FYSETC/FYSETC-SPIDER/firmware/README.md

# firmware

This folder contains related code ,config , documents of Marlin firmware, Klipper firmware and RRF firmware. Please dive into to find what you want.
