FYSETC/FYSETC-SPIDER/firmware/Klipper/README.md

# Klipper

## printer.cfg

This in folder, there a `printer.cfg` file, this is an example Klipper configuration file for VORON2.4 machine. It is not copy-paste available config, you need to adjust the items in file, please read the file carefully, especially the first lines in the file. You need to change the items according to your machine.

```\
## *** THINGS TO CHANGE/CHECK: ***
## Spider version                       Please search this file for "SpiderVersion" and uncomment the appropriate line for each
## MCU paths                            [mcu] section
## Thermistor types                     [extruder] and [heater_bed] sections - See 'sensor types' list at end of file
## Z Endstop Switch location            [safe_z_home] section
## Homing end position                  [gcode_macro G32] section
## Z Endstop Switch  offset for Z0      [stepper_z] section
## Probe points                         [quad_gantry_level] section
## Min & Max gantry corner postions     [quad_gantry_level] section
## PID tune                             [extruder] and [heater_bed] sections
## Fine tune E steps                    [extruder] section
```

## Connect RPI UART

Please follow instruction here([github](https://github.com/FYSETC/FYSETC-SPIDER/blob/main/firmware/Klipper/Connect%20RPI%20uart.md) [gitee](https://gitee.com/fysetc/FYSETC-SPIDER/blob/main/firmware/Klipper/Connect%20RPI%20uart.md)).

## Pre-builds

For some beginners of Spider, i pre-build some firmwares for you, but i strongly recommend you to build the firmware yourself as Klipper update from time to time.  

`klipper-USB.bin` : No bootloader offset, choose USB to communicate with raspberrypi.

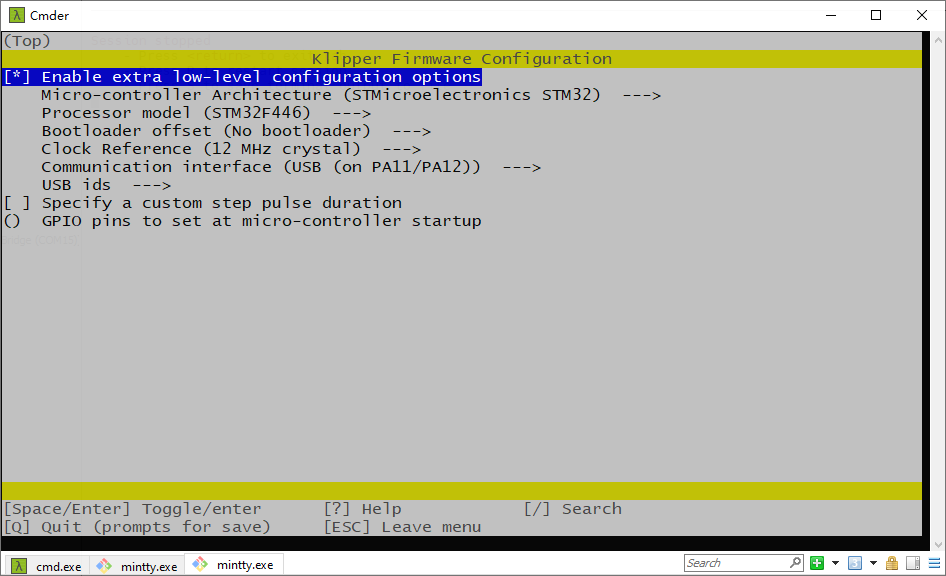
[picture p31: firmware/Klipper/klipper-USB.png]


`klipper-UART.bin` : No bootloader offset, choose UART to communicate with raspberrypi.

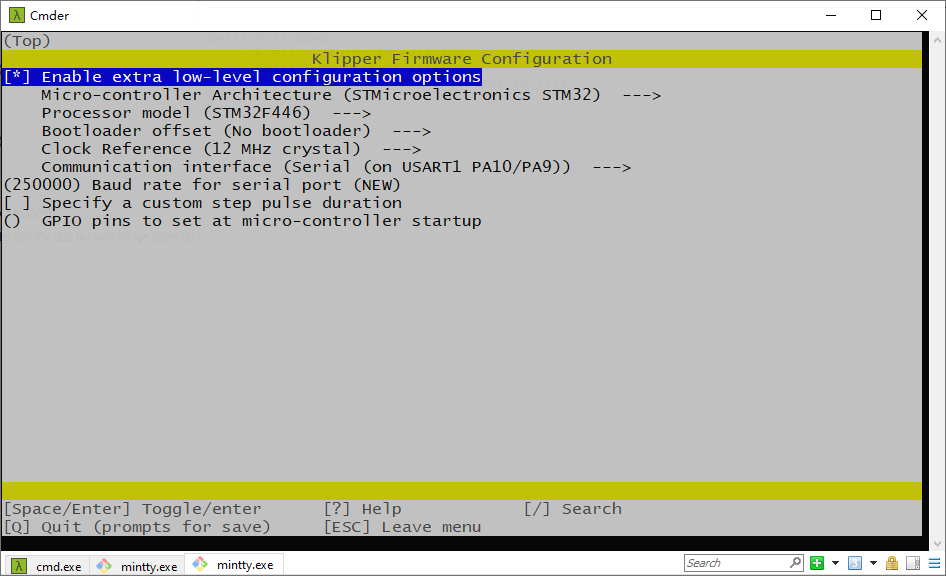
[picture p32: firmware/Klipper/klipper-UART.png]


`klipper-32k-USB.bin` : `0x8000(32k)` bootloader offset, choose USB to communicate with raspberrypi.

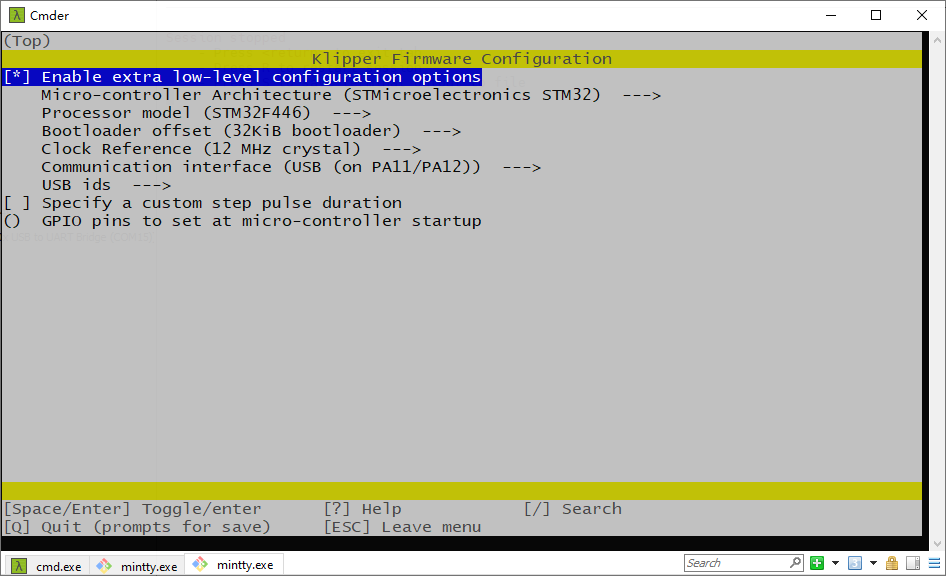
[picture p33: firmware/Klipper/klipper-32k-USB.png]


`klipper-32k-UART.bin` : `0x8000(32k)` bootloader offset, choose UART to communicate with raspberrypi.

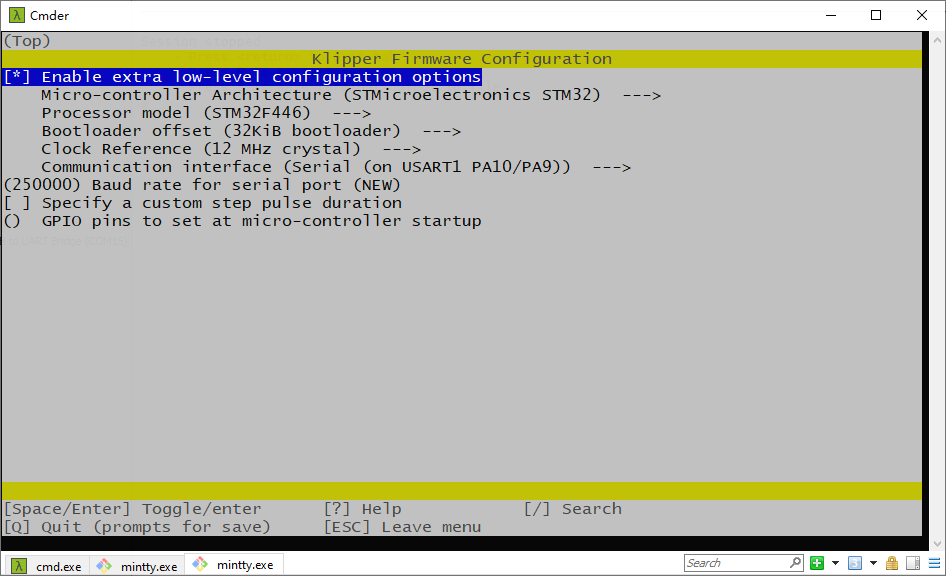
[picture p34: firmware/Klipper/klipper-32k-UART.png]


`klipper-64k-USB.bin` : `0x10000(64k)` bootloader offset, choose USB to communicate with raspberrypi.

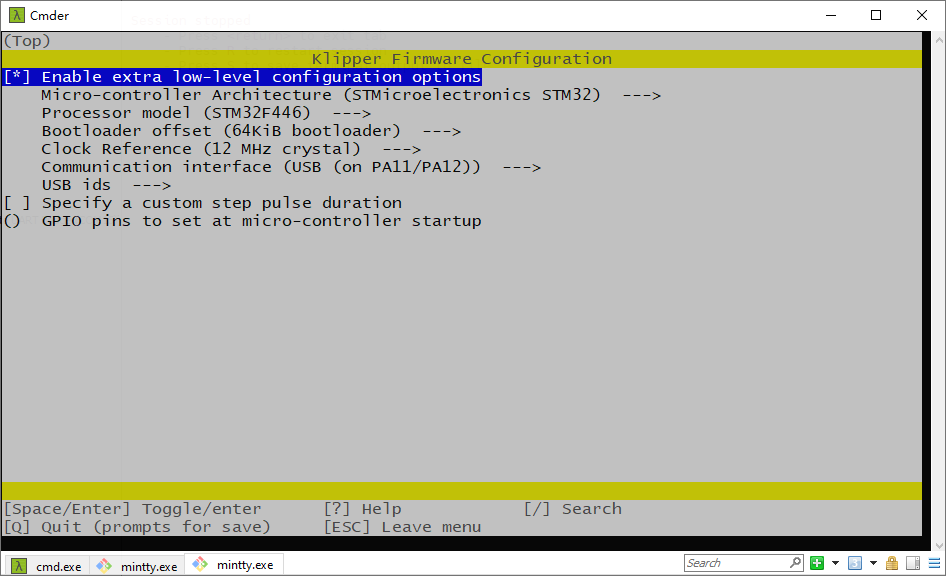
[picture p35: firmware/Klipper/klipper-64k-USB.png]


`klipper-64k-UART.bin` : `0x10000(64k)` bootloader offset, choose UART to communicate with raspberrypi.

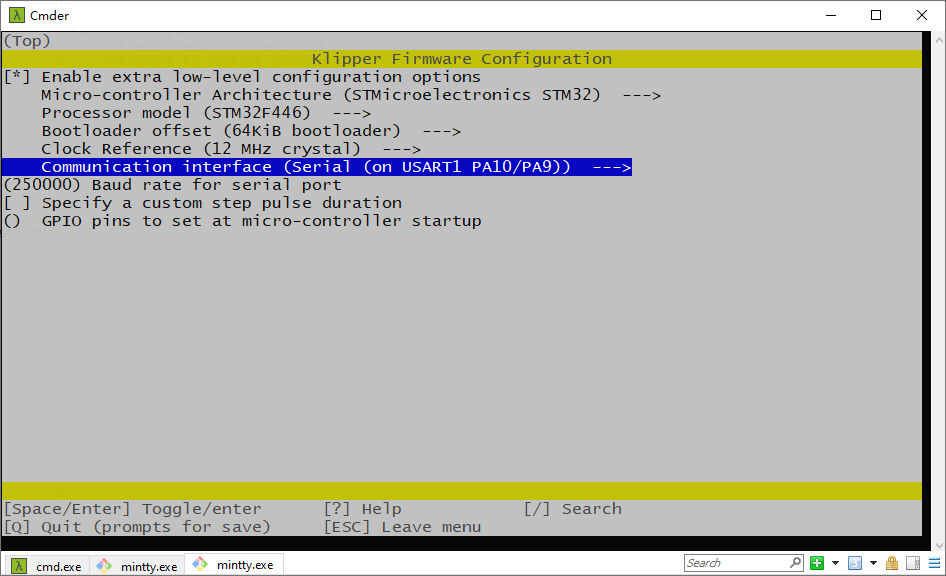
[picture p36: firmware/Klipper/klipper-64k-UART.png]
