FYSETC/FYSETC-SPIDER/firmware/说明文档_中文.md

# 固件

本目录中包含了 Marlin 固件，Klipper 固件，RRF 固件的相关代码，配置，说明等内容，请到相应的固件文件夹中查找您需要的资料。
