FYSETC/FYSETC-SPIDER/example/说明文档_中文.md

# 应用实例

蜘蛛主板目前已应用到了以下的项目中。你可以在对应的项目中找到接线图和配置文件等和项目以及蜘蛛主板相关的文件。

## VORON 2.4

VORON 2.4 项目的官方仓库在[这里](https://github.com/VoronDesign/Voron-2)。FYSETC 的 VORON2.4 套件仓库 ([github](https://github.com/FYSETC/FYSETC-Voron-2) [gitee](https://gitee.com/fysetc-mirrors/FYSETC-Voron-2)).

## VORON Trident

VORON Trident 项目的官方仓库在 [这里](https://github.com/VoronDesign/Voron-Trident). FYSETC 的 VORON Trident 套件仓库 ([github](https://github.com/FYSETC/FYSETC-Voron-Trident) [gitee](https://gitee.com/fysetc-mirrors/FYSETC-Voron-Trident)).

## RatRig

RatRig 项目细节请查看 [这里](https://os.ratrig.com/docs/boards/fysetc/spider-11/).
