FYSETC/FYSETC-SPIDER/hardware/V3.0/spiderV3.0.286.jpg

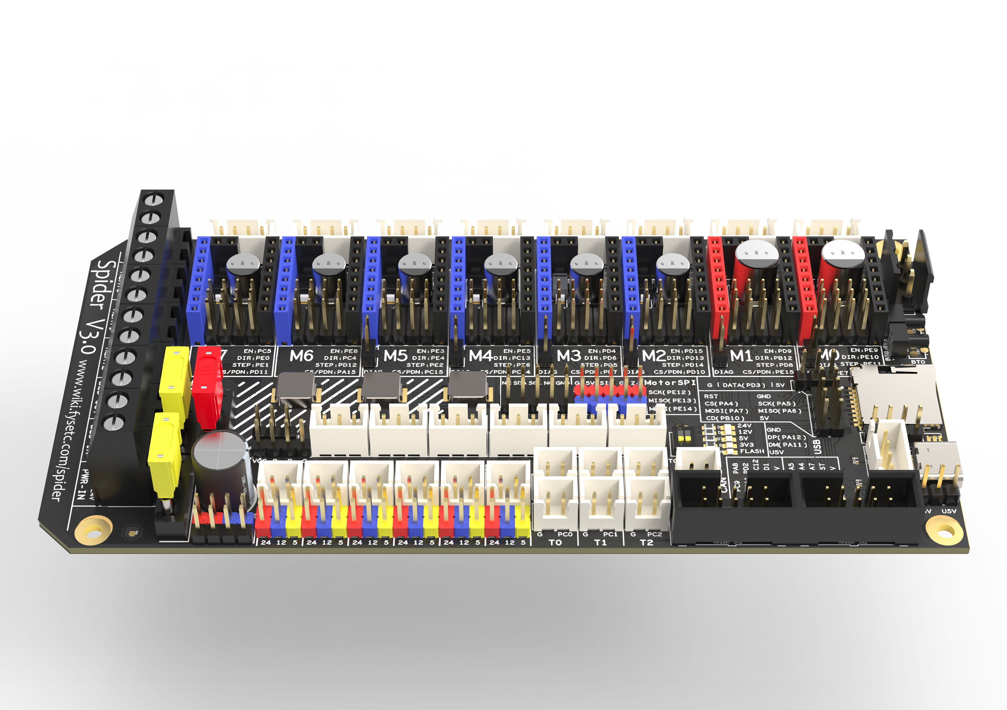
hardware/V3.0/spiderV3.0.286.jpg
