FYSETC/FYSETC-SPIDER/images/startup1.x.png

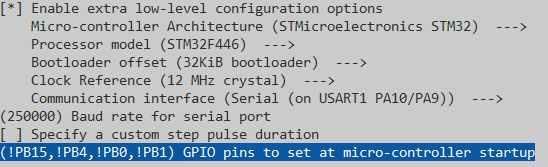
images/startup1.x.png
