FYSETC/FYSETC-SPIDER/images/startup2.x.png

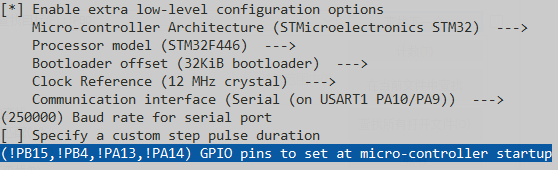
images/startup2.x.png
