FYSETC/FYSETC-SPIDER/(list of files, cad)

Other CAD files:
hardware/V1.x/Spider V1.0C.DWG
hardware/V2.2/Spider V2.2 WithLOGO.dwg
