FYSETC/FYSETC-SPIDER/firmware/RRF/RRFBuild/RepRapFirmware/Developer-documentation/New ESP8266 WiFi module code for Duet WiFi.odt

New ESP8266 code for Duet WiFi

DC, 2017-03-08

# Objectives

- Resolve current issues. In particular, the current code crashes with an exception for 3 users.
- Improve functionality (see below).
- Get rid of the inefficient and sometimes badly-written Arduino code, in particular the extensive use of the String class and associated dynamic memory allocation
- Improve compatibility and common code with Duet Ethernet, possibly using a common main firmware binary for the Duet WiFi and Duet Ethernet
- Make debugging easier, by having less code on the ESP8266
- Make initial programming and updating of DWC easier, by serving DWC files form the SD card
- Pave the way for a fully multithreaded web server using common code with the Duet Ethernet

# Functionality required

- Configuration of WiFi parameters (SSID, WiFi password, IP address etc.) from a file on the SD card, or possibly interactively using a USB host program.
- HTTP, FTP and Telnet support. Possibly other functions later (e.g. push notifications, NTP client).
- Operation as a client to a router, or as an access point.
- Reconnect to router automatically if the connection is lost.
- In the future, TLS security if it doesn’t require too much CPU or memory resource

Note: the existing facility to configure the host router by creating a temporary access point will no longer be required, and will be removed.

# Socket-based interface

To reduce the total amount of code that must be maintained across the Duet WiFi, Duet Ethernet and future Duet variants, and to reduce the amount of ESP8266 code, the ESP will no longer serve HTML files directly. Instead it will provide a socket-based interface over SPI. This is similar to how the W5500 chip on the Duet Ethernet works. However, MDNS and DHCP functions will be left on the ESP.

The SPI protocol will necessarily be different from the protocol used by the W5500 for the following reasons:

- The W5500 is an SPI slave and the Duet Ethernet is the SPI master. However, the ESP8266 does not provide DMA on the SPI interface. This means that the ESP must be the SPI master so that it can control the flow of SPI data, and the Duet WiFi must be the slave.
- The lack of DMA on the ESP means that the SAM cannot rely on the ESP being ready to perform an SPI transaction with short latency. This means it is probably advantageous to use a smaller number of SPI transactions than we do with the W5500.

I propose that the ESP code be written to support at least 8 sockets (the W5500 supports 8 but one is reserved for DHCP). In addition we may wish to support an additional pseudo-socket for ESP configuration commands and status reports.

# SPI communications protocol

Each SPI transaction shall comprise a short header, followed by a response code, followed by a (possibly much longer) data block. After exchanging headers, the ESP can look at the received header to decide what data to send or receive. The SAM transfers the entire block using DMA, so it does not have this option.

Although the ESP shall be the SPI bus master, in other respects it shall behave as a slave to the SAM.

Each transaction shall comprise three parts:

- A header, which is used to pass data in both directions
- Response information from the ESP to the SAM after the ESP has received the header and decide whether it can accept the request
- Data transferred in one direction or the other.

The header sent by the SAM shall contain the following information:

- Socket number that the command refers to, or “no socket”
- A command, one of: listen, close, read data, write data, write data and close, return full ESP8266 status, configure ESP
- How much buffer space or data there is (maximum 2K).
- If the command is listen, what port to listen on

The header sent by the ESP in parallel with the request shall contain the following information:

- Whether connected to router, not connected to router, or running as an access point
- For each socket, its status (idle, listening, connected, close-wait, closing) (note: we could use spare bits in the following 16-bit data to encode this)
- For each connected socket, the amount of unread data available and the amount of write buffer space available (16 bits each)

The response information send by the SAM shall comprise

- Whether the SAM request is accepted
- The number of bytes of data that will be transferred to or from the socket.

The data packet shall comprise

- For a socket read or write command, bytes to be read/written from/to the socket,
- For a configuration command, the relevant information (e.g. IP address, netmask, gateway, SSID, password)
- For a status request, status information from the ESP to the SAM.

# ESP program flow

Initialise, but do not start WiFi

Loop doing the following:

- Check for and process any new commands from the SAM
- If we are supposed to be connected to a router but we have lost the connection, try to reconnect
- Do anything necessary to maintain MDNS and DHCP
- Call the yield function to keep the WiFi alive

End loop

# SAM program flow

This will be generally similar to the Duet WiFi. It will be largely rewritten when we move to RTOS.

Initialise

Start ESP

Ask ESP for status and wait for it to respond

Send requested configuration details and wait for response

- If failed to connect, report the problem to the user and quit

- If successful connection or successfully initialised in access point mode, proceed

Initialise most sockets to listen on HTTP port, one on FTP, one on telnet
