FYSETC/FYSETC-SPIDER/hardware/V3.0/VORON2.4R2_SPIDER_V30_WIRING.pdf

### USE FYSETC TMC 2209 V3.1

### USE FYSETC TMC5160/5161/2130

### USE 4988 or 4988like driver MOSI SCKCS MISO

(SPI4 used for
TMC diver SPI,CS and
PDN share pins)

V-MOTOR(24V)
GND
A2
A1
B1
B2
VIO(3.3V)
GND

ENABLE
(not used)MS1
(not used)MS2
TX
(not used)RX
(not used)CLK
STEP
DIR

PDN DIAG

PDN: It is connected to TX for communication between TMC and MCU, using single wire. The jumper cap shown in the figure must be setted before the drive module install.

DIAG: It is used to go home without sensing, while ensuring that the jumper corresponding to the limit is in the closed state.

1x Jumper cap

4x Jumper cap

4x Jumper cap

DIN

+5V

USB Pins Out: used to connect the Raspberry Pi inside the printer via USB.

The type-C USB socket is used by default, and type-A is also reserved. If you need it, you can Add it by yourself.

SD Pins Out: You can use the SD Card in a farther position by the SD module, but it is not recommended to exceed 30cm.

V-MOTOR(24V)
GND
A2
A1
B1
B2
VIO(3.3V)
GND

ENABLE
MOSI
SCK
CS
MISO
(not used)CLK
STEP
DIR

DIAG

DIAG: It is used to go home without sensing, while ensuring that the jumper corresponding to the limit is in the closed state.

V-MOTOR(24V)
GND
A2
A1
B1
B2
VIO(3.3V)
GND

ENABLE
MS1
MS2
MS3
RST
SLEEP
STEP
DIR
LCD | SD

The markings of EXP1 and EXP2 may be different from those of some displays. If it cannot be displayed normally, please try to reverse EXP1 and EXP2 if the program is correct.

Install this jumper
cap(pin1&pin2) to use
internal DC5V,close the
other two(pin2&pin3) to
use USB5V(recommend
only for debug).

# V- V- V- G

N

L

5A

# HOT SURFACE DO NOT TOUCH

# AC Heating Bed 110/220V INPUT

# HOT SURFACE DO NOT TOUCH

# AC Heating Bed 110/220V INPUT

SLEEP
MS3

MS2

MS1

PA3 | PA2 | PA1 | PA0 | PB14

1

2

3

The spider provides a serial port for connecting to the Raspberry Pi or WiFi module, and this interface has a strong enough (8A MAX) 5V power supply. In order to use the only hardware serial port of the Raspberry Pi, you need to disable the console function and map the hardware serial port to GPIO14 and GPIO15.

You can refer here:

sudo raspi-config
=> Interfacing Option
=> Serial
=> NO
=> YES
sudo nano /boot/config.txt => add this line :
dtoverlay=pi3-disable-bt
=> then
sudo reboot
sudo nano /boot/cmdline.txt => remove the word phase
"console=serial0,115200" or "console=ttyAMA0,115200"
sudo reboot
PC0 | PC1 | PC2

PC3

Jumper Cap Set：
PL08N=VIN
Bltouch=5V

E
Z2

### Rear-Right

# Exhaust Fan

6020 FAN 24V

PB1 PB0

48V Driver Support（M1 & M2）:

1.If you use 24V, you need to connect the 24V-PIN and 48V-PIN, and use the jumper plug that we provide.

2.If you use 48V, you need to connect an external power supply to the 48-PIN and GND-PIN using the connecting wires provided by us.

PA13 | PA14 | PB2

PB13

X/Y

# Endstop

# Z Endstop

# 25A SSR

# Notice： Please select the voltage of your area before powering

up.

Please make sure that your heating bed is in line with the voltage of your country or region. The high voltage version will hat very slowly when used at low voltage and may not reach the target temperature. The low-voltage version is used in the high-voltage version to heat up quickly, even exceeding the temperature you

set, which is very dangerous.

Nozzle Heating
5A MAX
WSD3050

Temperature Sensor
NTC/PT100/Thermocouple(Need AD597 add on) 3.3V 4.7K(0.1%)Pull Up

Temperature Sensor
NTC/PT100/Thermocouple(Need AD597 add on) 3.3V 4.7K(0.1%)Pull Up

Probe
调平

HE0
加热棒
24V共用 | CT
| 箱体温度
PCF 打印冷却 | HEF
| 热端散热

AGND
模拟地 | S2B

TH0
测温 | S2A

GND
共用地 | S1A

XES
预留 | S1B
5V | SERVO

Probe
调平

HE0
加热棒
24V共用 | CT
| 箱体温度
PCF 打印冷却 | HEF
| 热端散热

AGND
模拟地 | S2B

TH0
测温 | S2A

GND
共用地 | S1A

XES
预留 | S1B
5V | SERVO

Z1

### Rear-left

E
Z0
Front-left | B

Z3

### Front-Right

# Print Cooling Fan

6020 FAN 24V

# Hotend Fan

4010 FAN 24V

# AfterburnerToolhead PCB x

https://github.com/FYSETC/FYSETC-Afterburner_Toolhead_PCB_x

# AfterburnerToolhead PCB x SOCKET

# AfterburnerToolhead PCB x SOCKET Check the wiring at lower left

## To Spider E-MOTOR socket

# Controller Fan x2

6020 FAN 24V

# Nevermore filter

4010 FAN 24V x2

A

# Spider v3.0 Voron 2.4 R2

PA9/RX1

PA10/TX1

### S1B E

S2B

S2A

S1A
