FYSETC/FYSETC-SPIDER/hardware/V2.2/Spider_V2.2_Wiring.pdf

### USE FYSETC TMC 2209 V3.1

### USE FYSETC 2130/5160/5161

### USE 4988 or 4988like driver

"Z+" can only be used as an input, because there is a conversion circuit that converts a high voltage signal (24V /5V) into a low voltage signal (3.3V), so it is recommended to connect a proximity sensor here, such as PL-08N.

With “PWM pin”（PA2 in the Y+ socket） the Bltouch is controlled to move up and down.
With the “SIG pin”the Bltouch will tell the controller trigger or not, generally use the "Z-min" pin(PA0). Bltouch
The power supply of BLtouch is easily connected from the Z+ socket, and the jumper cap needs to be connected to the 5V side.
You can also choose to supply power from X+ or Y+, but you need to change the SMD jumper at the bottom (cut off 3.3V, and solder the middle pad with 5V with a soldering iron).

Connect to the NC(normally closed), the signal is low when it is triggered.

Connect to the NC(normally closed), the signal is high when it is not triggered.

Connect to the NC(normally closed), the signal is high when it is triggered.

MOSI
SCK

CS
MISO

(SPI4 used for
TMC diver SPI,CS and
PDN share pins)

V-MOTOR(24V)
GND
A2
A1
B1
B2
VIO(3.3V)
GND

ENABLE
(not used)MS1
(not used)MS2
TX
(not used)RX
(not used)CLK
STEP
DIR

PDN DIAG

PDN: It is connected to TX for communication between TMC and MCU, using single wire. The jumper cap shown in the figure must be setted before the drive module install.

DIAG: It is used to go home without sensing, while ensuring that the jumper corresponding to the limit is in the closed state.

1x Jumper cap

4x Jumper cap

4x Jumper cap

GND

DIN

+5V

USB Pins Out: used to connect the Raspberry Pi inside the printer via USB.

The type-C USB socket is used by default, and type-B is also reserved. If you need it, you can replace it by yourself.

SD Pins Out: You can use the SD Card in a farther position by the SD module, but it is not recommended to exceed 30cm.

V-MOTOR(24V)
GND
A2
A1
B1
B2
VIO(3.3V)
GND

ENABLE
MOSI
SCK
CS
MISO
(not used)CLK
STEP
DIR

DIAG

DIAG: It is used to go home without sensing, while ensuring that the jumper corresponding to the limit is in the closed state.

V-MOTOR(24V)
GND
A2
A1
B1
B2
VIO(3.3V)
GND

ENABLE
MS1
MS2
MS3
RST
SLEEP
STEP
DIR

### LCD SUPPORT:

- FYSETC mini12864 —— √TESTED
- FYSETC RRLCD2004 —— √TESTED
- FYSETC GLCD12864 —— √TESTED
- FYSETC Touch LCD —— √TESTED
- FYSETC TFT81050 —— √TESTED
LCD | SD

The markings of EXP1 and EXP2 may be different from those of some displays. If it cannot be displayed normally, please try to reverse EXP1 and EXP2 if the program is correct.

CANBUS Pins Out: CANBUS shares pins with LCD-D6 (PD0/RX), LCD-D7 (PD1/TX) (in EXP2).

Nozzle Heating
5A MAX
WSD3050

Temperature Sensor
NTC/PT100/Thermocouple(Need AD597 add on) 3.3V 4.7K(0.1%)Pull Up

Temperature Sensor
NTC/PT100/Thermocouple(Need AD597 add on) 3.3V 4.7K(0.1%)Pull Up

Install this jumper
cap(pin1&pin2) to use
internal DC5V,close the
other two(pin2&pin3) to
use USB5V(recommend
only for debug).

If sensorless homing is
required on an axis,
install a jumper on the
corresponding pins here

# V- V- V- G

N

L

# V- V- V- G

N

L

5A

# HOT SURFACE DO NOT TOUCH

# AC Heating Bed 110/220V INPUT

# HOT SURFACE DO NOT TOUCH

# AC Heating Bed 110/220V INPUT

# HOT SURFACE DO NOT TOUCH

# DC Heating Bed 24V INPUT 15A MAX

### AC Heating Bed: If you use AC hot bed, you can get faster heating

speed and lower PSU cost. But you need to add an SSR to control it, you can connect as shown in the dotted basket.

# Spider V2.2

# Wiring diagram

# ——By Eli Wong

# More Information: wiki.fysetc.com/spider

### !!! NOTE !!!

5V power supply has a maximum of 8A (more than 6A, the 5V circuit needs to be dissipated). If you use Raspberry Pi, 3A is required and 1A is reserved for the system, so RGB cannot exceed 4A, that is, no more than 66 LEDs. At the same time, the maximum carrying current of the connector is 3A, so we recommend that the number of LEDs used does not exceed 50, and the connection must be stable.

VIN

5V

C | NC NO | C | NC NO

VCC

GND

(L)

VCC

GND

(H)

C | NC NO | C | NC NO

VCC

GND

(H)

VCC

GND

(L)

Connect to the NC(normally closed), the signal is low when it is not triggered.

RGB Voltage
Selector
VIN | 12V VIN

R
G

B
R
G

B

SLEEP
MS3

MS2

MS1

PB14 | PB13 | PA0
PA1 | PA2

PA3

PD0/RX1

PD1/TX1

3
2
1

The spider provides a serial port for connecting to the Raspberry Pi or WiFi module, and this interface has a strong enough (8A MAX) 5V power supply. In order to use the only hardware serial port of the Raspberry Pi, you need to disable the console function and map the hardware serial port to GPIO14 and GPIO15.

You can refer here:

sudo raspi-config
=> Interfacing Option
=> Serial
=> NO
=> YES
sudo nano /boot/config.txt => add this line :
dtoverlay=pi3-disable-bt
=> then
sudo reboot
sudo nano /boot/cmdline.txt => remove the word phase
"console=serial0,115200" or "console=ttyAMA0,115200"
sudo reboot

PA9/RX1

PA10/TX1

PC0 | PC1 | PC2 | PC3

### AWG Wire Gauges Current Ratings

AWG | Normal | MAX
26 | 0.506 | 0.577
25 | 0.641 | 0.731
24 | 0.808 | 0.921
23 | 1.022 | 1.165
22 | 1.28 | 1.460
21 | 1.6 | 1.9
20 | 2.0 | 2.3
19 | 2.6 | 2.9
18 | 3.2 | 3.7
17 | 4.1 | 4.7
16 | 5.2 | 5.9
15 | 6.5 | 7.4
14 | 8.2 | 9.4
13 | 10.4 | 11.8
12 | 13.1 | 14.9
11 | 16.5 | 18.8
10 | 20.8 | 23.7

Jumper Cap Set：
PL08N=VIN
Bltouch=5V

PA2 for control
PA0 for sensor

GND|5V|PA2|GND|PA0

FAN Voltage
Selector
VIN | 12V VIN

### USE RGB SOCKET FOR FANS

PB1 PB0
