FYSETC/FYSETC-SPIDER/(threads)

Thread 1 (2021-04-17):

Z motor output

ryanthetuner, 2021-04-17:
Why are there only 2 z motor outputs when you need 4? Also will you be posting a wiring diagram soon?

GerogeFu, 2021-04-20:
It is not only for voron2 but also for other dual-z machines. For voron2 , you can install other axis to E1 E2 E3 E4. They all fits. The wiring diagram is coming soon , you also can check it on our wiki. https://wiki.fysetc.com/Spider/

Thread 4 (2021-05-17):

In the spider I can use Pt100 direct

jjrricardo, 2021-05-17:
In the spider I can use Pt100 direct

GerogeFu, 2021-05-24:
I think that should be PT1000, you need a amplifier board to use PT100

aminshof, 2021-07-20:
hi, i have Trianglelab pt100 amplifier board, tried to connect with klipper
https://www.aliexpress.com/item/32829690782.html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

here my config in extruder section :
sensor_type: PT100 INA826
sensor_pin: PC0
adc_voltage: 5.0

its read 52C when the room temp is 31C
there is 3.3v supply from the board, but the amplifier board need 5v, is there something i can do?

Thelm76, 2021-08-31:
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

I think it is related with the issue in just opened here : #42
I'm hoping someone can help me in a near future (maybe you found a solution since last month?)

Thelm76, 2021-09-03:
@aminshof I found a way to solve the issue (I have exactly the same configuration as you).
The easy way would be to plug your amplifier on a pin without pull-up resistor (I'll help you find one if you need it)
The hard way is to reach out the pull-up resistor just above the connector with a small soldering iron and remove it (with this solution you should power your amp board with 3.3V and leave "adc_voltage: 5.0")

Thread 5 (2021-05-31):

Bigtreetech mini 12864 v1.0 configuration Marlin with Fysetc Spider

karponline, 2021-05-31:
I had previously purchased a Bigtreetech mini 12864 v1.0 display. I want to connect it to the new Fystec Spider board. But only the backlight comes on, but the screen is blank. Is it normal for the speaker to make noises while loading the firmware? Will this display work with the new Fysets board?

alienboyxp, 2021-05-31:
https://wiki.fysetc.com/BIQU12864_On_Spider/ maybe this can be helpful

karponline, 2021-06-01:
Success. It works. I had to make three shifts:
1. Rotate Exp1 and Exp2 connectors 180 on BTT Mini
2. Swap the cables. Connect Exp1 from BTT Mini to Exp2 Fysetc Spider and Exp2 from BTT Mini to Exp1 Fysetc Spider
3. Remove R1 and C6 from BTT Mini

Closed 2021-06-06.

Thread 6 (2021-05-31):

Neopixel on Marlin 2.0.8.2 issue

alienboyxp, 2021-05-31:
Using Marlin 2.0.8.2 when Neopixel enabled using PD3 pin (following Spider scheme and wiki documentation) UART communication all low issues.

GerogeFu, 2021-06-01:
First we need to check if it is a hardware issue. Do you check other Marlin version or use Klipper ?

kolbenhans, 2021-06-05:
Same for me, NeoPixels doesn't work.

Using Klipper Firmware
5V voltage is available on LED strip

printer.cfg set up with:
`[neopixel caselight]
pin: PD3
chain_count: 20
color_order: GRB
initial_RED: 1.0
initial_GREEN: 0.0
initial_BLUE: 0.0`

I also tried to change the colors by SET_LED command as written in Klipper documentaton:
SET_LED LED=caselight RED=1.0 GREEN=0.0 BLUE=0.0

Thread 7 (2021-06-01):

TMC2209 and Diag-Pins with Endstops

Bastlwastl84, 2021-06-01:
Does the Diag-Pins from the Stepper needed to bend by side or cutted of if using the Fystec TMC2209 V3.1 with the Spider V1 WITH Endstops?

GerogeFu, 2021-06-02:
No, you only need to close the diag pin jumper if you want to use sensorless homing feature. Or remove the jumper if you want to use endstop.
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

Thread 8 (2021-06-03):

TMC2209 V3.0 on Spider

oscaroecm, 2021-06-03:
I received TMC2209 V3.0 and pins are different compared to TMC2209 V3.1. Is there a way I can still use TMC2209 V3.0 on a Spider board or do I have tu use TMC2209 V3.1?

eliwong, 2021-06-09:
https://wiki.fysetc.com/images/2209%E4%B8%B2%E5%8F%A3%E6%8E%A5%E7%BA%BFV30.jpg
As the wiki shows, if you need to use 3.0 for SPIDER, we need to short-circuit the RX pin and SPREAD pin, and make sure that SPREAD is disconnected from the 2209 chip.
You can use a knife to cut the SPREAD, and then use a soldering iron to solder the SPREAD and RX together on the top of the module.
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

natnikos, 2022-04-28:
Have anyone tried this? i Have 5 fysetc TMC2209 v3.0 from my old board (SKR 1.4) that i want to use them to the new one ordered (Fysetc Spider v.2.2) and i don't want to destroy them (cutting pcb will).

dkuchay, 2023-04-02:
I also have this problem and seeing the date on the posts here it seems the vendor has no support for their own products and it would make sense to avoid these products until such time as fystec provides support

Thread 10 (2021-06-06):

How to enable mosfet outputs with a 12V power supply (only for testing)

karponline, 2021-06-06:
I have a problem with PWM enabled mosfet outputs (1 for HotBed, 3 for Heat-End, 3 for fans). I checked with a meter and there is no voltage on any of them. The only thing that comes to mind is too low voltage to drive the mosfet because I use a 12V power supply. I was able to get all the stepper motors, limit sensors, temperature sensors and the display running. Everything works with this power supply. I also wonder how to properly connect the External MOS module V1.0

eliwong, 2021-06-09:
Spider's mosfet is driven by the onboard 12V (DC-DC), but the 12V circuit on the board requires a minimum input of 15V to work properly, so if you use a 12V input, you can mark it as "24V" and " The 12V" pin header is shorted.
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

karponline, 2021-06-10:
Thanks a lot for your help it works. The photos show my motherboard running during the first tests. Everything works very well. I have already ordered a new 24V power supply and I treat this solution as a test. I don't want to overload the mosfets with too much current. I recommend this product to everyone.

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

Closed 2021-07-11.

Thread 9 (2021-06-06):

RepRap Discount 12864 LCD on FYSETC Spider + Klipper

RENOxDECEPTION, 2021-06-06:
Does anyone know how to get this LCD working and the correct way to configure it in Klipper?

GerogeFu, 2021-06-09:
In Klipper doc there is `Config_Reference.md` , you can learn it there.  https://github.com/KevinOConnor/klipper/tree/master/docs

pigu36, 2024-03-23:
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
I have this issue on my REPRAP with SKR 1.4 and KLIPPER . I copy and paste same config in the sample_LCD.config ...but nothing to do. Anyone same issue ? How we can fix this issue ?

Thread 12 (2021-06-07):

broken images

shiftingtech, 2021-06-07:
Several of the key diagrams are currently badly broken, both on github and the wiki.  For example,
https://raw.githubusercontent.com/FYSETC/FYSETC-SPIDER/main/images/Spider_wiring.svg
currently renders in Chrome as
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

GerogeFu, 2021-06-09:
Try to download the whole project ,then check it in your computer

shiftingtech, 2021-06-15:
I'm not saying you're wrong, but you really shouldn't have to download the whole thing just to view the images.  Maybe you could post some JPEGs or something, just for ease of accessibility?

GerogeFu, 2021-06-16:
Ah, thanks for your reminding.

Closed 2021-07-17.

Thread 14 (2021-06-15):

3.3V supply failed, how to repair?

khrazik, 2021-06-15:
Hi, the board was working when arrived. I've installed klipper and without steppers, everything ran fine. X/Y stepsticks tested fine – but when I installed Z and E, I lost 3.3V power and the board does not boot anymore.

The 3.3V LED is not lit up and I have tested 0.13V on the 3.3V pin next to BT0.
I would like to restore the board to good working order.

Based on this information, could you tell me which component/s were the most likely to fail and what should I start testing/replacing? I can solder SMD components. Photo attached for reference:

 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

CompaxChris, 2021-07-18:
How was this solved? Seems like I maybe have a similar problem

Closed 2021-06-15.

Thread 16 (2021-06-22):

Sensorless homing instructions on pinout diagram

paulstimpson, 2021-06-22:
The instructions in the green box on the pinout diagram located [here](https://github.com/FYSETC/FYSETC-SPIDER/blob/main/images/Spider_wiring.jpg) are not written in good English.

They currently read "If need the Sensor-less homing, the corresponding jumper here should be install."

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

I suggest the following wording which I think is better, "If sensorless homing is required on an axis, install a jumper on the corresponding pins here"

I also  notice that the green box only covers the X and Y pins, not the Z pins. Is this incorrect or is the board not capable of Z-axis sensorless homing?

GerogeFu, 2021-07-17:
Updated. Thanks.

Closed 2021-07-17.

Thread 17 (2021-06-24):

FAN not working on FAN1 (PB1) and FAN2 (PB2)

kees23, 2021-06-24:
Can't get fan to work on Spider board with FAN1 or FAN2.
With the cooling fan connected with FAN0 and below config, the fan works perfectly.

```
[fan]
pin: PB0
max_power: 1.0
kick_start_time: 0.5
off_below: 0.10

```
But when I connect the same fan to FAN1/2 and change the pin to PB1/2 it doesn't work.
No voltage on the pins. Either at 50% fanspeed or 100% fanspeed.
Using Klipper.

Something I have noticed is when I set the voltage jumpers to 12V, FAN1 is always ON. There is always 12V on the pins.
See attachment, the led at FAN1 is ON, immediately at startup. That doesn't look right.
Is this issue hardware related?

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

laserbeak, 2021-09-14:
Has anyone answered this?

kesor, 2021-10-08:
I have the same problem on my Spider/Klipper ... only FAN0 correctly works with 24V, the other two don't.

ichbaum, 2021-10-08:
I only have problems with FAN2.
0 and 1 works fine. All on 24V.
Fan2 won't start. Have testet several settings.

sleepingAwake, 2021-11-02:
So I too am having fan issues with my spider board purchased through the AliExpress fysetc store.
First the boot loader it came with somehow didn’t allow usb or uart communication. Flashing the boot loader they have here got usb and uart working.
Anyway the fans.
Fan0 is connected to my hot end fan and jumpered to 12v.
My print config is copied from here as well with some minor changes but the pins are correct from what I can tell.
At first Fan1 wasn’t working. It’s my parts fan. 24v
Changing printer.cfg to below worked. I’ll tweak as needed.
[fan1]
Pb1

But Fan0 nothing.
I’ve tried various config changes and no voltage output.

Also I’ve noticed when I apply some pressure around the fan0 connector I can hear a faint electric pop. It does it with the fans unplugged to.
Could my board have an internal short?

sleepingAwake, 2021-11-03:
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

Fan0 may not be coming on due to normal behavior. Shame on me for not noticing the extruder fan behavior below 50c
But my board makes an electrical popping noise if I apply a small amount of pressure around the FAN0 connector and its mosfet. Sounds like the layers are shorting to each other. Its consistent and repeatable. Nothing is loose.

Thread 19 (2021-06-28):

You can also choose 32k boot address in Klipper?

FunnyGermanGuy, 2021-06-28:
The readme states that I could choose 32k bootaddress in klipper but I can't find it in my freshly upgraded version of klipper. Could somebody give me a hint what I am doing wrong?

FunnyGermanGuy, 2021-06-28:
I will close the issue because dumb me forgot to select the right stm32 cpu. After that the option for 32kb boot address magical appeared.

Closed 2021-06-28.

Thread 20 (2021-06-29):

Raspberry Pi with external PSU & UART

unigar, 2021-06-29:
Hello, I would like to run the Raspberry Pi with an external PSU. Is it then sufficient to connect only the GPIO 14 & GPIO 15 pins to the TX1 & RX1 Pins on the Spider board or is there something else to be considered?

Closed 2021-07-01.

Thread 22 (2021-07-04):

No Connections

MartynJ970, 2021-07-04:
Hi have issues  as Uart and USB will not connect to Pi.
Also wehn jumper is in 3.3v and BT0, It does not go into DFU mode, therfore I cannot connect to reflash st start again.
I think the USBC port is faulty. Please advise

dodasch, 2021-07-07:
I got the same problem, is your 3.3V LED on? On my Board only the 5V LED is on.

It doesn't matter whether I put the jumper between 3.3V and BT0 or not

I think the STM is dead.

ciro1138, 2021-07-07:
I am having this issue also. The only addition I have is there is no flashing LED by the SDcard when trying to upload the firmware.

dodasch, 2021-07-07:
@ciro1138
you can upload the firmware or bootloader via sd-card?
I can't upload any data because i have no connection.
Neither with USB or SD.

ciro1138, 2021-07-07:
@dodasch

I was not able until a few minutes ago. I started unplugging things and for me, the BTT 2209 drivers are blocking 3.3v as well as an end stop was in the wrong pin. now I can flash the firmware without the drivers in place. start by unplugging your drivers and see if your 3.3v light turns on.

Only figured this out because I bought several spider boards and plugged in a fresh one out of the box. luckily nothing shorted... yet....

dodasch, 2021-07-07:
@ciro1138
I have unplugged everything from my Spider Board.
My printer was working till day X, the Pi was unable to connect to the spider board :(
I think i got a defective Board.

ciro1138, 2021-07-07:
@dodasch What stepper drivers are you using? I am curious because the BTT ones will not let this board work for some reason and still investigating.

dodasch, 2021-07-07:
i'm using tmc2209 v3.1 from fysetc, they work normal

MartynJ970, 2021-07-07:
I am using the Fysect TMC2209 3.1 that came with the board.
I have also unpluged everything exept power to the board from MW PSU. Still no connection Via Pi, USB, UART. Non functoning sd card bootloader. All three leds on stating voltage in and distributed is live.
Really dissapointing, My Fystect Prusa Bear is spot on!
I would suggest to Fysect that all or most faulty boards should be (foc to user) return to them for their QC/MUF & RD to determin and fix issues which i can only think must be small manufacturing issues. 5hrs Burn in testing time prior to packing & despatch.

MartynJ970, 2021-07-09:
Guys,
The soloution to the DFU is to unplug all apart from the power to the Board. It will then enter DFU. I have messages Fysect to update manual, but they need to find a proper fix as reconnecting is a pain!!!

dodasch, 2021-07-10:
To unplug everything will not solve my 3.3V and DFU problem.

ciro1138, 2021-07-10:
Still 3.3v issues with the drivers. Must be some faults or bridged connector somewhere. Moved back to BTT 1.4 TURBOS and klipper is communicating without any issues over USB and UART also works.

GerogeFu, 2021-07-14:
Is the 3.3v power led on?

> To unplug everything will not solve my 3.3V and DFU problem.

dodasch, 2021-07-14:
> Is the 3.3v power led on?
>
> > To unplug everything will not solve my 3.3V and DFU problem.

https://github.com/FYSETC/FYSETC-SPIDER/issues/22#issuecomment-875360793

Darkwingduc, 2021-08-01:
I'm having the same issue I don't get flashing when I insert the sdcard with firmware.bin on it. I've tried uploading the original bootloader with stm32cubeprogrammer after moving the jumper and the lights are on but my computer doesn't recognize that anything is plugged in, and the programmer can't find the board either. I feel like this is a driver issue with windows 10 but have tried everything and still can't seem to get it to work. Does anyone know of a fix for this or what driver I may need.

GerogeFu, 2021-08-04:
Did you follow the steps [here](https://github.com/FYSETC/FYSETC-SPIDER/tree/main/bootloader) ?  Did you close BT0 and 3.3v?

Darkwingduc, 2021-08-04:
I did try that. I moved the jumper but when i plug it into my computer it is not recognized. If I go into device manager it does not show up. I tried different cables including the one that came with it but still nothing. I am going to get a STlink v2 to try and connect through that but dont know exactly what pins need to be connected.

Darkwingduc, 2021-08-06:
I was able to upload the bootloader with the STlink tool and it is up and running. I think this would solve the other issues as well. It's probably not as easy as just using usb but it really wasn't that hard, just 4 wires and you're connected. Now I just need to figure out why my z axis motors run at different speeds. Does this board support drv8825?

ciro1138, 2021-08-06:
@Darkwingduc

Is there something you referenced for your fix I can try. I would like to try and use these boards since I can no longer return them.

Darkwingduc, 2021-08-06:
i bought an st link v2 from amazon. It connects near where the raspberry pi pins are. It uses the 3.3v, dio ,clk, and gnd pins and i was able to connect to the board using that and stm32cubeprogrammer. i marked the pins it goes to with dots. and here is a link to what it looks like. I got the cheap usb version and it worked great. [https://www.google.com/search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](url)
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

beikeland, 2021-08-07:
> To unplug everything will not solve my 3.3V and DFU problem.

some boards come shipped with jumpers installed on the endstop headers, between 3.3v and GND - that'll effectively keep the board from working.

Thread 23 (2021-07-09):

3.3V does not work when stepper drivers installed, firmware also unable to flash

ciro1138, 2021-07-09:
I have purchased 2 spider 1.0 boards, both having the same 3.3v issue with stepper drivers plugged in. Initially, I could not figure out why the SD would not flash with a firmware.bin in the root directory. I realized 3.3v was not working after plugging in my second board with no stepper drivers installed. I initially tried with BTT 2209 driver boards, and have also tried now with Fysetc 2209 v3.1 boards and have the same 3.3v issue once installed.

when drivers are not installed I am able to get the SD reader to flash its LED when a firmware.bin is on the SD but I do not get the firmware to accept and never get the cursor extension from a successful flash.

Without drivers installed, I am trying to flash the firmware for Klipper and have tried and all combinations, uart, no boot, 32k, 64k,  I have checked my wiring for UART it is correct and tried USB with corrected Klipper config settings. I also tried all  firmwares from the github as well. I also tried to reflash the bootloader via stm32cube. I tried both bootloaders provided but no luck getting the firmware to flash via SD or STM32.

From klipper log:
cu 'mcu': Starting serial connect
Got error -1 in read: (11)Resource temporarily unavailable
mcu 'mcu': Timeout on connect
mcu 'mcu': Wait for identify_response
Traceback (most recent call last):
  File "/home/pi/klipper/klippy/serialhdl.py", line 69, in _get_identify_data
    params = self.send_with_response(msg, 'identify_response')
  File "/home/pi/klipper/klippy/serialhdl.py", line 258, in send_with_response
    return src.get_response([cmd], self.default_cmd_queue)
  File "/home/pi/klipper/klippy/serialhdl.py", line 316, in get_response
    cmd_queue)
  File "/home/pi/klipper/klippy/serialhdl.py", line 250, in raw_send_wait_ack
    self._error("Serial connection closed")
  File "/home/pi/klipper/klippy/serialhdl.py", line 62, in _error
    raise error(self.warn_prefix + (msg % params))
error: mcu 'mcu': Serial connection closed
mcu 'mcu': Timeout on connect
mcu 'mcu': Wait for identify_response
Traceback (most recent call last):

dodasch, 2021-07-10:
I get my second board now and its working.
I used the same stepper drivers (tmc2209 v3.1 from fysetc).

ciro1138, 2021-07-10:
@dodasch then I was sent 2 bad boards.....

dodasch, 2021-07-12:
Support said to me, if i get a new Spider i should short circuit the board between 24+ and GND Input for a few seconds.
But this will not help you with your sent boards :/

GerogeFu, 2021-07-14:
Check the issue analysis here : https://github.com/FYSETC/FYSETC-SPIDER/blob/main/Spider%203.3v%20issue.md

ciro1138, 2021-07-14:
@GerogeFu

ciro1138, 2021-07-14:
@GerogeFu

I don't believe the drivers are damaged in any way because I am using them in a different board without issues.

Regarding residual power on 24v it takes 10 or so seconds for the 24v to look like it is drained. I do want to note that when trying to flash my second board I jumpered 5v over USB and never plugged in 24v to try and connect to klipper. The firmware would not take on this board either trying no boot, 32, and 64 over USB. It never switched to cursor and in putty I cannot find a USB address. That is when I tried to connect via stm32 program to flash the bootloader and tried all available  versions. I did notice a list of sectors, can we get a photo of that from a known working board? I was suppr to see 6-8 sectors from my limited experience.

GerogeFu, 2021-07-15:
When i flashed bootloader, it look like this :
![Uploading 01432.png…]()

beikeland, 2021-08-10:
> Regarding residual power on 24v it takes 10 or so seconds for the 24v to look like it is drained.

Problem is 24V feeds another Vm rail that is feeding stepper drivers though a diode; there is much more capacitance there and no load with no drivers installed - will keep charge much longer.

> That is when I tried to connect via stm32 program to flash the bootloader and tried all available versions. I did notice a list of sectors, can we get a photo of that from a known working board? I was surprised
> to see 6-8 sectors but my experience is limited
> in this program

found this on discord no need to use stm32cube (remove `:leave`and `-R` if you want to proceed to flash application firmware without re-entering dfu mode)
```
wget https://github.com/FYSETC/FYSETC-SPIDER/raw/main/bootloader/Bootloader_FYSETC_SPIDER.hex
objcopy --input-target=ihex --output-target=binary Bootloader_FYSETC_SPIDER.hex Bootloader_FYSETC_SPIDER.bin && dfu-util -R -a 0 -s 0x08000000:mass-erase:force:leave -D Bootloader_FYSETC_SPIDER.bin
```

Thread 24 (2021-07-11):

Probe Problem

dodasch, 2021-07-11:
I have Problems with my Inductive Probe.
My Probe is always Triggered.

I've been using a PNP-Probe.

I measured 3.3V between Pin PA3 & GND.

So i need an NPN Probe, right?

dodasch, 2021-07-11:
Here is my Klipper config:

https://pastebin.com/embdmx9J

photocromax, 2021-07-12:
I guess you do need a NPN, maybe there is a way to connect a PNP too, but not sure how.

dodasch, 2021-07-12:
Okay this Issue can be closed, but it should be marked on the wiring that you only can use a NPN Probe.

sbusso, 2021-08-07:
having the same problem, PA3 should provide 24V, did you solve your issue?

Closed 2021-07-12.

Thread 25 (2021-07-13):

BL Touch / 3D Touch configuration

karponline, 2021-07-13:
What is the minimum BLTouch configuration in Marlin? I connected it according to the Spider 1.0 diagram (to PA0, PA2 and PA3). The power supply is correct 5V. I uncommented #define BLTOUCH and #define Z_SAFE_HOMING. But even Self-Test doesn't work. Does the microswitch have to be connected to PA0?

GerogeFu, 2021-07-14:
We have updated our wiring these days, you should wire the cable according to diagram.
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
Only the lateset Marlin bugfix-2.0.x here : https://github.com/MarlinFirmware/Marlin/blob/bugfix-2.0.x/Marlin/src/pins/stm32f4/pins_FYSETC_SPIDER.h, have the correct BLTOUCH pins define
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

glucz, 2021-08-01:
I can confirm that this is not working as described on the wiring diagram and set up in the config file. BLtouch gets power and does the initial self-test, but then nothing else is functional.

karponline, 2021-08-02:
@glucz it works but I didn't have time to write back. I downloaded this exact version. If you are fetching code via git you have to switch the branch to BUGFIX. Check if you have SERVO0_PIN defined - it is important.

spicker, 2021-08-06:
I have the same problem. BLTouch only does the self test but nothing else. It also looks like the wiring diagram is contradictory. As wired the bltouch is connected to PA2/PA0, but the red box next to the probe says PA3/PA0. It's the same on the 1.1 diagram.

glucz, 2021-08-06:
Well... I don't know. I have a 1.0 version and it didn't work with PA2. I think in my case the PA2 socket might have blown out when I drove the BLTOUCH with 24 volts ... I really have no idea why they would set up wiring in such a way where this is possible. There are a lot of 5V only ports that wouldn't even take up a sensor slot. Anyways, I had to use PA1 (X max) and now it's working.

So either the board came damaged, I damaged it by following the not-so-foolproof instructions or the Y max is not PA2 on V1.0

All in all, it was a $120 learning experience with the damaged board and the 2 blown BLTOUCH sensors.

Thread 26 (2021-07-14):

Pinout diagram shows MISO twice on EXP1

foleac, 2021-07-14:
https://github.com/FYSETC/FYSETC-SPIDER/blob/main/images/Spider_V1.0_Pinout.jpg shows MISO for pins 1 (top right - connector's orientation not image) and 6 (middle bottom). I assume one of those should be MOSI. Is that correct?

GerogeFu, 2021-07-15:
Yes, the 6 is MOSI. You can check the pin at the back of Spider board.

GerogeFu, 2021-07-17:
Pinout jpg have been updated.

Closed 2021-07-17.

Thread 27 (2021-07-16):

Wrong labeling of VCC and GND

xenon2008, 2021-07-16:
Hi!

I am a newbie who is dealing with the Spider Board for the first time and is also building my first Voron!
But when I was about to wire up the RPi, I noticed something!
I wanted to connect 2x VCC and 2x GND from the Pi PWR & UART interface and it occurred to me that the pin on the top right is black, but was marked as 5V!
In the other section or the picture, however, this is again listed as GND!

Sorry i hope everybody here can understand / follow me what i mean, because my English Skills are so terrible Bed.
I am a Austrian User, and could only speak German =)

Some Pictures what i mean from the Documentation of the Spider 1.0 Wiring:

[https://raw.githubusercontent.com/FYSETC/FYSETC-SPIDER/main/images/Spider_v1.0_wiring.jpg](https://raw.githubusercontent.com/FYSETC/FYSETC-SPIDER/main/images/Spider_v1.0_wiring.jpg)
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

Kind Regards from Upper Austria ;)

photocromax, 2021-07-16:
Yes it's a mistake in the second picture. If you are worry, I can confirm that pin is GND.

GerogeFu, 2021-07-17:
Oh, that is mistake, we are right on it.

GerogeFu, 2021-07-17:
Updated.

Closed 2021-07-17.

Thread 28 (2021-07-17):

Maybe Wrong Config Info in printer.cfg for Inductive Probe

xenon2008, 2021-07-17:
Hello together!

I have a Spider Board and currently creating my config for my first own Voron with an inductive Probe! (a VINDA NC Probe from vonWange)
I used the default config from here:
https://github.com/FYSETC/FYSETC-SPIDER/blob/main/firmware/Klipper/printer.cfg

And i had to remove the ! from "^!PA3", so now it is "^PA3"
Then the Trigger / Open Status are correct, with a ! the are inverted.

Could it be that the Description in the Config is wrong?
In my opinion the description is reversed! With ! it is a NO Probe and without! is it an NC Probe
could this be?

Kind Regards from Austria

GerogeFu, 2021-07-28:
I think you are right, the default printer.cfg is for PL08N Probe, it is NO Probe too. I will update the comment.

xenon2008, 2021-07-29:
Thanks ;)

Closed 2021-07-29.

Thread 29 (2021-07-18):

3.3v regulator overheating

CompaxChris, 2021-07-18:
I was going to test a spider board that just arrived but I did not get very far. There seems to be a short in the 3.3 voltage system somewhere, since the 3v3 regulator is overheating, and the voltage on the 3v3 line have droppet to 0.05v I can't locate where it is. I have added a image of the board setup and a thermal image of the 3v3 regulator.

I can find any other places on the board that seems to overheat unexpectedly.

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

dreamcat4, 2021-07-18:
its almost as if... there is a short somewhere due to a mis-wiring. like the 3v3 has been bridged to GND

interesting! please let us know if you find out what is going on here. so i can then also check on my own spider too. many thanks

CompaxChris, 2021-07-19:
So far I can't find it with thermal or with a microscope so it's probably a very "clean" short with low resistance. The last measure to find the short is destructive testing, cutting traces. The board will probably not be useful afterwards but it could still be interesting to find out where it is. Is the layout of the board available somewhere?

dreamcat4, 2021-07-19:
no i dont believe the pcb layout is available, and it seems to be a multi-layer board

have you tried changing the `USV` jumper in the middle of the board, and powering it from the usb-c port instead? does that give the same result? then it would seem to be a short. be sure you have everything disconnected, remove all the stepsticks and connecters etc. Disconnect everything apart from the usb cable

CompaxChris, 2021-07-19:
Yea without the layout its hard. If it's a four layer board the central layers are usually only GND and power layer. If 3v3 is used as the power layer it it's even harder. However if 5V, 12V or 24V is used as the power layer the cutting the 3v3 lines is at least feasible. However the black solder mask makes it quite had to spot the traces. A short like this is not uncommon in PCB production so the best option is probably just to get a new one. I was unlucky with this unit.

USB is 5V so it's still sent through the same 3v3 linear regulator.

Fysetc followed up and is sending a new board.

Closed 2021-07-19.

Thread 30 (2021-07-22):

BigTreeTech TFT70 screen compatibility with RS232 port

Recoil1980, 2021-07-22:
I am looking at getting the Fysetc Spider 1.1 as a replacement for my BTT SKR 1.4 Turbo, and would like to find out if the board is compatible with my screen (BTT TFT70) with the RS232 connector from the screen, or if the EXP ports have to be used instead?

GerogeFu, 2021-07-28:
There is UART at the middle of Spider, you can check the pin define at the back of the board.
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

Recoil1980, 2021-07-30:
Thank you!

Closed 2021-07-30.

Thread 31 (2021-07-23):

bigtreetech 2209 v 1.2 drivers

susowl, 2021-07-23:
Hi. Can i use bigtreetech 2209 v 1.2 drivers on spyder board without without any bells and whistles?

Closed 2021-07-24.

Thread 32 (2021-07-26):

Without 3.3V

djzedamendoa, 2021-07-26:
Hello.
I have update the firmware and connect the stepper drivers.
They have worked about 2 minutes and then I lost the connection with computer. The 3.3v led light is off. I have everything disconnected and try on the other day, but I don't have 3.3V anymore.

I need to know where is located the 3.3V ldo chip his reference number to be able to replace it.
 Thanks

beikeland, 2021-08-07:
Looked at the schematic in the hardware folder? Won't show you the location, but the part  and reference number is there.

Thread 34 (2021-08-02):

SKR TFT 35 or TFT 70 Touch Screen with Spider

jojodroopy, 2021-08-02:
Hello, Is it possible to use a BTT SKR TFT35 or TFT70 type screen for choosing the Marlin or Graphic screen as on SKR Pro 1.2 or MKS L Gen L. I use the connector at the center of the Map with 5V, GND, RX1 and TX1. I have an inserted SD card back or remove but I do not have a dialog with the card. Thanks a lot for your help.

GerogeFu, 2021-08-04:
Should work with TFT screen, but i think you better to run Marlin firmware that BTT recommend. That TFT need some specific configurations.

jojodroopy, 2021-08-04:
Hello and thank you for your answer. I left on the basis of the configuration proposed by BTT. But can you tell me what are the specific settings for this type of screen?

GerogeFu, 2021-08-10:
Check "Marlin Dependencies"
https://github.com/bigtreetech/BIGTREETECH-TouchScreenFirmware

jojodroopy, 2021-08-10:
Hello, ok for your information. But my screen works perfectly on a Turbo or other BTT card, but I can not operate it on the Spider. Is there a specific port to declare?

TheAlexPG, 2022-05-07:
> Hello, ok for your information. But my screen works perfectly on a Turbo or other BTT card, but I can not operate it on the Spider. Is there a specific port to declare?
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
Hello!I got this to work on my spider. I swapped the PX and TX wires at the entrance to the board. Serial port 1, serial port 2 -1. Only CR10_Stock_Display must be enabled

Thread 35 (2021-08-02):

Unable to read tmc uart 'stepper_z2' register IFCNT - Issue

paulalter, 2021-08-02:
Hello, I just finished my voron 2.4 built and went through the initial startup testing. When I was trying all the motors ("STEPPER_BUZZ STEPPER=stepper_x") and went through all the motors. I had an issue with the z2 motor. I replaced the driver (bigtreetech tmc2209 v1.2) but same problem again. Then I checked if the wiring was corretly on every motor, so I plugged every motor on the x connector and every single on worked fine. Afterwards I did the same with the drivers, the on that got replaced did not work, so I ended up with 7 working drivers. So I put every driver and motor where it should be, but same problem again. Then I changed the z2 Motor from E2 Motor to E4 Motor (maybe there is an issue on the board). But same problem again. Everytime it shuts down, the LEDs from fan0 and fan2 light up (I don´t know if that information is helpful but maybe it is). The jumpers are where they supposed to be, I even changed them. Now I think my problem could be in the config file. The Board is the spider V1.0. Klippy.log and config is here:
[klippy (4).log](https://github.com/FYSETC/FYSETC-SPIDER/files/6916926/klippy.4.log)
[printer.txt](https://github.com/FYSETC/FYSETC-SPIDER/files/6916946/printer.txt)

GerogeFu, 2021-08-04:
It seems that your z3 is different from our printer.cfg
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

Thread 36 (2021-08-02):

USB communication with Pi

Jhonno84, 2021-08-02:
Can't get my Spider V1.1 to communicate with my Pi via USB or UART (following the GitHub guide)..

Flashes Bootloader and compiled firmware fine from STM32 Programmer but still won't talk to my Pi4.

OstapFerensovych, 2021-08-03:
Try to flash without bootloader. I had the same problem with Spider V1.1 and rpi4.
make menuconfig and choose Bootloader offset "No bootloader", and then flash klipper.bin to 0x8000000. Maybe it will help. Looks like bootloader that fysetc provide is a little buggy.

beikeland, 2021-08-07:
Bootloader only provides functionally to flash from SD card, for USB connection it is not needed - however getting support from the community probably assumes the bootloader is installed so that might be best to just find the correct offset 32k or 64k and it should work (unfortunately not possible to tell which one was installed at factory)

Jhonno84, 2021-08-12:
Thank you guys.. This was solved using 0 offset bootloader.

bakaufman, 2021-10-08:
> Thank you guys.. This was solved using 0 offset bootloader.

Still flashed by SD card with 0 offset? or using something else?

Thread 37 (2021-08-05):

X+ endstop not firing on PA1

Recoil1980, 2021-08-05:
On setting up the new board I had sensorless homing setup.  I ran into issues not being able to properly set the sensitivity and decided to switch to mechanical end stops.  This is on an Ender 5 Plus modified for core XY, so end stops are at max X & Y (right rear).  Board connectors are wired with red wire on tan pins, black on black pins ([see picture](https://github.com/FYSETC/FYSETC-SPIDER/blob/main/images/Spider_v1.1_wiring.jpg))

X+ was on PA1 and Y+ was on PA2.  The X+ would not trigger but the Y+ would.  I swapped connections on the board and X+ on PA2 would trigger but Y+ on PA1 would not trigger. I put Y+ back on PA2 and moved X+ to PA3, and both trigger correctly.  The soldering on the back of the board on PA1, PA2, and PA3 looks good.  Is it possible there is an issue with my PA1 connection?

Darkwingduc, 2021-08-08:
I ran into the opposite issue with mine. It is most likely just an issue with the code. try different configs and see if something works. I had the opposite issue where in klipper the endstop postion was set to max like this (_position_endstop:280_) It kept homing backwards and I changed stepper direction and tried many other things until I finally noticed that one line was screwing me up. Maybe that one line is all you need.

GerogeFu, 2021-08-10:
> On setting up the new board I had sensorless homing setup. I ran into issues not being able to properly set the sensitivity and decided to switch to mechanical end stops. This is on an Ender 5 Plus modified for core XY, so end stops are at max X & Y (right rear). Board connectors are wired with red wire on tan pins, black on black pins ([see picture](https://github.com/FYSETC/FYSETC-SPIDER/blob/main/images/Spider_v1.1_wiring.jpg))
>
> X+ was on PA1 and Y+ was on PA2. The X+ would not trigger but the Y+ would. I swapped connections on the board and X+ on PA2 would trigger but Y+ on PA1 would not trigger. I put Y+ back on PA2 and moved X+ to PA3, and both trigger correctly. The soldering on the back of the board on PA1, PA2, and PA3 looks good. Is it possible there is an issue with my PA1 connection?

If you have a multimeter, you can check the connection of the DIAG pin.
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

lvitol, 2021-10-05:
Related#49 , ran into similar issue when setup sensorless homing, found error in PinOut.SVG by check pin connection with multimeter

Thread 38 (2021-08-06):

Klipper's flash-sdcard.sh script can't find the SD card.

jtbraun, 2021-08-06:
My board updates fine from the sdcard via the firmware.bin/old.bin method.

If I use Klipper's built-in flash-sdcard.sh script, though:
`./scripts/flash-sdcard.sh /dev/serial/by-id/usb-Klipper_stm32f446xx_140025000750305538333620-if00  fysetc-spider-v1`

This fails when it's trying to issue the first GO_IDLE_STATE command to the SD card.

Presumably the bootloader is doing something to the sdcard or the pin config after it checks for firmware.bin, preventing the remote access scripts from working.  I'd check the bootloader sources, but they aren't available. Reportedly this USED to work with the older bootloader...

jtbraun, 2021-08-06:
I've annotated the failures w/ extra print statements, but the core failure is the GO_IDLE_STATE command failing (OSError Exception marked w/ `******` at the start of the line).   Note that many of these exceptions in the normal script get eaten and rethrown as new ones, so the final `failed to mount SD Card` is a much more generic error message than `failed to reset SD Card`.
```
$ ./scripts/flash-sdcard.sh /dev/serial/by-id/usb-Klipper_stm32f446xx_140025000750305538333620-if00  fysetc-spider-v1
Flashing /home/pi/klipper/out/klipper.bin to /dev/serial/by-id/usb-Klipper_stm32f446xx_140025000750305538333620-if00
Checking FatFS CFFI Build...
Connecting to MCU...Connected
('BOARD CONFIG ', "{'baud': 250000, 'klipper_bin_path': '/home/pi/klipper/out/klipper.bin', 'cs_pin': 'PA4', 'klipper_dict_path': '/home/pi/klipper/out/klipper.dict', 'cd_pin': 'PB10', 'spi_bus': 'spi1', 'current_firmware_path': 'OLD.BIN', 'device': '/dev/serial/by-id/usb-Klipper_stm32f446xx_140025000750305538333620-if00', 'mcu': 'stm32f446xx'}")
Checking Current MCU Configuration...Done
MCU needs restart: is_config=1, is_shutdown=0
Attempting MCU Reset...Done
Waiting for device to reconnect...Done
Connecting to MCU...Connected
('BOARD CONFIG ', "{'baud': 250000, 'klipper_bin_path': '/home/pi/klipper/out/klipper.bin', 'cs_pin': 'PA4', 'klipper_dict_path': '/home/pi/klipper/out/klipper.dict', 'cd_pin': 'PB10', 'spi_bus': 'spi1', 'current_firmware_path': 'OLD.BIN', 'device': '/dev/serial/by-id/usb-Klipper_stm32f446xx_140025000750305538333620-if00', 'mcu': 'stm32f446xx'}")
Initializing SD Card and Mounting file system...
MOUNTING
INIT SD
TRY GO_IDLE_STATE
******OSError('flash_sdcard: failed to reset SD Card\nNote that older (Version 1.0) SD cards can not be\nhot swapped.  Execute FIRMWARE_RESTART with the card\ninserted for successful initialization.',)

SD Card Flash Error: Failed to Initialize SD Card. Is it inserted?
OSError('flash_sdcard: failed to mount SD Card, returned FR_NOT_READY',)
Traceback (most recent call last):
  File "/home/pi/klipper/scripts/spi_flash/spi_flash.py", line 1172, in main
    spiflash.run()
  File "/home/pi/klipper/scripts/spi_flash/spi_flash.py", line 1124, in run
    self.run_reactor_task(self.run_sdcard_upload)
  File "/home/pi/klipper/scripts/spi_flash/spi_flash.py", line 1108, in run_reactor_task
    k_reactor.run()
  File "/home/pi/klipper/klippy/reactor.py", line 269, in run
    g_next.switch()
  File "/home/pi/klipper/klippy/reactor.py", line 310, in _dispatch_loop
    timeout = self._check_timers(eventtime, busy)
  File "/home/pi/klipper/klippy/reactor.py", line 156, in _check_timers
    t.waketime = waketime = t.callback(eventtime)
  File "/home/pi/klipper/klippy/reactor.py", line 48, in invoke
    res = self.callback(eventtime)
  File "/home/pi/klipper/scripts/spi_flash/spi_flash.py", line 1087, in run_sdcard_upload
    self.mcu_conn.configure_mcu(printfunc=output_line)
  File "/home/pi/klipper/scripts/spi_flash/spi_flash.py", line 923, in configure_mcu
    "Failed to Initialize SD Card. Is it inserted?" + "\n" + repr(e))
SPIFlashError: Failed to Initialize SD Card. Is it inserted?
OSError('flash_sdcard: failed to mount SD Card, returned FR_NOT_READY',)
```

beikeland, 2021-08-07:
I updated to the 32k bootloader and see the same problem, cannot access SD card. Oddly enough reverting to the available 64k bootloader didnt help either. Having the sources would be nice indeed.

GerogeFu, 2021-08-10:
Try to change "scripts/spi_flash/board_defs.py"
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

jtbraun, 2021-08-13:
That did get farther, GO_IDLE_STATE succeeded. It can't detect a filesystem, but perhaps the card is corrupted. I'll work at it a bit more to try to tell what's going on.

jtbraun, 2021-08-13:
Here's a dump of sector 0, which results in the fatfs library returning "FR_NO_FILESYSTEM".   There are repeating patterns of something like 0x1642e0 every ~19 bytes. The values change a little. I'll try rebooting.
```
CARD IS IDLE!
READ sector:0 count:1
DUMP 0x0000: 00 00 00 00 00 00 00 00 00 16 42 E0 00 00 00 00
DUMP 0x0010: 00 00 00 00 00 00 00 00 00 00 00 00 16 62 00 00
DUMP 0x0020: 00 00 00 00 00 00 00 00 00 00 00 00 00 00 00 16
DUMP 0x0030: 62 20 00 00 00 00 00 00 00 00 00 00 00 00 00 00
DUMP 0x0040: 00 00 16 62 40 00 00 00 00 00 00 00 00 00 00 00
DUMP 0x0050: 00 00 00 00 00 16 62 60 00 00 00 00 00 00 00 00
DUMP 0x0060: 00 00 00 00 00 00 00 00 16 62 80 00 00 00 00 00
DUMP 0x0070: 00 00 00 00 00 00 00 00 00 00 00 16 62 A0 00 00
DUMP 0x0080: 00 00 00 00 00 00 00 00 00 00 00 00 00 00 16 62
DUMP 0x0090: C0 00 00 00 00 00 00 00 00 00 00 00 00 00 00 00
DUMP 0x00a0: 00 16 62 E0 00 00 00 00 00 00 00 00 00 00 00 00
DUMP 0x00b0: 00 00 00 00 16 82 00 00 00 00 00 00 00 00 00 00
DUMP 0x00c0: 00 00 00 00 00 00 00 16 82 20 00 00 00 00 00 00
DUMP 0x00d0: 00 00 00 00 00 00 00 00 00 00 16 82 40 00 00 00
DUMP 0x00e0: 00 00 00 00 00 00 00 00 00 00 00 00 00 16 82 60
DUMP 0x00f0: 00 00 00 00 00 00 00 00 00 00 00 00 00 00 00 00
DUMP 0x0100: 16 82 80 00 00 00 00 00 00 00 00 00 00 00 00 00
DUMP 0x0110: 00 00 00 16 82 A0 00 00 00 00 00 00 00 00 00 00
DUMP 0x0120: 00 00 00 00 00 00 16 82 C0 00 00 00 00 00 00 00
DUMP 0x0130: 00 00 00 00 00 00 00 00 00 16 82 E0 00 00 00 00
DUMP 0x0140: 00 00 00 00 00 00 00 00 00 00 00 00 16 A2 00 00
DUMP 0x0150: 00 00 00 00 00 00 00 00 00 00 00 00 00 00 00 16
DUMP 0x0160: A2 20 00 00 00 00 00 00 00 00 00 00 00 00 00 00
DUMP 0x0170: 00 00 16 A2 40 00 00 00 00 00 00 00 00 00 00 00
DUMP 0x0180: 00 00 00 00 00 16 A2 60 00 00 00 00 00 00 00 00
DUMP 0x0190: 00 00 00 00 00 00 00 00 16 A2 80 00 00 00 00 00
DUMP 0x01a0: 00 00 00 00 00 00 00 00 00 00 00 16 A2 A0 00 00
DUMP 0x01b0: 00 00 00 00 00 00 00 00 00 00 00 00 00 00 16 A2
DUMP 0x01c0: C0 00 00 00 00 00 00 00 00 00 00 00 00 00 00 00
DUMP 0x01d0: 00 16 A2 E0 00 00 00 00 00 00 00 00 00 00 00 00
DUMP 0x01e0: 00 00 00 00 16 C2 00 00 00 00 00 00 00 00 00 00
DUMP 0x01f0: 00 00 00 00 00 00 00 16 C2 20 00 00 00 00 00 00

SD Card Flash Error: Failed to Initialize SD Card. Is it inserted?
OSError('flash_sdcard: failed to mount SD Card, returned FR_NO_FILESYSTEM',)
Traceback (most recent call last):
  File "/home/pi/klipper/scripts/spi_flash/spi_flash.py", line 1177, in main
```

GitjoPowershell, 2021-09-11:
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

This works nicely for my spider 1.1 with sd card inserted
thanks a lot ! Way easier to update without putting voron v2 upside down ;)

beikeland, 2021-09-11:
Does changing this affect the other boards that use the same fysetc-spider entry? S6 among others. Solution works for spider, confirmed with several boards and sd card combinations.

falo2k, 2021-09-24:
Confirmed that this change works on a Spider v1.1 with a 32k bootloader connected over UART.

adelyser, 2021-12-29:
Has anyone tried this recently without the fix described here? There was a change recently that releases the SPI from the bootloader on STM32F4 processors and it should alone resolve this issue without needing software SPI.

falo2k, 2021-12-29:
Yep.  Klipper3d/klipper#4885 fixed it for me so the swspi change was no longer necessary.  If it still is for the Cheetah then that should use a new definition.

philgood, 2023-04-09:
I had the same issue, updated with the following spa_pins as suggested and pushed firmware via UART to the SD card and got a successful cash.

Pull request [#4255 ](https://github.com/Klipper3d/klipper/pull/4255) was submitted May 2021 and fixed the issue, however it seems that the spider config has reverted back?

I think another pull request is needed to resolve future spider board being flashed via UART to the SD card.

CodeMonkeyX, 2024-01-29:
Just an update. This [pull request](https://github.com/Klipper3d/klipper/pull/6443) worked for me, we just have to hope more people test it and get it merged into Klipper. Basically it adds an option (-s) to the "flash-sdcard.sh" script that sets the correct SPI Clock for our Spider boards (and any other boards that have this issue). If it gets merged then all we would need to do is add t he -s option when flashing, instead of making our files dirty every time.

Thread 39 (2021-08-08):

Possible Issue in PinOut.SVG

xenon2008, 2021-08-08:
Good Morning,

I am planing to use one of the RGB Ports for a Chamber Fan on my Voron 2.4 which i am building currently.
Because i already had all 3 FAN Ports in use, i think over to use a RGB Port for a additional Fan (Chamber Fan)

I noticed that in the [PinOut.SVG ](https://raw.githubusercontent.com/FYSETC/FYSETC-SPIDER/main/Spider_V1.0_Pinout.svg) the Negative Pin is marked as Red?
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

And in the [Wiring.SVG](https://raw.githubusercontent.com/FYSETC/FYSETC-SPIDER/main/Spider_v1.0_wiring.svg) i think that "+" & "-" are reversed?
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

I am not 100% sure, but if i understand this right "+" should be left and "-" right? - regarding to this Diagram here:
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

bigsubgit, 2021-08-08:
Hello, I'm starting now to studying the spider for my new 2.4, how could be a negative pole if there we put a jumper cap?

bigsubgit, 2021-08-08:
Sorry, perhaps I was wrong in my previous post.

GerogeFu, 2021-08-10:
All '+' is 12v/24v , and '-' is GND

xenon2008, 2021-08-10:
>
>
> All '+' is 12v/24v , and '-' is GND

Sure, but i mean the color on the first picture.... GND is RED?
and on the second Picture i think the in the Green & Blue Section "+" & "-" are reversed?

GerogeFu, 2021-08-11:
No, the middle point is not GND, it is common point for jumper, so if you can close a jumper on 24v and the middle point or on 12v and the middle point. That means you can select voltage.

GerogeFu, 2021-08-11:
> Hello, I'm starting now to studying the spider for my new 2.4, how could be a negative pole if there we put a jumper cap?

jumper cap

xenon2008, 2021-08-11:
>
>
> No, the middle point is not GND, it is common point for jumper, so if you can close a jumper on 24v and the middle point or on 12v and the middle point. That means you can select voltage.

oh sorry my Mistake!
But it is also right that on the two Blue Ports  the Voltage Pin is right?

GerogeFu, 2021-08-12:
Stick to this: all '+' is 12v/24v, and all '-' is GND. Then you won't make mistake.

Thread 40 (2021-08-12):

"Can't write to TMC SPI "stepper_x/y/extruder register, GLOBALSCALER error"

Jhonno84, 2021-08-12:
Getting this error..

Example of my configs

[stepper_x]
step_pin: PE11
dir_pin: PE10
enable_pin: !PE9
microsteps: 16
rotation_distance: 40
endstop_pin: PB14  # PA1 for X-max
position_endstop: 0
position_max: 485

[tmc5160 stepper_x]
spi_bus: spi4
cs_pin: PE7
diag1_pin: PB14
run_current: 1
hold_current: 0.8
stealthchop_threshold: 0
interpolate: True

Tried different steppers in X leaving the others blank. This was working fine in my S6 V2.

Trying to do anything with the steppers with TMC5160 drivers causes Klipper to shutdown.

4 jumpers in the bottom positions on the driver slot, as per Spider Github.

Jhonno84, 2021-08-29:
I've tried a V1.0 5161 I have laying about, and that works. My others are V1.1 and they do not work.. There is a default SPI difference between the 2..
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

masterleo, 2022-11-05:
got the same issue but with nex drivers but on all axis
is it normal ?
# This file contains common pin mappings for the BigTreeTech Octopus V1.
# To use this config, the firmware should be compiled for the STM32F446 with a "32KiB bootloader"
# Enable "extra low-level configuration options" and select the "12MHz crystal" as clock reference

# after running "make", copy the generated "klipper/out/klipper.bin" file to a
# file named "firmware.bin" on an SD card and then restart the OctoPus with that SD card.

# See docs/Config_Reference.md for a description of parameters.

## Voron Design VORON2 250/300/350mm BigTreeTech OctoPus V1 tmc5160 UART config

## *** THINGS TO CHANGE/CHECK: ***
## MCU paths                            [mcu] section
## Thermistor types                     [extruder] and [heater_bed] sections - See https://www.klipper3d.org/Config_Reference.html#common-thermistors for common thermistor types
## Z Endstop Switch location            [safe_z_home] section
## Homing end position                  [gcode_macro G32] section
## Z Endstop Switch  offset for Z0      [stepper_z] section
## Probe points                         [quad_gantry_level] section
## Min & Max gantry corner postions     [quad_gantry_level] section
## PID tune                             [extruder] and [heater_bed] sections
## Probe pin                            [probe] section
## Fine tune E steps                    [extruder] section

[mcu]
##  Obtain definition by "ls -l /dev/serial/by-id/" then unplug to verify
##--------------------------------------------------------------------
serial: /dev/serial/by-id/usb-Klipper_stm32f429xx_250025001951303439373431-if00

restart_method: command
##--------------------------------------------------------------------

[printer]
kinematics: corexy
max_velocity: 300
max_accel: 3000             #Max 4000
max_z_velocity: 15          #Max 15 for 12V TMC Drivers, can increase for 24V
max_z_accel: 350
square_corner_velocity: 5.0

#####################################################################
#   X/Y Stepper Settings
#####################################################################

##  B Stepper - Left
##  Connected to MOTOR_0
##  Endstop connected to DIAG_0
[stepper_x]
step_pin: PF13
dir_pin: !PF12
enable_pin: !PF14
rotation_distance: 40
microsteps: 32
full_steps_per_rotation:200  #set to 400 for 0.9 degree stepper
endstop_pin: PG6
position_min: 0
##--------------------------------------------------------------------

##  Uncomment below for 250mm build
#position_endstop: 250
#position_max: 250

##  Uncomment for 300mm build
#position_endstop: 300
#position_max: 300

##  Uncomment for 350mm build
position_endstop: 350
position_max: 350

##--------------------------------------------------------------------
homing_speed: 25   #Max 100
homing_retract_dist: 5
homing_positive_dir: true

##  DEBUT DU CHANGE LEO ET MIKAEL
[tmc5160 stepper_x]
cs_pin: PC4
# Soft SPI
spi_software_mosi_pin: PA7
spi_software_miso_pin: PA6
spi_software_sclk_pin: PA5

interpolate: false
#diag1_pin: PB14
run_current: 0.8
hold_current: 0.5
#stealthchop_threshold: 0
##  FIN DU CHANGE LEO ET MIKAEL

## ## ## ######-------debut du code classique

## ## ## uart_pin: PC4
## ## ## interpolate: false
## ## ## run_current: 0.8
## ## ## sense_resistor: 0.110
## ## ## stealthchop_threshold: 0

##  A Stepper - Right
##  Connected to MOTOR_1
##  Endstop connected to DIAG_1
[stepper_y]
step_pin: PG0
dir_pin: !PG1
enable_pin: !PF15
rotation_distance: 40
microsteps: 32
full_steps_per_rotation:200  #set to 400 for 0.9 degree stepper
endstop_pin: PG9
position_min: 0
##--------------------------------------------------------------------

##  Uncomment for 250mm build
#position_endstop: 250
#position_max: 250

##  Uncomment for 300mm build
#position_endstop: 300
#position_max: 300

##  Uncomment for 350mm build
position_endstop: 350
position_max: 350

##--------------------------------------------------------------------
homing_speed: 25  #Max 100
homing_retract_dist: 5
homing_positive_dir: true

##  DEBUT DU CHANGE LEO ET MIKAEL
[tmc5160 stepper_y]
cs_pin: PD11
# Soft SPI
spi_software_mosi_pin: PA7
spi_software_miso_pin: PA6
spi_software_sclk_pin: PA5
interpolate: True
#diag1_pin: PB14
run_current: 0.8
hold_current: 0.5
#stealthchop_threshold: 0
##  FIN DU CHANGE LEO ET MIKAEL

## ## ## [tmc5160 stepper_y]
## ## ## uart_pin: PD11
## ## ## interpolate: false
## ## ## run_current: 0.8
## ## ## sense_resistor: 0.110
## ## ## stealthchop_threshold: 0

#####################################################################
#   Z Stepper Settings
#####################################################################

## Z0 Stepper - Front Left
##  Connected to MOTOR_2
##  Endstop connected to DIAG_2
[stepper_z]
step_pin: PF11
dir_pin: !PG3
enable_pin: !PG5
rotation_distance: 40
gear_ratio: 80:16
microsteps: 32
endstop_pin: PG10
##  Z-position of nozzle (in mm) to z-endstop trigger point relative to print surface (Z0)
##  (+) value = endstop above Z0, (-) value = endstop below
##  Increasing position_endstop brings nozzle closer to the bed
##  After you run Z_ENDSTOP_CALIBRATE, position_endstop will be stored at the very end of your config
position_endstop: -0.5
##--------------------------------------------------------------------

##  Uncomment below for 250mm build
#position_max: 210

##  Uncomment below for 300mm build
#position_max: 260

##  Uncomment below for 350mm build
position_max: 310

##--------------------------------------------------------------------
position_min: -5
homing_speed: 8
second_homing_speed: 3
homing_retract_dist: 3

##  DEBUT DU CHANGE LEO ET MIKAEL
[tmc5160 stepper_z]
cs_pin: PC6
# Soft SPI
spi_software_mosi_pin: PA7
spi_software_miso_pin: PA6
spi_software_sclk_pin: PA5
interpolate: True
#diag1_pin: PB14
run_current: 0.8
hold_current: 0.5
#stealthchop_threshold: 0
##  FIN DU CHANGE LEO ET MIKAEL

##  Make sure to update below for your relevant driver (2208 or 2209)
## ## ## [tmc5160 stepper_z]
## ## ## uart_pin: PC6
## ## ## interpolate: false
## ## ## run_current: 0.8
## ## ## sense_resistor: 0.110
## ## ## stealthchop_threshold: 0

##  Z1 Stepper - Rear Left
##  Connected to MOTOR_3
[stepper_z1]
step_pin: PG4
dir_pin: PC1
enable_pin: !PA0
rotation_distance: 40
gear_ratio: 80:16
microsteps: 32

##  DEBUT DU CHANGE LEO ET MIKAEL
[tmc5160 stepper_z1]
cs_pin: PC7
# Soft SPI
spi_software_mosi_pin: PA7
spi_software_miso_pin: PA6
spi_software_sclk_pin: PA5
interpolate: True
#diag1_pin: PB14
run_current: 0.8
hold_current: 0.5
#stealthchop_threshold: 0
##  FIN DU CHANGE LEO ET MIKAEL

## ## ## [tmc5160 stepper_z1]
## ## ## uart_pin: PC7
## ## ## interpolate: false
## ## ## run_current: 0.8
## ## ## sense_resistor: 0.110
## ## ## stealthchop_threshold: 0

##  Z2 Stepper - Rear Right
##  Connected to MOTOR_4
[stepper_z2]
step_pin: PF9
dir_pin: !PF10
enable_pin: !PG2
rotation_distance: 40
gear_ratio: 80:16
microsteps: 32

##  DEBUT DU CHANGE LEO ET MIKAEL
[tmc5160 stepper_z2]
cs_pin: PF2
# Soft SPI
spi_software_mosi_pin: PA7
spi_software_miso_pin: PA6
spi_software_sclk_pin: PA5
interpolate: True
#diag1_pin: PB14
run_current: 0.8
hold_current: 0.5
#stealthchop_threshold: 0
##  FIN DU CHANGE LEO ET MIKAEL

## ## ## [tmc5160 stepper_z2]
## ## ## uart_pin: PF2
## ## ## interpolate: false
## ## ## run_current: 0.8
## ## ## sense_resistor: 0.110
## ## ## stealthchop_threshold: 0

##  Z3 Stepper - Front Right
##  Connected to MOTOR_5
[stepper_z3]
step_pin: PC13
dir_pin: PF0
enable_pin: !PF1
rotation_distance: 40
gear_ratio: 80:16
microsteps: 32

##  DEBUT DU CHANGE LEO ET MIKAEL
[tmc5160 stepper_z3]
cs_pin: PE4
# Soft SPI
spi_software_mosi_pin: PA7
spi_software_miso_pin: PA6
spi_software_sclk_pin: PA5
interpolate: True
#diag1_pin: PB14
run_current: 0.8
hold_current: 0.5
#stealthchop_threshold: 0
##  FIN DU CHANGE LEO ET MIKAEL

##  Make sure to update below for your relevant driver (2208 or 2209)
## ## ## [tmc5160 stepper_z3]
## ## ## uart_pin: PE4
## ## ## interpolate: false
## ## ## run_current: 0.8
## ## ## sense_resistor: 0.110
## ## ## stealthchop_threshold: 0

#####################################################################
#   Extruder
#####################################################################

##  Connected to MOTOR_6
##  Heater - HE0
##  Thermistor - T0
[extruder]
step_pin: PE2
dir_pin: PE3
enable_pin: !PD4
##  Update value below when you perform extruder calibration
##  If you ask for 100mm of filament, but in reality it is 98mm:
##  rotation_distance = <previous_rotation_distance> * <actual_extrude_distance> / 100
##  22.6789511 is a good starting point
rotation_distance: 22.6789511   #Bondtech 5mm Drive Gears
##  Update Gear Ratio depending on your Extruder Type
##  Use 50:17 for Afterburner/Clockwork (BMG Gear Ratio)
##  Use 80:20 for M4, M3.1
gear_ratio: 50:17               #BMG Gear Ratio
microsteps: 32
full_steps_per_rotation: 200    #200 for 1.8 degree, 400 for 0.9 degree
nozzle_diameter: 0.400
filament_diameter: 1.75
heater_pin: PA2
## Check what thermistor type you hatve. See https://www.klipper3d.org/Config_Reference.html#common-thermistors for common thermistor types.
## Use "Generic 3950" for NTC 100k 3950 thermistors
sensor_type: PT1000
sensor_pin: PF4
min_temp: 10
max_temp: 270
max_power: 1.0
min_extrude_temp: 170
control = pid
pid_kp = 26.213
pid_ki = 1.304
pid_kd = 131.721
##  Try to keep pressure_advance below 1.0
#pressure_advance: 0.05
##  Default is 0.040, leave stock
#pressure_advance_smooth_time: 0.040

##  E0 on MOTOR6

##  DEBUT DU CHANGE LEO ET MIKAEL
[tmc5160 extruder]
cs_pin: PE1
# Soft SPI
spi_software_mosi_pin: PA7
spi_software_miso_pin: PA6
spi_software_sclk_pin: PA5
interpolate: True
#diag1_pin: PB14
run_current: 0.8
hold_current: 0.5
#stealthchop_threshold: 0
##  FIN DU CHANGE LEO ET MIKAEL

##  Make sure to update below for your relevant driver (2208 or 2209)
## ## ## [tmc5160 extruder]
## ## ## uart_pin: PE1
## ## ## interpolate: false
## ## ## run_current: 0.5
## ## ## sense_resistor: 0.110
## ## ## stealthchop_threshold: 0

#####################################################################
#   Bed Heater
#####################################################################

##  SSR Pin - HE1
##  Thermistor - TB
[heater_bed]
##  Uncomment the following line if using the default SSR wiring from the docs site
heater_pin: PA3
##  Other wiring guides may use BED_OUT to control the SSR. Uncomment the following line for those cases
#heater_pin: PA1
## Check what thermistor type you have. See https://www.klipper3d.org/Config_Reference.html#common-thermistors for common thermistor types.
## Use "Generic 3950" for Keenovo heaters
sensor_type: Generic 3950
sensor_pin: PF3
##  Adjust Max Power so your heater doesn't warp your bed. Rule of thumb is 0.4 watts / cm^2 .
max_power: 0.6
min_temp: 0
max_temp: 120
control: pid
pid_kp: 58.437
pid_ki: 2.347
pid_kd: 363.769

#####################################################################
#   Probe
#####################################################################

##  Inductive Probe
##  This probe is not used for Z height, only Quad Gantry Leveling
[probe]

#--------------------------------------------------------------------

## Select the probe port by type:
## For the PROBE port. Will not work with Diode. May need pull-up resistor from signal to 24V.
#pin: ~!PB7
## For the DIAG_7 port. NEEDS BAT85 DIODE! Change to !PG15 if probe is NO.
#pin: PG15
## For Octopus Pro PROBE port; NPN and PNP proximity switch types can be set by jumper
pin: ~!PC5

#--------------------------------------------------------------------

x_offset: 0
y_offset: 25.0
z_offset: 0
speed: 10.0
samples: 3
samples_result: median
sample_retract_dist: 3.0
samples_tolerance: 0.006
samples_tolerance_retries: 3

#####################################################################
#   Fan Control
#####################################################################

##  Print Cooling Fan - FAN0
[fan]
pin: PA8
kick_start_time: 0.5
##  Depending on your fan, you may need to increase this value
##  if your fan will not start. Can change cycle_time (increase)
##  if your fan is not able to slow down effectively
off_below: 0.10

##  Hotend Fan - FAN1
[heater_fan hotend_fan]
pin: PE5
max_power: 1.0
kick_start_time: 0.5
heater: extruder
heater_temp: 50.0
##  If you are experiencing back flow, you can reduce fan_speed
#fan_speed: 1.0

##  Controller fan - FAN2
[controller_fan controller_fan]
pin: PD12
kick_start_time: 0.5
heater: heater_bed

##  Exhaust fan - FAN3
#[heater_fan exhaust_fan]
#pin: PD13
#max_power: 1.0
#shutdown_speed: 0.0
#kick_start_time: 5.0
#heater: heater_bed
#heater_temp: 60
#fan_speed: 1.0

#####################################################################
#   LED Control
#####################################################################

## Chamber Lighting - HE2 Connector (Optional)
[output_pin caselight]
pin: PB10
pwm:true
shutdown_value: 0
value:1
cycle_time: 0.01

#####################################################################
#   Homing and Gantry Adjustment Routines
#####################################################################

[idle_timeout]
timeout: 1800

[safe_z_home]
##  XY Location of the Z Endstop Switch
##  Update -10,-10 to the XY coordinates of your endstop pin
##  (such as 157,305) after going through Z Endstop Pin
##  Location Definition step.
home_xy_position:-10,-10
speed:100
z_hop:10

##  Use QUAD_GANTRY_LEVEL to level a gantry.
##  Min & Max gantry corners - measure from nozzle at MIN (0,0) and
##  MAX (250, 250), (300,300), or (350,350) depending on your printer size
##  to respective belt positions
[quad_gantry_level]

#--------------------------------------------------------------------
##  Gantry Corners for 250mm Build
##  Uncomment for 250mm build
#gantry_corners:
#   -60,-10
#   310, 320
##  Probe points
#points:
#   50,25
#   50,175
#   200,175
#   200,25

##  Gantry Corners for 300mm Build
##  Uncomment for 300mm build
#gantry_corners:
#   -60,-10
#   360,370
##  Probe points
#points:
#   50,25
#   50,225
#   250,225
#   250,25

##  Gantry Corners for 350mm Build
##  Uncomment for 350mm build
gantry_corners:
   -60,-10
   410,420
##  Probe points
points:
   50,25
   50,275
   300,275
   300,25

#--------------------------------------------------------------------
speed: 100
horizontal_move_z: 10
retries: 5
retry_tolerance: 0.0075
max_adjust: 10

########################################
# EXP1 / EXP2 (display) pins
########################################

[board_pins]
aliases:
    # EXP1 header
    EXP1_1=PE8, EXP1_2=PE7,
    EXP1_3=PE9, EXP1_4=PE10,
    EXP1_5=PE12, EXP1_6=PE13,    # Slot in the socket on this side
    EXP1_7=PE14, EXP1_8=PE15,
    EXP1_9=<GND>, EXP1_10=<5V>,

    # EXP2 header
    EXP2_1=PA6, EXP2_2=PA5,
    EXP2_3=PB1, EXP2_4=PA4,
    EXP2_5=PB2, EXP2_6=PA7,      # Slot in the socket on this side
    EXP2_7=PC15, EXP2_8=<RST>,
    EXP2_9=<GND>, EXP2_10=<5V>

#####################################################################
#   Displays
#####################################################################

##  Uncomment the display that you have
#--------------------------------------------------------------------

##  RepRapDiscount 128x64 Full Graphic Smart Controller
[display]
lcd_type: st7920
cs_pin: EXP1_4
sclk_pin: EXP1_5
sid_pin: EXP1_3
menu_timeout: 40
encoder_pins: ^EXP2_5, ^EXP2_3
click_pin: ^!EXP1_2

[output_pin beeper]
pin: EXP1_1

#--------------------------------------------------------------------

##  mini12864 LCD Display
#[display]
#lcd_type: uc1701
#cs_pin: EXP1_3
#a0_pin: EXP1_4
#rst_pin: EXP1_5
#encoder_pins: ^EXP2_5, ^EXP2_3
#click_pin: ^!EXP1_2
#contrast: 63
#spi_software_miso_pin: EXP2_1
#spi_software_mosi_pin: EXP2_6
#spi_software_sclk_pin: EXP2_2

##  To control Neopixel RGB in mini12864 display
#[neopixel btt_mini12864]
#pin: EXP1_6
#chain_count: 3
#initial_RED: 0.1
#initial_GREEN: 0.5
#initial_BLUE: 0.0
#color_order: RGB

##  Set RGB values on boot up for each Neopixel.
##  Index 1 = display, Index 2 and 3 = Knob
#[delayed_gcode setdisplayneopixel]
#initial_duration: 1
#gcode:
#        SET_LED LED=btt_mini12864 RED=1 GREEN=1 BLUE=1 INDEX=1 TRANSMIT=0
#        SET_LED LED=btt_mini12864 RED=1 GREEN=0 BLUE=0 INDEX=2 TRANSMIT=0
#        SET_LED LED=btt_mini12864 RED=1 GREEN=0 BLUE=0 INDEX=3

#--------------------------------------------------------------------

#####################################################################
#   Macros
#####################################################################

[gcode_macro G32]
gcode:
    SAVE_GCODE_STATE NAME=STATE_G32
    G90
    G28
    QUAD_GANTRY_LEVEL
    G28
    ##  Uncomment for for your size printer:
    #--------------------------------------------------------------------
    ##  Uncomment for 250mm build
    #G0 X125 Y125 Z30 F3600

    ##  Uncomment for 300 build
    #G0 X150 Y150 Z30 F3600

    ##  Uncomment for 350mm build
    #G0 X175 Y175 Z30 F3600
    #--------------------------------------------------------------------
    RESTORE_GCODE_STATE NAME=STATE_G32

#   Use PRINT_START for the slicer starting script - please customise for your slicer of choice
[gcode_macro PRINT_START]
gcode:
    G32                            ; home all axes
    G90                            ; absolute positioning
    G1 Z20 F3000                   ; move nozzle away from bed

#   Use PRINT_END for the slicer ending script - please customise for your slicer of choice
[gcode_macro PRINT_END]
gcode:
    # safe anti-stringing move coords
    {% set th = printer.toolhead %}
    {% set x_safe = th.position.x + 20 * (1 if th.axis_maximum.x - th.position.x > 20 else -1) %}
    {% set y_safe = th.position.y + 20 * (1 if th.axis_maximum.y - th.position.y > 20 else -1) %}
    {% set z_safe = [th.position.z + 2, th.axis_maximum.z]|min %}

    SAVE_GCODE_STATE NAME=STATE_PRINT_END

    M400                           ; wait for buffer to clear
    G92 E0                         ; zero the extruder
    G1 E-5.0 F1800                 ; retract filament

    TURN_OFF_HEATERS

    G90                                      ; absolute positioning
    G0 X{x_safe} Y{y_safe} Z{z_safe} F20000  ; move nozzle to remove stringing
    G0 X{th.axis_maximum.x//2} Y{th.axis_maximum.y - 2} F3600  ; park nozzle at rear
    M107                                     ; turn off fan

    BED_MESH_CLEAR
    RESTORE_GCODE_STATE NAME=STATE_PRINT_END

Thread 41 (2021-08-13):

Having issues installing Marlin onto the Fysetc-Spider

420Ayan420, 2021-08-13:
I have flashed by board with the new bootloader functions (_Bootloader-FYSETC_S6.hex_) using STM32CubeProgrammer, and all went well, but I am getting and error where PlatformIO gives me an error of the board _FYSETC_S6_8000_ being undefined:

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

Am I being a complete idiot, or is this where I should be changing _FYSETC_S6_ to _FYSETC_S6_8000_
in the _platformio.ini_ file. According to this https://github.com/FYSETC/FYSETC-SPIDER#41-marlin

**But github says this:**
You need to enable following define in configuration.h file

#define MOTHERBOARD BOARD_FYSETC_SPIDER
default_envs = FYSETC_S6 (For old bootloader,boot address is 0x10000, see below)
default_envs = FYSETC_S6_8000 (For new bootloader,boot address is 0x8000, see below)

So upon searching for _default_envs_ in _Configuration.h_ I have not found it

I Believe the board is not damaged as when I bridge Boot0 and 3.3V the board goes into DFU mode and STM32CubeProgrammer connects successfully.

Since _FYSETC_S6_8000_ is not available, and I am getting an error I went back to the old bootloader _Bootloader-FYSETC_S6_10000_, I have compiled my code, and have uploaded through STM32CubeProgrammer using the old bootloader with _default_envs = FYSETC_S6_ instead.

When I exit DFU mode and try turning on the board, the board turns on fine, but windows does not detect the board as a device in device manager, and the board's LCD does not light up. I am using the pre-provided firmware from the Fysetc-Spider Github Repo, but have changed the LCD to RepRapDiscount Full Graphic Smart Controller.

Thank you in advance for any help you offer, I will try to reply with any more important information you may need as fast as possible!

GerogeFu, 2021-08-13:
Sorry, this should be my fault, i just update the ini. You can have a try now.

420AyanAli, 2021-08-13:
Alright I'll have a look now!

420AyanAli, 2021-08-14:
I've done some further testing, and the same problem is still there @GerogeFu

GerogeFu, 2021-08-19:
The version in our github is little bit old, please try Marlin upstream bugfix-2.0.x, i will fix this ASAP.

420AyanAli, 2021-08-20:
Okay, I'll try and set that up later today, and thank you

420AyanAli, 2021-08-20:
Alright everything has compiled successfully, I have uploaded the successfully compiled bootloader to the board using STM32CubeProgrammer, but once again the LCD does not turn on, nor does the board get detected by windows Device manager. Attached is my marlin folder with all my files and the success message:

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

My STM32CubeProgrammer configuration:

File path: C:\Users\ayana\Desktop\Marlin\Marlin-bugfix-2.0.x (Cantilever)\Marlin-bugfix-2.0.x\buildroot\share\PlatformIO\scripts
Start Address: 0x08008000 (as I am using default_envs = FYSETC_S6_8000)

420AyanAli, 2021-08-20:
Alright everything has compiled successfully, I have uploaded the successfully compiled bootloader to the board using STM32CubeProgrammer, but once again the LCD does not turn on, nor does the board get detected by windows Device manager. Attached is my marlin folder with all my files and the success message:

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
[Marlin-bugfix-2.0.x.zip](https://github.com/FYSETC/FYSETC-SPIDER/files/7021398/Marlin-bugfix-2.0.x.zip)

My STM32CubeProgrammer configuration:

File path: C:\Users\ayana\Desktop\Marlin\Marlin-bugfix-2.0.x (Cantilever)\Marlin-bugfix-2.0.x\.pio\build\FYSETC_S6_8000\firmware.bin
Start Address: 0x08008000 (as I am using default_envs = FYSETC_S6_8000)

GerogeFu, 2021-08-28:
Did you change configuration.h file? The serial post should be -1.

420AyanAli, 2021-08-29:
Yes, I have changed it to -1

GerogeFu, 2021-09-03:
I test again. It works, you should upload bootloader https://github.com/FYSETC/FYSETC-SPIDER/blob/main/bootloader/Bootloader_FYSETC_SPIDER.hex. When uploading the firmware, you need to check the boot offset is right or not.
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

GerogeFu, 2021-09-03:
I just update the Marlin firmware in our github.

420AyanAli, 2021-09-05:
Alright, I will have a look in a few hours, by boot offset do you mean the Start Address being 0x08008000?

GerogeFu, 2021-09-07:
Yes

> Alright, I will have a look in a few hours, by boot offset do you mean the Start Address being 0x08008000?

Closed 2024-06-18.

Thread 42 (2021-08-28):

Klipper w/ PT100 amplifier, wrong temp

Thelm76, 2021-08-28:
Hi,
I have a PT100 amplifier from triangle labs connected like this (to get 5V in amp board) :
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

In klipper I tried "PT100 INA826" and "AD595" in sensor-type, with and without ADC voltage to 5V.

I even created my own sensor type using datasheet from E3D amp like this :
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

The temperature table :
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

but even if I measure 1.20V-1.24V with a voltmeter on the signal pin (while connected to the board) the klipper displays around 190°C...

EDIT : I just realised my custom sensor was misconfigured, but the issue is still here with this config :
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

Heating the hotend with a lighter raised the displayed temp to 213°C with 1.296V measured with voltmeter

Thelm76, 2021-09-03:
I managed to get correct measurements using "PT100 INA286" and removing this pullup resistor from the board (and the filter capacitor but I think it's not mandatory) :
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

weirdly, the "adc_voltage" in klipper should remain configured to 5V to get the proper value
my hypothesis is that the stm32 is reading the value between 0-3.3V and amp voltage is 3.3V so 3.3V/3.3V, but klipper expects a value betwene 0-5V so adc_voltage should remain to 5V to get this 1:1 ratio.

Further measurements will be needed just to be sure the sensor is properly calibrated

Thelm76, 2021-09-03:
By the way, the amplifier should not be connected to a pull-up pin, so @GerogeFu I have a suggestion, maybe for V1.2 :
you should add a way to easily deactivate these pull-up resitors (little switch, or unweldable track)

Closed 2021-09-03.

Thread 43 (2021-08-30):

max heater power

rupsimrd, 2021-08-30:
hello everyone!

can i use 100W hotend heater at 24V? or is it too much?

Thelm76, 2021-08-30:
Usually the cartridge has a nominal voltage, you should stick to this voltage if you don't want bad surprises.
However 100W at 24V means 100/24 ~= 4 amps, which should be okay for the board to handle (to check)

rupsimrd, 2021-08-30:
thank you!

Thread 44 (2021-08-31):

TMC2208

msazanov, 2021-08-31:
Good afternoon, faced with problem drivers tmc2208 bt fysetc

https://aliexpress.ru/item/32848553467.html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

After setting up the configuration when testing the motors with the command
STEPPER_BUZZ STEPPER = stepper_x
Cooler hotend starts spinning 100%
And the printer falls out into an error:
Recv: // Unable to read tmc uart 'stepper_x' register IFCNT
Recv: // Once the underlying issue is corrected, use the
Recv: // "FIRMWARE_RESTART" command to reset the firmware, reload the
Recv: // config, and restart the host software.
Recv: // Printer is shutdown
Recv: // Klipper state: Not ready
Recv: !! Unable to read tmc uart 'stepper_x' register IFCNT

[klipper.log](https://github.com/FYSETC/FYSETC-SPIDER/files/7086101/klipper.log)
[printer.txt](https://github.com/FYSETC/FYSETC-SPIDER/files/7086138/printer.txt)
I also use Raspberry 3b + connected via UART

please help!!!

GerogeFu, 2021-09-01:
You need to solder the 3 pad to join them together.
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

msazanov, 2021-09-01:
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
I know about the jumper and it has been sealed for more than 3 years :) Previously, I used these drivers on the MKS GEN-L there was made a splitter with a resistor going to the UART pins (RX and TX) If you look at the Spider v1.1 circuit from the PDN contact (for example, motor x) there is one wire that goes directly to PD7, it seems to me that this may be the problem, but I'm not sure.

msazanov, 2021-09-01:
Found a solution! for the tmc2208 drivers from fysetc, the UART is on pin 5, when on the spyder PDN board pin 4. To fix this problem, it is enough to solder pins 4 and 5 from the driver together.
PS: on this driver pin # 4 is NC and is not connected to the chip
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

Thread 45 (2021-09-04):

Cant connect to Klipper anymore

futzicomp, 2021-09-04:
Hello maybe one of you can help me?

I bought a board on 2021 -06 -28 directly from the official FYSTEC store at Ali. It should have a 32kb bootloader.

I was able to flash klipper.bin with 64k bootloader offset onto the board by using an SD-Card. (so it was equiped with the old bootloader?)

Since I often had "internal server" erros I decided to rebuilt my system. I made the mistake of using the STMCubeprogrammer this time.
I flashed the 32kb bootloader and the corresponding 32K-Uart-Klipper.bin (bootloaderoffset 0x08008000). After that I can no longer connect to Klipper.
I tried the old bootloader( 0x10000) with 64k-uart-klipper.bin (0x08010000).
I tried with no bootloader (-> offset 0x08000000)

The result is always the same. Klipper does not connect to the board. See Klippy.log --> [klippy.txt](https://github.com/FYSETC/FYSETC-SPIDER/files/7109523/klippy.txt)

What can I do??????

RcTomcat1, 2021-10-05:
mcu 'mcu': Timeout on connect

Did you try and reflash the bootloader as descriibed here: https://github.com/FYSETC/FYSETC-SPIDER/tree/main/bootloader
Did you try and flash a self-compiled klipper.bin instead of the prebuild ones? It is just make menuconfig, selecting the right values followed by a make. Copy the newly created file to sd card and rename it.

I would try to reflash the bootloader so it supports a 32k offset + flash a selfbuild 32k offset firmware.bin afterwards

Thread 47 (2021-09-14):

% Complete does not update on my mini 12864 LCD Display

BNeuf73, 2021-09-14:
Am I missing something in my printer.cfg that my % complete does not update on the LCD screen.
It does update in Octoprint just fine.

All other functions work correctly on screen. Using Spider V1.0 board with my Voron 2.4 setup.

GerogeFu, 2021-10-15:
This should be related to klipper firmware, better to update your klipper, then have a try.

yojoebosolo, 2022-03-20:
did you ever get this sorted? I have the same issue.

BNeuf73, 2022-03-20:
Yes I did get it resolved. The gcode command M73 will resolve the problem. You can either enter this manually in Octoprint command line before you start printing or add it to the "start gcode" in your printer settings in cura.

Thread 48 (2021-10-04):

X+ y+ voltage selector

RcTomcat1, 2021-10-04:
Hi,

On the pinout it says 3.3v default/5v for the X+ and y+ voltage pins.
How is that set? So far I could not find any info on that. Am I missing something? Just want to make sure I don't fry anything when I try to repurpose those ports for a runout Sensor.

GerogeFu, 2021-10-15:
Cut the red line position with a knife, and solder the green line shows. Then check the connection among these three point with a multimeter. 3.3v and middle point connection should break, and 5v and middle point connected.
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

Thread 49 (2021-10-05):

Error in PinOut.SVG

lvitol, 2021-10-05:
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
'X+ ENDSTOP' and 'E2-DIAG' should share PA1
'Z+ ENDSTOP' and 'E0-DIAG' should share PA3

GerogeFu, 2021-10-15:
Oh, thanks, we will correct it.

Thread 51 (2021-10-14):

Enclosure Heater

zhangvicto, 2021-10-14:
Hi,

I was wondering if it is possible to change one of the hotend pins to connect to an SSR to power an enclosure heater (heat resistors, PTC, etc., it will be connected to mains).

Thanks :)

zhangvicto, 2021-10-15:
Thank you! I think I can just use Marlin or do some custom code for Klipper.

Closed 2021-10-24.

Thread 54 (2021-10-30):

New board won’t connect

shadowdro, 2021-10-30:
I have a brand new board that has been in the antistatic bag until last night. I recently purchased the Voron 2.4 kit. I am unable to get it into dfu mode. I followed the instructions on the wiki.￼￼ I am unable to get it into DFU mode. Since the 32K boot loader supposed to be on the board since June I tried flashing the 32K uart via SD card.￼, which appears to have failed. And then tried doing the same for USB, and neither can connect to the pi.￼ right now when I put the firmware on an SD and put it onto the board it stays flashing for over 40 minutes. ￼after looking through these issue requests I tried clearing the power on the board and removing the stepper drivers and everything except for the two jumpers to enter DFU mode. It is still unable to connect and does not seem to respond via any commands. Please assist.￼

shadowdro, 2021-10-30:
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

RcTomcat1, 2021-10-30:
Same here. Just connected my board for the first time. Nothing. Tried with a Linux and Windows system, three different usb cables, 24 and 5v....no dfu ....

shadowdro, 2021-10-31:
￼￼someone in the Discord said they received a charge only usb cable. I'm going to try another usb cable and  see if that fixes B it.

shadowdro, 2021-10-31:
Tried new USB cable.... it connected... Kit came with charge only USB....

Closed 2021-10-31.

Thread 55 (2021-11-03):

Nevermore Micro V5 Duo Not working on E1 Out

laserbeak, 2021-11-03:
Hello,
I have a Nevermore Micro V5 Duo that isn't working on E1 Out. When I start it, it runs fun but eventually slows down and completely stops.
Here's my printer.cfg:

```
[fan_generic nevermore]
#  Nevermore - In E1 OUT Position
pin: PC8
max_power: 1.0
kick_start_time: 0.5
```

And here are my macros that I use to control it:
```
[gcode_macro nvmOff]
gcode:
    SET_FAN_SPEED FAN=nevermore SPEED=0

[gcode_macro nvmHi]
gcode:
    SET_FAN_SPEED FAN=nevermore SPEED=1

[gcode_macro nvmMid]
gcode:
    SET_FAN_SPEED FAN=nevermore SPEED=.5

[gcode_macro nvmLo]
gcode:
    SET_FAN_SPEED FAN=nevermore SPEED=.25
```

Does anyone have any ideas?

GerogeFu, 2021-11-04:
You can switch your E1 OUT to FAN0 if your FAN0 works to check if the board works, be careful that FAN0 max current is 1A, so your nevermore fan current should not exceed 1A

laserbeak, 2021-11-04:
Thanks for the reply. My hotend fan is connected to FAN0 and functions normally.  All fan ports are populated (Voron 2.4)

Thread 57 (2021-11-11):

Custom software not running with Platformio

deladriere, 2021-11-11:
I am trying to build my own software on the Fystec-spider

I want to blink the  flash LED as a test.

```
#include <Arduino.h>

void setup()
{
    pinMode(PD3, OUTPUT);
}

void loop()
{
    digitalWrite(PD3, LOW);
    delay(1000);
    digitalWrite(PD3, HIGH);
    delay(1000);
}
```
I can upload with success using ST-LINK
but it won't run.

Do I have to make a "special platformio.ini?
Mine is :
```
[env:fysetc_s6]
platform = ststm32
board = fysetc_s6

framework = arduino

; change MCU frequency
board_build.f_cpu = 168000000L
````
Thanks a lot !

deladriere, 2021-11-12:
if I use rumba32_f446ve in the  platformio.ini
it works  !!!
````
[env:mycode]

platform = ststm32
board = rumba32_f446ve
;board = fysetc_s6
framework = arduino

```

Thread 58 (2021-11-12):

many problem with Spider and bad support from FYSETC

quocanhcgd, 2021-11-12:
i have 2 board spider 1.1
One of this work well but other don't work.
My board has many problems:
1. When i flash usb firmware . Pi not recorgnize.
2. When i flash uart mod. Pi can connect it. But no heat extruder, no heat bed. I see led of heat not light up. use voltage meter no power out to extruder and bed.
3. I try contact fysetc on taobao but they don't know why and want me to write on github. no star for FYSETC support.
With me 30-40usd is not problem. But it can use to evaluate level of support.
next time i will buy from bigtree and mks.

GerogeFu, 2021-11-12:
We checked the video you sent, and give you support, you can check the message.

GerogeFu, 2021-11-16:
Use no bootloader option when compile klipper and fix heat section in config works.

quocanhcgd, 2021-11-17:
Confirm usb can connect if use no bootloader. But heat still not work. I request change new board.

Thread 59 (2021-11-15):

USB connection problem

sirriaksu, 2021-11-15:
Hi, I couldn’t connect spider v1.1 via the uart and when i try with a usb it works but every turn on and off i have to took Raspberry pi 4 usb port off and reconnect to a different usb port. I couldn’t find a solution to this provided, what do you suggest I should do? As the not firmware being downloaded, i tried both bootloader 32 and no bootloader options but the same problem occurs every time.

GerogeFu, 2021-11-16:
It seems it is the pi system issue. I recommend you use octopi system.

Thread 61 (2021-11-17):

only 2 out of 4 Z drives works with Marlin fw

Zooyork01, 2021-11-17:
I am uploading the marlin fw on a spider v1.1 which drives a voron 2.4 with 4 Z drive.
In configuration_adv.h default: #define NUM_Z_STEPPER_DRIVERS 1
By default only 1 driver is selected and it will run M3 driver
If I choose 4 drivers then the error : No E stepper plug left for Z4!
If I choose 3 driver then only M6 M3 works.
I believe the issue is that all missing channels are configured as extruder and not as potential Z drive.

Is there a properly configured firmware exist for voron 2.4 Spider? Or do you have fix for this issue? Thanks in advance

GerogeFu, 2021-11-18:
Normally, we use Klipper firmware to run voron2.4. Don't have Marlin version yet, but if you want to run it, i think, you need to change `pins_FYSETC_S6.h` file
Change E1_* E2_* to Z3_* Z4_*
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

Zooyork01, 2021-11-18:
Thanks for the quick answer I tried and it works for first try! I have now 4 Z motors working.

Where should I share my final firmware? I am building a voron 2.4 400x400 mm. Would be kind to the users to make it available.

Thread 62 (2021-11-21):

Connection issue via Serial to RPi4

Scroeder, 2021-11-21:
I flashed the board following the instructions. It works but after some configs savings in klipper or a self determined Emergency Shutdown klipper is not able to connect again. I have to powerup the whole system to get it working again. The reset button does not work.

`mcu 'mcu': Timeout on connect
mcu 'mcu': Wait for identify_response
Traceback (most recent call last):
  File "/home/pi/klipper/klippy/serialhdl.py", line 69, in _get_identify_data
    params = self.send_with_response(msg, 'identify_response')
  File "/home/pi/klipper/klippy/serialhdl.py", line 258, in send_with_response
    return src.get_response([cmd], self.default_cmd_queue)
  File "/home/pi/klipper/klippy/serialhdl.py", line 316, in get_response
    cmd_queue)
  File "/home/pi/klipper/klippy/serialhdl.py", line 250, in raw_send_wait_ack
    self._error("Serial connection closed")
  File "/home/pi/klipper/klippy/serialhdl.py", line 62, in _error
    raise error(self.warn_prefix + (msg % params))
error: mcu 'mcu': Serial connection closed`

Thread 63 (2021-11-22):

Issues with USB and UART connections on several Spider boards, can't flash

ad0ll, 2021-11-22:
I've somehow exhausted my supply of 6x Spider 1.1 boards, and am not sure what my next steps are.

The problem: Can't connect to boards over USB. The 3.3v light won't come on. Each board worked initially, and then stopped working after adding and removing stepper drivers and moving cords around.

Here's what I've tried so far:
1. I've left jumpers between VMOT and MAIN_PWR per [these instructions](https://github.com/FYSETC/FYSETC-SPIDER/blob/main/Spider%203.3v%20issue.md) for several hours. Still can't get 3.3v to turn on.
2. I've tried disconnecting all my stepper drivers. I can't connect with or without them plugged in
3. I've tried powering the boards with USB, 24v and UART
4. I've swapped out cords several times
5. I've swapped out stepper drivers with new ones a few times
6. Visually inspecting for damage to the best of my ability
7. Checked the fuses with a multimeter
8. Removing all jumpers on one board

For three of the boards, I remember the exact point they stopped working.
1. One stopped working when I plugged in the uart cable upside down.
2. One stopped working when I plugged in a stepper driver upside down
3. One stopped working when the silkscreen on one's FFC mod stripped and the screw caused the heater wires to short
4. For the other three, they worked when powered on the first time, and then stopped working after power cycling a few times

Each board displays the problem in subtly different ways, but the net result is the same, not being able to connect over USB and not being able to flash them:
1. 5 of them will show the 24v LED when powered on, and then the 24v LED will take a very long time (30 seconds) to dim out.
2. 2 of them will power on with 24v, but will shut off my Pi when I attempt to power with
3. One board shorts my PSU and shorts with UART. I've disconnected everything and can't find a short on the board. This is the only one that won't power on. Instead, the 24v light fades in and out at a rhythm.
4. The flash led doesn't power on on any of them

Is there anything I can do to definitively prove that my 6 boards are either working or are broken? And if broken, is there a warranty on the boards? This has been an expensive and time consuming experiment, so I'm looking at the Octopus unless there's something I can do to get these to work.

ad0ll, 2021-11-27:
Talked to the vendor about the issues. Several boards are having the "3.3v issue" characteristic of the 1.x boards. Vendor says this problem is fixed in 2.2 and is sending me 3 replacement boards.

Closed 2021-11-27.

Thread 64 (2021-11-24):

[heater_bed] heater_pin: PB4 not working

dodasch, 2021-11-24:
If i configure my bed to PB3, there is no LED or 24V working.
If i configure the bed to PB4, the LED is on and i have 24V.

Is the PB3 Pin defect? Everything else works fine.

acidcoolxxx, 2022-01-20:
On my board the v2.2 the PB4 bin is Fan2 WTF

mrw464, 2022-01-30:
Yeah on my 2.v2, PB4 does not work for the BED OUT. Not sure what's going on there. I ended up using PB3 / the E2 OUT.

fmonaca, 2022-04-03:
You have to feed 24v to the BED IN port to have power going to PB4 and out to the SSR, or there will be no current to switch on PB4. You can have the 24v coming directly from the PSU or you can get it from the POWER of the Spider.

fmonaca, 2022-04-03:
> On my board the v2.2 the PB4 bin is Fan2 WTF

Are you using it on a Voron? The printer.cfg for a Voron usually links FAN2 (controller fan) to the bed activation, so that the skirt fans turn on as soon as the bed is on.

Laroto, 2023-01-05:
> You have to feed 24v to the BED IN port to have power going to PB4 and out to the SSR, or there will be no current to switch on PB4. You can have the 24v coming directly from the PSU or you can get it from the POWER of the Spider.

What if I am using DC bed heater? I want to use a 100W DC heater but no idea on how to wire it

netweaver1970, 2023-01-05:
wiring example for from the Fysetc site ... look at the black heater connection, that's a DC heater.

> > You have to feed 24v to the BED IN port to have power going to PB4 and out to the SSR, or there will be no current to switch on PB4. You can have the 24v coming directly from the PSU or you can get it from the POWER of the Spider.
>
> What if I am using DC bed heater? I want to use a 100W DC heater but no idea on how to wire it

wiring examples on the Fysetc wiki ... look at the black heater's connection, that's the DC heater. https://wiki.fysetc.com/Spider/#31-spider-wiring

Thread 65 (2021-11-29):

Unable to communicate with TMC2209 3.1 on X/Y-MOT only (spider 2.2)

alexnagelberg, 2021-11-29:
I have everything the same as the wiring diagram and printer.cfg on wiki and even swapped the TMC2209 chips around to see if they were dead for any reason but they work fine on the others. When I communicate with E[0-4]-MOT and Z-MOT they all work just fine -- same jumper, same driver installed. I get this error for X and Y-MOT trying DUMP_TMC on klipper: `Unable to read tmc uart 'stepper_x' register GCONF` and `Unable to read tmc uart 'stepper_x' register IFCNT` when trying STEPPER_BUZZ.

Using included v3.1 TMC2209 drivers with spider v2.2 board and klipper (printer.cfg off wiki, pins matching pinout diagram)

GerogeFu, 2021-11-29:
How many jumpers on your X and Y stepper driver slot?

alexnagelberg, 2021-11-29:
One for the PDN -- same as the wiring diagram on wiki and the Z and E MOTs.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

alexnagelberg, 2021-11-29:
Turns out it needs a jumper on the 24v. No idea what that connector was until someone on discord helped. Could you please update the 2.2 docs to make a note on the top right header for those two motors?

GerogeFu, 2021-11-30:
Try to replace the jumper on the socket downside. Sometime it affect. And how many jumpers did you use for the stepper driver?

GerogeFu, 2021-11-30:
There is no room for this note, you can check our Trident kit diagram here https://github.com/FYSETC/FYSETC-Voron-Trident/blob/main/VORON_Trident_Spider_v22_Wiring.png

alexnagelberg, 2021-11-30:
That yellow box is perfect. That guide was certainly not the easiest to find but hopefully someone else struggling will come across this and see it. Thanks!

geaz, 2022-01-12:
I was also struggling with this, because I use a 12V PSU and thought this info is not relevant for me. Turns out it is ....

kkmvoron, 2022-09-15:
I did the same like as you and got same error. Do you find out solution ?

Thread 66 (2021-12-01):

TMC 'stepper_x' reports error: GSTAT: 00000004 uv_cp=1

skfab, 2021-12-01:
I am getting this error on my Voron2.4 Spider 1.1 with 2209 3.1 Fysetc stepsticks, After starting a print I will get it on ether the x or y axis. I have replaced the x and y 2209s with new ones but no change. Any help would much appreciated.

TMC 'stepper_x' reports error: GSTAT:
00000004 uv_cp=1 (Undervoltage!)

skfab, 2021-12-02:
I changed the stealthchop_threshold from 1  to 0 and raised the current settings, it seems to be working now.

bogeyf14, 2021-12-19:
I am having the same issue on my spider v1.0 with tmc 2209 3.1. I also have stealthchop_threshold set to 1 and motor current is set to about 85% of rated current

dawidmpunkt, 2022-03-11:
> I am having the same issue on my spider v1.0 with tmc 2209 3.1. I also have stealthchop_threshold set to 1 and motor current is set to about 85% of rated current

Because I was also having this issue: A faulty stepper cable also causes this error. Try another stepper cable.

warrenfalk, 2022-06-27:
I received this same error a few days ago due to what turned out to be a bad 2209 (for anyone else coming here googling this error message). I ended up swapping slots with a working 2209 just to confirm the issue and then replaced it with a new one and the problem is resolved. The 2209 had worked fine for a couple years before giving out.

P1P1Monster, 2023-03-27:
Same situation, Cable problem or stepper driver broken both may cause this issue

WaschBaer0395, 2024-01-13:
same issue but its neither the stepper driver ( tested ) nor the cable ( swapped with a different one ) or the motor ( also swapped with a motor not throwing this error )
this only happens during homing sensorless sometimes and only way to fix it is to restart the whole printer

petercabra, 2024-03-18:
I am having the same issue, happens randomly when homing sensorless, mostly on Y axis (voron 2.4r2). Only way to fix it is to fix it is restarting the whole printer.

Closed 2021-12-02.

Thread 67 (2021-12-02):

Can't connect to Spider with Raspberry Pi

OzzieOrca, 2021-12-02:
I can't seem to get my Raspberry Pi 3 Model B+ to connect to the Spider v1.1 board. Here's a list of things I've tried so far:

1. `ls -l /dev/serial/by-id/` returns `ls: cannot access '/dev/serial/by-id/': No such file or directory`
2. I copied `~/klipper/out/klipper.bin` to `firmware.bin` on the Raspberry Pi's SD Card, inserted that SD card in to the spider and powered the spider on. The Flash LED blinked quickly for 10s of seconds and then became solid. I've since tried that a couple times.
3. Before inserting the SD card the first time, I think the Flash LED blinked quickly on power up. After flashing and removing the SD card, the LED seems to stay off.
3. When in DFU mode (jumper between `3.3V` and `BT0`), `dfu-util --list` returns
    ```bash
    dfu-util 0.9

    Copyright 2005-2009 Weston Schmidt, Harald Welte and OpenMoko Inc.
    Copyright 2010-2016 Tormod Volden and Stefan Schmidt
    This program is Free Software and has ABSOLUTELY NO WARRANTY
    Please report bugs to http://sourceforge.net/p/dfu-util/tickets/
    ```
4. When in DFU mode, `dfu-util -R -a 0 -s 0x08008000:leave -D ~/klipper/out/klipper.bin` returns
    ```bash
    dfu-util 0.9

    Copyright 2005-2009 Weston Schmidt, Harald Welte and OpenMoko Inc.
    Copyright 2010-2016 Tormod Volden and Stefan Schmidt
    This program is Free Software and has ABSOLUTELY NO WARRANTY
    Please report bugs to http://sourceforge.net/p/dfu-util/tickets/

    dfu-util: Invalid DFU suffix signature
    dfu-util: A valid DFU suffix will be required in a future dfu-util release!!!
    dfu-util: No DFU capable USB device available
    ```
5. `dmesg -wH` returns a few different thing depending on how the board is powered and DFU mode:
    a. Non-DFU mode powered by 24v, no messages
    b. DFU mode powered by 24v
    Googling `error -110` seems to often indicate a power issue
    ```bash
    [Dec 2 02:02] usb 1-1.3: new full-speed USB device number 5 using dwc_otg
    [ +15.240212] usb 1-1.3: device descriptor read/64, error -110
    [ +15.360226] usb 1-1.3: device descriptor read/64, error -110
    [  +0.219991] usb 1-1.3: new full-speed USB device number 6 using dwc_otg
    [ +15.220212] usb 1-1.3: device descriptor read/64, error -110
    [Dec 2 02:03] usb 1-1.3: device descriptor read/64, error -110
    [  +0.120108] usb 1-1-port3: attempt power cycle
    [  +0.659938] usb 1-1.3: new full-speed USB device number 7 using dwc_otg
    [ +10.540067] usb 1-1.3: device not accepting address 7, error -110
    [  +0.100008] usb 1-1.3: new full-speed USB device number 8 using dwc_otg
    [ +10.540063] usb 1-1.3: device not accepting address 8, error -110
    [  +0.000114] usb 1-1-port3: unable to enumerate USB device
    [Dec 2 02:09] usb 1-1.3: new full-speed USB device number 9 using dwc_otg
    [ +15.240071] usb 1-1.3: device descriptor read/64, error -110
    [ +15.359972] usb 1-1.3: device descriptor read/64, error -110
    [  +0.219957] usb 1-1.3: new full-speed USB device number 10 using dwc_otg
    [Dec 2 02:10] usb 1-1.3: device descriptor read/64, error -110
    [ +15.360039] usb 1-1.3: device descriptor read/64, error -110
    [  +0.120173] usb 1-1-port3: attempt power cycle
    [  +0.659846] usb 1-1.3: new full-speed USB device number 11 using dwc_otg
    [ +10.540021] usb 1-1.3: device not accepting address 11, error -110
    [  +0.100000] usb 1-1.3: new full-speed USB device number 12 using dwc_otg
    [ +10.540000] usb 1-1.3: device not accepting address 12, error -110
    [  +0.000128] usb 1-1-port3: unable to enumerate USB device
    ```
    c. DFU mode and powered by USB 5v (jumper moved to `U5V`)
    ```bash
    [Dec 2 02:14] usb 1-1.3: new full-speed USB device number 13 using dwc_otg
    [  +0.290086] Under-voltage detected! (0x00050005)
    [  +4.160004] Voltage normalised (0x00000000)
    [ +10.740004] usb 1-1.3: device descriptor read/64, error -110
    [ +15.360089] usb 1-1.3: device descriptor read/64, error -110
    [Dec 2 02:15] usb 1-1.3: new full-speed USB device number 14 using dwc_otg
    [ +15.220092] usb 1-1.3: device descriptor read/64, error -110
    [ +15.360029] usb 1-1.3: device descriptor read/64, error -110
    [  +0.120084] usb 1-1-port3: attempt power cycle
    [  +0.669995] usb 1-1.3: new full-speed USB device number 15 using dwc_otg
    [ +10.530033] usb 1-1.3: device not accepting address 15, error -110
    [  +0.100077] usb 1-1.3: new full-speed USB device number 16 using dwc_otg
    [ +10.539932] usb 1-1.3: device not accepting address 16, error -110
    [  +0.000091] usb 1-1-port3: unable to enumerate USB device
    ```
    d. Non-DFU mode powered by USB 5v
    ```bash
    [Dec 2 02:17] Under-voltage detected! (0x00050005)
    [  +4.160008] Voltage normalised (0x00000000)
    [Dec 2 02:26] Under-voltage detected! (0x00050005)
    [  +6.239996] Voltage normalised (0x00000000)
    ````

It seems like the board is responding correctly to USB connections. I've tried a couple different cables that work with my phone (I can get my phone to show up in `dmesg`).  All the appropriate power LED are on and it's able to power the Pi when it's hooked up that way. Do you guys have any other ideas of things to try? Is something wrong with my board?

Thanks for your help! Hope I can figure this out :)

OzzieOrca, 2021-12-03:
I flashed a build to use UART today and configured the Pi for UART (per https://github.com/FYSETC/FYSETC-SPIDER/blob/main/firmware/Klipper/Connect%20RPI%20uart.md). `ls /dev/ttyAMA0` seems to work but Klipper still can't connect.

My Klipper `printer.cfg` has
```
[mcu]
serial: /dev/ttyAMA0
restart_method: command
```

`klippy.log` has:
```
mcu 'mcu': Starting serial connect
webhooks client 1967506616: New connection
webhooks client 1967506616: Client info {'program': 'Moonraker', 'version': 'v0.7.1-194-geda5623'}
mcu 'mcu': Timeout on connect
mcu 'mcu': Wait for identify_response
Traceback (most recent call last):
  File "/home/pi/klipper/klippy/serialhdl.py", line 69, in _get_identify_data
    params = self.send_with_response(msg, 'identify_response')
  File "/home/pi/klipper/klippy/serialhdl.py", line 258, in send_with_response
    return src.get_response([cmd], self.default_cmd_queue)
  File "/home/pi/klipper/klippy/serialhdl.py", line 316, in get_response
    cmd_queue)
  File "/home/pi/klipper/klippy/serialhdl.py", line 250, in raw_send_wait_ack
    self._error("Serial connection closed")
  File "/home/pi/klipper/klippy/serialhdl.py", line 62, in _error
    raise error(self.warn_prefix + (msg % params))
error: mcu 'mcu': Serial connection closed
mcu 'mcu': Timeout on connect
mcu 'mcu': Wait for identify_response
Traceback (most recent call last):
  File "/home/pi/klipper/klippy/serialhdl.py", line 69, in _get_identify_data
    params = self.send_with_response(msg, 'identify_response')
  File "/home/pi/klipper/klippy/serialhdl.py", line 258, in send_with_response
    return src.get_response([cmd], self.default_cmd_queue)
  File "/home/pi/klipper/klippy/serialhdl.py", line 316, in get_response
    cmd_queue)
  File "/home/pi/klipper/klippy/serialhdl.py", line 250, in raw_send_wait_ack
    self._error("Serial connection closed")
  File "/home/pi/klipper/klippy/serialhdl.py", line 62, in _error
    raise error(self.warn_prefix + (msg % params))
error: mcu 'mcu': Serial connection closed
```

GerogeFu, 2021-12-03:
Try to use no bootloader option https://github.com/FYSETC/FYSETC-SPIDER#1-boot-address-no, and flash it with command `dfu-util -R -a 0 -s 0x08000000:leave -D ~/klipper/out/klipper.bin`

OzzieOrca, 2021-12-03:
Somehow I got `dfu-util --list` working. The only thing I can think of is I unplugged the display cables EXP1 and EXP2. The only other thing is maybe powering the Pi from the Spider. I had a separate USB power running to the Pi at one point to keep it on.

After that, I did need to flash to the `0x08000000` address and overwrite the bootloader to get it working. Thanks for that! I've got a few things to figure out but it's connecting now :) Thanks!

beikeland, 2021-12-09:
>  `dfu-util -R -a 0 -s 0x08000000:leave -D ~/klipper/out/klipper.bin`

Can still make use of `make flash FLASH_DEVICE=0438:df11` when _no bootloader_ is selected in `make menuconfig` which imho is a cleaner approach as it will work with updating also by make flash (but passing the /dev/serial/by-id/... device node as FLASH_DEVICE like `make flash FLASH_DEVICE=/dev/serial/by-id/usb-Klipper<fill inn the reset>`

But as the user is also mentioning UART using _no bootloader_ will force the user to use USB and BT0 jumper for any future updates. I would strongly suggest recommending restoring the bootloader to enable flash-sdcard.sh to work or sticking with just using USB.

Closed 2021-12-03.

Thread 68 (2021-12-13):

V1.0 spider driver low voltage

cartaio, 2021-12-13:
I get sporadic errors during quad level gantry on my voron due to "low voltage on drivers" anyone else?

Thread 69 (2021-12-20):

V1.1 - rPI supply voltage dropped below 4.65V at least once since the last power-on

moelski, 2021-12-20:
Hi !

Use a Spider 1.1 with an attached Raspberry Pi 3b and a connected BTT PITFT 5.0 V2.
I got often this message in MainSail:
`Previously Under-Volted
rPI supply voltage dropped below 4.65V at least once since the last power-on.
Previously Throttled
rPI ARM core(s) where throttled down at least once since last power-on.`

Any Idea what could go wrong here?

The Pi is connected with the 6 pin cable which comes with the spider board.

regards Dominik

Thread 70 (2021-12-22):

Fan0 issues with spider board V1.0

avongil, 2021-12-22:
My Fan0 mosfet has blown up.  The fan works fine, there are no shorts to it.  The board still works, but there was a small fire.  Interesting that "sleepingAwake" has noise in the Fan0 area.  I am starting to think that this is a flaw in the board.  I am however running 24v.  Moving the hot end fan to the RGB pins.

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

Fan0 may not be coming on due to normal behavior. Shame on me for not noticing the extruder fan behavior below 50c
But my board makes an electrical popping noise if I apply a small amount of pressure around the FAN0 connector and its mosfet. Sounds like the layers are shorting to each other. Its consistent and repeatable. Nothing is loose.

_Originally posted by @sleepingAwake in https://github.com/FYSETC/FYSETC-SPIDER/issues/17#issuecomment-959221344_

avongil, 2021-12-22:
Here is a picture of the burnt up section of the board.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

I am assuming the first mosfet if for Fan0 then 1 and 2.  Where are the three other mosfets for the R G and B pins?

avongil, 2021-12-22:
The svg states that no more than .5 amps should pass through this mosfet.  I will fuse every fan from now on, but I am not so sure the fan was drawing more than .5 amps when this happened.  Is there a possibility that it revived less than 24v?  When this happened the machine shut off after very fast printing.  When I switched it back on I heard a buzzing noise then a poof and flame from the area.    I let the machine cool down for an hour, scraped off the mosfet, then powered on again.   Everything worked normally except for Fan0.

avongil, 2021-12-23:
Update:  Fan1 (PB0), Fan2(PB1) and Fan3 (PB2)  are dead. Moved them over to the RGB to the right and my fans are once again operational albeit more fussy about pwm.  The rest of the board seems to operate fully.   Not going to rely on it though.  Fysetc sent me a $10 coupon and I upgraded to the Spider V2.2

I believe this is a board defect around that area since the board does not smell of IC burning, but board burning.

Closed 2021-12-23.

Thread 71 (2021-12-23):

Klipper installation on Spider v2.2

johnsurrey2000, 2021-12-23:

johnsurrey2000, 2021-12-23:
I am new to both Klipper and the Spider board and confused about the initial setup.
Do i need to load the bootloader before i install Klipper ? or can i put Klipper on an SD card and just put it into Spider board

RcTomcat1, 2022-01-05:
You can flash Klipper directly via the SD card. The 32k bootloader should be on the board already

Thread 73 (2021-12-29):

5v RGB (NEO-PIXEL/WS2812) pin out

Caskia, 2021-12-29:
I only find one pinout in the board for 5v rgb, is there any way to extend two independent pinout?
board version: spider v1.1
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

ejhoness, 2021-12-30:
Hi. hope this can help you.
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

another RGB port with selectable voltage
and I believe you can use these other PWM ports with mosfet

sakoula, 2022-01-27:
Hi, I am having the same issue. I would like to connect a 5V Neopixel  `WS2811` ledstrip to some port other than the 5V RGB one.

I will power the ledstrip from an external 5V PSU. The only option that supports 5V is the FAN ports. Should I just go on and connect the Signal port to the V+ of the fan port?

Thanks!

Thread 74 (2022-01-05):

Burned spider 2.2

RcTomcat1, 2022-01-05:
Hi,

One of the MOSFETs (at least I assume it it one) above the fan1 port just burned out on my spider 2.2
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

Is that the one connected to the fan1 port? Struggling to find the fault here and it would really help to know where to look.
Measured the fan1 parts cooling fan and could not find a short.
Same goes for the hotend cooling fan.

leanghoun, 2022-01-06:
Same exact one just burned for me as well. Above FAN1. All properly set to 24V. Brand new Spider 1.1, just going through initial setup. Would like to know if there are any warranties.
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

RcTomcat1, 2022-01-06:
Also building a voron from the Fysetc voron kit?

avongil, 2022-01-07:
Oh great.  I have had this happen to my V1.0 board.  Figured it would have been fixed by now :(

avongil, 2022-01-07:
I moved mine over to the RGB pins to the right.  Have a look at my config, they seem to operate a bit different so I had to mess with the pwm frequency of all the fans.   I guess I am going to stay away from Fan0, 1 and 2 connectors. https://github.com/avongil/VoronAxG68K/blob/main/printer.cfg

leanghoun, 2022-01-07:
> Also building a voron from the Fysetc voron kit?

Ah, not a Fysetc kit. A self-sourced Trident. I was really excited about the Spider board too.

> I moved mine over to the RGB pins to the right. Have a look at my config, they seem to operate a bit different so I had to mess with the pwm frequency of all the fans. I guess I am going to stay away from Fan0, 1 and 2 connectors. https://github.com/avongil/VoronAxG68K/blob/main/printer.cfg

Yup, I've moved mine over to the RGB pins, but even those are behaving weirdly. The pin assignments for klipper are not correct, and while R/G pins are okay, the B pins are always on. I'll check your config for PWM adjustment. Thanks!

maralb1970, 2022-01-08:
Fysetc didn't add any backlash diodes over the fan outputs. I think it is a good idea to add these in future revisions.  I am building a Voron 2.4 too with a spider V2.2. After reading too many of these messages I will add a backlash diode (1N4001 or something like that) externally, probably crimping these along with the wires on JST crimp terminals.

Another thing not quite related....I hope there will be decent support for 4-wire fans in the future on controllers and firmware. Too many issues with PWM-ing 2 wire fans which all behave differently when controlling these by PWM....

avongil, 2022-01-10:
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

Spider V1.0 - happened immediately after a power up.

avongil, 2022-01-10:
>

That's a good idea I think. I will do that as well as power the Pi4 from an external supply to not stress the 3.3v bus.

bofh, 2023-01-20:
I got my bed output burned on Spider V2.2. Bed is always on now (heating w/o limits, PCB itself is also heating)

Several questions:
* could it be caused by supplying bed voltage from a separate PSU? (Both do have electrically connected grounds and cases, voltage measured by multimeter between all points is nominal, was running in this configuration for a month or so no problem)
* could it be caused by wiring load (work area LED strip) to extruder output and turning printer on w/o driver installed? I've noticed temperature running away after this change.
* any way to prevent bed heating w/o limits in MOSFET short scenario?

I'm going to resolder MOSFET (it heats and looks deformed a bit). Any recommendations? Maybe different part or add some diodes?

egorcik, 2023-07-31:
Hi.
Have you solved problem with bed always on?

bofh, 2023-08-02:
I've added external MOSFET module and used PD3 from RGB connector to drive it.

Thread 75 (2022-01-13):

bl touch-spider 2.2

hwystitch, 2022-01-13:
So the two pictures for the 2.2 have conflicting info for pins. the one here [https://github.com/FYSETC/FYSETC-SPIDER/blob/main/images/Spider_v2.2_wiring.jpg](url) shows the ground as the first and fourth pin with the pwm pin going off to nowhere.... and the wiring pic here [https://raw.githubusercontent.com/FYSETC/FYSETC-SPIDER/main/images/Spider_V2.2_Pinout.jpg](url) shows the grounds as 2 and 5. So which way to actually wire the bltouch. Really dont wanna fry my bl touc or mainboard.

Thanks

GerogeFu, 2022-01-13:
I just update the pinout jpg, actually you can check the pin label at the back of the board. Thanks

hwystitch, 2022-01-17:
thanks

Closed 2022-01-17.

Thread 76 (2022-01-13):

Spider v2.2 not entering DFU mode anymore

waitkusjgutekunst, 2022-01-13:
### Board not entering DFU mode
My Spider v2.2 was recently entering DFU mode when putting jumper on BT0 and 3.3V.
This won't work anymore. I flashed it a few times but not it's not entering the DFU mode anymore. Tried several USB cables. The 3.3V led on the board is not showing anything either. I can't flash via SD because the board has no bootloader right now.

Is there anything i can do? Any similar experiences?

kullwarrior, 2022-04-28:
I had the same issue, I was able to reflash firmware via a USB ST Link Programmer and use STM32 ST-Link Utility.

Thread 77 (2022-01-13):

Using 4 pin mechanical endstop switches on Spyder 2.2

R3dBe4rd, 2022-01-13:
I am trying to use a set of mechanical endstop switches with my 2.2 that have their own PCB's and wiring that looks like this:

SIG
GND
GND
VCC

The 2.2 wiring guide uses a 2 pin limit switch, but I'm wondering if I can even use these 4 pins I have? If it is possible, where does the VCC pin from the endstop go on the Spyder board?

Thread 79 (2022-01-19):

SCL and SDA swapped on I2C header

r-walloner, 2022-01-19:
I was trying to connect a sensor to my Spider v1.1 via I²C with no success.
I took a look at the [schematic](https://github.com/FYSETC/FYSETC-SPIDER/blob/b4a7353f9baf370833d673034158eba7d1101e1f/hardware/Spider%20V1.0C%20SCH.pdf) and spotted the Problem fairly quickly.
On page 2 the order of the signals connected to the I²C header is specified as follows:
1. SDA
2. SCL
3. GND
4. 3.3V / 5V

However, the Silkscreen, as well as the pin out section on the Wiki page say:
1. SCL
2. SDA
3. GND
4. 3.3V / 5V

And sure enough after swapping the SCL and SDA signals, the sensor worked.

I noticed that the silkscreen labeling has already been fixed with version 2.2.
It would be nice, if the Wiki could be updated to show the correct signal order.

Thread 80 (2022-01-24):

FAN0 is always ON

Laker87, 2022-01-24:
Hello. I have Spider 2.2 board and latest Marlin firmware.  Part cooling fan is connected to FAN0 and it's always ON, I can't control it. MOSFET seems OK.

jaschkopf, 2022-02-01:
Same problem here. Also Spider 2.2 Board, bought from Aliexpress FYSETC Official Store. Also the BED Output is always on. BED and FAN0 LED's are instant on after power up.

askkostya, 2022-02-04:
Same problem on Klipper firmware on Spider 2.2

jaschkopf, 2022-02-04:
Hey guys, I found the issue for the problem:

With Spider Version 2.2 they changed the Fan0 to Pin PA13 and FAN1 to PA14. The reason why PA13 is always on is, that it is double used, it's attached to FAN0 and the SWDIO PIN. So while booting the pin is pulley "high" and the FAN0 powers on. But with Pin PA13 you can control it normally.

I recommend you to use FAN0 only for hotend-fan or connect it directly to 24V. If you reset your board (or an error occurs and the board resets by itself!!!) FAN0 is the only Fan that will have power. If the hotend is hot and the fan fails, your extrudermount will melt!

The reason why my bed heater was always on was a hardware issue. I found a cold solder joint at U5 Pin 9 (D-IN at CD4504B-EP Level shifter for the heaters). After resoldering it, the problem was fixed.

rusviktorger, 2022-06-11:
> With Spider Version 2.2 they changed the Fan0 to Pin PA13 and FAN1 to PA14. The reason why PA13 is always on is, that it is double used, it's attached to FAN0 and the SWDIO PIN. So while booting the pin is pulley "high" and the FAN0 powers on. But with Pin PA13 you can control it normally.

You're right, I bought two identical boards (Spider V2.2) at different times.
Fan0 (PA13) is also always on.
But that's really bad.
Can't change that somehow, maybe via the bootloader,
an older version maybe?

[German]
Du hast recht ich habe zwei gleich Boards (Spider V2.2) auch zur unterschiedlicher zeit gekauft.
Da ist Fan0 (PA13) auch immer an.
Das ist aber richtig schlecht.
Kann mach das nicht irgendwie ändern vieleicht über den bootloader,
eine ältere version  vieleicht ?

TinkerBridget, 2022-06-15:
Definitely something not ok with the 3 controllable fan sockets.

I can't run PA13 at 5v anymore, if I use it for the 24v fans they run all the time now, but not full power.  They used to run from powering up until Klipper started when they would stop and wait for commands, but something happened and now it is doing this.  I haven't bothered to test the pin output with various jumper settings and conditions as I'm busy trying to tune in a 2in1 out hotend.

Currently using PA14 at 24v for part cooling which seems to work, and PB2 at 5v for hotend cooling.

Unsure of the cause.

Thread 81 (2022-02-02):

5V RGB Led not working

Stargrove1, 2022-02-02:
RGB Led stripe WS2812B is attached to the corresponding pin. I have tried to uncomment the predefined caselight

[output_pin caselight ]
##  Chamber Lighting - In 5V-RGB Position
pin: PD3
pwm: true
shutdown_value: 0
value:1.0
cycle_time: 0.01

As well neopixel

[neopixel leds]
pin: PD3
chain_count: 20
color_order: GRB
initial_RED: 0.5
initial_GREEN: 0.5
initial_BLUE: 0.5

But the LED stripe remains off. 5V is present, but no signal is sent to the Neopixel

Closed 2022-02-02.

Thread 82 (2022-02-04):

Only Z motor working on Spider 2.2

askkostya, 2022-02-04:
I am using Klipper firmware.
Only the motor inserted in z works. I tried different ports, the motors do not spin in any port
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

[https://github.com/askkostya/Reborn-Klipper/blob/main/drivers_2209_uart.cfg](url)
[https://github.com/askkostya/Reborn-Klipper/blob/main/printer.cfg](url)

zhangvicto, 2022-04-18:
Having the same issue, have you found a fix?

Thread 83 (2022-02-20):

turning on the parts fan causes all temperature measurements to go haywire

benfinklea, 2022-02-20:
When I turn on the parts fan, the temperatures for the heated bed, extruder, raspberry pi, and the mcu start going up or down or jumping. Each percent I increase the parts fan causes changes in the temperature readings. Sometimes, they jump so high or drop so low that Klipper shuts down. The fan itself doesn't come on. In fact, this occurs _even when the fan is not attached to the Spider_. That means that something is happening on the board itself (or, I suppose in the firmware).

Purchased Spider board on Aliexpress in the Fysetc store.
I'm running the latest Klipper and RatOS.  Thank you.

benfinklea, 2022-02-20:
I rewired the parts fan into a vacant extruder port and now it works as expected. But, that doesn't solve the problem, it just works around it. I think I may have a shorted out board.

Thread 84 (2022-02-20):

IDEX Sensorless Homing

SiCFPV, 2022-02-20:
Hello,

I have a Fysetc Spider 1.1 with TMC2209. Using Klipper and trying to homing the dual carriage. The X1 motor that is connected to X-MOT with diag pin PB14 works fine with the sensorless, the X2 motor is connected on the E0-MOT with diag pin PA1 and doesn't stop, and also doesn't obbey to the command SET_TMC_FIELD
[klippy.log](https://github.com/FYSETC/FYSETC-SPIDER/files/8104994/klippy.log)
STEPPER=dual_carriage FIELD=SGTHRS VALUE=255, if I make a G28 X0 this motor always move, and if i change the diag my endstop is always active. Any solution for this?

Thread 85 (2022-03-03):

Cannot connect to FYSETC Spider 2.2/Voron 2.4, quit mid print

lwboyd00, 2022-03-03:
I was printing an object when all of a sudden bed heat started to drop.   Bed heater error was displayed and the red 'Flash' LED lit on the Spider board,  Tried to reflash the board, it was successful but the once the jumper was removed and powered back on it can not connect to the spider board. Using USB Serail connection. This was printing very well up to this point. It is a FYSETC  Voron 2.4 kit, built and tested though the voron build documentation. Nothing out of the ordinary going on it was sprinting normally, 30 minutes into a 2hour print job. No changes have been made recently.

Thread 86 (2022-03-11):

TMC 2209 v3.1 Unable to read tmc uart 'stepper_x' register IFCNT

Trytas, 2022-03-11:
Hi,

I'm at the moment trying to get my Voron running.
I've got the Spider v2.2 with 7 TMC 2209 v3.1 drivers installed.

I installed every jumper as shown in the instruction.
I Already tried to switch the cables to the steppers and also switch the drivers.

My next try is pulling my 2208s out of my CR-10 as soon as it has finished the print.

Here is my Config.
I just converted the .cfg to .txt
[config.txt](https://github.com/FYSETC/FYSETC-SPIDER/files/8231764/config.txt)

Trytas, 2022-03-11:
I now tried the "STEPPER_BUZZ STEPPER=stepper_x" Command in the console for all motors.

All 4 Z-Stepper and the Extruder are running without issues, but the Error is coming up for both gantry Steppers.

So not only the X but also the Y-Stepper.

gogsi1, 2022-04-04:
I have the same problem, were you able to solve it?

Kamilus2410, 2022-09-28:
Could you show how you done it? I have the same problem but that big black jumper is installed

GerogeFu, 2022-09-29:
Try this : https://github.com/FYSETC/FYSETC-SPIDER#52-tmc2209-connection-issue

Thread 87 (2022-03-11):

Bed, Fan0 and Fan1 always ON

DrTriD, 2022-03-11:
Bed, Fan0 and Fan1 always ON state on Spider V2.2 when the board powered. I am not able to switch to OFF position.

I am using Marlin FW 2.0.9.3.

Does any one has a solution for that?

dckostin, 2022-04-25:
This was reported as a bug on the Marlin page {[BUG] Marlin 2.0.9.3 cooling fan #23418} and closed with a "fix" implemented in the latest bugfix-2.0.x branch.  However, I am now unable to start the print cooling fan at all (Fan0) and the backlight on my Mini12864 display will not turn on using the bugfix-2.0.x branch.  There is a new bug {[BUG] Bad fan control on MKS Monster8 V1.0 #24080} on the Marlin page that I think (hope) will turn into resolving these follow-on bugs.

dckostin, 2022-04-27:
I was able to fix my print fan by using the Marlin-bugfix-2.0.x release and then changing the TIMER_SERIAL in "buildroot\share\PlatformIO\variants\MARLIN_FYSETC_S6\variant.h" file which says:

#define TIMER_SERIAL TIM7 // TIMER_SERIAL must be defined in this file

By changing this to TIM4 resolved my problem.

See Marlin issue:  [BUG] Bad fan control on MKS Monster8 V1.0 #24080

Abeperspiration, 2024-06-09:
I have near same issue on my Spider v3.0. FAN0 is alway ON with klipper.

Thread 88 (2022-03-11):

TMC2226 (brand Ledge) --> TMC CONNECTION ERROR

DrTriD, 2022-03-11:
I am using TMC22226 (brand Lerdge, https://shop.lerdge.com/collections/lerdge-driver/products/tmc2226-driver) for X, Y, Z and E0 on my Spider V2.2 with Marlin FW 2.0.9.3.

I hace "TMC CONNECTION ERROR" message on the control display.

Is some had this issue and is there any solution for that?

Thread 90 (2022-03-20):

Pins for MAX31865 board when fully eqipped with drivers

Sineos, 2022-03-20:
Are there any pins available to connect a MAX31865 board when all driver slots are equipped with TMC2209?

PC10, PC11, PC12 when omitting EXP2 for a display? Any alternative? Thanks in advance

Thread 91 (2022-04-01):

New board, unable flash firmware via SD, USB via SSH, USB via DFU both to PC & Pi

kullwarrior, 2022-04-01:
I got a new board, tried to flash multiple different approach without avail.
1) loading SD card with firmware.bin does not result in any blinking lights after turn on device. The SD card file remained unchanged.
2) Plugging USB type C board with 5v jumper with U5V (I get 3.3V & 5V lights) connecting it to Pi or PC does not get pick up by either device with or without 3.3V jump with BT0. I've also tried with 24V, 5v-DC5V jumper, BT0-3.3V jumper (I get 3.3V, 5V, 24V lights) without success. And finally I have swab type C cables with all other ones (all of them can transfer data between my PC and phone so I don't believe this is the issue).
I also did the firmware without any stepper, jumper (minus 5V to U5V or DC5V, and 3.3V-BT0)
Do I have a DOA board? I don't believe my pi is the problem as SKR E2 mini V2 does get pickup with the same USB socket, and the PC socket picks up any other USB devices.

megasqrt, 2022-04-23:
i have exactly the same problem

kullwarrior, 2022-04-28:
So update for any people who encounter this:
1) The USB type C's TX and/ or RX was faulty; this prevented serial connections via PC for STM32CubeProgrammer, serial connection with RPi. I'm unsure why the UART also failed
2) USB TTL will not work if you try to plug it into the four pin USB JST socket. At best you can use it as a 5V plugin to power the board.
3) I was able to recover SD firmware flashing by USB ST-Link V2 (https://www.amazon.ca/CANADUINO-Compatible-Circuit-Programmer-Debugger/dp/B07B2K6ZPK) You will have to use STM32  ST-Link Utility because the firmware for the ST Link on the board is outdated for STM32CubeProgrammer.
4) For some reasons my RPi does not like 32KiB bootloader, as soon as I flash my replacement board using a version without bootloader offset the RPi was able to pick up the board via USB serial connections.

Closed 2022-04-28.

Thread 93 (2022-04-19):

Possible to flash firmware via uart?

teeedubb, 2022-04-19:
Hi,

Is it possible to flash new firmwares via uart? I have tried via klipper with the "make flash" and "make serialflash" commands but they have not been successful. If it is possible, can you please provide the method?

Thanks.

kullwarrior, 2022-04-28:
AFAIK I looked into this, you cannot flash via UART. If you want to use UART (PA9/10) you should use STM32CubeProgrammer.

teeedubb, 2022-05-02:
Thanks for the info. I'll stick with USB because the board is connected to a RPI.

Thread 94 (2022-04-19):

Flashed Firmware, Screen (mini12864) now Dark

runnersigh, 2022-04-19:
I flashed the firmware via STM32 Programmer. I used the Klipper-32k-usb.bin to the address 0x8000000. Now when I disconnect the stm programmer and take the jumper off the 3.3v-BTO pins and reboot the board the screen is totally dark. Is this normal?

Just to be clear I don't have anything hooked up to the board (no drivers, no fans) only the 24v and the screen (mini12864).

teeedubb, 2022-04-20:
Try flashing the no bootloader version - I had similar issues and that resolved it for me.

runnersigh, 2022-04-20:
What address did you use to flash the no bootloader version? Also what was
the name of the version that worked for you? I've tried several different
of the pre built versions and the screen is always dark.

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

dckostin, 2022-04-25:
I have the same issue with the dark screen.  The latest release version of Marlin (2.0.9.3) has an issue with the print cooling fan always running ([BUG] Marlin 2.0.9.3 cooling fan #23418).  The "fix" in the bugfix-2.0 branch turns the fan off, but now the mini12864 display light will not turn on (and the print cooling fan will not start).  I have confirm multiple times that returning to the Release branch 2.0.x will turn the light back so this is not a hardware issue but some code change in the bugfix-2.0 branch.

Thread 95 (2022-04-28):

No Fan1, Pin PB2.  No fans on startup.

mgeorgeHome99, 2022-04-28:
I seem to have a problem out of the box with my Spider V2.2, the Controller fans x2 wired to Fan1 do not run initially nor when I hit bed temp. Their is also no LED on associated with the port like the other fans..  The other fans run on startup fine and have an LED, this seems to be a problem since setup.  Config below,

[heater_fan controller_fan]
##	Controller fan - FAN2 Connector
pin: PB2
#kick_start_time: 0.5
heater: heater_bed
heater_temp: 45.0

mgeorgeHome99, 2022-04-28:
I noted on a subsequent power cycle that the red LED started to come on, maybe the jumper was loose?? Regardless, the enclosure fans now work.

Closed 2022-04-28.

Thread 96 (2022-05-09):

Toolhead Pcb 3.2 wiring diagram with Spider 1.x

LeBress, 2022-05-09:
Hello,
I can't find any wiring diagram for the toolhead pcb 3.2 with the spider 1.x, can someone help me.
Thank you

Thread 97 (2022-05-13):

Q: Connecting PT100 or Thermocouple via a Amplifyer

MarkusThur, 2022-05-13:
I'd like to ask for a little help.

The wiring diagramms say:
"NTC Thermistor is used by default, PT100/Thermocouple (need AD597 add on) are also supported. 3.3V 4.7k pull-up"
in the Pinout it says then

So there is a 4.7k pullup on the Thermoinputs, what makes sense, as to read the thermistors u have a voltagem divider between the 4.7k and the thermistor, which then makes the input read a voltage.. Obvious.

In the features section it says:
"A 4.7kOhm 0.1% temperature sensor pull up resistor is used, PT1000 can be connected directly. For PT100, an amplifier board must be used."
the PT1000 with the 4.7k resistor also builds a votage divider where u could read the remaining voltage over it pretty precis.. At ambient the reading should be something like 18% 0.57V rising with rising temperature,
And with PT100 this should not work that proper and stable, as 4k7 vs 100 Ohm does not give a big reading and steps will be pretty little..
also Obvious.

So for thermocouples and also the PT100 one should use a amplifyer.. like AD597 or I'd even prefer AD8495 (advantage already running at 2.7V and with 5mV/K instead of 10mV/K it is hard to overvoltage the AIn of a STM... It's 330°C to 3.3V for the 597 and 660°C to 3.3V for the 8495)
But where to connect it? Just to the AIs with the pullup? Am not sure if this is right?

Thank you for your help

Thread 98 (2022-05-18):

Cant flash the board

brusli009, 2022-05-18:
I have been trying to flash a new board (spider v2.2)
Ive tried the usb c/uart with the pi and it cant detect the board.
I have used the dfu mode and stm32cubeprogrammer to flash the klipper bin and it also says succes, but i cant find it with my pi
I have also tried to use an sd card to flash it but the firmware led either stays on and does nothing either is off completly

Thread 99 (2022-06-02):

Missing example config folder for RRF

mak0t0san, 2022-06-02:
In the RRF readme (https://github.com/FYSETC/FYSETC-SPIDER/tree/main/firmware/RRF) in "Step4: config" , it says:

> There is config folder beside this README file, it is just an example config to run RRF

However, there is no config folder.

It would be helpful to have an example config folder, especially having the `board.txt` file.

jaysuk, 2022-06-02:
Use the config tool at https://teamgloomy.github.io/Configurator

On Thu, 2 Jun 2022, 15:12 Makoto Schoppert, ***@***.***>
wrote:

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

mak0t0san, 2022-06-02:
I should have clarified that I'm trying to run a Spider v1.0 (which uses STM32F446). The configurator has the option for a Spider 407 board. I've got RRF running on the board, but there's no documentation for the SPIDER-RRF-WIFI module so it's a bit difficult to know which pins are for espDataReadyPin, TfrReadyPin and espResetPin.

This is what I came up with so far for my board.txt file, which the configurator isn't generating:

```
//WiFi pins
8266wifi.espDataReadyPin = C.11
8266wifi.TfrReadyPin = D.1
8266wifi.espResetPin = A.8
8266wifi.csPin = C.9

// RX/TX Settings
8266wifi.serialRxTxPins = { C.7, C.6 }
serial.aux.rxTxPins = { A.10, A.9 }
```

This is the board.txt file that is generated from the configurator:
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

GerogeFu, 2022-08-30:
Uploaded

jaysuk, 2022-10-11:
ah, we (teamgloomy) don't support 446 based boards so you'd have to just
work it out with the schematic.
What I would say is don't bother. There has been no long term RRF support
on 446 chips after the initial build that they pushed out and its buggy at
best.

Thanks,

Jay

On Thu, 2 Jun 2022 at 17:07, Makoto Schoppert ***@***.***>
wrote:

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

Thread 100 (2022-06-08):

Board does not respond to UART or USB

eljefe80, 2022-06-08:
Hi,

I have a Spider v2.2 that is not working. I have tried UART and USB connections on multiple raspberry pis and multiple linux machines. No usb device appears in lsusb. The board was functional and working well, then stopped responding midprint. I can program it successfully with an st-link v2, but cannot connect to it. Please advise.

Thanks,
eljefe80

Nugabar, 2022-06-09:
Please check with lsusb while jumper is betweeen EO-3.3V.
If it shows something like SAM xxxx in DFU mode, please try to write bootloader first, then firmware.
I solved problem like above.

eljefe80, 2022-06-11:
Do you been BT0 and 3.3V? for DFU mode? Yes I have tried that. I've also made sure that the jumper is on USBV5 to draw power from the USB connection

rainerschulte, 2023-08-06:
Icurrently ran into the same issue now.
I have connected the Spider 2.2 to a Raspi 4B via USB. The Spider is recocnized by `lsusb` and "successfully flashed" with Jumper between BT0 and 3.3V. After unplugging Jumper and rebooting the Spider, I get `xw1170@spider:~/klipper $ ls -l /dev/serial/by-id
ls: cannot access '/dev/serial/by-id': No such file or directory
` UART will not work on my Pi4 because I have added a Fan to it wich blocks the Pins for the provided UART-Cable. I also tried UART on a PI Zero, but it gets no Connection.
What's wrong here?

JD13xs, 2023-08-07:
How did you configure it in your build of the firmware; usb or Uart? You
can not do both ( at least to my knowledge)....

On Sun, Aug 6, 2023, 1:13 PM Rainer Schulte ***@***.***>
wrote:

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

rainerschulte, 2023-08-07:
For Pi 4 I built Firmware for USB, since I cannot connect UART-Cable and Fan in the Housing. So I flashed the Spider with USB online "make flash..." and repeated later with SD-Card. Both were not showing a USB-Serial by-id. I tried to renew the Bootloader with STM Code-Programmer. When connecting USB to my Computer with Juper on Spider BT0 and 3.3V I had a connection and successful flash.
When using the SD-Card to flash USB-Firmware to Spider, I noticed the blinking LED behind USB-Port. After that, the SD-Card file has changed to "old.bin". So I assume, I did everything right this time. But I still get no /serial/by-id.

The same Procedure I tried on Pi Zero with UART. But flashing Firmware for Spider with UART, following the Manual I also edited cmdline.txt and config.txt.

rainerschulte, 2023-08-07:
**_ok... finally solved!_**
I reflashed the Bootloader again, and used the basic .hex file instead of the ...1000.hex. The SD-Card was flashed to 32kb Bootloader. so the 1000 is mentioned for 64k Bootloader.
In the End I now have Klipper online and no Error Messages. A Fan is connected, a Thermistor for Hotend is connected and the Display is working.
So I'm fine for today! Now I need to order some Parts for my new Voron 2.4r2!!

JD13xs, 2023-08-07:
Ive noticed that sometimes you have to run make / flash more than once to
work correctly.

On Mon, Aug 7, 2023, 5:28 AM Rainer Schulte ***@***.***>
wrote:

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

Thread 102 (2022-07-03):

STM32CubeProgrammer won't flash bootloader

TinkerBridget, 2022-07-03:
14:48:38 : Time elapsed during the read operation is: 00:00:00.031
  14:48:45 : Memory Programming ...
  14:48:45 : Opening and parsing file: Bootloader_FYSETC_SPIDER.hex
  14:48:45 : Error: Parsing fail
  14:48:45 : Error: In line 38 :
  14:48:45 : Error: parsing count, expecting hex digit, found ' '

Not sure what the problem is here, but I will add it to the list of issues.  I just wanted to reflash with a newly generated klipper firmware to make sure that wasn't the problem and I can't seem to do it.

TinkerBridget, 2022-07-07:
I ended up not using the bootloader, compiled an updated klipper firmware and flashed it from my PC rather than using the SD card.

Board works, but it should have been possible to reflash the provided bootloader to it.

Meffesino, 2022-10-12:
I have got the same problem. I'm not able to use STM32CubeProgramming to flash the latest 32bit Bootloader.

ataman78, 2022-11-23:
Problem is 100% in your .hex. You must download not only .hex by "save as" but a whole project in zip. Then will work. Good luck)

Terecon, 2022-11-30:
> Проблема на 100% в вашем .hex. Вы должны скачать не только .hex с помощью «сохранить как», но и весь проект в zip. Тогда будет работать. Удачи)
Я прошивал не один раз, но сейчас не работает. Посмотрите видео. Что не так.
https://disk.yandex.ru/i/E_vNhVVvQbynjg

Thread 103 (2022-07-08):

Y+ endstop not firing on PA2

cyryllo, 2022-07-08:
I set the endstops X and Y to be on MAX

`#define USE_XMAX_PLUG
#define USE_YMAX_PLUG`

and

`#define X_HOME_DIR 1
#define Y_HOME_DIR 1`

While the X axis is home, the Y axis is no longer. It looks like there is a Y all the time shorted / home

I seen https://github.com/FYSETC/FYSETC-SPIDER/issues/49 but i don,t know how fix for Y+
I have version 1.1 spider board

GerogeFu, 2022-07-12:
Send 'M119' to test the endstops status before you do homing action. Give X-MAX/Y-MAX pin GND or 3.3v each time before you send `M119`.

Thread 104 (2022-07-30):

Klipper „usb to can bus bridge mode“ not possible with fysetc bootloader

RedFlash49, 2022-07-30:
Hi

I wanted to try the new usb to can bridge mode (https://www.klipper3d.org/CANBUS.html#usb-to-can-bus-bridge-mode) with my Spider 1.1 (with attached CAN transceiver) but only got USB errors on the pi with dmesg.
Now i replaced the fysetc bootloader with the bigtreetech octopus bootloader and the board is recognized and the CAN bus works.
The only disadvantage i found is that flashing with SD card is not possible anymore.
Could you please check your 32kB bootloader. I would prefer to use the right bootloader.

GerogeFu, 2022-08-11:
Try this one
https://www.dropbox.com/s/0zckknbnuz2tsjy/Bootloader-Spider_L.bin?dl=0
Tell me if it works on your side

RedFlash49, 2022-08-13:
> Try this one
> https://www.dropbox.com/s/rxobica829fon36/Bootloader_Spider.hex?dl=0
> Tell me if it works on your side

Unfortunely not. Still „not accepting address, error -32“ with dmesg.

GerogeFu, 2022-08-15:
Screenshot that part of dmesg for me. I will have a check

RedFlash49, 2022-08-16:
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

RedFlash49, 2022-08-20:
Hi
It was an Error in the Klipper Firmware. I updated Klipper and flashed all MCU's to the newest Klipper Firmware Version and now it works with the fysetc bootloader.
To be shure i flashed the original fysetc bootloader and the firmware again and it still works.
Weird, that it worked with the other bootloader.

Thanks

RedFlash49, 2022-08-20:
.

slaesh, 2023-07-31:
@RedFlash49 do you have a display too? and might answer my quersion [here](https://github.com/FYSETC/FYSETC-SPIDER/discussions/132) ? =)

or maybe @GerogeFu do you know this?

RedFlash49, 2023-07-31:
HiYes i have a display buts its a hdmi display connected to the raspberry.I had the spider (1.1) connected with CAN and changed back to USB. There is no advantage with CAN and i suspected its causing too much traffic on the bus resulting in „timer too close“ errors.Am 31.07.2023 um 13:22 schrieb slaesh ***@***.***>:
@RedFlash49 do you have a display too? and might answer my quersion here ? =)
or maybe @GerogeFu do you know this?

—Reply to this email directly, view it on GitHub, or unsubscribe.You are receiving this because you were mentioned.Message ID: ***@***.***>

Thread 105 (2022-08-03):

spider v1.1 with power problem.

I-am-the-borg-queen79, 2022-08-03:
please can help help me. need this if anyone as got it. voron design & fysetc spider v1.1 motherboard schematic. this would be a really help if anyone knows where i can find it please.

Thread 106 (2022-08-21):

Spider wiring diagram error

Fuechsl, 2022-08-21:
In the spider 1.1 and 2.2 wirking diagrams (but not the pinouts), the blue "use rgb socket for fans" box has the wrong color order. As shown in the pinout (or just below, led connection) it should be most top blue then red then green.

GerogeFu, 2022-08-29:
Ok, thanks. We will correct it

Closed 2022-08-29.

Thread 110 (2022-10-20):

Marlin 2.x two Y and Z Motors

rainerschulte, 2022-10-20:
Hi Folks,

I have a question regarding Spider 2.2 running two Y and Z Motors.

In configuration.adv.h I uncommented
`#define Y_DUAL_STEPPER_DRIVERS
#if ENABLED(Y_DUAL_STEPPER_DRIVERS)
  //#define INVERT_Y2_VS_Y_DIR   // Enable if Y2 direction signal is opposite to Y
  //#define Y_DUAL_ENDSTOPS
  #if ENABLED(Y_DUAL_ENDSTOPS)
    #define Y2_USE_ENDSTOP _YMAX_
    #define Y2_ENDSTOP_ADJUSTMENT  0
  #endif
#endif

//
// For Z set the number of stepper drivers
//
#define NUM_Z_STEPPER_DRIVERS 2   // (1-4) Z options change based on how many

#if NUM_Z_STEPPER_DRIVERS > 1
  // Enable if Z motor direction signals are the opposite of Z1
  //#define INVERT_Z2_VS_Z_DIR
  //#define INVERT_Z3_VS_Z_DIR
  //#define INVERT_Z4_VS_Z_DIR`

and in configuration.h  I have
`#define X_DRIVER_TYPE TMC2209
#define Y_DRIVER_TYPE TMC2209
#define Z_DRIVER_TYPE TMC2209
//#define X2_DRIVER_TYPE A4988
#define Y2_DRIVER_TYPE TMC2209
#define Z2_DRIVER_TYPE TMC2209`

My Display says _**TMC Connection Error**_.

All TMC Sockets have a TMC2209 connected.

Which Ports are Y2 and Z2?

Thread 111 (2022-10-23):

Unable to read tmc uart 'stepper_x' register IFCNT

kaikaimax, 2022-10-23:

Sark1tama, 2022-11-25:
Same problem, did you solve it?

SpookyPDX, 2023-01-11:
check that the 24v/48v jumper is in place, chased this for few days, my issue was the jumper

vogodesign, 2023-01-15:
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

Has the problem been resolved?
I am also struggling with this issue.

SpookyPDX, 2023-01-20:
if only X and Y are effected its the 24v jumper at the end of the row of steppers, its the big jumpper in the bag with all the small jumpers

xrmatic, 2023-02-15:
Thanks! This fix it for me too.

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

Thread 112 (2022-11-30):

[Documentation] Spider 2.2 pinout errata

numindast, 2022-11-30:
https://github.com/FYSETC/FYSETC-SPIDER/blob/main/images/Spider_V2.2_Pinout.jpg

The "PI PWR & UART" block has an incorrect label on this screenshot. In the top row, we have "nc nc nc nc 5V" when that last element is actually GND as tested with a multimeter.

This had me thinking the supplied cable would be a highly effective short circuit shunt. Turns out it's just mislabeled on the JPG.

GerogeFu, 2022-12-01:
Thanks, updated

Closed 2022-12-17.

Thread 114 (2022-12-15):

pi doesnt connect to the board nor does stm32cubeprogrammer

KingJazon, 2022-12-15:
I have a setup of a voron 2.4, pi zero 2 with mainsail/klipper and a spider 2.3. My plan was to connect it via UART. Ive gone through every guide or instruction I can find online on how to set it up but it just seems like a struggle.
the Raspberry doesnt seem to recognize the board even though I have uploaded/flashed the firmware onto the spider via sd-card.

I tried to connect the card to the computer to STM32cubeprogrammer but its not being recognized. But when I run "lsusb", I can see the input as a DFU.

all the lights on the board seems to do work fine, just no/little sign of life from the mcu.

Any ideas?

Thread 115 (2023-01-03):

Setting I/O pin logical high/low problem

4044ever, 2023-01-03:
I am trying to set some I/O pins high/low to switch some externals via a mosfet.

Does anybody has some knowledge how to do that with a Spider (v2.3 I got) controller? It works with the fan pins, and i.e. `M106 P2 S200` but not with other pins.

I am trying already for a few weeks to get an answer for Fysetc directly, but they seem deaf to any type of question. I really regret buying their product.

Thread 117 (2023-01-15):

Unable to read tmc uart 'stepper_x' register IFCNT Once the underlying issue is corrected

vogodesign, 2023-01-15:
Has the problem been resolved?
I am also struggling with this issue.

vogodesign, 2023-01-15:
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

Closed 2023-01-15.

Thread 118 (2023-01-22):

TMC5160 Sensorless Homing Won't Work

kazooless, 2023-01-22:
I can't get senseless homing to work. I have Fysetc branded TMC 5160's and a Spider 2.2 board. All 4 jumpers are on per the wiring diagram. To follow is my Klipper config for the X & Y. The carriage moves in the right direction, but when it hits, it keeps trying.

Please help

##  Connected to X-MOT (B Motor)
[stepper_x]
step_pin: PE11
dir_pin: PE10
enable_pin: !PE9
rotation_distance: 40
microsteps: 64
full_steps_per_rotation:400  #set to 400 for 0.9 degree stepper
endstop_pin: tmc5160_stepper_x:virtual_endstop
position_endstop: 0
position_min: 0
position_max: 350
homing_speed: 20   #Max 100
homing_retract_dist: 0
#homing_positive_dir: true

[tmc5160 stepper_x]
spi_bus: spi4
cs_pin: PE7
diag1_pin: ^!PB14
run_current: 1
driver_SGT: -64

##  Connected to Y-MOT (A Motor)
[stepper_y]
step_pin: PD8
dir_pin: PB12
enable_pin: !PD9
rotation_distance: 40
microsteps: 64
full_steps_per_rotation:400  #set to 400 for 0.9 degree stepper
endstop_pin: tmc5160_stepper_y:virtual_endstop
position_endstop: 350
position_min: 0
position_max: 350
homing_speed: 20   #Max 100
homing_retract_dist: 0
#homing_positive_dir: true

[tmc5160 stepper_y]
spi_bus: spi4
cs_pin: PE15
diag1_pin: ^!PB13
run_current: 1
driver_SGT: -64

Print3DWorld, 2023-01-30:
Did you put the jumper in the diag slots for X and Y? Otherwise, you need to use the TMC driver comm tool to check if it's reading properly.

kazooless, 2023-02-11:
Thank you. That's what it turned out to be. I missed it on the diagram (easy to do when looking at it).

Closed 2023-02-11.

Thread 119 (2023-01-25):

PC1 & PC2 in Spider 2.2 bad temps readings.

Darkgayo, 2023-01-25:
Hi. I want to connect a common 100k NTC in PC1 & PC2 in my spiderboard 2.2. But in mainsail it shows to high temps about 80 degree instead 20(room temp). In the other thermistor slots works as spected.
I try to interchange the thermistors with the same result.
Any clue?
Thanks.

bertenvdb, 2024-02-22:
Same here. Have a Spider v3 though.
Kinda running out of options, except by another board.

Thread 121 (2023-02-16):

How do i make a new Bootloader_FYSETC_SPIDER.hex file to upload to my controller

warhammertf, 2023-02-16:
How do i make a new Bootloader_FYSETC_SPIDER.hex file to upload to my controller?
Sorry for the basic question - been chasing my tail for over a day trying to get the spider v 2.2 flashed with firmware. I got firmware.bin on the board but when I remove the BTO jumper the board is no longer seen with lsusb or dev/serial/by-id.
Someone on discord said reload the bootloader and again.  Soooooooo......

odb1180, 2023-06-08:
On the fystec spider GitHub, there is a section with both boot loaders to download.

In the spider there's more detailed information on how to do it

2. 32KiB bootloader

Choose 32kiB bootloader offset in Klipper make menuconfig. You may need to flash the spider board bootloader named Bootloader_FYSETC_SPIDER first(If you get your Spider board after 2021/06/23, no worries, the bootloader is on the board when it leave the factory,if not,flash it first). The bootloader is in the folder named bootloader in this repo, please follow the README in bootloader folder(github or gitee) to flash the bootloader. We provide pre-build firmwares with 32KiB bootloader named klipper-32k-USB.bin and klipper-32k-UART.bin for you,find them here github gitee. These pre-build firmware will be outdated if Klipper update and will not match your new downloaded Klipper and cause annoying issues. We will try to catch up with Klipper, but i recommend to build the firmware yourself.

Thread 123 (2023-03-24):

48V heater support?

andi-at-1, 2023-03-24:
Hello,

Does the heater input/output support 48V? I can't find anything in the docs, just a 24V mark in the schematic. Mabe you can clearify that, thanks!

Thread 124 (2023-03-26):

Unable to use spider as USB to CAN bridge

kullwarrior, 2023-03-26:
I follow this guide (https://github.com/akhamar/voron_canbus_octopus_sb2040) in an attempt to setup USB to CAN. However, I cannot get the SB2040 board to be detected by it. UUID for Spider is the only one visible. Do I actually need "CANBUS expander for spider"?

acidcoolxxx, 2023-06-21:
Hi,

im tring to do the same. Did you manage to get it running? Which Pin did you use to connect the SB2040 board to the spider?

kullwarrior, 2023-06-21:
> Hi,
>
> im tring to do the same. Did you manage to get it running? Which Pin did you use to connect the SB2040 board to the spider?

Canbus expander is required

Thread 125 (2023-03-31):

Board doesn't work. 3.3v led doesn't turn on

daniel-sousa-me, 2023-03-31:
I have the Spider connected to a Raspberry Pi, but I can't get it to work in any way.

A serial device shows up when connected through USB, but I can't do anything with it.

The 3.3V led never turns on. I have tried following the instructions on https://github.com/FYSETC/FYSETC-SPIDER/blob/main/Spider%203.3v%20issue.md with no success.

I've tried flashing with MicroSD (no SD led). I tried to flash the bootloader, but dfu-util doesn't see it.

Is the board dead? Is there anything else that I could try?

jakobwowy, 2023-04-01:
I have the same issue today. The board was running and the 3.3 led was ok. After some restarts and changing USB-Port -> Not connection to the printer and also no 3.3 led burning

I have a older version V1.0

1300371, 2024-10-29:
Same here: just plug step drivers and the 3.3V LED never come back.

@GerogeFu , at this time, my board is dead also 😢 ?

Thread 126 (2023-04-09):

Unable to get canbus_uuid for SB CAN Toolhead.

MdShahrilOGP, 2023-04-09:
I am trying to make my new Stealthburner toolhead, equipped with the FYSETC's SB CAN TH and UCAN.
My voron 2.4 is using the Spider v2.2.

This is how my wiring setup is done:
RPI4b > UCAN > SB CAN TH

I've done the make menuconfig and uploaded the firmware exactly as per https://wiki.fysetc.com/SB%20CAN%20ToolHead/.
Next, I attempted to follow https://www.klipper3d.org/CANBUS.html but I found that I was unable to find the canbus_uuid.

I also attempted to follow https://github.com/Esoterical/voron_canbus, since I was out of resources but to no luck at all.
To be sure, I inserted a can0 file into /etc/network/interfaces.d, but I still cannot get the can0 network up at all after running ifconfig.

As a result, running this command `~/klippy-env/bin/python ~/klipper/scripts/canbus_query.py can0` returns this output:

`pi@mainsailos:~/klipper $ ~/klippy-env/bin/python ~/klipper/scripts/canbus_query.py can0
Traceback (most recent call last):
  File "/home/pi/klipper/scripts/canbus_query.py", line 64, in <module>
    main()
  File "/home/pi/klipper/scripts/canbus_query.py", line 61, in main
    query_unassigned(canbus_iface)
  File "/home/pi/klipper/scripts/canbus_query.py", line 21, in query_unassigned
    bustype='socketcan')
  File "/home/pi/klippy-env/lib/python3.7/site-packages/can/interface.py", line 127, in __new__
    return cls(channel, *args, **kwargs)
  File "/home/pi/klippy-env/lib/python3.7/site-packages/can/interfaces/socketcan/socketcan.py", line 594, in __init__
    bind_socket(self.socket, channel)
  File "/home/pi/klippy-env/lib/python3.7/site-packages/can/interfaces/socketcan/socketcan.py", line 459, in bind_socket
    sock.bind((channel,))
OSError: [Errno 19] No such device
`

Running the `lsusb` and `ifconfig` command shows that there is an OpenMoko device (which I am guessing is the UCAN).

`pi@mainsailos:~/klipper $ lsusb
Bus 002 Device 001: ID 1d6b:0003 Linux Foundation 3.0 root hub
Bus 001 Device 005: ID 1d50:614e OpenMoko, Inc.
Bus 001 Device 002: ID 2109:3431 VIA Labs, Inc. Hub
Bus 001 Device 001: ID 1d6b:0002 Linux Foundation 2.0 root hub
pi@mainsailos:~/klipper $ ifconfig
eth0: flags=4099<UP,BROADCAST,MULTICAST>  mtu 1500
        ether e4:5f:01:e4:db:32  txqueuelen 1000  (Ethernet)
        RX packets 0  bytes 0 (0.0 B)
        RX errors 0  dropped 0  overruns 0  frame 0
        TX packets 0  bytes 0 (0.0 B)
        TX errors 0  dropped 0 overruns 0  carrier 0  collisions 0

lo: flags=73<UP,LOOPBACK,RUNNING>  mtu 65536
        inet 127.0.0.1  netmask 255.0.0.0
        inet6 ::1  prefixlen 128  scopeid 0x10<host>
        loop  txqueuelen 1000  (Local Loopback)
        RX packets 0  bytes 0 (0.0 B)
        RX errors 0  dropped 0  overruns 0  frame 0
        TX packets 0  bytes 0 (0.0 B)
        TX errors 0  dropped 0 overruns 0  carrier 0  collisions 0

wlan0: flags=4163<UP,BROADCAST,RUNNING,MULTICAST>  mtu 1500
        inet 11.243.1.215  netmask 255.255.255.0  broadcast 11.243.1.255
        inet6 fe80::6285:e531:4071:798b  prefixlen 64  scopeid 0x20<link>
        ether e4:5f:01:e4:db:33  txqueuelen 1000  (Ethernet)
        RX packets 5762  bytes 656958 (641.5 KiB)
        RX errors 0  dropped 0  overruns 0  frame 0
        TX packets 670  bytes 91766 (89.6 KiB)
        TX errors 0  dropped 0 overruns 0  carrier 0  collisions 0

pi@mainsailos:~/klipper $`

Would someone be able to guide me on what I have done wrong, or is the UCAN / SB CAN TH faulty? Thank you!

Thread 127 (2023-04-23):

Component identification to repair board after accidental short

Clyde92, 2023-04-23:
I accidentally shorted some pins momentarily on my fysetc spider v1.1 board, and blew the circled component. I expect it's a voltage regulator, something like [this](https://au.element14.com/torex/xc6210b332pr/v-reg-ultra-ldo-3-3v-smd-sot-89/dp/1276446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|pcrid||pkw||pmt||slid||product|1276446|pgrid||ptaid||&CMP=KNC-GAU-GEN-SHOPPING-PLA-PMAX), but is anyone able to identify it exactly? I will try and repair the board by replacing this component, and hope I did not damage anything else.

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

quarkvalk, 2024-04-18:
It appears to be U3 from page 2 of [Spider V1.1 Designator Diagram.pdf](https://github.com/FYSETC/FYSETC-SPIDER/blob/main/hardware/V1.x/Spider%20V1.1%20Designator%20Diagram.pdf) . The Spider v1.1 SCH is missing but [Spider v1.0 SCH](https://github.com/FYSETC/FYSETC-SPIDER/blob/main/hardware/V1.x/Spider%20V1.0C%20SCH.pdf) used the [AP2112-3.3V](https://www.digikey.com/en/products/detail/diodes-incorporated/AP2112K-3-3TRG1/4470746) as well as the 2.0, it was changed in V3.0

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

Thread 128 (2023-04-26):

Spider v2.3 Bed Out (PB3 and PB4) only measuring 15V DC

xrmatic, 2023-04-26:
I'm building a Voron 2.4 with a Spider v2.3 and an Omrom Solid State Relay.  In Klipper, when I set the bed heater target to 30 degrees Celsius the LED on the SSR flashes and Klipper errors out saying the heater is not working.  When I measure the bed out voltage it's only measuring 15V DC.  I confirmed the PSU is outputting 24V to the board.  I also confirmed continuity through bed heater and thermistor.

Any ideas?

xrmatic, 2023-04-26:
Never mind, I had the power wired incorrectly.

Closed 2023-04-26.

Thread 129 (2023-05-16):

FYSETC SPIDER V2.3 GPIO UART

akshaykaushik78, 2023-05-16:
Hello, I have accidentally removed the USB C port and damaged one of the soldering pads on the board. I tried using GPIO to connect with the raspberry Pi instead of usb.
 Has anyone else tried it and was successful with it?
 I am assuming I can't do any changes to the firmware of the spider as the USB C port is broken.
I am using raspberry Pi 3b with mainsail.

Thread 130 (2023-05-18):

Fan's not working

whoisjako, 2023-05-18:
Hello,

i got a Fysetc Spider 2.3 as an upgrade for my ender 3 with klipper. So far everything worked fine, my motors are running, i can heat nozzle and bed, but i'm unable to get any fan to work.

So what i  tried:

I wanted to use Fan0, Fan1 and Fan2 for the part cooling , extruder cooling and one for the electronics.
i have different fan voltages, so i swapped the jumpers to 24V or 12V corresponding to the fan. I updated the printer.cfg as following:

[heater_fan hotend_fan]
pin: PA14
max_power: 1.0
fan_speed: 1
kick_start_time: 0.5
heater: extruder
heater_temp: 50.0

[fan]
pin: PB2
max_power: 0.4
kick_start_time: 0.5
off_below: 0.10

[heater_fan controller_fan]
pin: PA13
kick_start_time: 0.5
heater: heater_bed
heater_temp: 45.0

I tried to use only one fan at first but however i'm swapping fans or voltages, the fans wont work.
The leds at the fan connectors are lightning correctly when they are activated, just wont get any fan to start moving.

What am i missing? tried different fan's already that all worked before i swapped my electronics..

Thanks in advance!

jako

wanderlust-vlad, 2023-12-30:
I'm also facing such issue and have found no solution to date. Could you pls clarify?

skyguy94, 2023-12-30:
I had to reverse the polarity of the fan wires. After examining the board and the schematic it dawned on me that the red and black pins in the connector were reverse of what the board expected them to be. I just popped out the pins on the connector and swapped them.

wanderlust-vlad, 2024-01-01:
Thaat worked for me as well, thanks a lot!

Closed 2023-05-18.

Thread 133 (2023-06-12):

Red led at fan1 is always on and Fan1 is always on

FaJoX, 2023-06-12:
Since yesterday the Fan1 is always on. It doesn't matter if it's activated or not. On the board (Spider V1.0), the red LED lights up red. What can I do against it?

Thanks for help!

Thread 135 (2023-07-08):

Spider 2.2 Data and 5V pin for Disco on a stick and StealthBurner LEDs

TKDMarine, 2023-07-08:
What pin is available to run both the disco on a stick already at pin PD3 and 5V and GND behind SD card and StealthBurner LED data and 5V pins from StealthBurner Tool Head PCB? What voltage is PIN UVCC and can PIN DP or DM run Stealthburner LEDs?

Thread 136 (2023-07-08):

Stepper motors not moving att all with Marlin

mattDuque, 2023-07-08:
Hello I just got my spider 2.3 and no matter what I do the stepper motors won't move, I tried changing several settings and reflashing, different stepper motors, different drivers, but the motors remain completely unpowered. The M122 command returns enabled false on all tmc2209 and neither my A4988 or DRV8825 work (I reflashed accordingly).

I've read the documentation and follewed the wiring guide to the best of my understanding, I'm using Marlin v 2.1.2.1, used the example config for the S6 and changed settings needed, the motherboard is set to `BOARD_FYSETC_SPIDER_V2_2`.

Thread 137 (2023-07-08):

Spider 3.0 documentation?

greenaar, 2023-07-08:
Is there a timeline for the spider 3.0 documentation?  In particular the differences in wiring between the 3.0 and the 2.3, the changelog, and perhaps most interesting, the differences in wiring the CanBus connections?

Thank you

RobTS, 2023-08-19:
Just in case it helps you, I just replaced my old setup with the Spider 3.0 and integrated the SB2209. I followed read up on how the Octopus does it, then used the pins suggested for the 2.3, works flawlessly now, just add the new CAN Bus ID to your `[mcu]` entry, wire everything up, and you're set!

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

oldmate45, 2024-09-17:
A year + later and still not much info out there...

cyberjak2k, 2024-09-17:
> A year + later and still not much info out there...

There's more than enough documentation to make a functional printer though I made a completely custom system using various things centred around this board and there was more than enough for me to make a fully functioning Core XY system. What were you hoping for that was not there?

Thread 138 (2023-07-08):

Unable to read tmc uart 'stepper_x' register MSCNT

Safandula86, 2023-07-08:
Hi everyone, I have an issue with my newly assembled printer. I have checked the connections multiple times and couldn't find any issues with the wiring. When I try to perform Home All or Home X/Y, I receive an error message after reaching the 0,0 position:
Unable to read tmc uart 'stepper_x' register MSCNT
sometimes:
Unable to read tmc uart 'stepper_y' register MSCNT

I have already connected pins 4 and 5 on each driver, but it didn't help. Do you have any suggestions?

Printer is Voron 350 on Spider v3, S2209 v4, Orange Pi 4

Kvis-Dev, 2023-08-20:
Hello. Have almost the same issue here.
`Unable to read tmc uart 'stepper_z' register IFCNT`

Were you able to solve it?

Safandula86, 2023-08-21:
Yes, please check jumpers under the stepper drivers

Kvis-Dev, 2023-08-31:
My issue was different. Jumpers were fine, but I needed to solder a jumper between RX and TX pin on my drivers. See image below.
**Read the documentation to your drivers before doing this.**
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

Thread 141 (2023-10-01):

spider 2.3_YMAX vs BLTOUCH

leorpereira87, 2023-10-01:
Hello,
I'm trying to enable the endstop for ymax, but I have a problem, where the PIN for Y-MAX (PA2) is the same one used to control my BLTOUCH, I don't know how to proceed in this situation, I read the manuals and it seems like I need to do something welding...
Could you enlighten me?

Thread 142 (2023-10-02):

Spider 3.0 Wiring

slydog43, 2023-10-02:
Where are the 3.0 wiring diagrams?  How can you sell a board without any info?

cyberjak2k, 2023-10-03:
Look in hardware/V3.0  folder before making comments like that.
 There is loads of documentation including full schematics and several build suggestions
I've already got a printer together using them as well.

Print3DWorld, 2023-12-22:
3.0 was plug and play from 2.2 for me

Thread 143 (2023-10-04):

Spider V2.2/klipper sensorless homing issue

Cabinfourus, 2023-10-04:
I am trying to configure Klipper to run my Cartesian 3D printer. I am having trouble with the diag pin for sensorless homing and the TMC2209 driver. Klipper keeps giving me this error " pin virtual_endstop used multiple times in config". I have been through the configuration multiple times and cannot see the conflict. The X and Y pins on the Spider V2.2 board share pins PB13 and PB14 with the X and Y min endstop connections. I want to use sensorless homing. When I add the diag pin configuration to my printer.cfg file, it comes back with the error. How do I configure the Spider V2.2 board with the Fysetc TMC 2209 V3.0 drivers to use sensorless homing in Klipper?
Also, I'd like to use the ADXL345 sensor with the Spider V2.2 board but I am not sure which pins to use for the connections.

Cabinfourus, 2023-10-04:
WOW! I own several Fystec boards and I am starting to use them but with the lack of help I am finding with this problem from them, I think I will go back to Makerbase or BTT boards.

ejhoness, 2023-10-05:
I don't know if I can help,
the x and y endstops are the same pin
``
[stepper_y]
step_pin: PD8
dir_pin: !PB12
enable_pin: !PD9
microsteps: 16
rotation_distance: 40
endstop_pin: tmc2209_stepper_x:virtual_endstop``

Cabinfourus, 2023-10-08:
This has been one of the most confusing boards I have ever dealt with. I will NEVER buy another Fyetc product.

Rushmere3D, 2023-10-10:
Both your X and Y are configured for endstop_pin: tmc2209_stepper_x:virtual_endstop & diag_pin: PB13

Simply looking at the provided pin out could fix the issue. Can't see how this is a Fysetc problem, more user error.

Rushmere3D, 2023-10-10:
And an ADXL sensor connects to the Raspberry Pi, not the spider. Follow the Klipper docs.

Thread 144 (2023-10-19):

Tmc2209 Unable to read tmc uart 'stepper_z

MakkeLeon2, 2023-10-19:
Hello I have a problem again. The board arrived and I got it working. I did calibrate the Z endstop and the probe everything was working fine. I did change the fan connection to PB2-24v 2x controller fans and PB7-5v leds on the hotend. And still everything was working fine.Then I start heating the bed and the hotend and run QGL still everything ok. Then I run clean nozzle and after that I got { Unable to read tmc uart 'stepper_z' register IFCNT
Once the underlying issue is corrected, use the
"FIRMWARE_RESTART" command to reset the firmware, reload the
config, and restart the host software.
Printer is shutdown}  this again. ps it did clean the nozzle ok.
I changed the driver Z already but that didn't help
[moonraker (2).log](https://github.com/FYSETC/FYSETC-SPIDER/files/13043053/moonraker.2.log)
[klippy (5).log](https://github.com/FYSETC/FYSETC-SPIDER/files/13043054/klippy.5.log)
[printer.txt](https://github.com/FYSETC/FYSETC-SPIDER/files/13043078/printer.txt)

MakkeLeon2, 2023-10-24:
I commented out uart_addres:0 but that did not change anything. I did change z(z-mot) to (E4-mot) PC5 PE0 PE1 PD11 and now I get (Unable to read tmc uart 'stepper_x)
Put in a new driver in x but that did not help. But if I say home it goes up a bit so Z works again before I changed it to E4 not

rafaelmontserrat, 2023-11-27:
Hi, did you figure this one out? I am having the same issue but I can't seem to solve it.

MakkeLeon2, 2023-11-27:
You can use STEPPER_BUZZ STEPPER=stepper_x or y or z1 or z2 or z3 not. In terminal To check the drivers. If it is only Z you can change it to E4 but you have to change the pins.I think the problem is no earth on socket.I had 3 times the board replaced.Every time the nossle hits the plate it burns out the board.I did buy this now one but that doesnot arrived jet so still no printing.I hope this one is better secured.

BIGTREETECH Manta M8P Control Board running Klipper with CB1/CM4 × 1
China / CB1+Manta M8P V2.0+8PCS TMC2209

$98.29

Discount

B8585FBB366F

-$4.00

Subtotal

$94.29

Shipping

$0.00

Taxes

$0.00

Total

$94.29 USD

-------- Oorspronkelijk bericht --------Van: rafaelmontserrat ***@***.***> Datum: 27-11-2023  15:03  (GMT+00:00) Aan: FYSETC/FYSETC-SPIDER ***@***.***> Cc: MakkeLeon2 ***@***.***>, Author ***@***.***> Onderwerp: Re: [FYSETC/FYSETC-SPIDER] Tmc2209 Unable to read tmc uart 'stepper_z (Issue #144)
Hi, did you figure this one out? I am having the same issue but I can't seem to solve it.

—Reply to this email directly, view it on GitHub, or unsubscribe.You are receiving this because you authored the thread.Message ID: ***@***.***>

rafaelmontserrat, 2023-11-27:
Hey. Yeah... this board... is far from good from what I'm experiencing. I have the issue in ALL my drivers, X Y Z and E so yeah, need a fix but i guess i'll wait for fysetc support to come back to me...

Thread 145 (2023-10-20):

Water flow sensor

Cabinfourus, 2023-10-20:
I have a 3D printer with a water cooled hot end. I want to connect a water flow sensor to the Spider V2.2 to monitor water flow and stop the printer if water is not flowing properly. Any ideas? Can I use an endstop? The water flow sensor uses a pusle signal to monitor the flow.

eliwong, 2023-12-13:
The position of the limit switch can be used. They can be used as standard input and output interfaces. If an SD card is not used, the SPI pin next to it can also be used as a normal IO.

Closed 2023-12-13.

Thread 146 (2023-11-08):

Spider 3.0 sensorless homing

Gabriel121217, 2023-11-08:
Does anyone know how to enable sensorless homing on the spider 3? I tried searching for diag pins but I am unable to find them.

cyberjak2k, 2023-11-08:
Look directly under each stepper driver there are 2 pins clearly marked diag. Put a jumper on the pins to enable sensorless homing , no jumper to use endstop switch

ozzman39, 2024-04-08:
do you have to put jumpers on th endstops as well? or just diag? and if so were  on the endstopas

cyberjak2k, 2024-04-09:
Only the diagnostic jumpers. do not put jumpers on the end stop pins

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

Closed 2023-12-13.

Thread 147 (2023-12-13):

TMC stepper_x failed to init: Unable to write tmc spi 'stepper_x' register GLOBALSCALER, TMC5160 on Spider 2.3

Dual-Energy, 2023-12-13:
Should anyone also had the problem of getting SPI for TMC5160 on a Spider-Board working, for me reducing the SPI-Speed **spi_speed: 1000000** did the trick.

**Mainboard: Spider 2.3
Driver: BTT EZ5160 RGB on X and Y**

[stepper_x]
step_pin: PE11
dir_pin:  !PE10
enable_pin: !PE9
rotation_distance: 40
full_steps_per_rotation:200
microsteps: 64
#endstop_pin: !PA1 # on toolhead.cfg
position_min: 0
position_endstop: 300
position_max: 300
homing_speed: 150
second_homing_speed: 25
homing_retract_dist: 4
homing_positive_dir: true

[tmc5160 stepper_x]
spi_bus: spi4
cs_pin: PE7
spi_speed: 1000000
#diag1_pin: PB13
interpolate: False
run_current: 1.15
sense_resistor: 0.05 #0.110
stealthchop_threshold: 0

[stepper_y]
step_pin: PD8
dir_pin:  !PB12
enable_pin: !PD9
rotation_distance: 40
full_steps_per_rotation:200
microsteps: 64
endstop_pin: !PA3
position_min: 0
position_endstop: 300
position_max: 300
homing_speed: 150
second_homing_speed: 25
homing_retract_dist: 5
homing_positive_dir: true

[tmc5160 stepper_y]
spi_bus: spi4
cs_pin: PE15
spi_speed: 1000000
#diag1_pin: PB13
interpolate: False
run_current: 1.15
sense_resistor: 0.05 #0.110
stealthchop_threshold: 0

Closed 2023-12-13.

Thread 148 (2023-12-22):

Spider 3.0 Stepper Stuttering on Power Up

Print3DWorld, 2023-12-22:
Having some weird power-up issues now when the printer sits for awhile the mainsail won't connect any more, and when I go to power-cycle the steppers are buzzing on the start-up for awhile before settling down. Almost like the pi and board are giving some feedback during power-up. Anyone else have this or ideas?

cyberjak2k, 2023-12-22:
I've seen this if I reboot my pad 7 and it sometimes did it till it was reconnected to by the pad 7. As if when the brain stops talking to it and the board is sent a reset signal , or if the power to the mainboard is on before your host MCU it will do it till the host MCU starts talking to the Klipper firmware on the board. Haven't found a resolution but I don't think it's the PSU

Print3DWorld, 2023-12-22:
> I've seen this if I reboot my pad 7 and it sometimes did it till it was reconnected to by the pad 7. As if when the brain stops talking to it and the board is sent a reset signal , or if the power to the mainboard is on before your host MCU it will do it till the host MCU starts talking to the Klipper firmware on the board. Haven't found a resolution but I don't think it's the PSU

That would be a horrible thing to need to fix with hardware on a mainboard, should be a feature in the board to wait for the host to speak to the board before any feedback goes over those lines.. could cause injury or damage to steppers if something dumb happens?

cyberjak2k, 2023-12-22:
I look forward to your findings then as  I think it would be partially software initiated. As I did do a few tests with Marlon and never saw this trait before moving it to Klipper

Print3DWorld, 2023-12-22:
> I look forward to your findings then as I think it would be partially software initiated. As I did do a few tests with Marlin and never saw this trait before moving it to Klipper

With the holidays I will probably take a little bit, and it's still early for the 3.0 board so we are lonely still lol; but since it's shipping now I am sure we will have more things pop up.

The disconnecting of moonraker/mainsail due to the hardware acting up is just my main headache right now. Also, this issue could tie into the fact that sometimes after already having done a print, or just sitting for several hours powered on will cause my X axis to home in the wrong direction for absolutely no reason.

I have to hard power cycle the mains switch, and then re-home and it's the correct direction once again. I do use sensorless, and it all works great but sometimes this is a damn headache to cycle power on it.

cyberjak2k, 2023-12-22:
Tbh I use endstop switches, I leave the printer on all the time even just
idle. Kind of a burn in test. Never had it disconnect yet so can't comment

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

freezir12, 2024-01-19:
i am facing the same issue, seems like the stuttering is mostly on the A and B motor ports

cyberjak2k, 2024-01-19:
I've had it with z motors as well but it's not consistent

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

cyberjak2k, 2024-01-19:
Just as an add-on point if you disconnect the USB cable and power on just the printer without the pi obviously being connected I have seen this trait and in some cases it affected both z motors as well as a and b. Almost as if they were being randomly stepped mainly in one direction. Still unsure of the cause but with a marlin firmware on the board it never seemed to do this so I'd have to guess it's something about the way the drivers act at that point

kengeer, 2024-03-12:
I checked all my wiring and removed the wire that came with the jumper for M0 and 1 (24v to 48v), it also seemed a little loose. I replaced it with a solid core wire and now the stuttering is gone completely.

cyberjak2k, 2024-03-13:
I have to admit I do think you are right with regard to connection if
anything as mine started finally doing it again I thought it was a software
change I made a while back. So I wiggled the connector still the original
wire and it has stopped doing it. Think I'm going to redo the connector on
it and maybe trip a little soldering because whether it's solid wire or
it's stranded wire should not matter but connect to the pins will be the
big thing

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

Altirix, 2024-06-14:
Also have this issue, tried to replace the AB motor power jumper but no luck, still does it.

Altirix, 2024-06-15:
Ok, for some reason the board just needs to be flashed with all of the EN pins pulled high.

super weird. but that actually stopped this behaviour. im not sure how people have had success with just doing something to the power jumping connector

cyberjak2k, 2024-06-15:
Wow interesting find. I'll give this a try as issue came back over long time but other times doesn't do it.

cyberjak2k, 2024-06-20:
I can confirm enabling the Ean pins works

erlis, 2024-11-01:
oh wow, yes enabling the pins also worked for me

Thread 149 (2024-01-17):

Spider v2.3 flash firmware and bootloader - jumpering for dfu-util

tekgrrl, 2024-01-17:
Build: Voron 2.4r2
Raspberry Pi 4 + Spider 2.3

We just had a failure of our trusty Spider v1.1 (our fault) and we're replacing with a Spider v2.3.

The new board came with a base install of Marlin so I built Klipper on the Raspberry Pi planning to install it with `dfu-util`. For everything up to Spider v2.2 the instructions are to jumper BT0 and the 3.3v which are clearly marked on the board. I can't find these anywhere on the v2.3 board or on any online diagrams of the board.

**How  do I use `dfu-util` with the Spider v2.3?**

Just to add, I tried using the SD Card and it seemed to flash OK (`firmware.bin` renamed to `old.bin` ) but the PI and the Spider wouldn't talk, even though there was a valid USB serial device. While trying different options with the Klipper firmware build I likely overwrote the bootloader and don't know how to restore that without using dfu-util. (this is likely a separate issue).

JD13xs, 2024-01-18:
They are there. Download the  pinout and wiring diagrams.
The location has changed. I have most of the revisions of the boards. Make
sure to change the pins on the fans as they are different.

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

tekgrrl, 2024-01-19:
Thanks, found it. It's marked as Boot0 on the silk screen on the back of the board.

Closed 2024-01-19.

Thread 150 (2024-01-31):

Spider v2.3; USB problems; no MCU id.

Fickert07, 2024-01-31:
Able to flash bootloader and firmware via USB with STM32 Programmer, additionally able to flash firmware Via SD (confirmed with old.bin file on sd card after install), but Pi does not detect a USB change with sudo dmesg when I unplug and plug back in the board.

Pi is not the issue as it is detecting multiple Webcams via USB.

Not sure where to go from here other than order a new board. Frustrating as I purchased a year ago, but was never taken out of the plastic.

Any tips I will be greatful.

Fickert07, 2024-01-31:
Also to add, firmware compiled was using USB not serial or CAN.

zhujue888, 2024-02-04:
看来没有得到任何回复。

michaelcuneo, 2024-09-18:
I have the exact same problem, in USB DFU mode the firmware can be flashed, then it finishes flashing, drops out of DFU Mode to detect the USB and I have a working printer... as soon as I pull the Jumpers off U5V and 3.3V and restart, USB is gone.

Eloura74, 2025-05-12:
same problem*

Thread 151 (2024-02-15):

FYSETC Mini 12864 Panel 2.1 with Spider 3.0 and Marlin firmware

karponline, 2024-02-15:
Please help, I have a problem with starting MINI FYSETC 12864 and the new Marlin. On the version downloaded from GIT Fysetc, the panel lights up and displays correctly. But in the version downloaded from GIT Marlin, the panel does not light up. The menu content is on the screen but without backlight.

Thread 154 (2024-04-04):

I cannot flash bootloader or any firmware to 2.3

wanderlust-vlad, 2024-04-04:
I wanted to move my setup (Spider 2.3 and Paspberry Pi Zero 2W) from USB connection to UART.
Reconfiguration of Pi according to the FYSETC documentation was easy, but when I tried to reflash MCU - there trouble came.
First I've tried to do it via sdcard - name of the file changed, led blinked...but host could not connect to the MCU.
Then I tried to reflash via DFU (with STM32Cube programmer) - flashing was done but verification showed up some errors.
Bootloader is gone, MCU is not detected by **ls /dev/serial/by-id/***
I tried to flash it via DFU from my Pi, but **dfu-util --list** shows this:
dfu-util: Cannot open DFU device 0483:df11 found on devnum 3 (LIBUSB_ERROR_ACCESS)

When I try to flash bootloader (taken from this Github), I receive the same verification errors as during flashing the firmware.
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

How can I finally flash my MCU?

JD13xs, 2024-04-04:
Did you set the jumpers for DFU mode?

 I find DFU mode easier.

On Thu, Apr 4, 2024, 2:53 PM wanderlust-vlad ***@***.***>
wrote:

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

Thread 155 (2024-04-13):

Spider 3 with TMC2209 V4.0 (fysetc) stepper drivers

ozzman39, 2024-04-13:
TMC2209 V4.0

ozzman39, 2024-04-20:
Just tried switching the stepper in that slot thinking maybe I had a bad one same error.

ozzman39, 2024-04-21:
what are the chances of 2 stepper driver slots being dead on a board? getting  (Unable to read tmc uart 'stepper_(X andY)' register IFCNT)  if i move the steppers over to the end of the board it I can clear the error (s). the pinout looks correct (github and photo) Spider 3
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

eliwong, 2024-04-22:
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
I'm very sorry that the video is wrong and bothered you. The power supply next to XY is prepared for 48V. If you do not use 48V, you need to short-circuit 24V and 48V so that the XY socket will have power.
Both 2209 V3.1 and V4.0 can be used on PSIDER 3.0. All it takes is a jumper cap.

ozzman39, 2024-04-22:
Thank you so much for responding! could you send a picture to illustrate
please.

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

ozzman39, 2024-04-22:
Saw the pick figured it out thank you so much!!!!!!

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

lerototi, 2024-12-05:
Hey Guys! I'm having the same problem.
Can you say how I solve it?
I'm using spider 2.3 and tmc 2209 v4.0 by fysetc kit. I don't understanding what I need to do to solve it.

TheAsda, 2024-12-06:
Today i've also encountered while upgrading from spider v2.2 to v3.0. In my case the issue was that board was prepared for different drivers. I've used TMC 2209 v3.1 from my old board. So i removed the unnecessary jumpers and it worked.
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

lerototi, 2024-12-06:
Nice!!! It worked for me!! Thanks!!

Thread 156 (2024-05-07):

BTT Microprobe Causes board to stop working

markleaf131313, 2024-05-07:
I am trying to connect the BTT Microprobe with Spider v1.0, I am using the Z Max and Min headers with the VProbe set to 5V. When it is connected to the ZMax port the board doesn't turn on at all and the probe does nothing, the 12v and 3.3v lights are turned off and only 24v light is on. If I use another 5V port to power the probe, it works for the probe to do it's self test, all the 24/12/3.3v lights are on. But a few seconds later the 12/3.3v lights turn off and it is the same thing. I don't think it should be drawing too much power, it only uses 350ma, so I am not sure what is going wrong.

Thread 158 (2024-07-09):

Spider v3 cant run BTT EBB 2209 CAN toolhead (Fysetc Voron 2.4 R2)

inkvi601, 2024-07-09:
Id like to ask you, if there is any compatibility problem to use BTT EBB 2209 CAN toolhead with Spider V3 controller?

I flashed firmware on both (Spider3 and EBB CAN module), controller is normally running using CAN bus, but when I try to turn on the EBB CAN toolhead module, entire electronics is silent - there is only one red LED flashing (24V label red LED on Spider).

I dont understand, where can be a problem, since the toolhead module is using same voltage. Everything is working with original Fysetc CAN toolhead module... Im using original FYSETC CAN cable provided with the kit.

inkvi601, 2024-07-10:
I found the issue. You have error in your drawing.

Your original wiring image from Fysetc wiki: https://wiki.fysetc.com/assets/SB_CAN_ToolHead_V13_Wiring.png

You have +24V (red cabel) on the bottom pin fo CAN cable connector. But in reality, you have it on the top pin (you have it right on Voron wiring image). So you have it swapped- drawing from wiki vs. reality.

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

Thread 161 (2024-08-16):

Spider 2.3 + TMC2240, Unable to write tmc spi 'stepper_x' register DRV_CONF

llambion72, 2024-08-16:
I bought two fystec tmc2240 drivers to replace tmc2209 X and Y drivers on spider 2.3 motherboard.
I put the jumpers according to the instructions that fysetc has for the TMC5160, so all 4 jumpers plugged in.
After they installed and changed printer.cfg configuration, when i try to do a home, this error is shown!! Unable to write tmc spi 'stepper_x' register DRV_CONF.
The same error is shown on stepper y, if a try to do a Y home
TMC2209 drivers work perfectly if i swap them

Thread 162 (2024-08-27):

Spider H7 repo does not exist

cereal7802, 2024-08-27:
I bought the Spider-H7 and on the packaging it shows a link to a wiki article that does not exist, and a github repo that does not exist.

Links:

https://wiki.fysetc.com/FYSETC-SPIDER-H7
https://github.com/FYSETC/FYSETC-SPIDER-H7

it would be nice if you would make those resources public before shipping products to customers....

wickated, 2024-09-02:
u actually dont need repo since all the pins are written directly on board face

grc1000, 2024-09-10:
Hello, is there no example for configuring printer.cfg in klipper?

cyberjak2k, 2024-09-10:
Please see the readme section below the folders. Printer.cfg is there but
examples for klipper  are usually based on printer
https://github.com/FYSETC/FYSETC-SPIDER/tree/main/firmware/Klipper

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

grc1000, 2024-09-19:
Hello, my board arrived, but I can't find documentation regarding the spider h7, only the f446 version, which is very different. I can't write the firmware to the SD or put the board in dfu boot mode. Where can I find the correct documentation for my spsder h7 model?

Thread 163 (2024-09-18):

Spider v2.2 + Raspberry Pi 4 Model B USB in DFU works, USB outside DFU fails

michaelcuneo, 2024-09-18:
I am upgrading an old Creality Ender 5 Plus default Creality v2.2 board to the FYSETC Spider v2.2, and so far I have had a good result rewiring and flashing, but the Raspberry Pi only detects the MCU in DFU mode, and then if I remove the 3.3v and 5V jumpers to switch back to normal operation, the USB cannot be found no matter what I do.

I have used multiple USB cables and all of them have failed to get me a USB connection. `lsusb` shows no new USB, and `sudo dmesg` shows no connected USB.

Just to make sure I am doing this correctly... if I am using a Raspberry Pi over USB, I do not need ANY JUMPERS connected at all?

Nothing from BT0 to GND, or any other jumper in the power areas?

Thread 164 (2024-12-21):

Spider v3.0h7 not working after flashing klipper.

vdelephimne, 2024-12-21:
Ok.
 I have tried everything in the guide at least 5 times and nothing works.
Flashing seems to be fine file uploaded 100% I never get a connection after restart. No serial device listed /dev/serial/
I tried by SD card no change and yes, I re-flashed the bootloader per your instructions, I purchased your voron v2.4 kit hoping it would not be this much of an issue to get working. Your documentation is not the best I have seen. I am going to await your response and resolution to this issue.

Detail file / imges
make flash FLASH_DEVICE=0483:df11
  Flashing out/klipper.bin to 0483:df11
sudo dfu-util -d ,0483:df11 -R -a 0 -s 0x8000000:leave -D out/klipper.bin

dfu-util 0.11

Copyright 2005-2009 Weston Schmidt, Harald Welte and OpenMoko Inc.
Copyright 2010-2021 Tormod Volden and Stefan Schmidt
This program is Free Software and has ABSOLUTELY NO WARRANTY
Please report bugs to http://sourceforge.net/p/dfu-util/tickets/

dfu-util: Warning: Invalid DFU suffix signature
dfu-util: A valid DFU suffix will be required in a future dfu-util release
Opening DFU capable USB device...
Device ID 0483:df11
Device DFU version 011a
Claiming USB DFU Interface...
Setting Alternate Interface #0 ...
Determining device status...
DFU state(2) = dfuIDLE, status(0) = No error condition is present
DFU mode device DFU version 011a
Device returned transfer size 1024
DfuSe interface name: "Internal Flash   "
Downloading element to address = 0x08000000, size = 37492
Erase   	[=========================] 100%        37492 bytes
Erase    done.
Download	[=========================] 100%        37492 bytes
Download done.
File downloaded successfully

after restart
lsusb
Bus 004 Device 001: ID 1d6b:0003 Linux Foundation 3.0 root hub
Bus 003 Device 001: ID 1d6b:0002 Linux Foundation 2.0 root hub
Bus 002 Device 001: ID 1d6b:0003 Linux Foundation 3.0 root hub
Bus 001 Device 001: ID 1d6b:0002 Linux Foundation 2.0 root hub

ls /dev/serial/*
ls: cannot access '/dev/serial/*': No such file or directory

vdelephimne, 2024-12-22:
Resolved
you need to link this in your spider GitHub or your sales material on the H7 https://github.com/FYSETC/FYSETC-SPIDER-H7
Took me 2 days of trial and error because all I had was the reference for all you other spider boards. I found that by accident in a Google search. H7 has a different processor than the spider 3x

Thread 165 (2025-05-10):

flash spider V2.3

Eloura74, 2025-05-10:
Good morning,
I have a spider v2.3 and lots of something else following a vz bot
But following an update of Klipper, Bdsensor, of my RP2040 it was necessary to flash the card,
The problem being that I succeeded by putting in dfu mode jumper but as soon as I get it it no longer works in the restart
Someone has a correct solution please in each flash is the same problem
THANKS

Thread 167 (2025-07-18):

The Spider v3.0 board doesn't communicate with the BTT-PI board via the UART port.

solon-nascimento, 2025-07-18:
I bought a Spider v3.0 and a BTT-PI to use with my new Voron Trident. I installed Klipper on the board according to Bigtreetech's recommendations, as per the link https://github.com/bigtreetech/CB1. I changed the Boardenv.txt file to UART communication (console=serial). I used the firmware in the bootloader from the link https://github.com/FYSETC/FYSETC-SPIDER/tree/main/firmware/Klipper and loaded it via SDCARD. In printer.cfg, I configured it (serial: /dev/ttyAMA0), and even after all these changes, the connection between the BTT-pi and the Spider board doesn't work. I need support to get it working.

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

solon-nascimento, 2025-07-19:
Thanks for the quick reply. The file already has console:serial as shown in the image below, so that wouldn't be the problem. When I changed serial: /dev/ttyAMA0 to serial: /dev/ttyS0, Klipper gave me this version error. I don't know what to do anymore; I've been trying to get it to work for three days. I also can't find anything specific about using these two cards together. I also apologize for my English; Google is helping me with this!

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

cyberjak2k, 2025-07-19:
Yes that's because the Klipper version on the CB1 is different than the one on the stm32 of the Mainboard. This is why I use the USB not the UART as it makes much easier to flash new firmware when required. Eliminating the need of SDcard flashing but in short remake the Klipper binary from Klipper on your CB1 and reflash the mainboard with the resulting bin file. And reconsider moving to usb so you can then also take advantage of the usb to can bridge should you wish to do as I did and use CANbus to connect to the toolhead

solon-nascimento, 2025-07-19:
I'll be doing it now

solon-nascimento, 2025-07-19:
I followed your advice and just compiled the firmware using DFU communication. Everything seemed fine, but it gave me an error displaying the USB port communication code. I'll copy it below. If you could analyze it and tell me if I did something wrong so I can finally get everything working, I'd be very grateful.

  Preprocessing out/src/generic/armcm_link.ld
  Linking out/klipper.elf
  Creating hex file out/klipper.bin
biqu@VORON:~/klipper$ lsusb
Bus 008 Device 001: ID 1d6b:0001 Linux Foundation 1.1 root hub
Bus 004 Device 001: ID 1d6b:0002 Linux Foundation 2.0 root hub
Bus 007 Device 001: ID 1d6b:0001 Linux Foundation 1.1 root hub
Bus 003 Device 001: ID 1d6b:0002 Linux Foundation 2.0 root hub
Bus 006 Device 001: ID 1d6b:0001 Linux Foundation 1.1 root hub
Bus 002 Device 001: ID 1d6b:0002 Linux Foundation 2.0 root hub
Bus 005 Device 002: ID 0483:df11 STMicroelectronics STM Device in DFU Mode
Bus 005 Device 001: ID 1d6b:0001 Linux Foundation 1.1 root hub
Bus 001 Device 001: ID 1d6b:0002 Linux Foundation 2.0 root hub
biqu@VORON:~/klipper$ make flash FLASH_DEVICE=0483:df11
  Building hid-flash
gcc -c -Wall -std=gnu99 -I . `pkg-config libusb-1.0 --cflags` main.c -o main.o
gcc -c -Wall -std=gnu99 -I . `pkg-config libusb-1.0 --cflags` hid-libusb.c -o hid-libusb.o
gcc -c -Wall -std=gnu99 -I . `pkg-config libusb-1.0 --cflags` rs232.c -o rs232.o
gcc -no-pie main.o hid-libusb.o rs232.o `pkg-config libusb-1.0 --libs` -lrt -lpthread -o hid-flash
  Flashing out/klipper.bin to 0483:df11
sudo dfu-util -d ,0483:df11 -R -a 0 -s 0x8000000:leave -D out/klipper.bin

dfu-util 0.9

Copyright 2005-2009 Weston Schmidt, Harald Welte and OpenMoko Inc.
Copyright 2010-2016 Tormod Volden and Stefan Schmidt
This program is Free Software and has ABSOLUTELY NO WARRANTY
Please report bugs to http://sourceforge.net/p/dfu-util/tickets/

dfu-util: Invalid DFU suffix signature
dfu-util: A valid DFU suffix will be required in a future dfu-util release!!!
Opening DFU capable USB device...
ID 0483:df11
Run-time device DFU version 011a
Claiming USB DFU Interface...
Setting Alternate Setting #0 ...
Determining device status: state = dfuERROR, status = 10
dfuERROR, clearing status
Determining device status: state = dfuIDLE, status = 0
dfuIDLE, continuing
DFU mode device DFU version 011a
Device returned transfer size 2048
DfuSe interface name: "Internal Flash  "
Downloading to address = 0x08000000, size = 29000
Download        [=========================] 100%        29000 bytes
Download done.
File downloaded successfully
dfu-util: Error during download get_status

Failed to flash to 0483:df11: Error running dfu-util

If the device is already in bootloader mode it can be flashed with the
following command:
  make flash FLASH_DEVICE=0483:df11
  OR
  make flash FLASH_DEVICE=1209:beba

If attempting to flash via 3.3V serial, then use:
  make serialflash FLASH_DEVICE=0483:df11

make: *** [src/stm32/Makefile:111: flash] Error 255
biqu@VORON:~/klipper$ ls/dev/serial/by~id
-bash: ls/dev/serial/by~id: No such file or directory
