FYSETC/FYSETC-SPIDER/hardware/V3.0_H7/SPIDER_H7_SCH.pdf

5

4

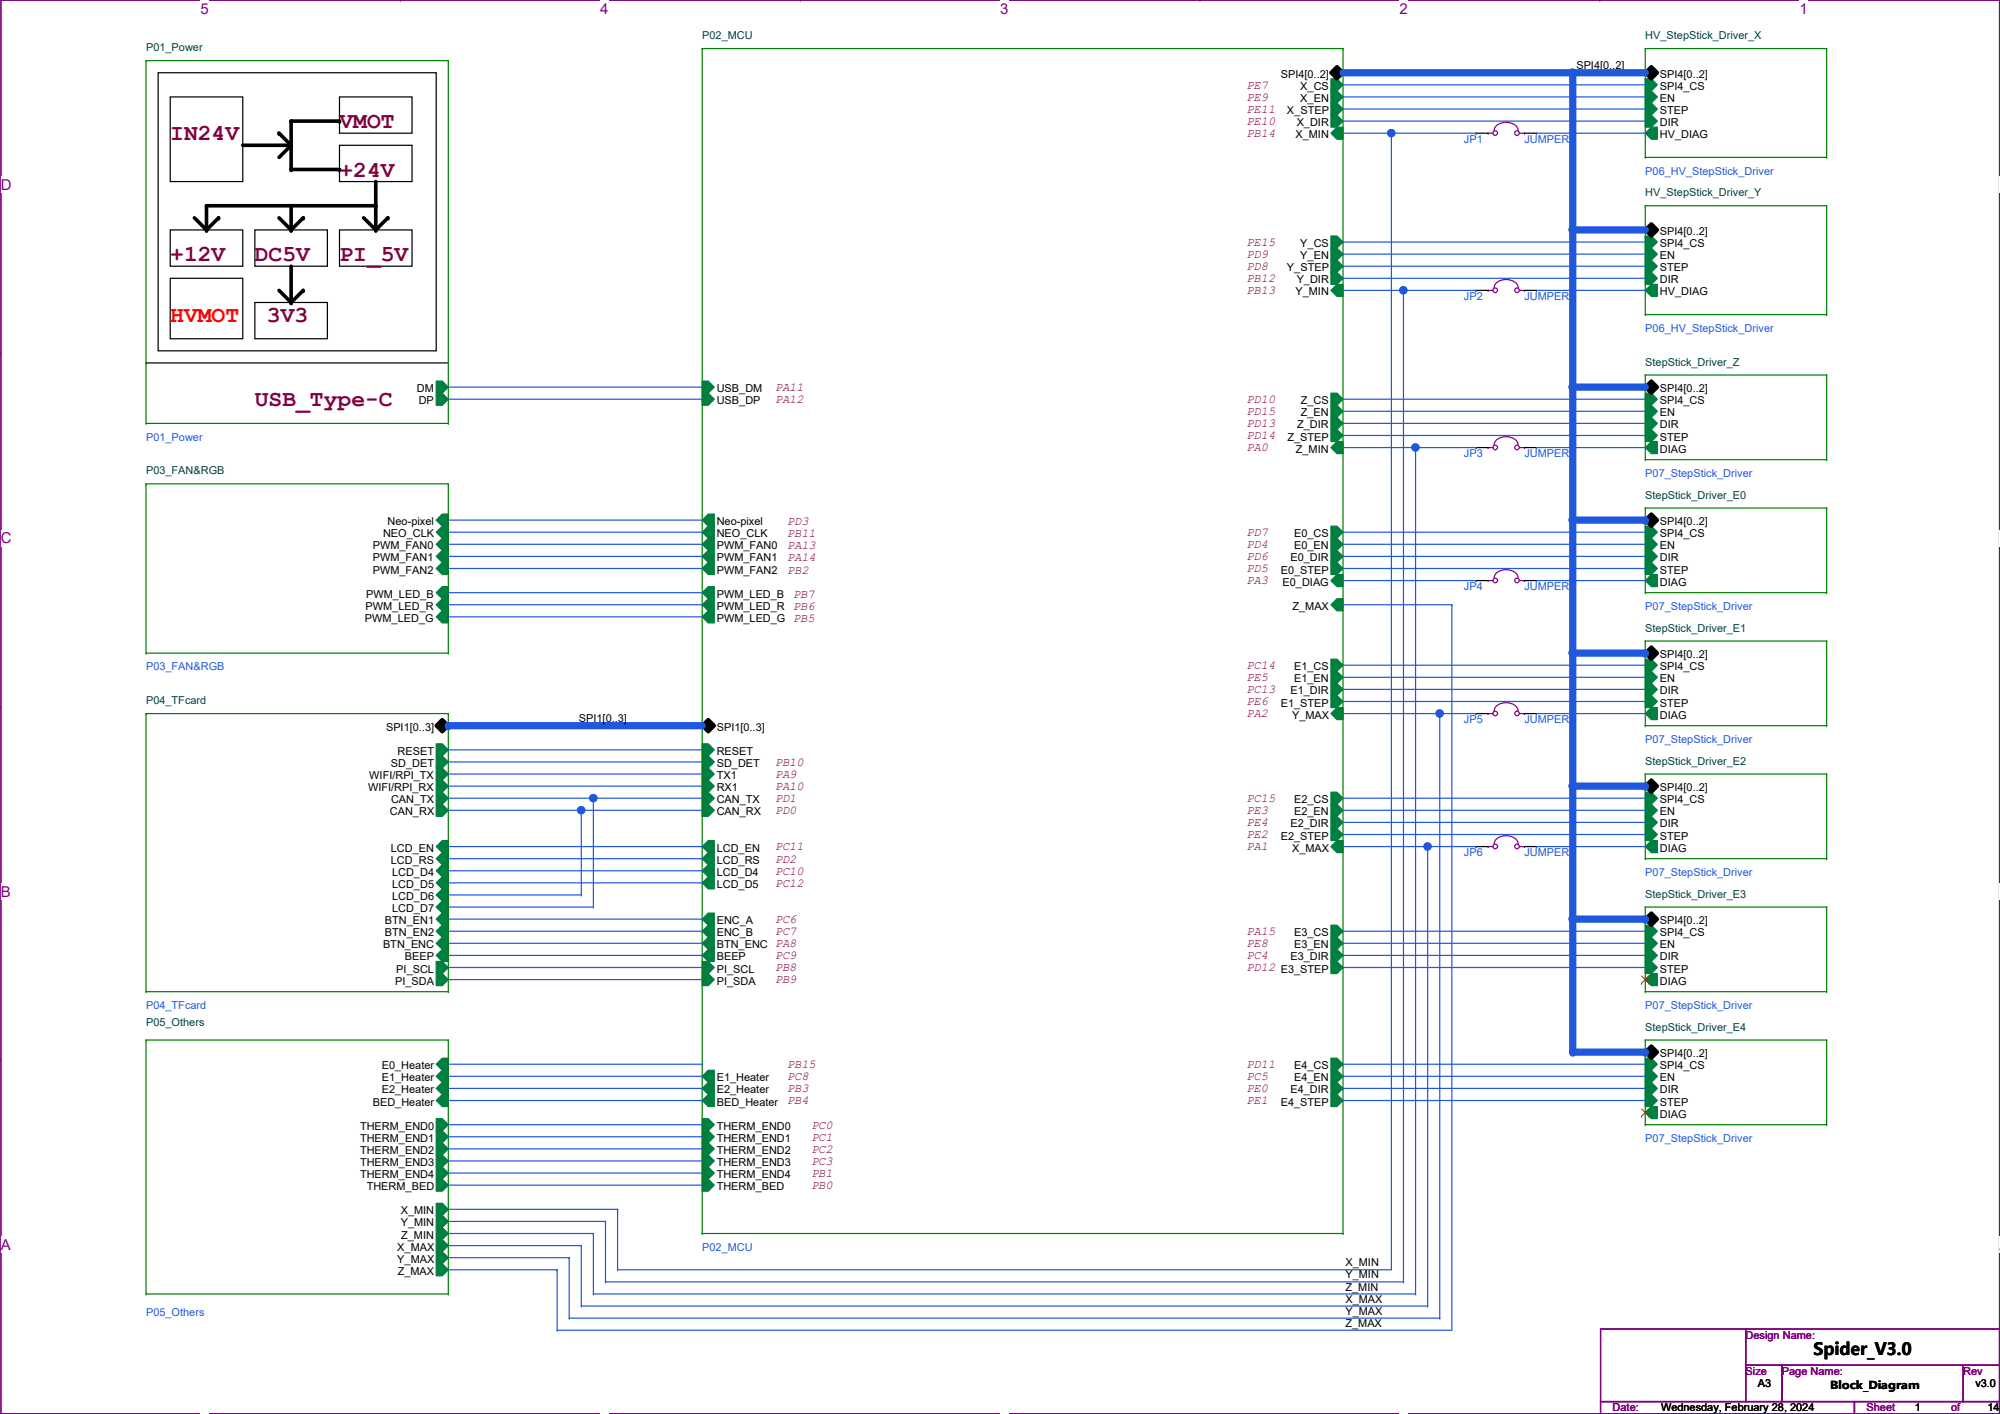
[picture p57: page 1]
VMOT; HVMOT; USB_Type-C; Design Name:; Size; Page Name:; Rev; Date:; Sheet; Spider_V3.0; Wednesday, February 28, 2024; Block_Diagram; P04_TFcard; RESET SD_DET; WIFI/RPI_RX; WIFI/RPI_TX; CAN_TX CAN_RX; BEEP; BTN_EN1; LCD_EN LCD_RS; BTN_EN2; LCD_D5; LCD_D4; LCD_D7; LCD_D6; BTN_ENC; SPI1[0..3]; PI_SCL PI_SDA; StepStick_Driver_E1; P07_StepStick_Driver; STEP; DIR; SPI4_CS; DIAG; SPI4[0..2]; JUMPER; StepStick_Driver_E4; P05_Others; E0_Heater; Z_MAX; E1_Heater E2_Heater BED_Heater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

D D

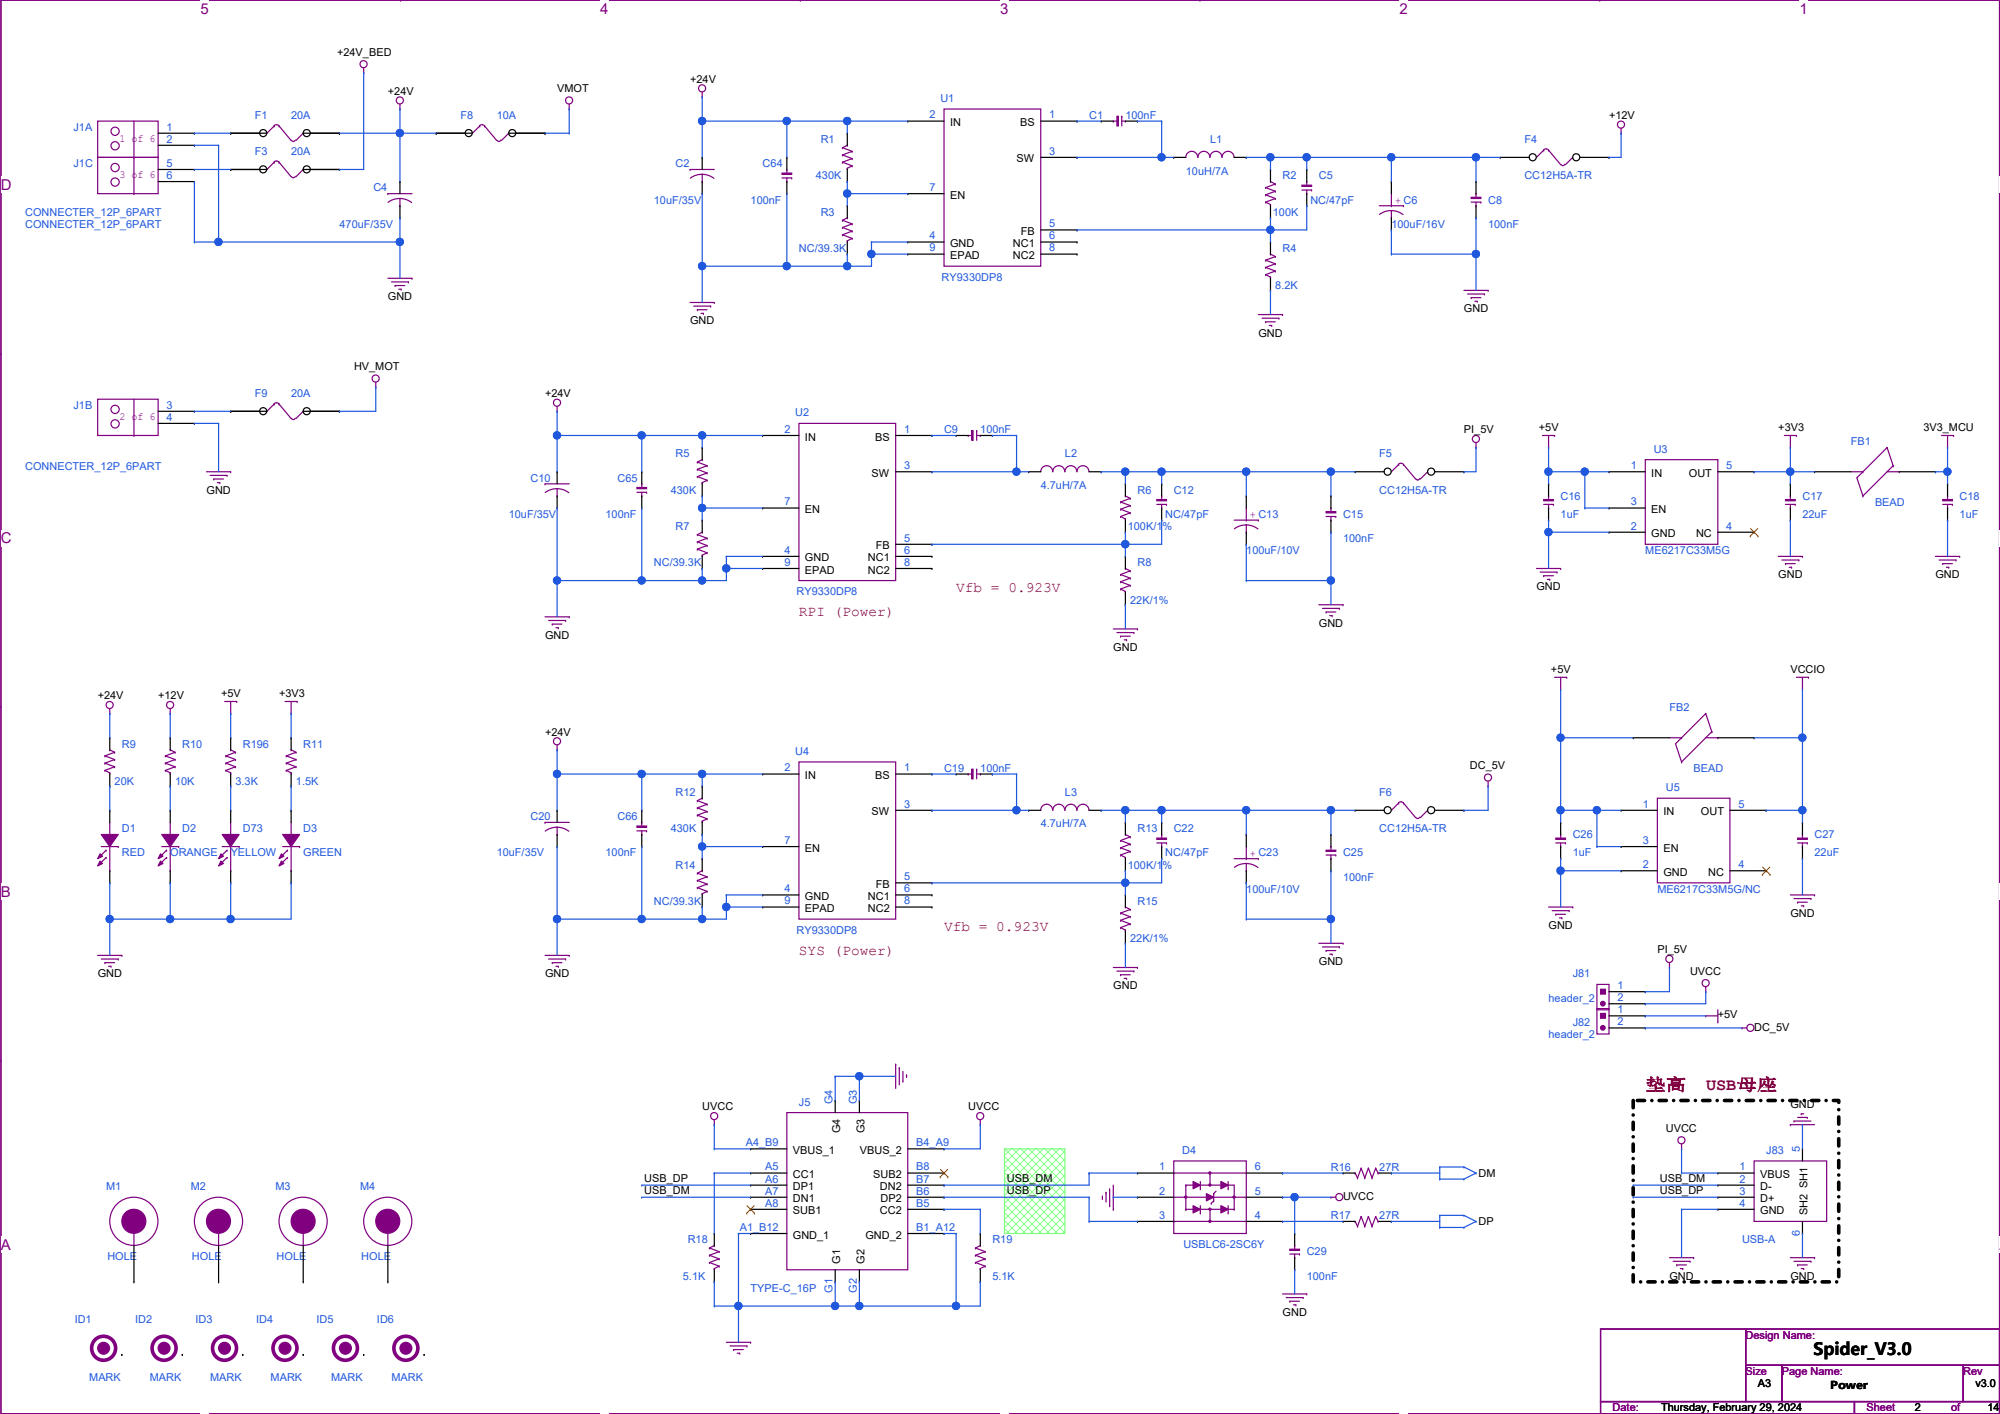
[picture p58: page 2]

5

4

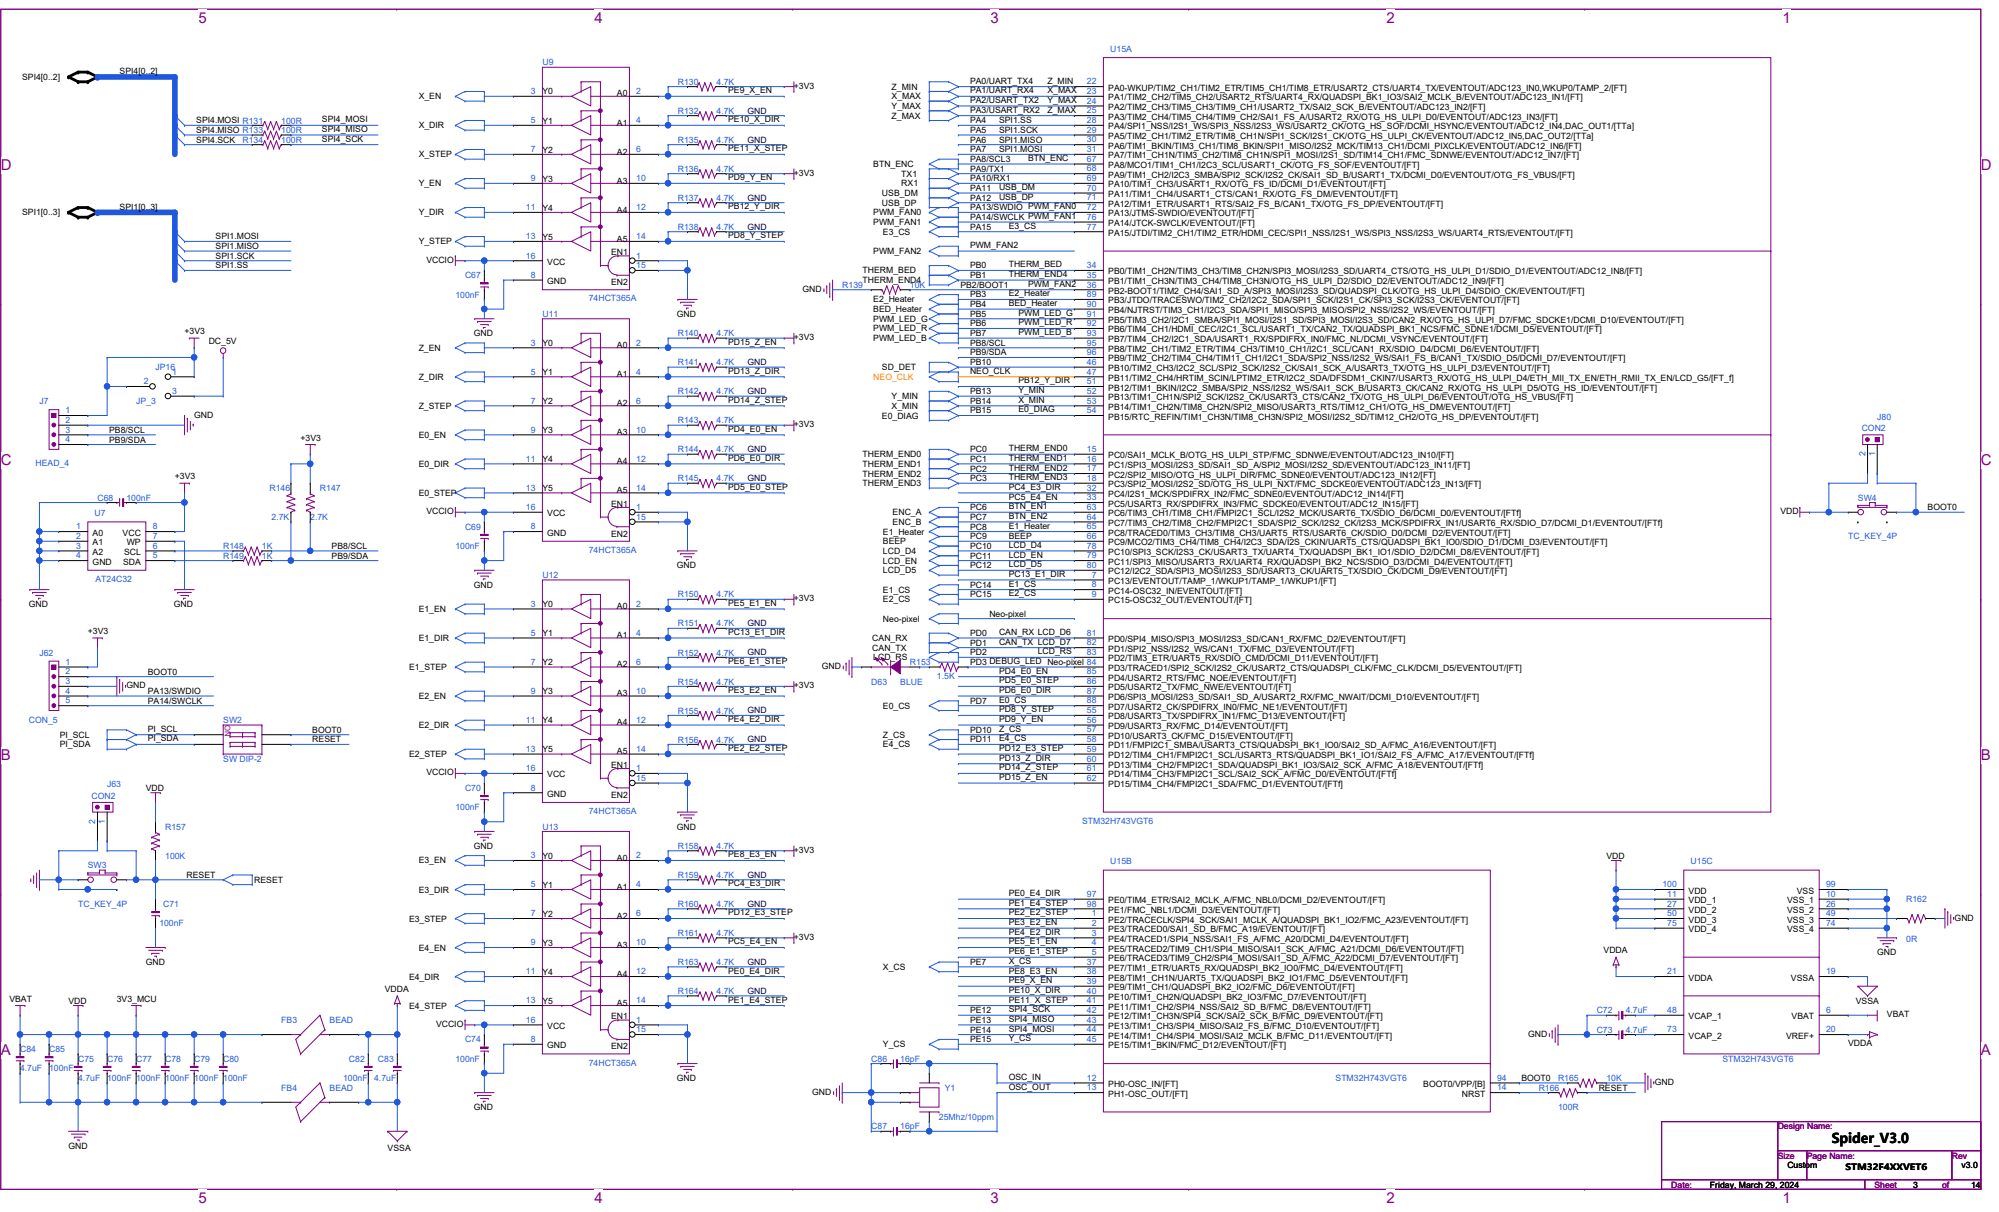
[picture p59: page 3]

PA11/TIM1_CH4/USART1_CTS/CAN1_RX/OTG_FS_DM/EVENTOUT/[FT] 70
PA12/TIM1_ETR/USART1_RTS/SAI2_FS_B/CAN1_TX/OTG_FS_DP/EVENTOUT/[FT] 71
PA13/JTMS-SWDIO/EVENTOUT/[FT] 72
PA14/JTCK-SWCLK/EVENTOUT/[FT] 76
PA15/JTDI/TIM2_CH1/TIM2_ETR/HDMI_CEC/SPI1_NSS/I2S1_WS/SPI3_NSS/I2S3_WS/UART4_RTS/EVENTOUT/[FT] 77

PB0/TIM1_CH2N/TIM3_CH3/TIM8_CH2N/SPI3_MOSI/I2S3_SD/UART4_CTS/OTG_HS_ULPI_D1/SDIO_D1/EVENTOUT/ADC12_IN8/[FT] 34
PB1/TIM1_CH3N/TIM3_CH4/TIM8_CH3N/OTG_HS_ULPI_D2/SDIO_D2/EVENTOUT/ADC12_IN9/[FT] 35
PB2-BOOT1/TIM2_CH4/SAI1_SD_A/SPI3_MOSI/I2S3_SD/QUADSPI_CLK/OTG_HS_ULPI_D4/SDIO_CK/EVENTOUT/[FT] 36
PB3/JTDO/TRACESWO/TIM2_CH2/I2C2_SDA/SPI1_SCK/I2S1_CK/SPI3_SCK/I2S3_CK/EVENTOUT/[FT] 89
PB4/NJTRST/TIM3_CH1/I2C3_SDA/SPI1_MISO/SPI3_MISO/SPI2_NSS/I2S2_WS/EVENTOUT/[FT] 90
PB5/TIM3_CH2/I2C1_SMBA/SPI1_MOSI/I2S1_SD/SPI3_MOSI/I2S3_SD/CAN2_RX/OTG_HS_ULPI_D7/FMC_SDCKE1/DCMI_D10/EVENTOUT/[FT] 91
PB6/TIM4_CH1/HDMI_CEC/I2C1_SCL/USART1_TX/CAN2_TX/QUADSPI_BK1_NCS/FMC_SDNE1/DCMI_D5/EVENTOUT/[FT] 92
PB7/TIM4_CH2/I2C1_SDA/USART1_RX/SPDIFRX_IN0/FMC_NL/DCMI_VSYNC/EVENTOUT/[FT] 93
PB8/TIM2_CH1/TIM2_ETR/TIM4_CH3/TIM10_CH1/I2C1_SCL/CAN1_RX/SDIO_D4/DCMI_D6/EVENTOUT/[FT] 95
PB9/TIM2_CH2/TIM4_CH4/TIM11_CH1/I2C1_SDA/SPI2_NSS/I2S2_WS/SAI1_FS_B/CAN1_TX/SDIO_D5/DCMI_D7/EVENTOUT/[FT] 96
PB10/TIM2_CH3/I2C2_SCL/SPI2_SCK/I2S2_CK/SAI1_SCK_A/USART3_TX/OTG_HS_ULPI_D3/EVENTOUT/[FT] 46
PB11/TIM2_CH4/HRTIM_SCIN/LPTIM2_ETR/I2C2_SDA/DFSDM1_CKIN7/USART3_RX/OTG_HS_ULPI_D4/ETH_MII_TX_EN/ETH_RMII_TX_EN/LCD_G5/[FT_f] 47
PB12/TIM1_BKIN/I2C2_SMBA/SPI2_NSS/I2S2_WS/SAI1_SCK_B/USART3_CK/CAN2_RX/OTG_HS_ULPI_D5/OTG_HS_ID/EVENTOUT/[FT] 51

D D

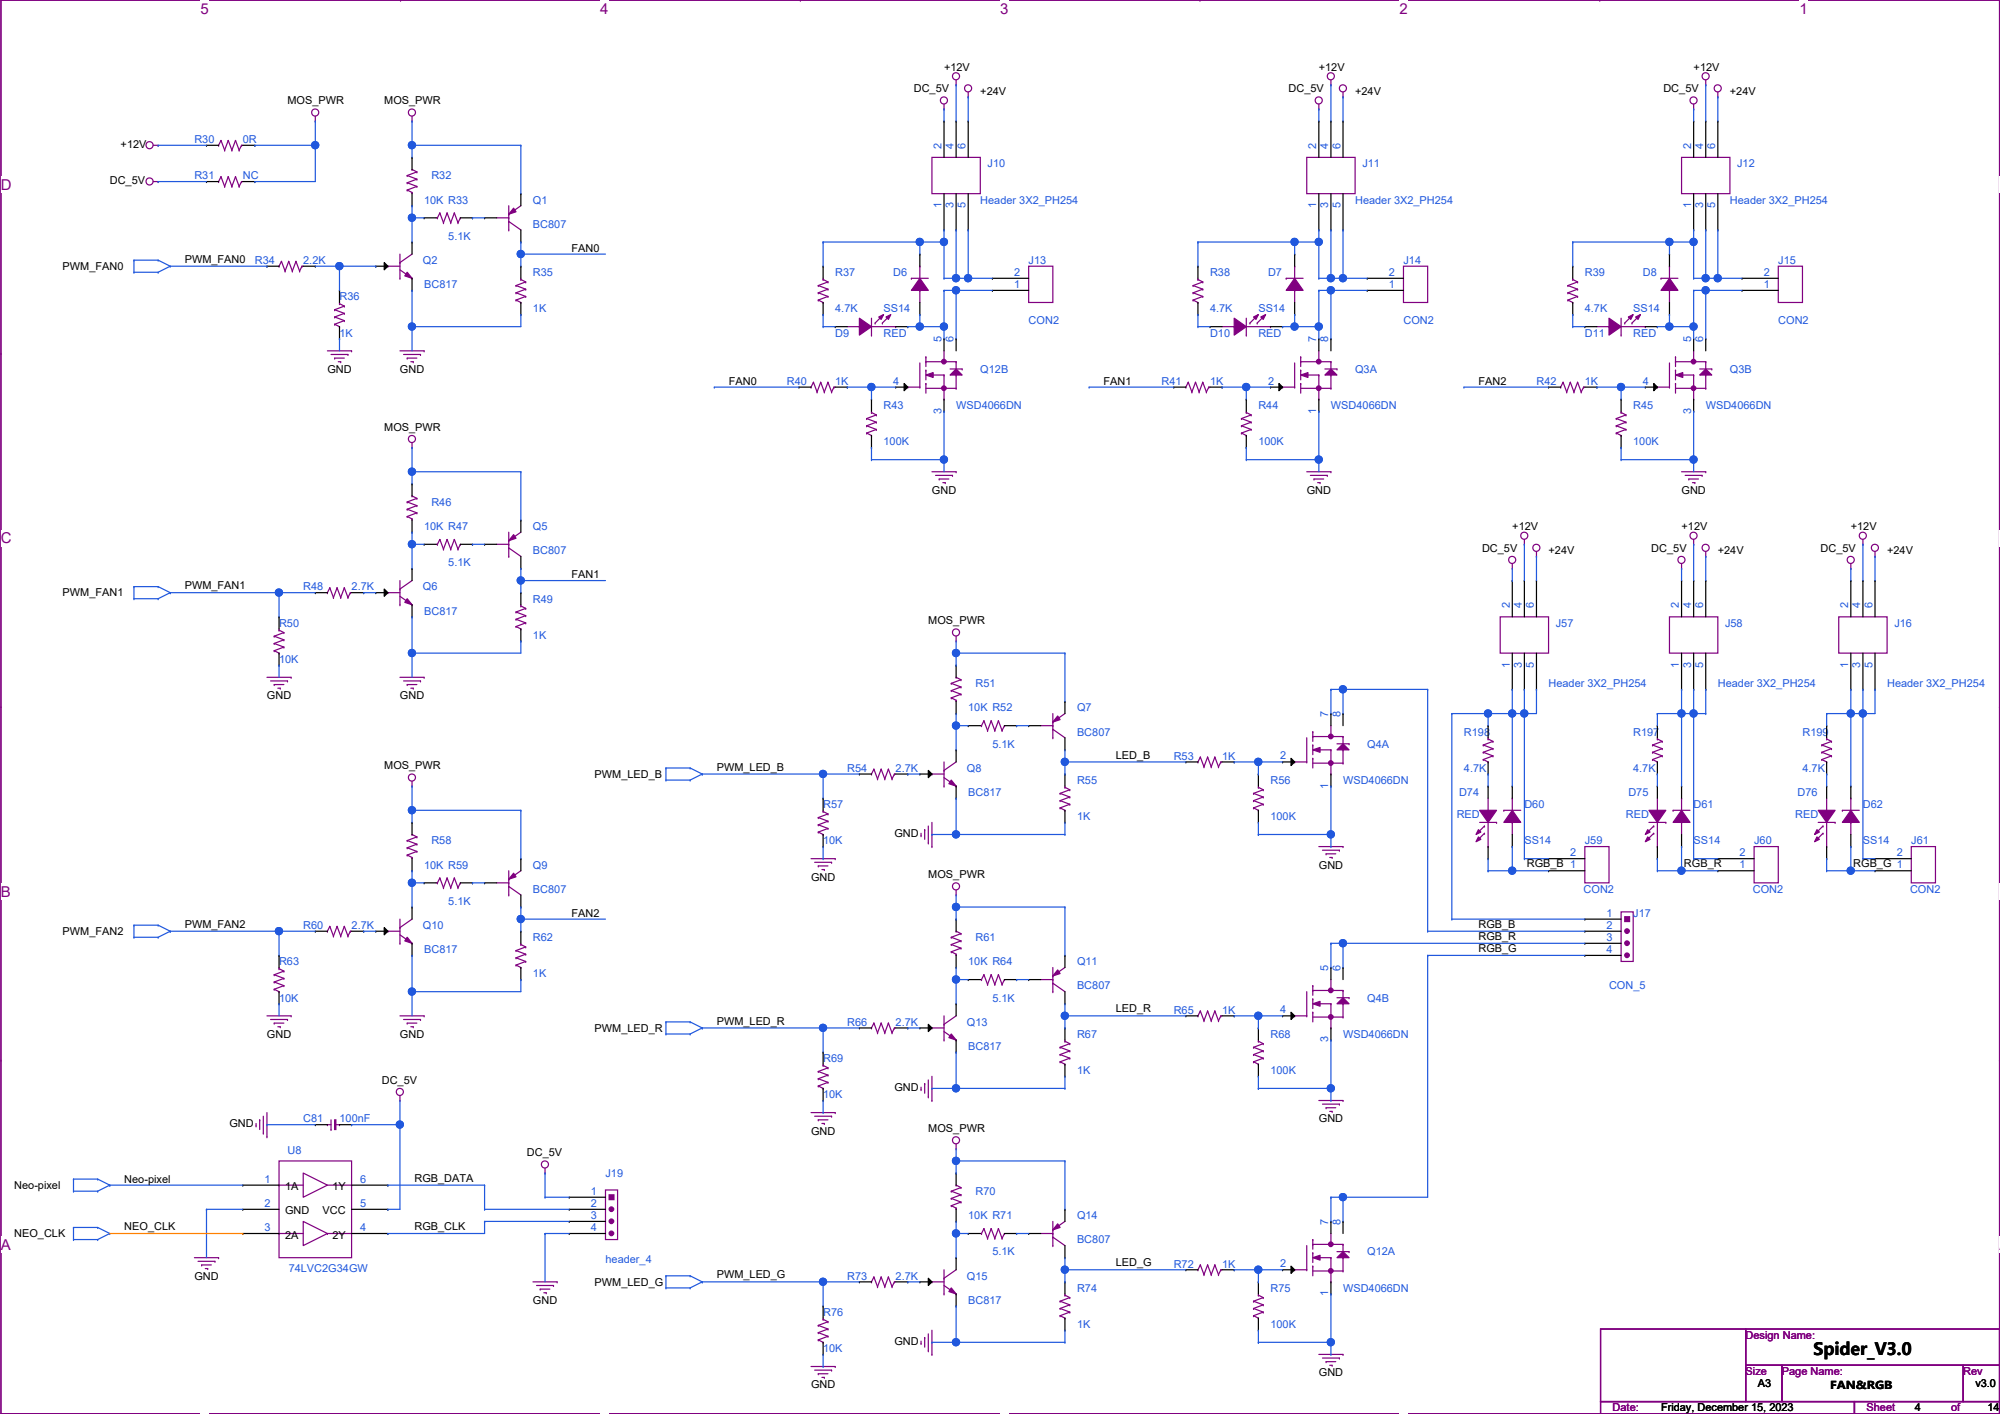
[picture p60: page 4]

D D

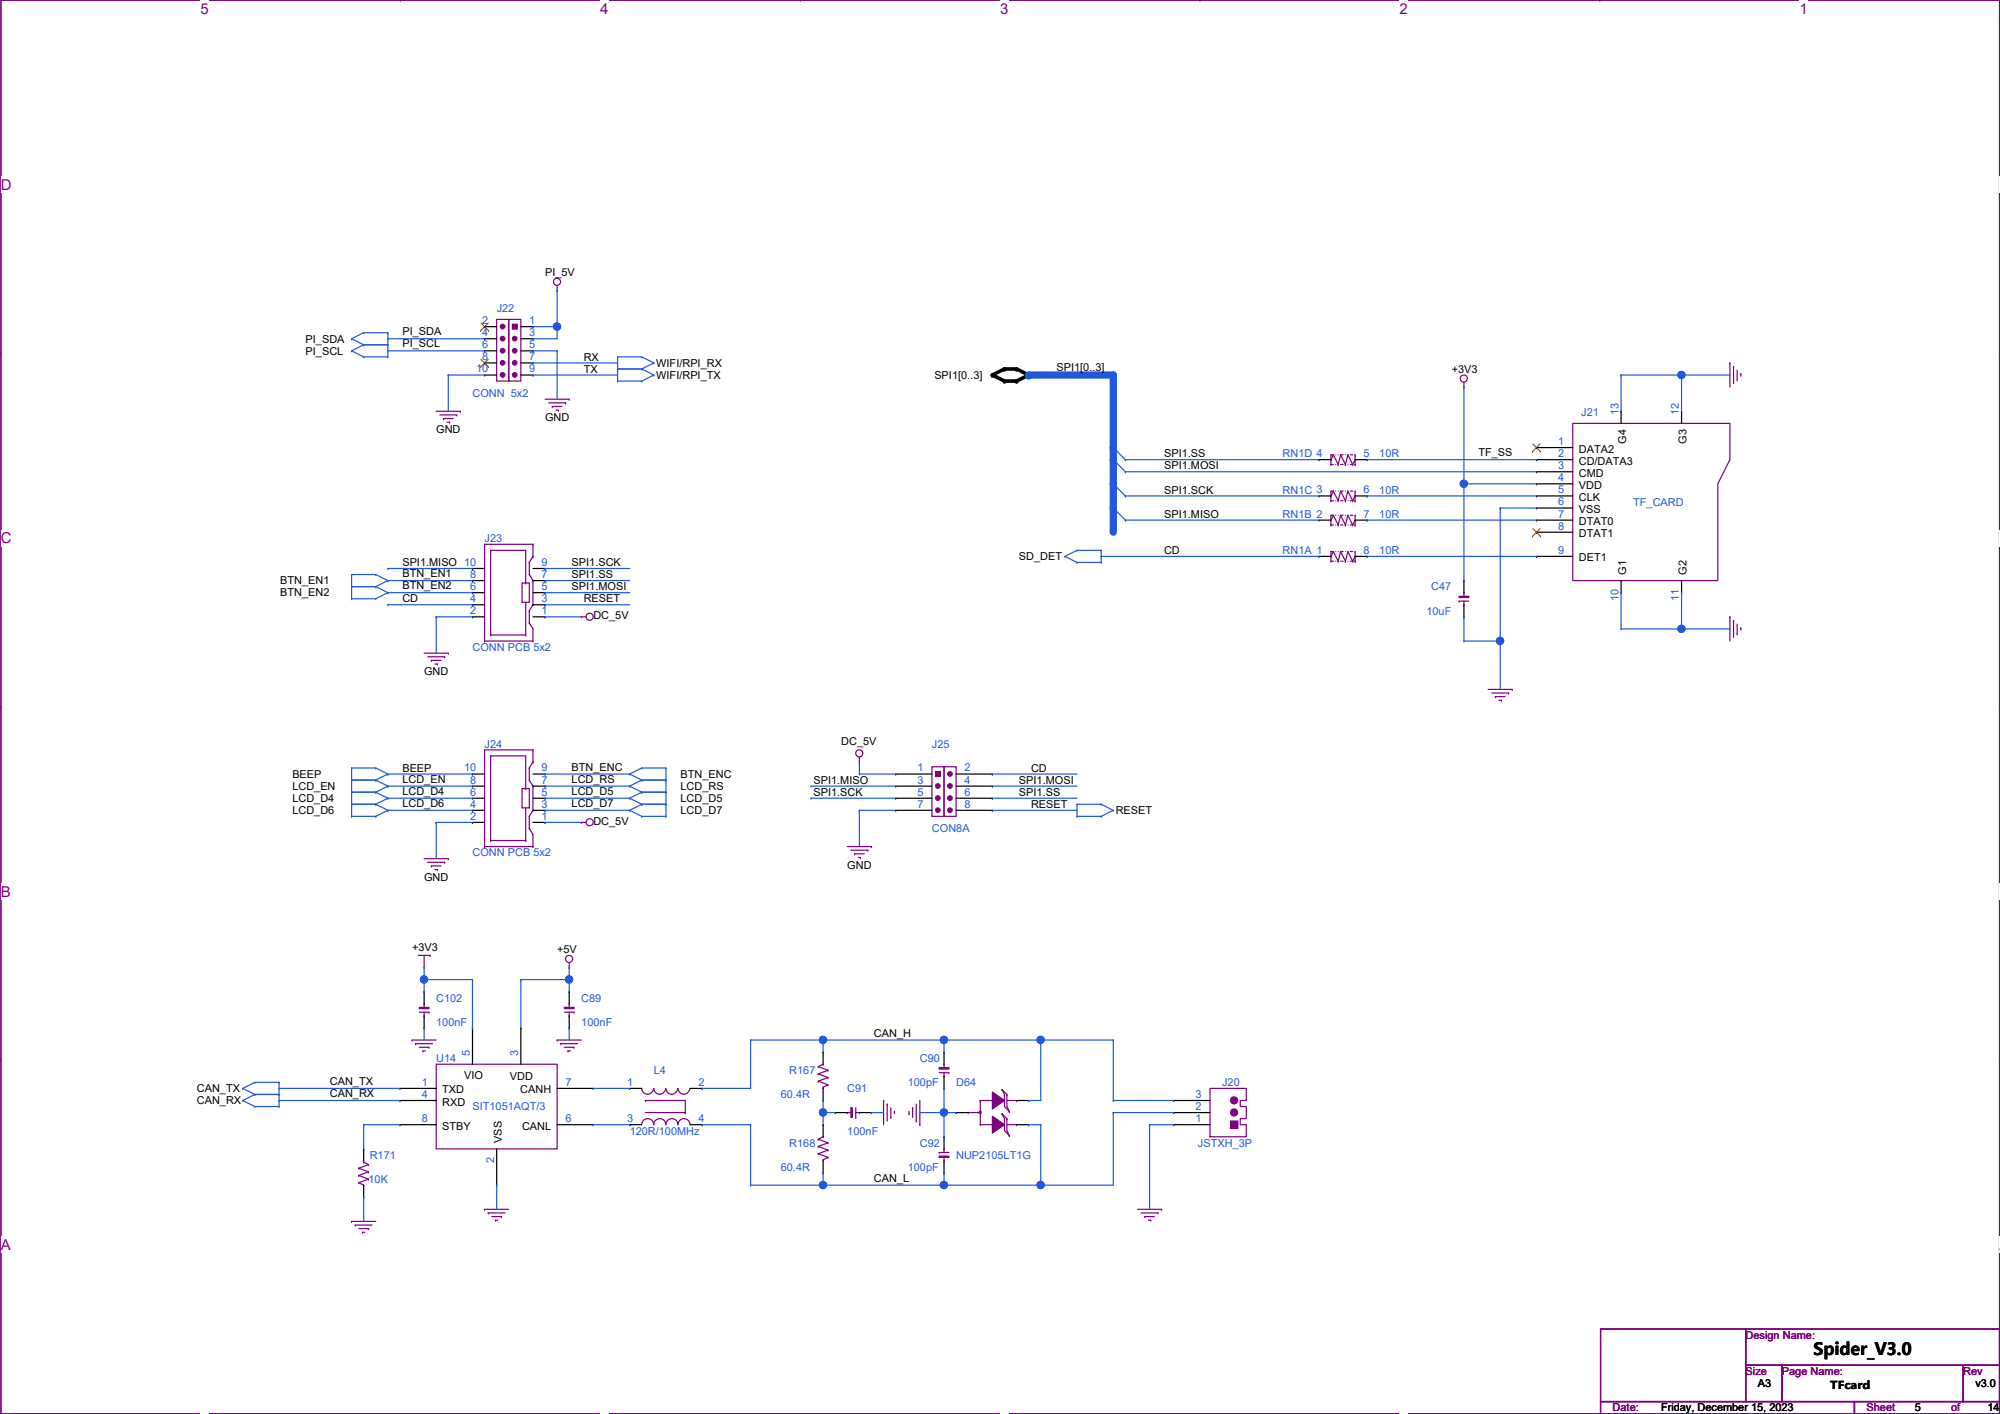
[picture p61: page 5]

D D

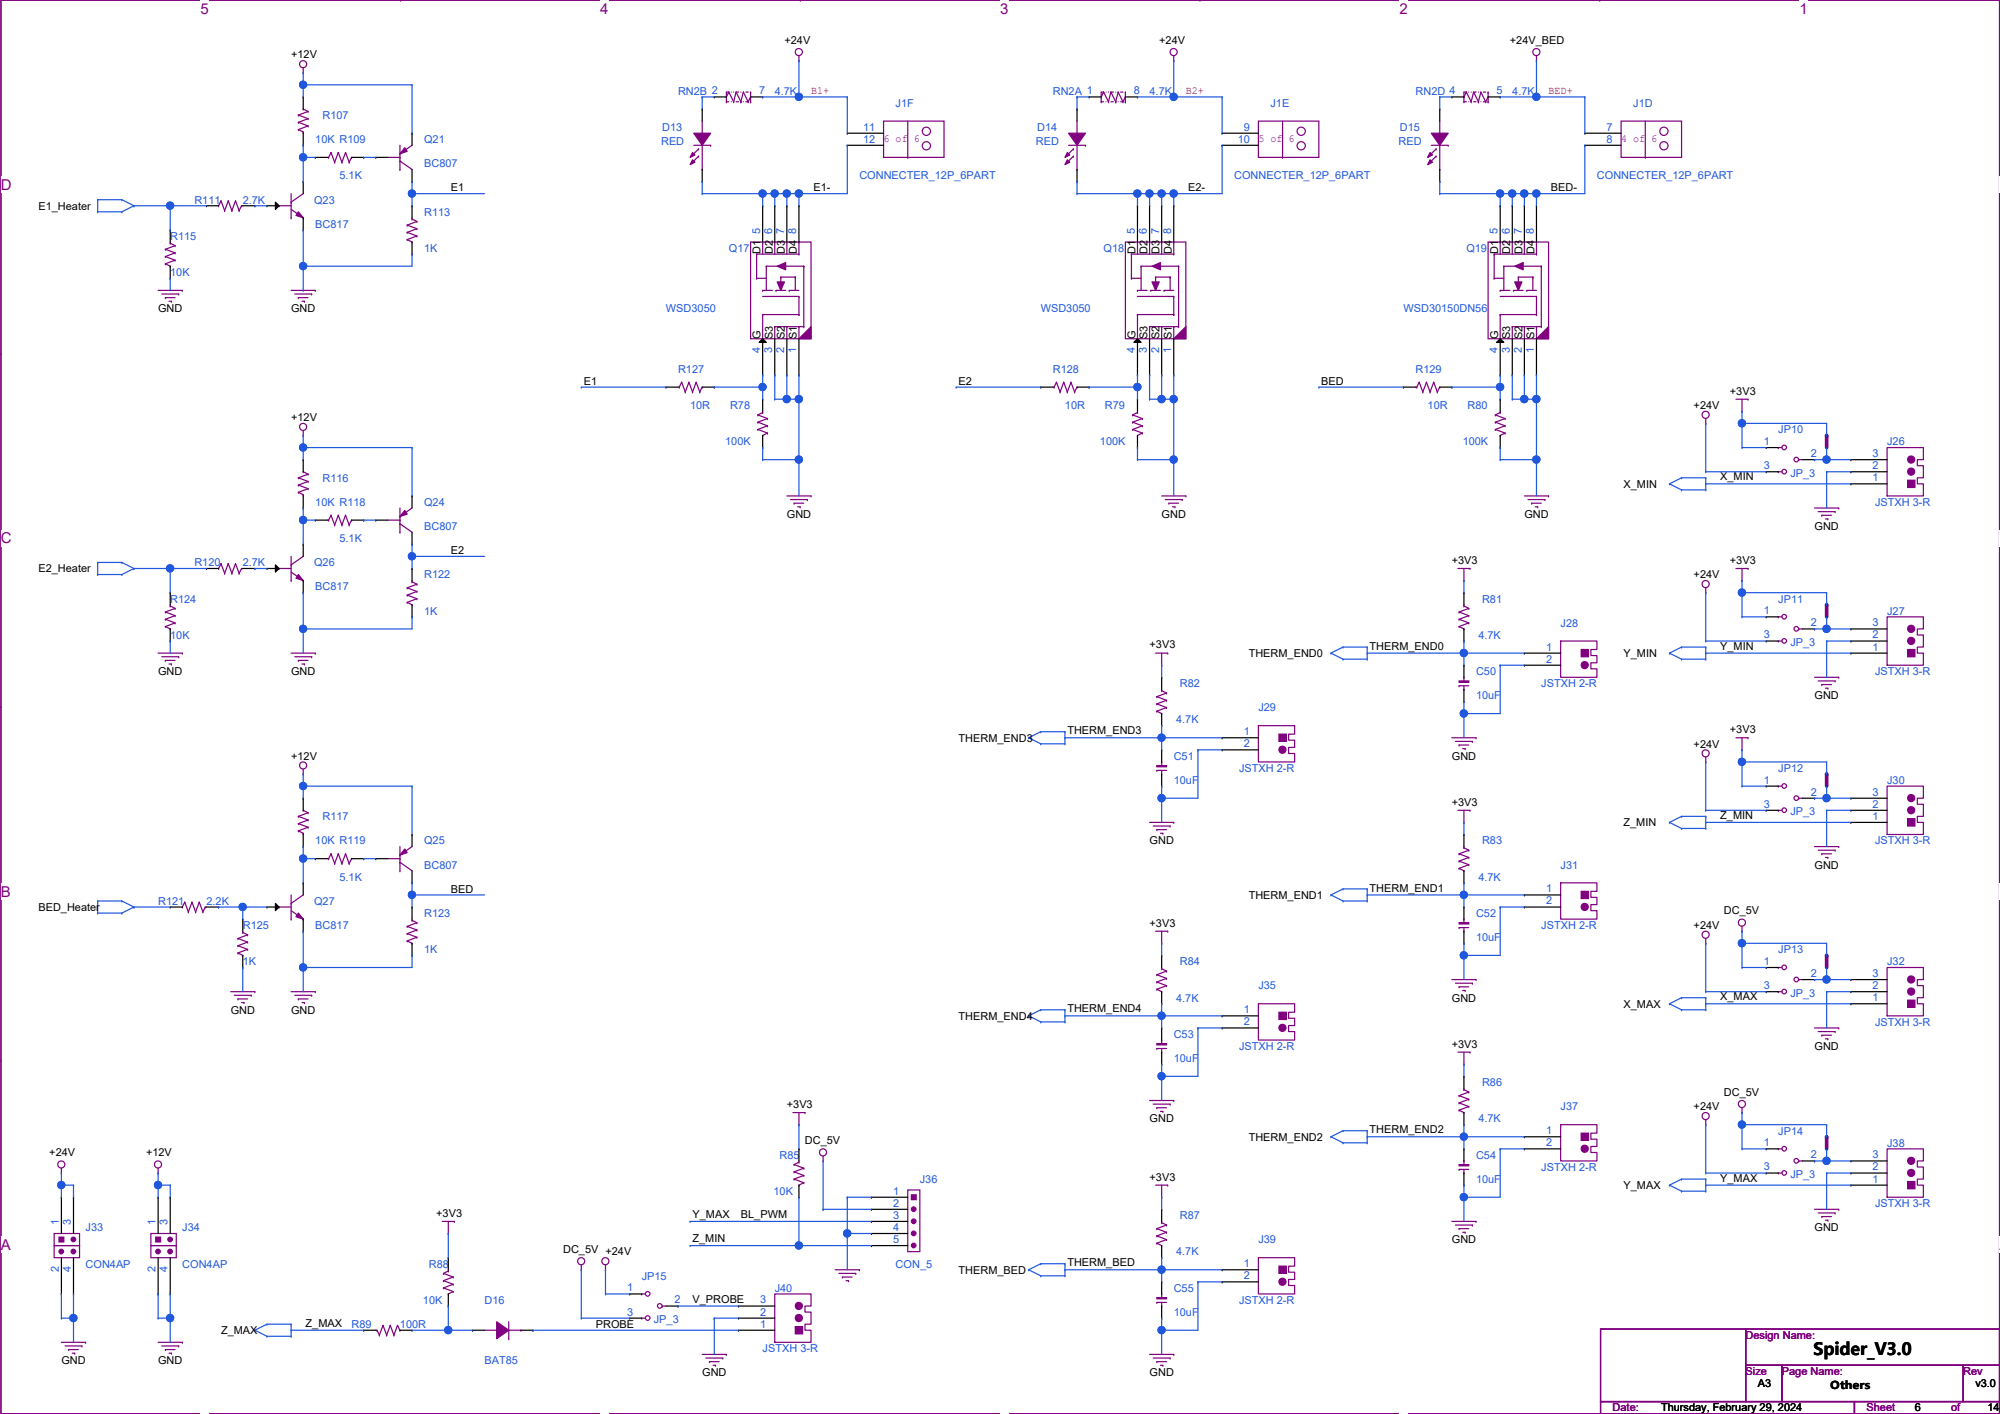
[picture p62: page 6]

D D

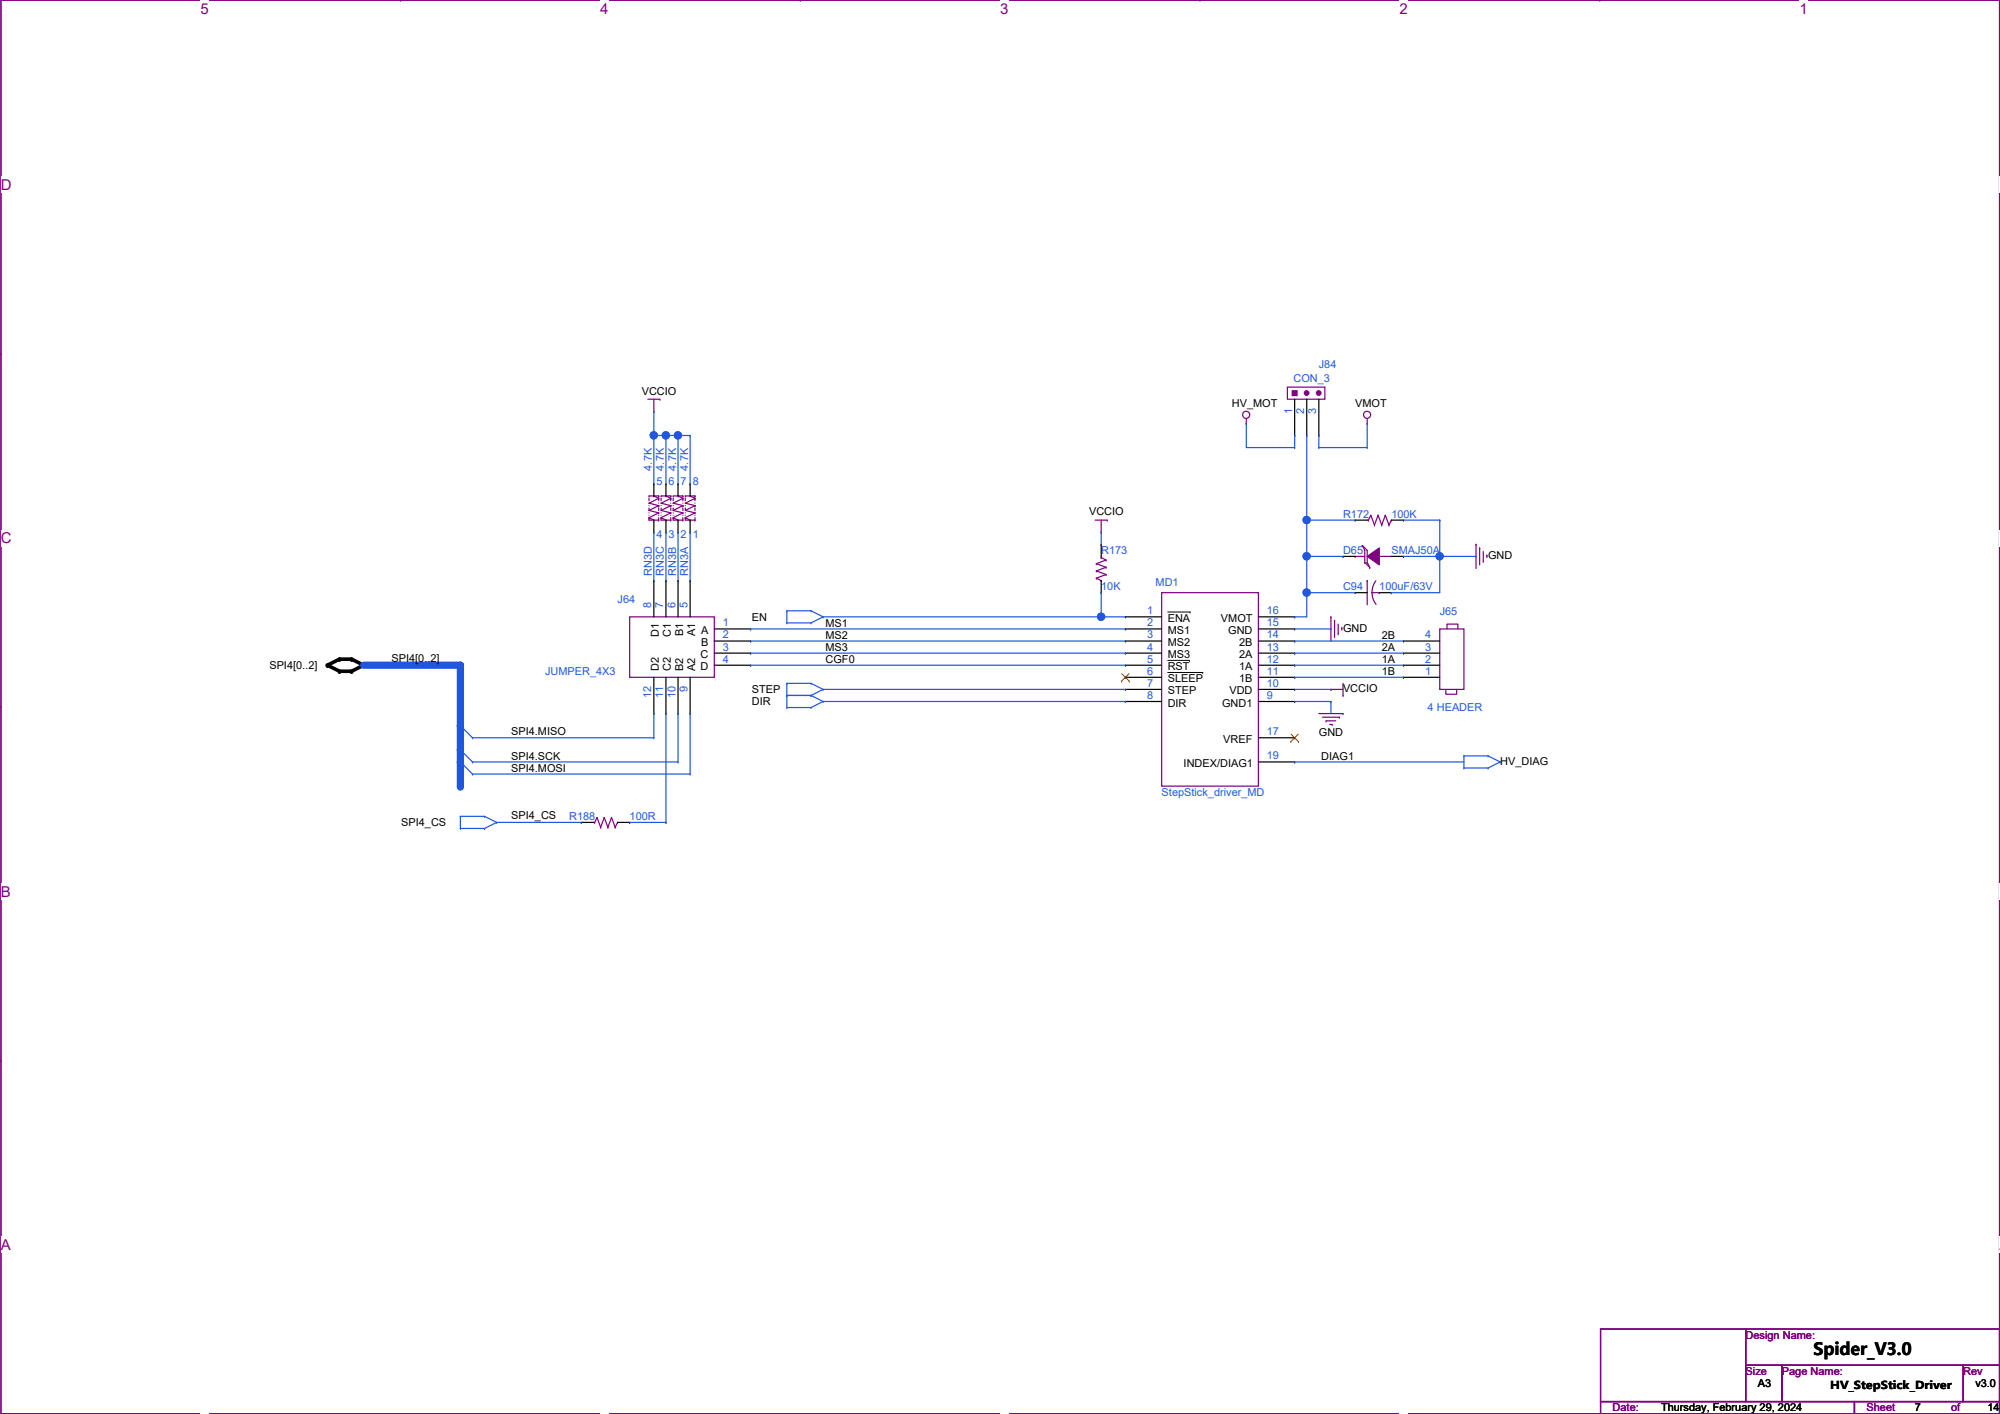
[picture p63: page 7]

D D

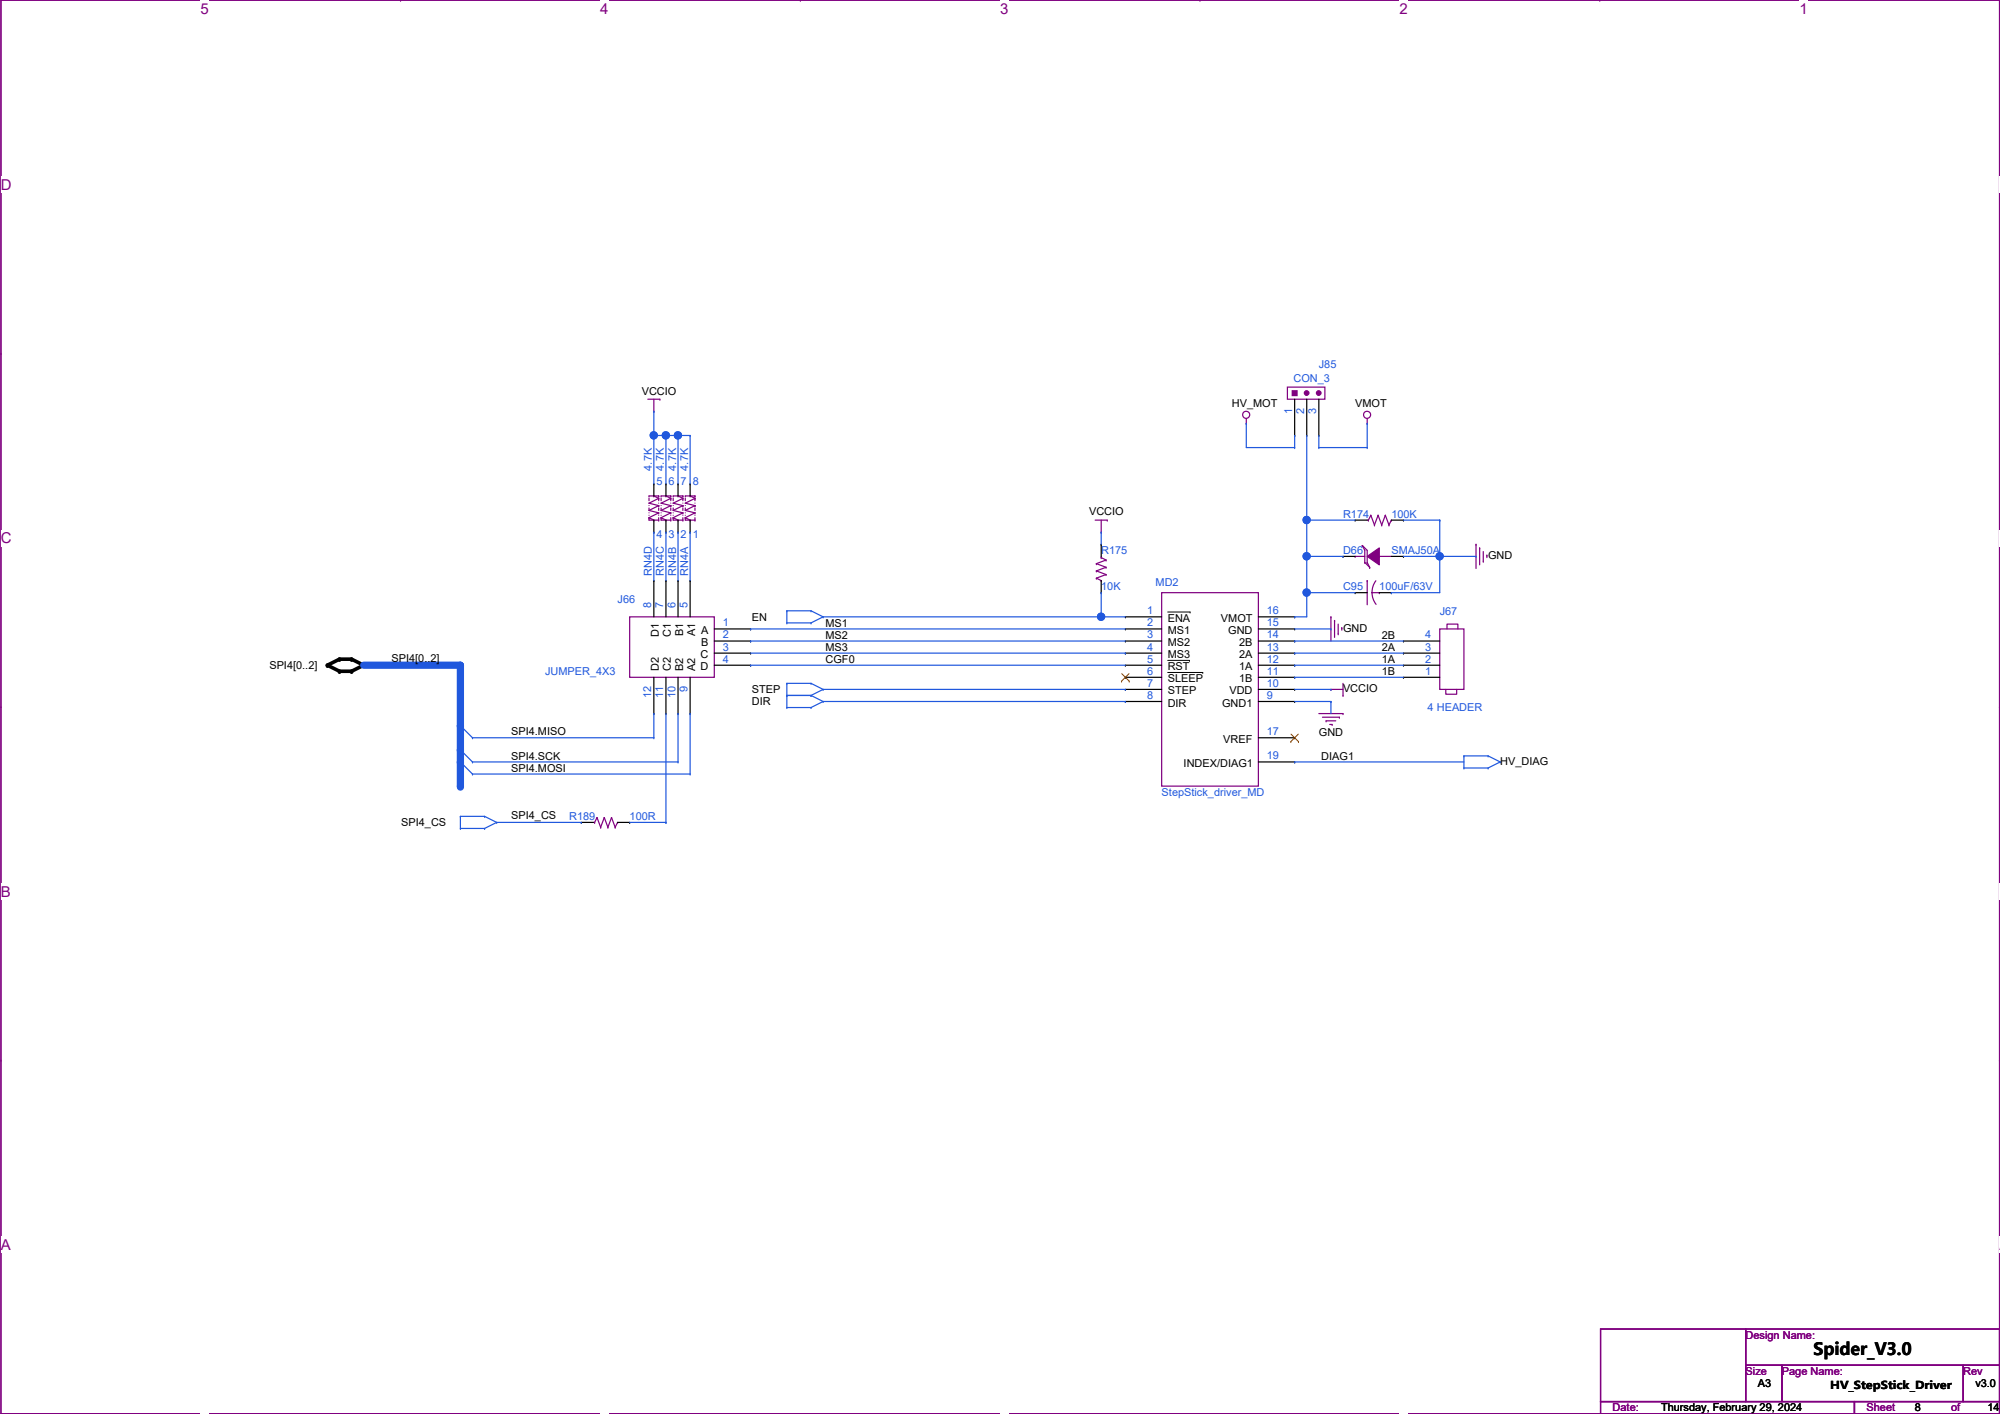
[picture p64: page 8]

D D

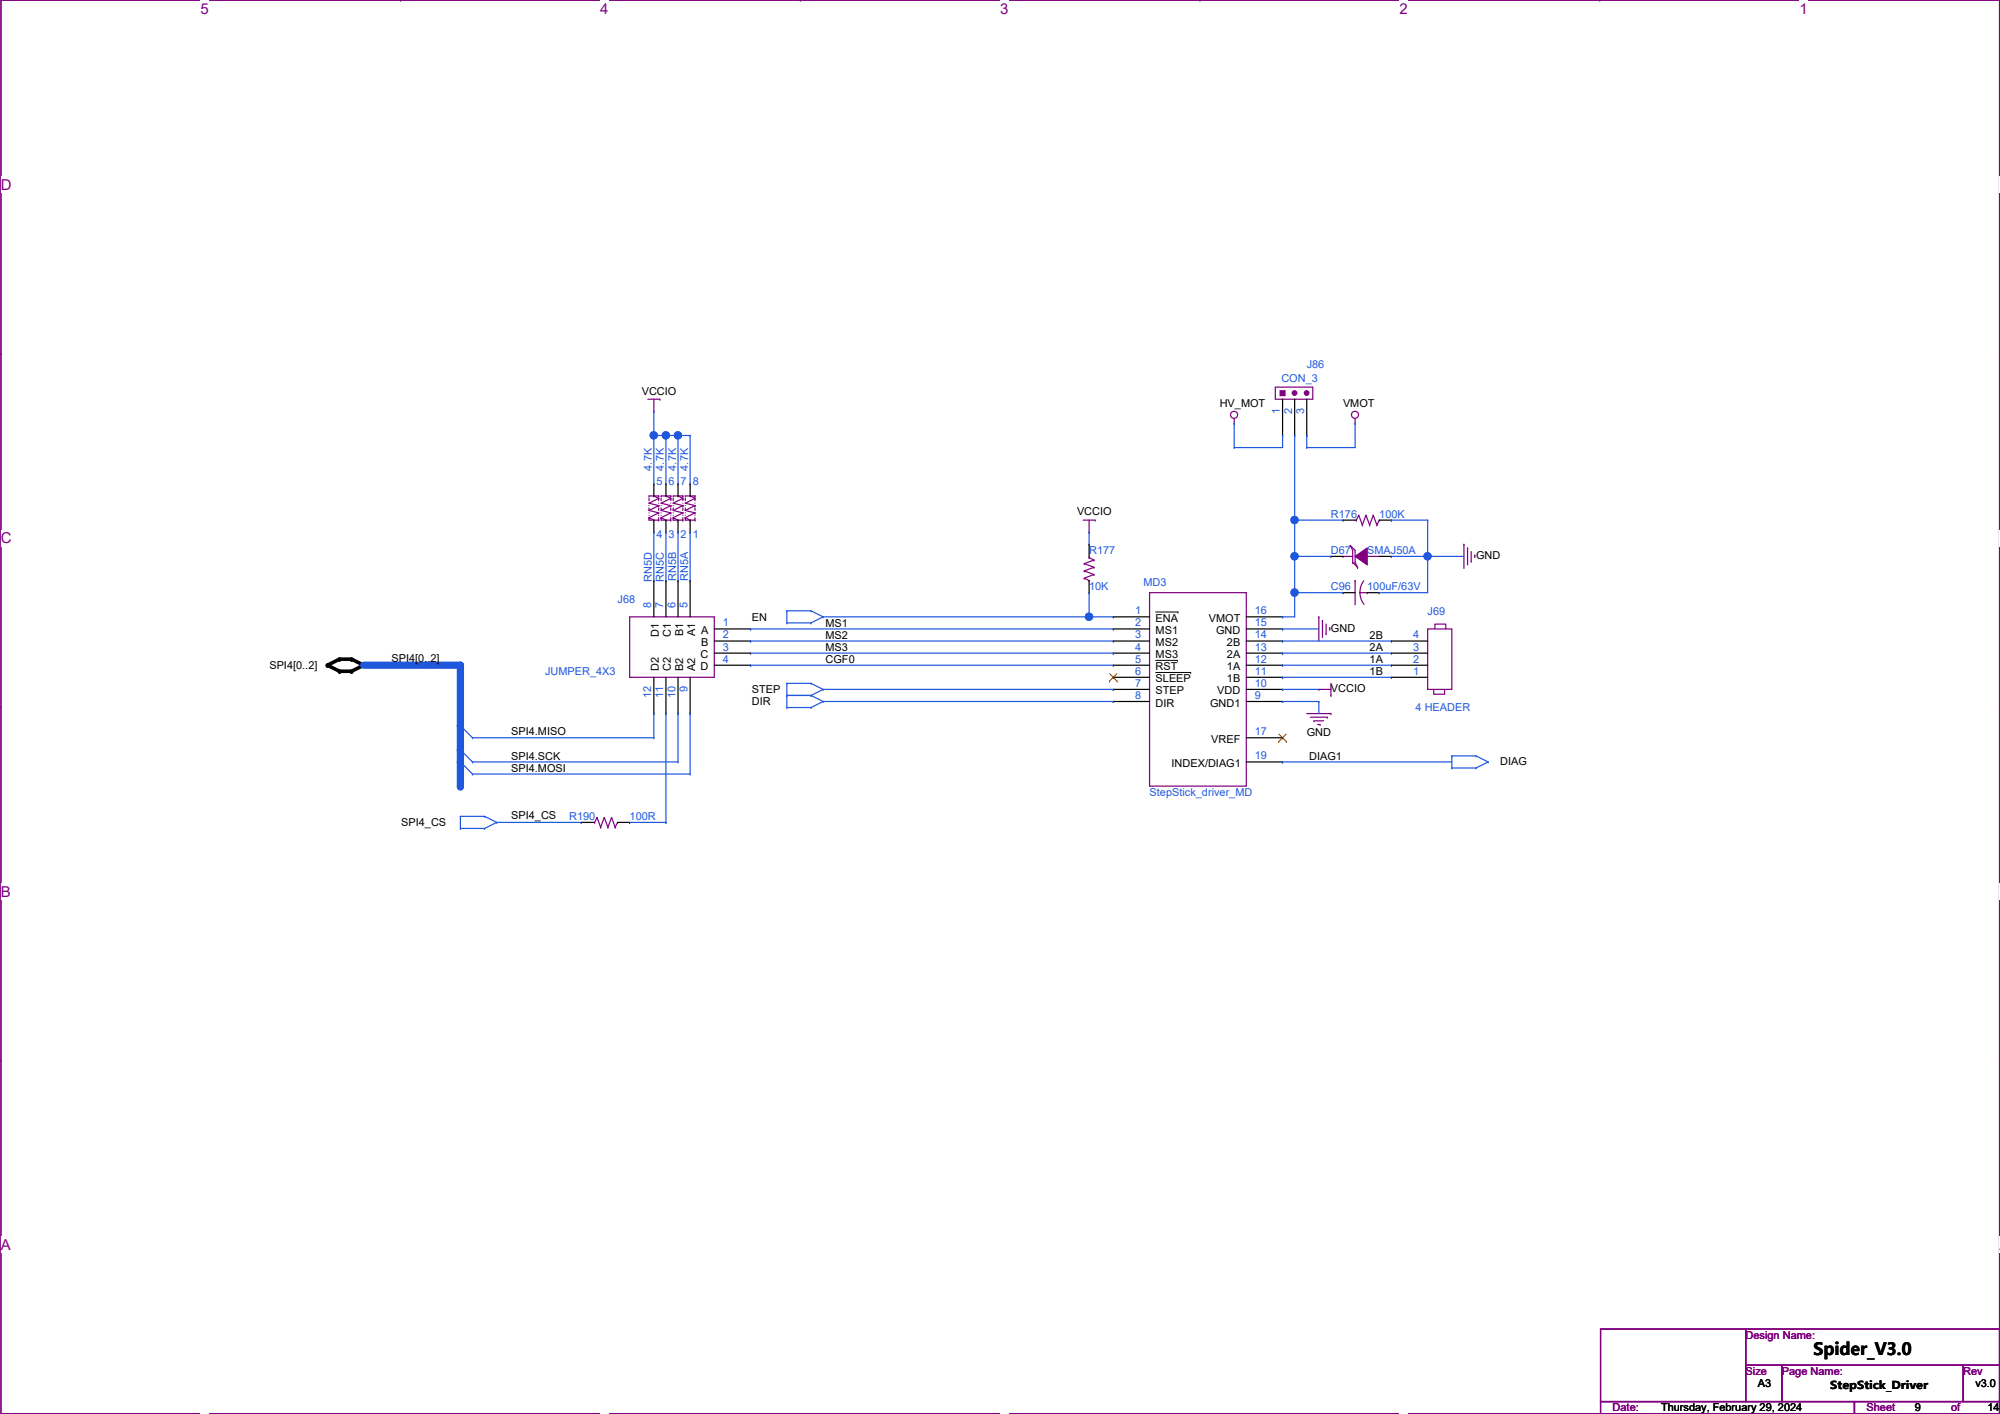
[picture p65: page 9]

D D

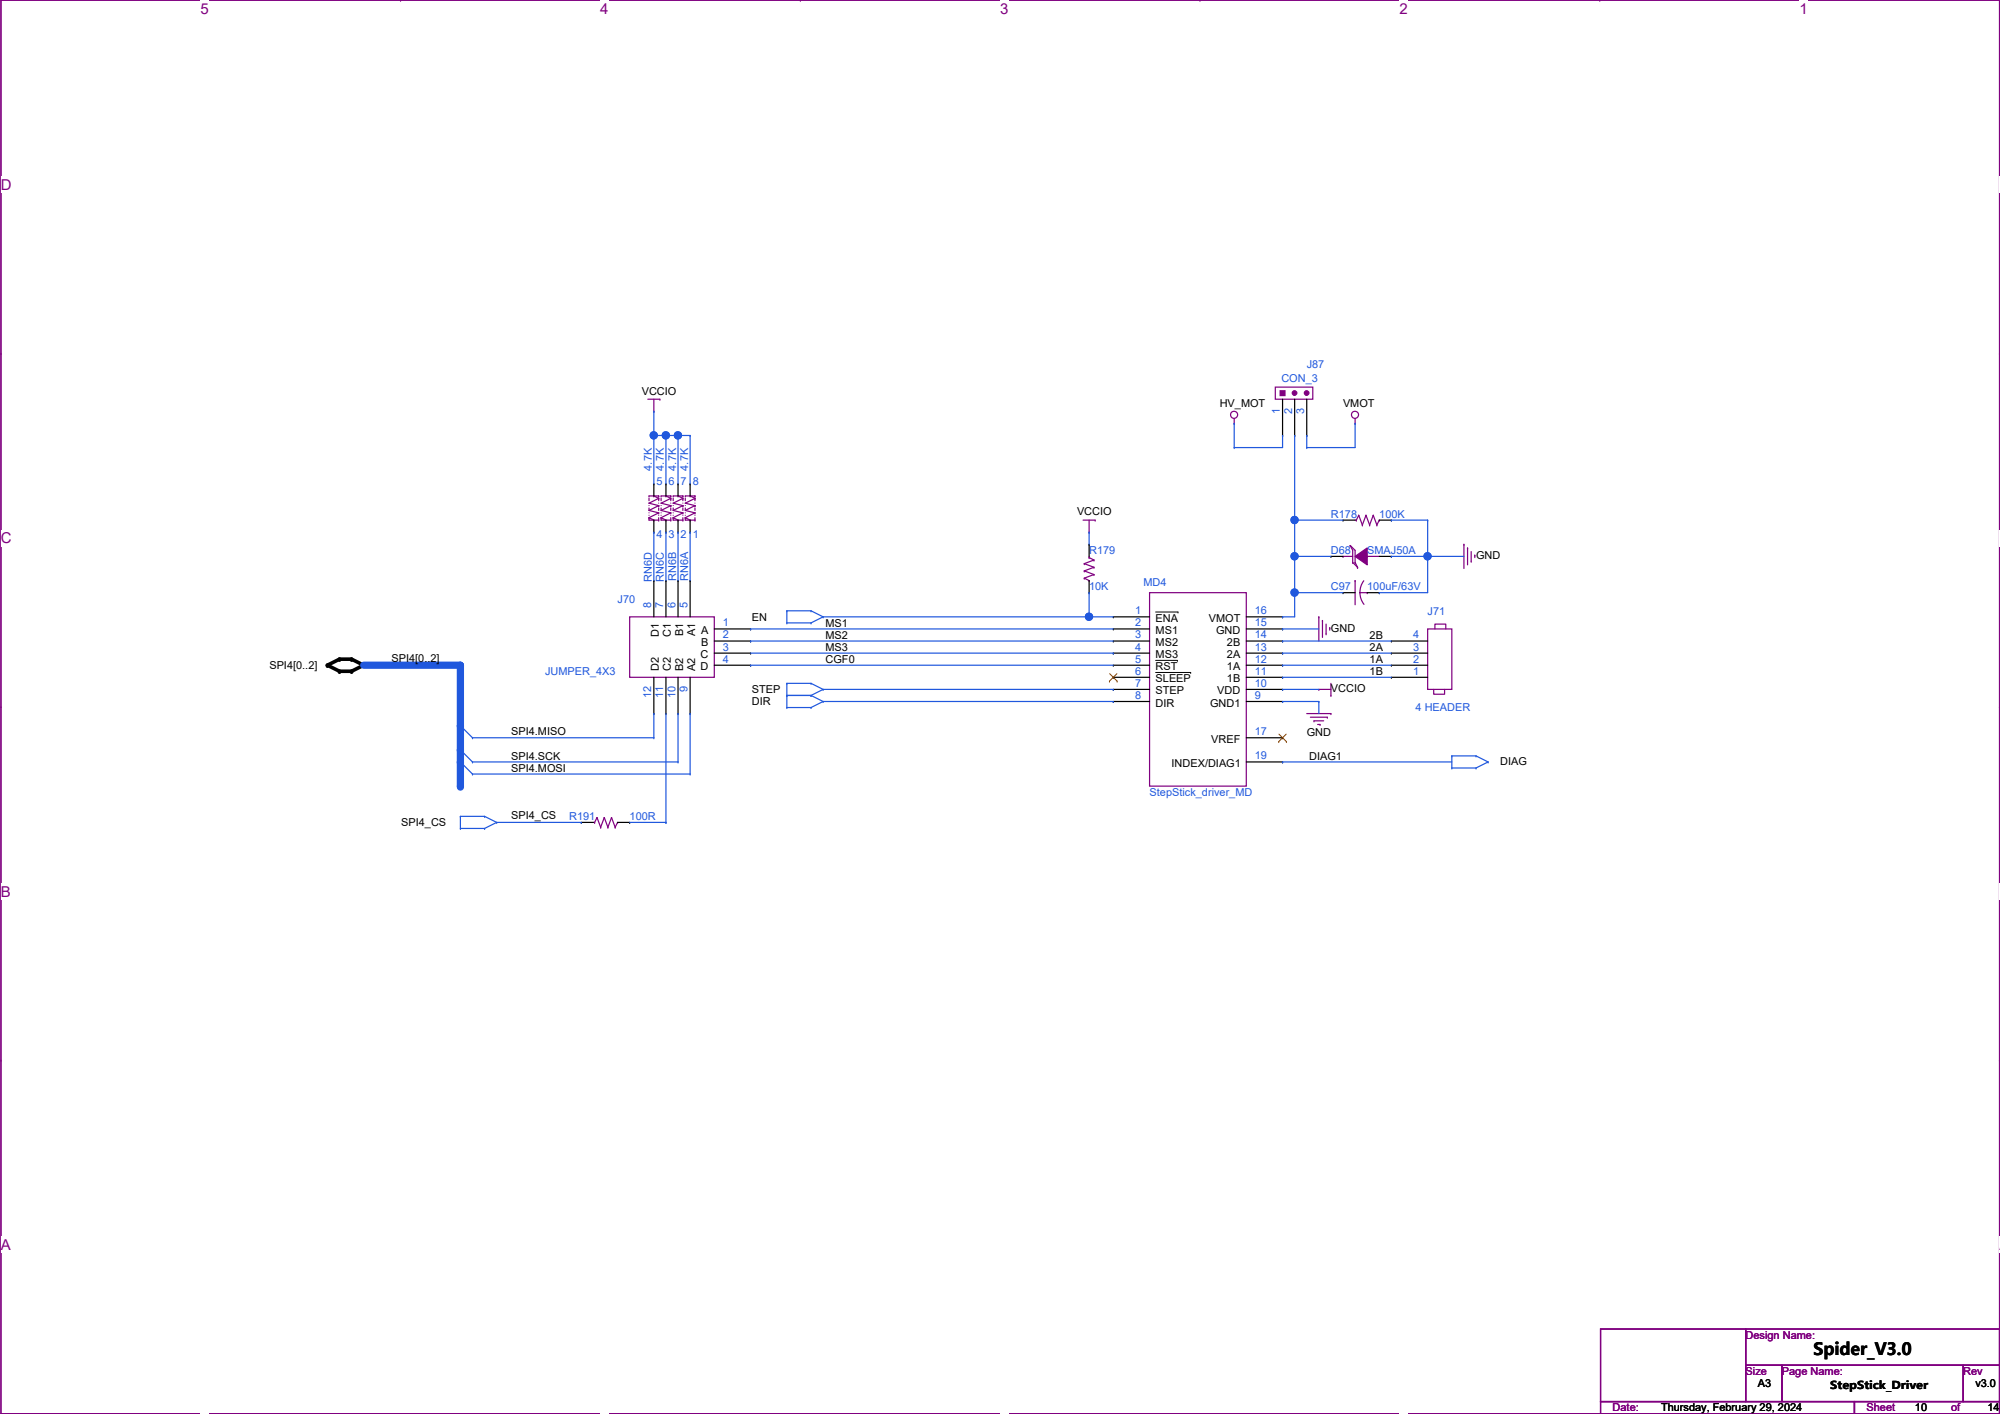
[picture p66: page 10]

D D

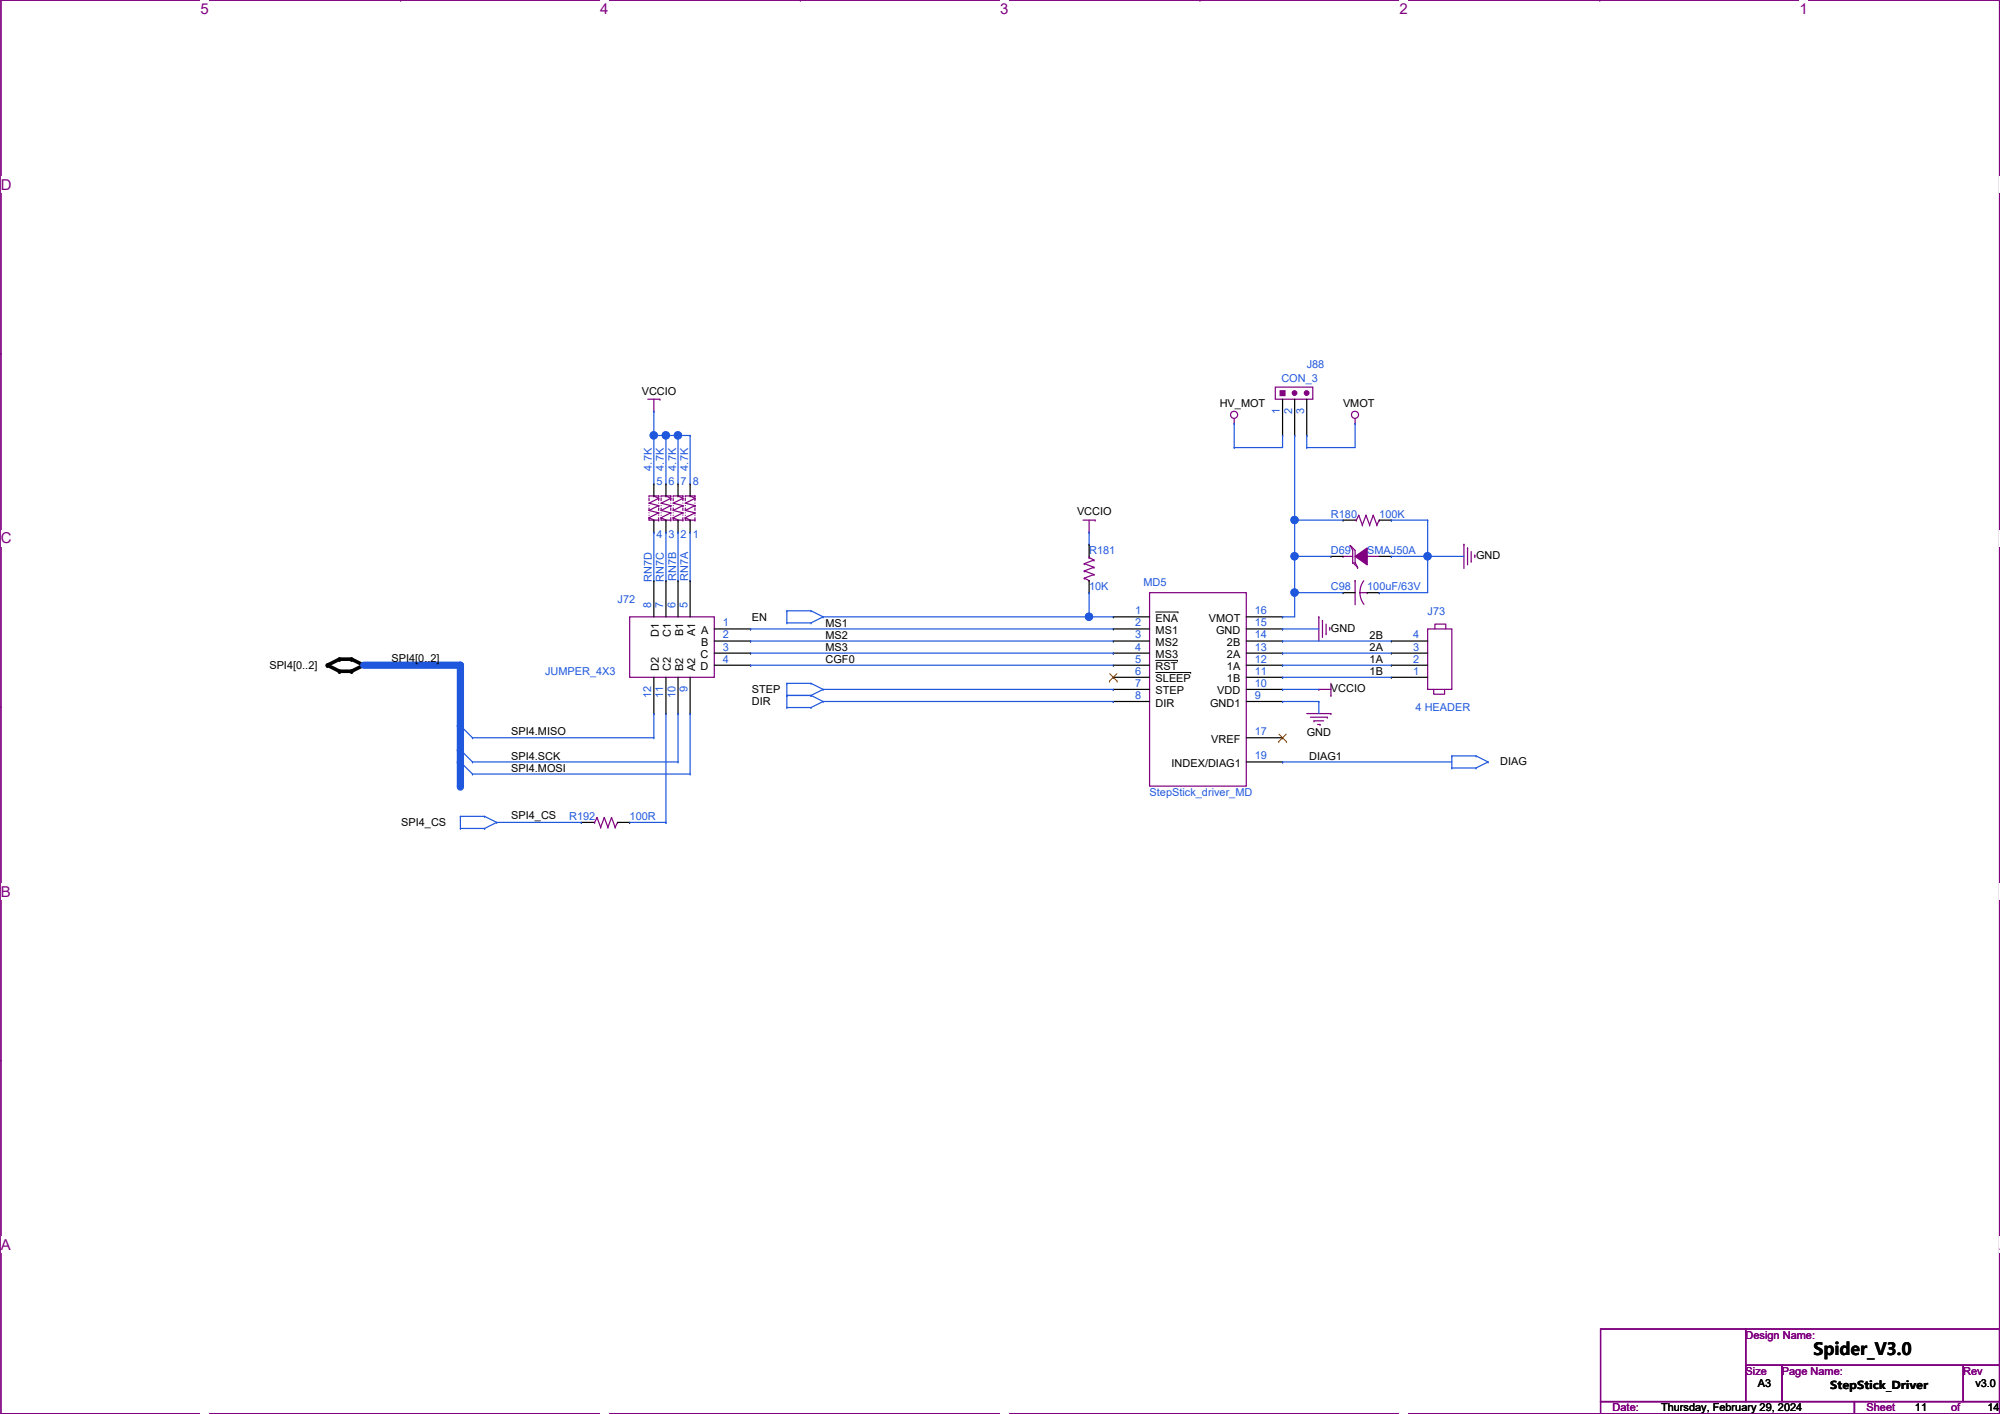
[picture p67: page 11]

D D

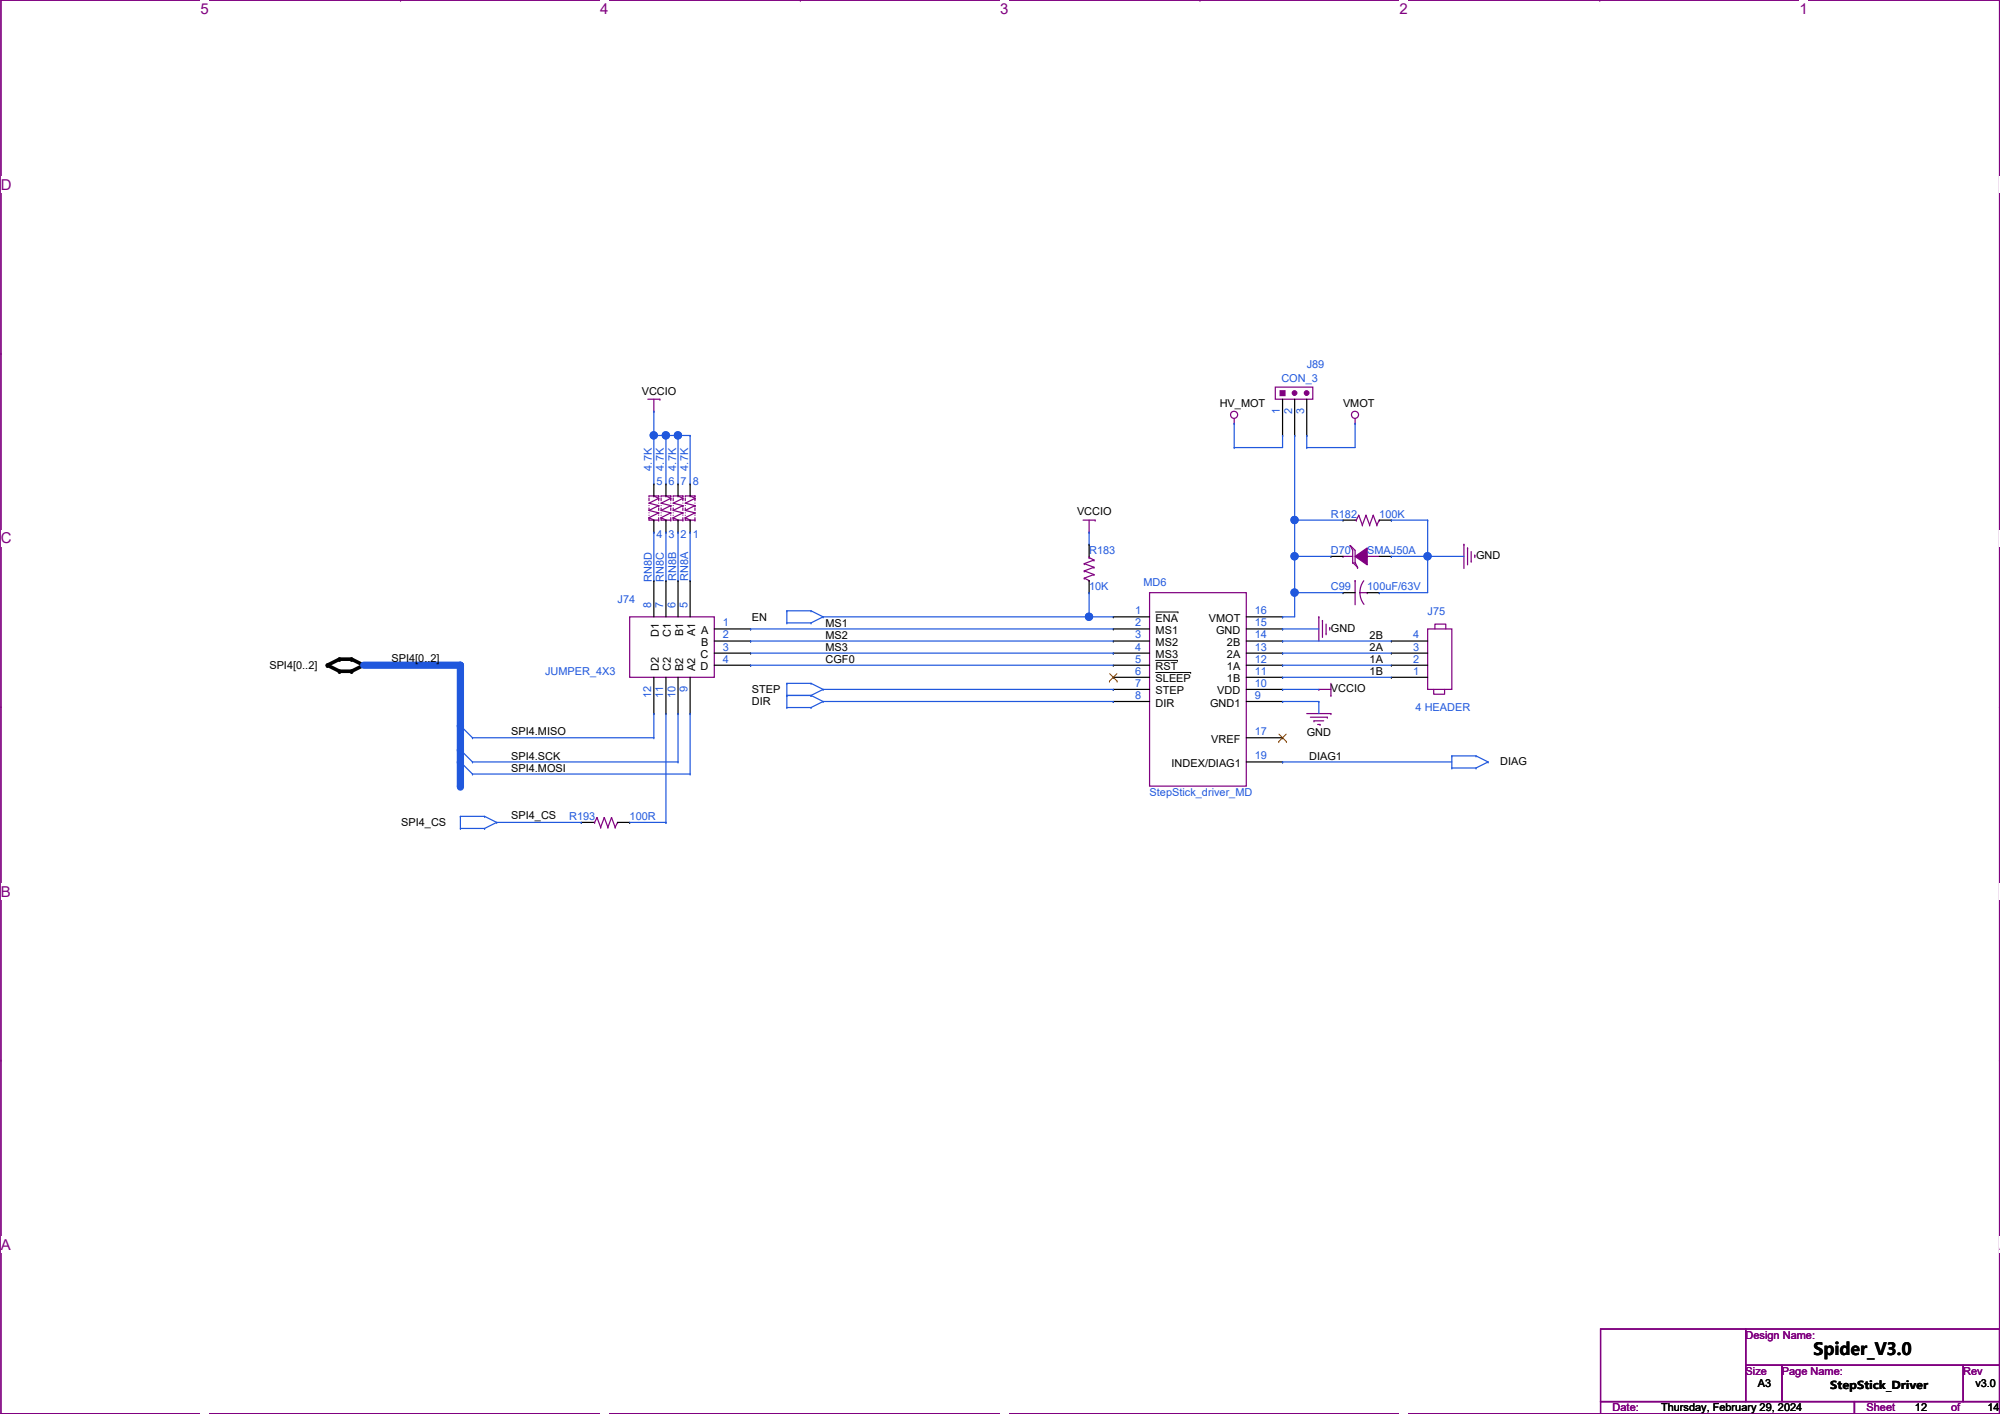
[picture p68: page 12]

D D

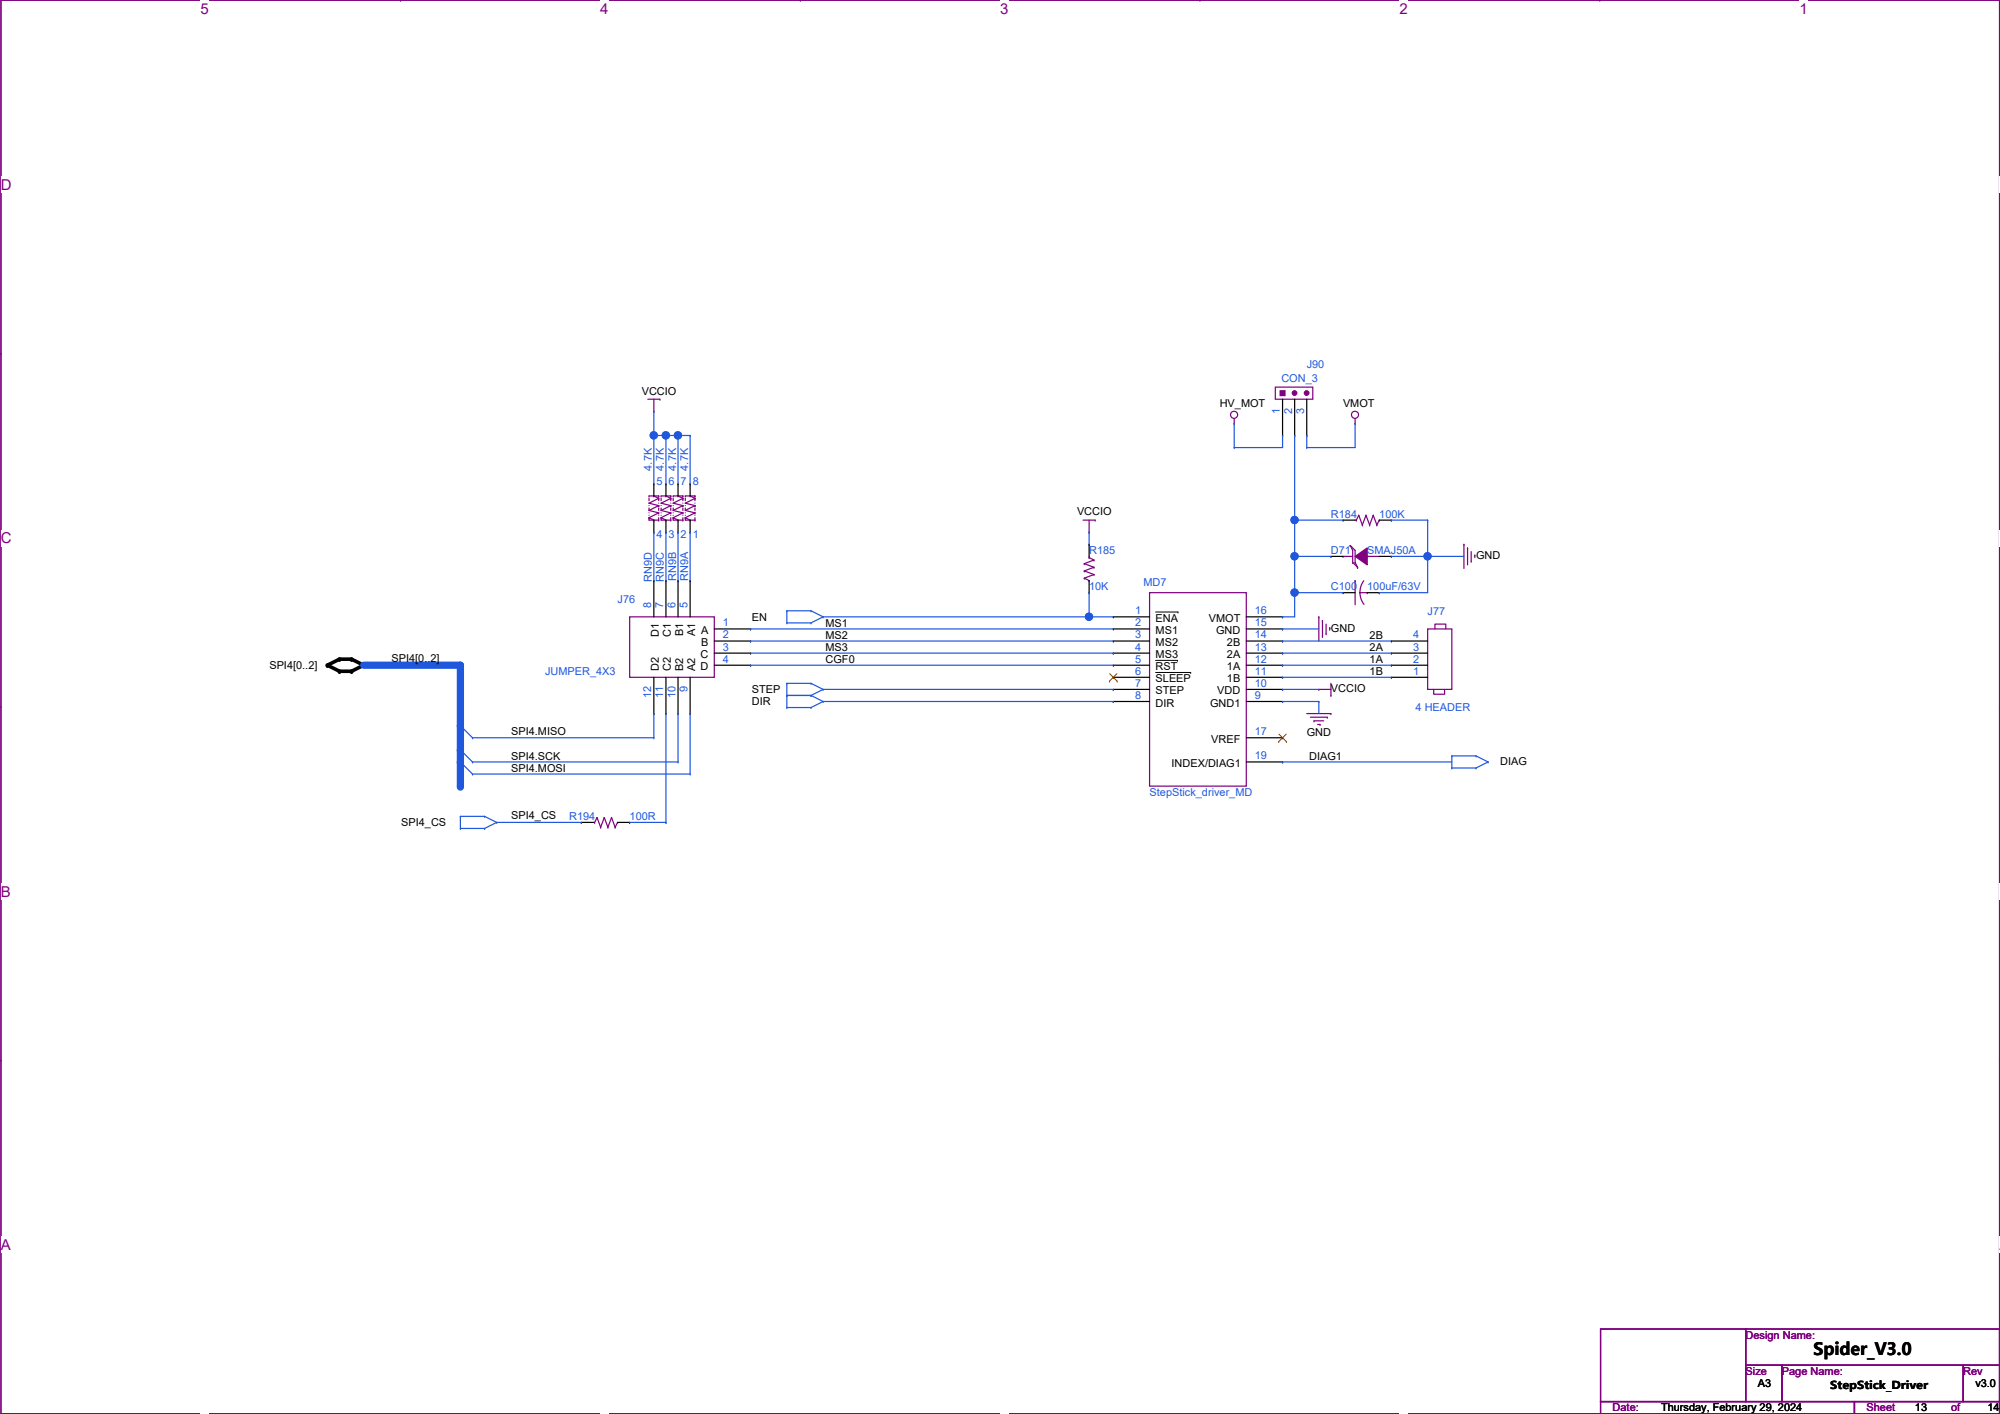
[picture p69: page 13]

D D

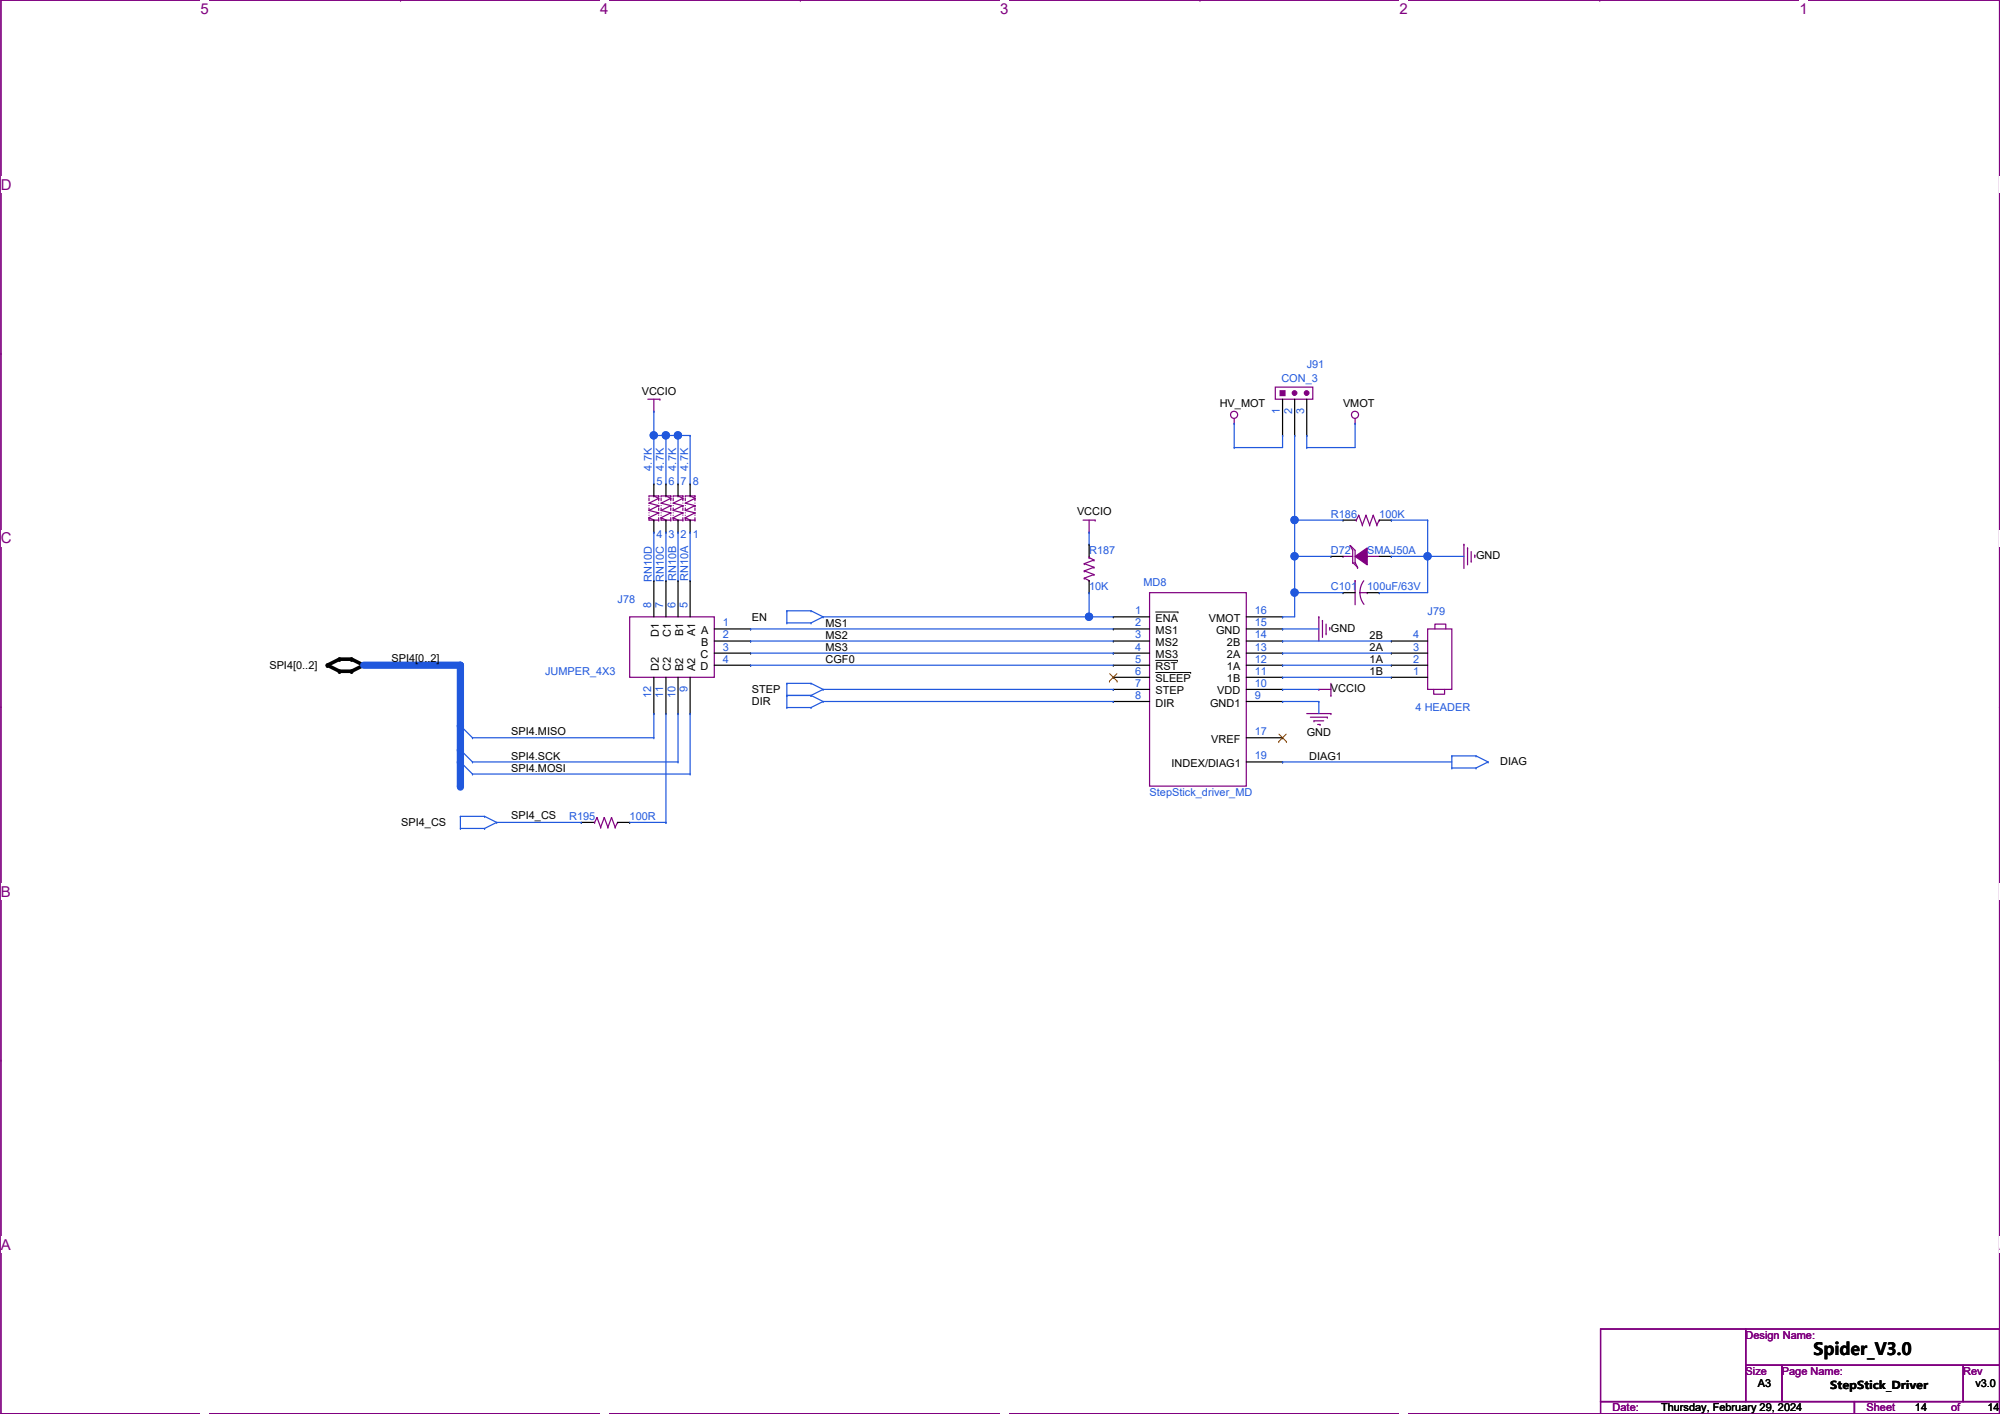
[picture p70: page 14]
