FYSETC/FYSETC-SPIDER/hardware/V3.0/spider_V3.0_sch.pdf

5 | 4 | 3 | 2 | 1

D

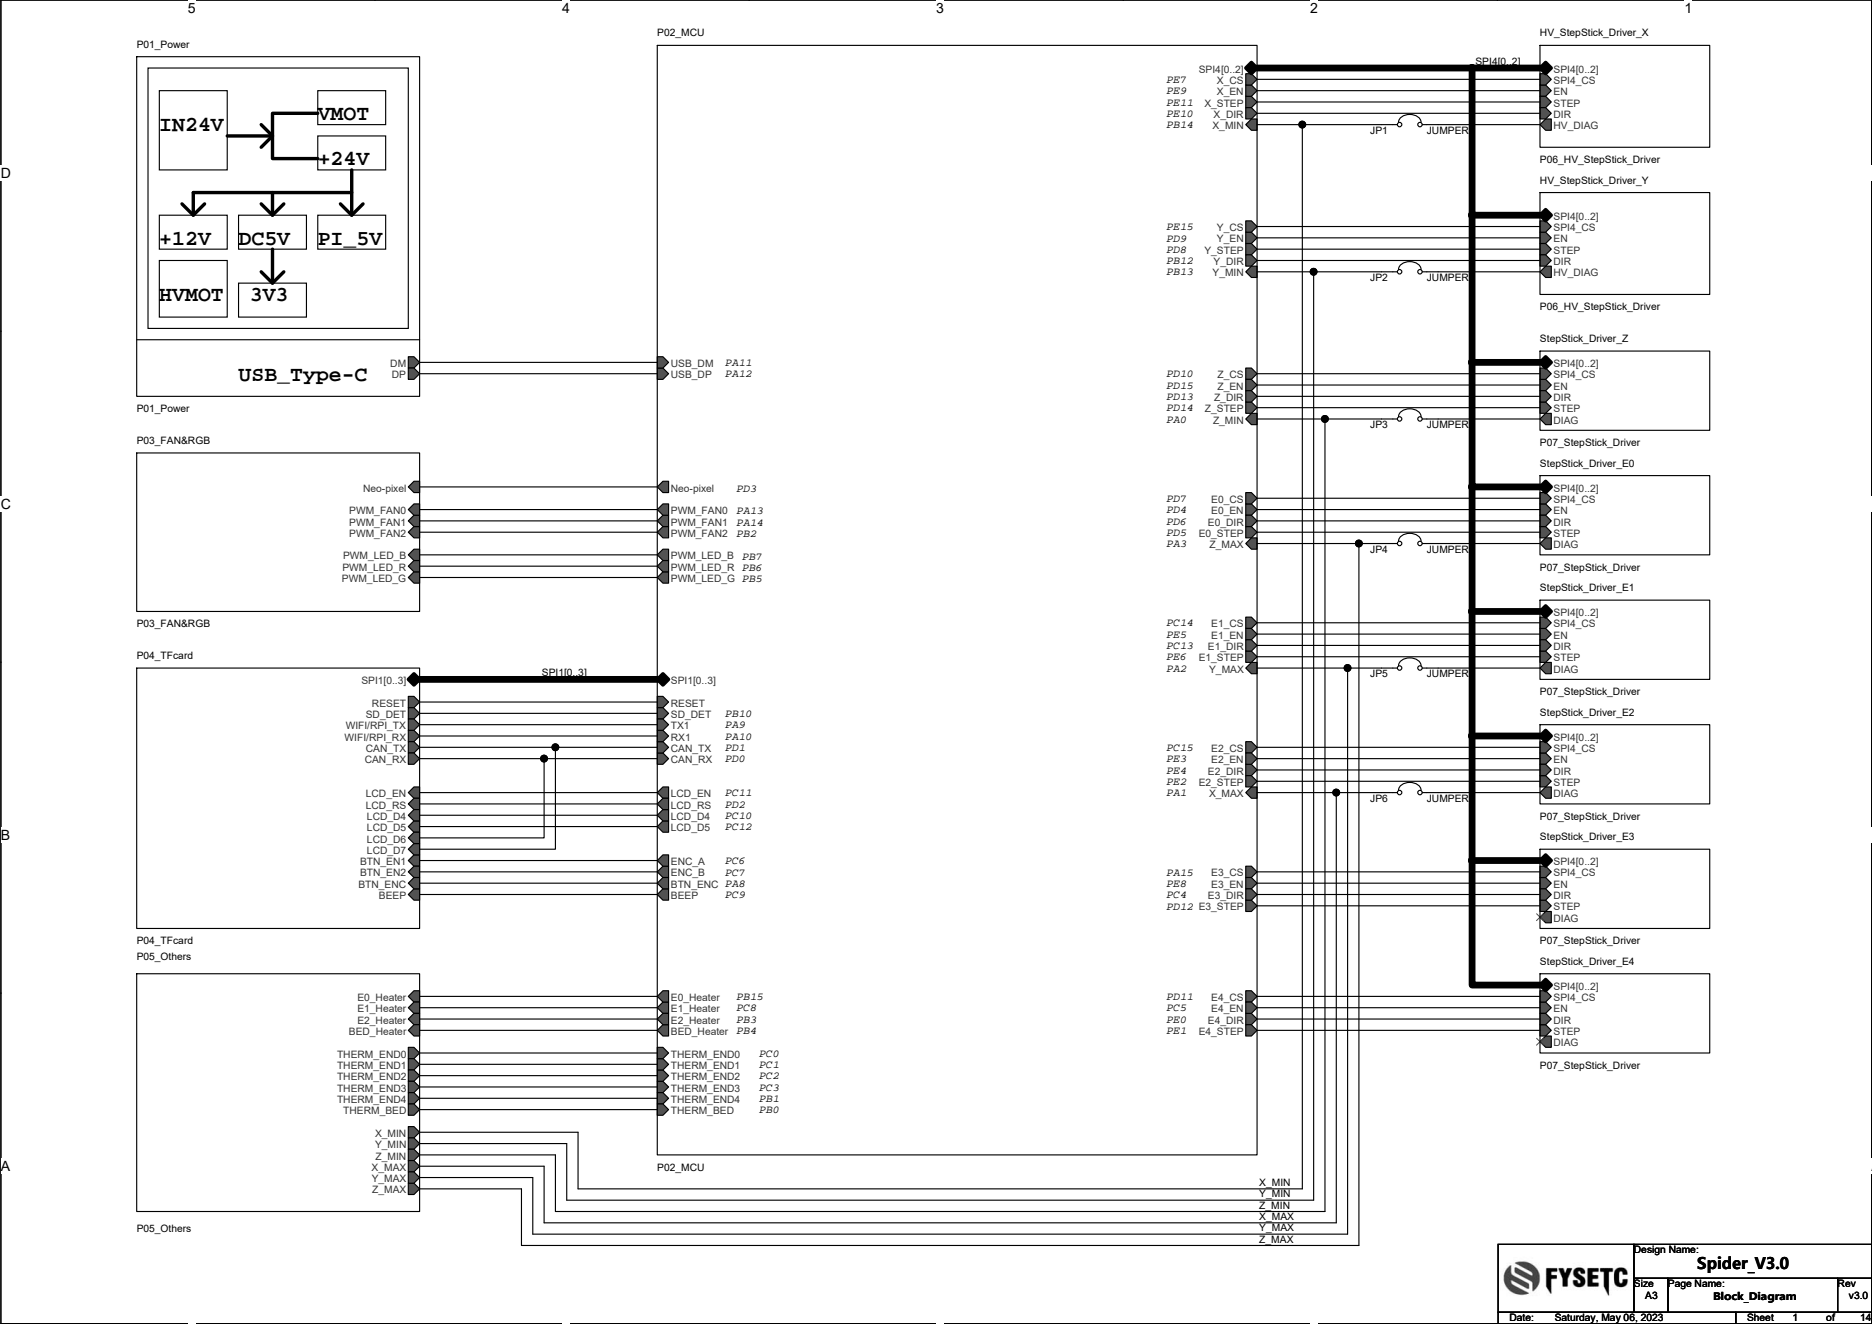
[picture p71: page 1]
VMOT; HVMOT; USB_Type-C; P04_TFcard; RESET SD_DET; WIFI/RPI_RX; WIFI/RPI_TX; CAN_TX CAN_RX; BEEP; BTN_EN1; LCD_EN LCD_RS; BTN_EN2; LCD_D5; LCD_D4; LCD_D7; LCD_D6; BTN_ENC; SPI1[0..3]; StepStick_Driver_E1; P07_StepStick_Driver; STEP; DIR; SPI4_CS; DIAG; SPI4[0..2]; JUMPER; StepStick_Driver_E4; P05_Others; E0_Heater; Z_MAX; E1_Heater E2_Heater BED_Heater; X_MIN Y_MIN Z_MIN X_MAX Y_MAX; THERM_END0 THERM_END1 THERM_END2 THERM_END3 THERM_END4 THERM_BED; P01_Power; StepStick_Driver_Z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

Design Name: Spider_V3.0

Size A3 | Page Name: Block_Diagram Block_Diagram Block_Diagram | Rev v3.0

Date: Saturday, May 06, 2023 Saturday, May 06, 2023 Saturday, May 06, 2023 | Sheet 1 1 1 of 14 14 14

D

1 of 6

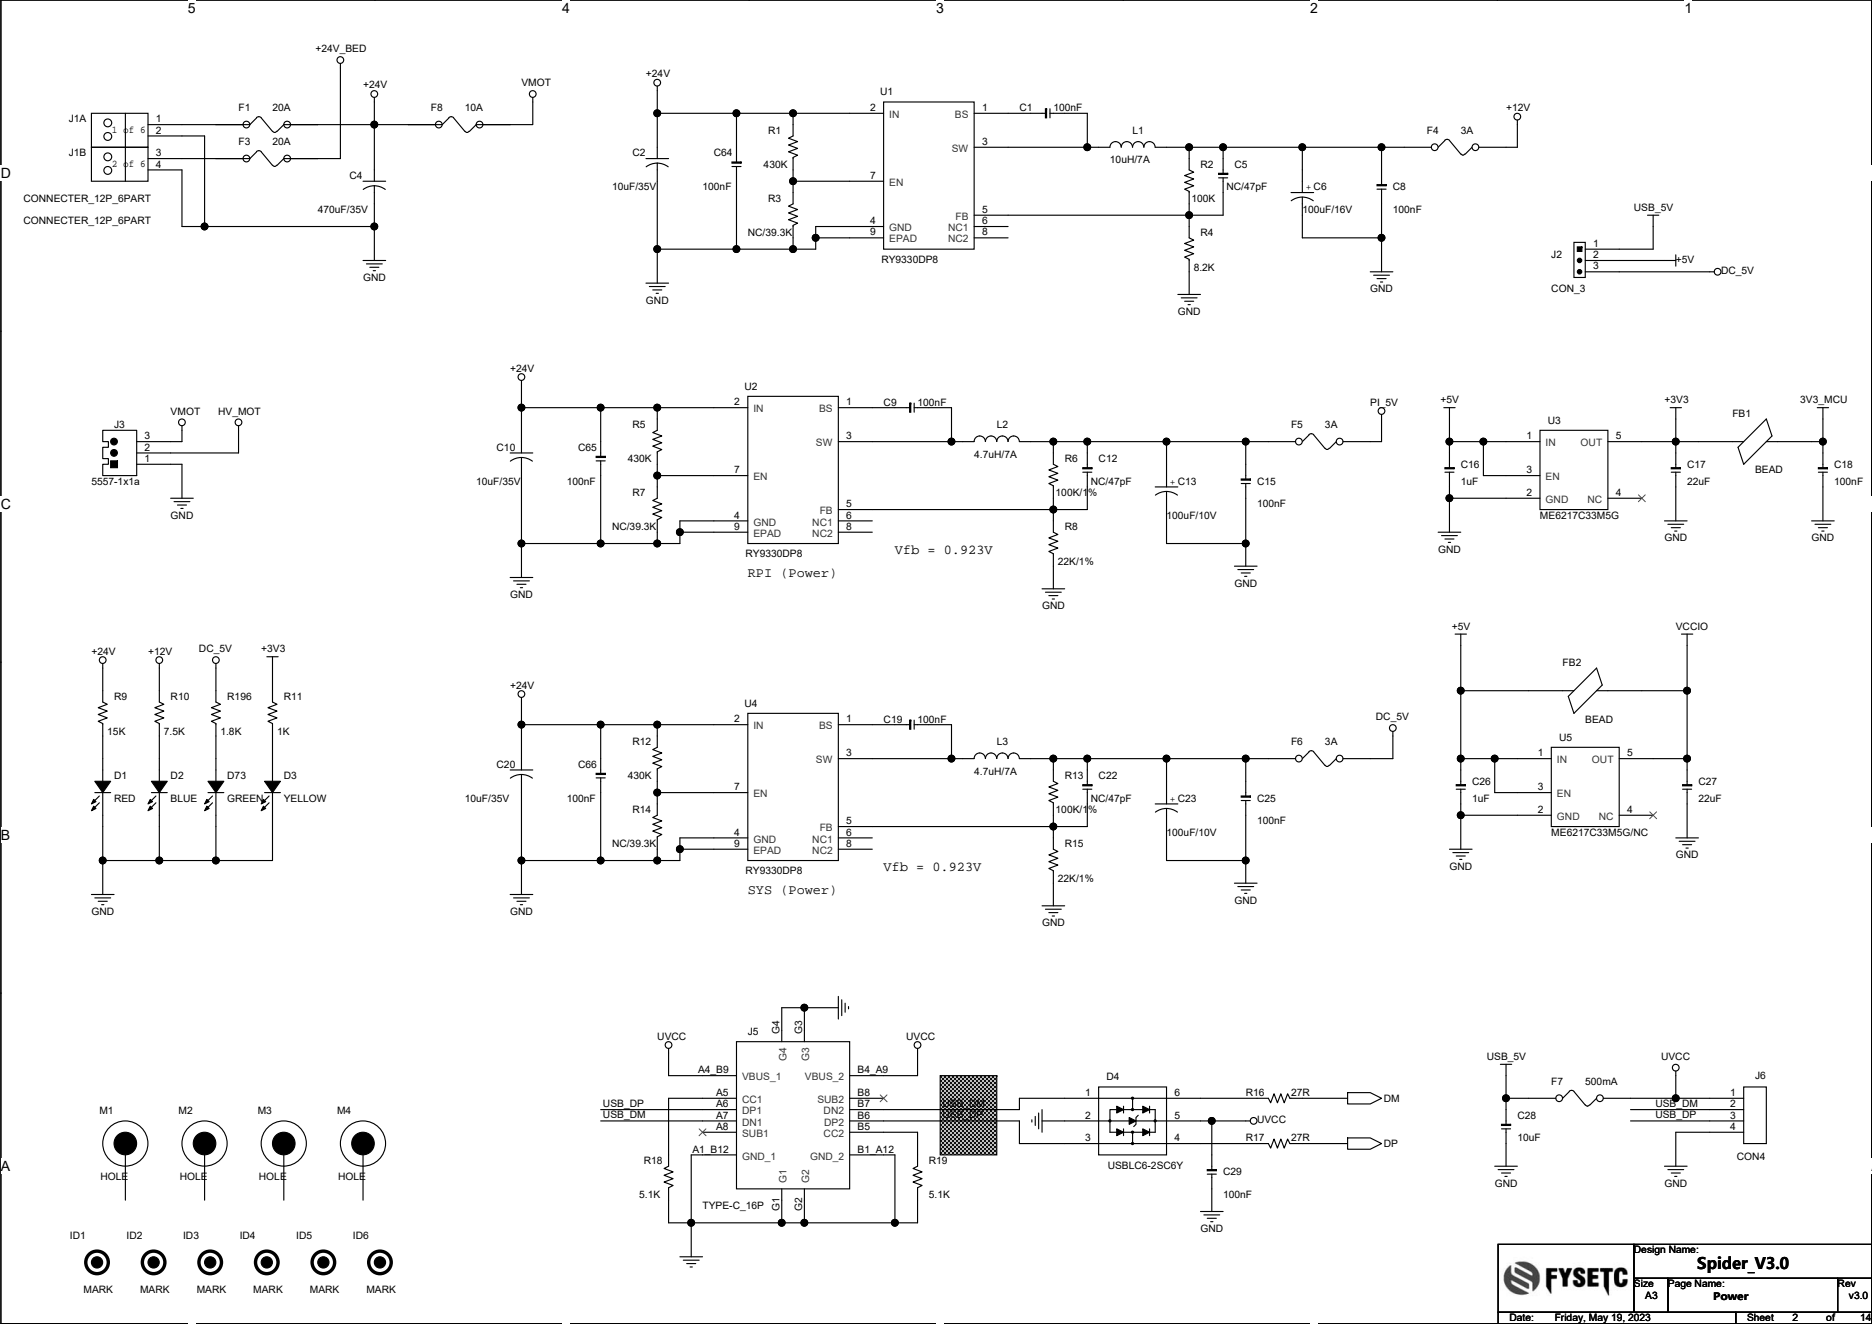
[picture p72: page 2]

Power Power Power

Friday, May 19, 2023 Friday, May 19, 2023 Friday, May 19, 2023 | 2 2 2 14 14 14

5

4

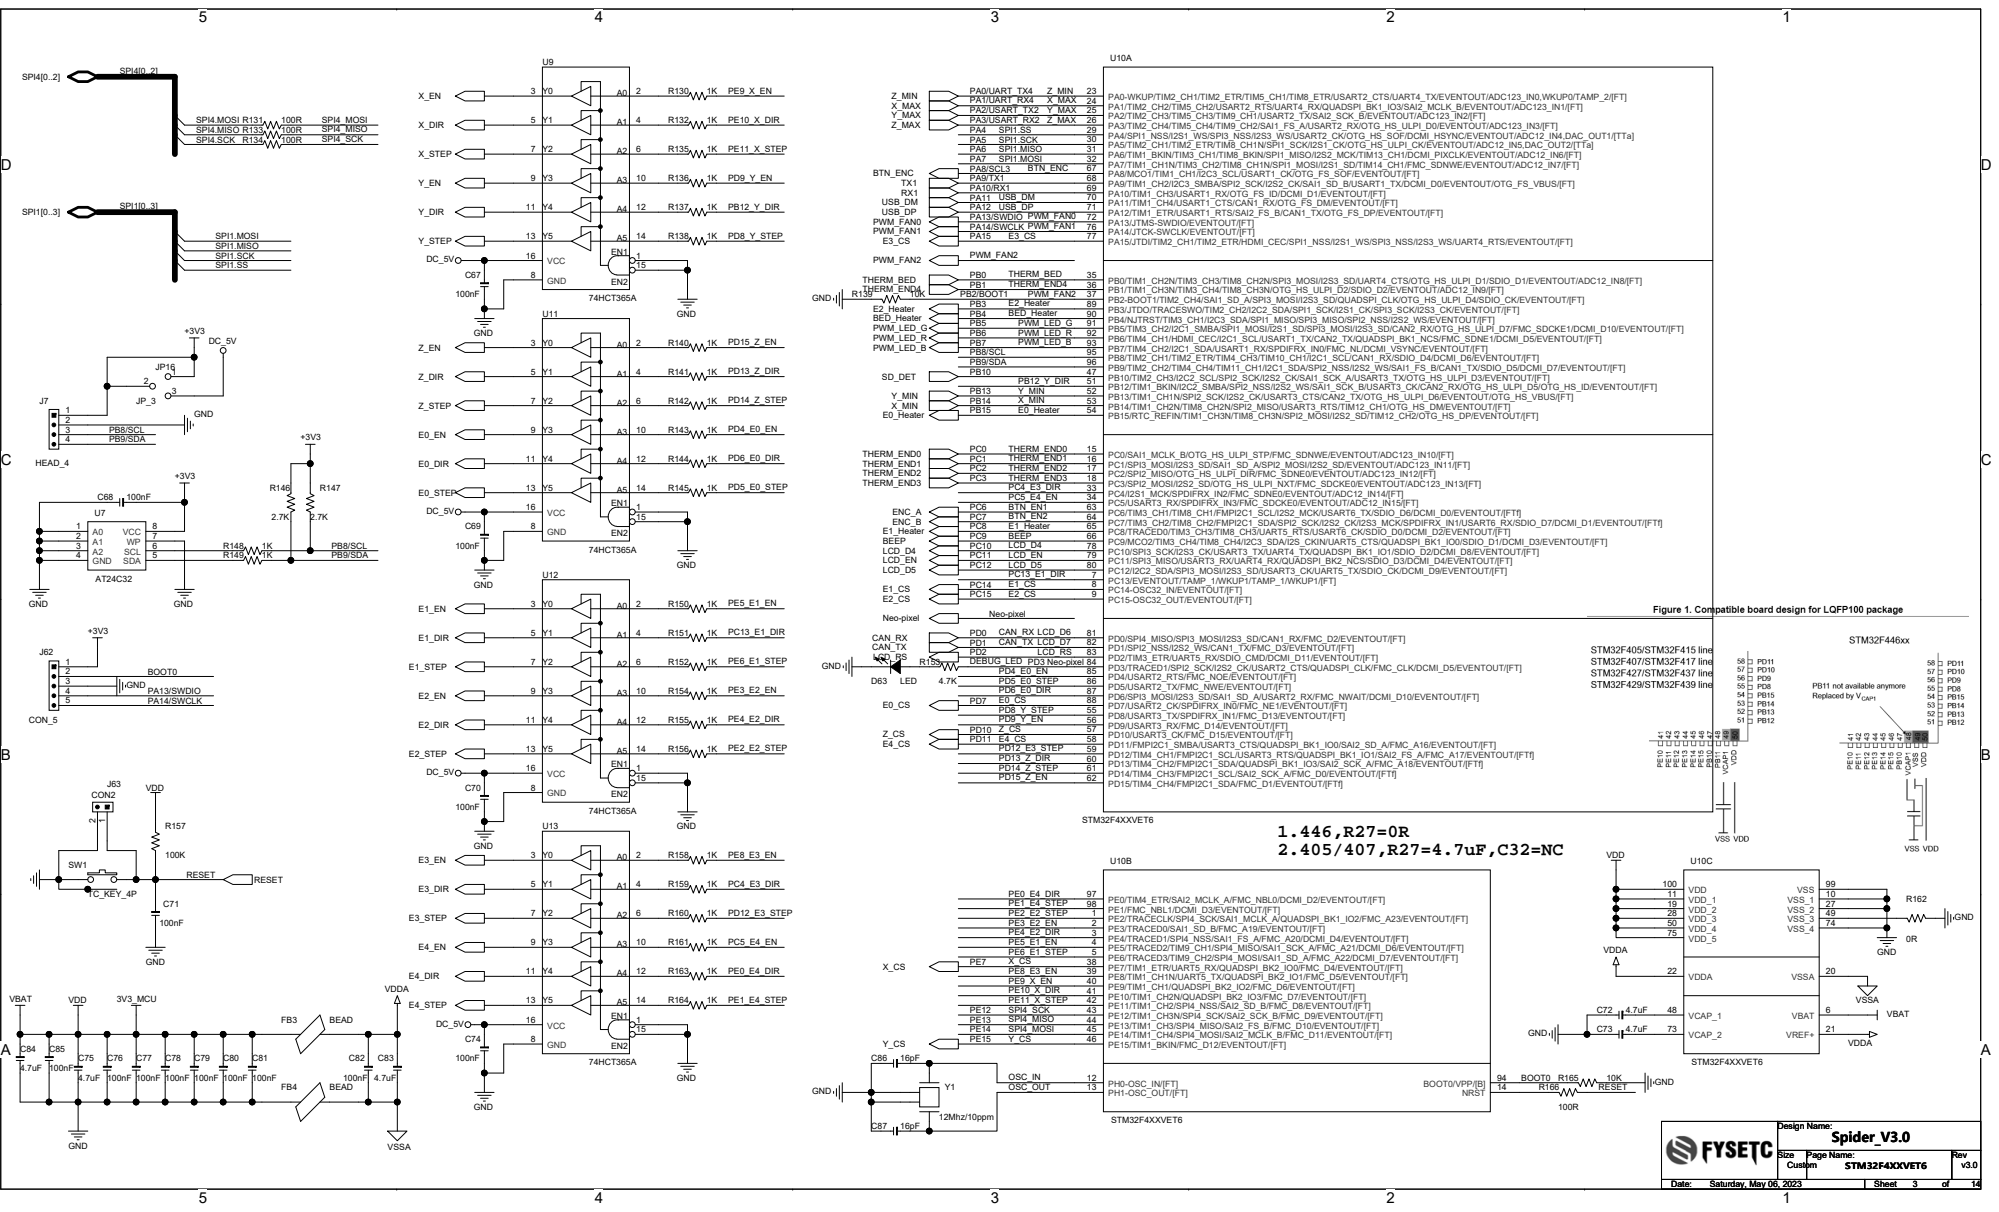
[picture p73: page 3]

PA13/JTMS-SWDIO/EVENTOUT/[FT] 72
PA14/JTCK-SWCLK/EVENTOUT/[FT] 76
PA15/JTDI/TIM2_CH1/TIM2_ETR/HDMI_CEC/SPI1_NSS/I2S1_WS/SPI3_NSS/I2S3_WS/UART4_RTS/EVENTOUT/[FT] 77

PB0/TIM1_CH2N/TIM3_CH3/TIM8_CH2N/SPI3_MOSI/I2S3_SD/UART4_CTS/OTG_HS_ULPI_D1/SDIO_D1/EVENTOUT/ADC12_IN8/[FT] 35
PB1/TIM1_CH3N/TIM3_CH4/TIM8_CH3N/OTG_HS_ULPI_D2/SDIO_D2/EVENTOUT/ADC12_IN9/[FT] 36
PB2-BOOT1/TIM2_CH4/SAI1_SD_A/SPI3_MOSI/I2S3_SD/QUADSPI_CLK/OTG_HS_ULPI_D4/SDIO_CK/EVENTOUT/[FT] 37
PB3/JTDO/TRACESWO/TIM2_CH2/I2C2_SDA/SPI1_SCK/I2S1_CK/SPI3_SCK/I2S3_CK/EVENTOUT/[FT] 89
PB4/NJTRST/TIM3_CH1/I2C3_SDA/SPI1_MISO/SPI3_MISO/SPI2_NSS/I2S2_WS/EVENTOUT/[FT] 90
PB5/TIM3_CH2/I2C1_SMBA/SPI1_MOSI/I2S1_SD/SPI3_MOSI/I2S3_SD/CAN2_RX/OTG_HS_ULPI_D7/FMC_SDCKE1/DCMI_D10/EVENTOUT/[FT] 91
PB6/TIM4_CH1/HDMI_CEC/I2C1_SCL/USART1_TX/CAN2_TX/QUADSPI_BK1_NCS/FMC_SDNE1/DCMI_D5/EVENTOUT/[FT] 92
PB7/TIM4_CH2/I2C1_SDA/USART1_RX/SPDIFRX_IN0/FMC_NL/DCMI_VSYNC/EVENTOUT/[FT] 93
PB8/TIM2_CH1/TIM2_ETR/TIM4_CH3/TIM10_CH1/I2C1_SCL/CAN1_RX/SDIO_D4/DCMI_D6/EVENTOUT/[FT] 95
PB9/TIM2_CH2/TIM4_CH4/TIM11_CH1/I2C1_SDA/SPI2_NSS/I2S2_WS/SAI1_FS_B/CAN1_TX/SDIO_D5/DCMI_D7/EVENTOUT/[FT] 96
PB10/TIM2_CH3/I2C2_SCL/SPI2_SCK/I2S2_CK/SAI1_SCK_A/USART3_TX/OTG_HS_ULPI_D3/EVENTOUT/[FT] 47
PB12/TIM1_BKIN/I2C2_SMBA/SPI2_NSS/I2S2_WS/SAI1_SCK_B/USART3_CK/CAN2_RX/OTG_HS_ULPI_D5/OTG_HS_ID/EVENTOUT/[FT] 51
PB13/TIM1_CH1N/SPI2_SCK/I2S2_CK/USART3_CTS/CAN2_TX/OTG_HS_ULPI_D6/EVENTOUT/OTG_HS_VBUS/[FT] 52
PB14/TIM1_CH2N/TIM8_CH2N/SPI2_MISO/USART3_RTS/TIM12_CH1/OTG_HS_DM/EVENTOUT/[FT] 53

Design Name: Design Name: Design Name: Spider_V3.0 Spider_V3.0 Spider_V3.0

Size Size Size Custom Custom Custom | Page Name: Page Name: Page Name: STM32F4XXVET6 STM32F4XXVET6 STM32F4XXVET6 | Rev Rev Rev v3.0 v3.0 v3.0

Date: Date: Date: Saturday, May 06, 2023 Saturday, May 06, 2023 Saturday, May 06, 2023 | Sheet Sheet Sheet 3 3 3 of of of 14 14 14

D

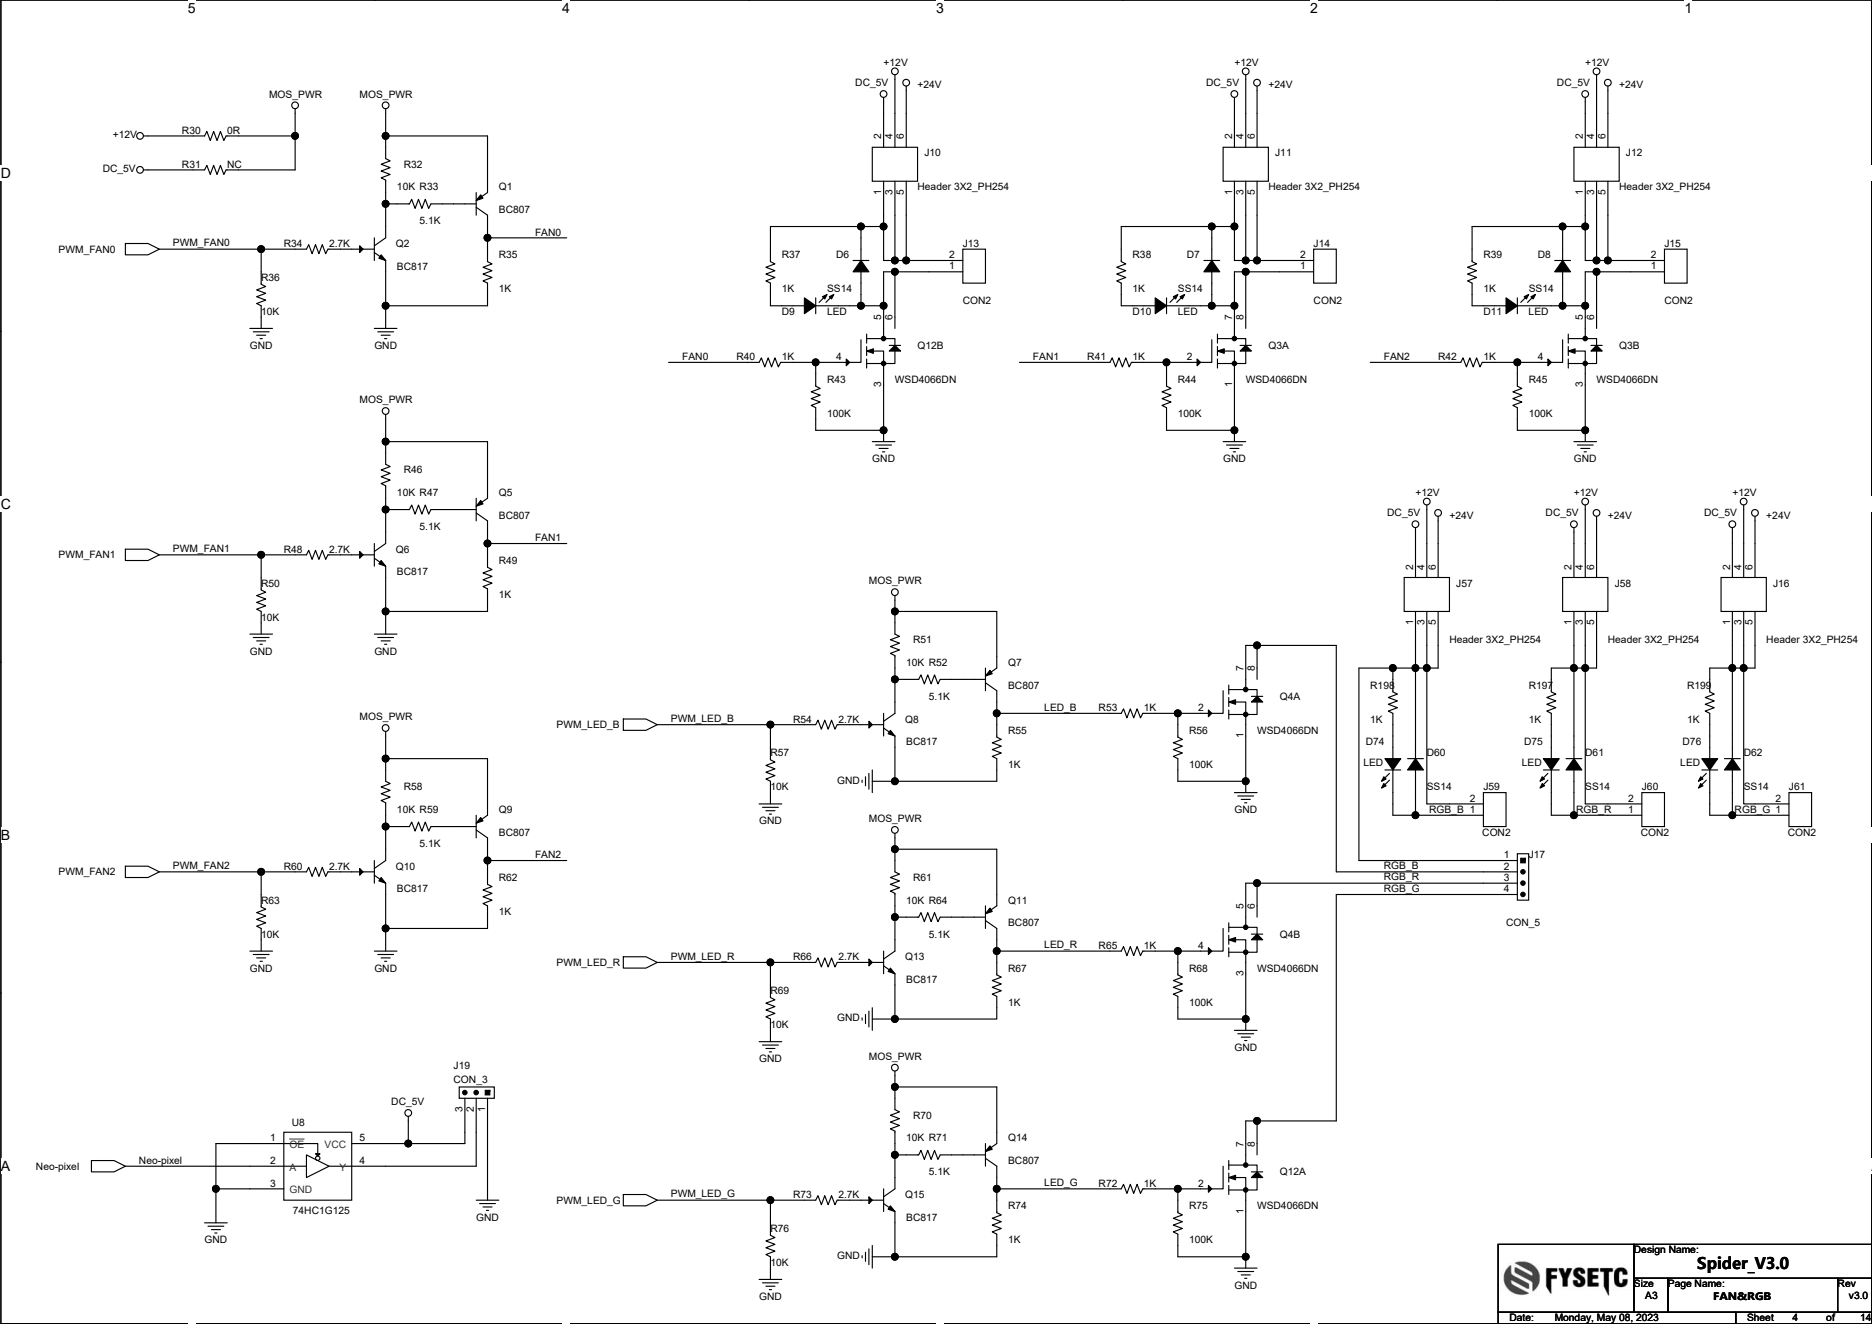
[picture p74: page 4]

FAN&RGB FAN&RGB FAN&RGB

Monday, May 08, 2023 Monday, May 08, 2023 Monday, May 08, 2023 | 4 4 4 14 14 14

D

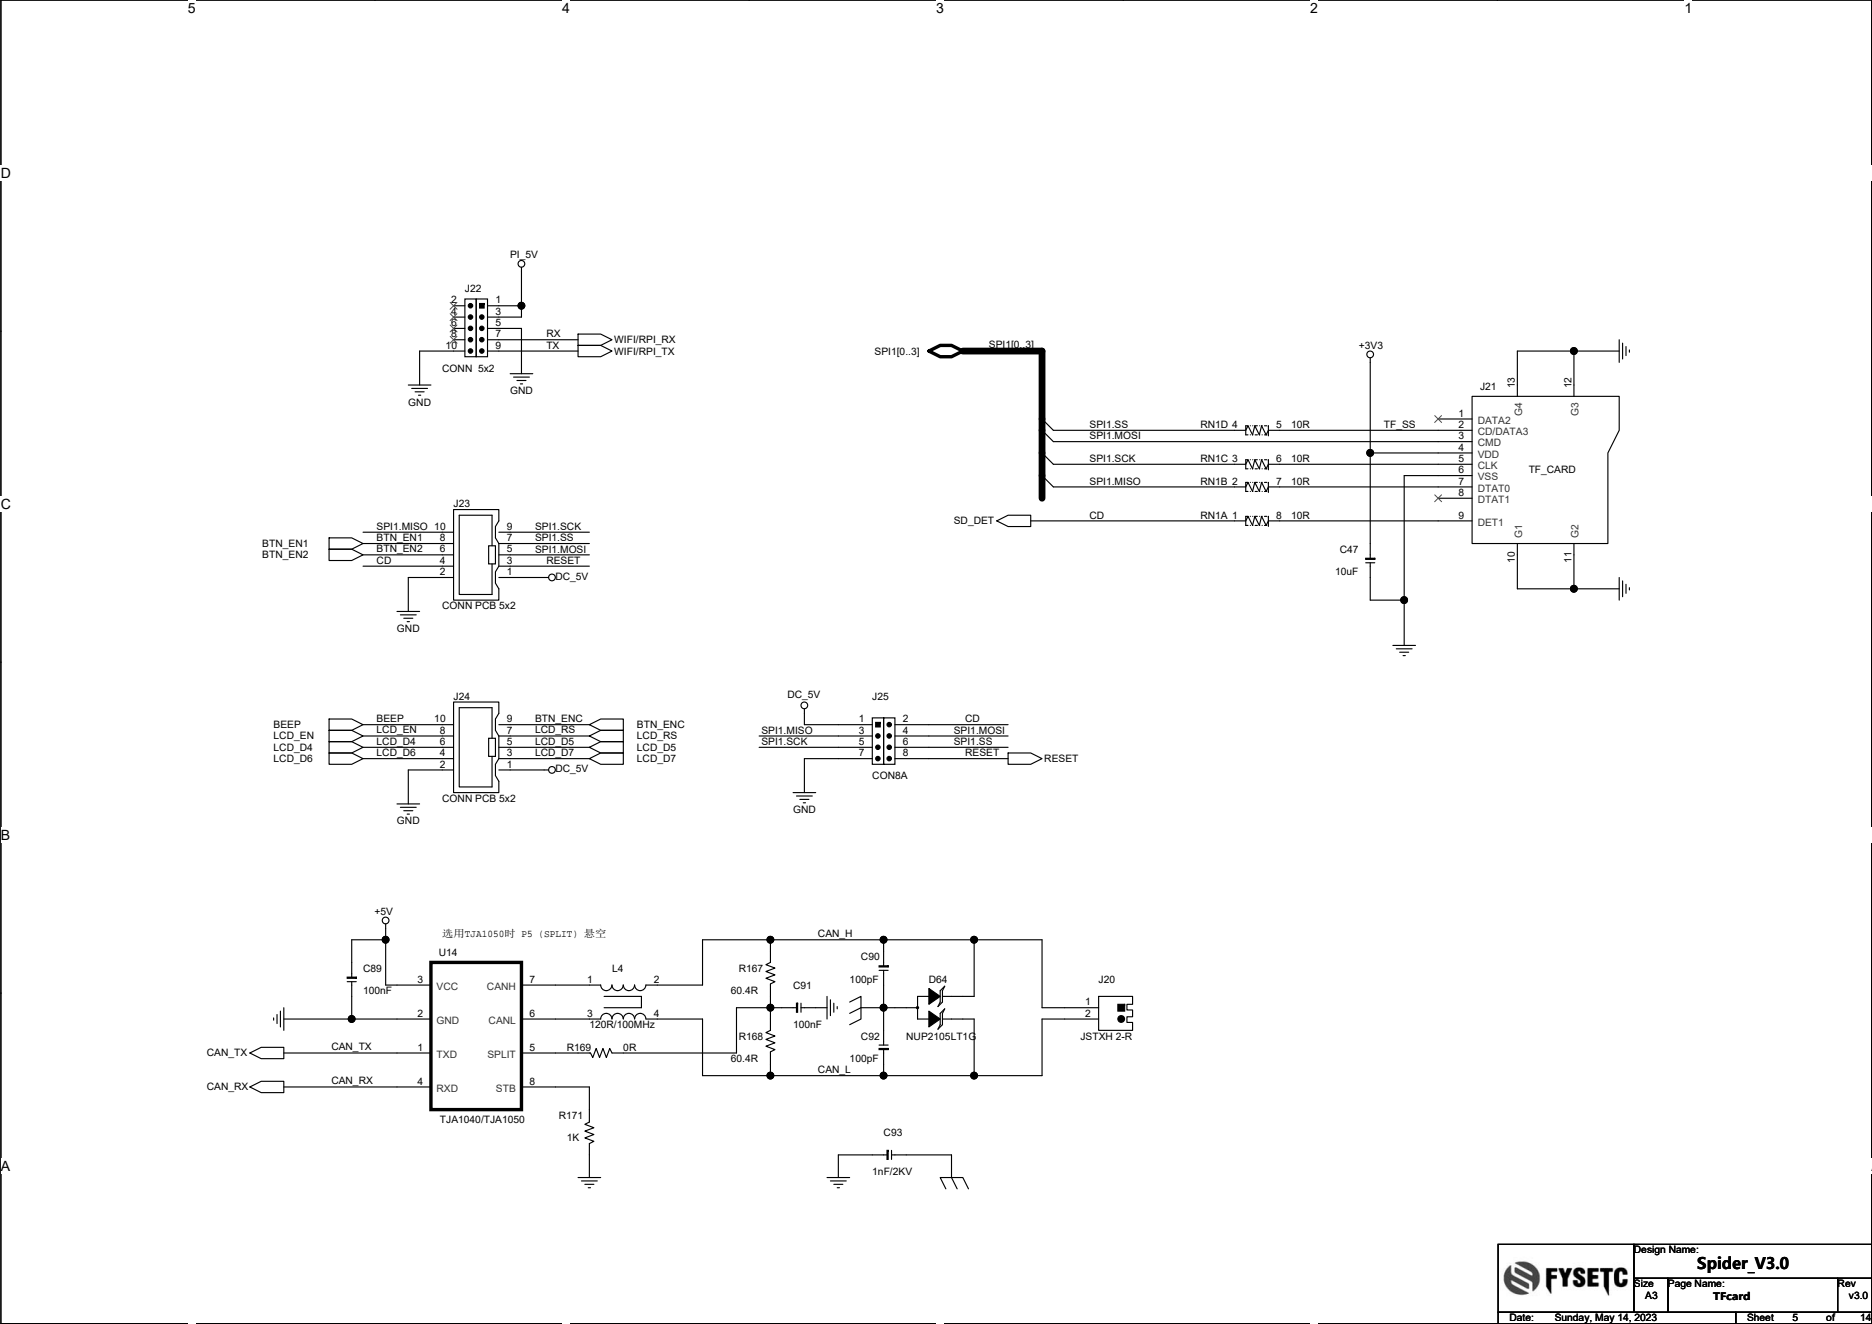
[picture p75: page 5]

TFcard TFcard TFcard

Sunday, May 14, 2023 Sunday, May 14, 2023 Sunday, May 14, 2023 | 5 5 5 14 14 14

D

E0+ | B1+ | B2+ | BED+

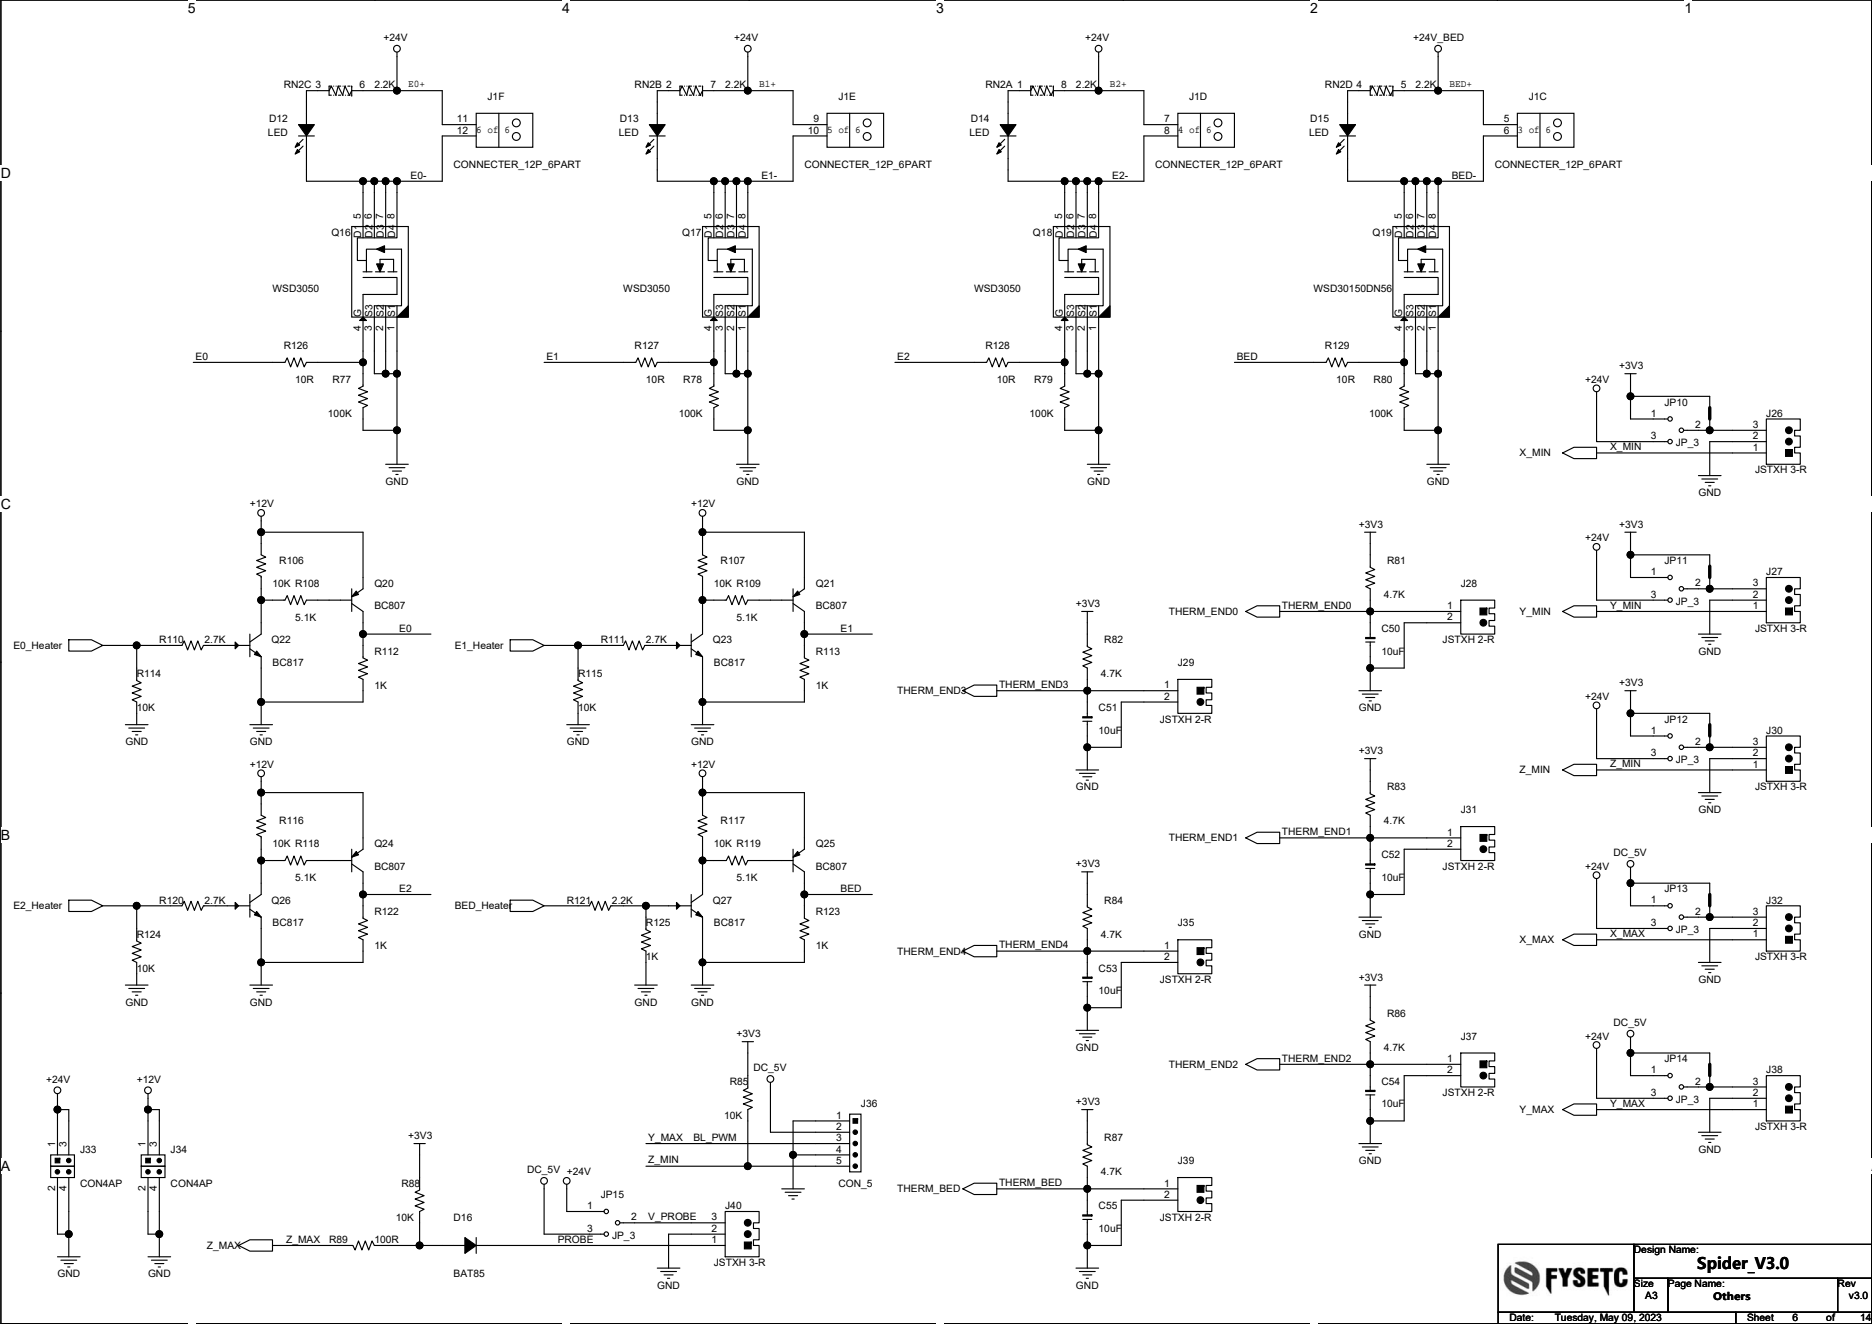
[picture p76: page 6]

D

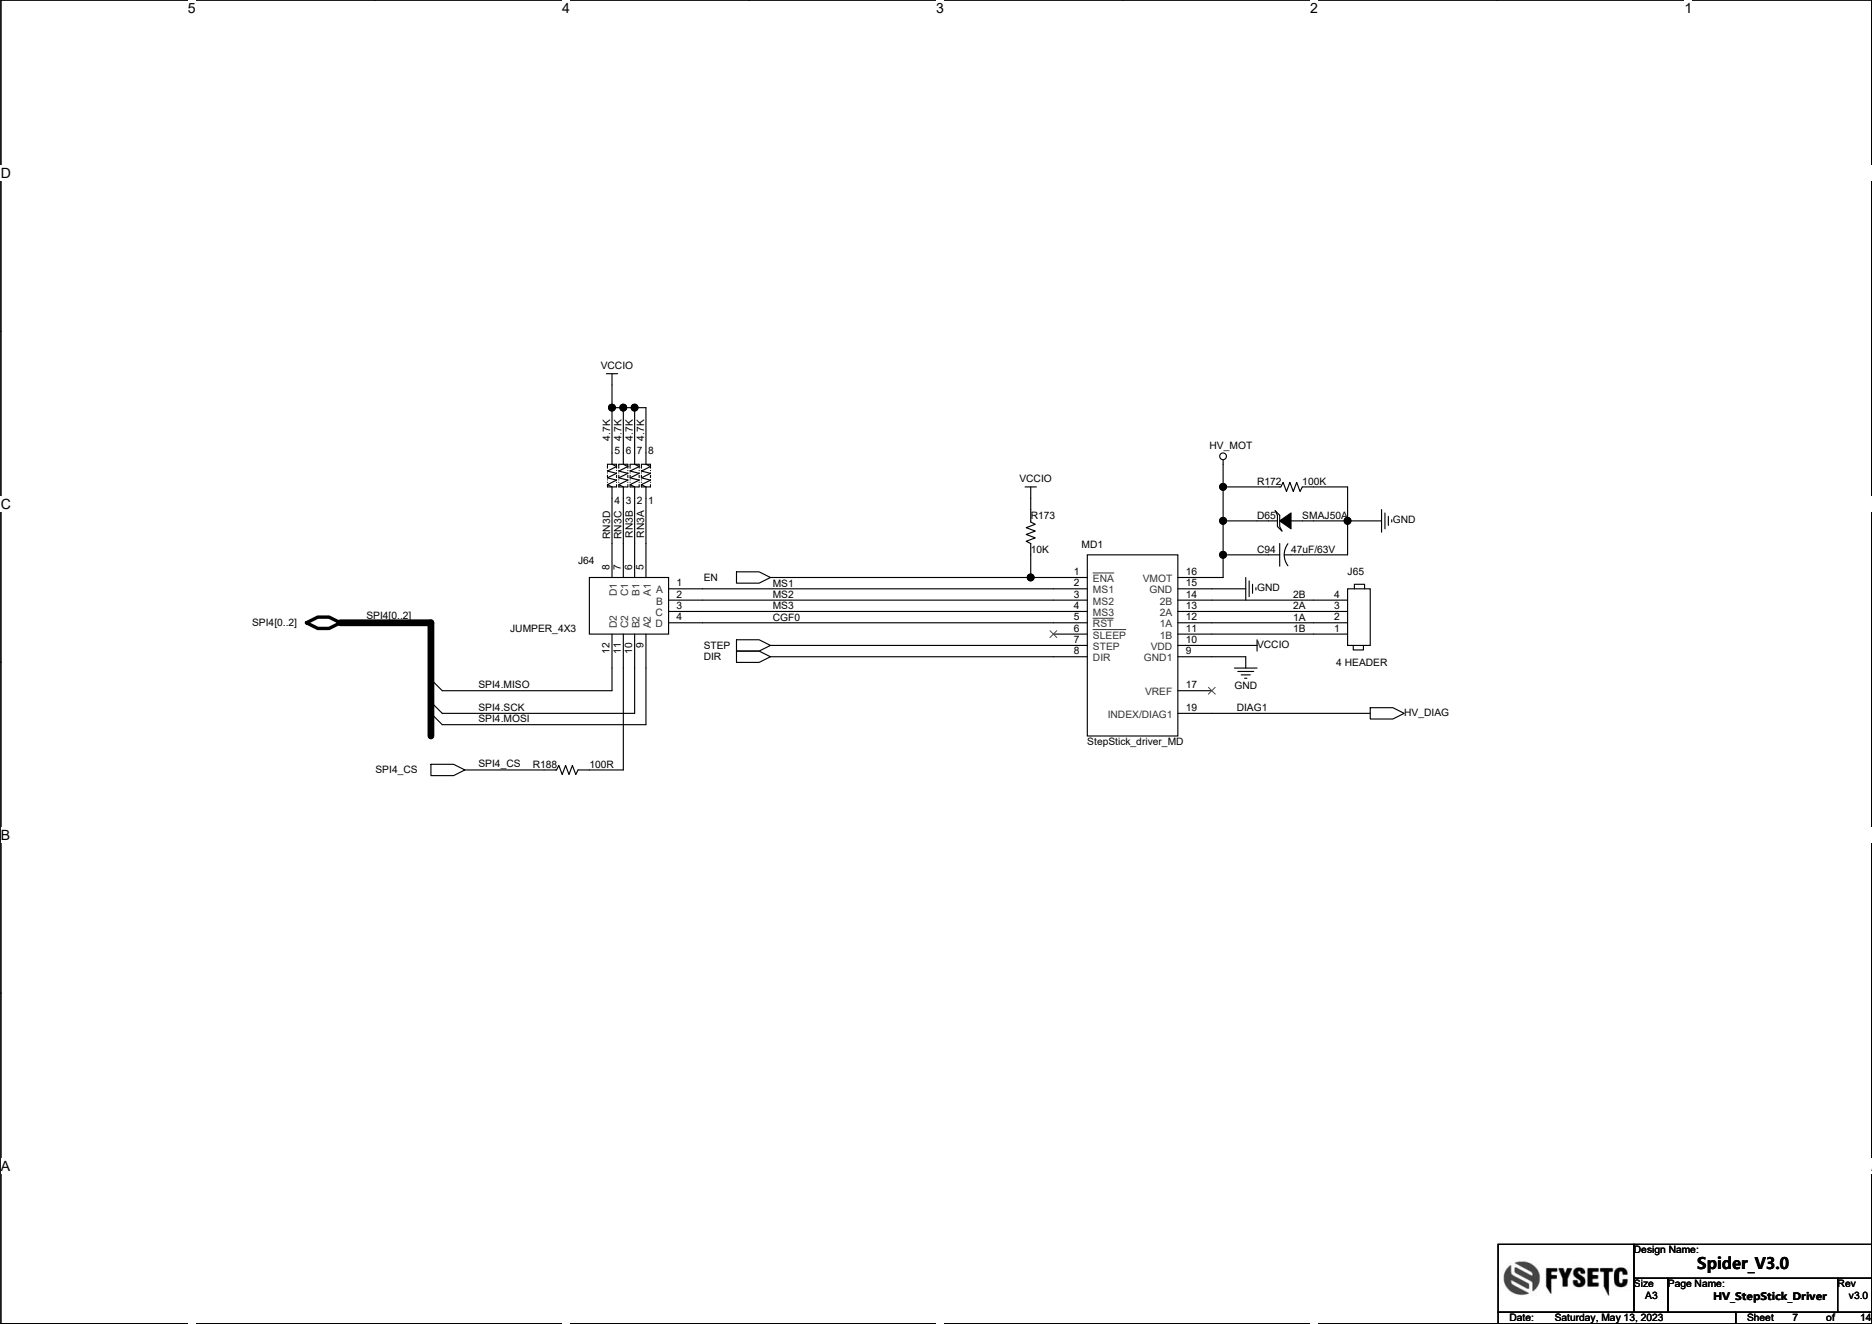
[picture p77: page 7]

CGF0 | RST 5 | 1A 2

SLEEP 6 STEP 7 | 1B 1

HV_StepStick_Driver HV_StepStick_Driver HV_StepStick_Driver

Saturday, May 13, 2023 Saturday, May 13, 2023 Saturday, May 13, 2023 | 7 7 7 14 14 14

D

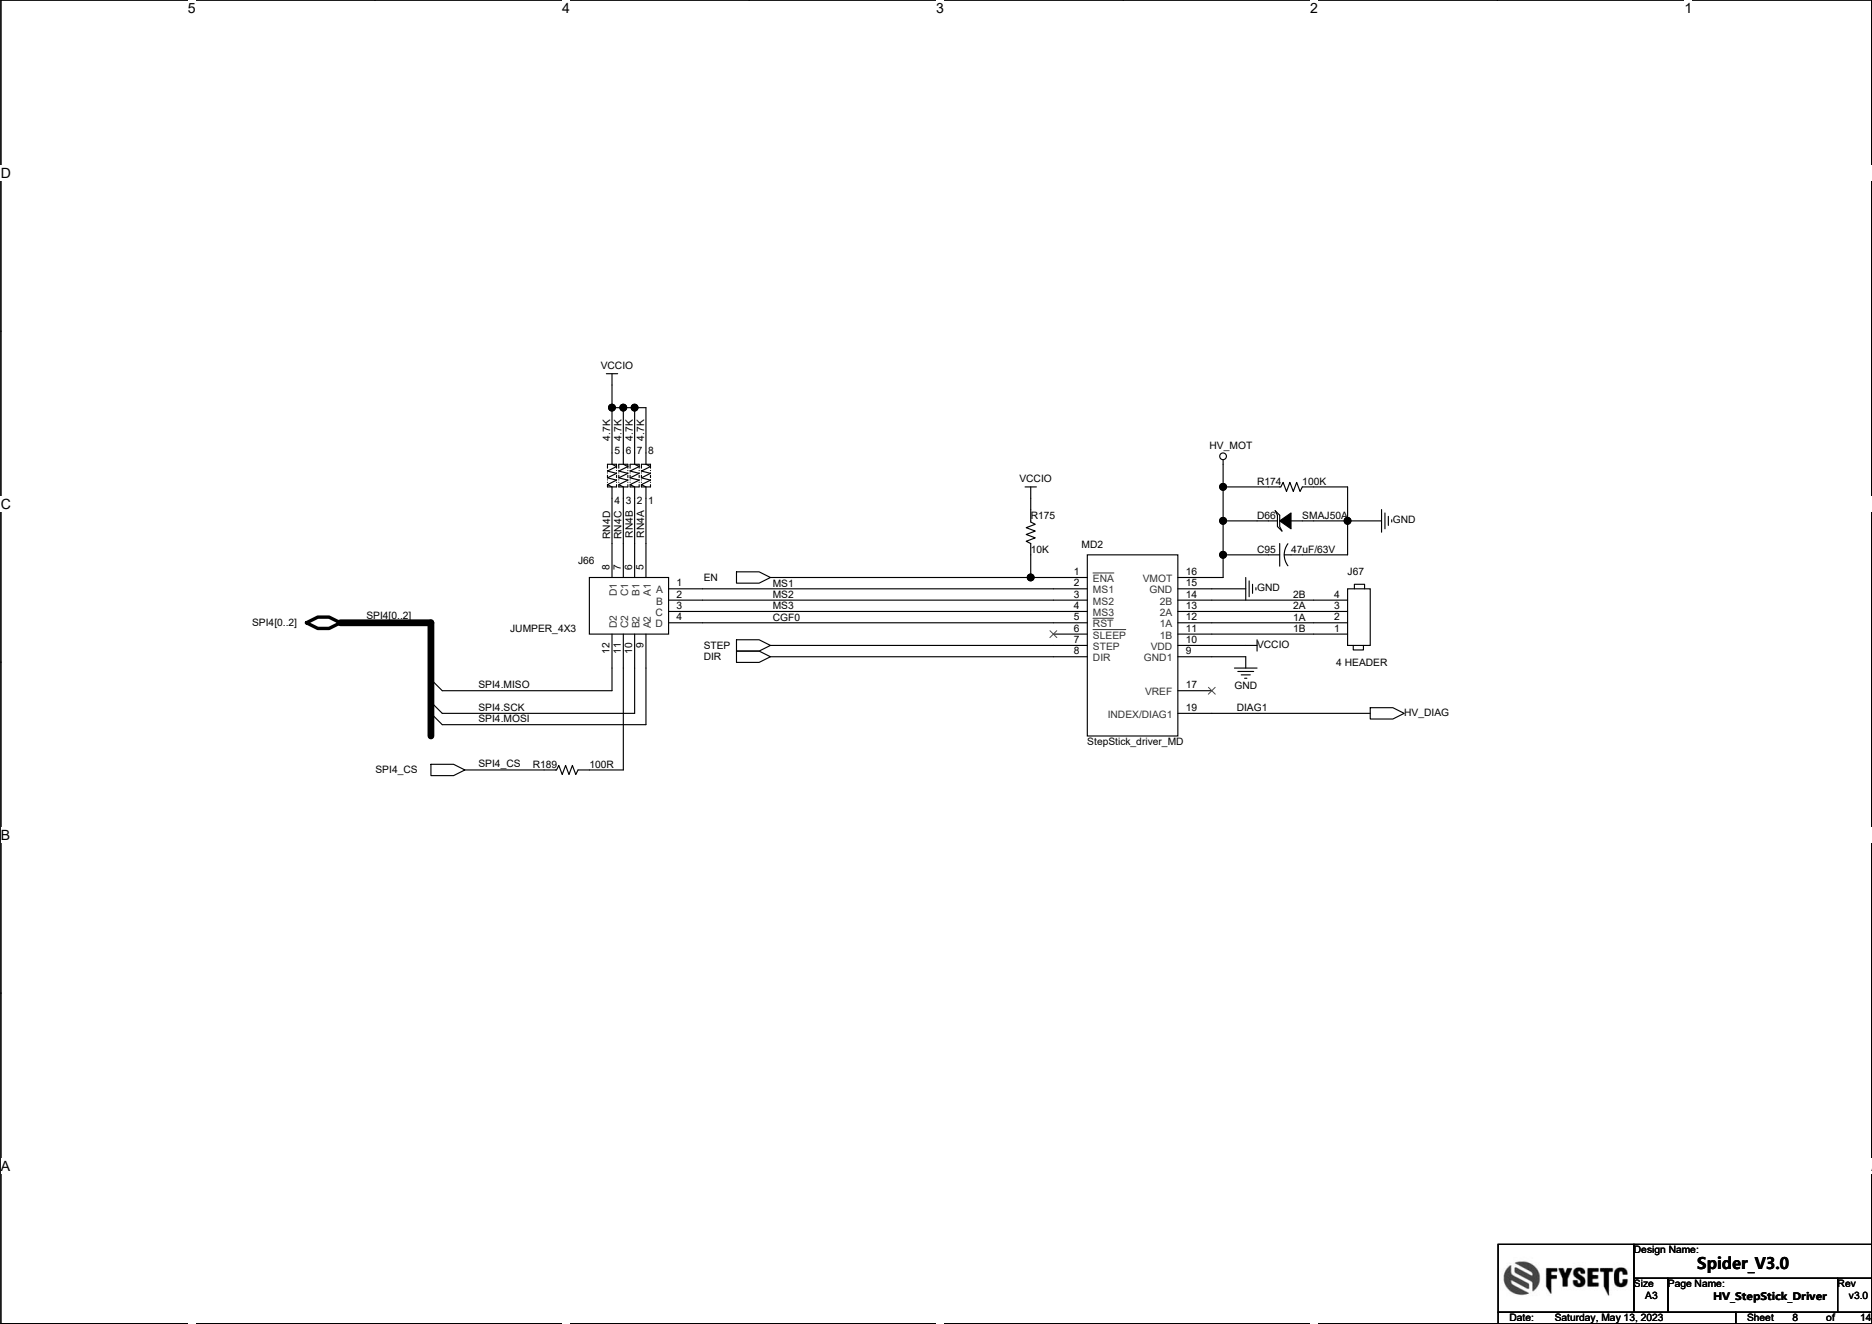
[picture p78: page 8]

CGF0 | RST 5 | 1A 2

SLEEP 6 STEP 7 | 1B 1

HV_StepStick_Driver HV_StepStick_Driver HV_StepStick_Driver

Saturday, May 13, 2023 Saturday, May 13, 2023 Saturday, May 13, 2023 | 8 8 8 14 14 14

D

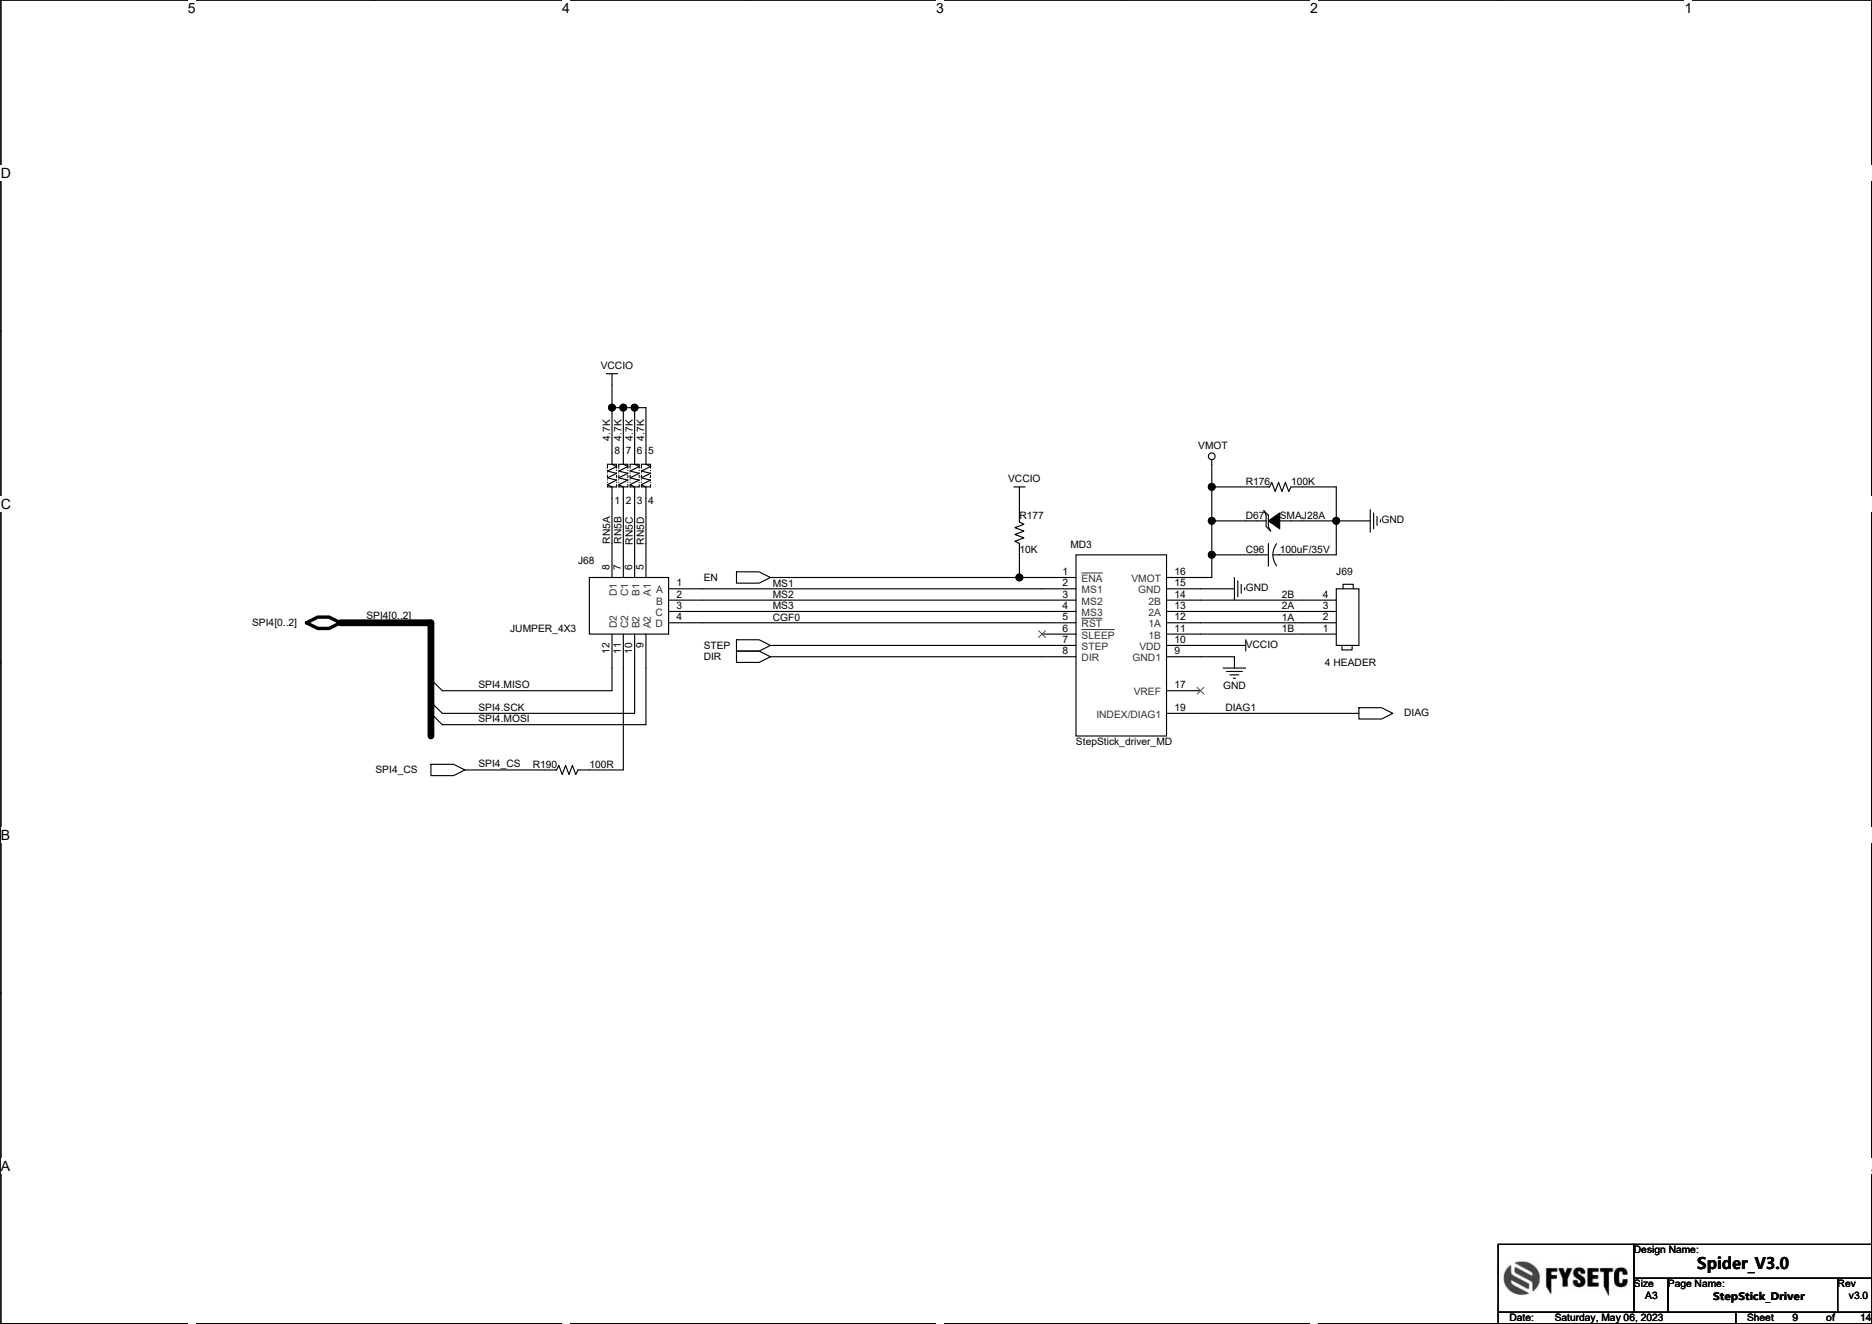
[picture p79: page 9]

CGF0 | RST 5 | 1A 2

SLEEP 6 STEP 7 | 1B 1

StepStick_Driver

Saturday, May 06, 2023 Saturday, May 06, 2023 Saturday, May 06, 2023 | 9 9 9 14 14 14

D

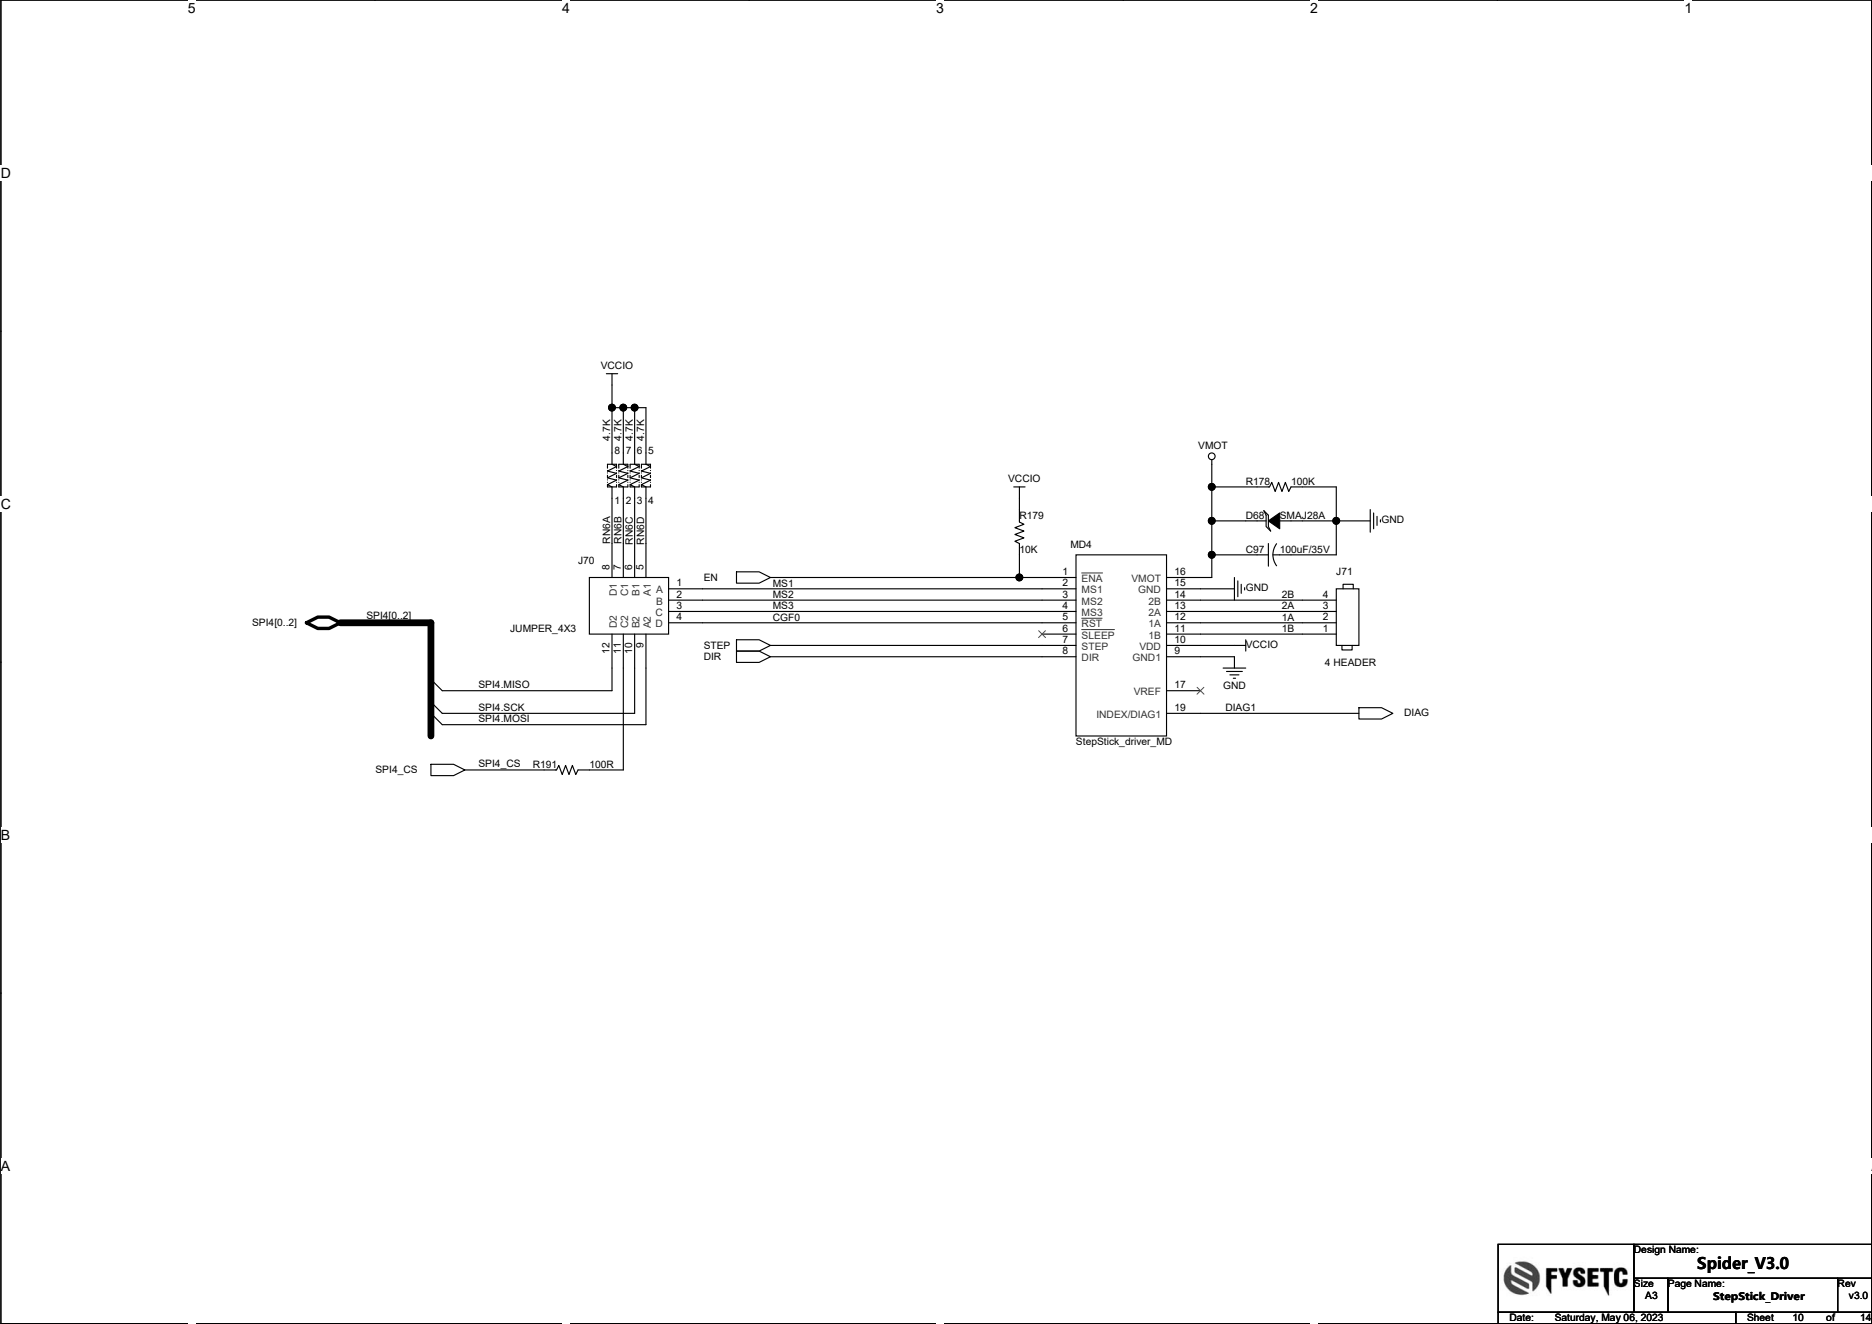
[picture p80: page 10]

CGF0 | RST 5 | 1A 2

SLEEP 6 STEP 7 | 1B 1

D

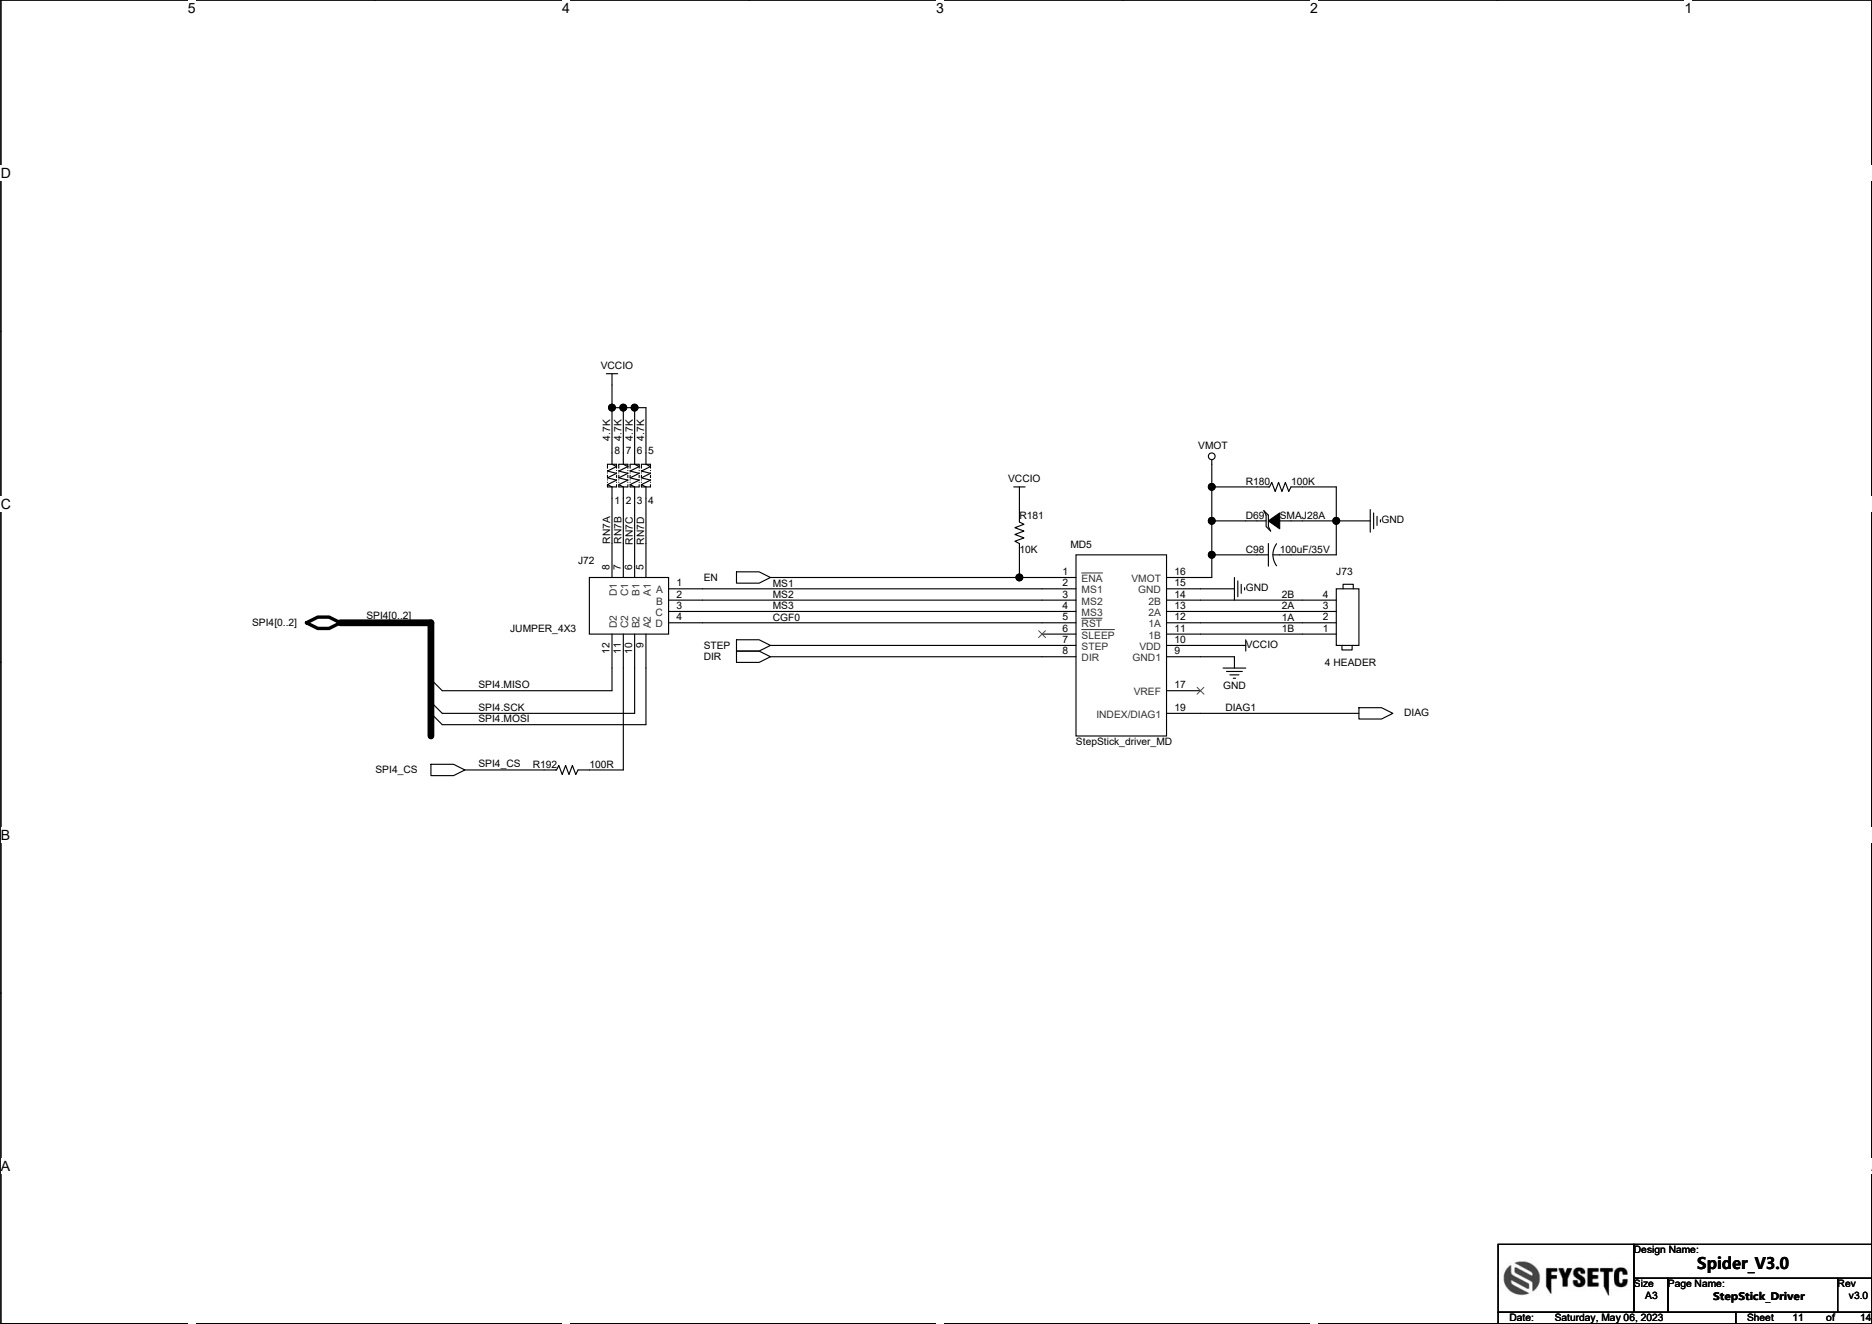
[picture p81: page 11]

CGF0 | RST 5 | 1A 2

SLEEP 6 STEP 7 | 1B 1

D

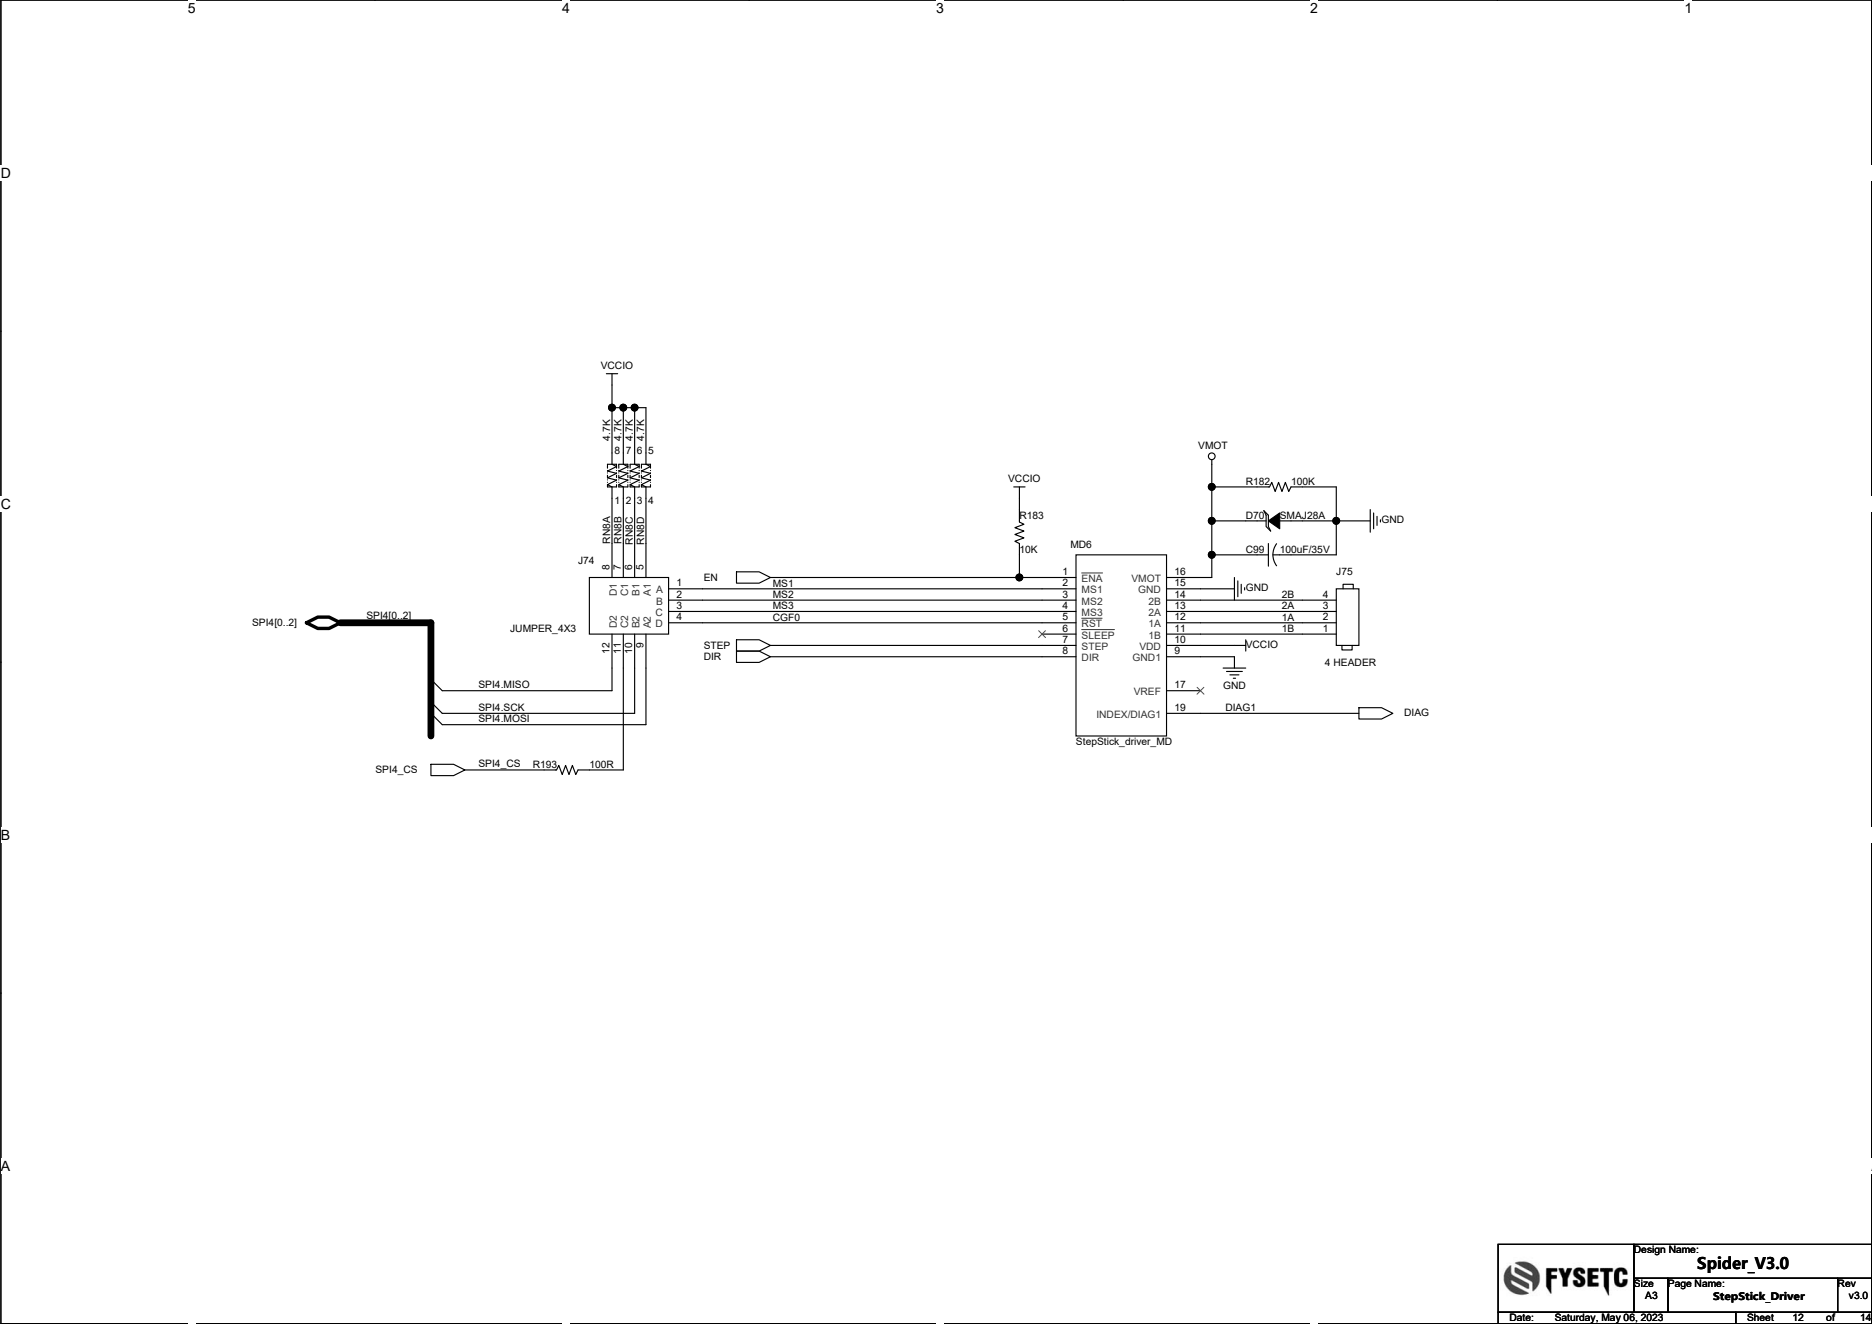
[picture p82: page 12]

CGF0 | RST 5 | 1A 2

SLEEP 6 STEP 7 | 1B 1

D

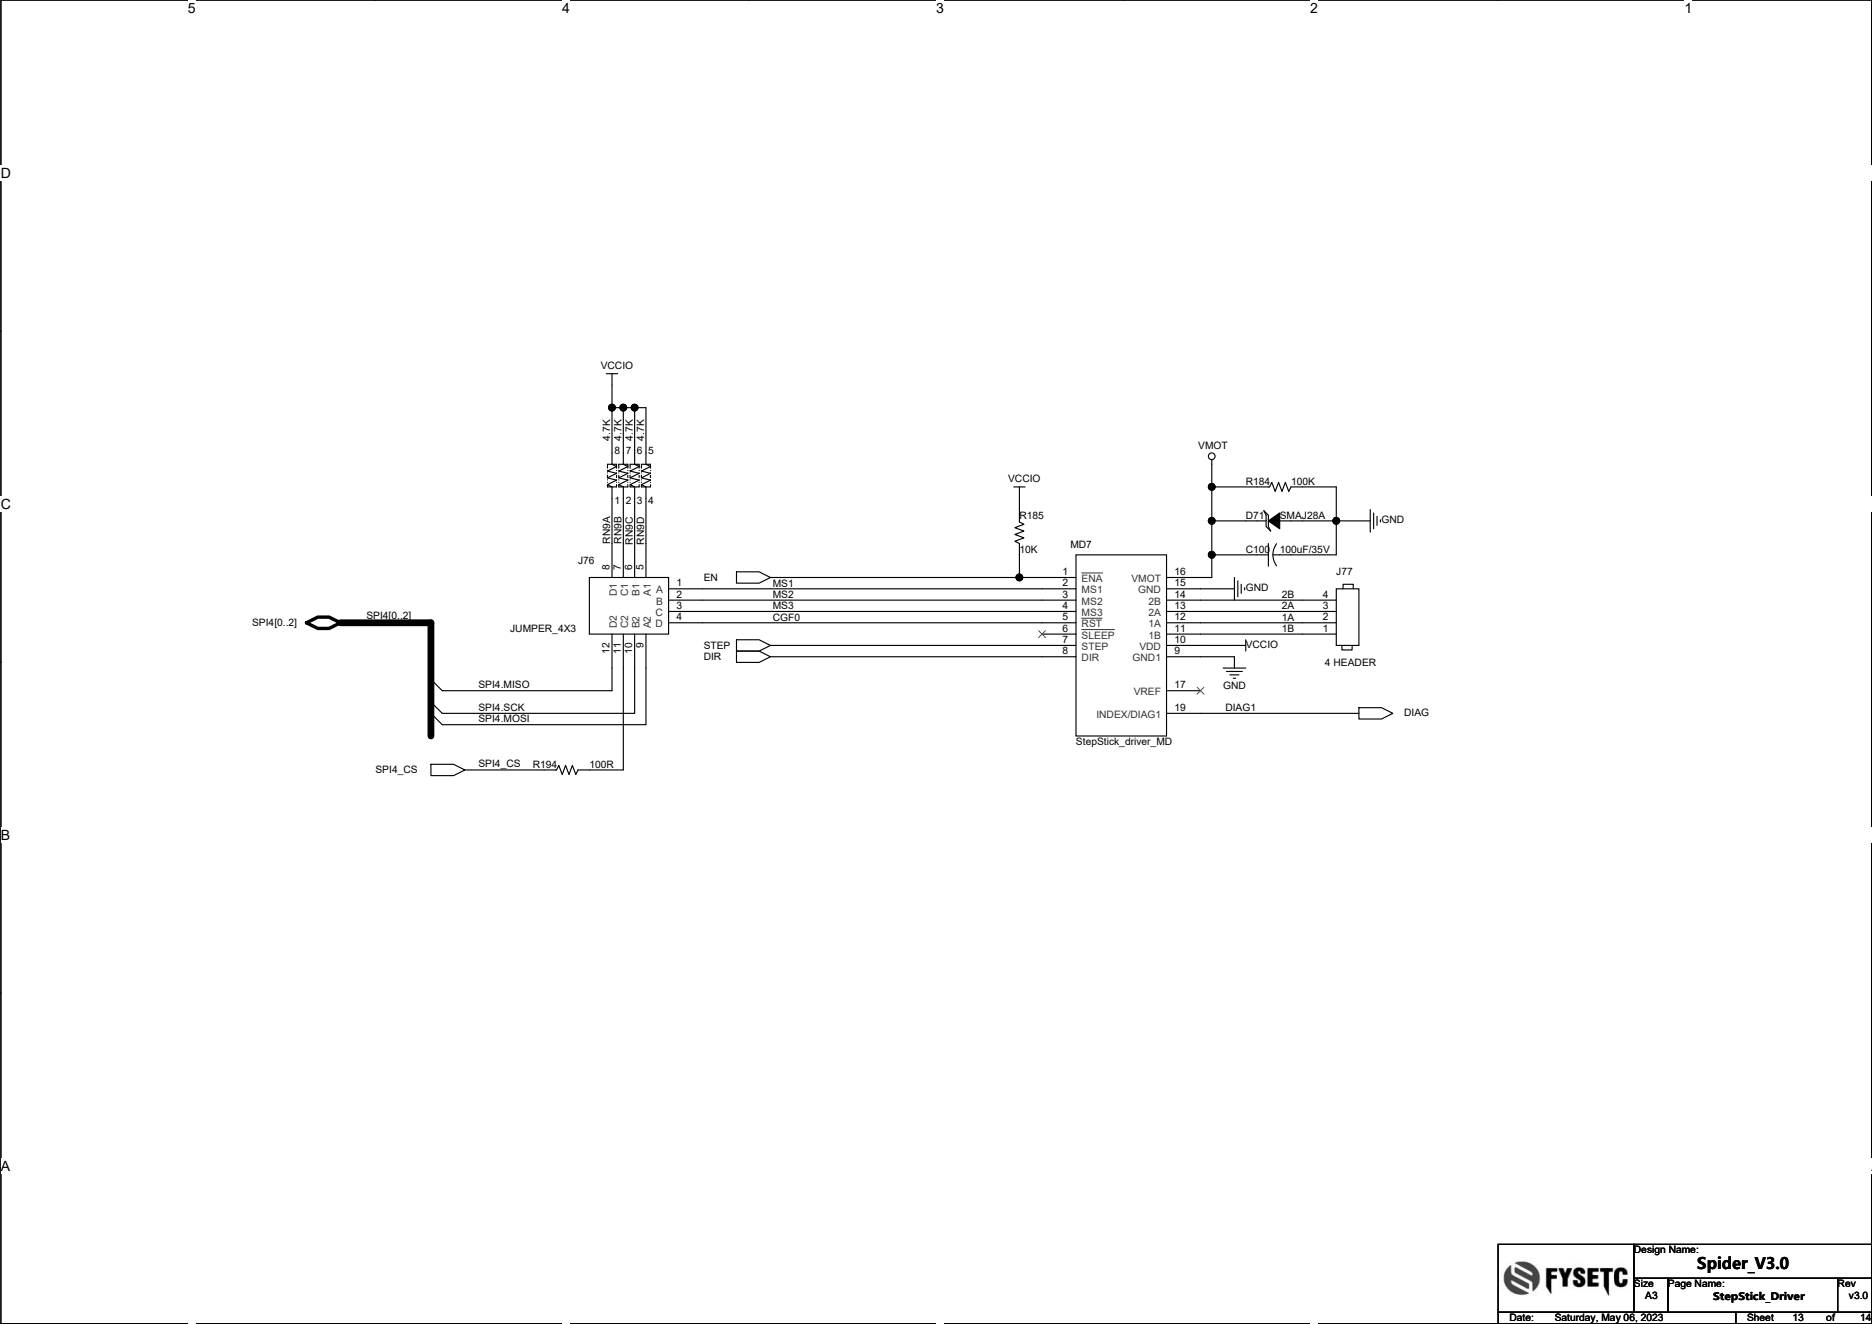
[picture p83: page 13]

CGF0 | RST 5 | 1A 2

SLEEP 6 STEP 7 | 1B 1

D

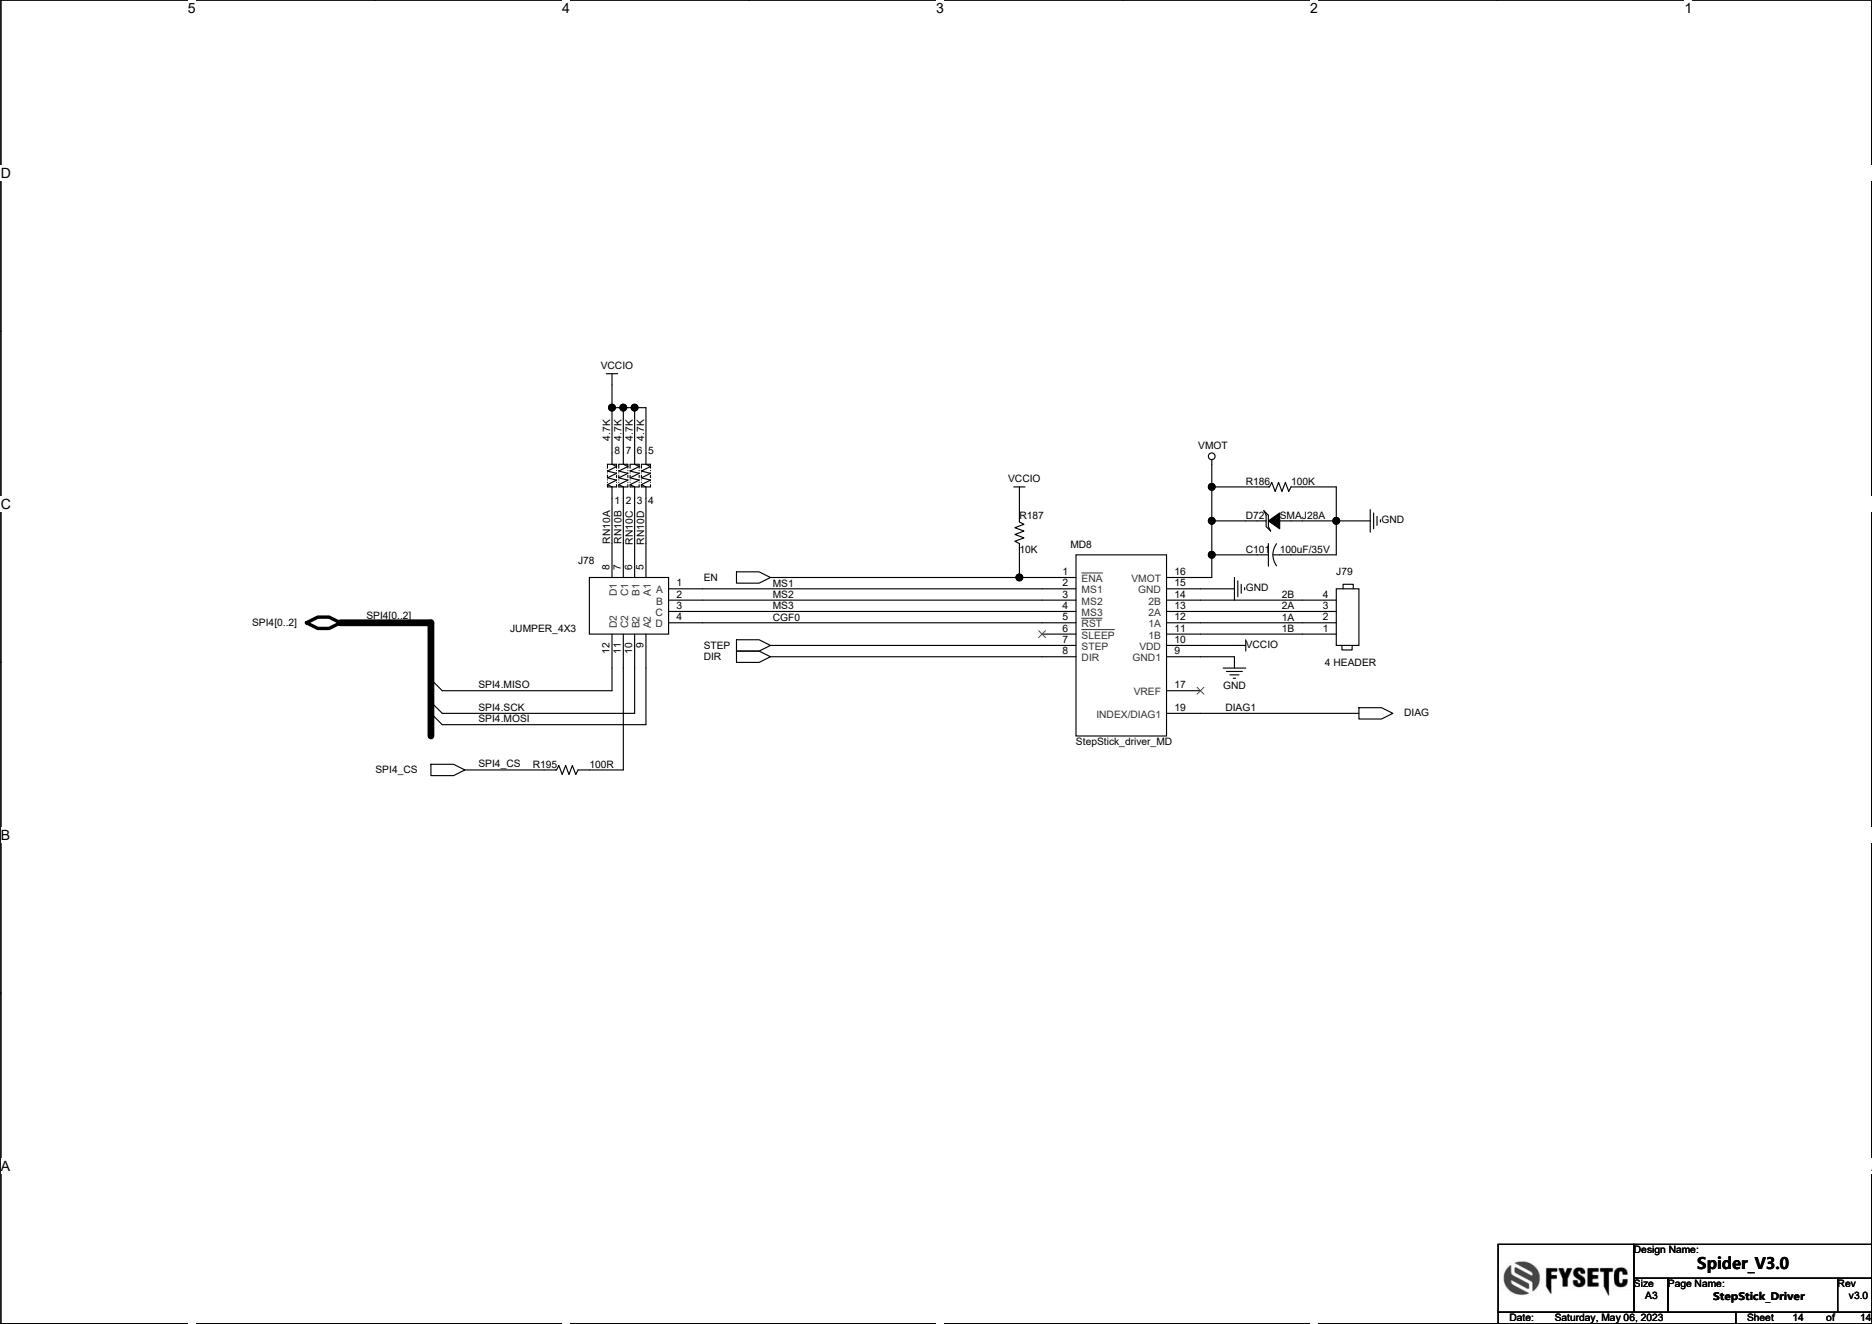
[picture p84: page 14]

CGF0 | RST 5 | 1A 2

SLEEP 6 STEP 7 | 1B 1

5

4

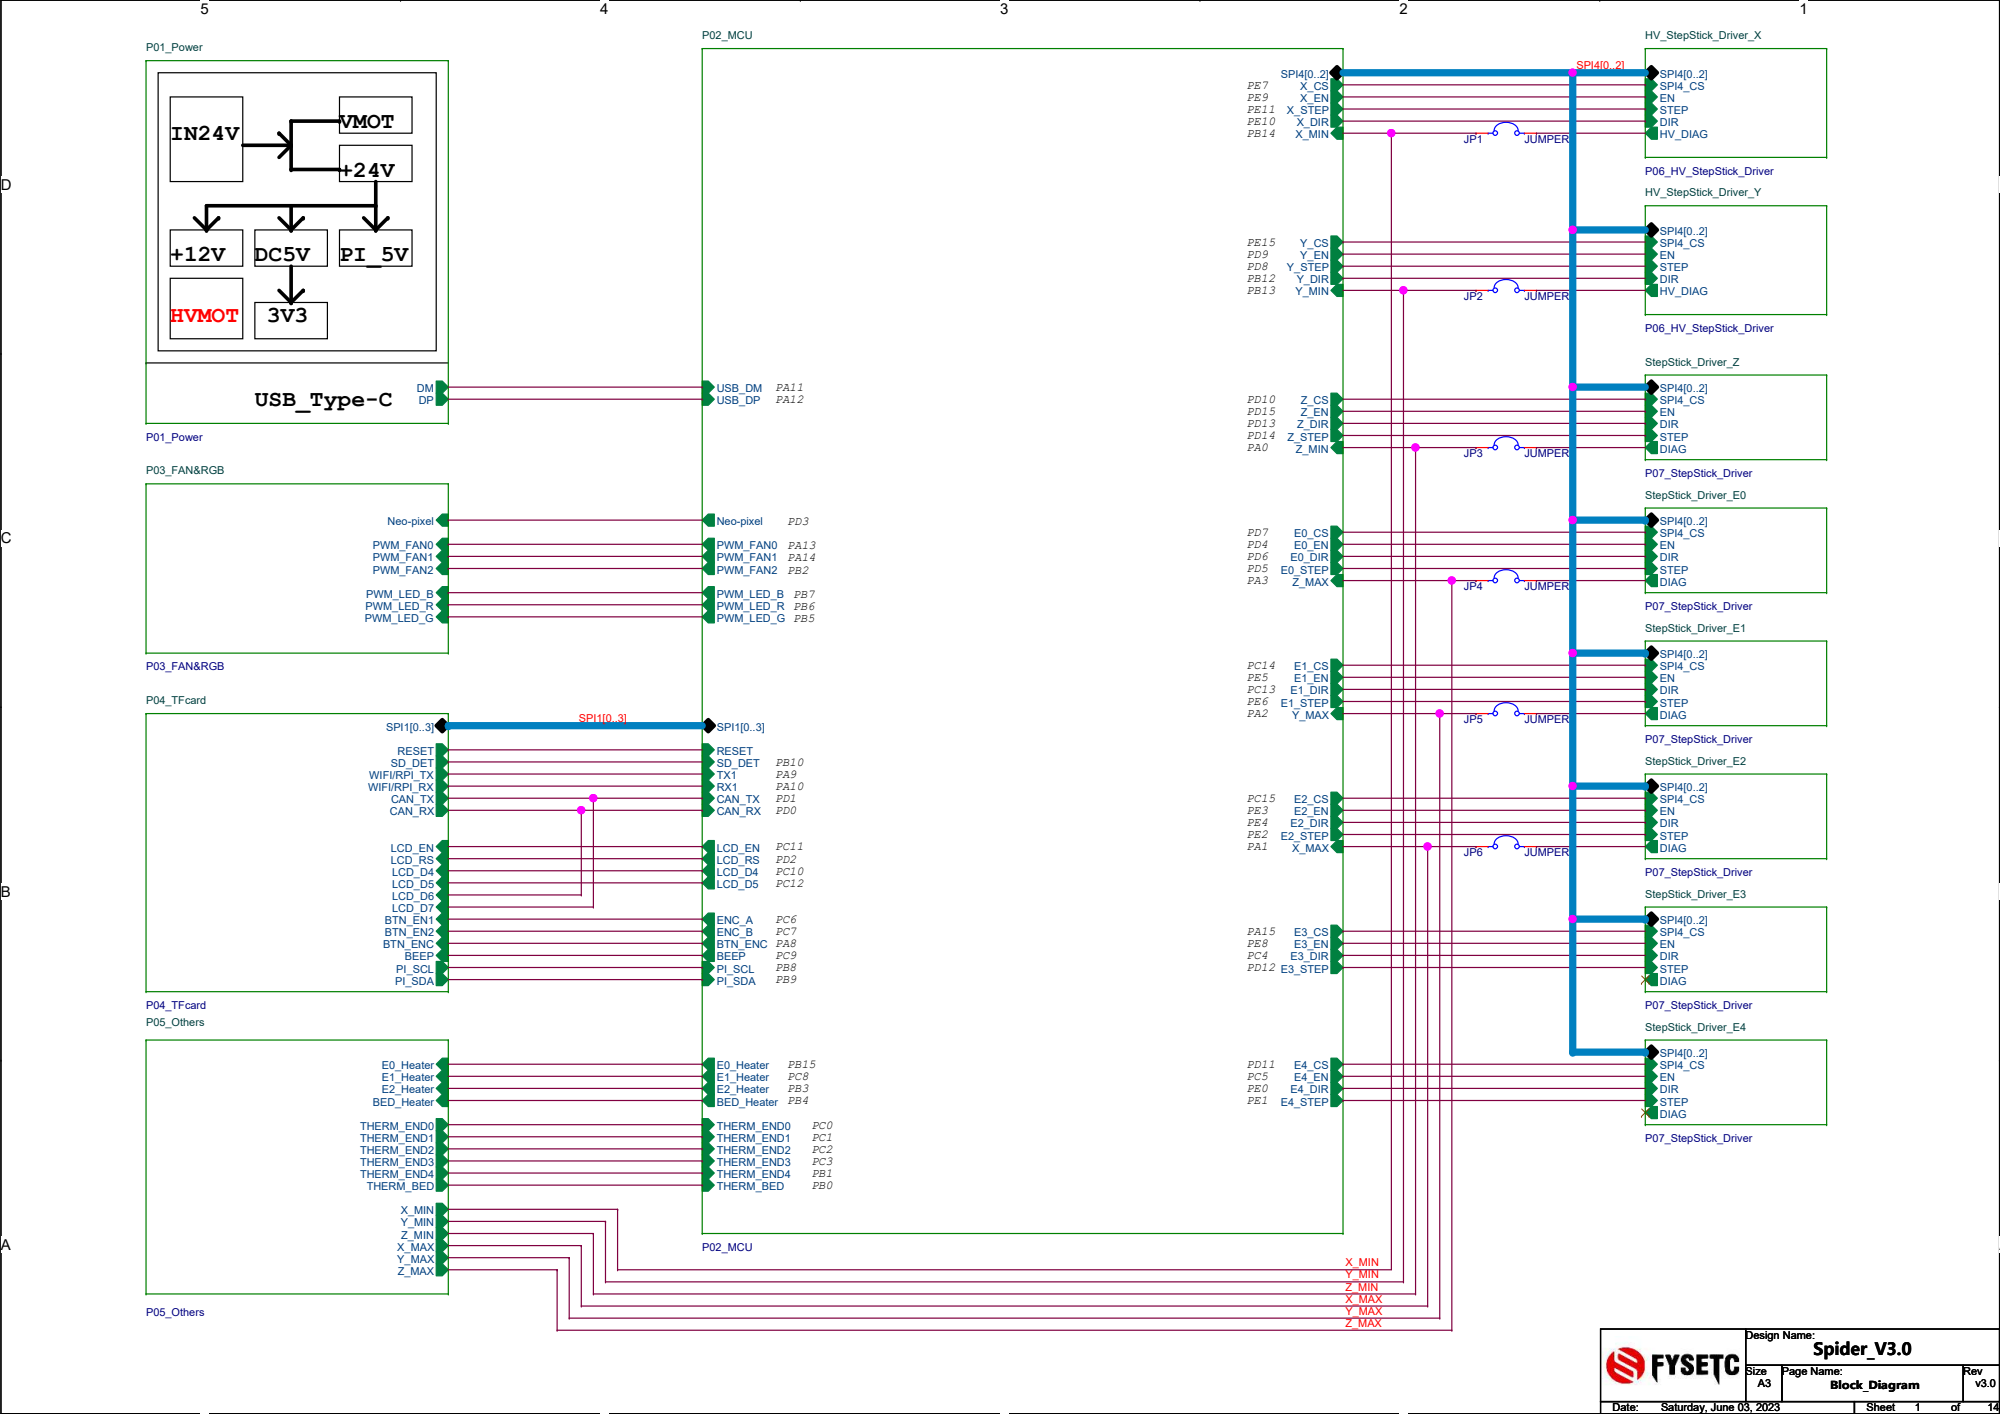
[picture p85: page 15]
VMOT; HVMOT; USB_Type-C; Saturday, June 03, 2023; Block_Diagram; P04_TFcard; RESET SD_DET; WIFI/RPI_RX; WIFI/RPI_TX; CAN_TX CAN_RX; BEEP; BTN_EN1; LCD_EN LCD_RS; BTN_EN2; LCD_D5; LCD_D4; LCD_D7; LCD_D6; BTN_ENC; SPI1[0..3]; PI_SCL PI_SDA; StepStick_Driver_E1; P07_StepStick_Driver; STEP; DIR; SPI4_CS; DIAG; SPI4[0..2]; JUMPER; StepStick_Driver_E4; P05_Others; E0_Heater; Z_MAX; E1_Heater E2_Heater BED_Heater; X_MIN Y_MIN Z_MIN X_MAX Y_MAX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

D D

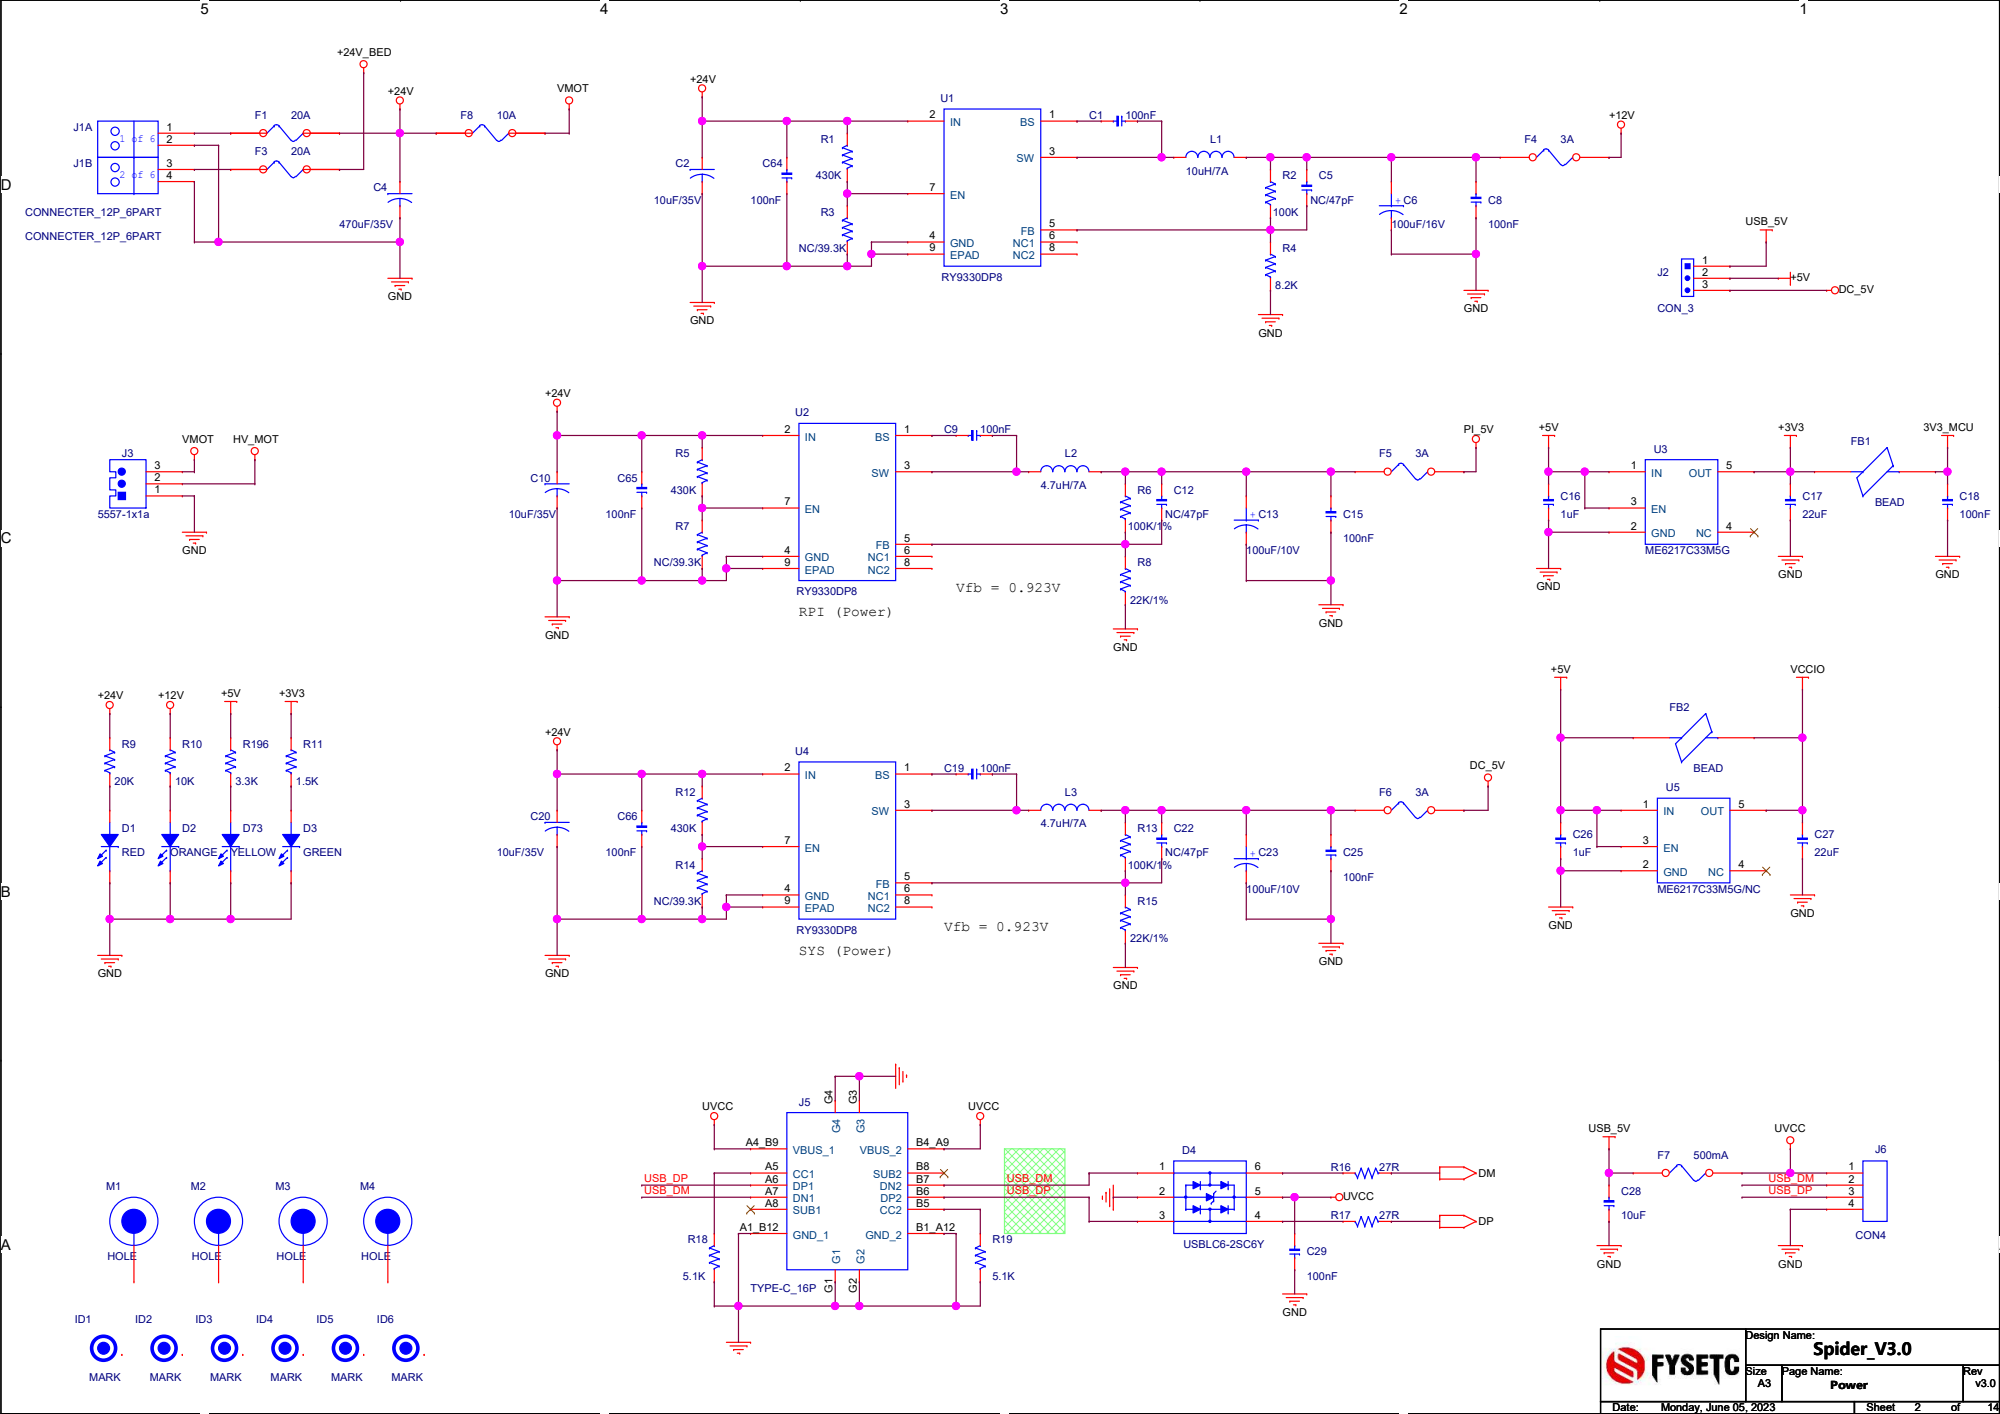
[picture p86: page 16]

5

4

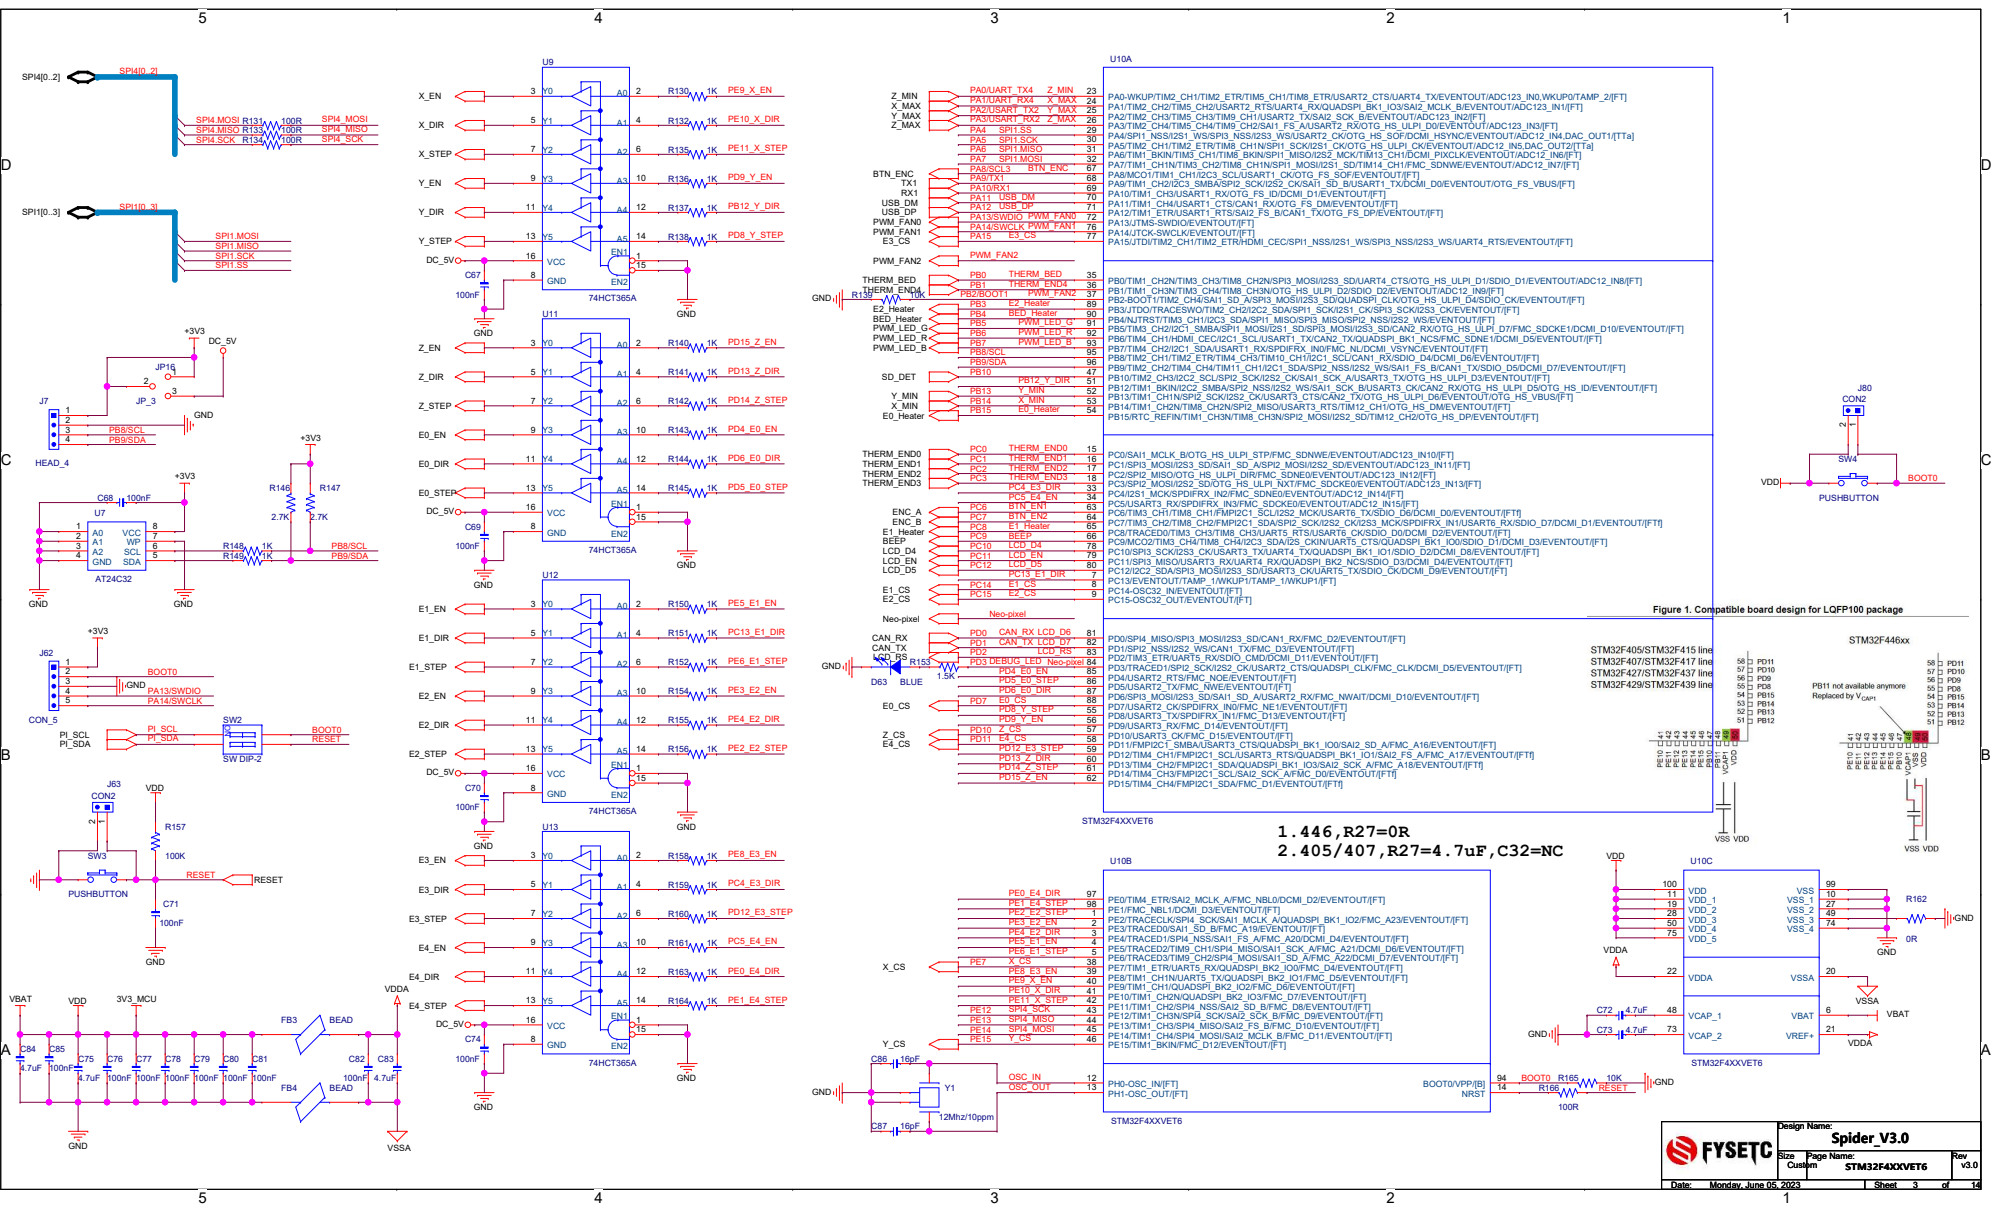
[picture p87: page 17]
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

D D

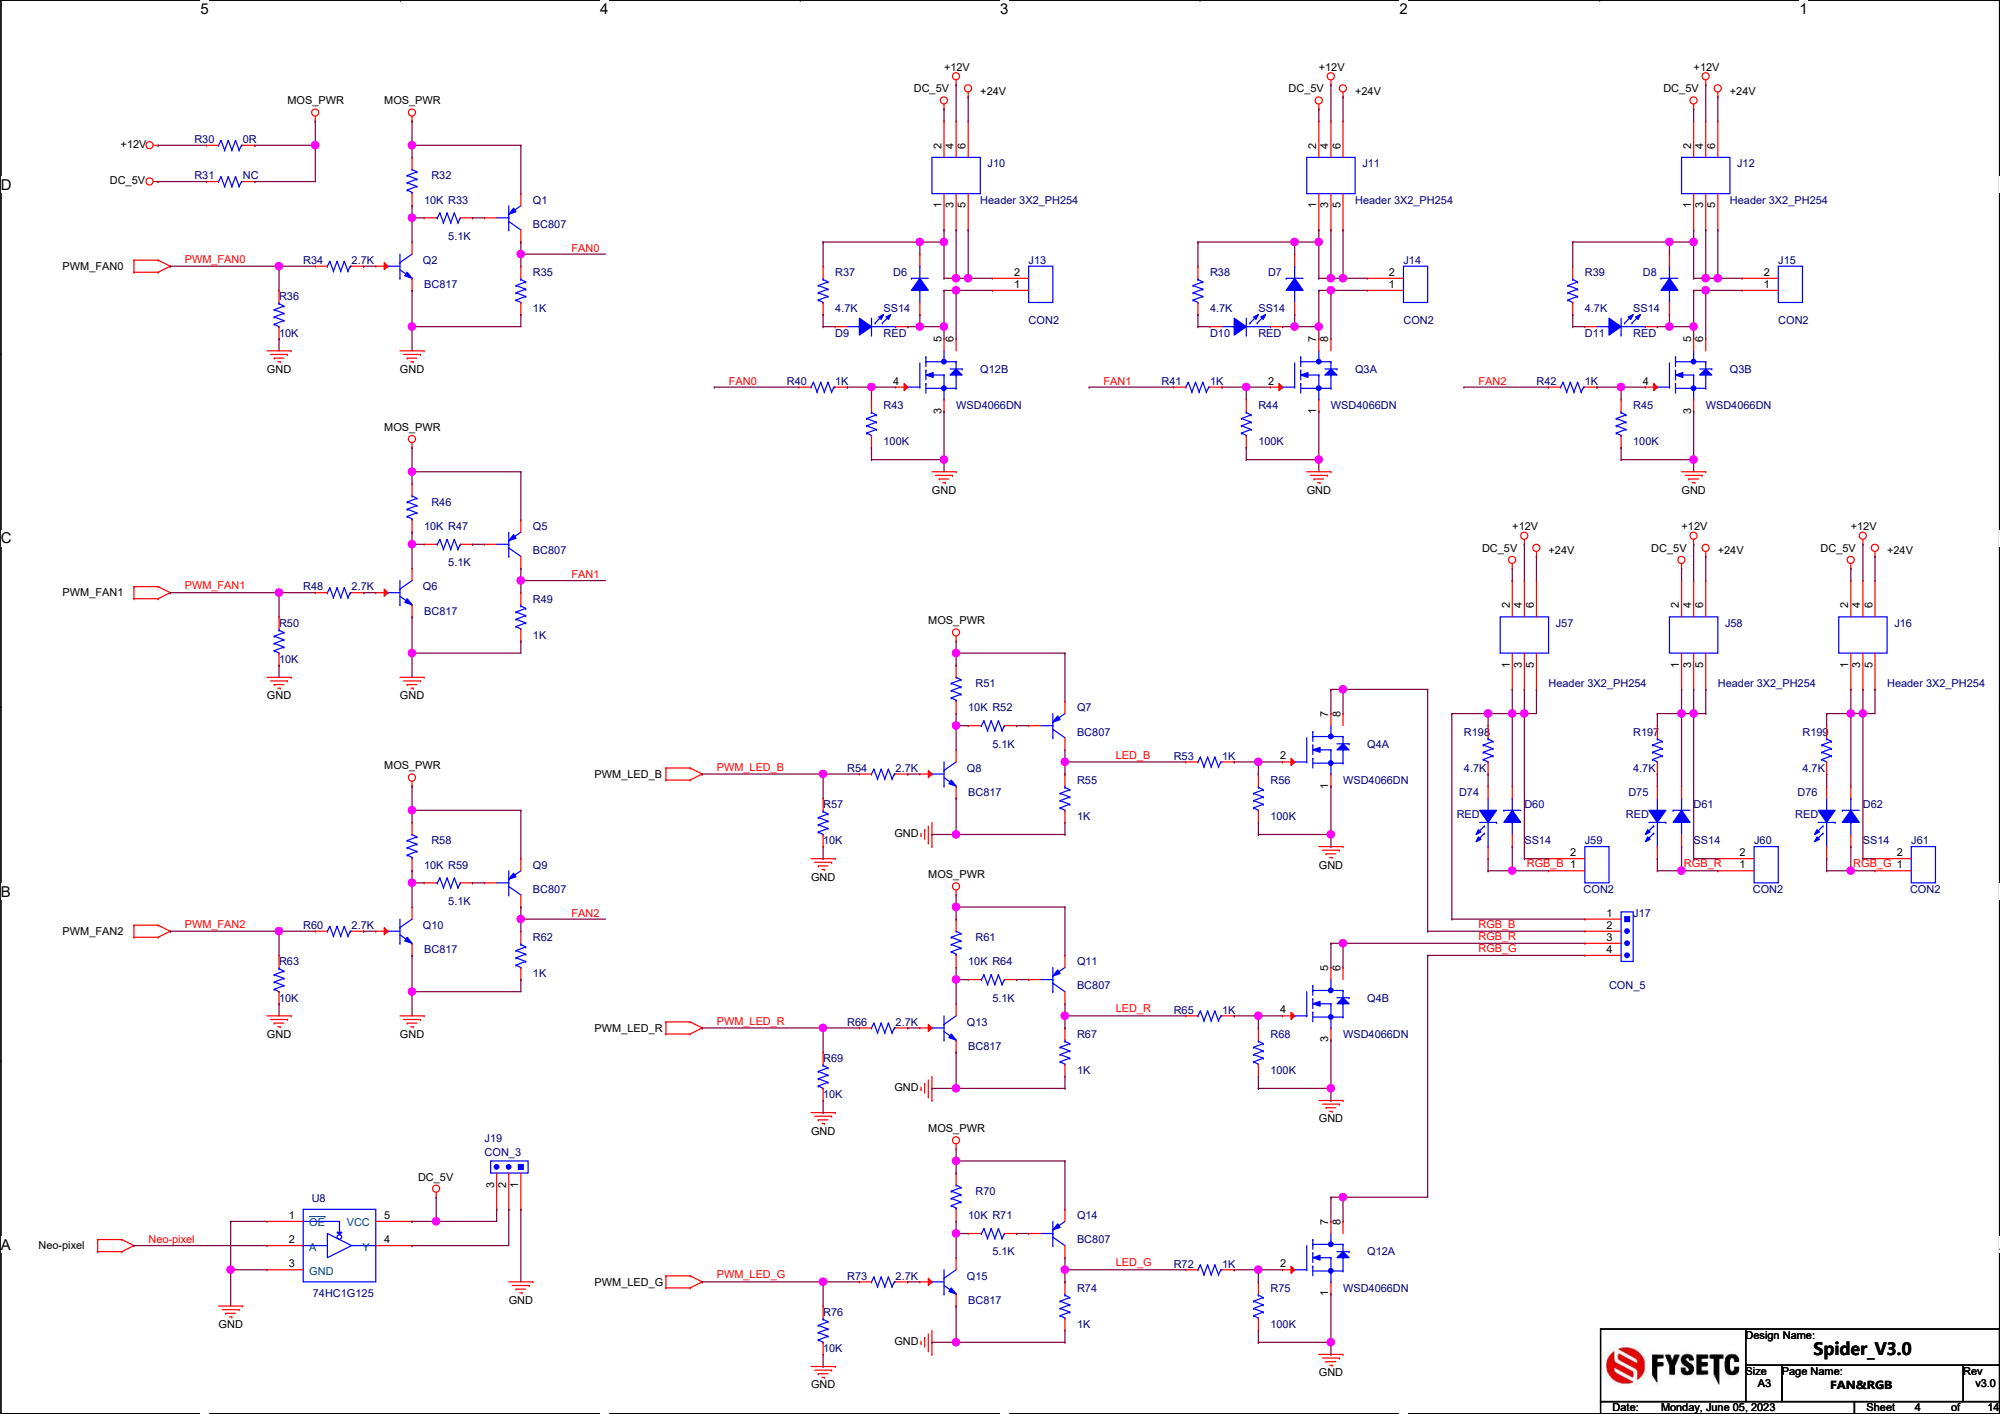
[picture p88: page 18]

D D

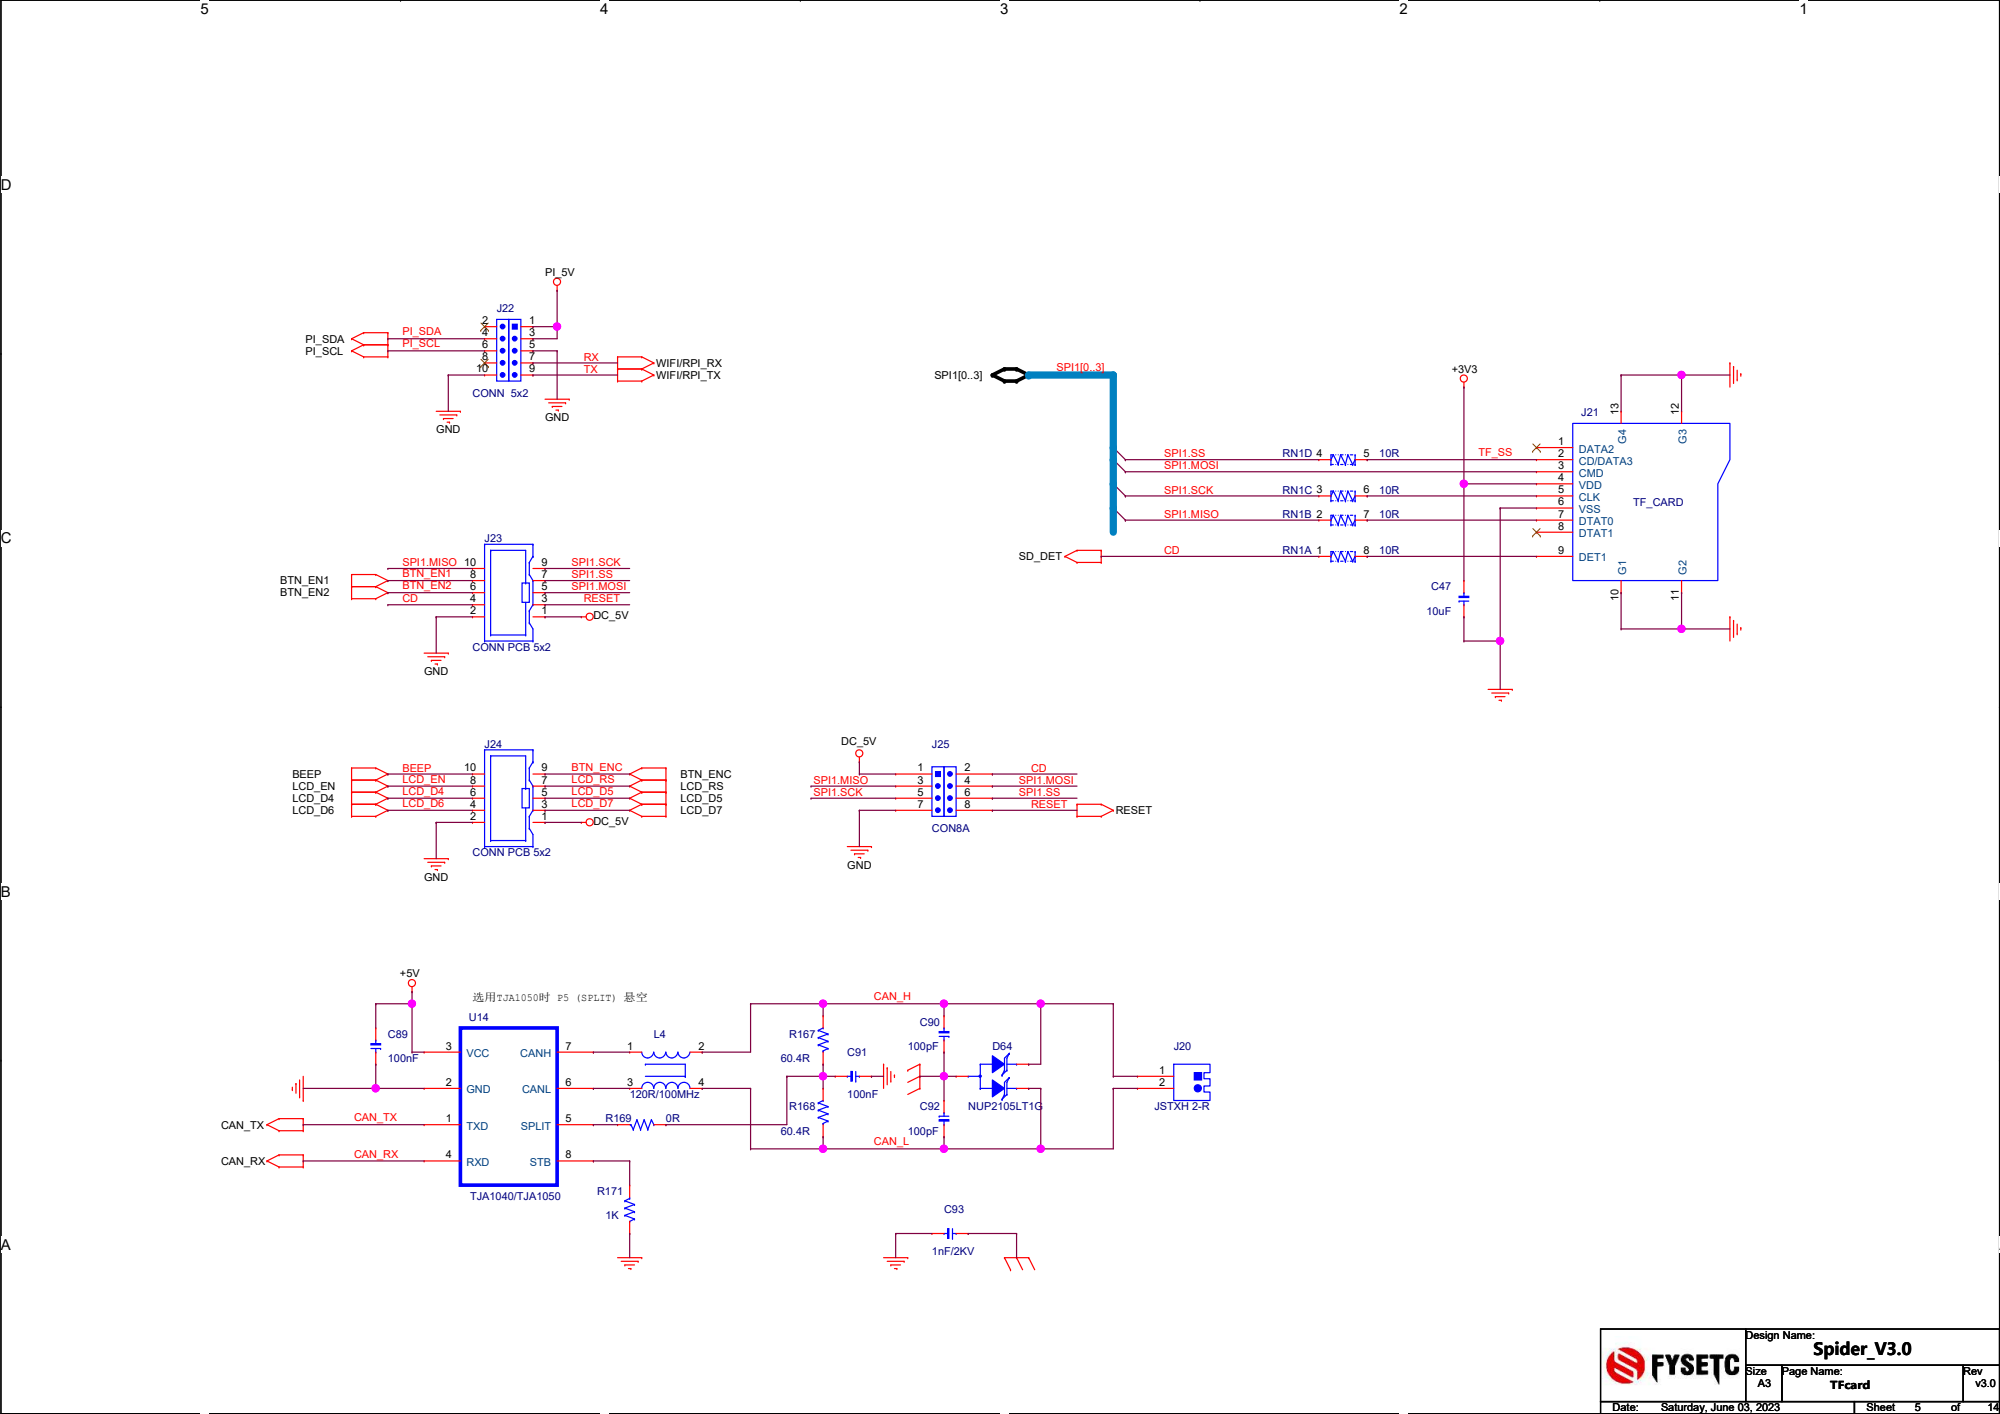
[picture p89: page 19]

D D

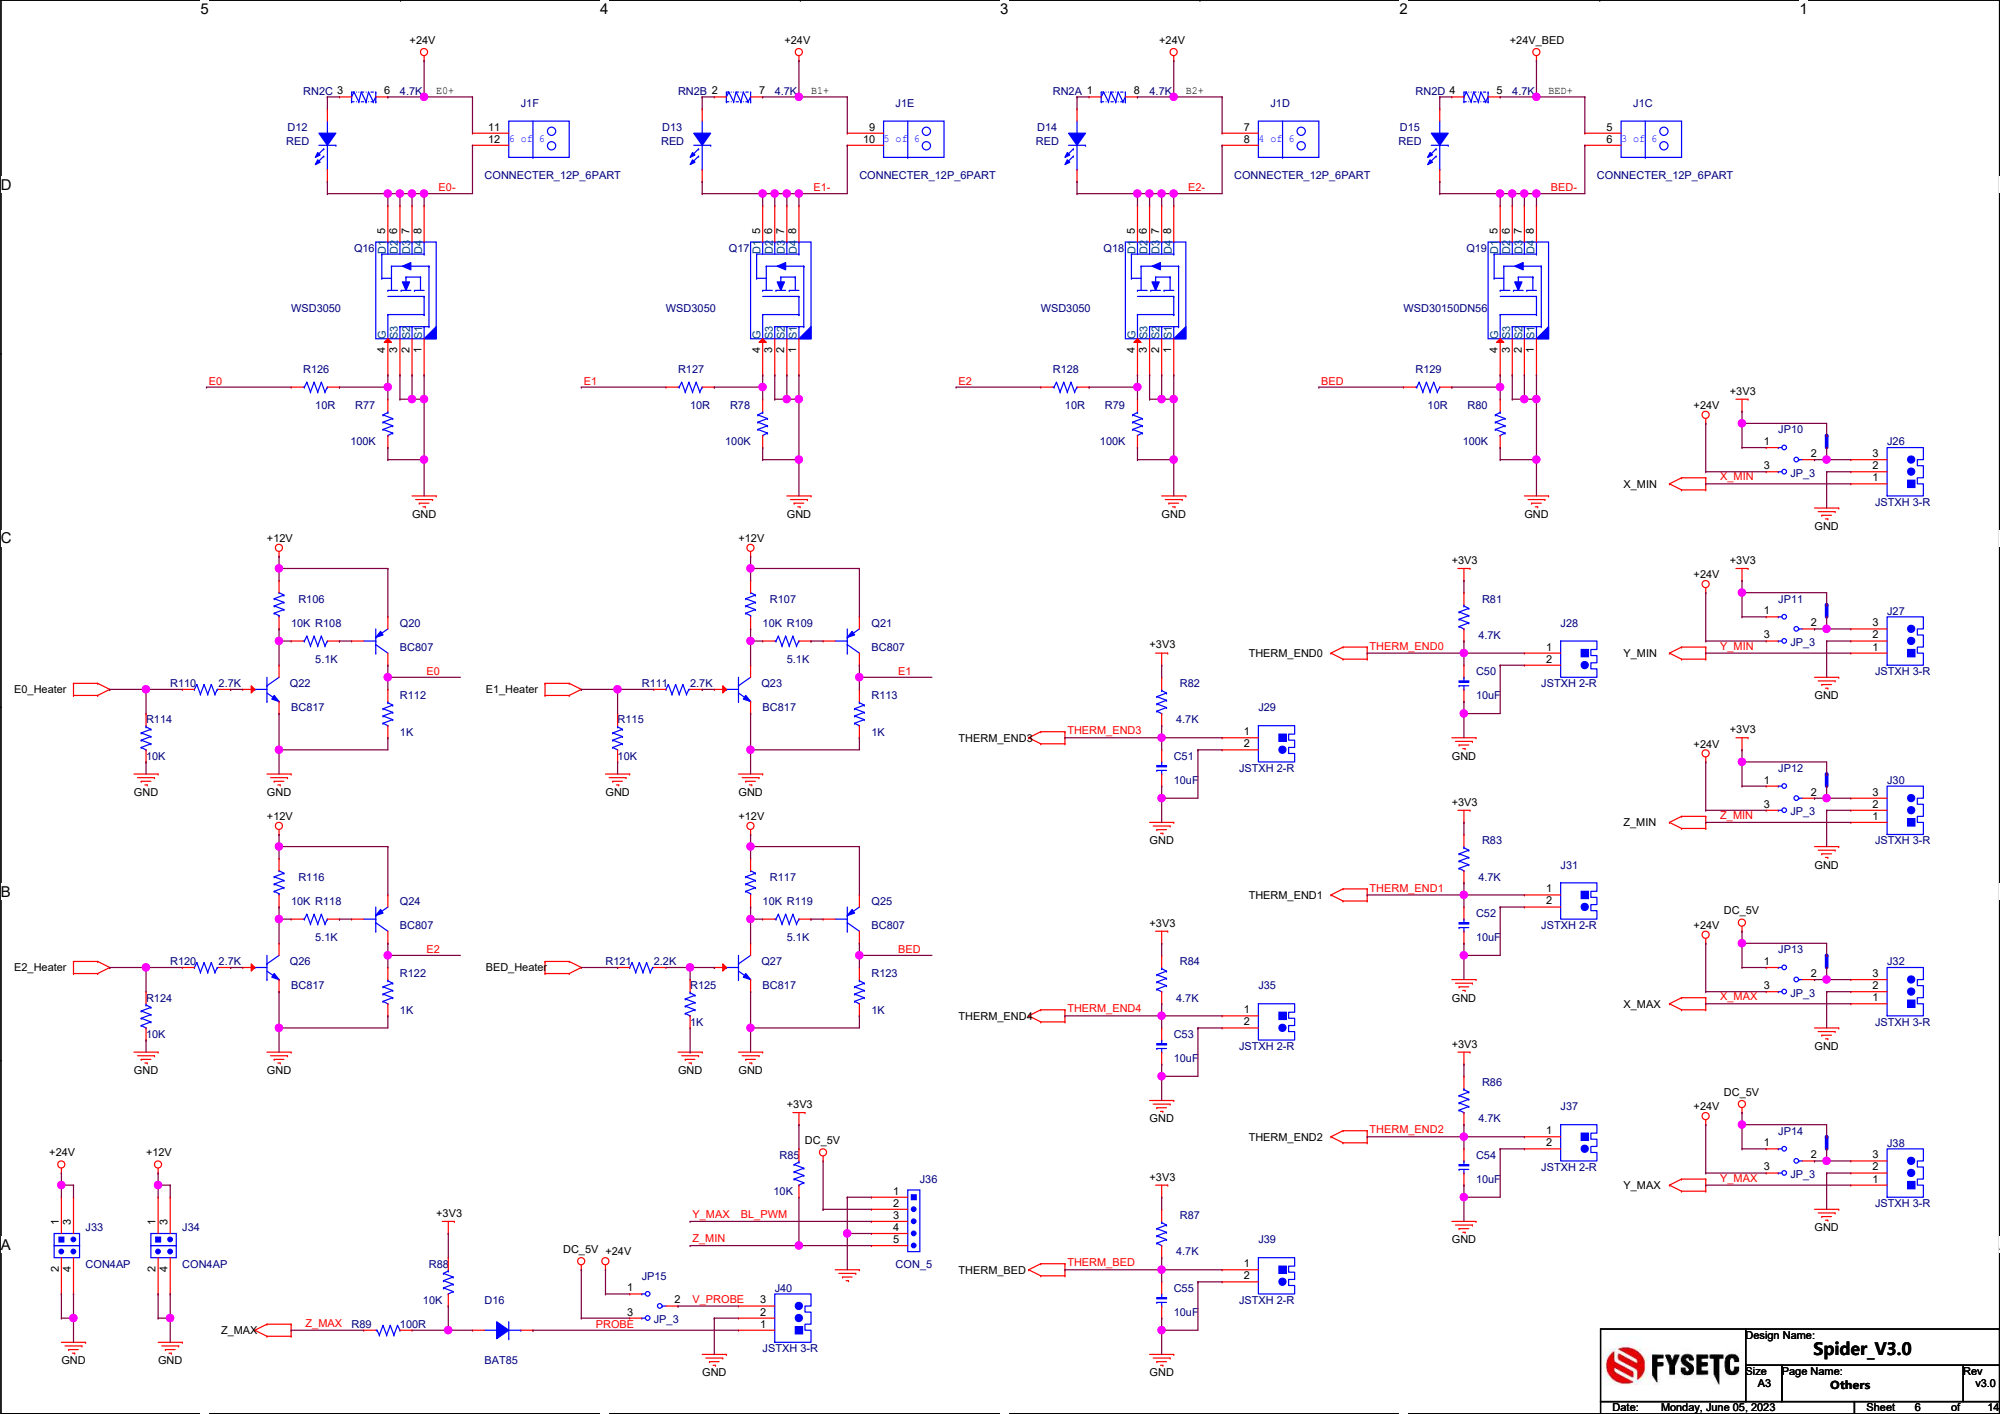
[picture p90: page 20]

D D

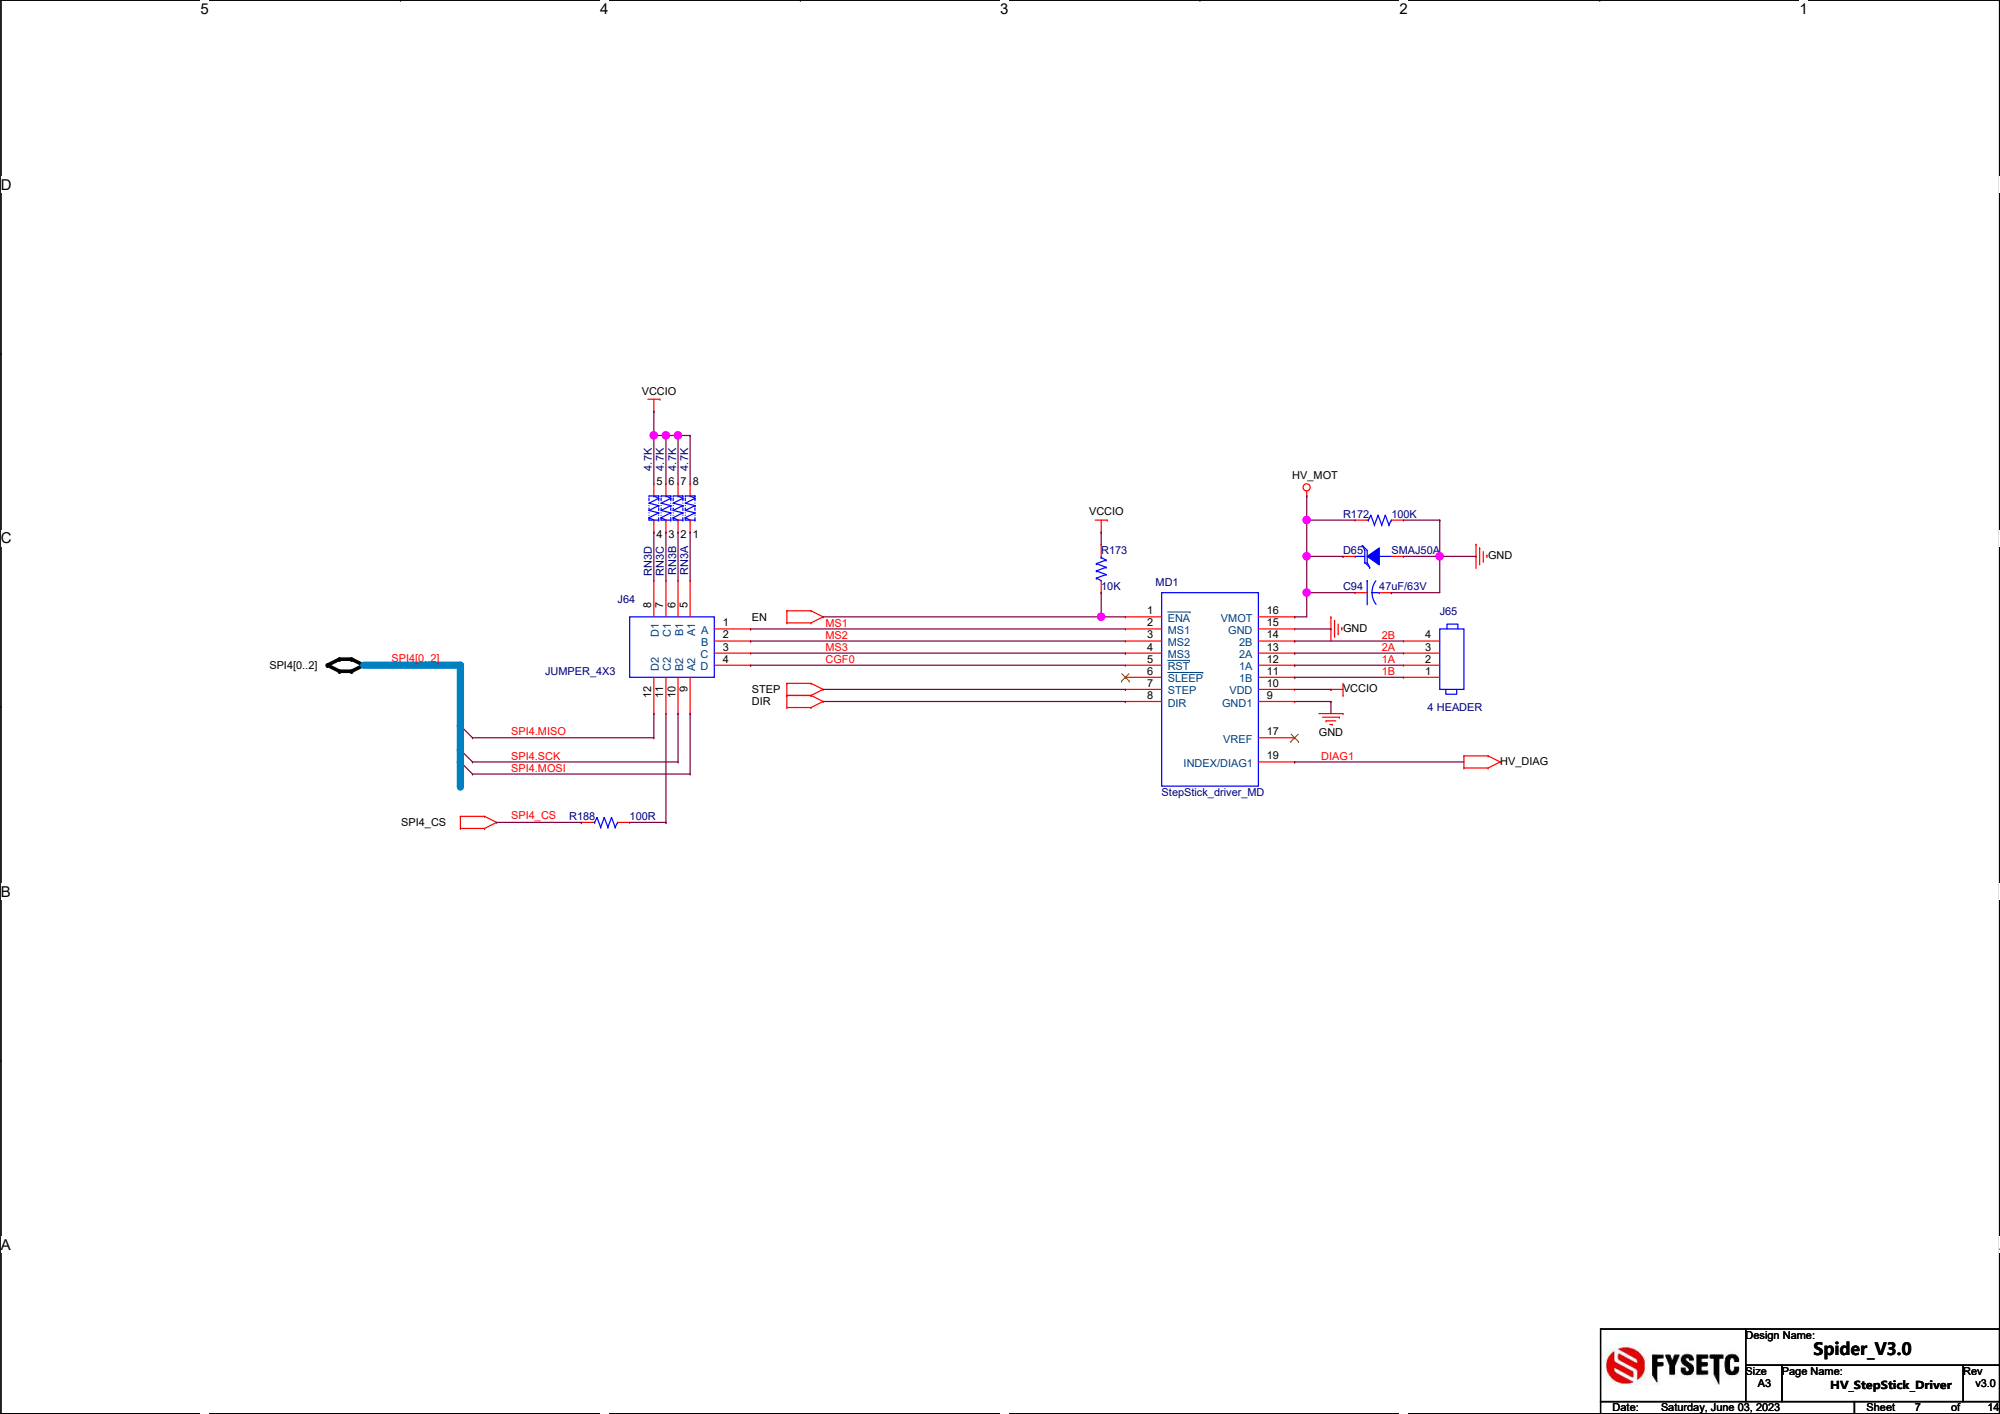
[picture p91: page 21]

D D

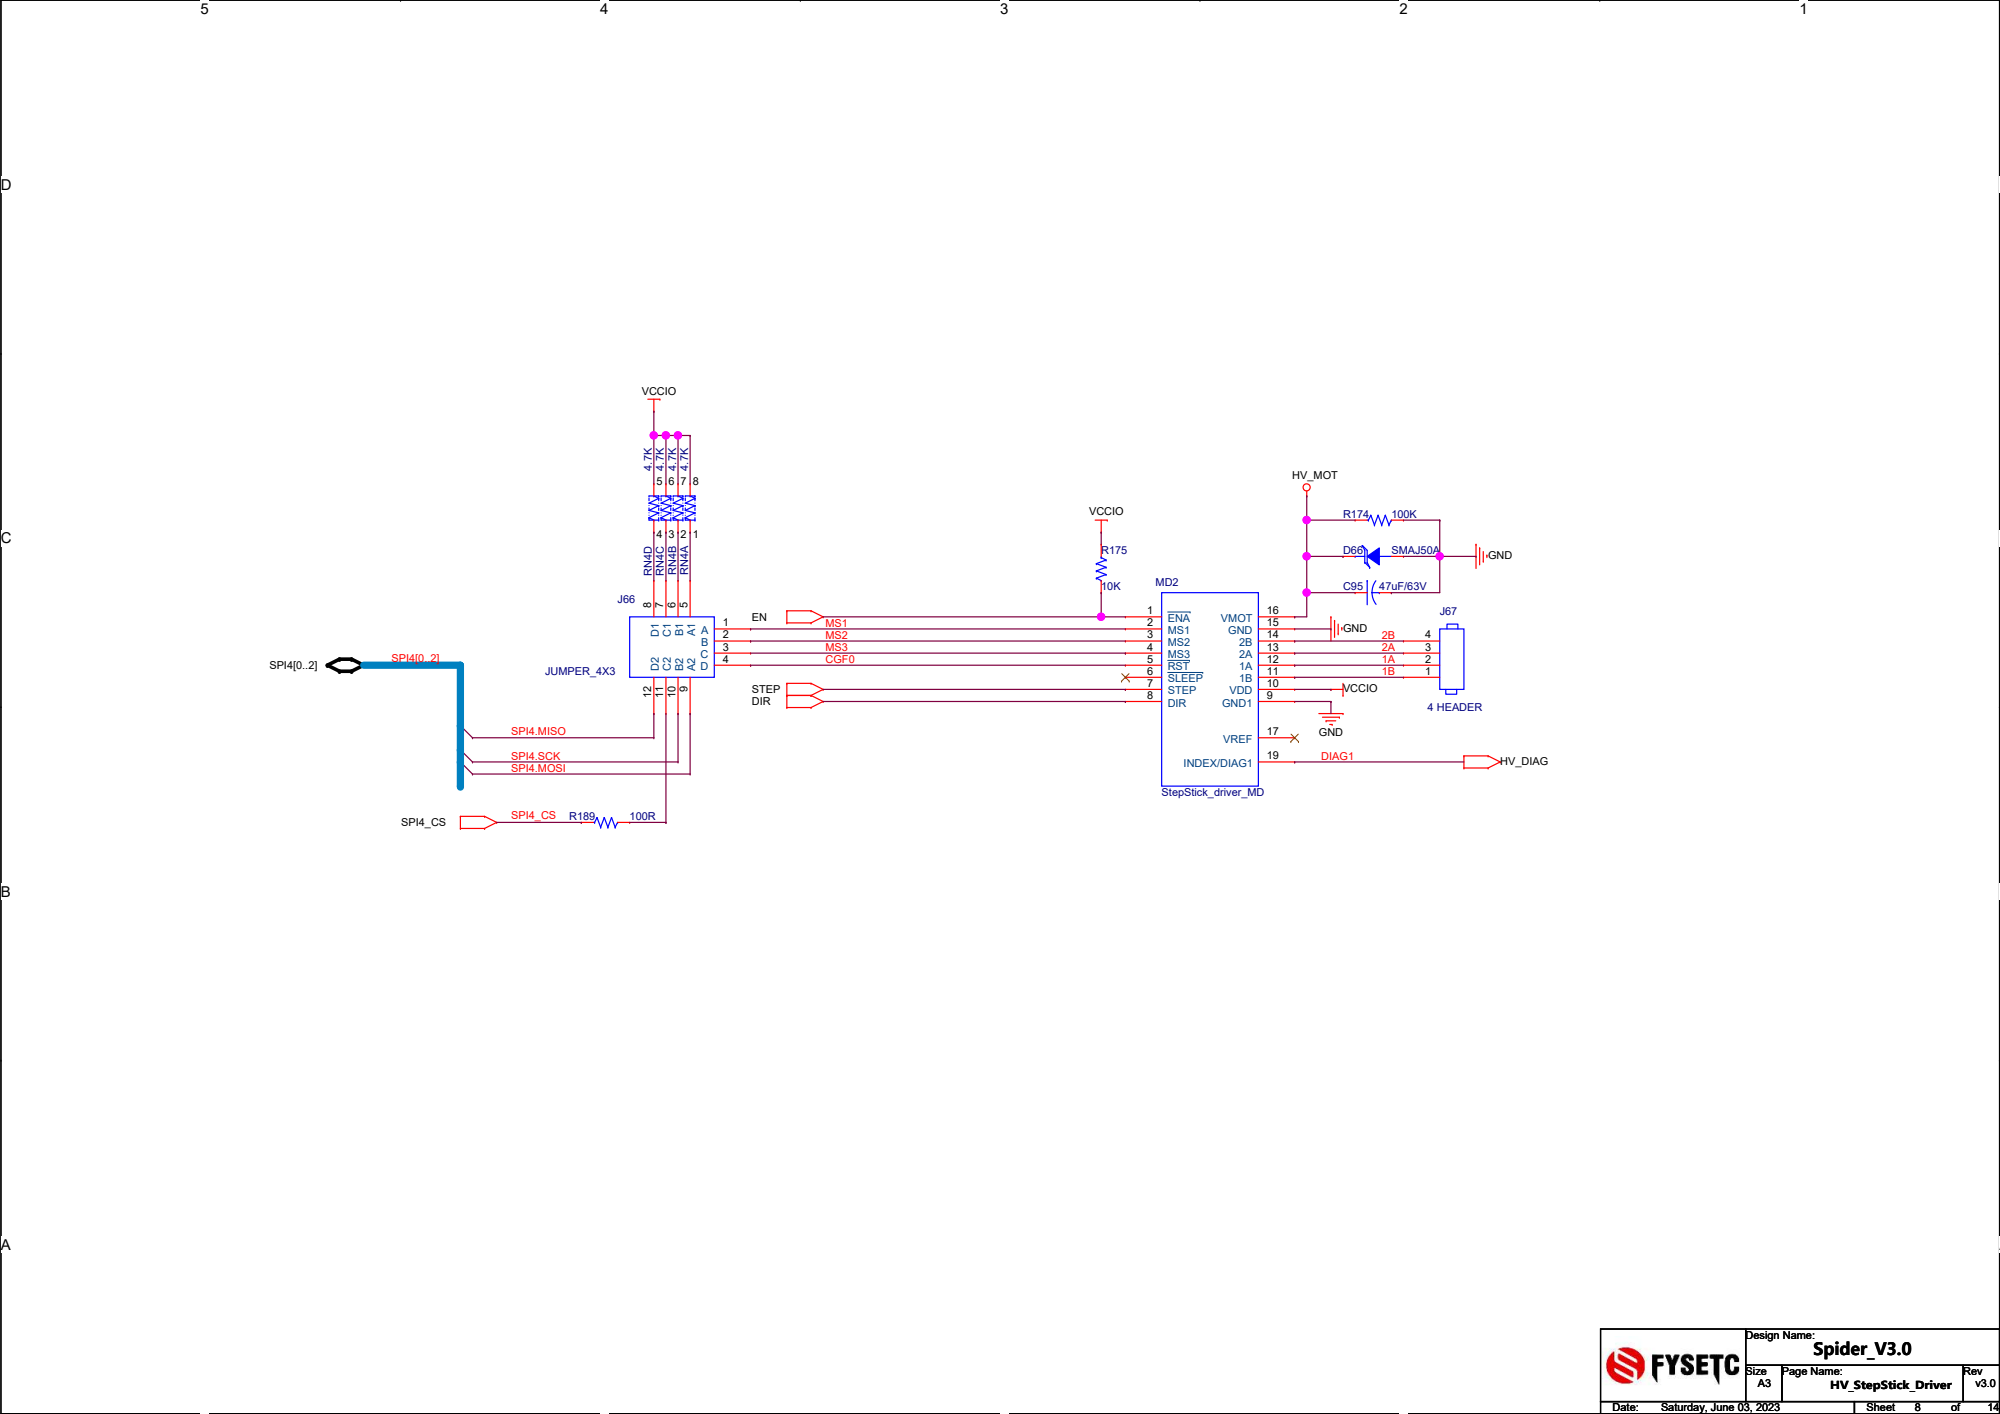
[picture p92: page 22]

D D

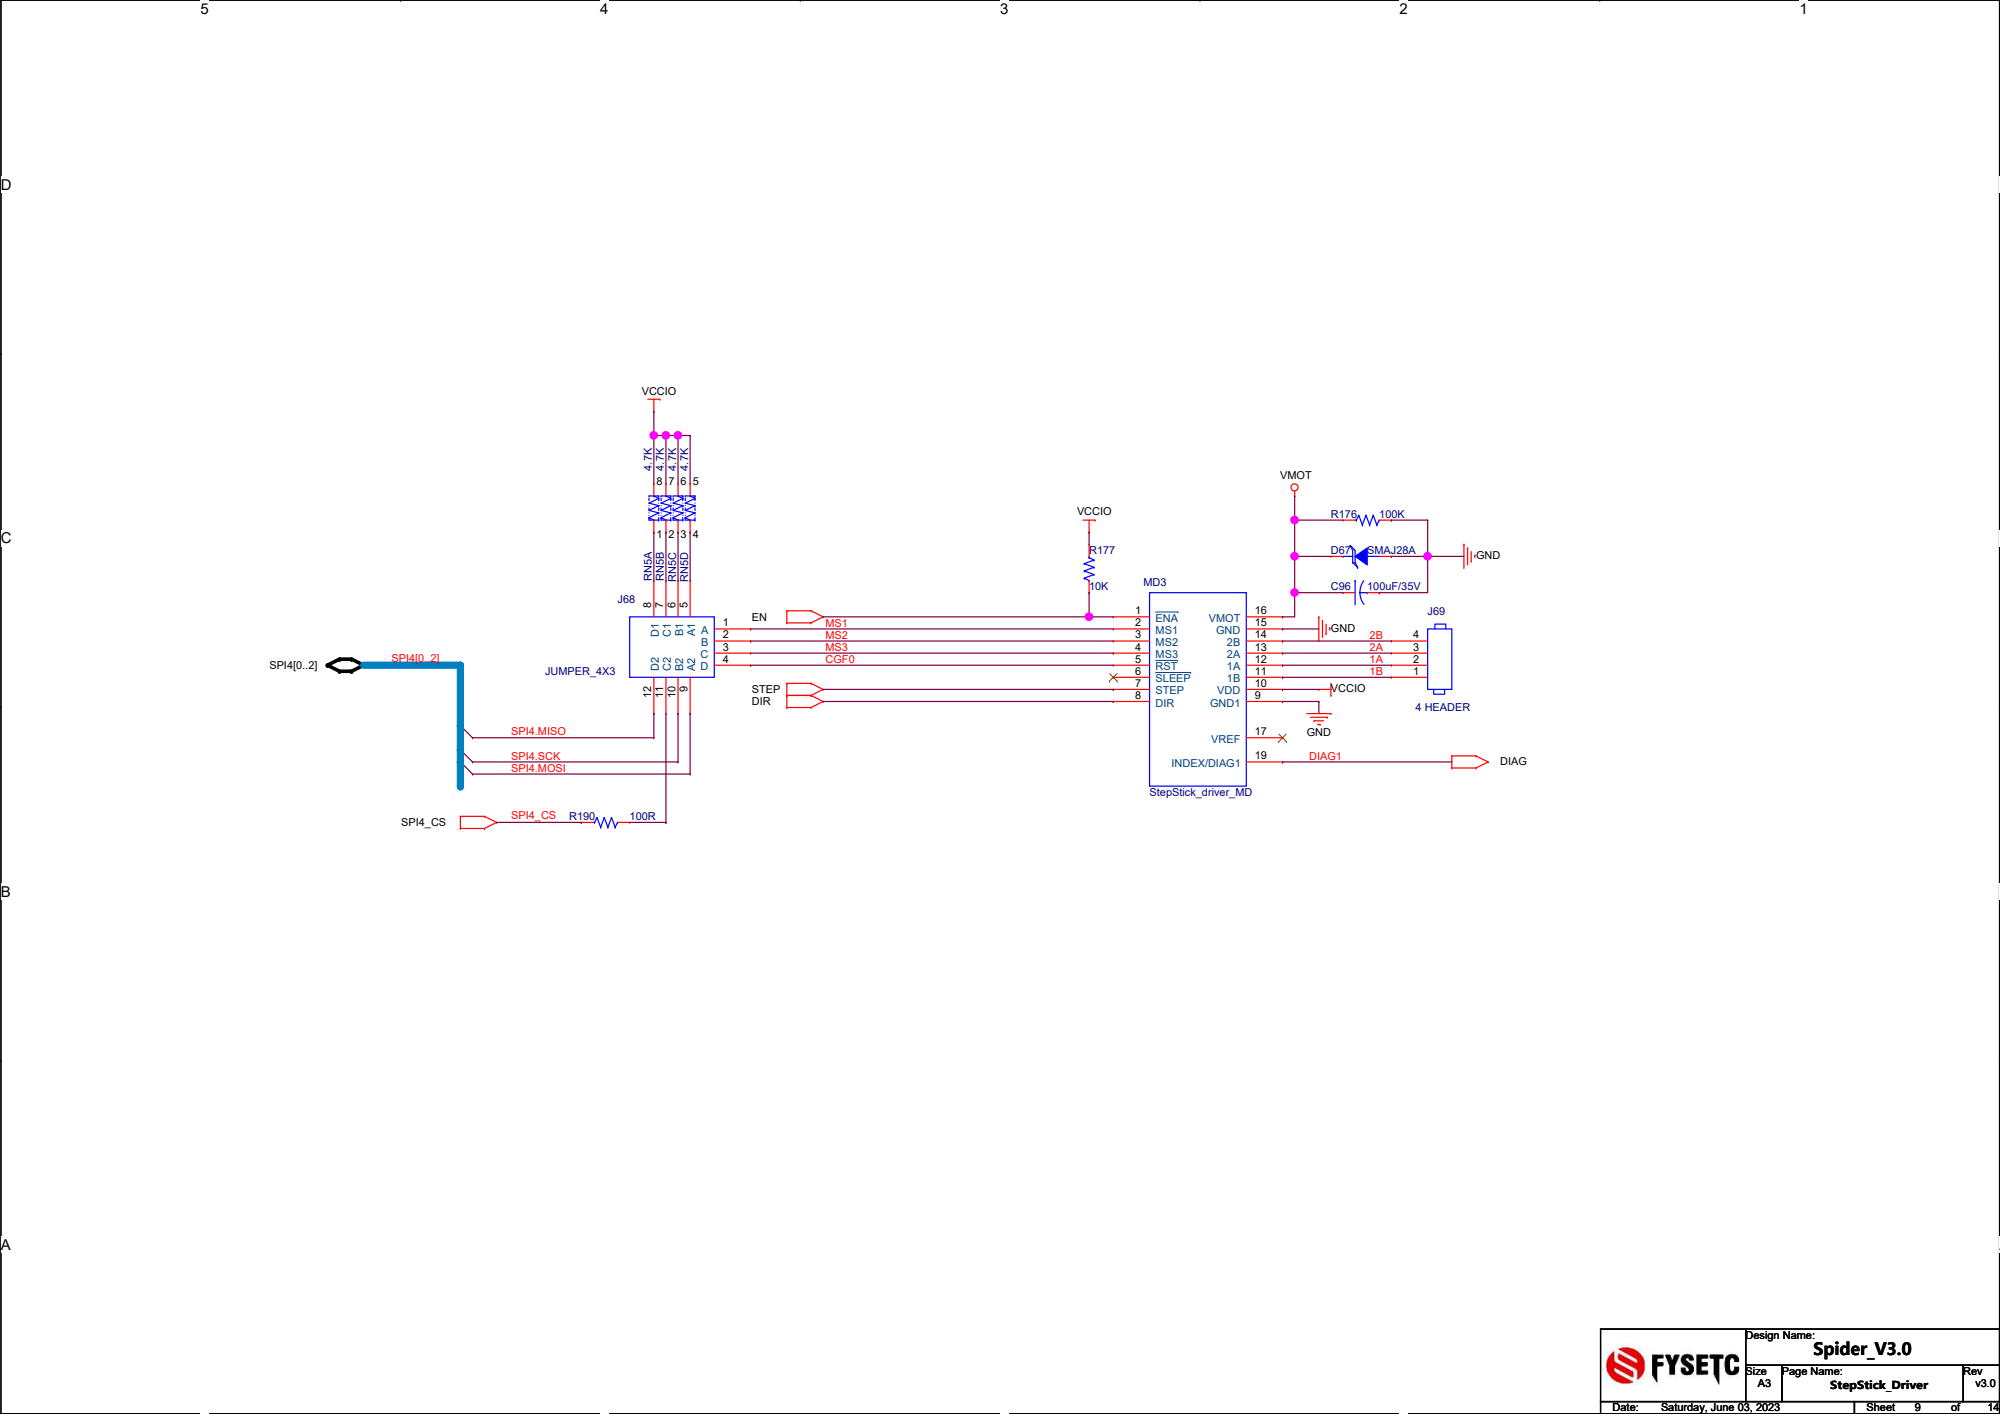
[picture p93: page 23]

D D

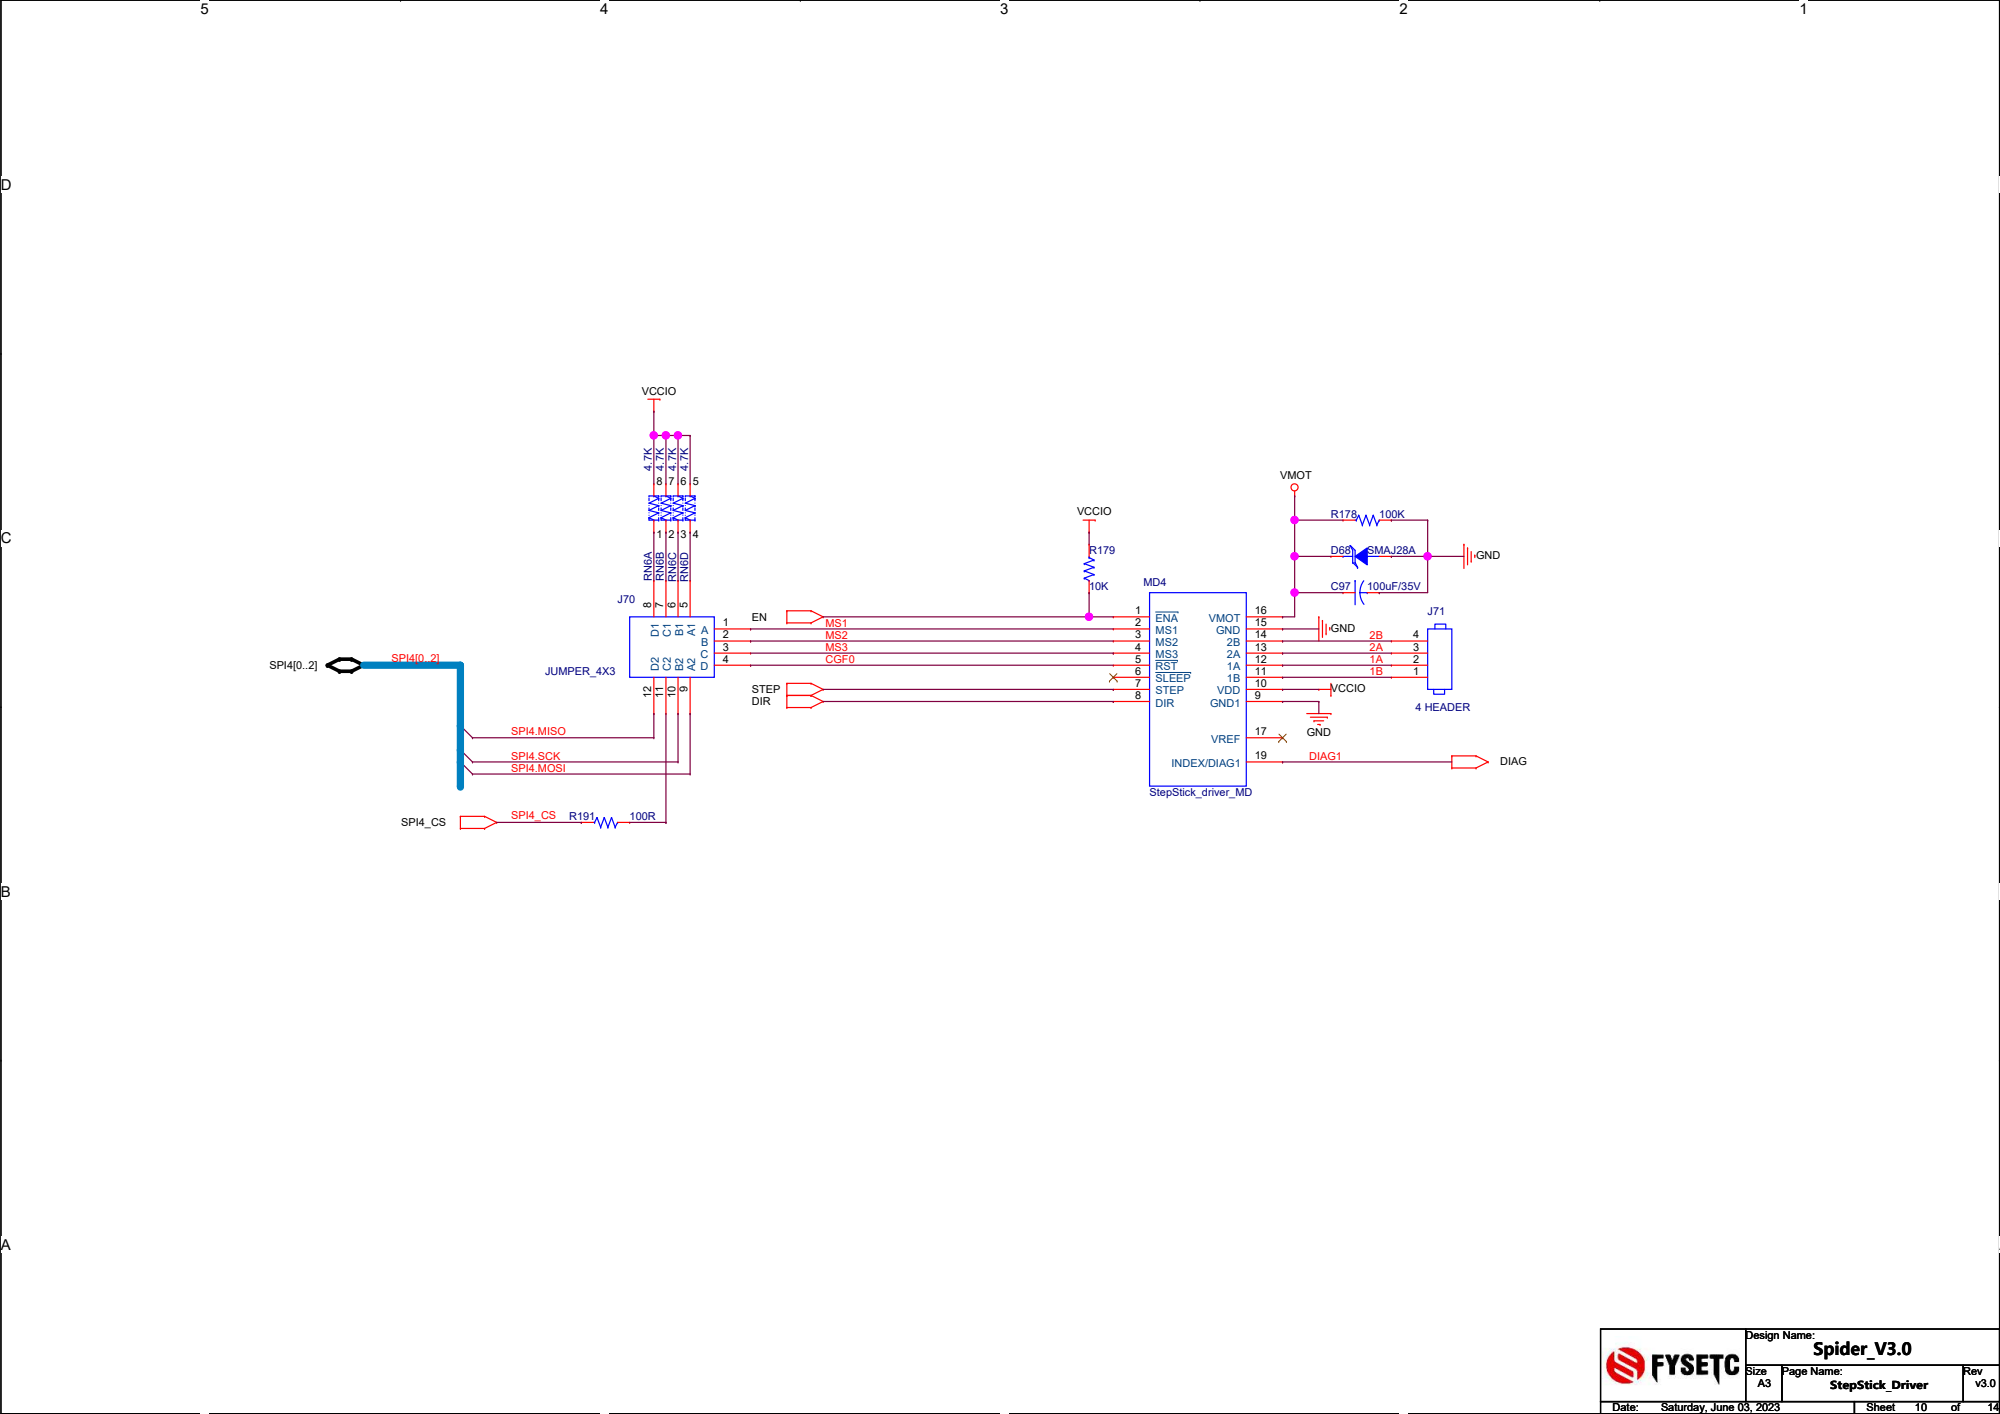
[picture p94: page 24]

D D

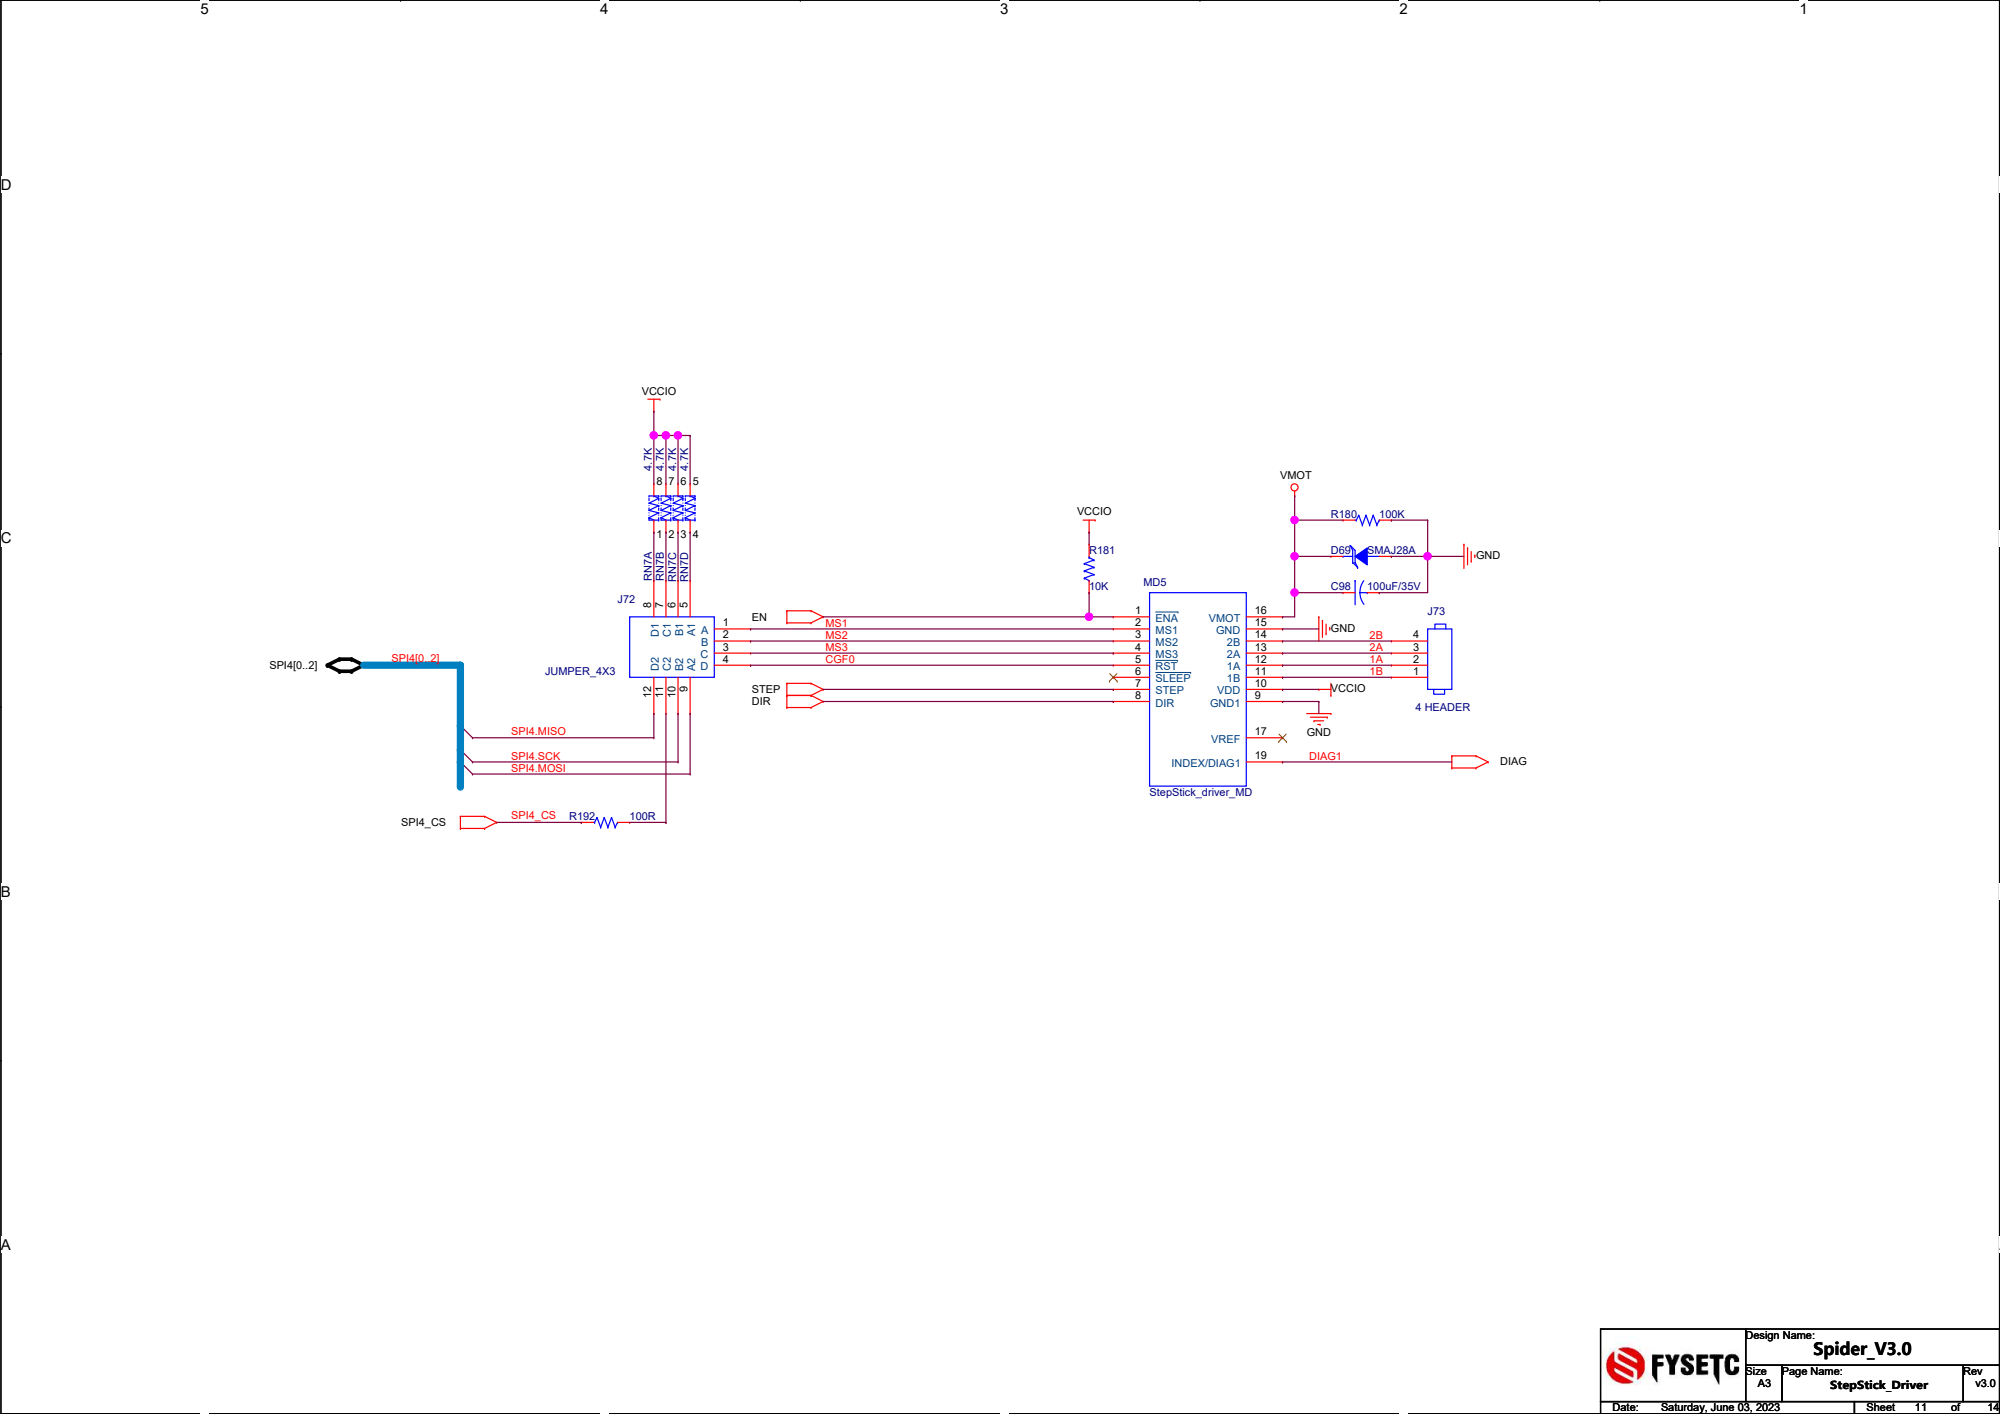
[picture p95: page 25]

D D

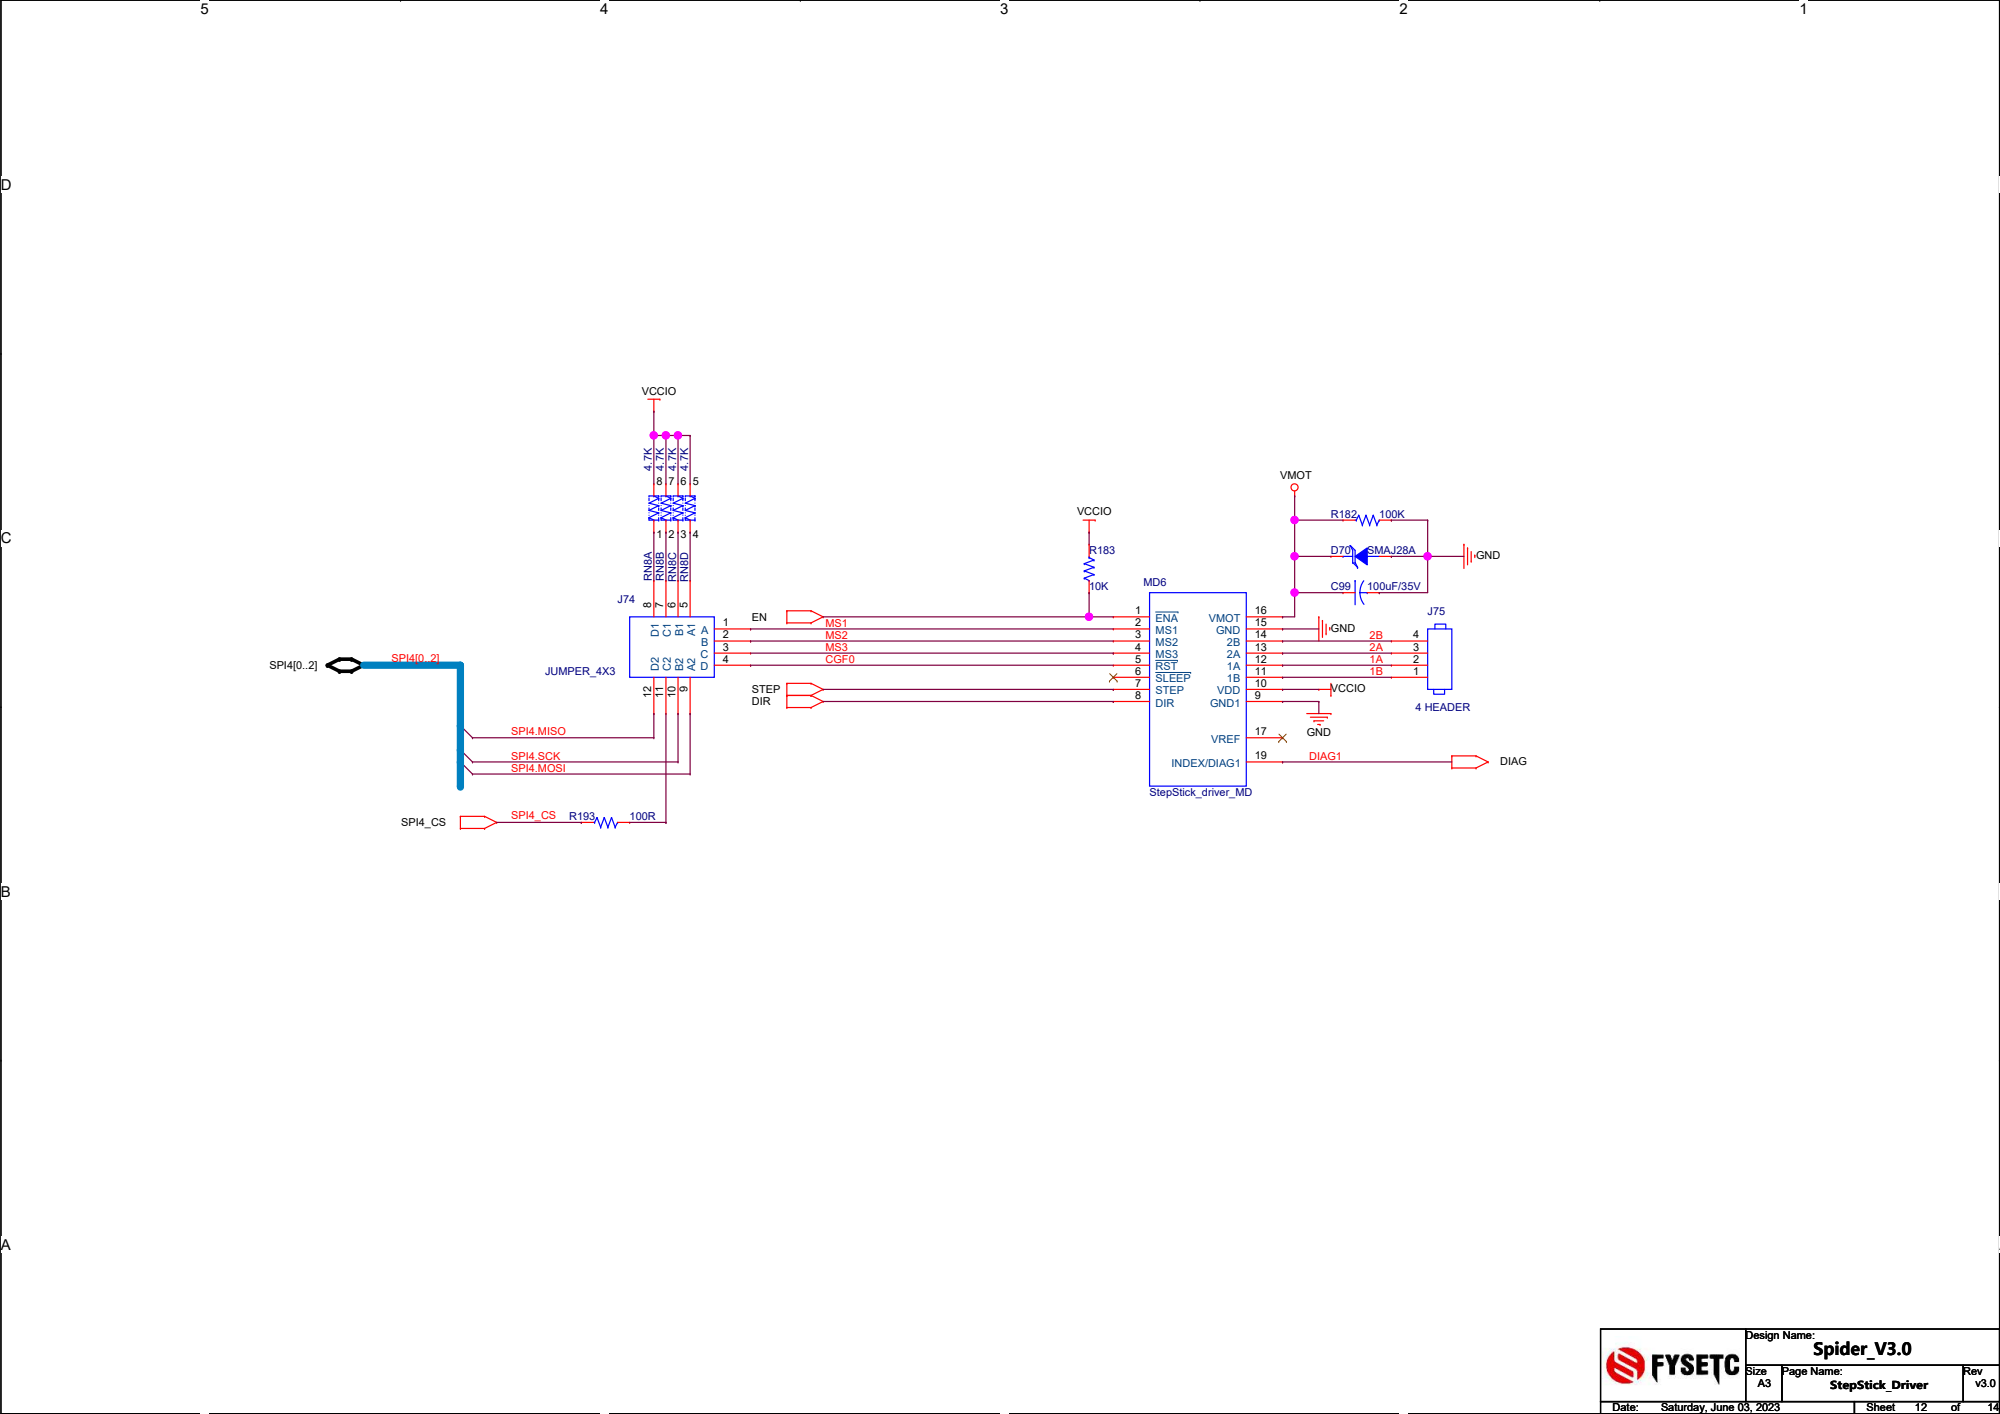
[picture p96: page 26]

D D

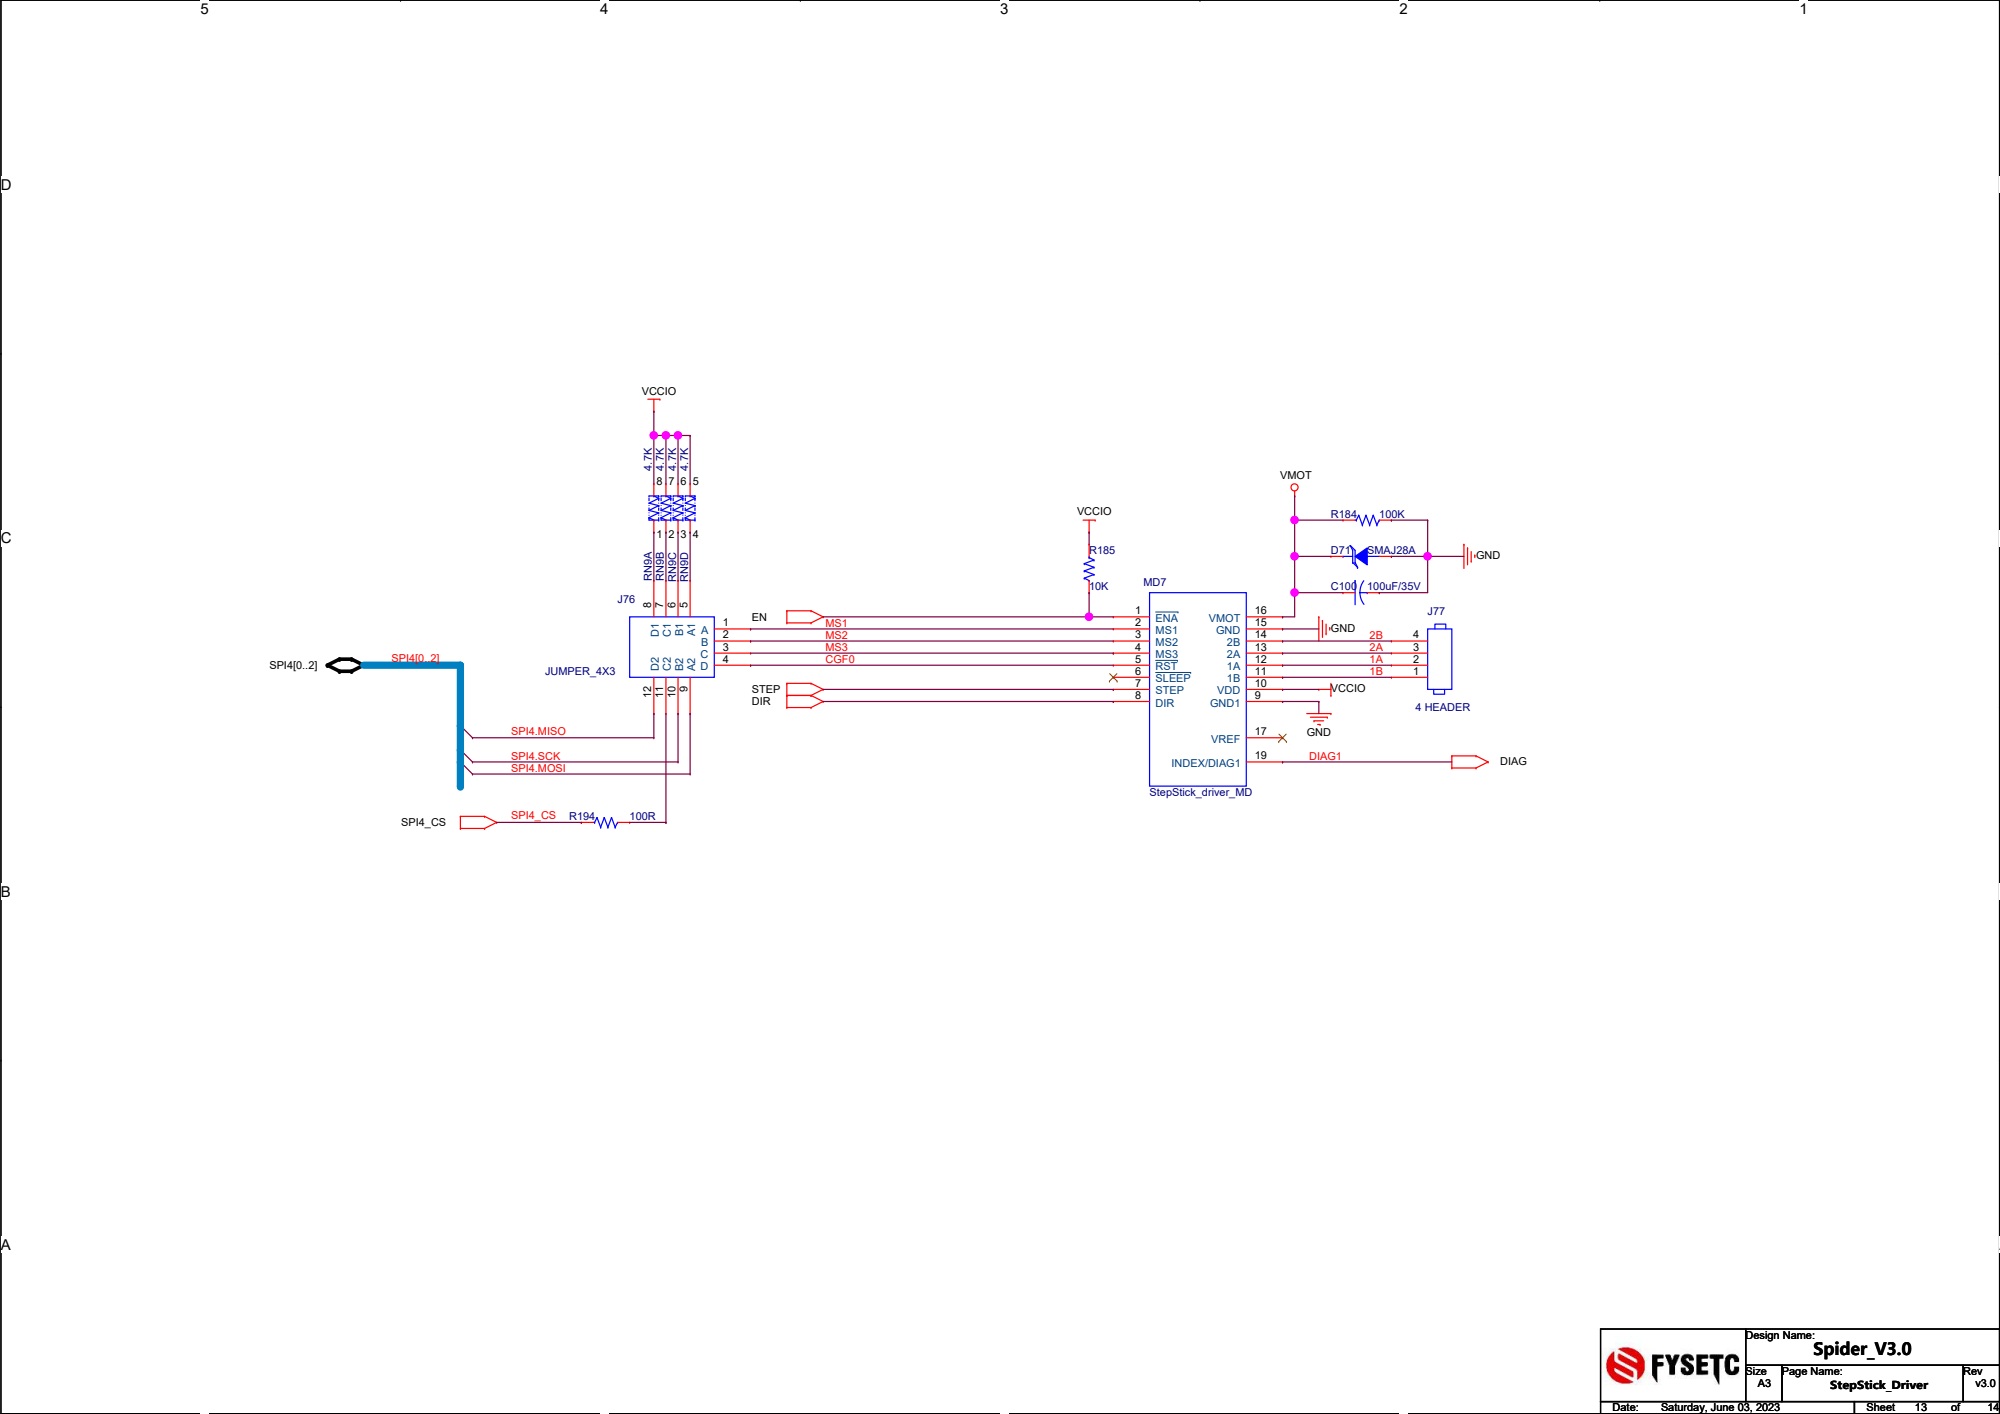
[picture p97: page 27]

D D

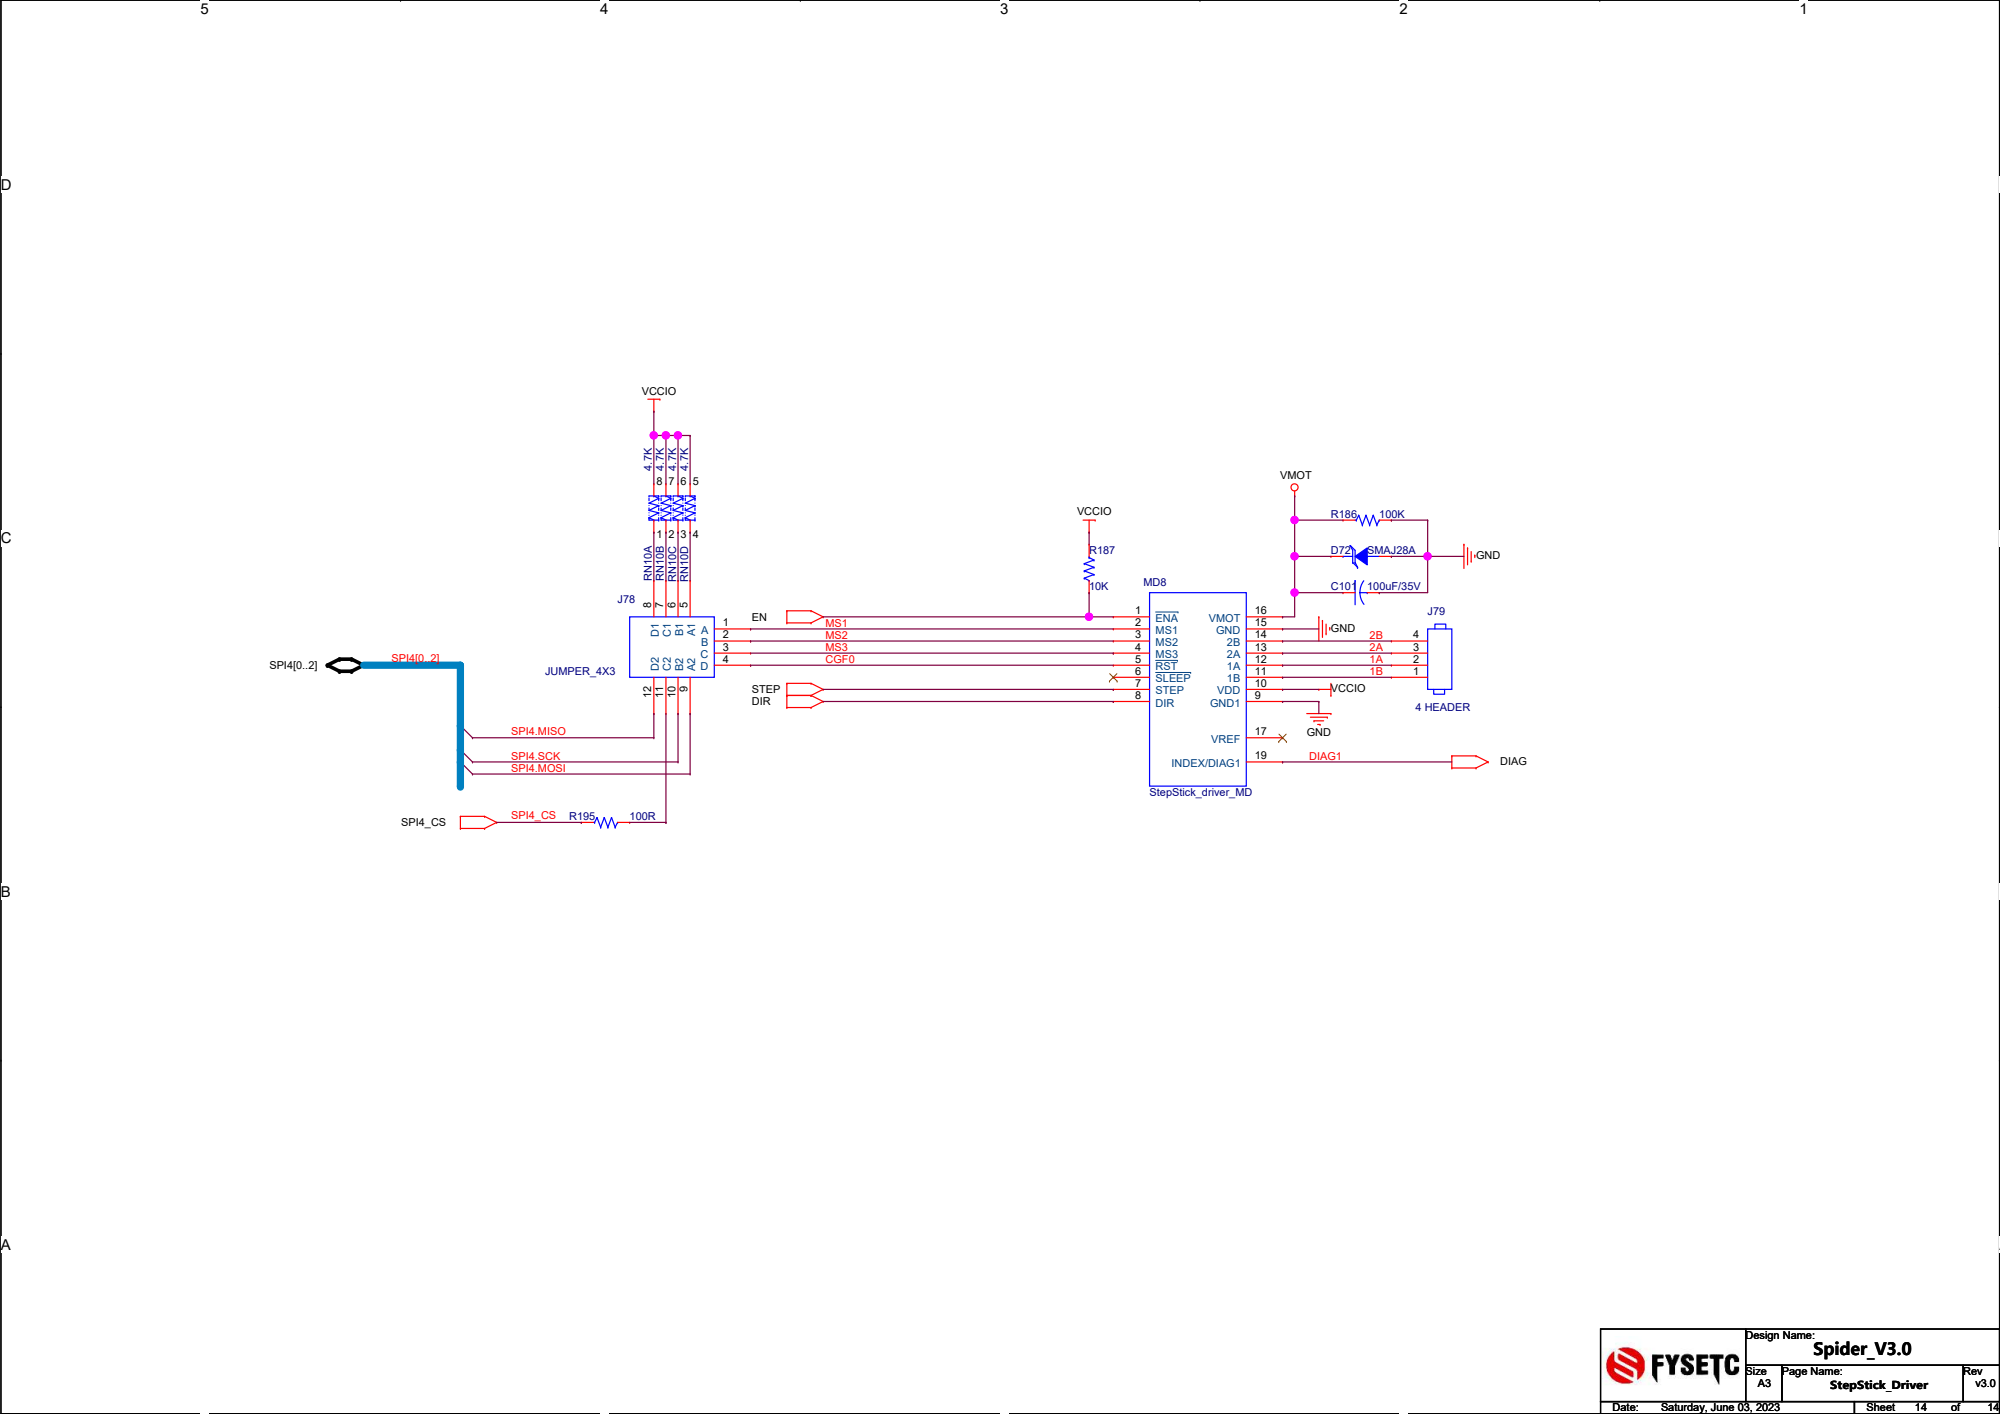
[picture p98: page 28]
