FYSETC/FYSETC-SPIDER/hardware/V3.0/蜘蛛V3.0接线图简化.pdf

## Z0电机

## Z1电机

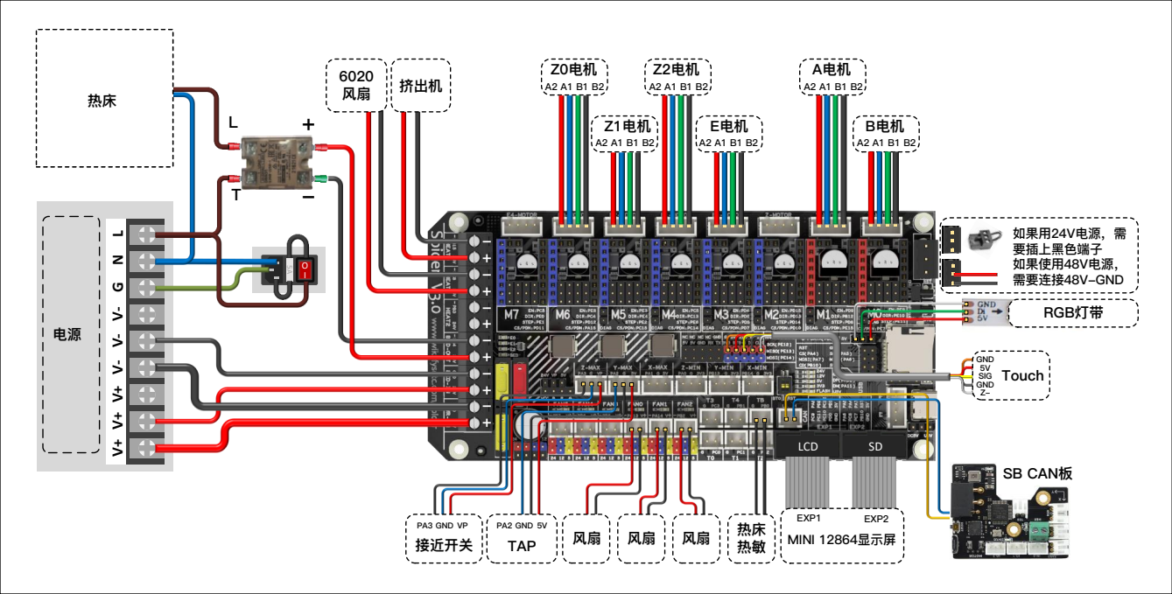
[picture p99: page 1]
E电机; A电机; B电机; 如果用24V电源，需 要插上黑色端子 如果使用48V电源， 需要连接48V-GND; LCD; EXP1; EXP2; MINI 12864显示屏; 挤出机; RGB灯带; Touch; 接近开关; TAP; GND 5V SIG GND Z-; PA3 GND VP; PA2 GND 5V; SB CAN板
