FYSETC/FYSETC-SPIDER/hardware/V1.x/Spider V1.0C SCH.pdf

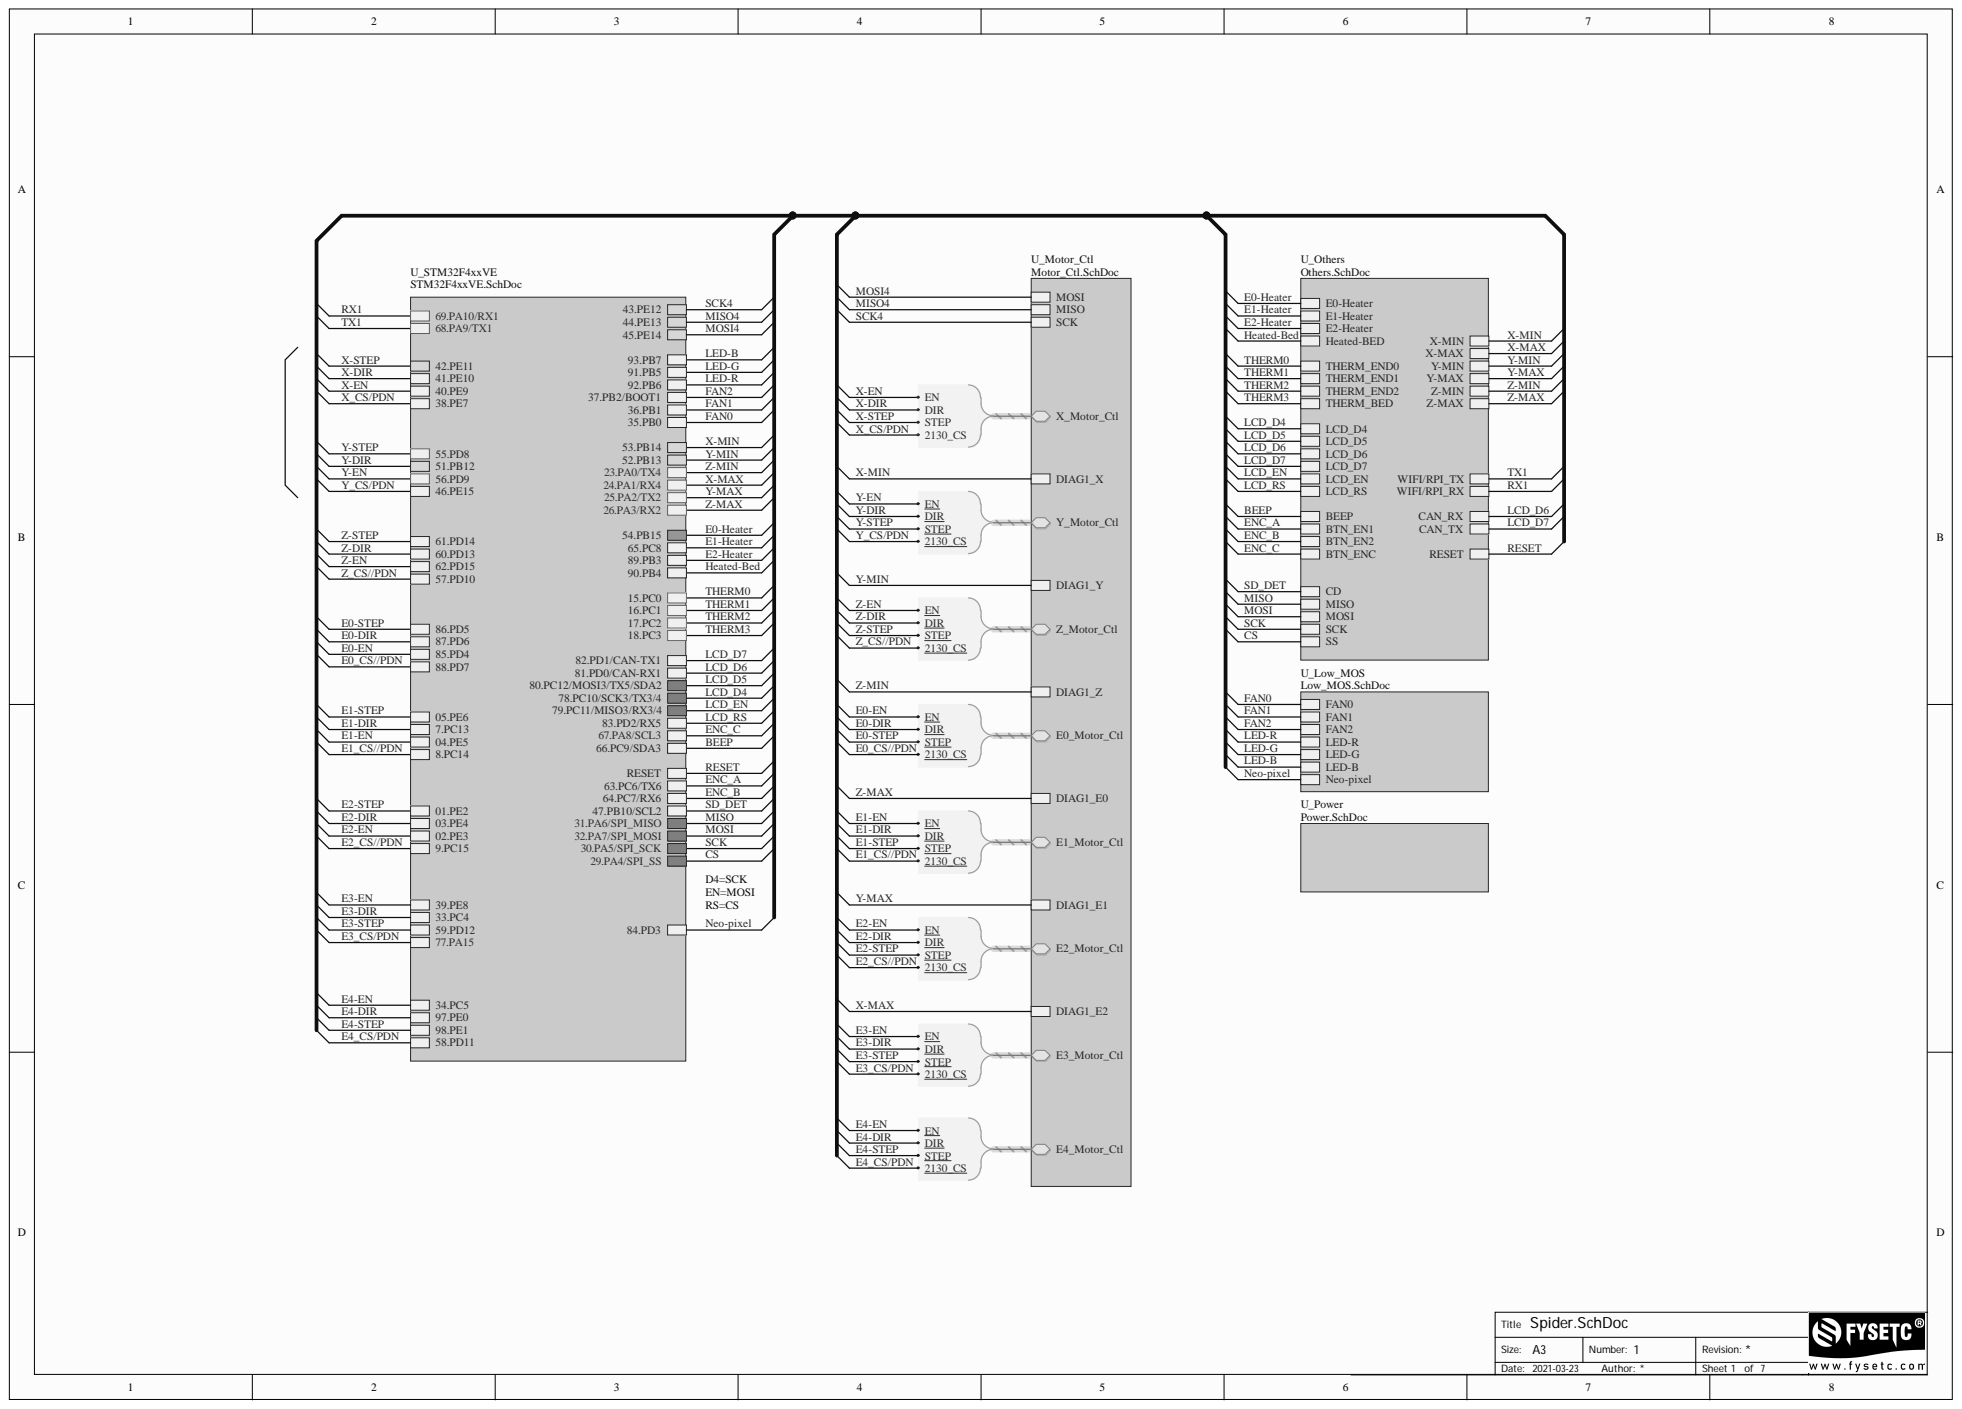
[picture p100: page 1]

Spider.SchDoc Title

Size: A3 | Number: 1 | Revision: *

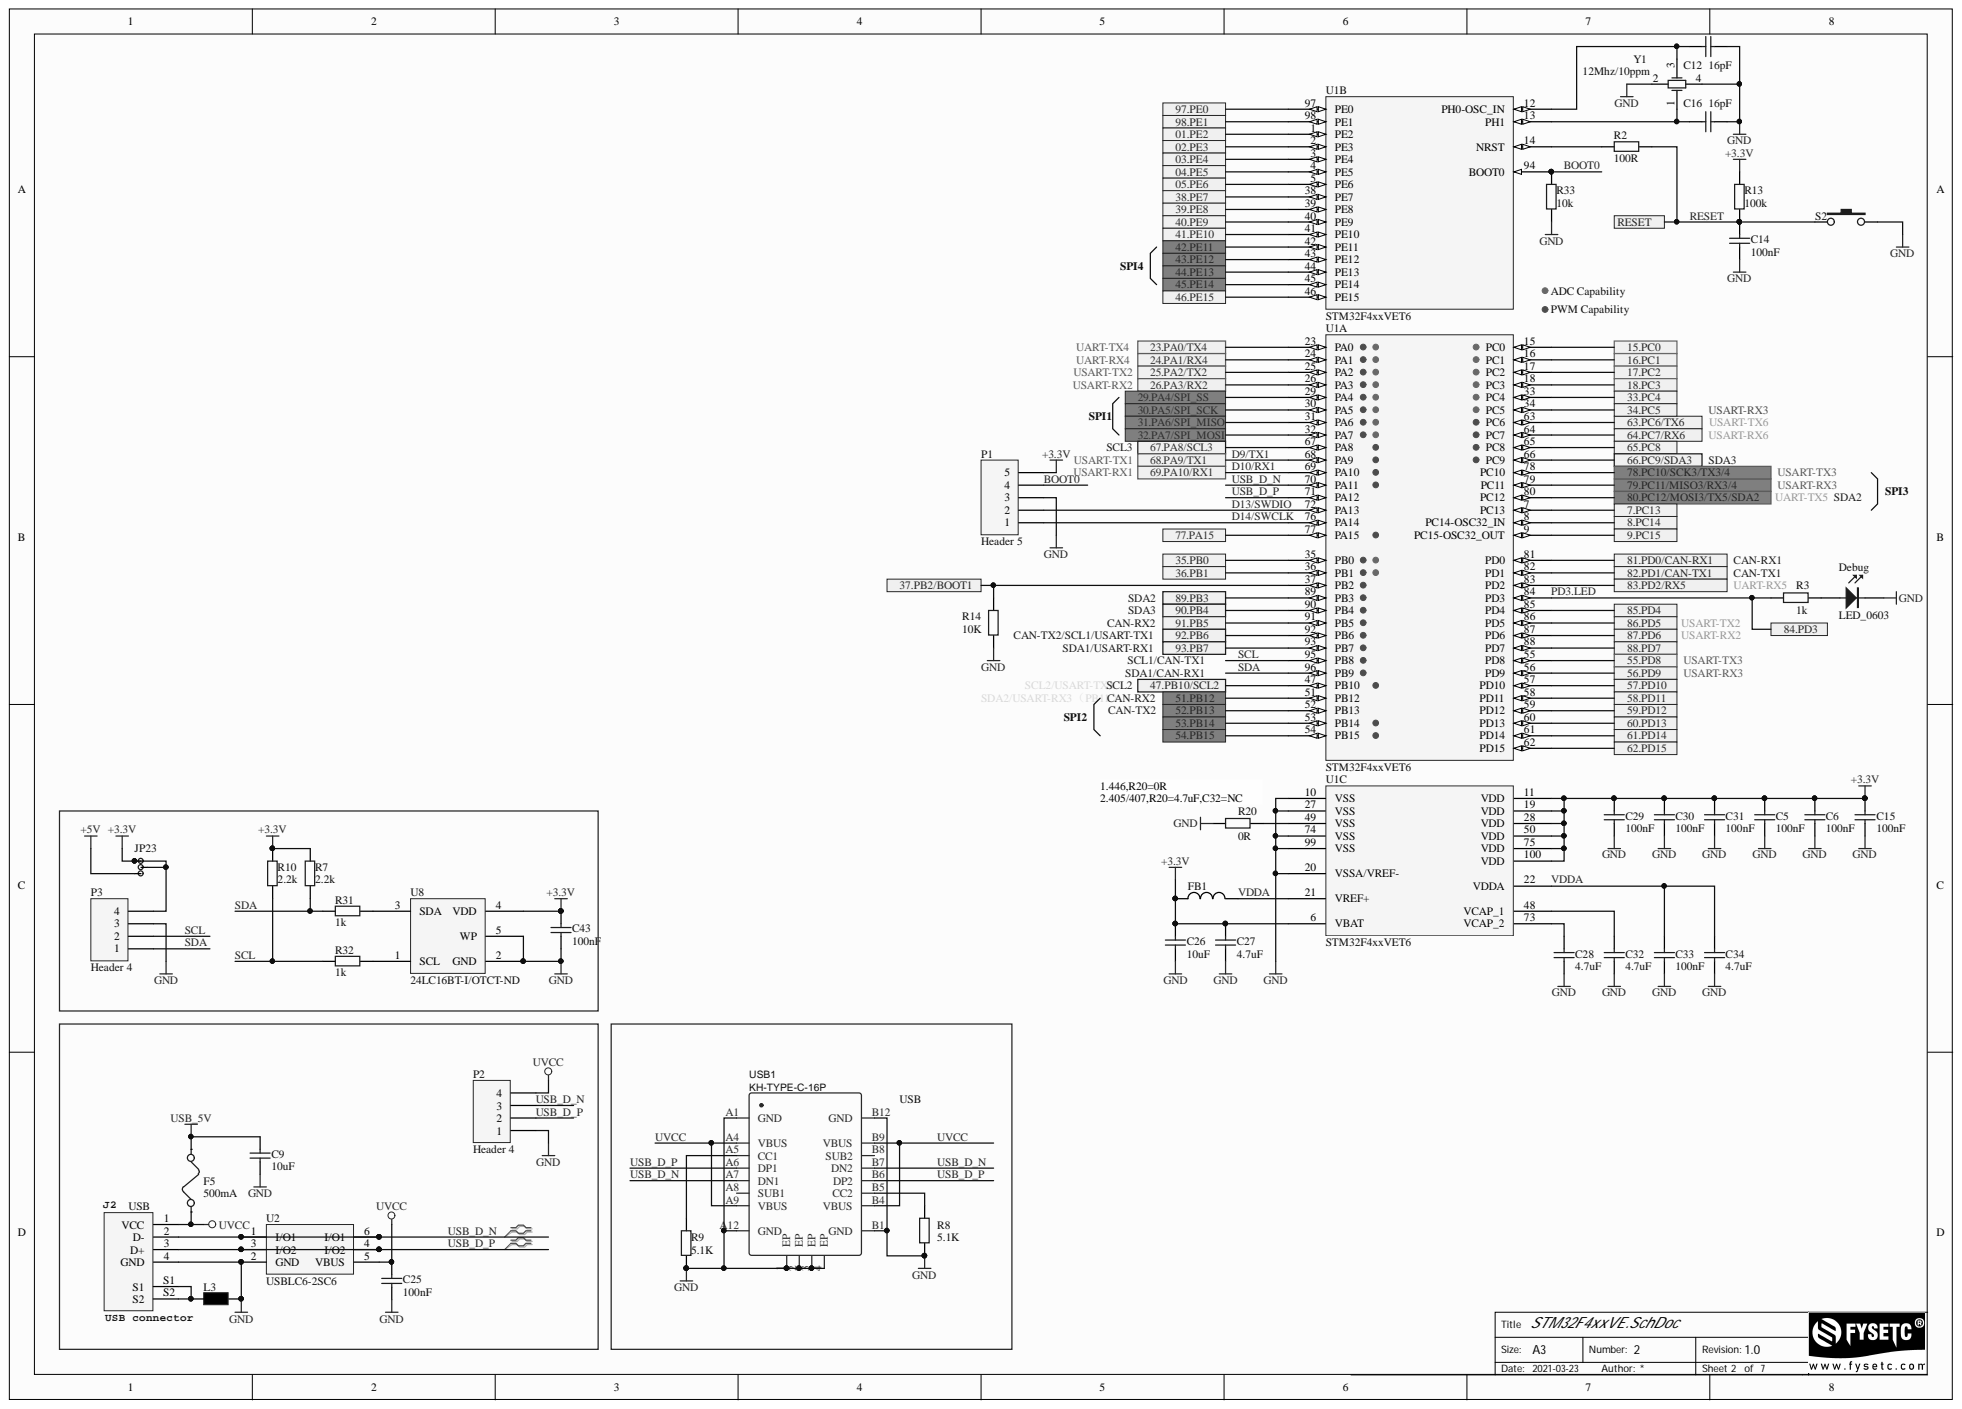
[picture p101: page 2]

98.PE1 | PE1 98
01.PE2 | PE3 2
03.PE4 | PE4 3 | 100R
04.PE5 | PE6 5
05.PE6 | PE7 38

42.PE11 | PE11 42
43.PE12 | PE12 43
44.PE13 | PE14 45

24.PA1/RX4 | | PA2 25 | 16.PC1
25.PA2/TX2 | | | 17.PC2
26.PA3/RX2 | | PA3 26 | 18.PC3
29.PA4/SPI_SS | | PA4 29 | 33.PC4
30.PA5/SPI_SCK | | PA6 31 | 34.PC5
31.PA6/SPI_MISO | | | 63.PC6/TX6
32.PA7/SPI_MOSI | | PA7 32 | 64.PC7/RX6
67.PA8/SCL3 | D9/TX1 | PA9 68 | 65.PC8

D14/SWCLK | PA14 76 | | 8.PC14

36.PB1 | | PB1 36 | | 82.PD1/CAN-TX1

37.PB2/BOOT1 | | | | PB3 89 | 83.PD2/RX5

89.PB3 | | PB4 90
90.PB4 | | | | 85.PD4
91.PB5 | | PB5 91 | | 86.PD5
92.PB6 | | PB7 93 | | 87.PD6
93.PB7 | | | | 88.PD7

47.PB10/SCL2 | PB12 51 | 57.PD10
51.PB12 | | 58.PD11
52.PB13 | PB13 52 | 59.PD12
53.PB14 | PB15 54 | 60.PD13
54.PB15 | | 61.PD14

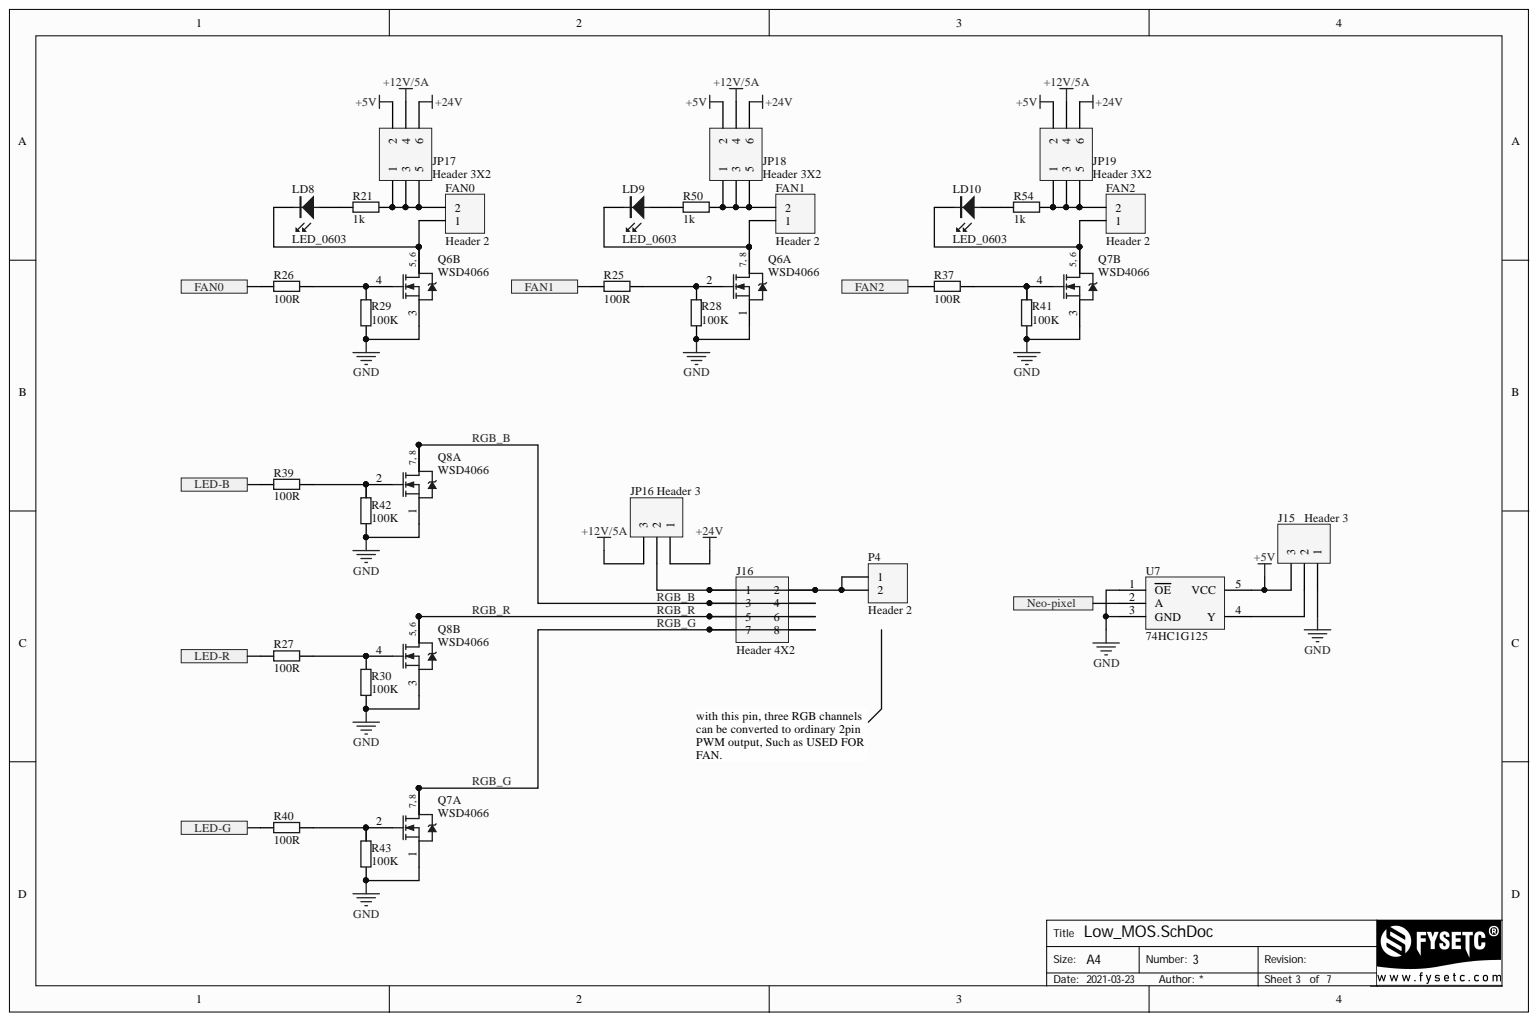
[picture p102: page 3]

RGB_G | 7 8

with this pin, three RGB channels
can be converted to ordinary 2pin
PWM output, Such as USED FOR
FAN.

Low_MOS.SchDoc Title

Size: A4 | Number: 3 | Revision:

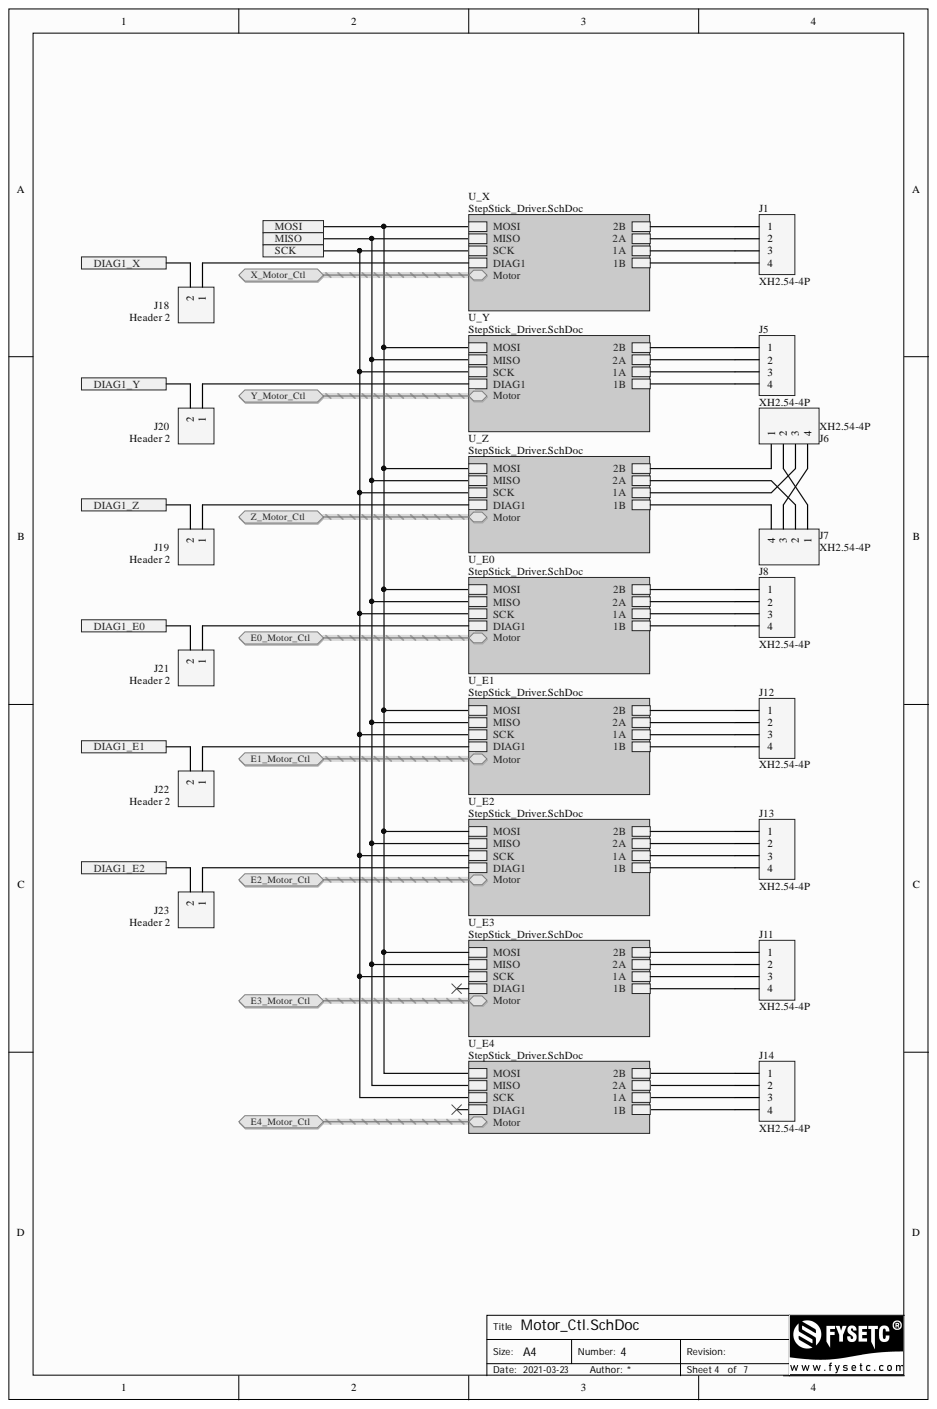
[picture p103: page 4]

M otor_Ctl .Sc hDo c T i t l e

S ize : A | N u m b er: | R e v i si o n :

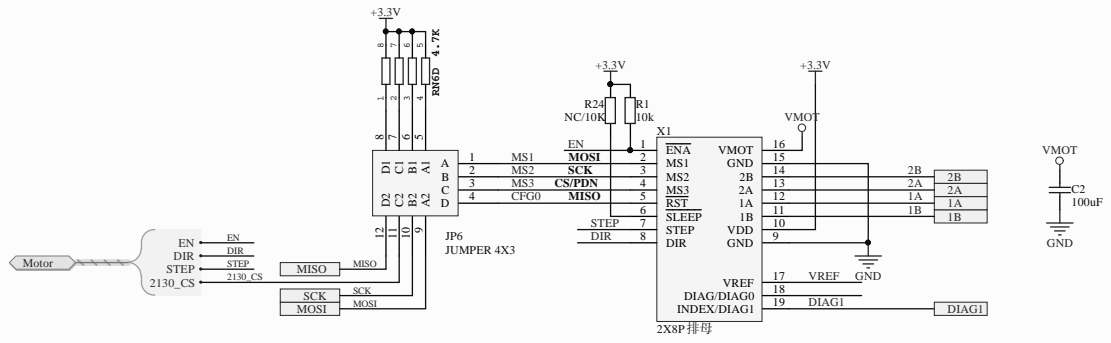
[picture p104: page 5]

2 MS2 SC K | 3 | 1 4
3 MS3 CS/ P D N | 4 | 1 3 | 2 A
4 CFG 0 ISO M | 5 | 1 2 | 1 A

StepStick_Driver.SchD o c Tit l e

Size: A4 | Nu mber: 5 | R evision: 1.0

2021-03-A u thor: * | | Sheet of

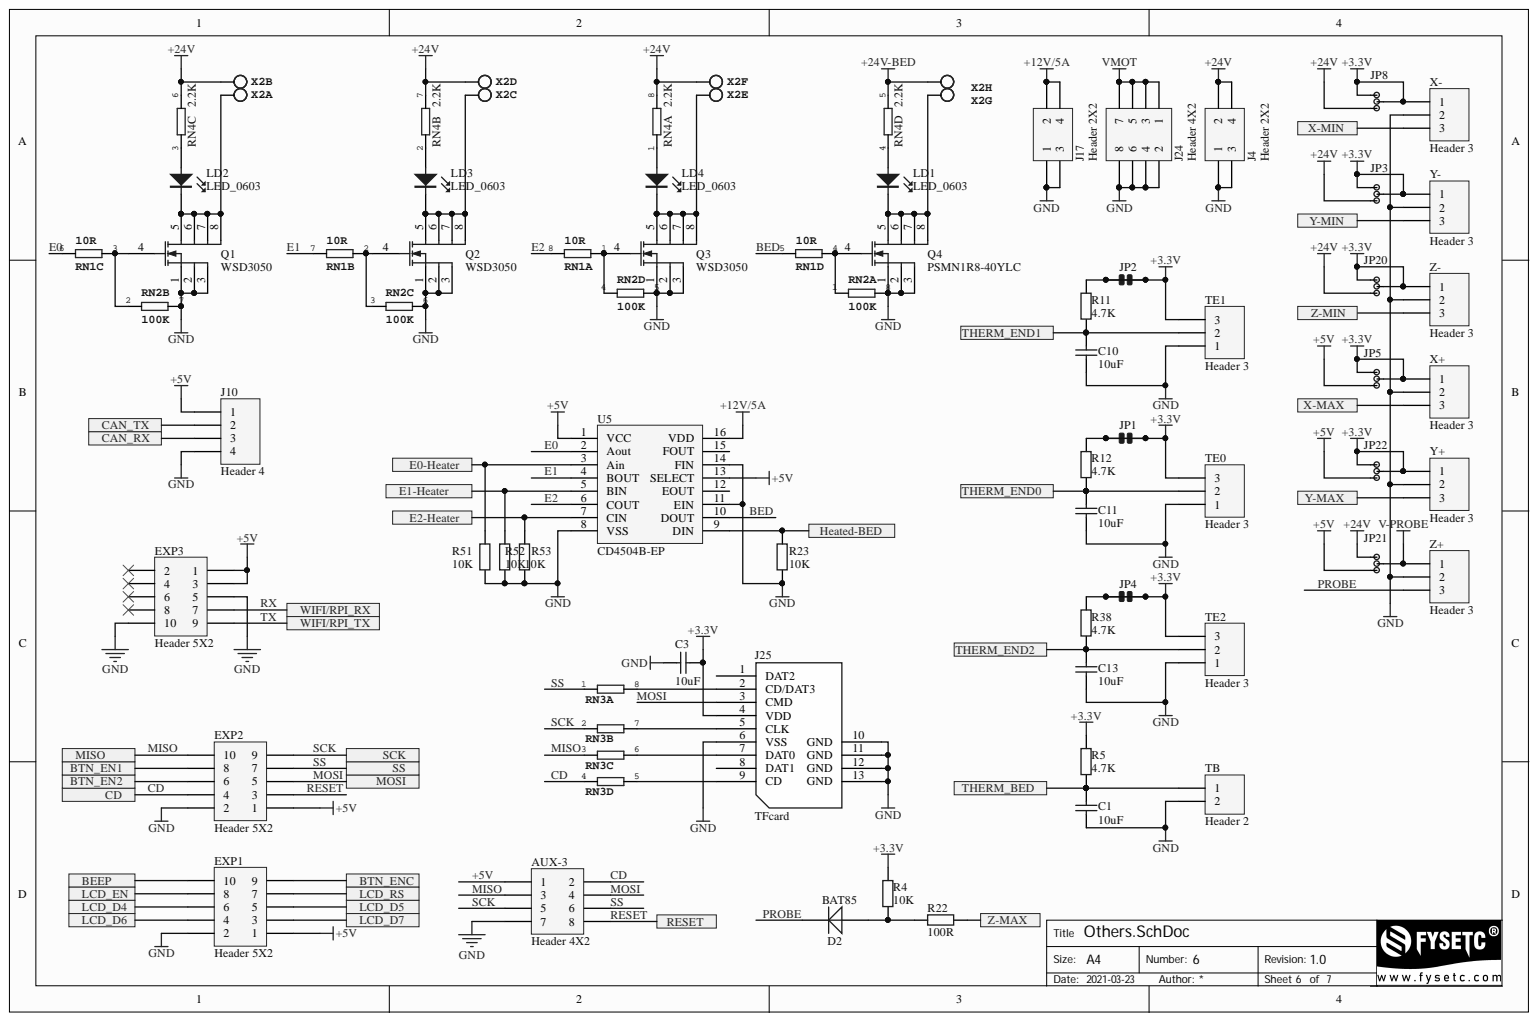
[picture p105: page 6]

Others.SchDoc Title

Size: A4 | Number: 6 | Revision: 1.0

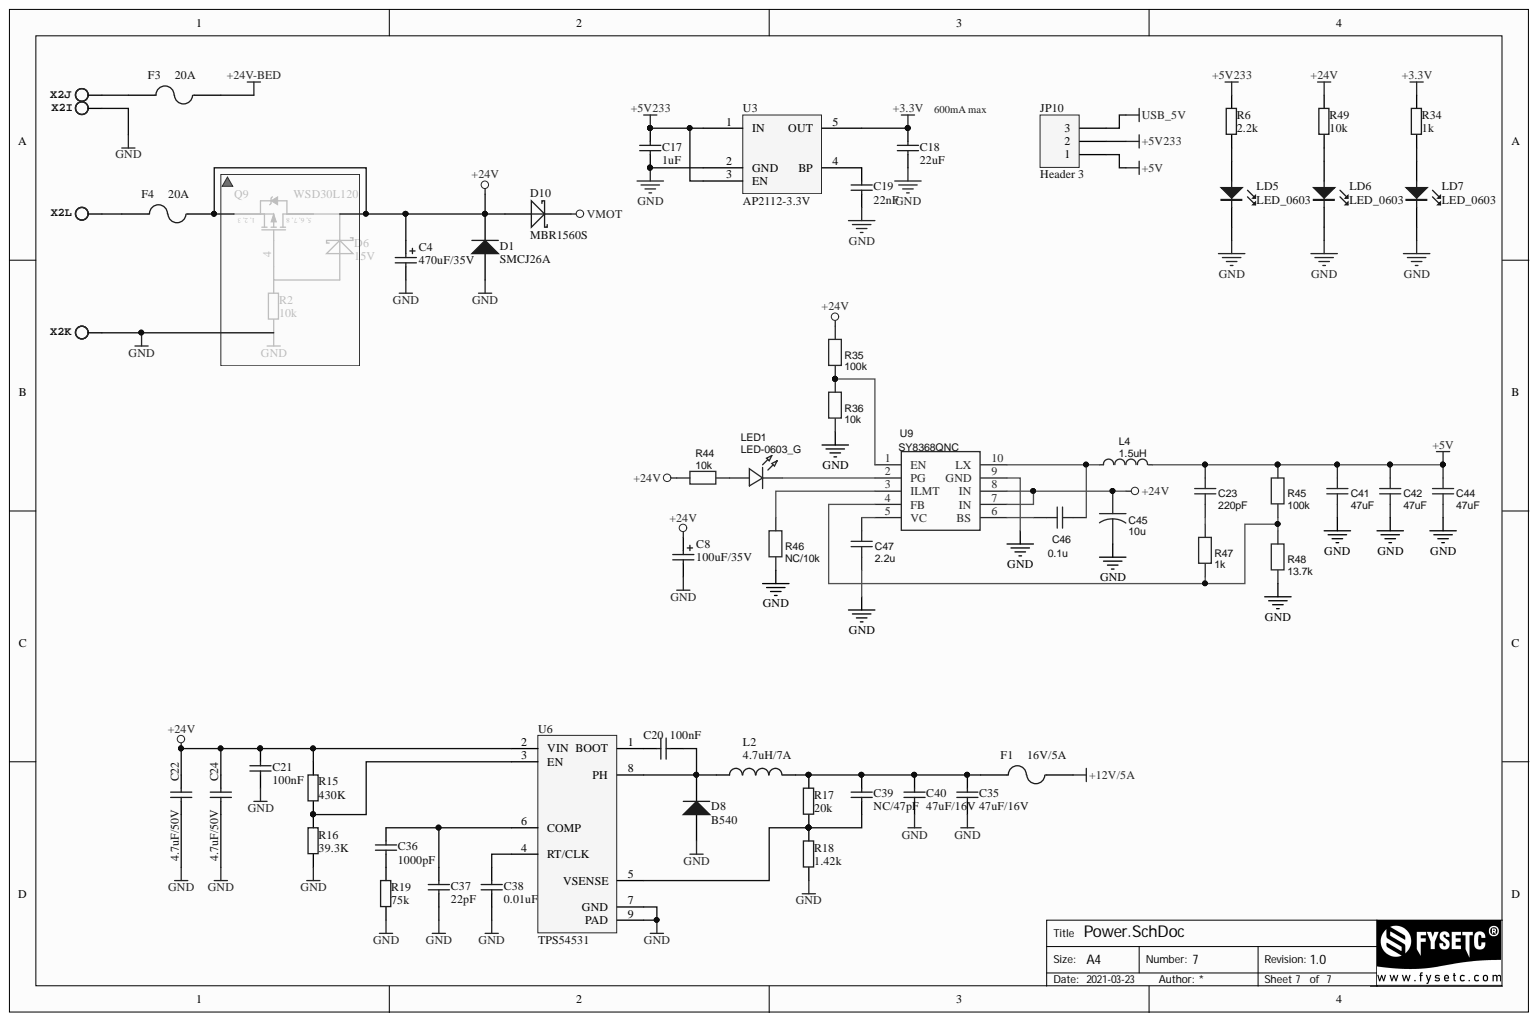
[picture p106: page 7]

RT/CLK 4

Power.SchDoc Title

Size: A4 | Number: 7 | Revision: 1.0

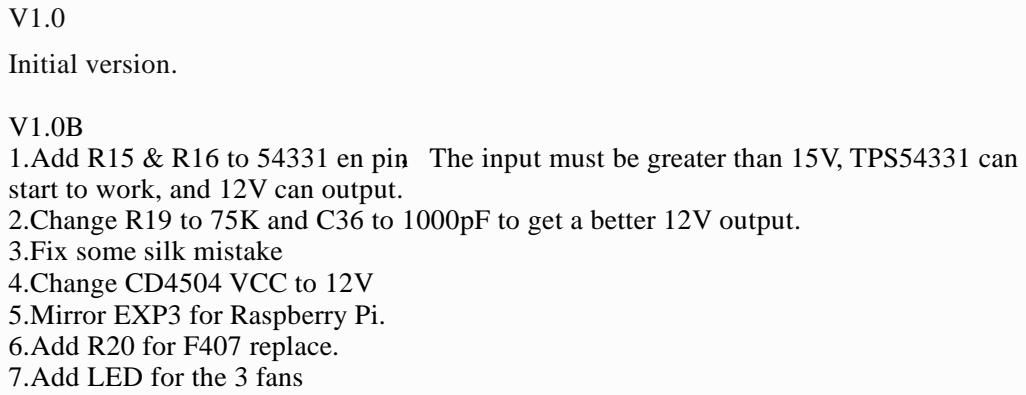
[picture p107: page 8]

1.Add R15 & R16 to 54331 en pin，The input must be greater than 15V, TPS54331 can
start to work, and 12V can output.
2.Change R19 to 75K and C36 to 1000pF to get a better 12V output.
3.Fix some silk mistake
4.Change CD4504 VCC to 12V
5.Mirror EXP3 for Raspberry Pi.
6.Add R20 for F407 replace.
7.Add LED for the 3 fans

Version.SchDoc Title

Size: A4 | Number: | Revision:
