FYSETC/FYSETC-SPIDER/hardware/V1.x/Spider V1.0C Designator Diagram.pdf

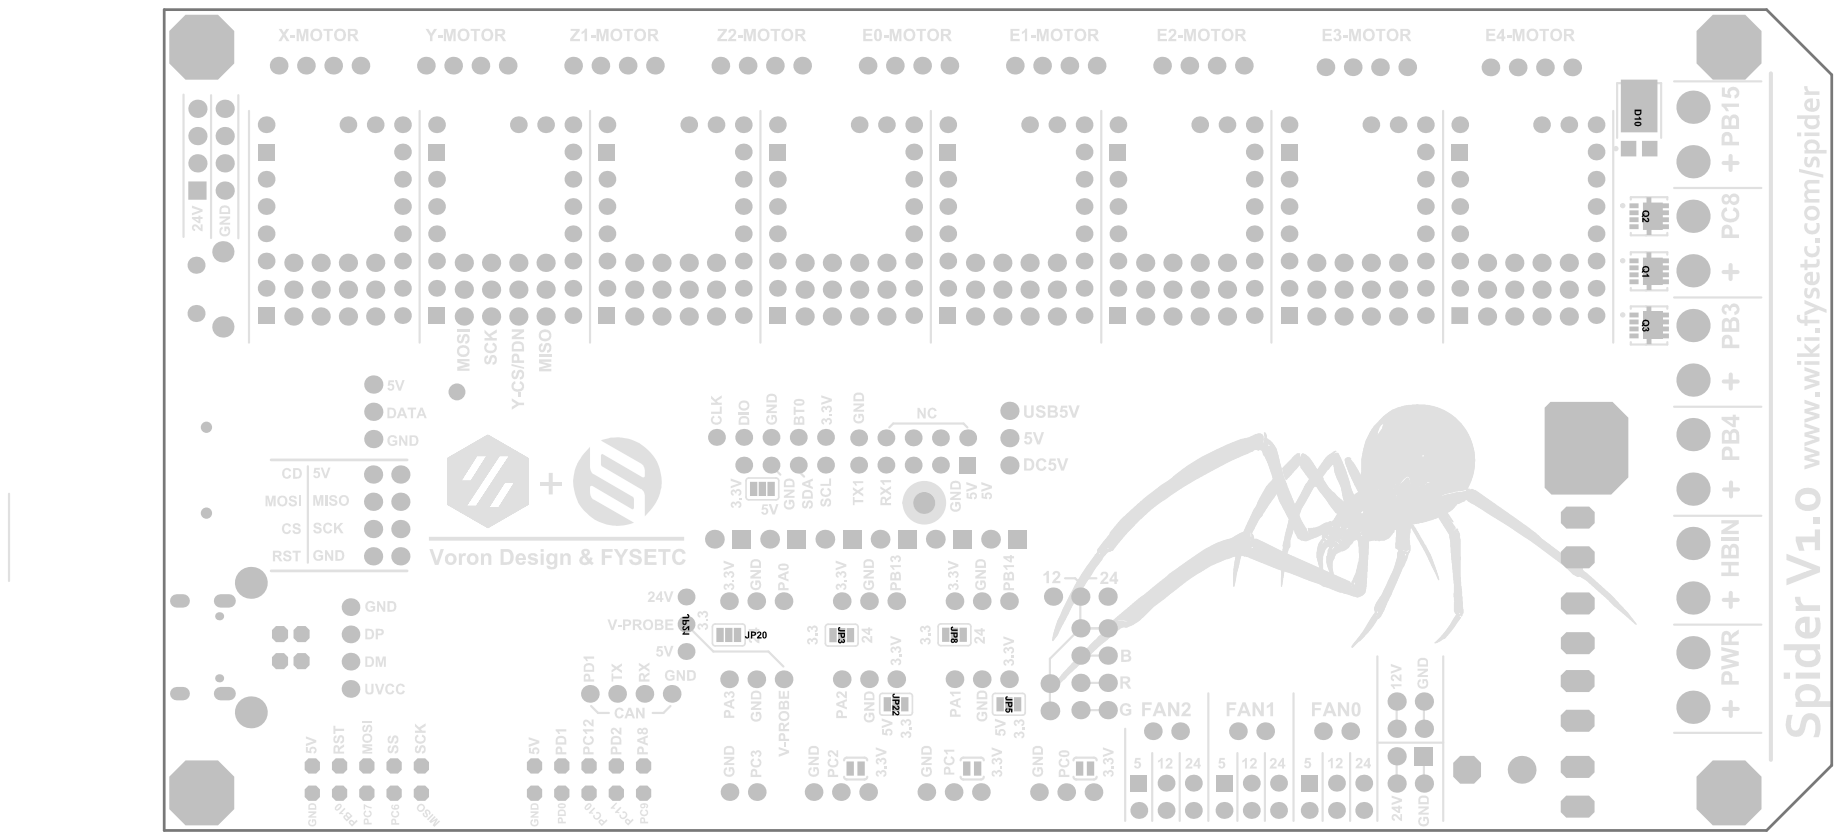
[picture p111: page 1]

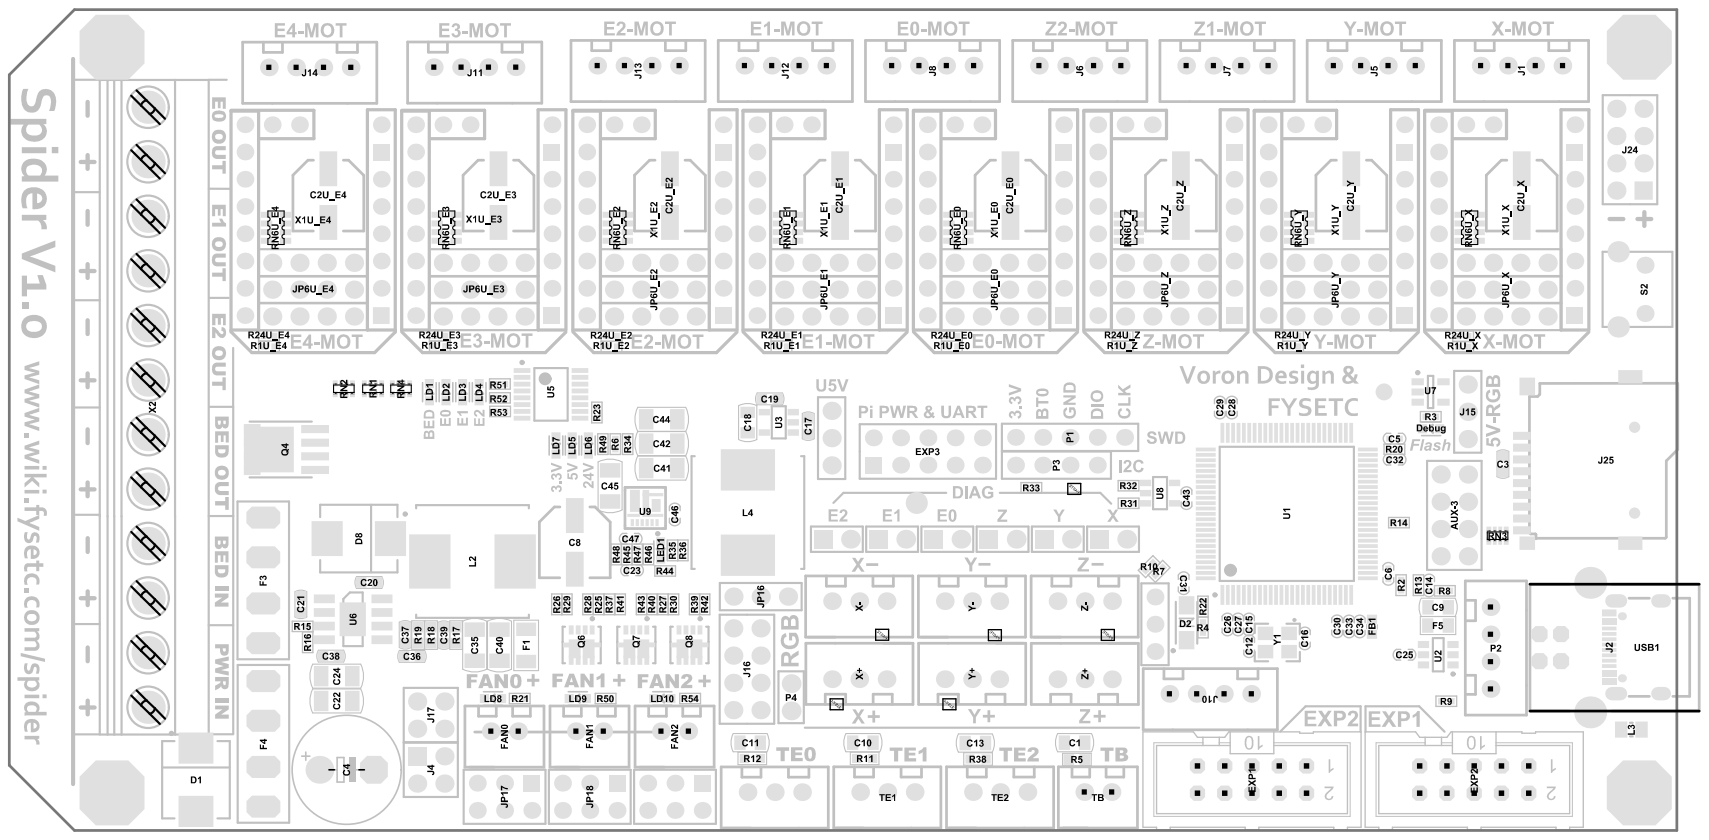
[picture p112: page 2]
