FYSETC/FYSETC-SPIDER/hardware/V1.x/Spider V1.1 Designator Diagram.pdf

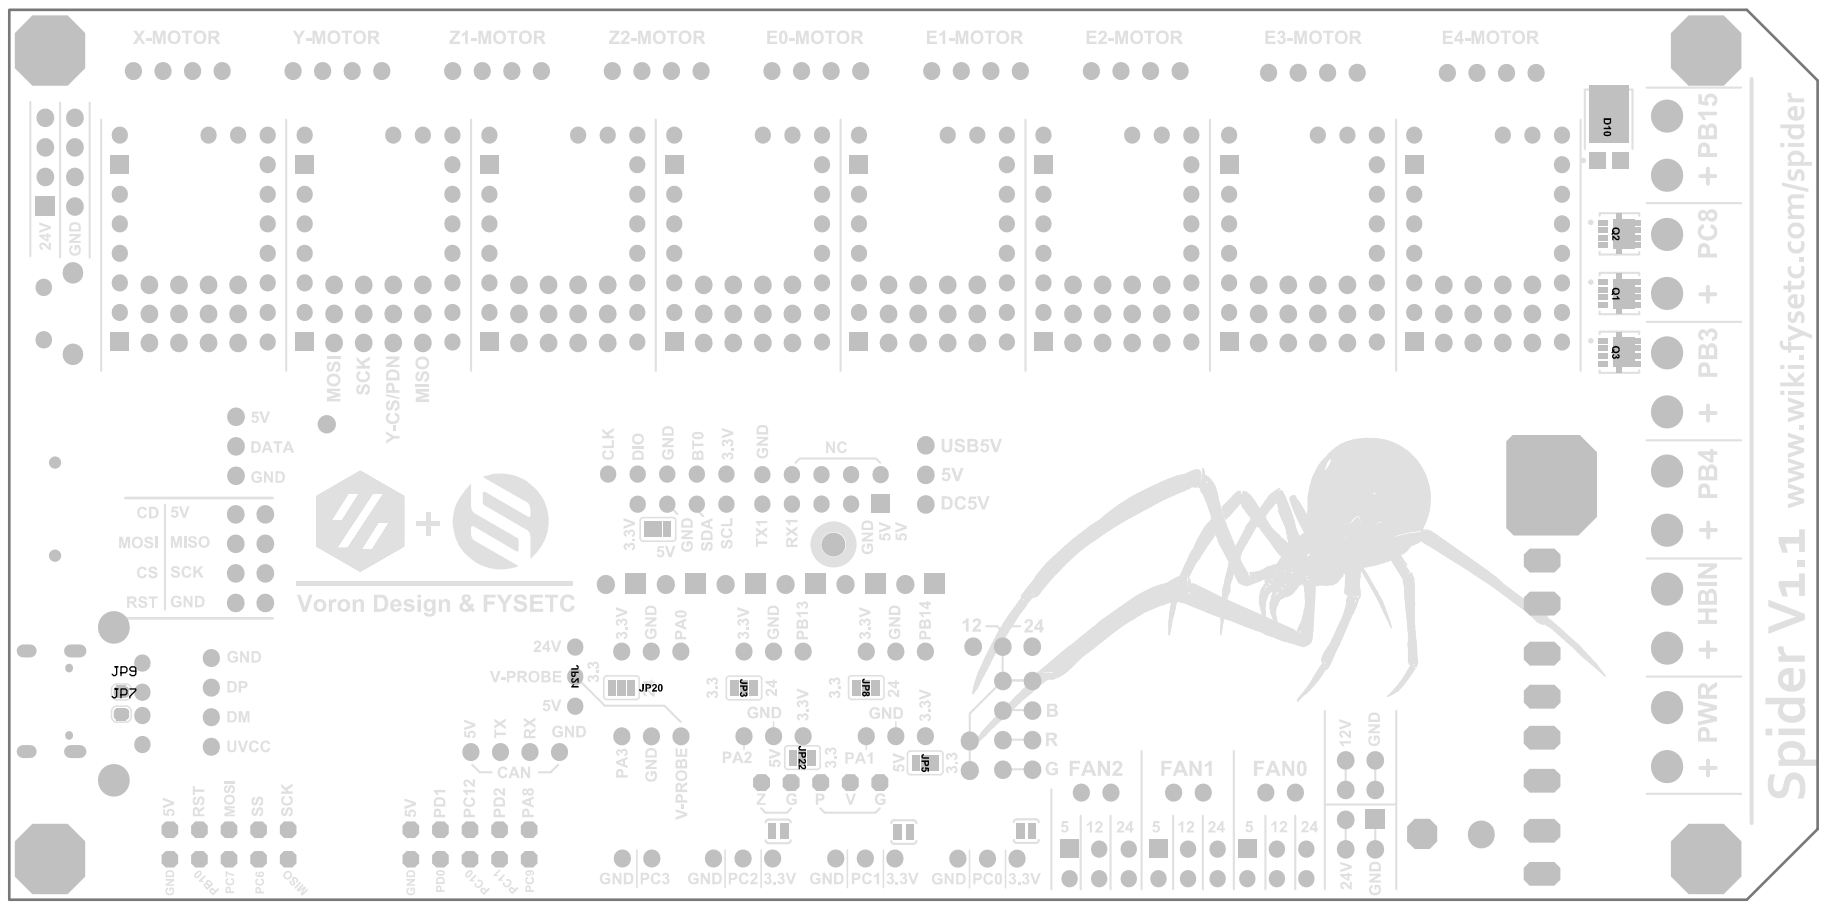
[picture p113: page 1]

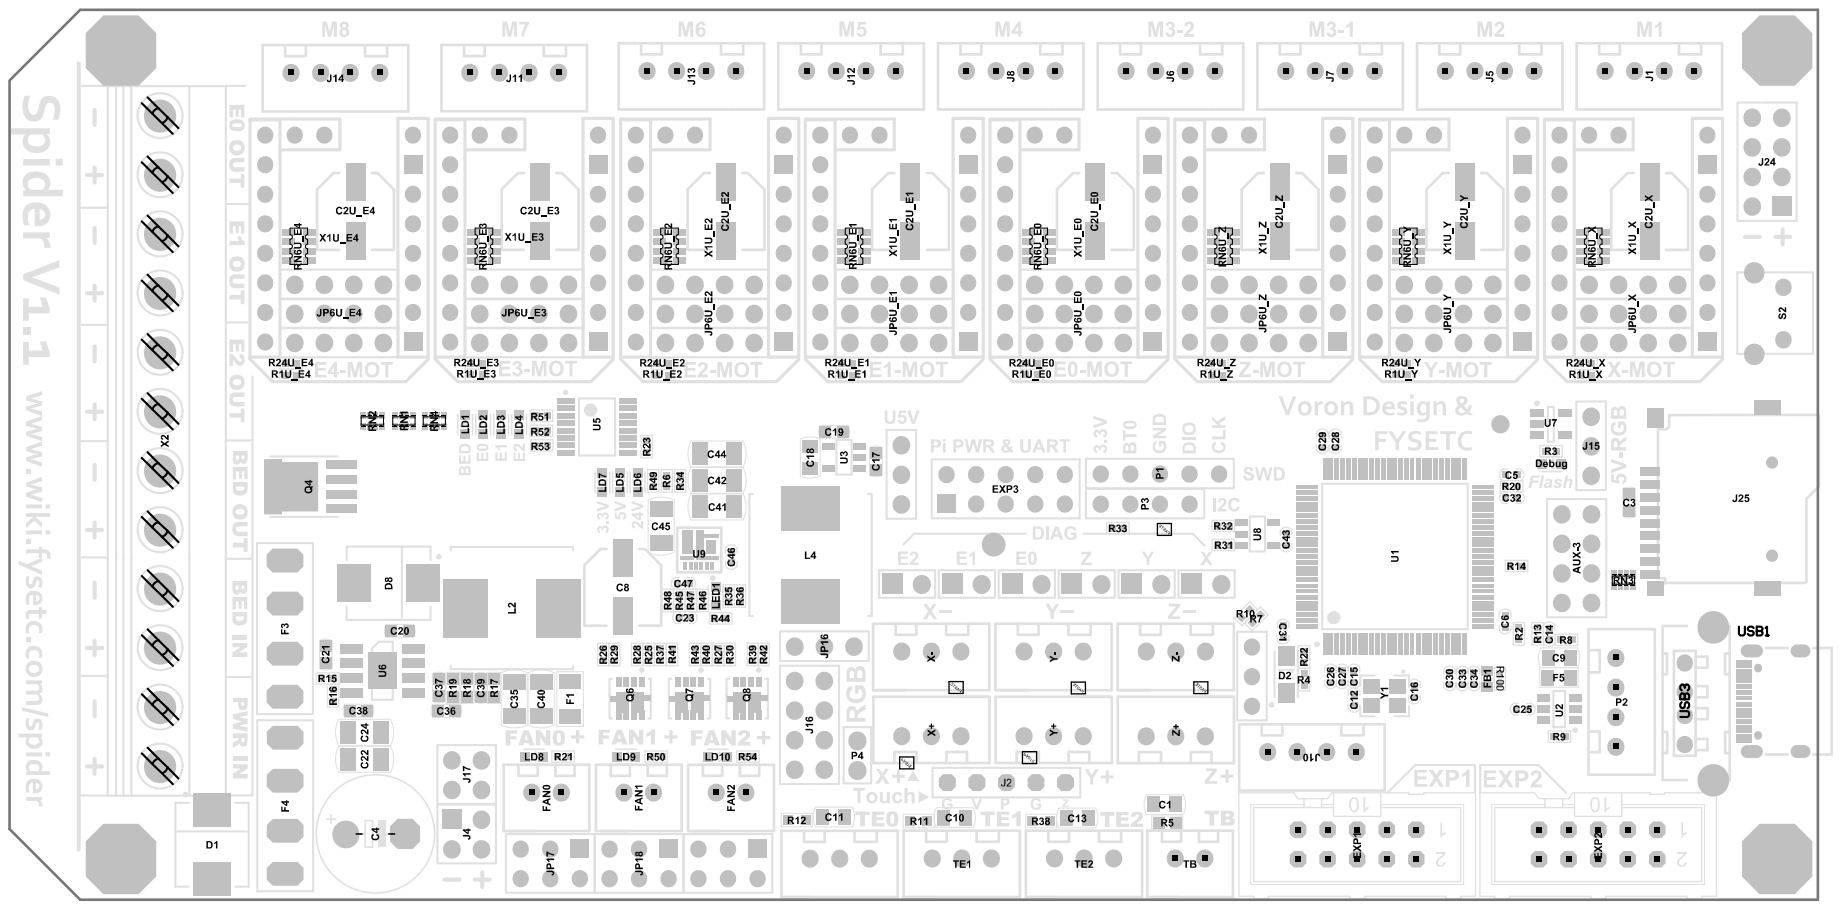
[picture p114: page 2]
