FYSETC/FYSETC-SPIDER/hardware/V2.3/Spider_V2.3_SCH.pdf

5 | 4 | 3 | 2 | 1

D

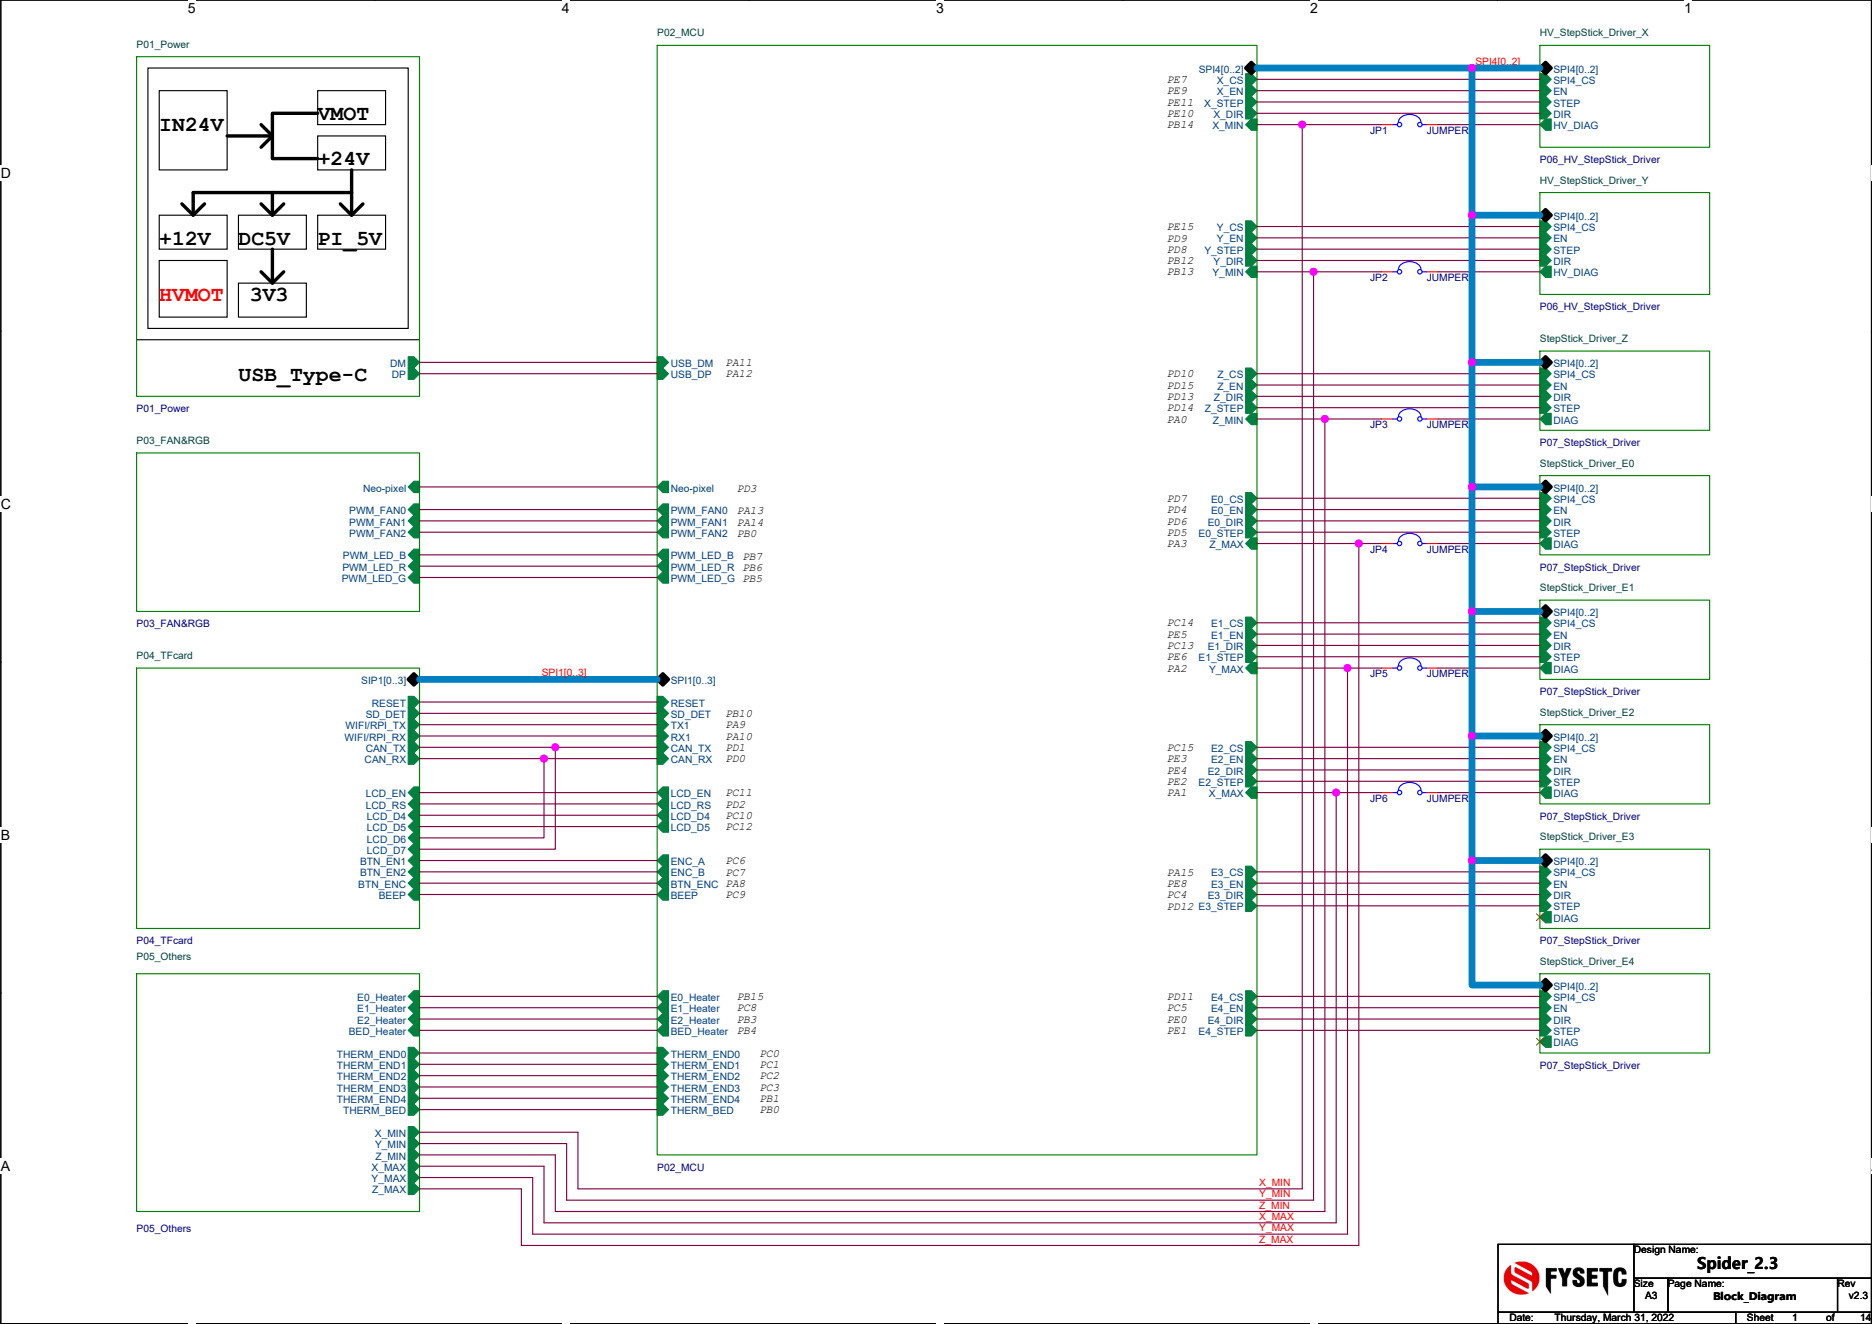
[picture p115: page 1]
VMOT; HVMOT; USB_Type-C; P04_TFcard; RESET; SIP1[0..3]; SD_DET; WIFI/RPI_RX; WIFI/RPI_TX; CAN_TX CAN_RX; BEEP; BTN_EN1; LCD_EN LCD_RS; BTN_EN2; LCD_D5; LCD_D4; LCD_D7; LCD_D6; BTN_ENC; StepStick_Driver_E1; P07_StepStick_Driver; STEP; DIR; SPI4_CS; DIAG; SPI4[0..2]; JUMPER; StepStick_Driver_E4; P05_Others; E0_Heater; Z_MAX; E1_Heater E2_Heater BED_Heater; X_MIN Y_MIN Z_MIN X_MAX Y_MAX; THERM_END0 THERM_END1 THERM_END2 THERM_END3 THERM_END4 THERM_BED; P01_Power; StepStick_Driver_Z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

Design Name: Spider_2.3

Size A3 | Page Name: Block_Diagram Block_Diagram Block_Diagram | Rev v2.3

Date: Thursday, March 31, 2022 Thursday, March 31, 2022 Thursday, March 31, 2022 | Sheet 1 1 1 of 14 14 14

D

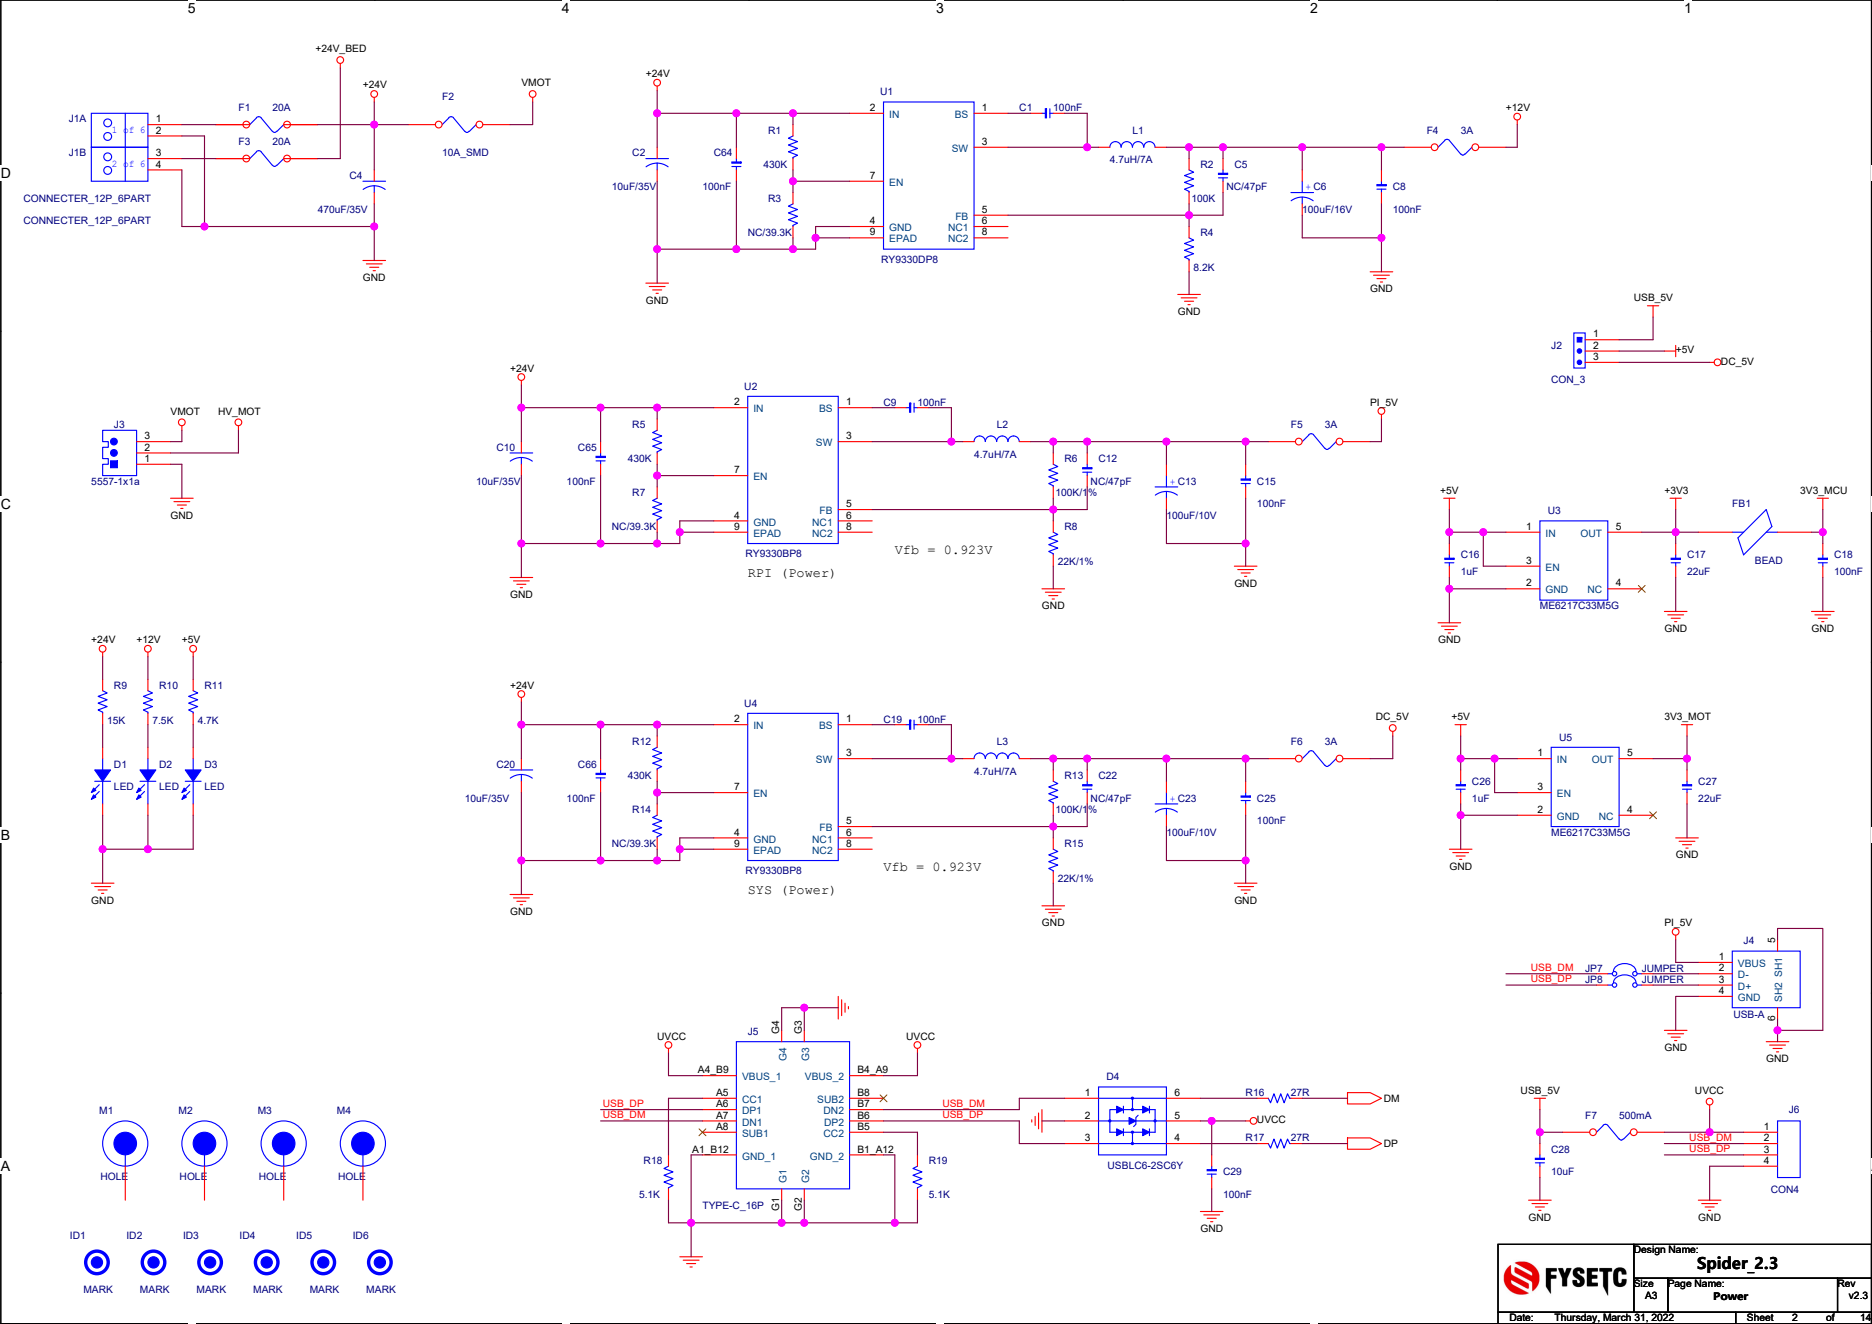
[picture p116: page 2]

Power Power Power

Thursday, March 31, 2022 Thursday, March 31, 2022 Thursday, March 31, 2022 | 2 2 2 14 14 14

D

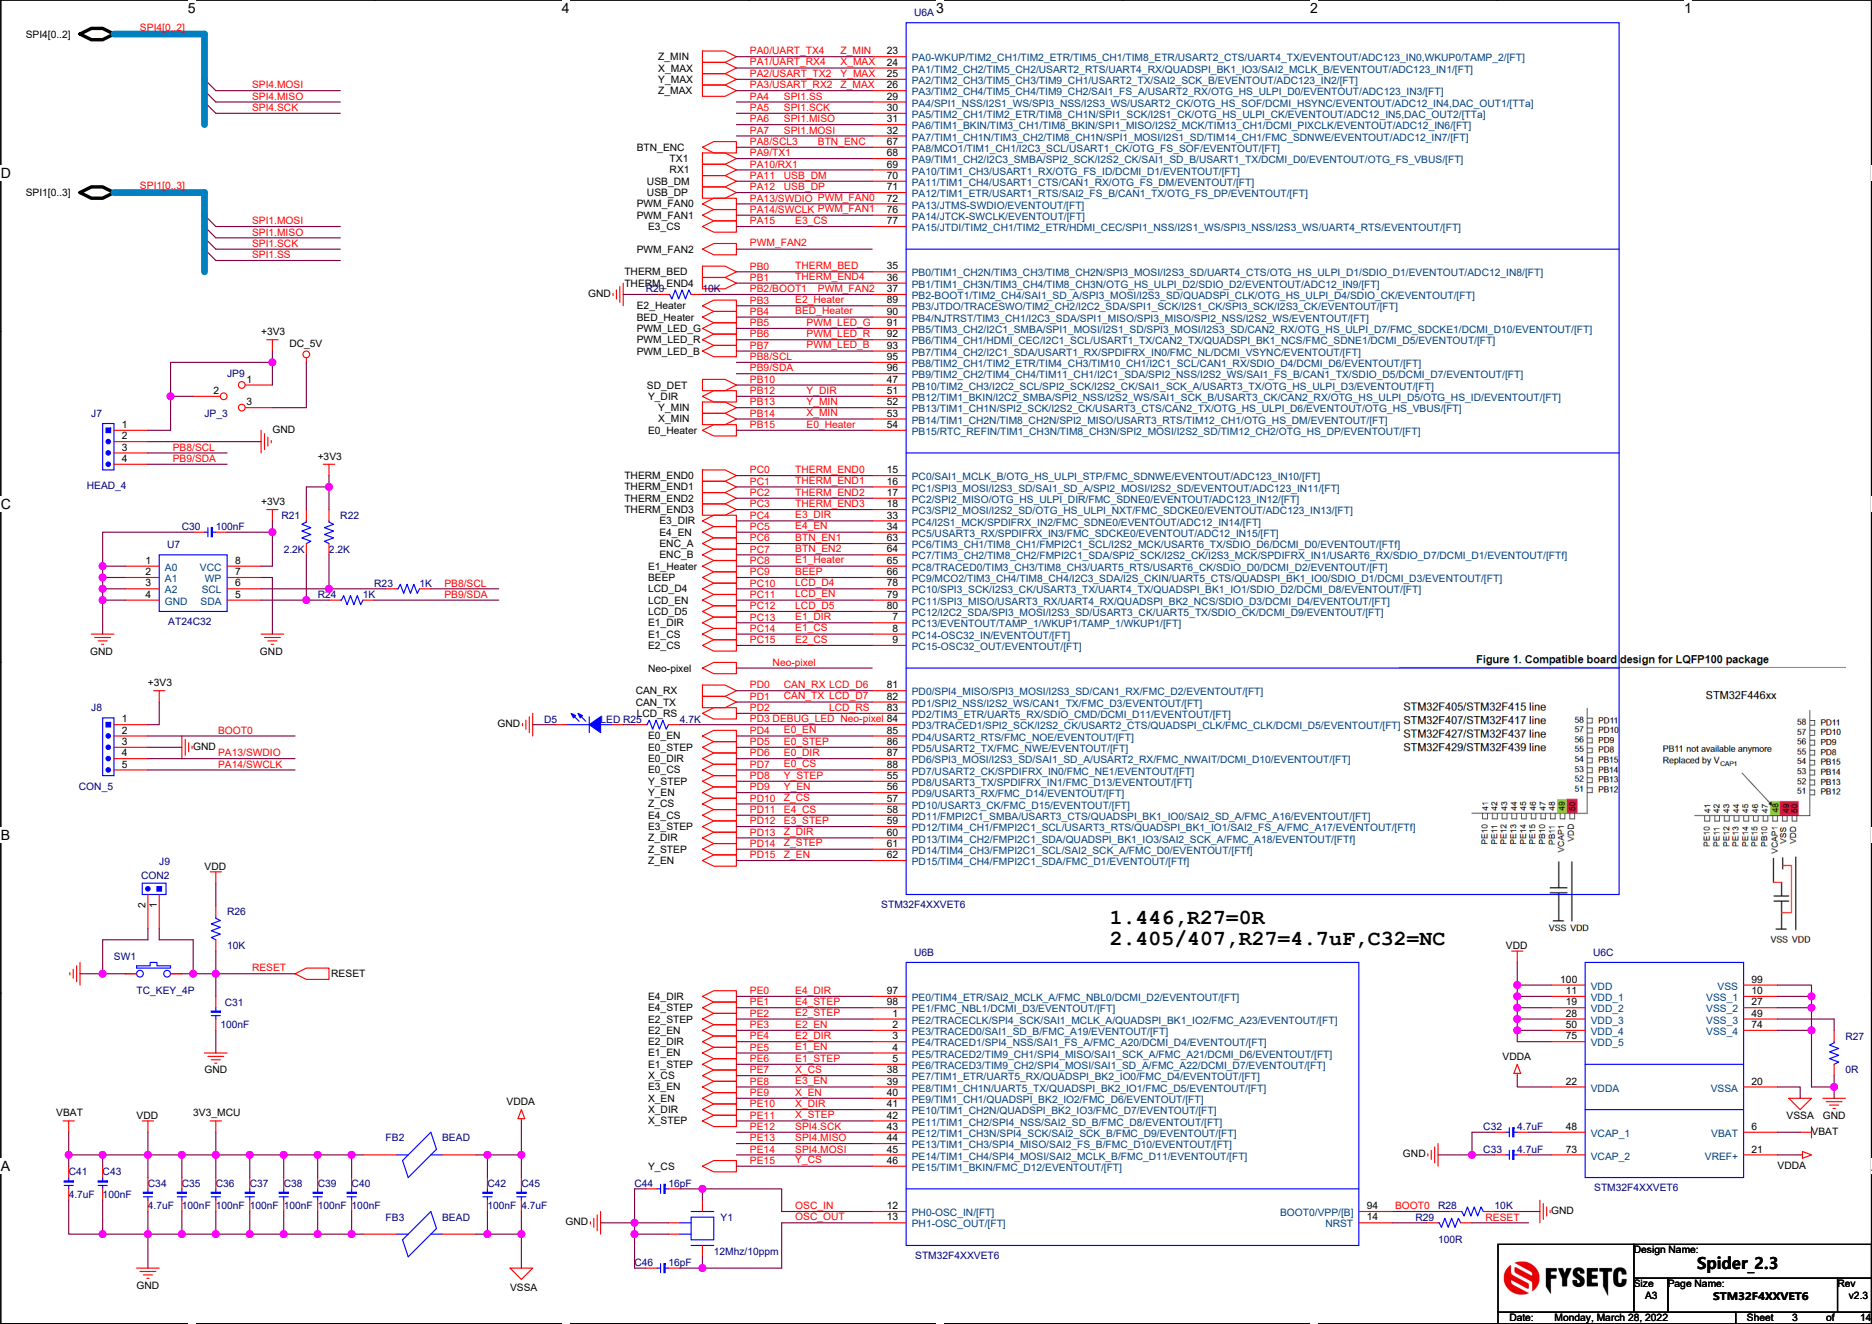
[picture p117: page 3]

PA0-WKUP/TIM2_CH1/TIM2_ETR/TIM5_CH1/TIM8_ETR/USART2_CTS/UART4_TX/EVENTOUT/ADC123_IN0,WKUP0/TAMP_2/[FT] 23
PA1/TIM2_CH2/TIM5_CH2/USART2_RTS/UART4_RX/QUADSPI_BK1_IO3/SAI2_MCLK_B/EVENTOUT/ADC123_IN1/[FT] 24
PA2/TIM2_CH3/TIM5_CH3/TIM9_CH1/USART2_TX/SAI2_SCK_B/EVENTOUT/ADC123_IN2/[FT] 25
PA3/TIM2_CH4/TIM5_CH4/TIM9_CH2/SAI1_FS_A/USART2_RX/OTG_HS_ULPI_D0/EVENTOUT/ADC123_IN3/[FT] 26
PA4/SPI1_NSS/I2S1_WS/SPI3_NSS/I2S3_WS/USART2_CK/OTG_HS_SOF/DCMI_HSYNC/EVENTOUT/ADC12_IN4,DAC_OUT1/[TTa] 29
PA5/TIM2_CH1/TIM2_ETR/TIM8_CH1N/SPI1_SCK/I2S1_CK/OTG_HS_ULPI_CK/EVENTOUT/ADC12_IN5,DAC_OUT2/[TTa] 30
PA6/TIM1_BKIN/TIM3_CH1/TIM8_BKIN/SPI1_MISO/I2S2_MCK/TIM13_CH1/DCMI_PIXCLK/EVENTOUT/ADC12_IN6/[FT] 31
PA7/TIM1_CH1N/TIM3_CH2/TIM8_CH1N/SPI1_MOSI/I2S1_SD/TIM14_CH1/FMC_SDNWE/EVENTOUT/ADC12_IN7/[FT] 32
PA8/MCO1/TIM1_CH1/I2C3_SCL/USART1_CK/OTG_FS_SOF/EVENTOUT/[FT] 67
PA9/TIM1_CH2/I2C3_SMBA/SPI2_SCK/I2S2_CK/SAI1_SD_B/USART1_TX/DCMI_D0/EVENTOUT/OTG_FS_VBUS/[FT] 68
PA10/TIM1_CH3/USART1_RX/OTG_FS_ID/DCMI_D1/EVENTOUT/[FT] 69
PA11/TIM1_CH4/USART1_CTS/CAN1_RX/OTG_FS_DM/EVENTOUT/[FT] 70
PA12/TIM1_ETR/USART1_RTS/SAI2_FS_B/CAN1_TX/OTG_FS_DP/EVENTOUT/[FT] 71
PA13/JTMS-SWDIO/EVENTOUT/[FT] 72
PA14/JTCK-SWCLK/EVENTOUT/[FT] 76
PA15/JTDI/TIM2_CH1/TIM2_ETR/HDMI_CEC/SPI1_NSS/I2S1_WS/SPI3_NSS/I2S3_WS/UART4_RTS/EVENTOUT/[FT] 77

PB0/TIM1_CH2N/TIM3_CH3/TIM8_CH2N/SPI3_MOSI/I2S3_SD/UART4_CTS/OTG_HS_ULPI_D1/SDIO_D1/EVENTOUT/ADC12_IN8/[FT] 35
PB1/TIM1_CH3N/TIM3_CH4/TIM8_CH3N/OTG_HS_ULPI_D2/SDIO_D2/EVENTOUT/ADC12_IN9/[FT] 36
PB2-BOOT1/TIM2_CH4/SAI1_SD_A/SPI3_MOSI/I2S3_SD/QUADSPI_CLK/OTG_HS_ULPI_D4/SDIO_CK/EVENTOUT/[FT] 37
PB3/JTDO/TRACESWO/TIM2_CH2/I2C2_SDA/SPI1_SCK/I2S1_CK/SPI3_SCK/I2S3_CK/EVENTOUT/[FT] 89
PB4/NJTRST/TIM3_CH1/I2C3_SDA/SPI1_MISO/SPI3_MISO/SPI2_NSS/I2S2_WS/EVENTOUT/[FT] 90
PB5/TIM3_CH2/I2C1_SMBA/SPI1_MOSI/I2S1_SD/SPI3_MOSI/I2S3_SD/CAN2_RX/OTG_HS_ULPI_D7/FMC_SDCKE1/DCMI_D10/EVENTOUT/[FT] 91
PB6/TIM4_CH1/HDMI_CEC/I2C1_SCL/USART1_TX/CAN2_TX/QUADSPI_BK1_NCS/FMC_SDNE1/DCMI_D5/EVENTOUT/[FT] 92
PB7/TIM4_CH2/I2C1_SDA/USART1_RX/SPDIFRX_IN0/FMC_NL/DCMI_VSYNC/EVENTOUT/[FT] 93
PB8/TIM2_CH1/TIM2_ETR/TIM4_CH3/TIM10_CH1/I2C1_SCL/CAN1_RX/SDIO_D4/DCMI_D6/EVENTOUT/[FT] 95
PB9/TIM2_CH2/TIM4_CH4/TIM11_CH1/I2C1_SDA/SPI2_NSS/I2S2_WS/SAI1_FS_B/CAN1_TX/SDIO_D5/DCMI_D7/EVENTOUT/[FT] 96
PB10/TIM2_CH3/I2C2_SCL/SPI2_SCK/I2S2_CK/SAI1_SCK_A/USART3_TX/OTG_HS_ULPI_D3/EVENTOUT/[FT] 47
PB12/TIM1_BKIN/I2C2_SMBA/SPI2_NSS/I2S2_WS/SAI1_SCK_B/USART3_CK/CAN2_RX/OTG_HS_ULPI_D5/OTG_HS_ID/EVENTOUT/[FT] 51
PB13/TIM1_CH1N/SPI2_SCK/I2S2_CK/USART3_CTS/CAN2_TX/OTG_HS_ULPI_D6/EVENTOUT/OTG_HS_VBUS/[FT] 52
PB14/TIM1_CH2N/TIM8_CH2N/SPI2_MISO/USART3_RTS/TIM12_CH1/OTG_HS_DM/EVENTOUT/[FT] 53
PB15/RTC_REFIN/TIM1_CH3N/TIM8_CH3N/SPI2_MOSI/I2S2_SD/TIM12_CH2/OTG_HS_DP/EVENTOUT/[FT] 54

STM32F4XXVET6 STM32F4XXVET6 STM32F4XXVET6

Monday, March 28, 2022 Monday, March 28, 2022 Monday, March 28, 2022 | 3 3 3 14 14 14

D

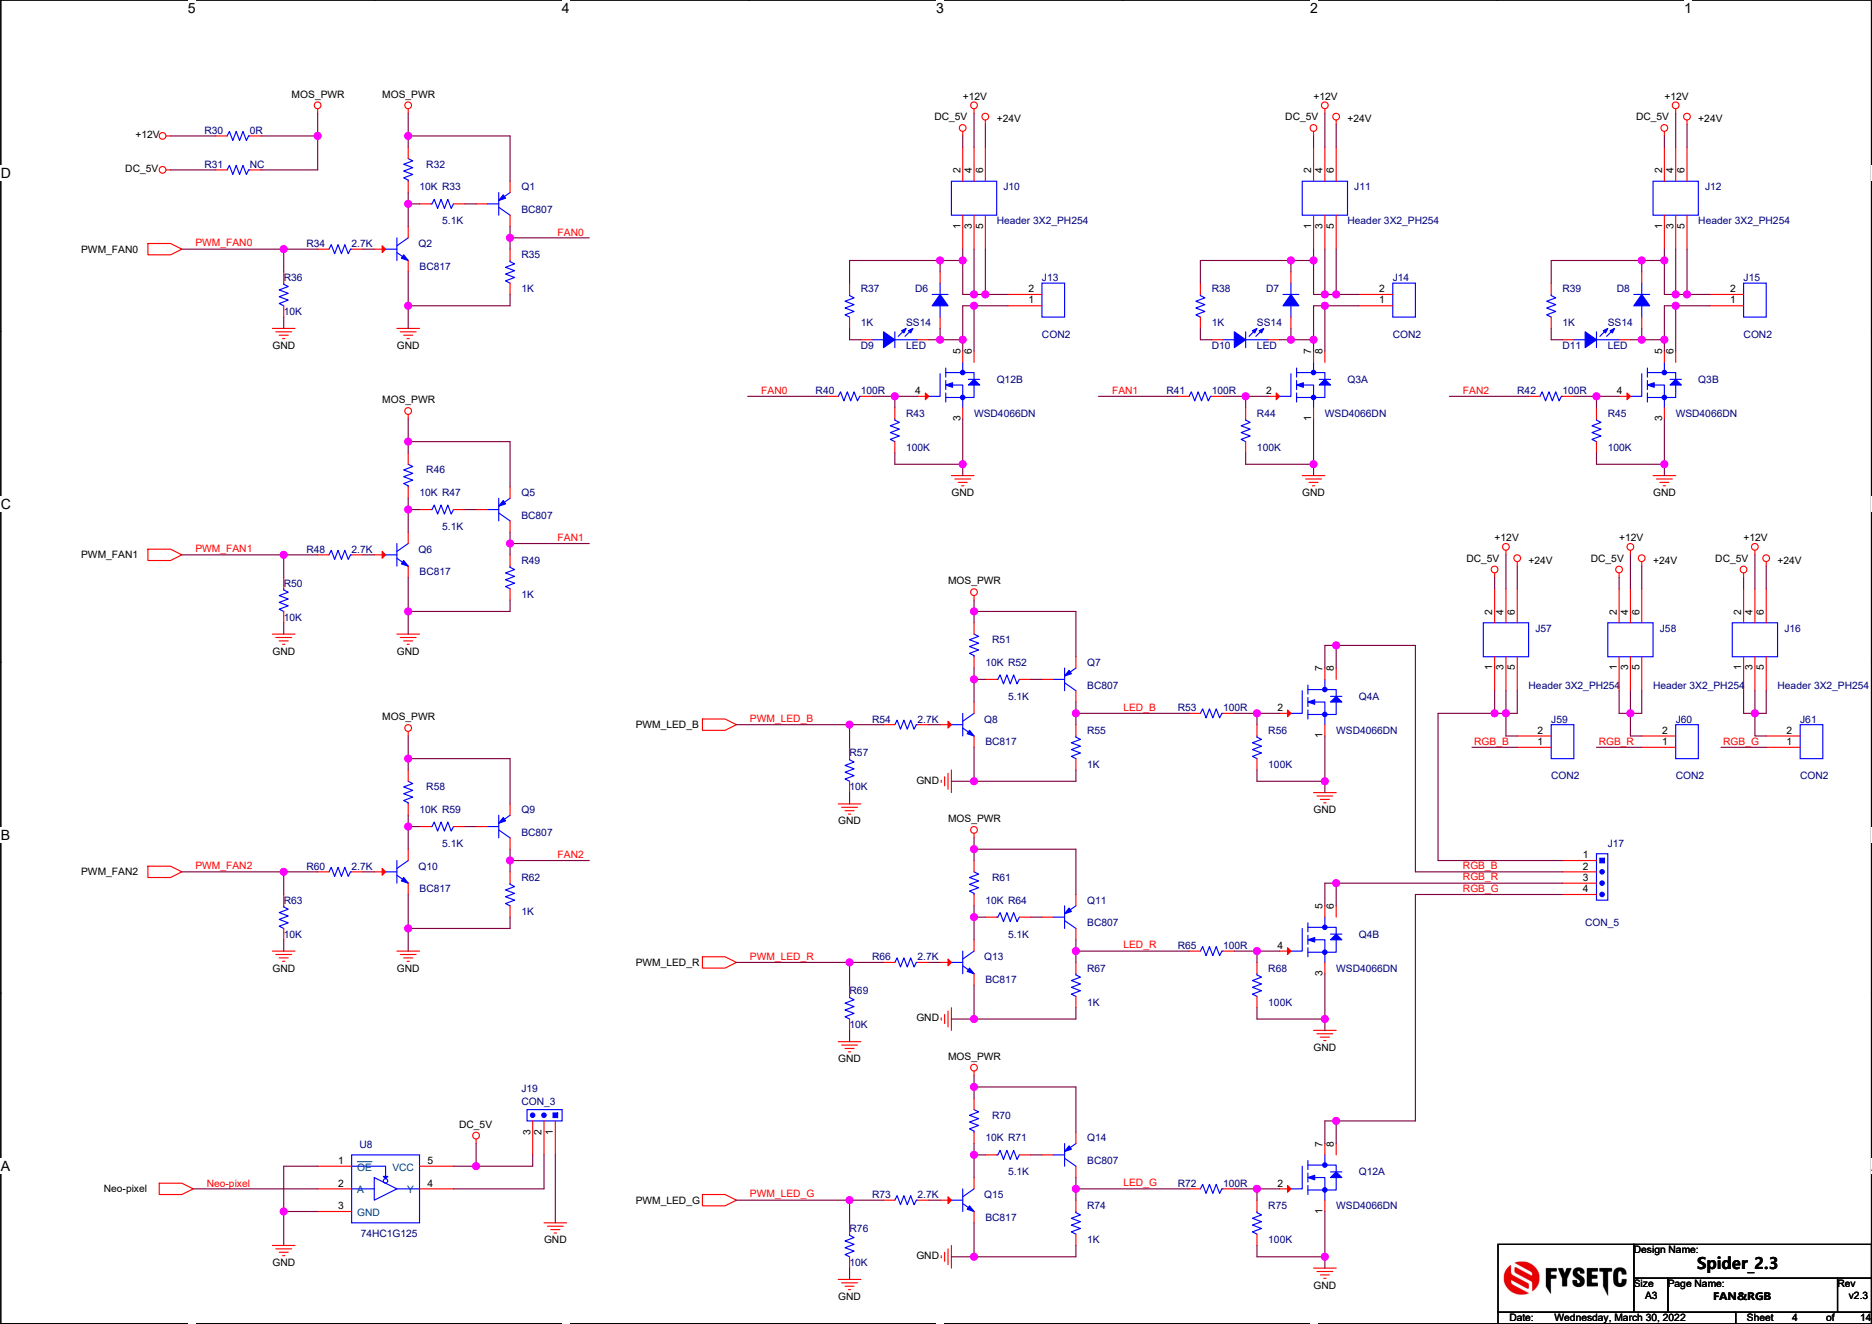
[picture p118: page 4]

D

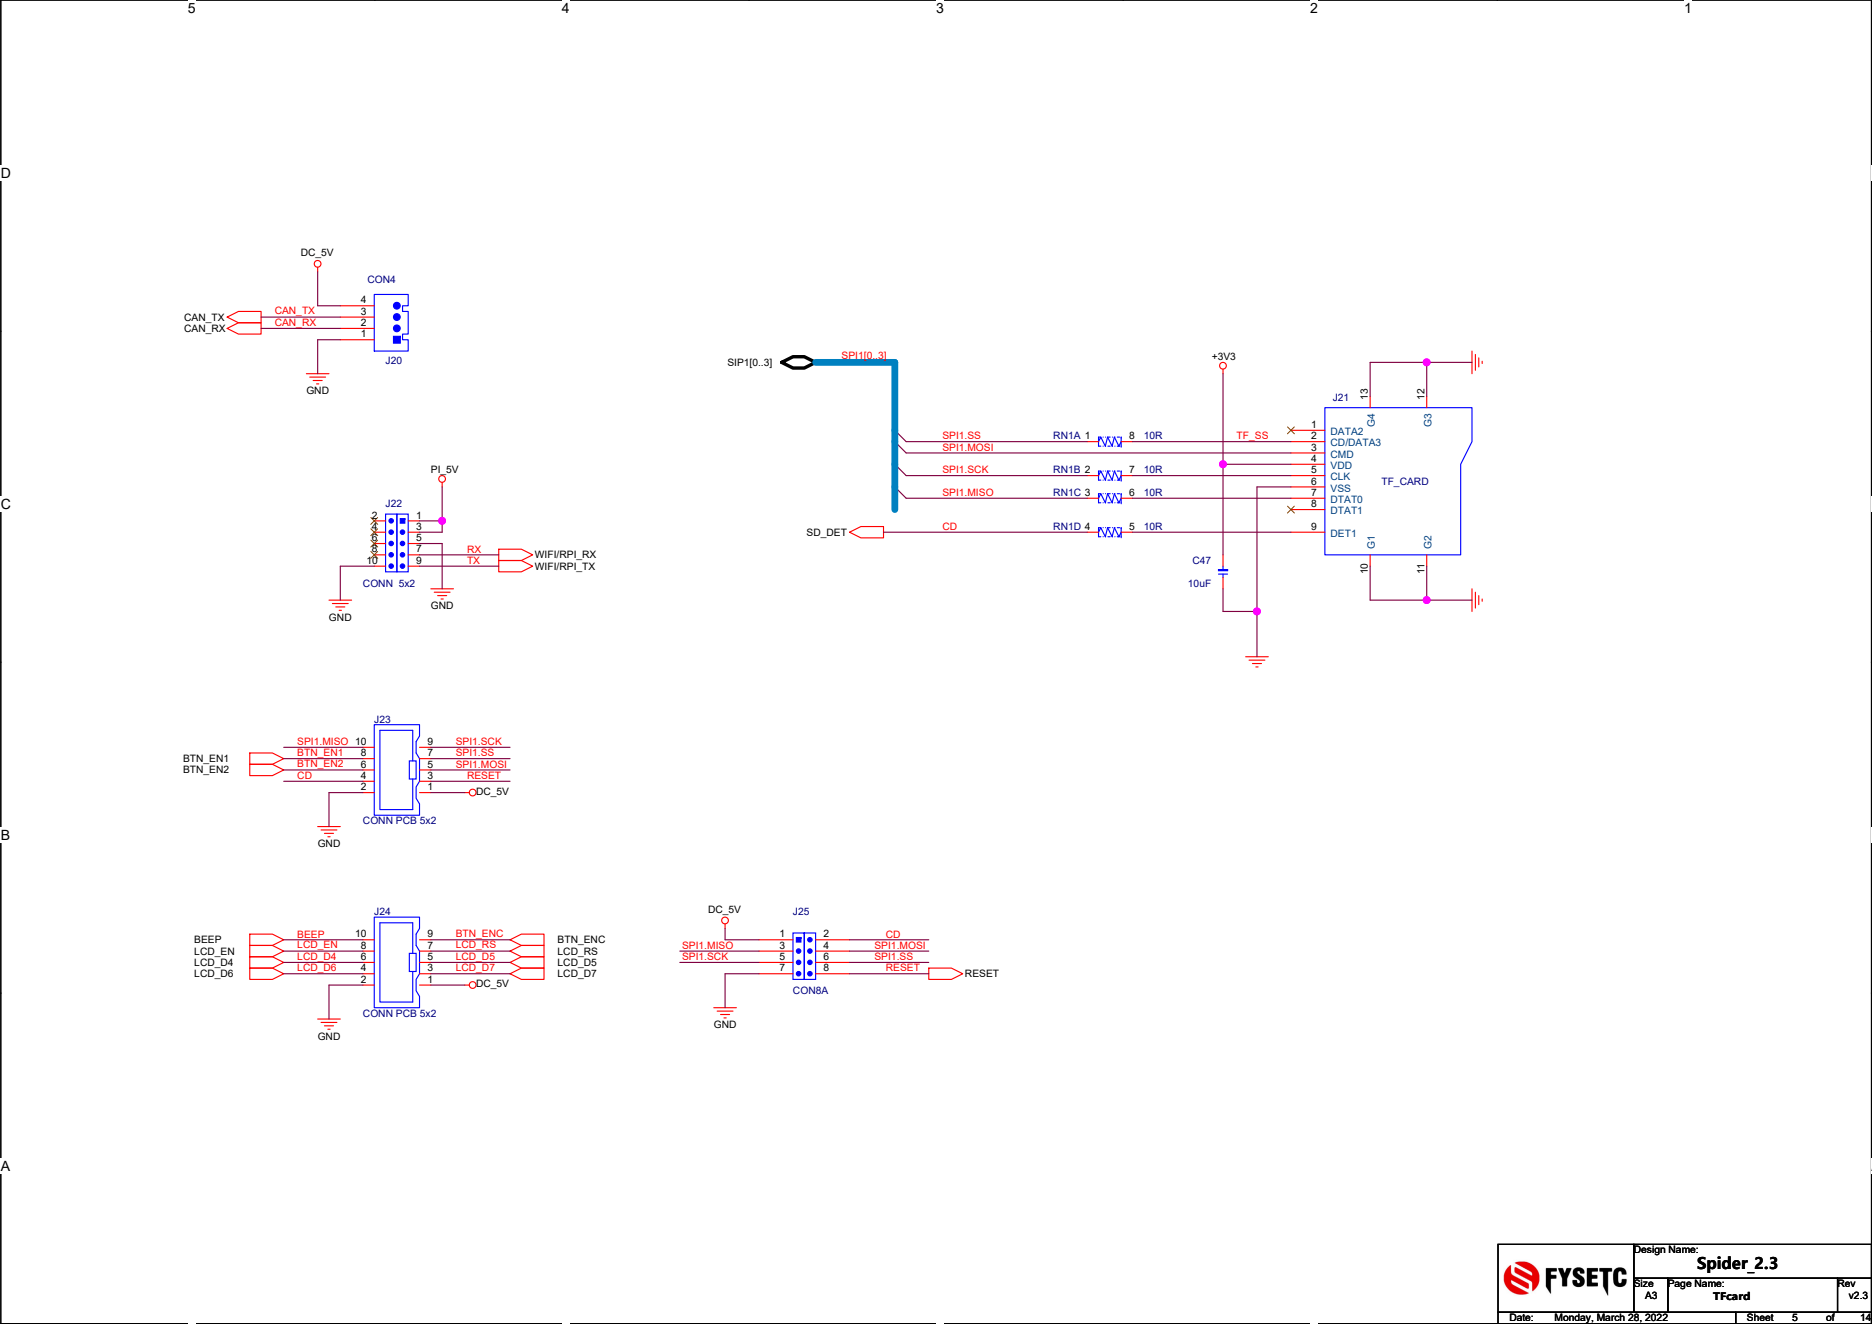
[picture p119: page 5]

TFcard TFcard TFcard

Monday, March 28, 2022 Monday, March 28, 2022 Monday, March 28, 2022 | 5 5 5 14 14 14

D

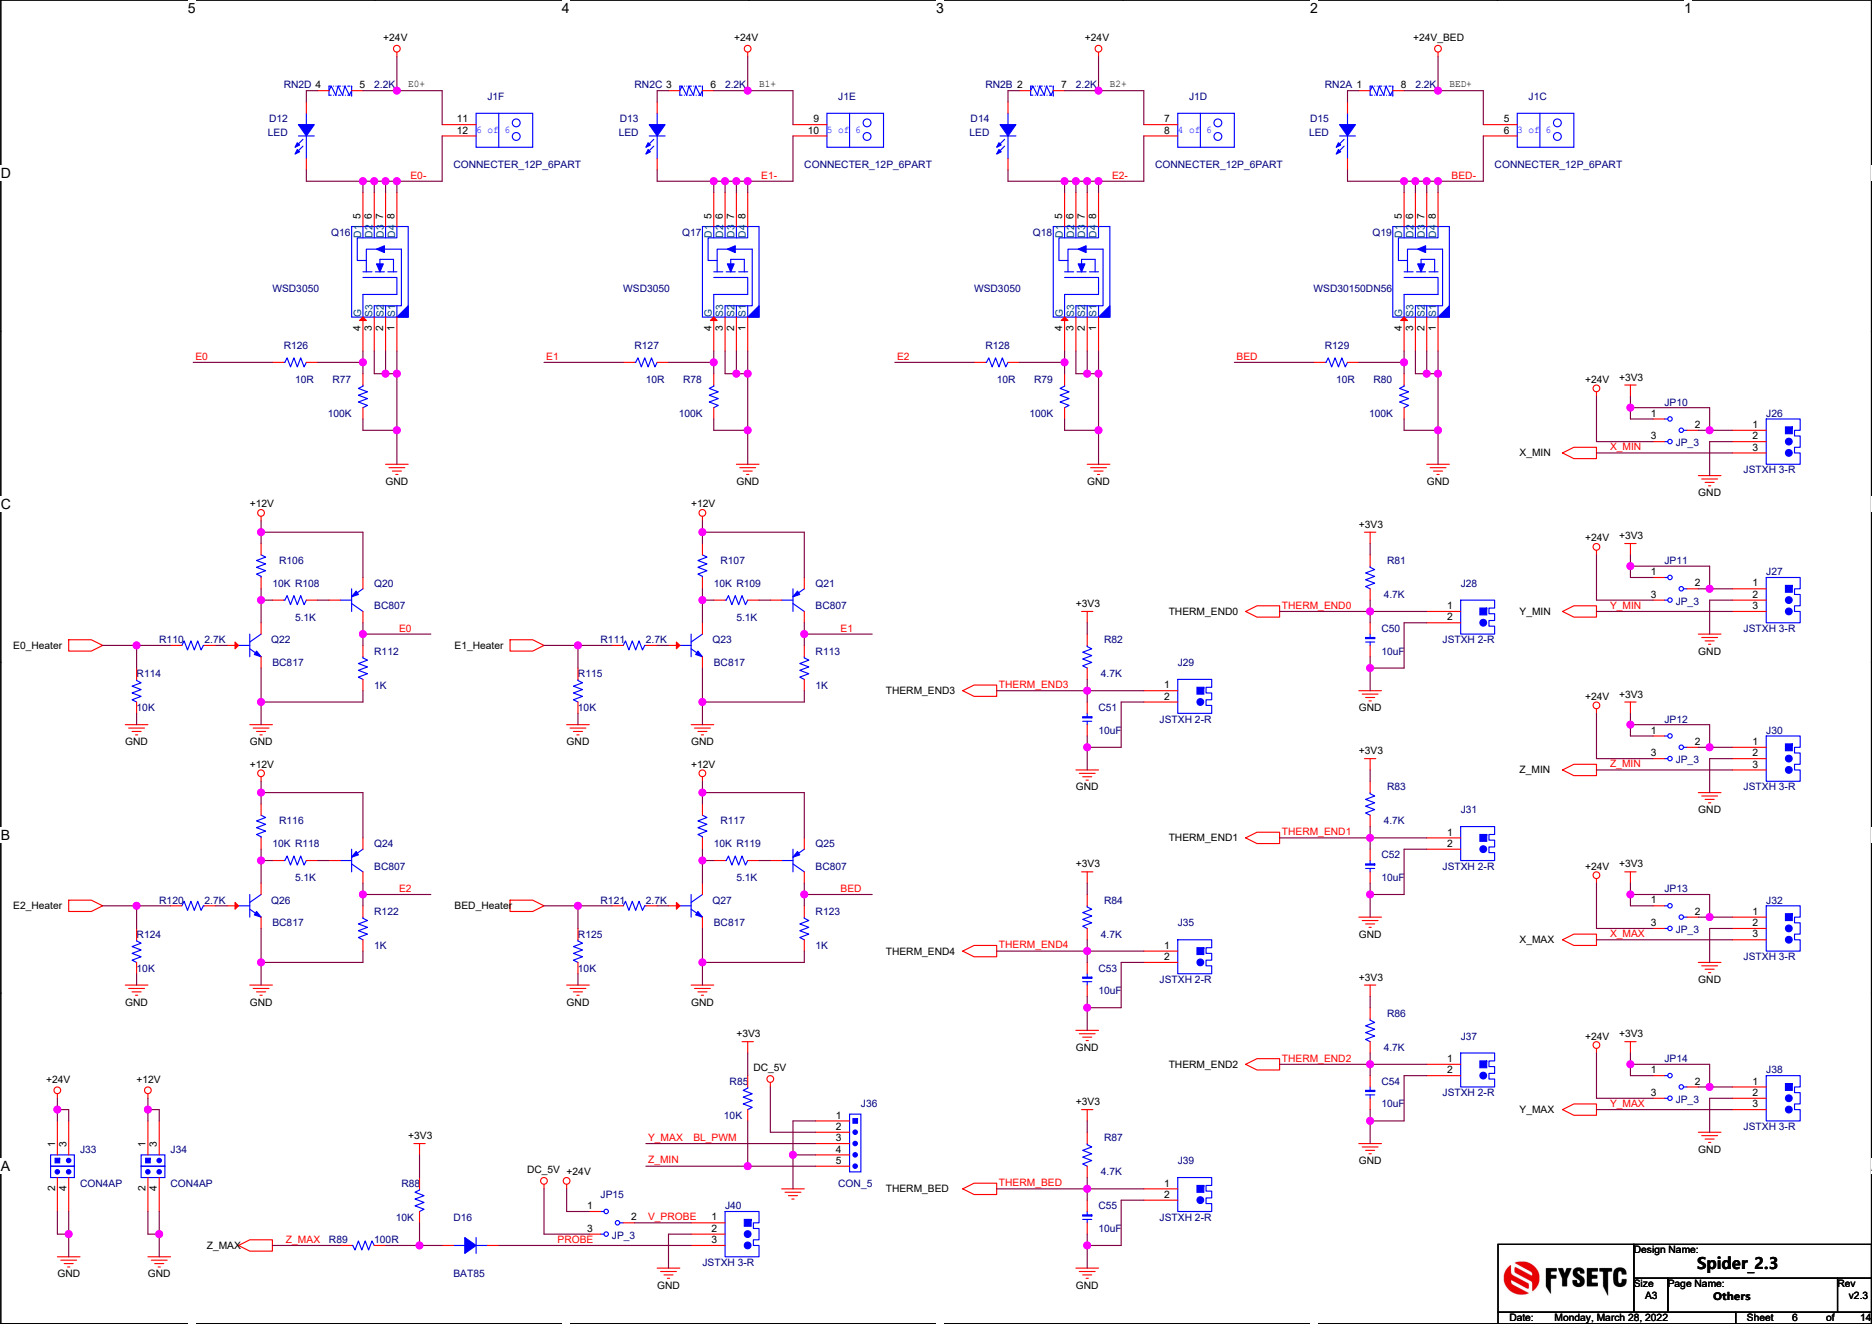
[picture p120: page 6]

D

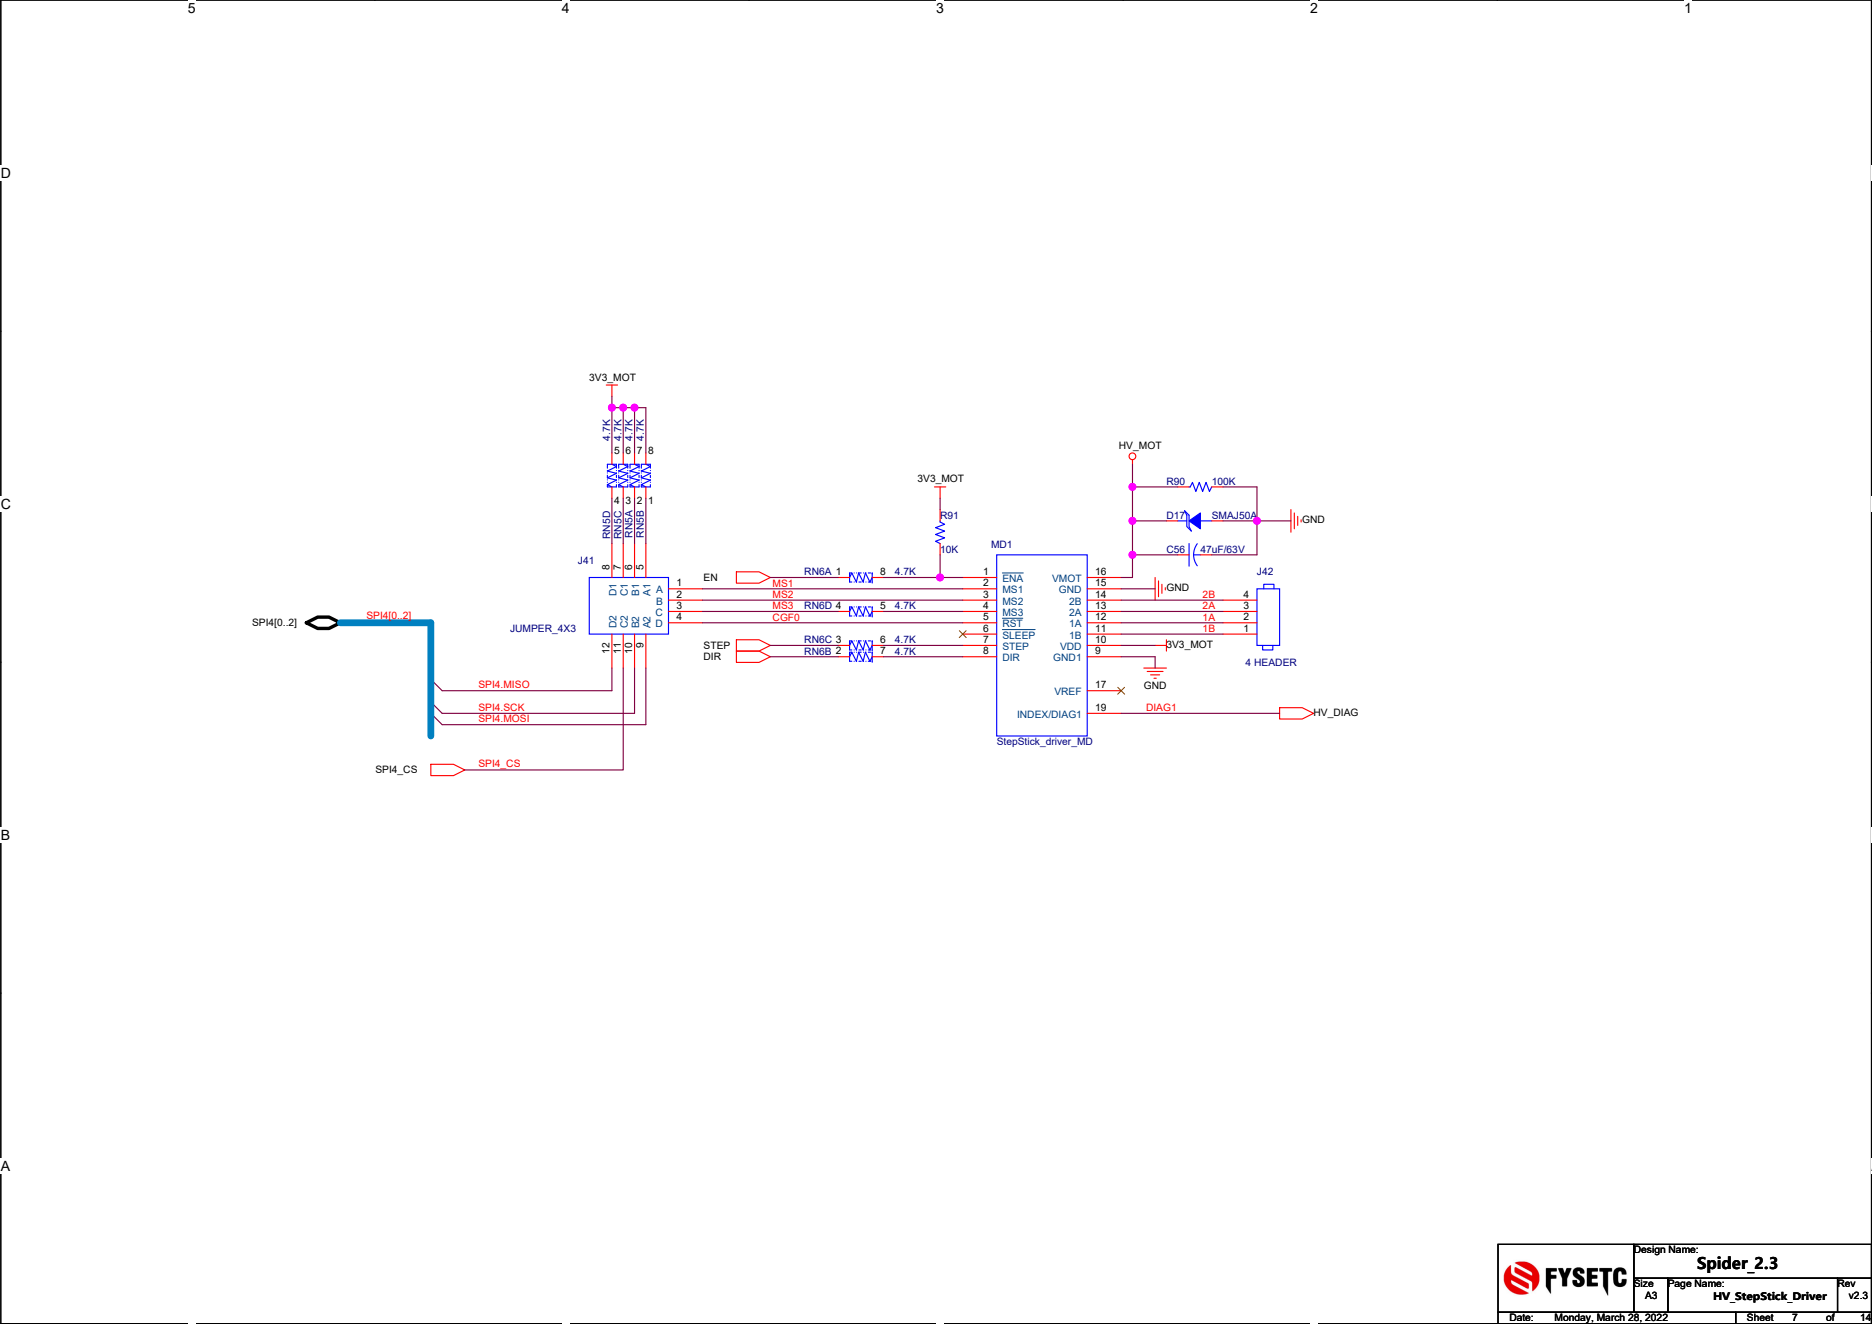
[picture p121: page 7]

MS3 4 | 3
RST 5 | 2
SLEEP 6 STEP 7 | 1B 1

HV_StepStick_Driver HV_StepStick_Driver HV_StepStick_Driver

Monday, March 28, 2022 Monday, March 28, 2022 Monday, March 28, 2022 | 7 7 7 14 14 14

D

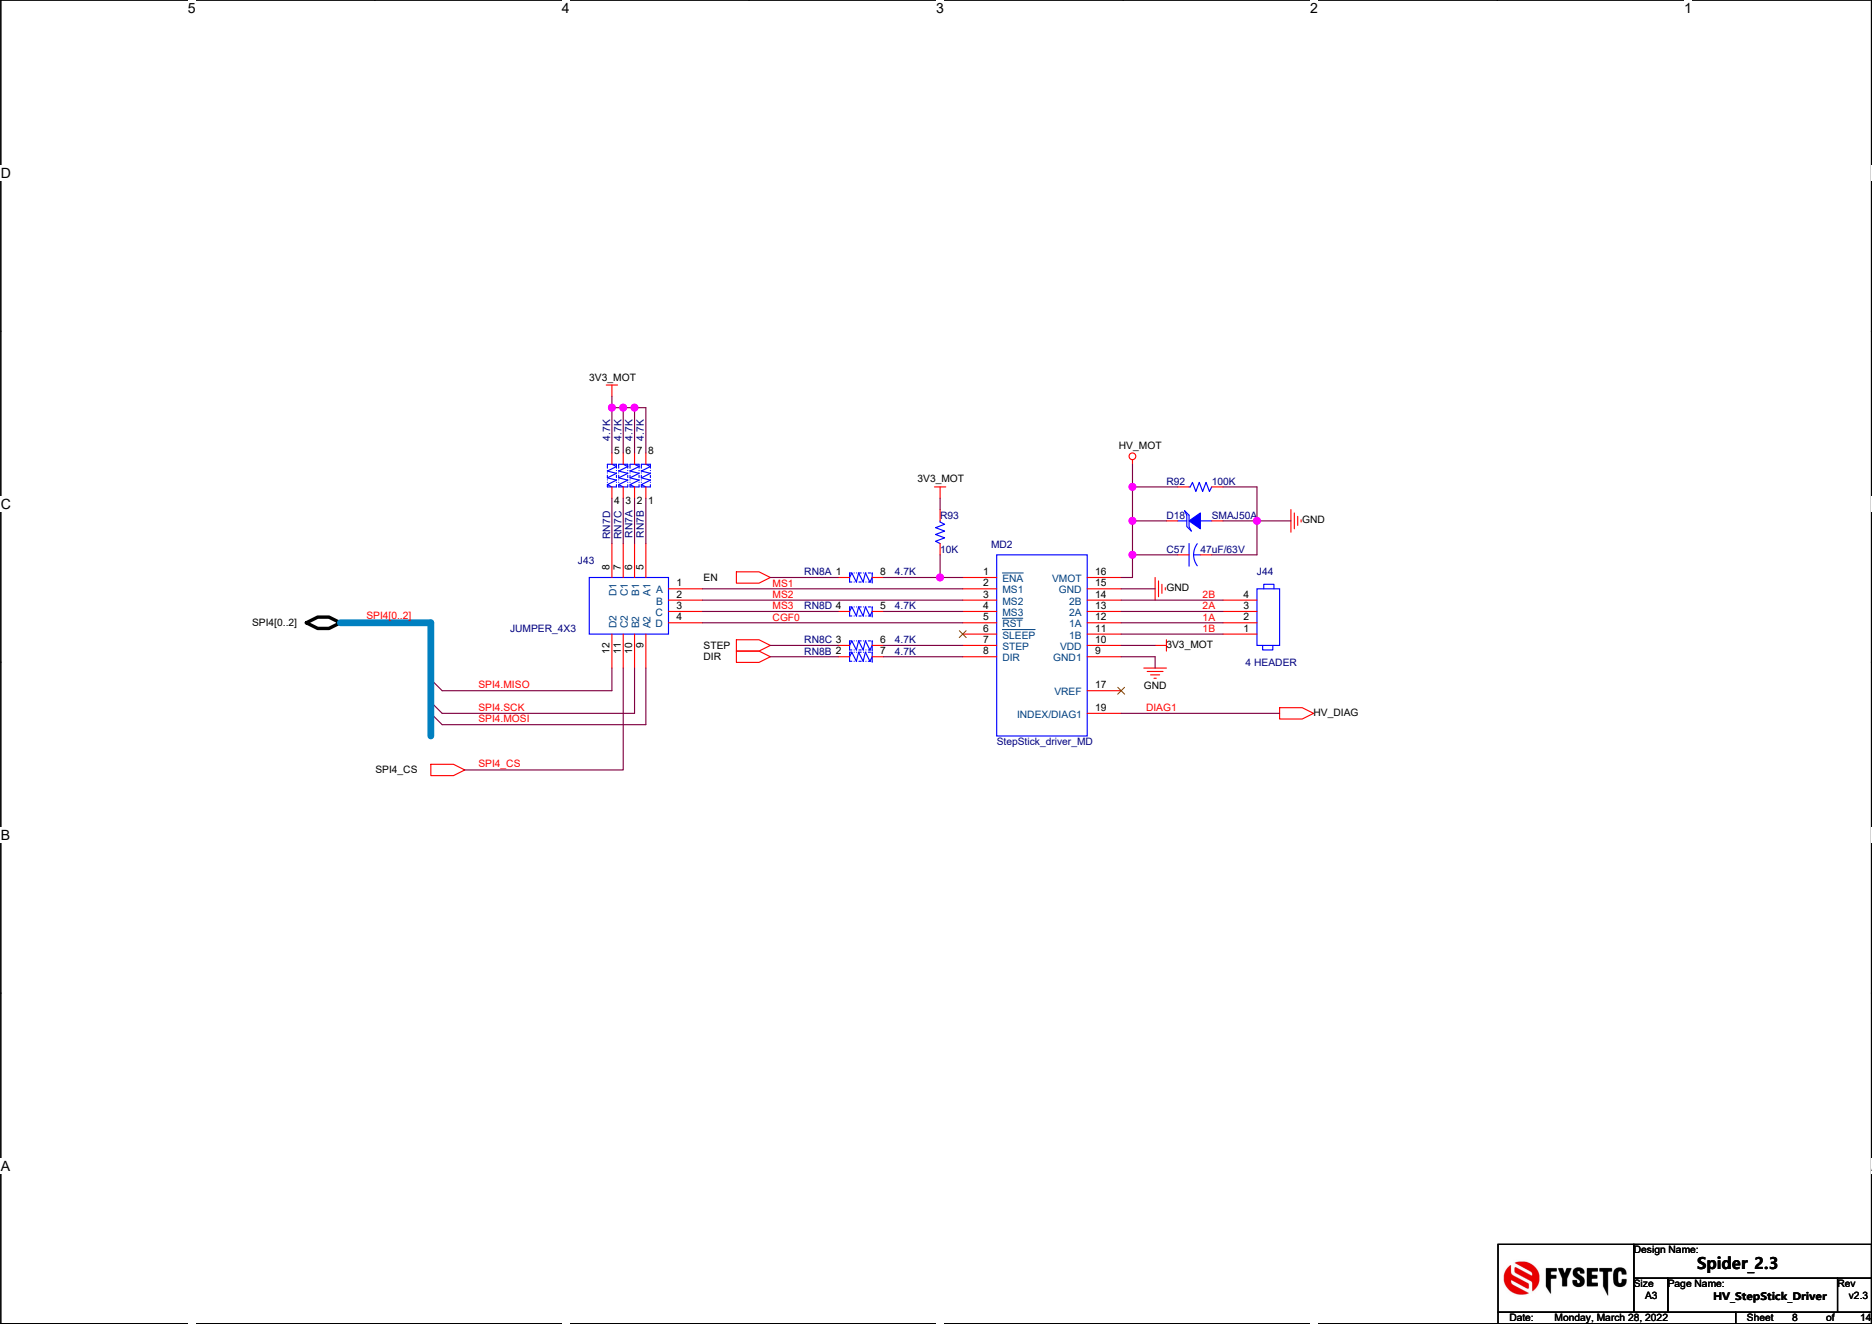
[picture p122: page 8]

MS3 4 | 3
RST 5 | 2
SLEEP 6 STEP 7 | 1B 1

HV_StepStick_Driver HV_StepStick_Driver HV_StepStick_Driver

Monday, March 28, 2022 Monday, March 28, 2022 Monday, March 28, 2022 | 8 8 8 14 14 14

D

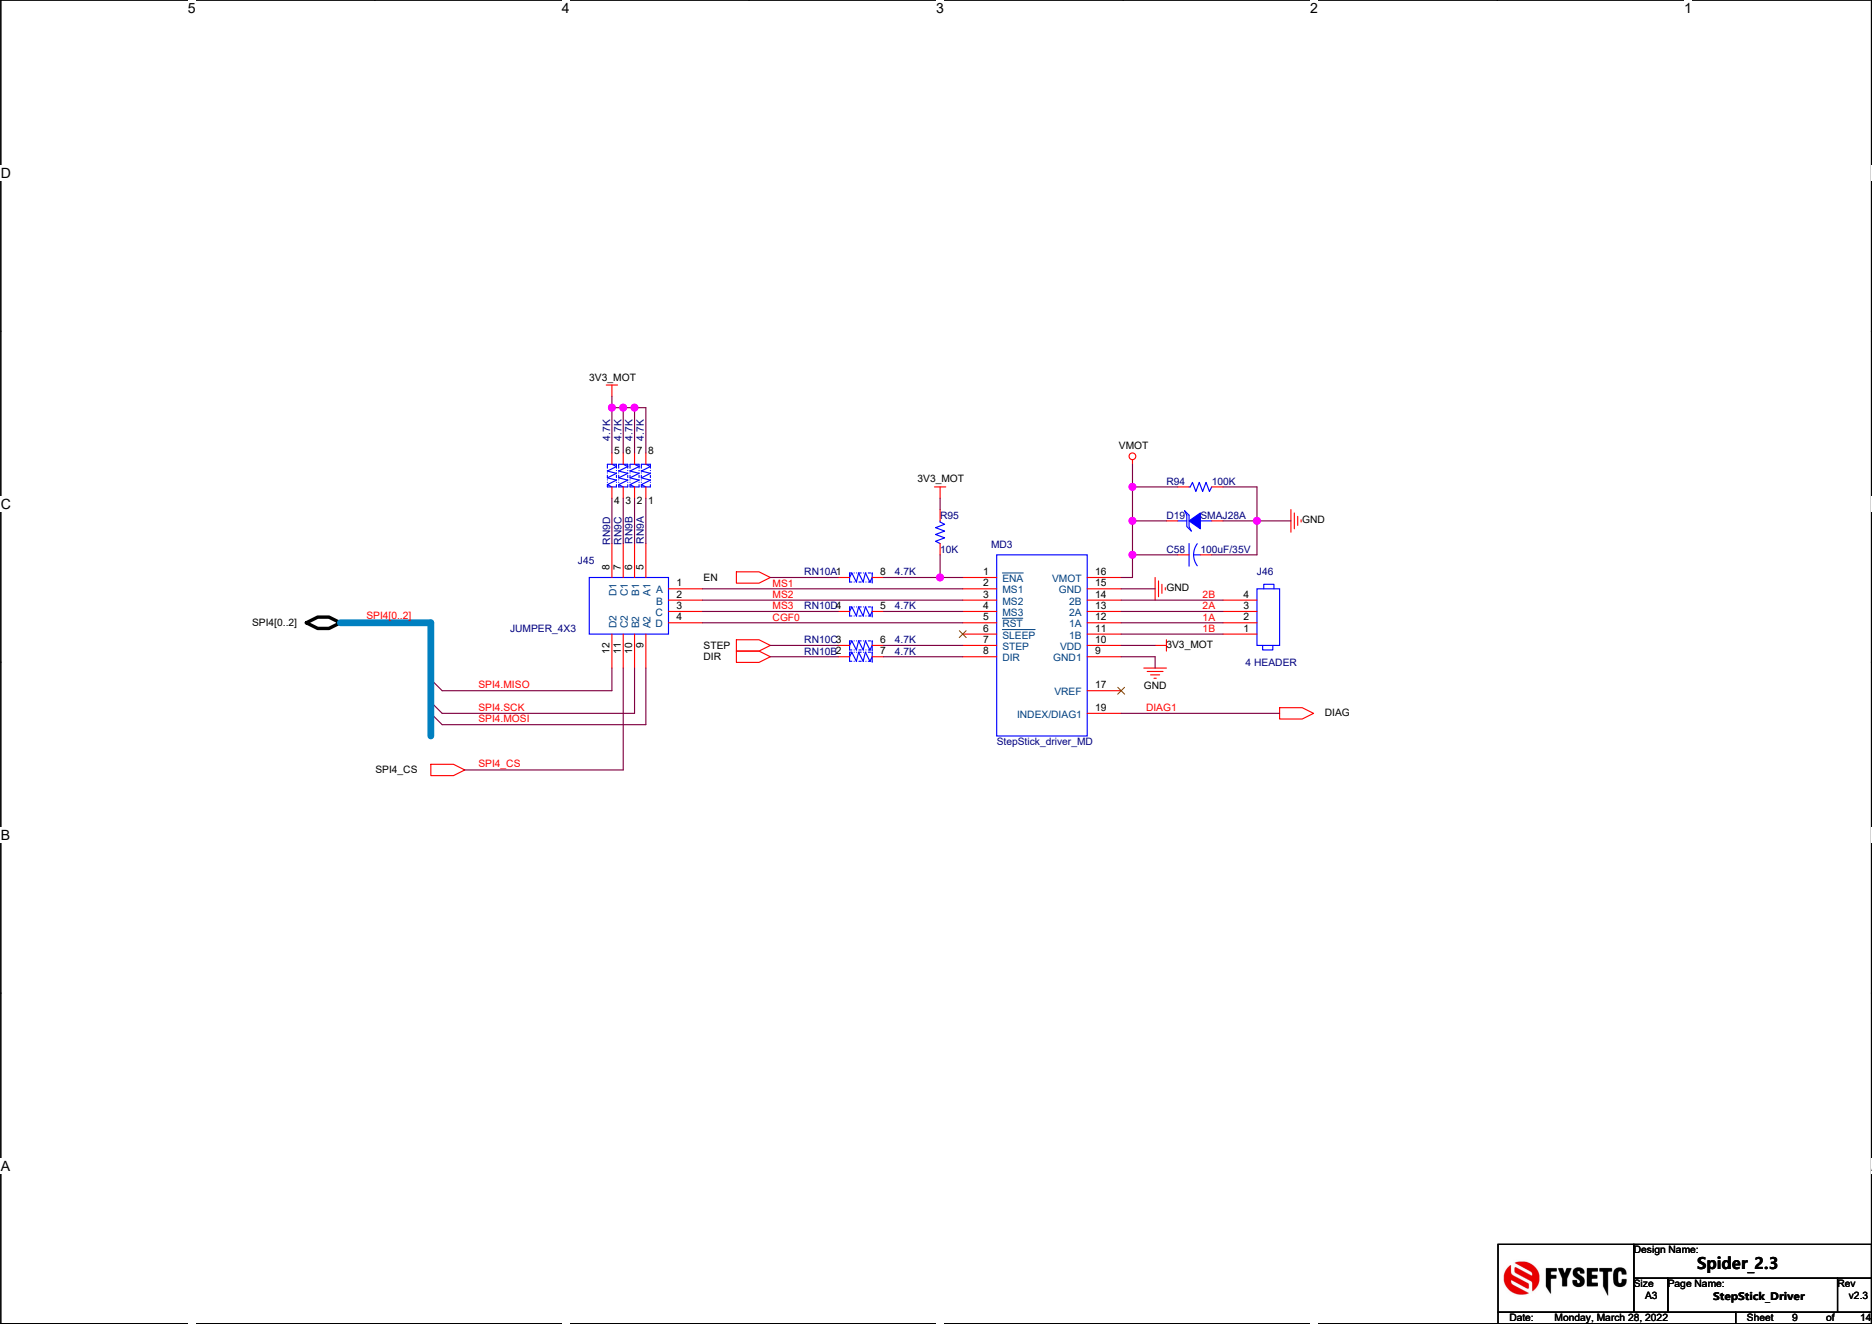
[picture p123: page 9]

MS3 4 | 3
RST 5 | 2
SLEEP 6 STEP 7 | 1B 1

StepStick_Driver

Monday, March 28, 2022 Monday, March 28, 2022 Monday, March 28, 2022 | 9 9 9 14 14 14

D

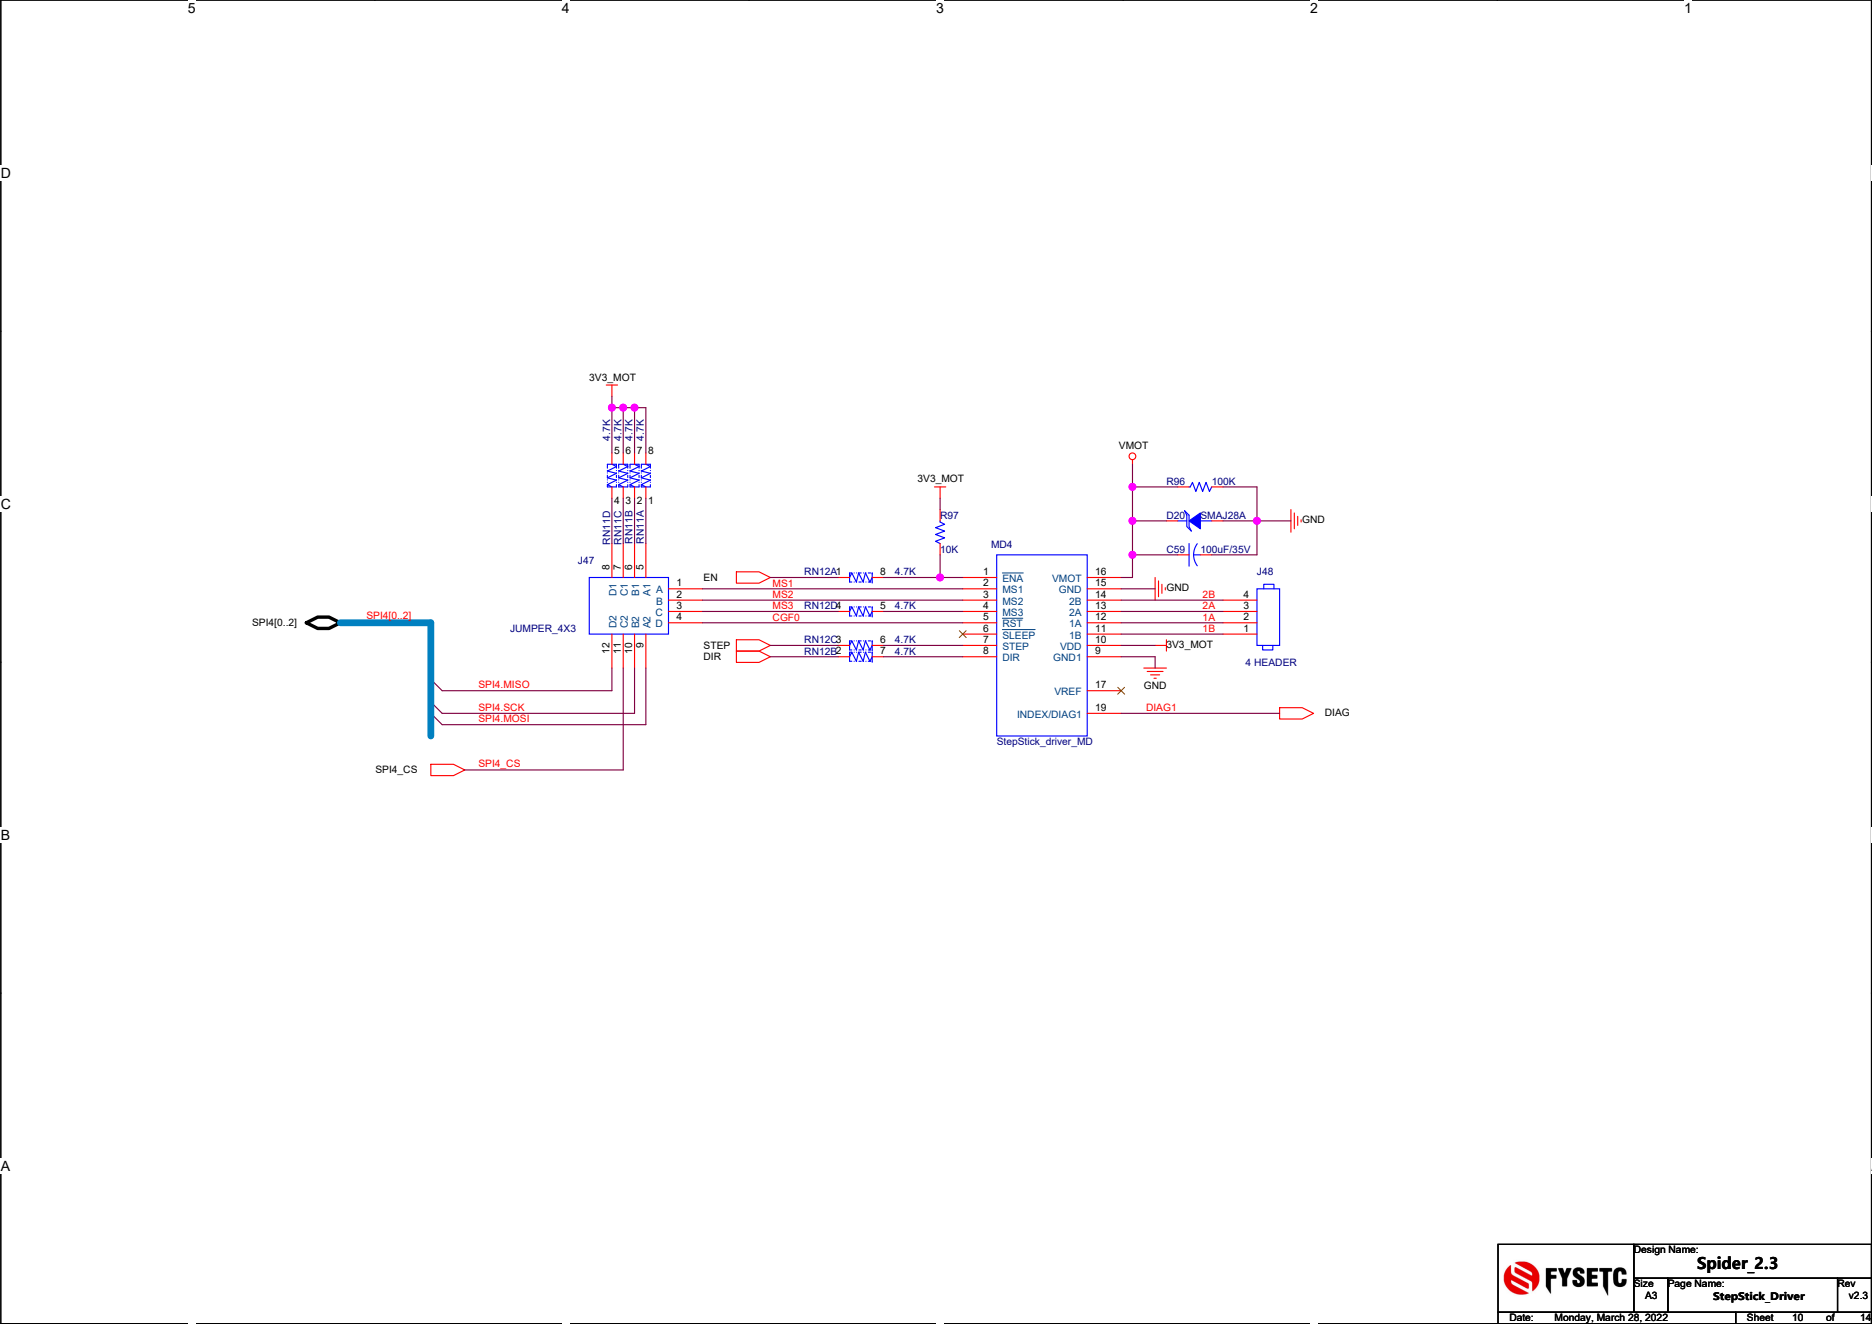
[picture p124: page 10]

MS3 4 | 3
RST 5 | 2
SLEEP 6 STEP 7 | 1B 1

D

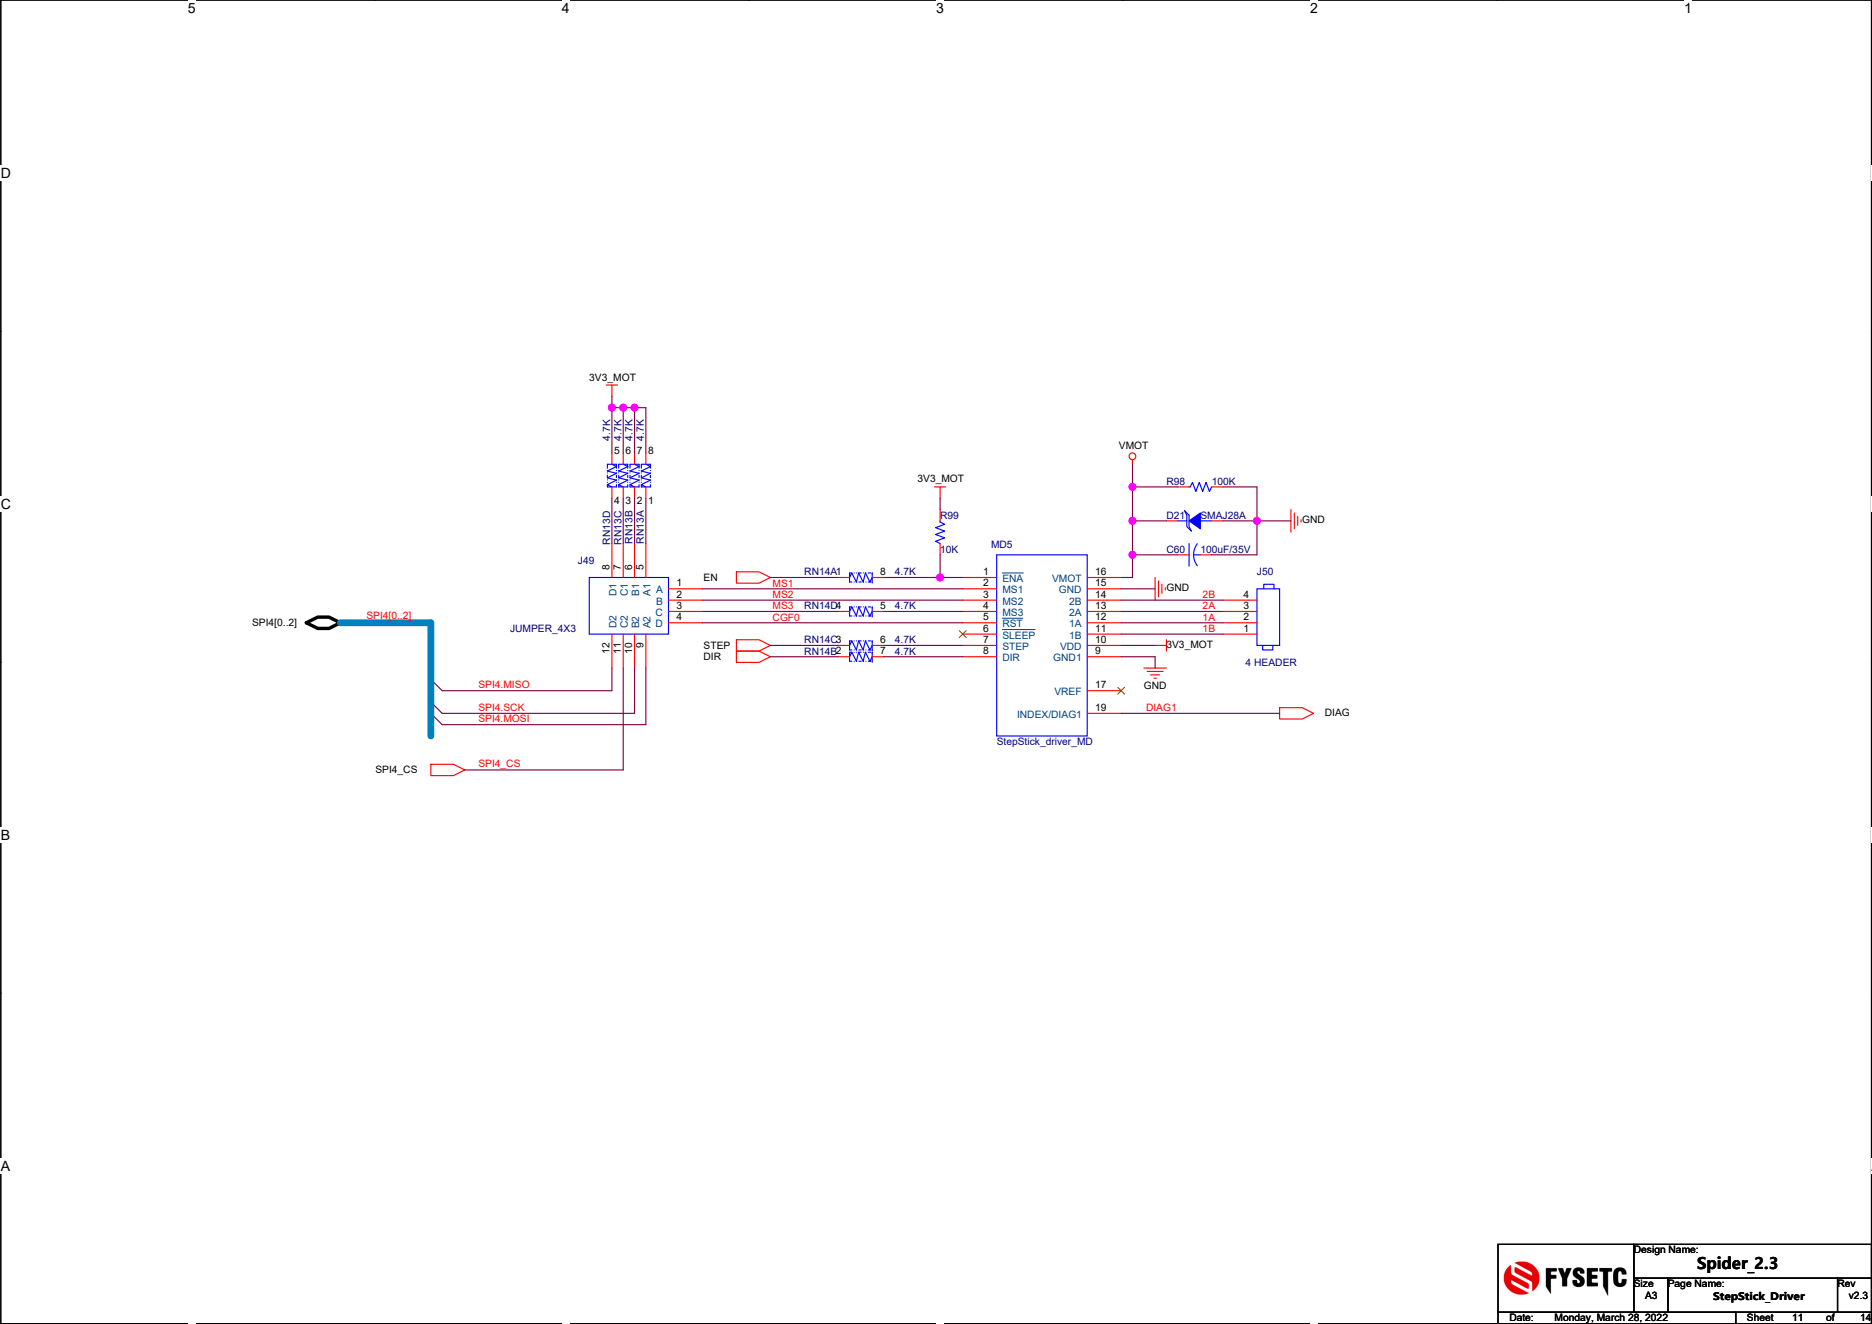
[picture p125: page 11]

MS3 4 | 3
RST 5 | 2
SLEEP 6 STEP 7 | 1B 1

D

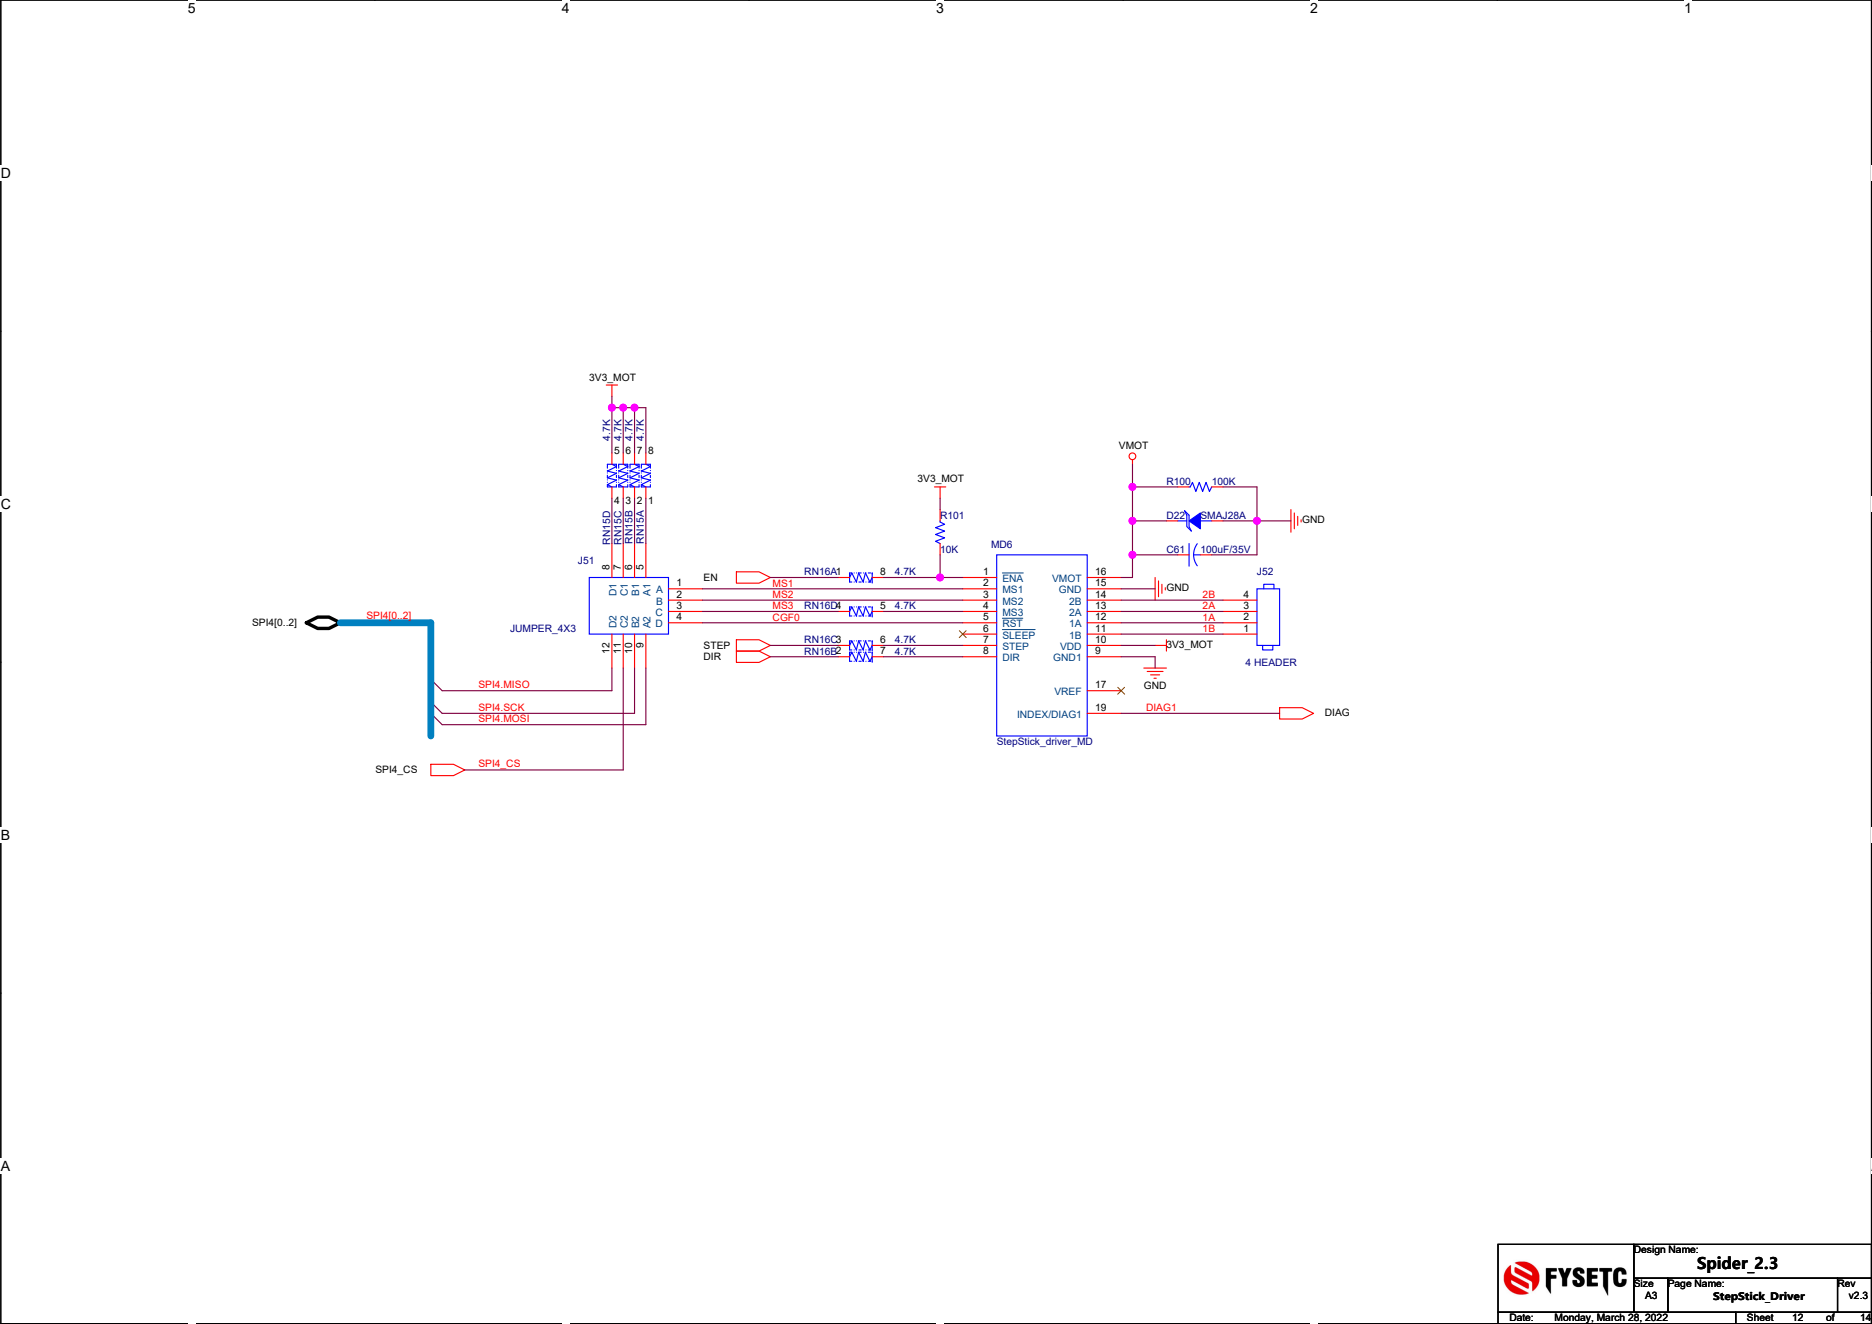
[picture p126: page 12]

MS3 4 | 3
RST 5 | 2
SLEEP 6 STEP 7 | 1B 1

D

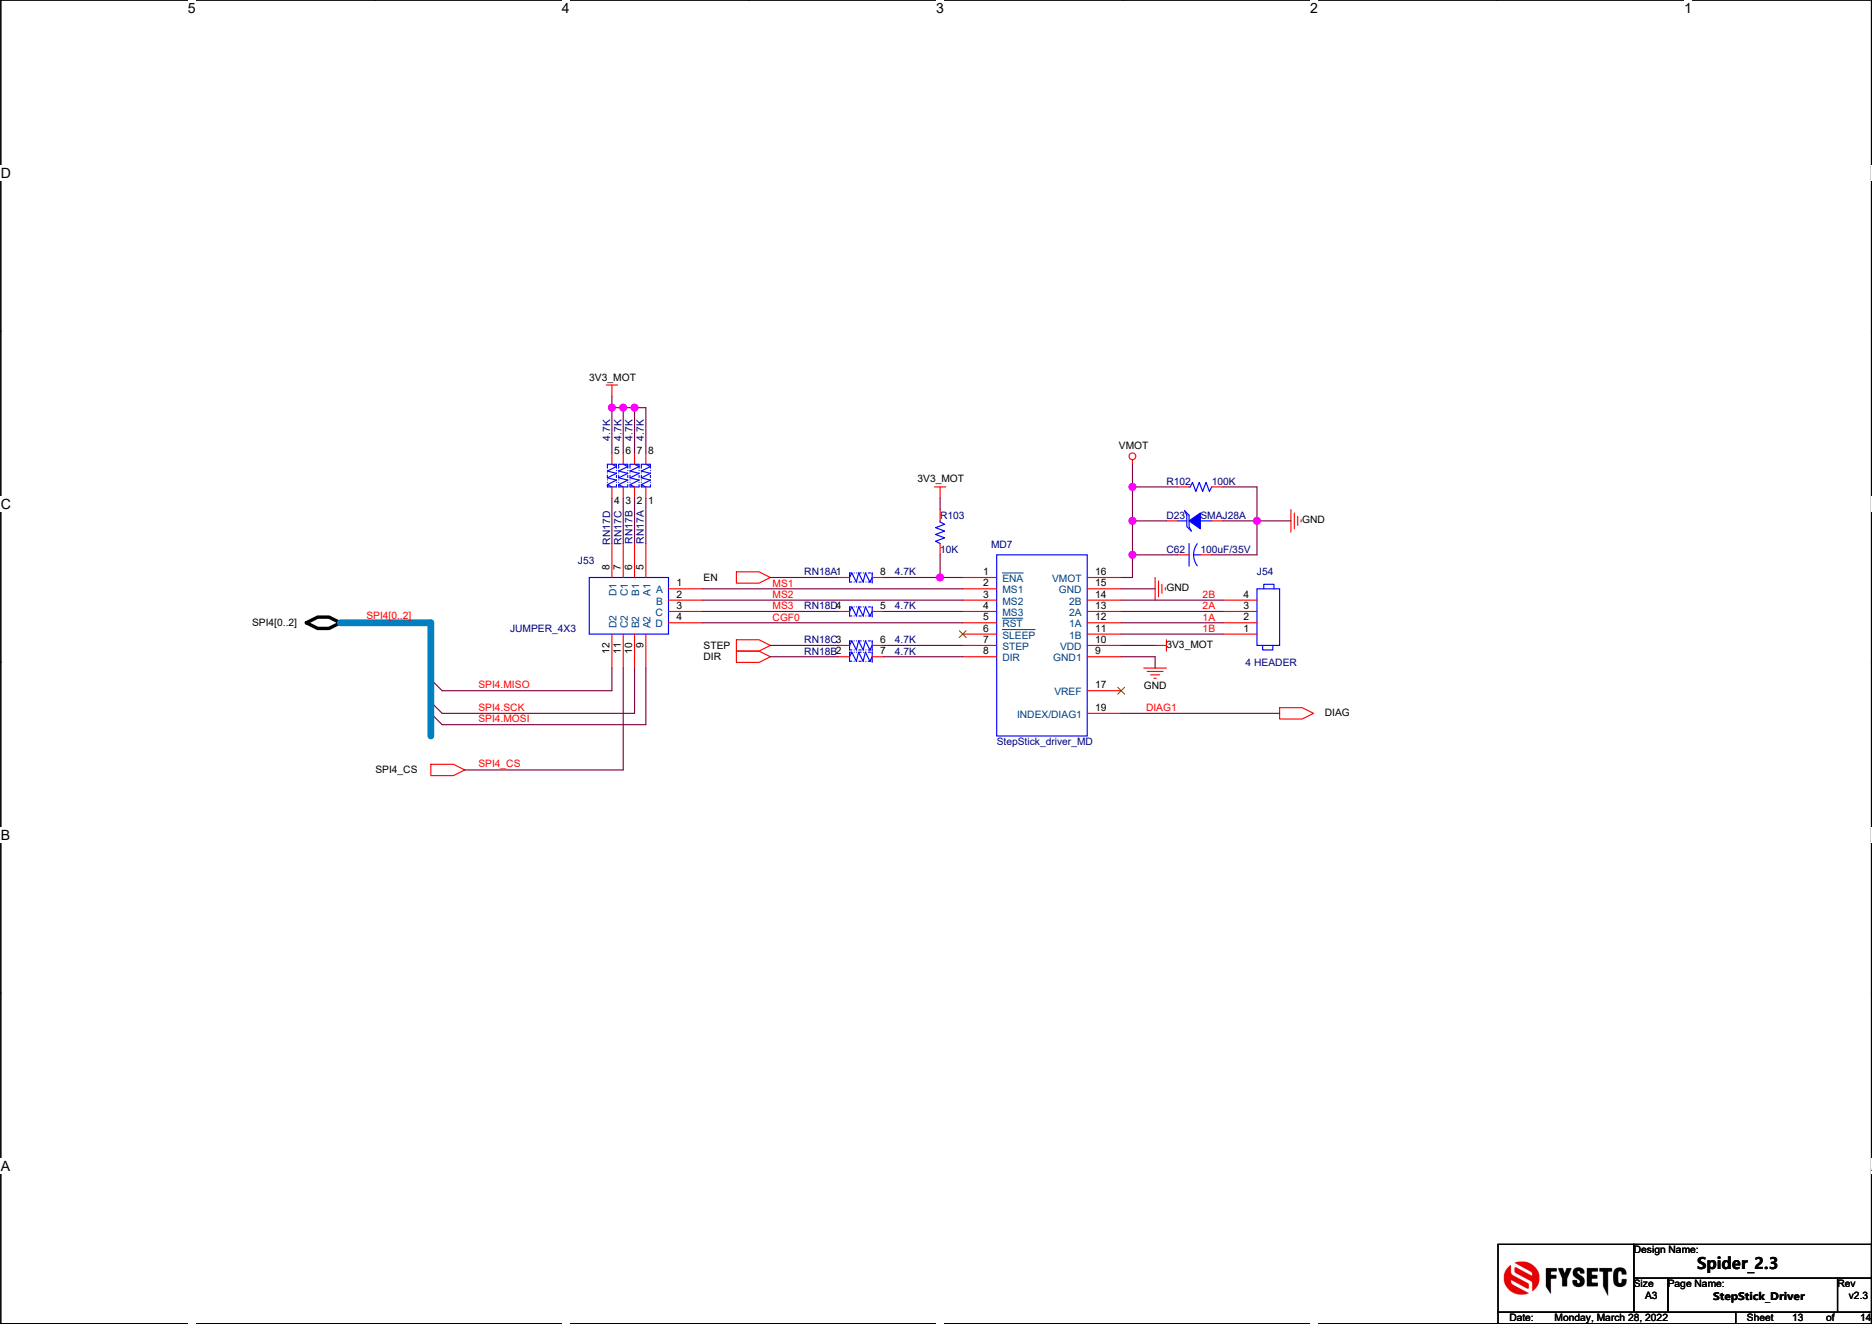
[picture p127: page 13]

MS3 4 | 3
RST 5 | 2
SLEEP 6 STEP 7 | 1B 1

D

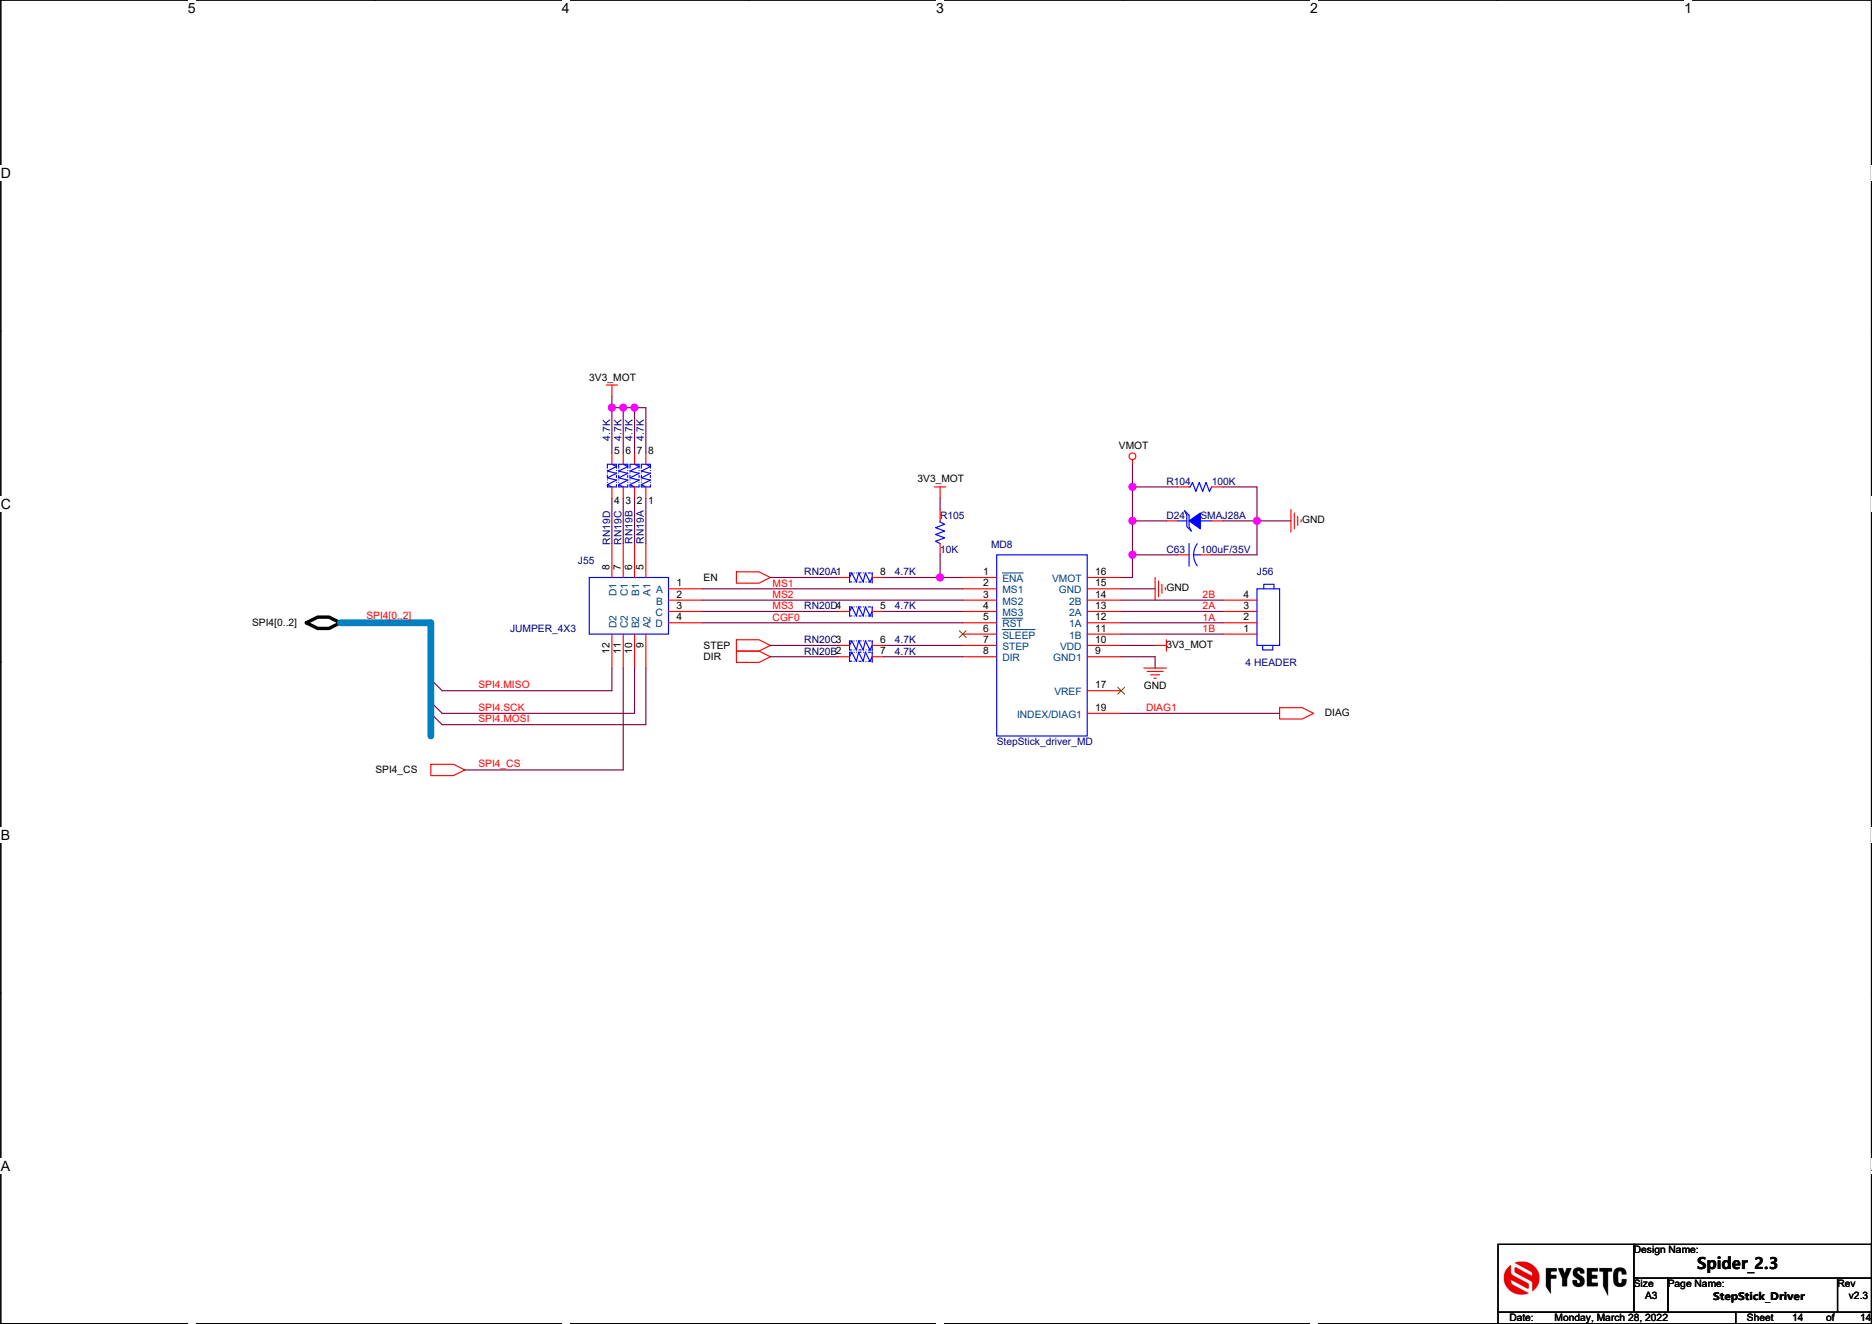
[picture p128: page 14]

MS3 4 | 3
RST 5 | 2
SLEEP 6 STEP 7 | 1B 1
