FYSETC/FYSETC-SPIDER/hardware/V2.2/Spider V2.2 SCH.pdf

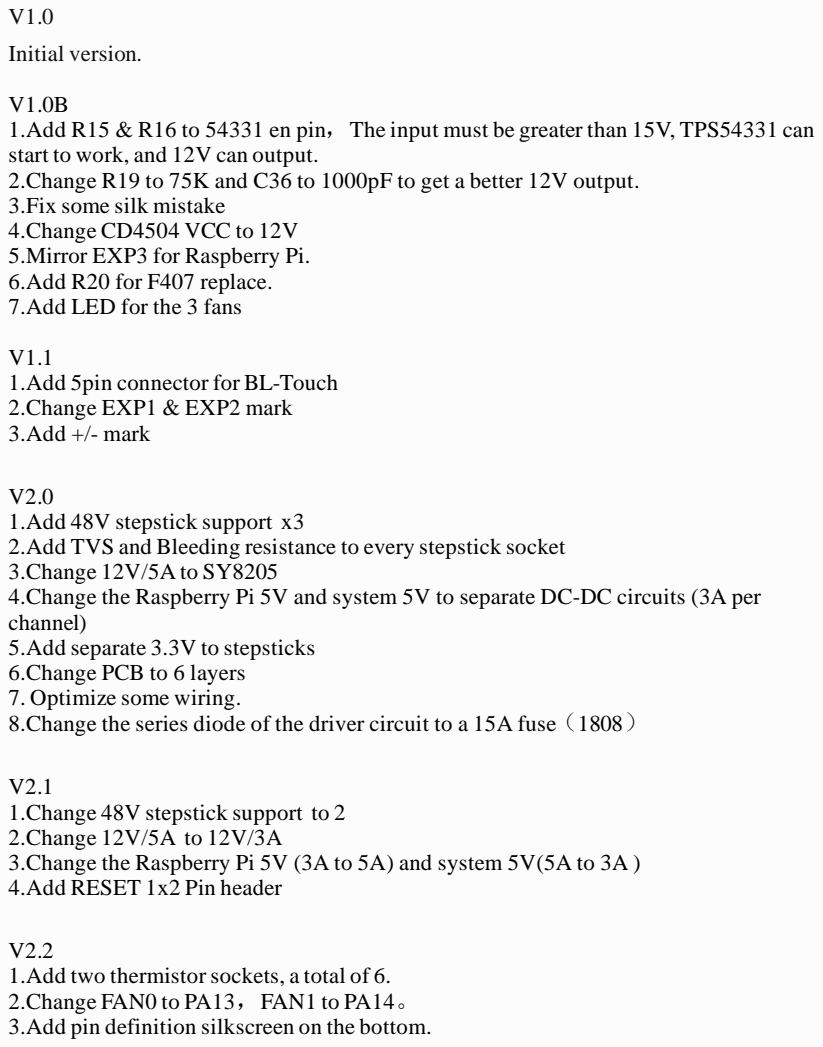
[picture p129: page 1]

1.Add R15 & R16 to 54331 en pin，The input must be greater than 15V, TPS54331 can
start to work, and 12V can output.
2.Change R19 to 75K and C36 to 1000pF to get a better 12V output.
3.Fix some silk mistake
4.Change CD4504 VCC to 12V
5.Mirror EXP3 for Raspberry Pi.
6.Add R20 for F407 replace.
7.Add LED for the 3 fans

1.Add 5pin connector for BL-Touch
2.Change EXP1 & EXP2 mark
3.Add +/- mark

1.Add 48V stepstick support x3
2.Add TVS and Bleeding resistance to every stepstick socket
3.Change 12V/5A to SY8205
4.Change the Raspberry Pi 5V and system 5V to separate DC-DC circuits (3A per
channel)
5.Add separate 3.3V to stepsticks
6.Change PCB to 6 layers
7. Optimize some wiring.
8.Change the series diode of the driver circuit to a 15A fuse（1808）

1.Change 48V stepstick support to 2
2.Change 12V/5A to 12V/3A
3.Change the Raspberry Pi 5V (3A to 5A) and system 5V(5A to 3A )
4.Add RESET 1x2 Pin header

1.Add two thermistor sockets, a total of 6.
2.Change FAN0 to PA13，FAN1 to PA14。
3.Add pin definition silkscreen on the bottom.

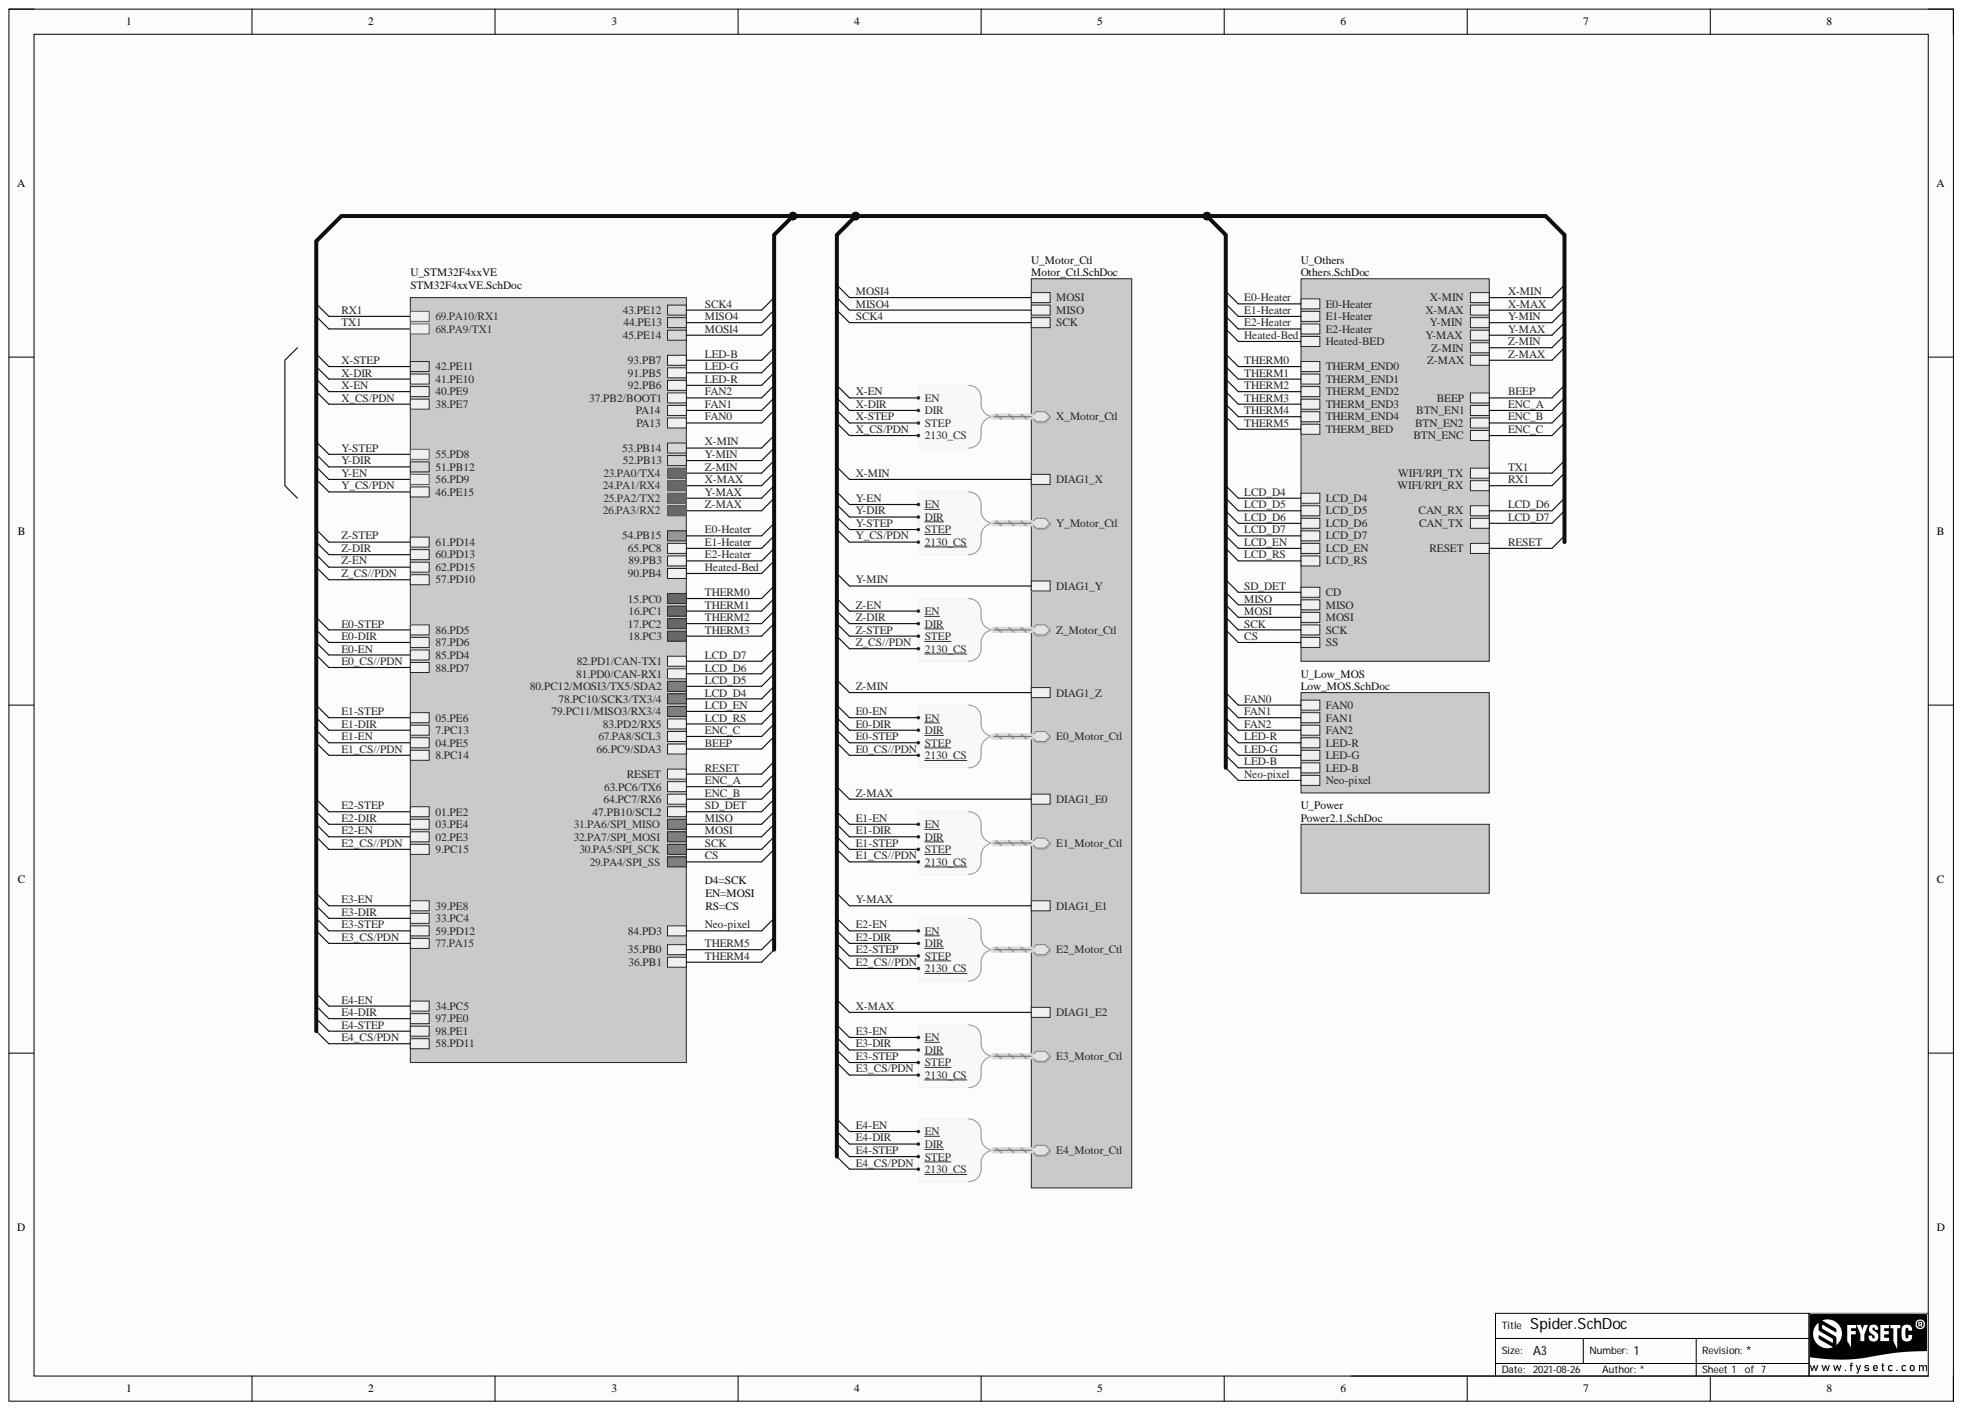
[picture p130: page 2]

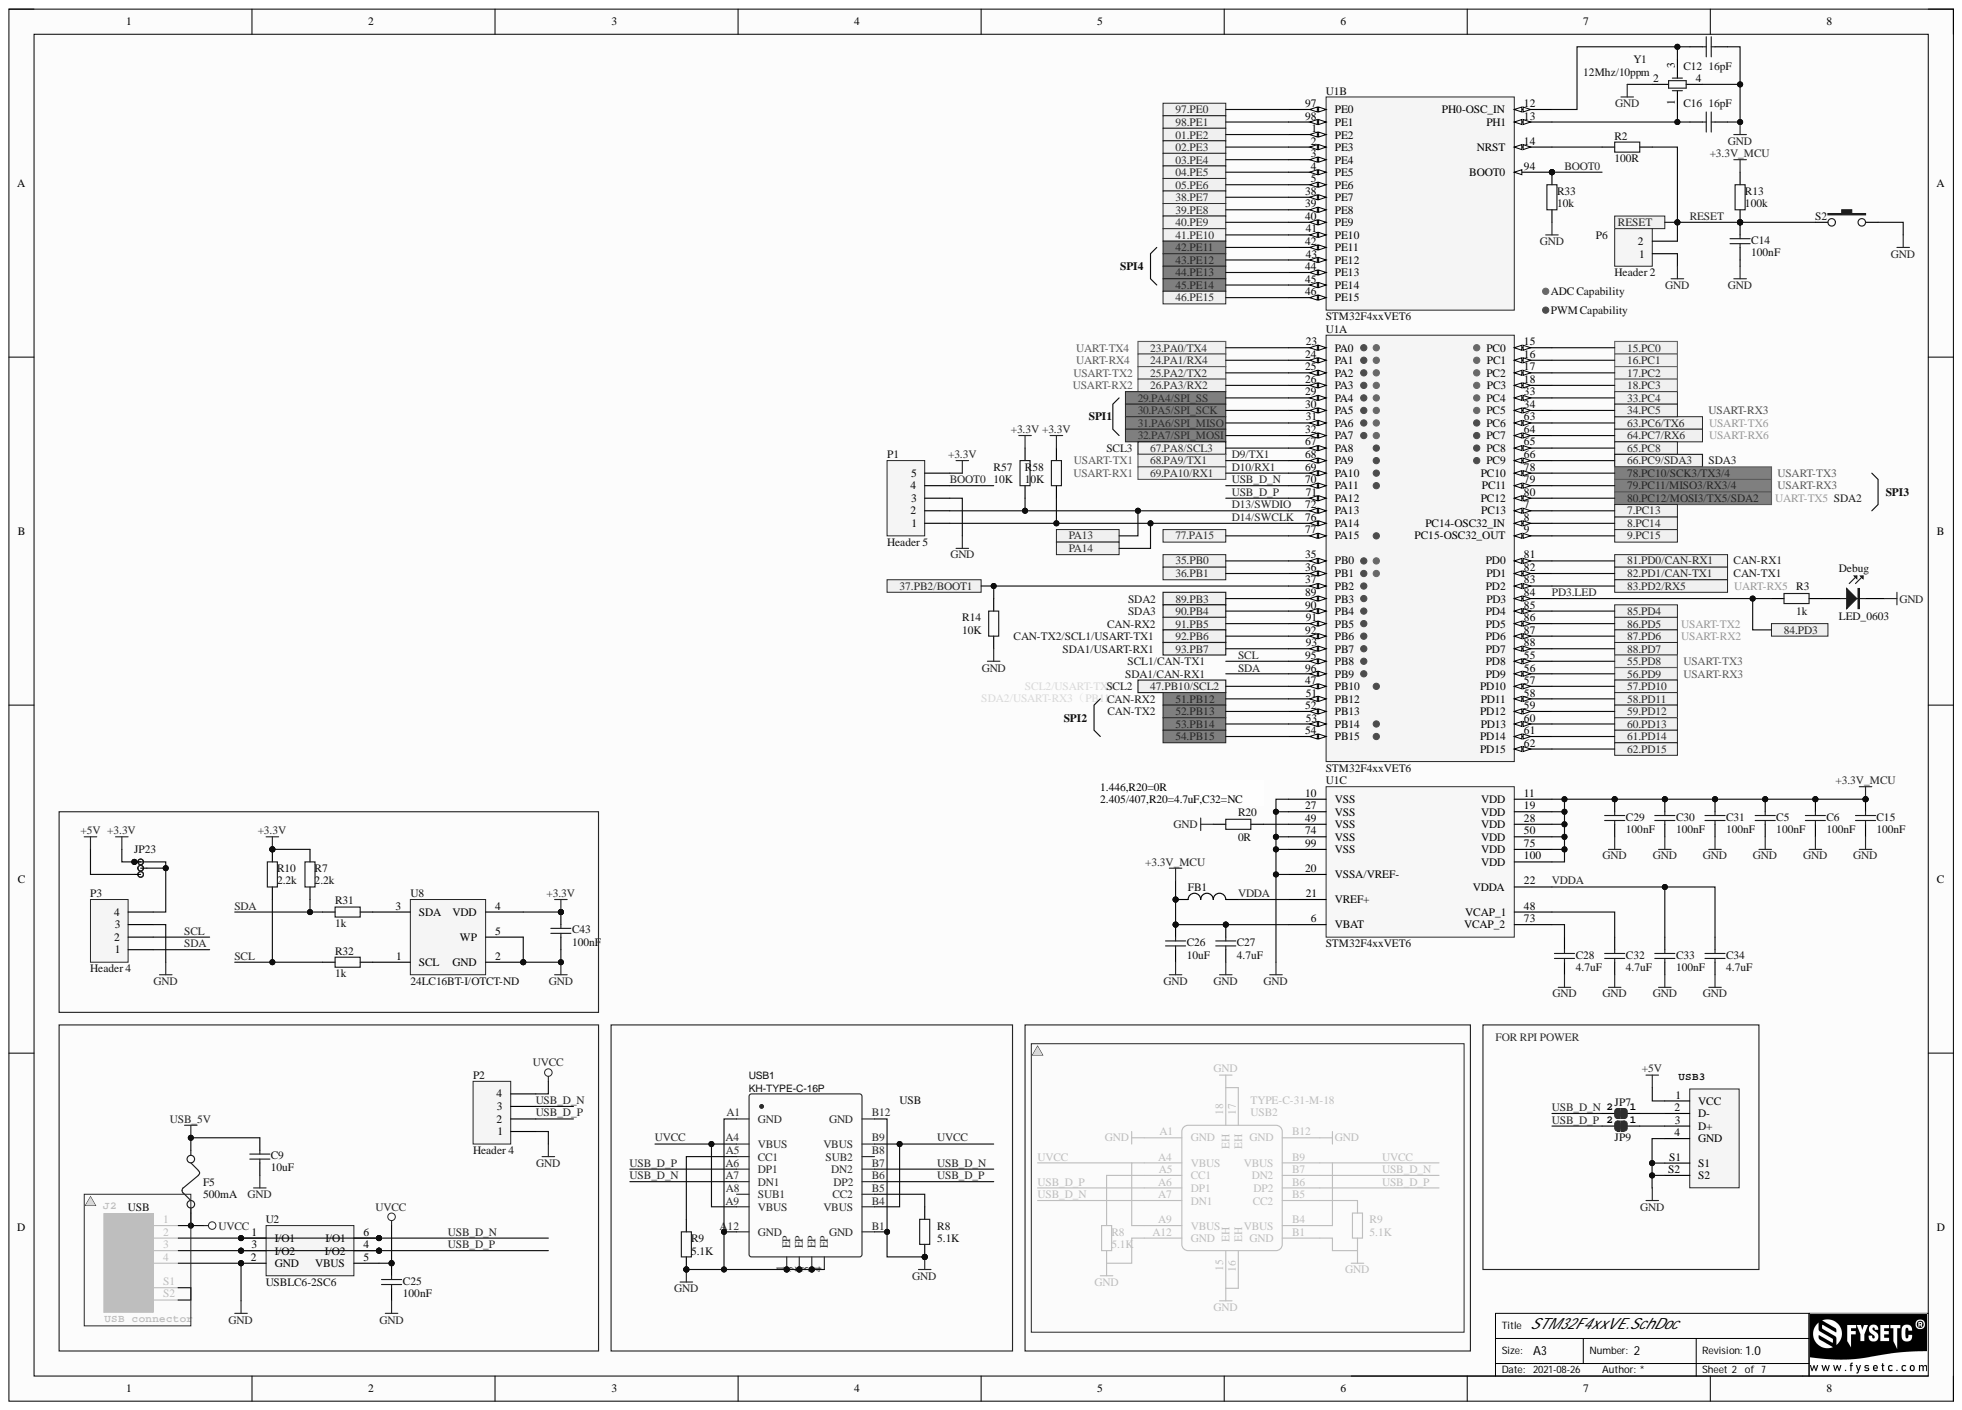
[picture p131: page 3]

02.PE3 03.PE4 | PE4 3 | 100R
04.PE5 | PE5 4
05.PE6 | PE7 38
38.PE7 | PE8 39

43.PE12 | PE12 43
44.PE13 | PE13 44
45.PE14 | PE15 46

24.PA1/RX4 | PA1 24 | 16.PC1
25.PA2/TX2 | PA3 26 | 17.PC2
26.PA3/RX2 | | 18.PC3
29.PA4/SPI_SS | PA4 29 | 33.PC4
30.PA5/SPI_SCK | PA5 30 | 34.PC5
31.PA6/SPI_MISO | PA7 32 | 63.PC6/TX6
32.PA7/SPI_MOSI | | 64.PC7/RX6
67.PA8/SCL3 | PA8 67 | 65.PC8

D14/SWCLK | PA14 76 | 7.PC13

35.PB0 | PB1 36 | | 81.PD0/CAN-RX1
36.PB1 | | | 82.PD1/CAN-TX1

89.PB3 | | PB4 90
90.PB4 | | | | 85.PD4
91.PB5 | | PB5 91 | | 86.PD5
92.PB6 | | PB6 92 | | 87.PD6 | 84.PD3
93.PB7 | SCL | PB8 95 | 88.PD7

47.PB10/SCL2 | PB12 51 | 57.PD10
51.PB12 | PB13 52 | 58.PD11
52.PB13 | | 59.PD12
53.PB14 | PB14 53 | 60.PD13
54.PB15 | | 61.PD14

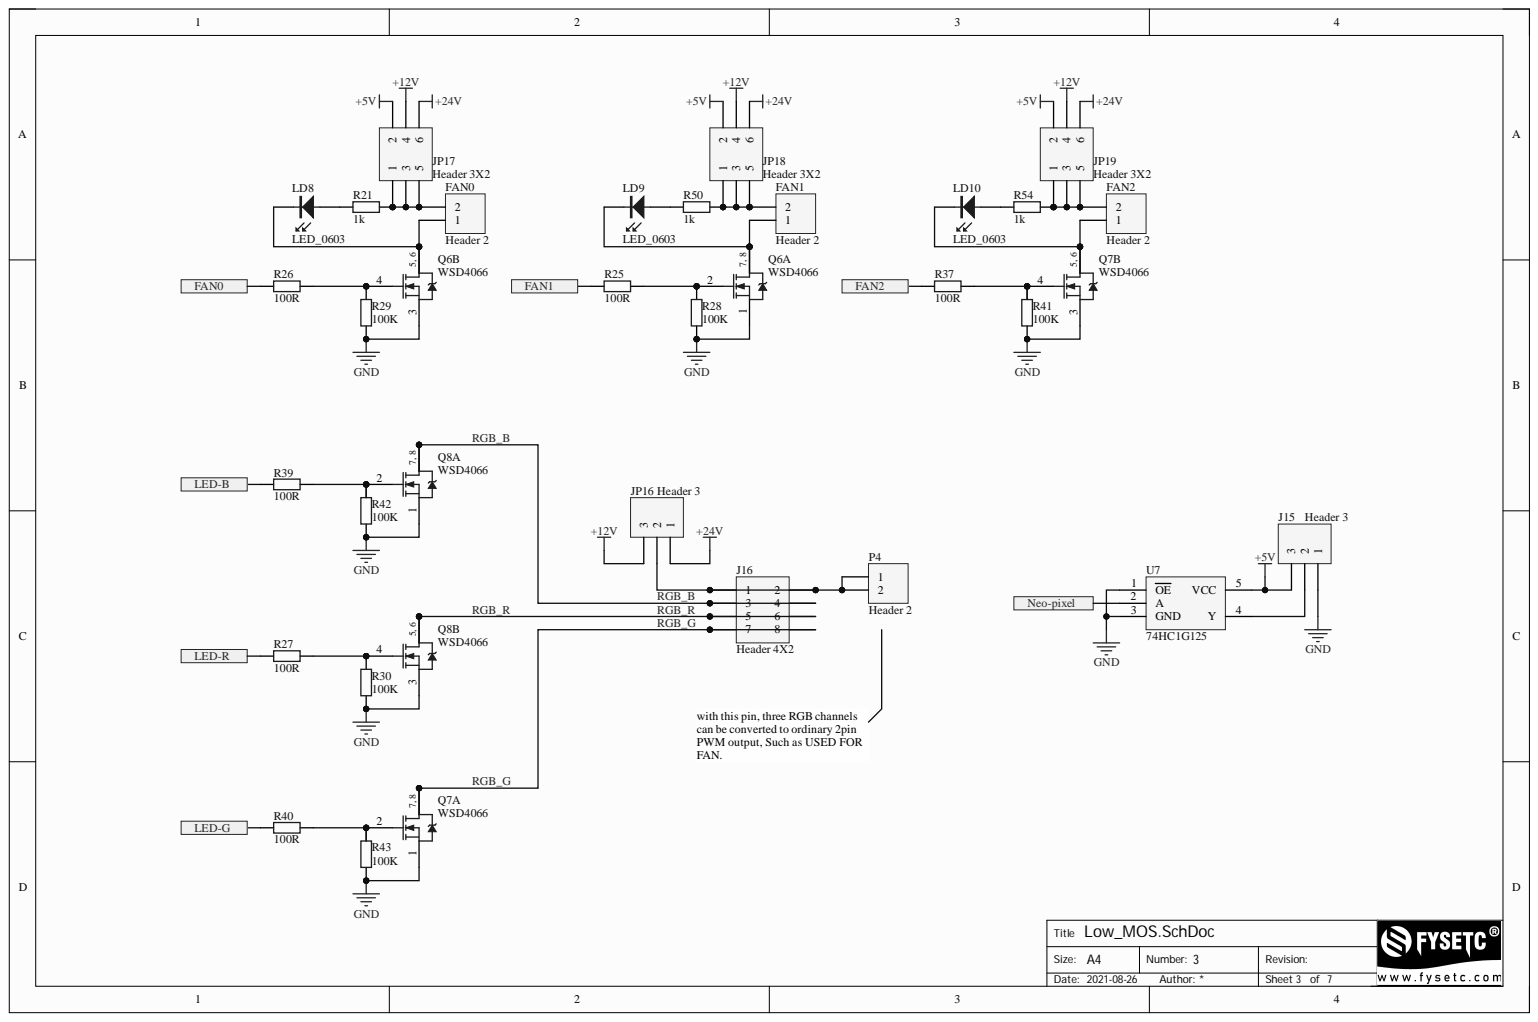
[picture p132: page 4]

RGB_G | 7 8

with this pin, three RGB channels
can be converted to ordinary 2pin
PWM output, Such as USED FOR
FAN.

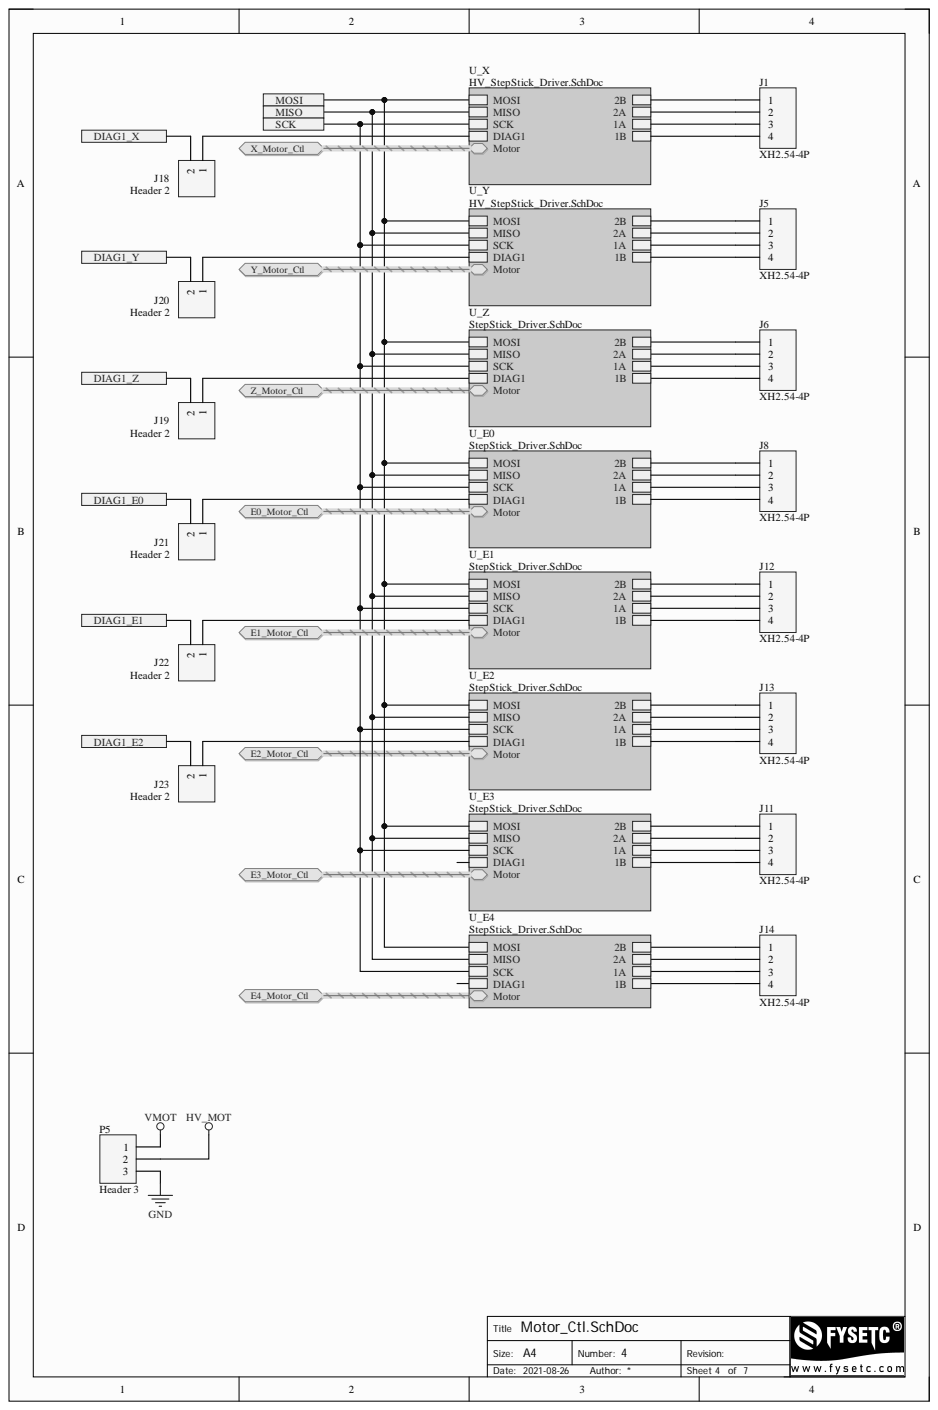
[picture p133: page 5]

M otor_Ctl .Sc hDo c T i t l e

S ize : A | N u m b er: | R e v i si o n :

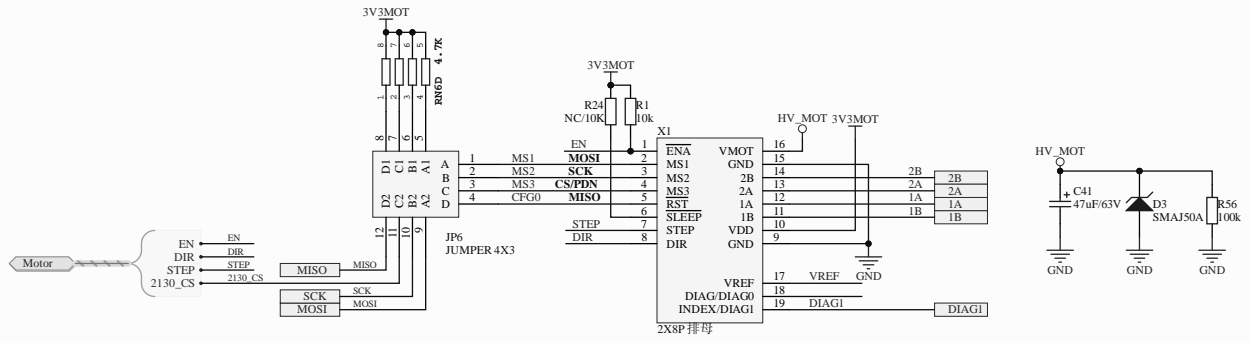
[picture p134: page 6]

2 MS2 SC K | 3 | 1 4
3 MS3 CS/ P D N | 4 | 1 3 | 2 A
4 CFG 0 ISO M | 5 | 1 2 | 1 A

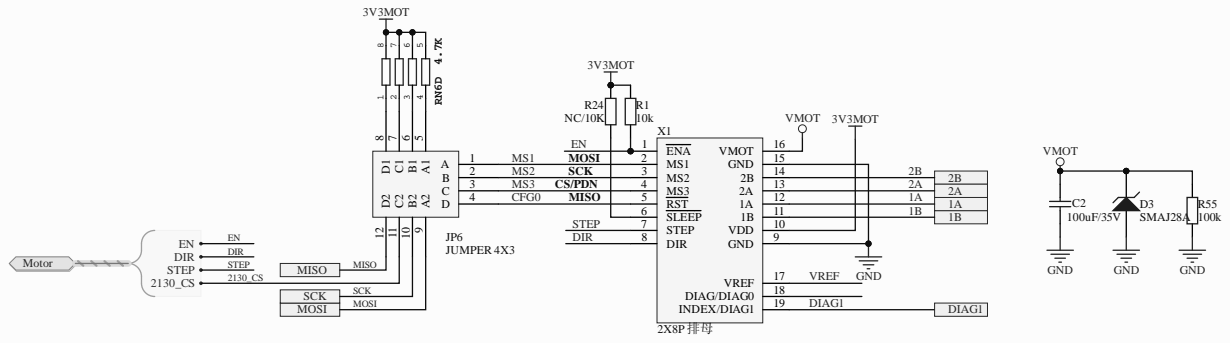
[picture p135: page 7]
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

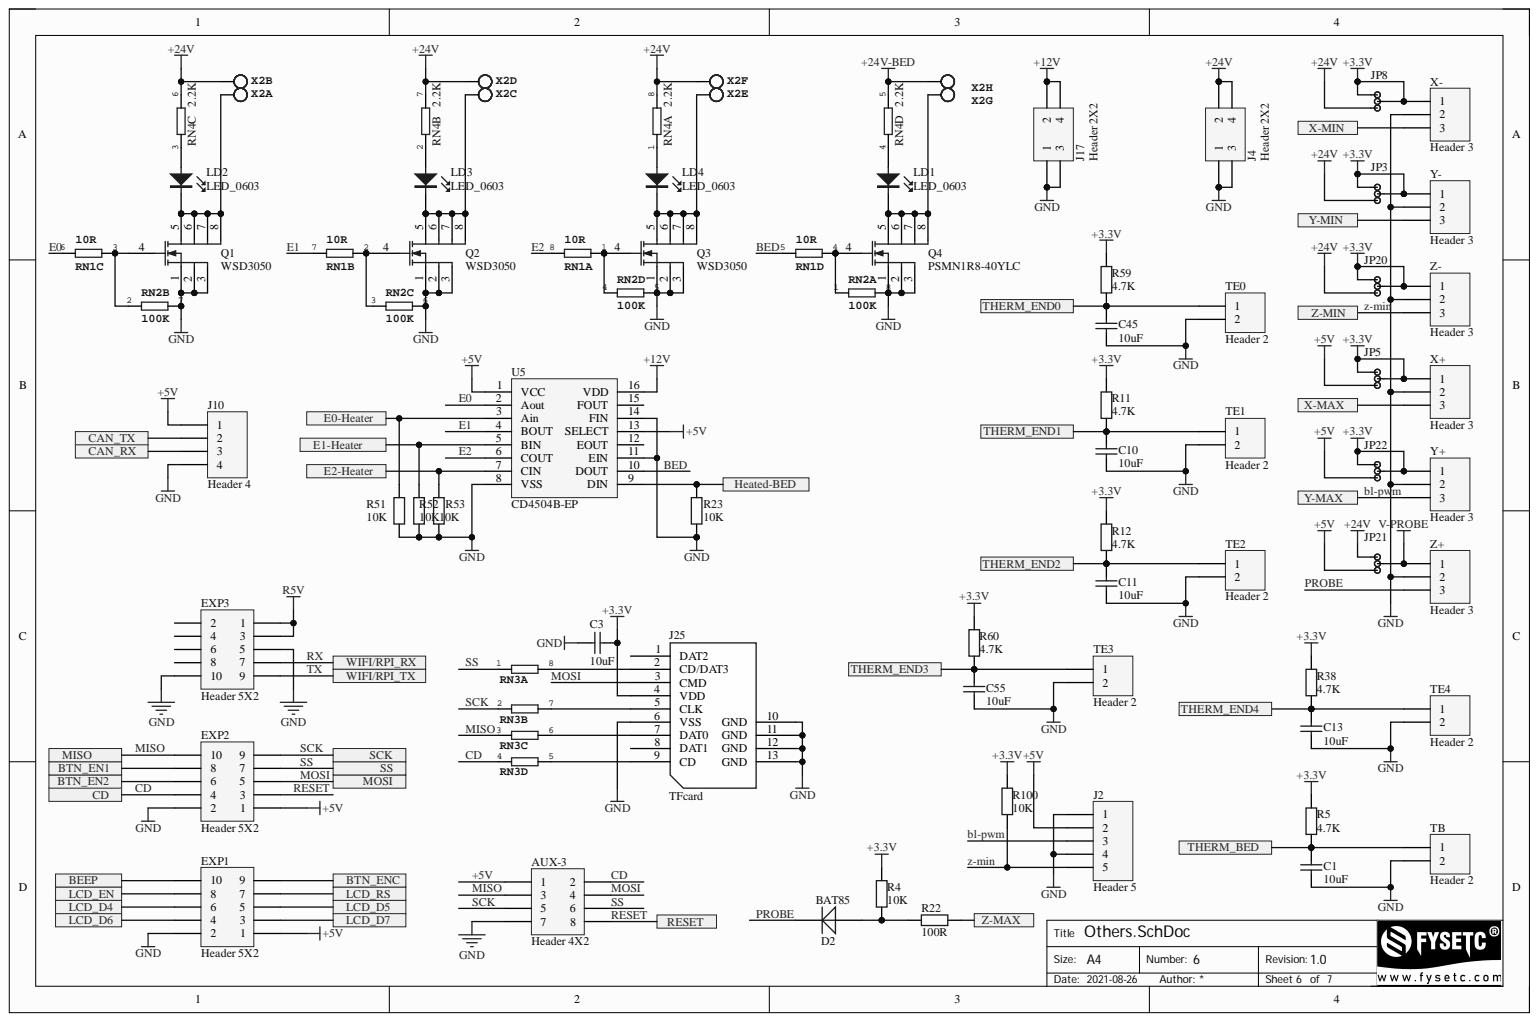
[picture p136: page 8]

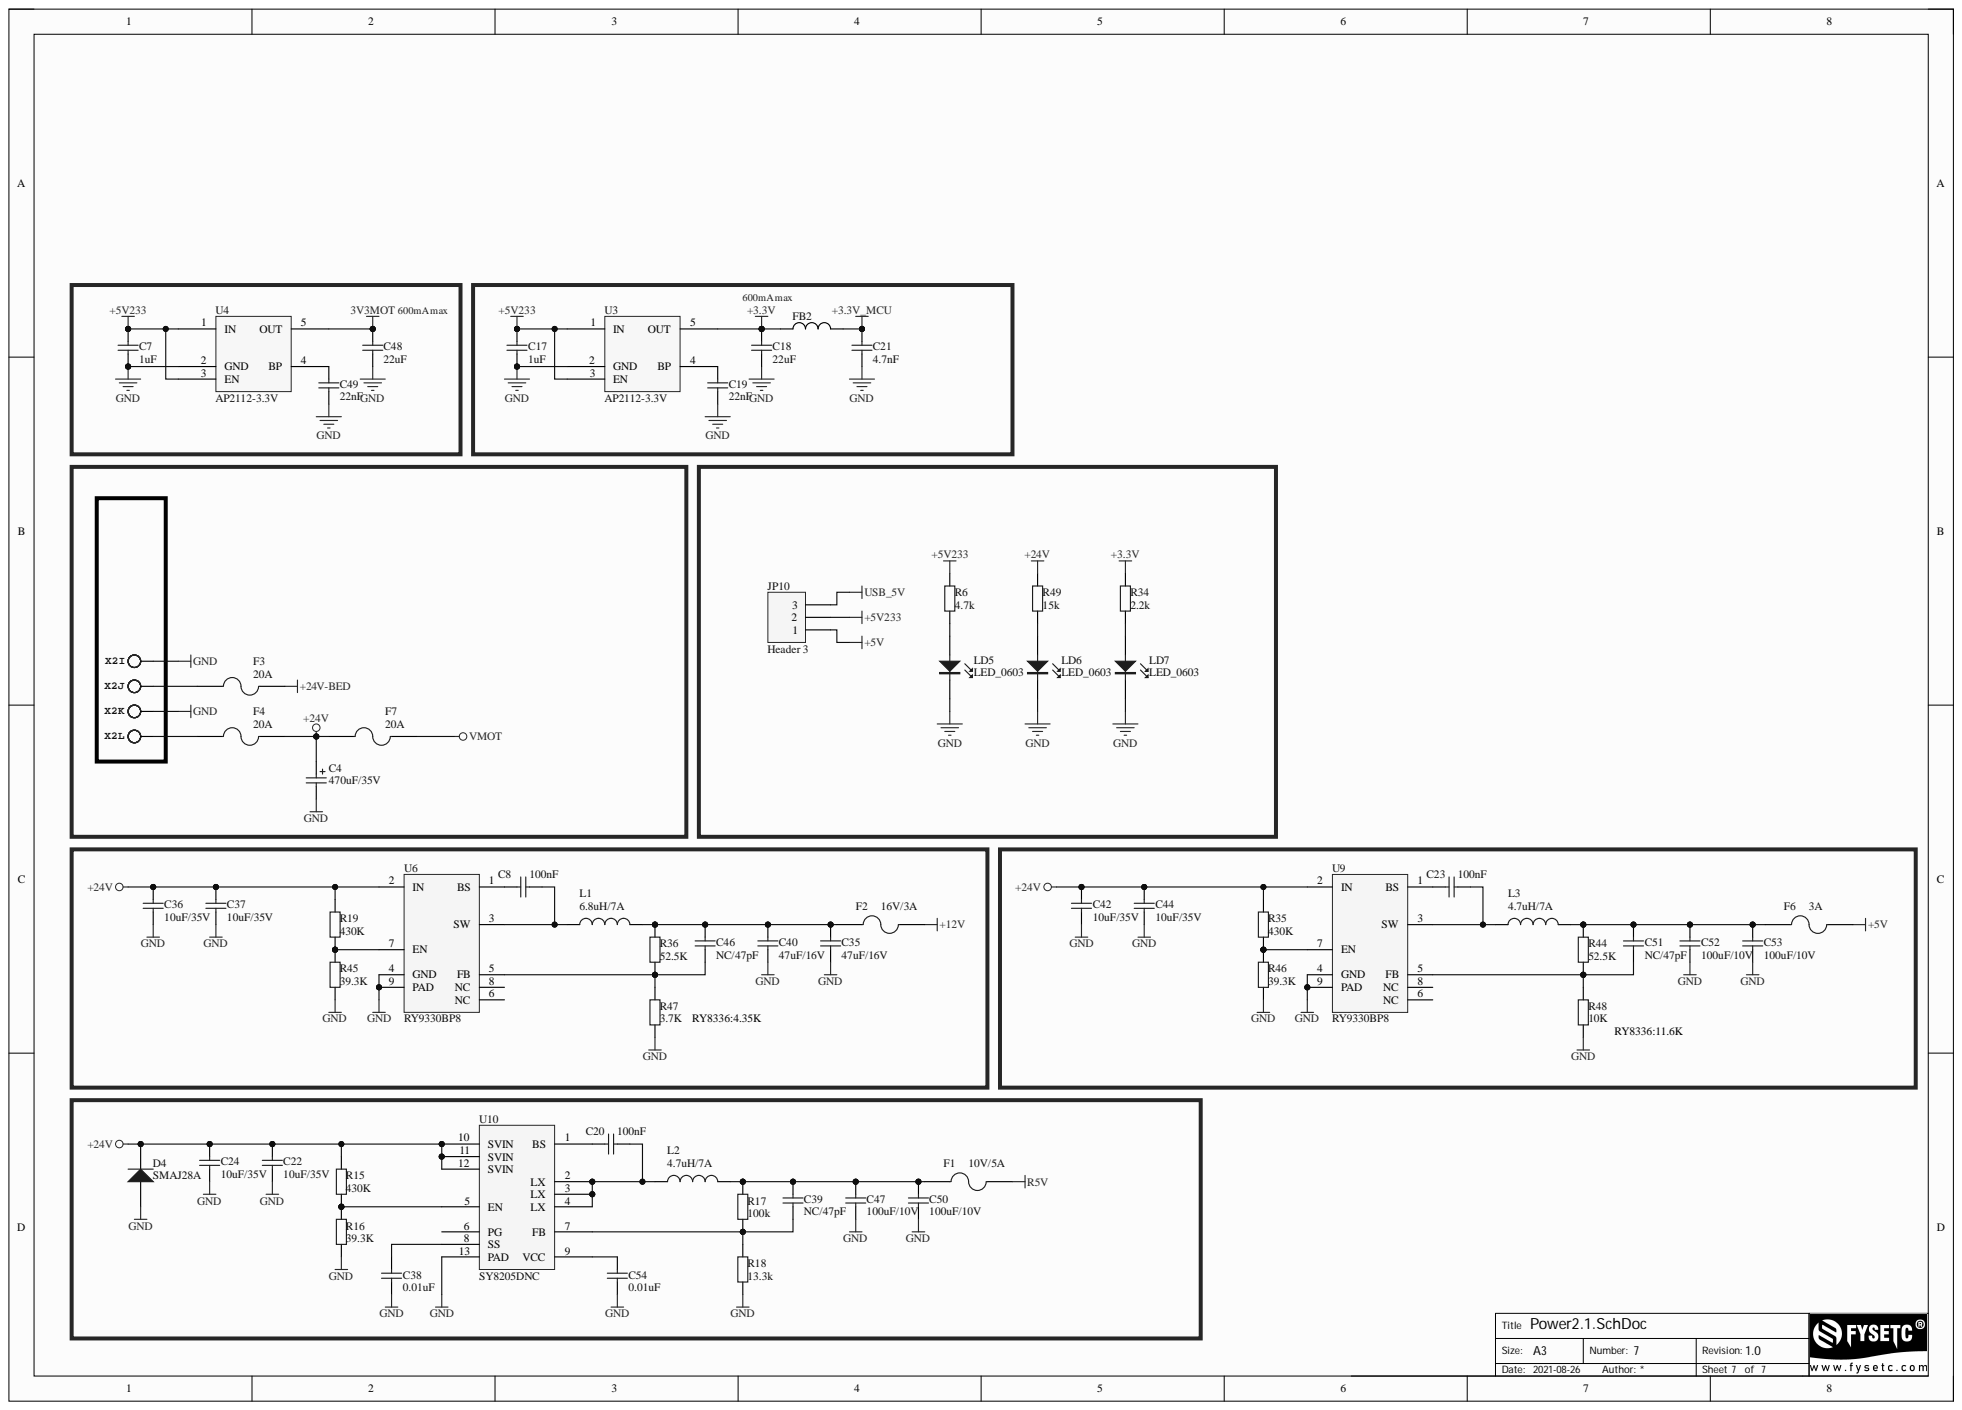
[picture p137: page 9]

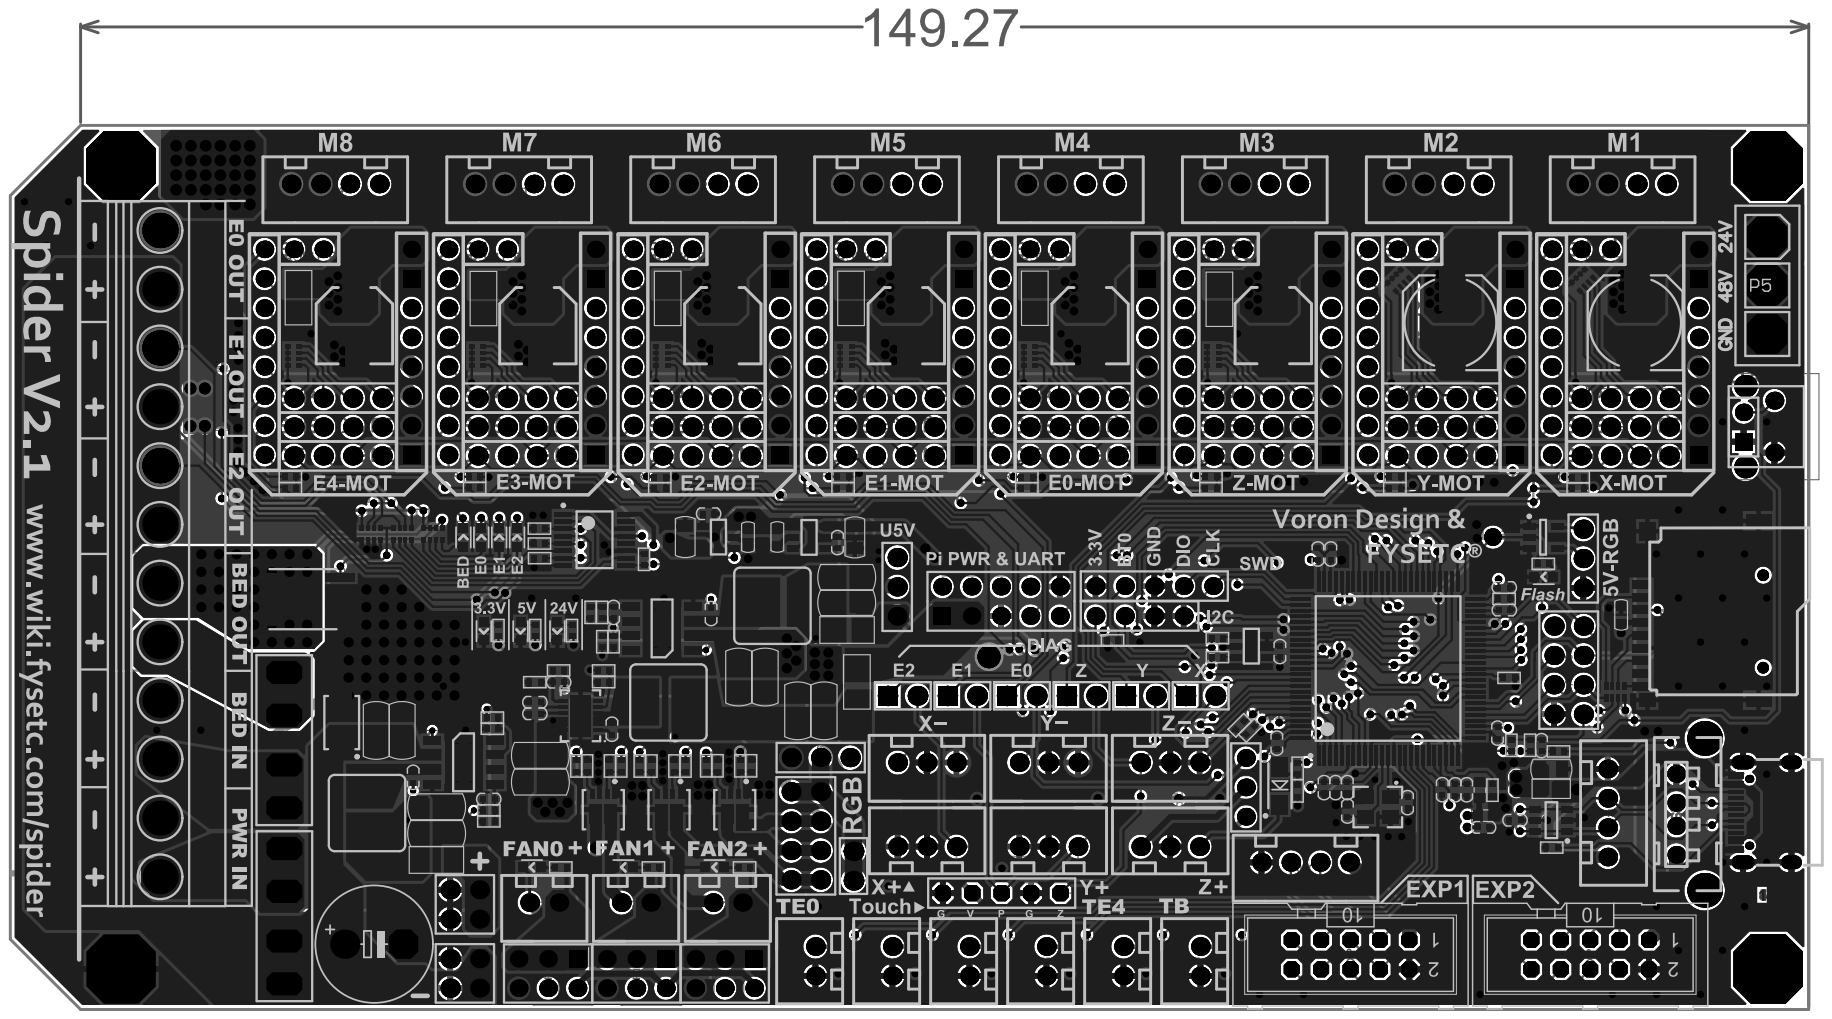
[picture p138: page 10]
