FYSETC/FYSETC-SPIDER/hardware/V2.2/Spider_V2.2_Pinout.pdf

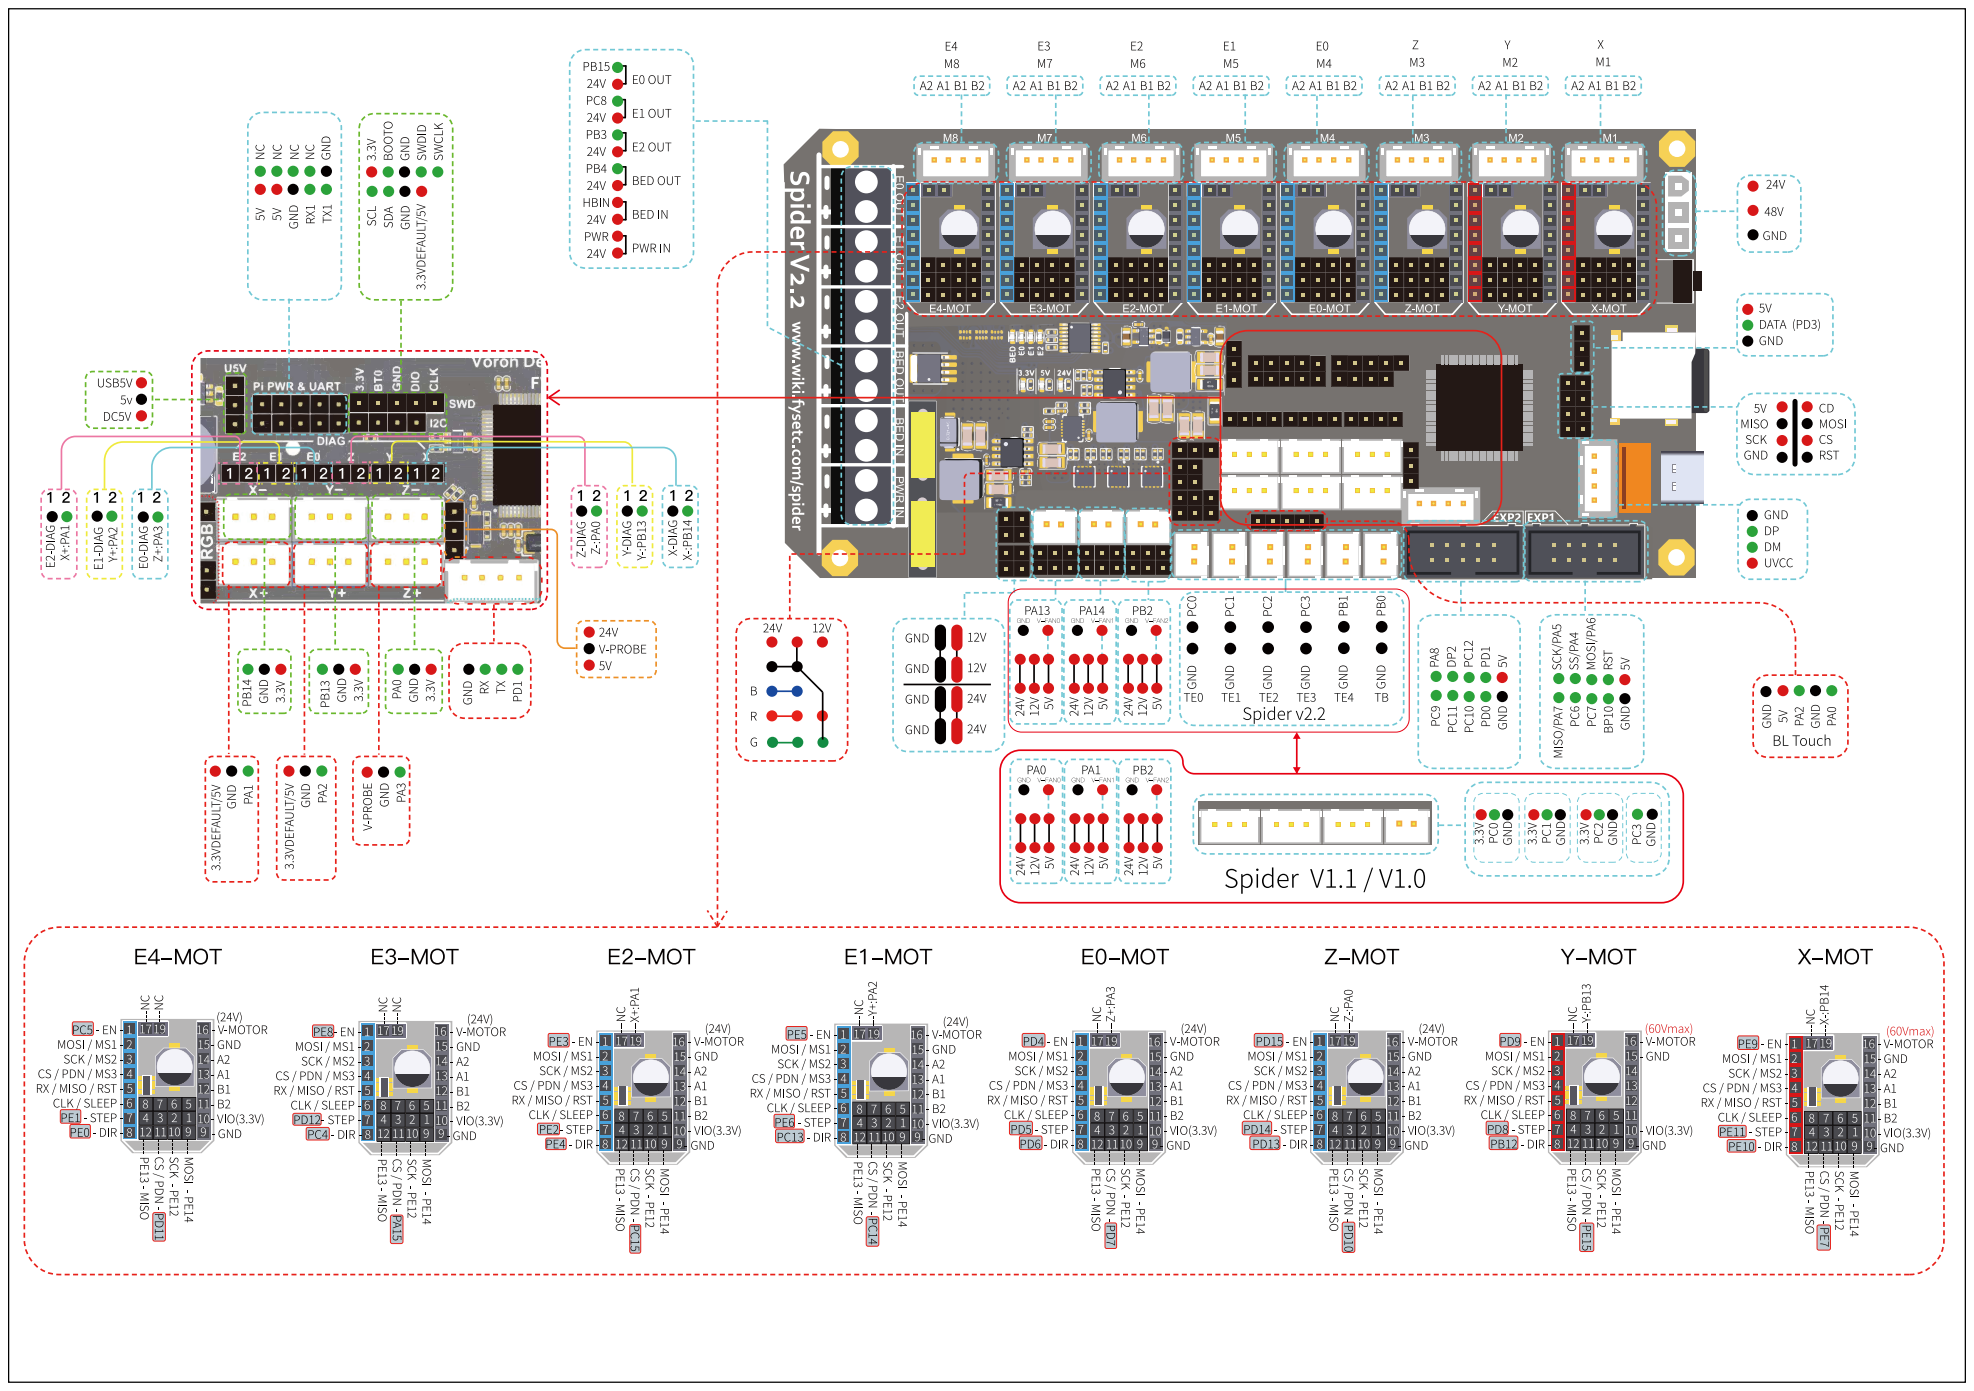
[picture p139: page 1]
