FYSETC/FYSETC-SPIDER/hardware/V2.2/Spider V2.2 Designator Diagram.pdf

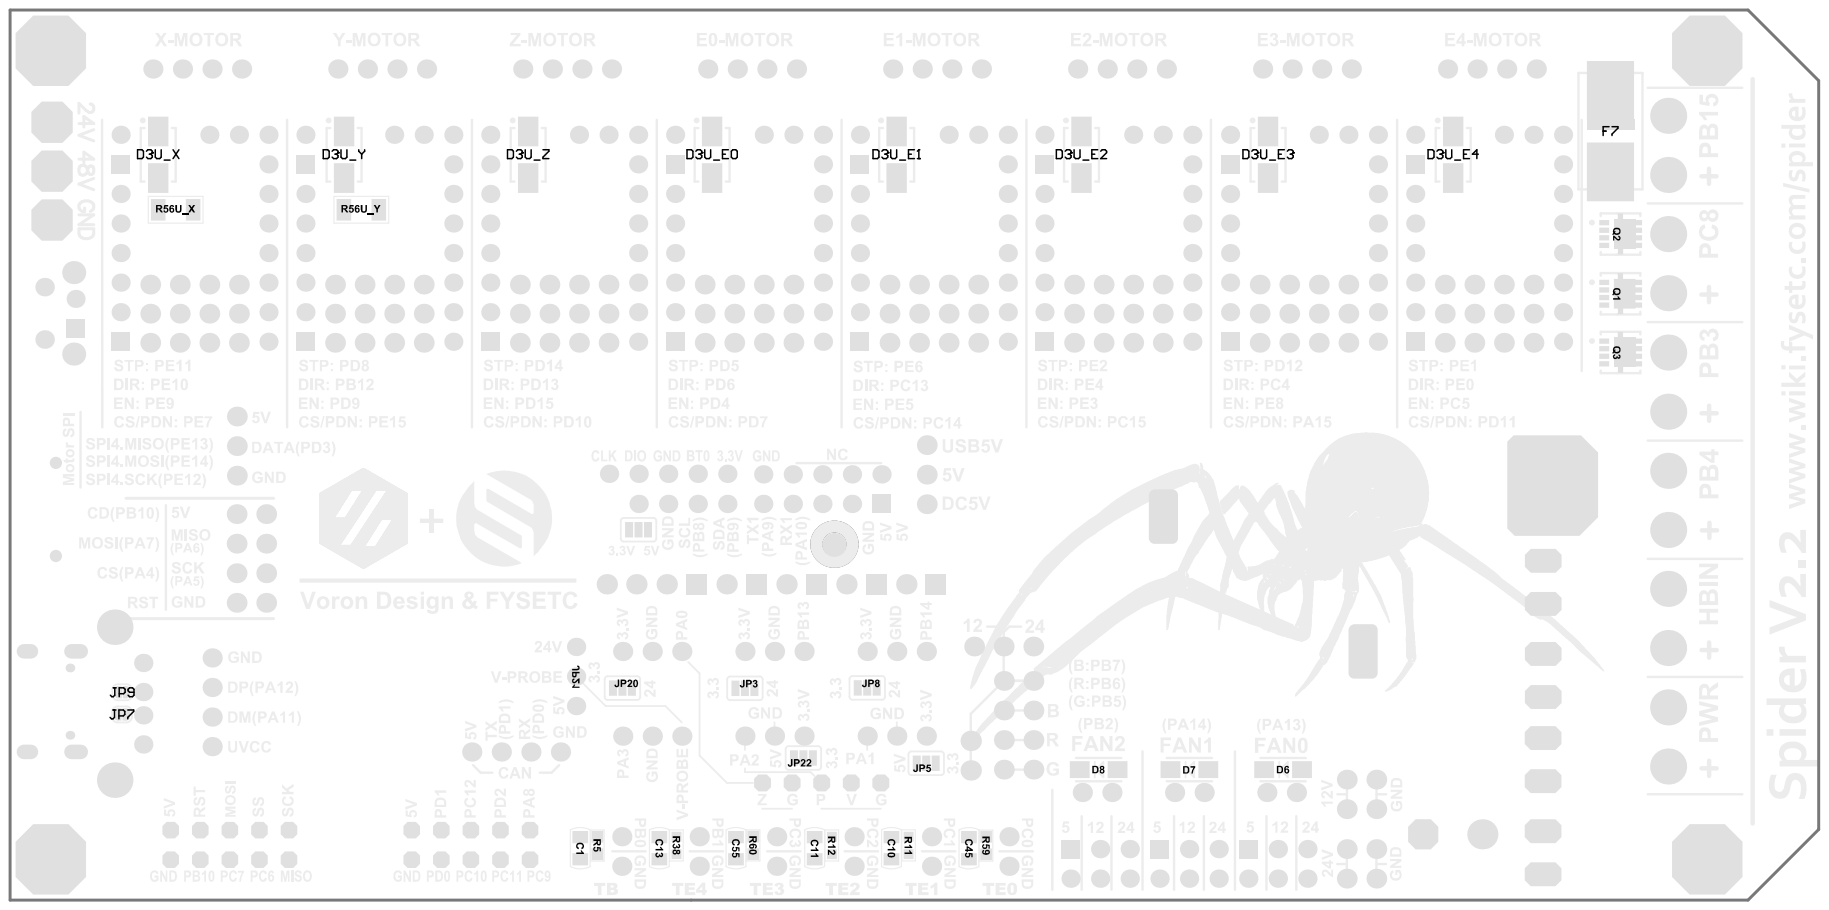
[picture p140: page 1]

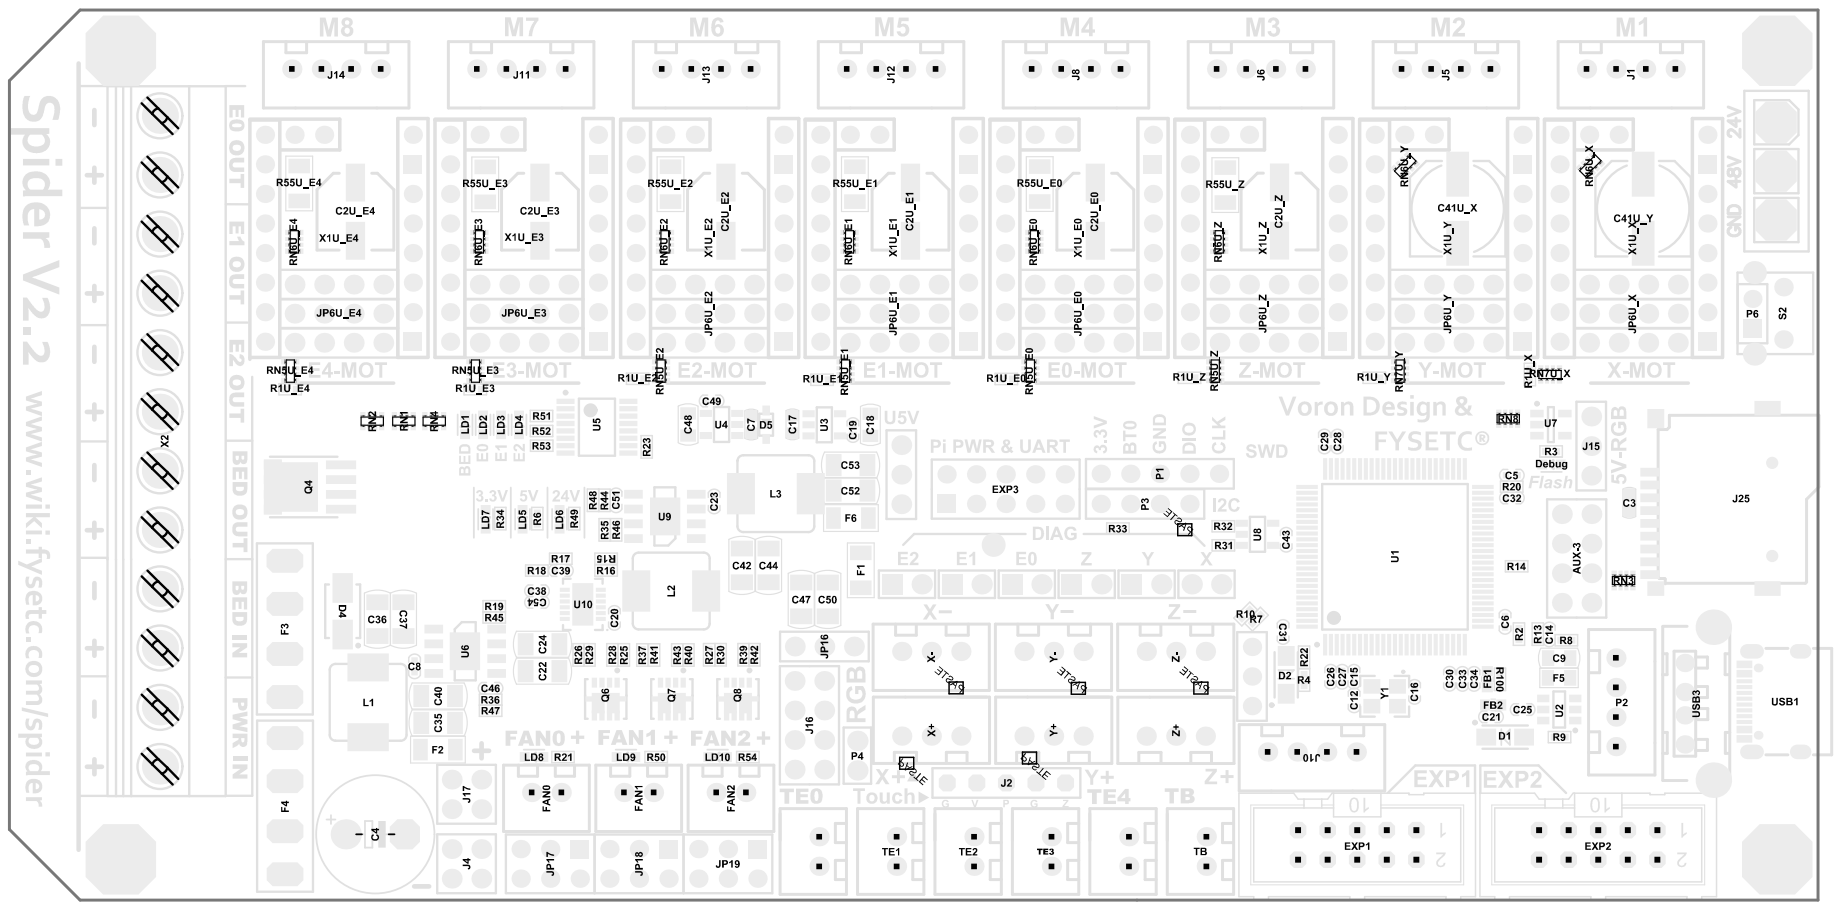
[picture p141: page 2]
