FYSETC/FYSETC-SPIDER/firmware/RRF/config/Spider_v2.2/sys/config.g

; Configuration file for MKS SGen L v1.0 (firmware version 3)
; executed by the firmware on start-up
;
; generated by RepRapFirmware Configuration Tool v3.2.1-LPC on Fri Mar 19 2021 21:39:18 GMT+0800 (中国标准时间)

; General preferences
G90                                                     ; send absolute coordinates...
M83                                                     ; ...but relative extruder moves
M550 P"SPIDER RRF"                                      ; set printer name

; Network
M552 S1                                                 ; enable network
M586 P0 S1                                              ; enable HTTP
M586 P1 S0                                              ; disable FTP
M586 P2 S0                                              ; disable Telnet

; Drives
M569 P0 S1                                              ; physical drive 0 goes forwards using default driver timings
M569 P1 S1                                              ; physical drive 1 goes forwards using default driver timings
M569 P2 S1                                              ; physical drive 2 goes forwards using default driver timings
M569 P3 S1                                              ; physical drive 3 goes forwards using default driver timings
M569 P4 S1                                              ; physical drive 4 goes forwards using default driver timings
M569 P5 S1                                              ; physical drive 5 goes forwards using default driver timings
M569 P6 S1                                              ; physical drive 6 goes forwards using default driver timings
M569 P7 S1                                              ; physical drive 7 goes forwards using default driver timings
M584 X0 Y1 Z4:5:6:7 E3                                  ; set drive mapping
M669 K5 X1:1:0:0 Y1:1:0:-1 Z0:0:1:0;
M350 X16 Y16 Z16 E16 I1                                 ; configure microstepping with interpolation
M92 X160.00 Y160.00 Z200.00:200.00:200.00:200.00 E420.00         ; set steps per mm
;M566 X900.00 Y900.00 Z60.00:60.00:60.00:60.00 E120.00      ; set maximum instantaneous speed changes (mm/min)
;M203 X6000.00 Y6000.00 Z180.00:180.00:180.00:180.00 E1200.00; set maximum speeds (mm/min)
;M201 X500.00 Y500.00 Z20.00:20.00:20.00:20.00 E250.00      ; set accelerations (mm/s^2)
M906 X800 Y800 Z800:800:800:800 E800 I30                   ; set motor currents (mA) and motor idle factor in per cent
M84 S30                                                 ; Set idle timeout

; Axis Limits
M208 X0 Y0 Z0 S1                                     ; set axis minima
M208 X200 Y200 Z180 S0                             ; set axis maxima

; Endstops
M574 X1 S1 P"^!xstop"                                     ; configure active-high endstop for low end on X via pin xstop
M574 Y1 S1 P"^!ystop"                                     ; configure active-high endstop for low end on Y via pin ystop
M574 Z1 S1 P"!zstop"                                     ; configure active-high endstop for low end on Z via pin zstop
;M574 Z1 S2                                     ; configure active-high endstop for low end on Z via pin zstop

;M574 X1 S1 P"^!zstopmax"                                     ; configure active-high endstop for low end on X via pin xstop
;M574 Y1 S1 P"^!servo0"                                     ; configure active-high endstop for low end on Y via pin ystop
;M574 Z1 S1 P"!probe"                                     ; configure active-high endstop for low end on Z via pin zstop


; Z-Probe
;M558 P2 C"zstop" H5 F120 T6000                       ; set Z probe type to modulated and the dive height + speeds
;G31 P500 X0 Y0 Z2.5                                     ; set Z probe trigger value, offset and trigger height
;M557 X15:200 Y15:195 S20                                ; define mesh grid

;M950 S0 C"servo0"                           ; create servo pin 0 for BLTouch
;M558 P9 C"!zstop" H5 F120 T6000             ; set Z probe type to bltouch and the dive height + speeds
;G31 P500 X0 Y0 Z2.5                          ; set Z probe trigger value, offset and trigger height
;M557 X15:200 Y15:195 S20                                ; define mesh grid

; Heaters
M308 S0 P"bedtemp" Y"thermistor" T100000 B4138          ; configure sensor 0 as thermistor on pin bedtemp
M950 H0 C"bed" T0                                       ; create bed heater output on bed and map it to sensor 0
M307 H0 B0 S1.00                                        ; disable bang-bang mode for the bed heater and set PWM limit
M140 H0                                                 ; map heated bed to heater 0
M143 H0 S120                                            ; set temperature limit for heater 0 to 120C

M308 S1 P"e0temp" Y"thermistor" T100000 B4138           ; configure sensor 1 as thermistor on pin e0temp
M950 H1 C"e0heat" T1                                    ; create nozzle heater output on e0heat and map it to sensor 1
M307 H1 B0 S1.00                                        ; disable bang-bang mode for heater  and set PWM limit
M143 H1 S280                                            ; set temperature limit for heater 1 to 280C

M308 S2 P"e1temp" Y"thermistor" T100000 B4138           ; configure sensor 1 as thermistor on pin e0temp
M950 H2 C"e1heat" T2                                    ; create nozzle heater output on e0heat and map it to sensor 1
M307 H2 B0 S1.00                                        ; disable bang-bang mode for heater  and set PWM limit
M143 H2 S280                                            ; set temperature limit for heater 1 to 280C

M308 S3 P"e2temp" Y"thermistor" T100000 B4138           ; configure sensor 1 as thermistor on pin e0temp
M950 H3 C"e2heat" T3                                    ; create nozzle heater output on e0heat and map it to sensor 1
M307 H3 B0 S1.00                                        ; disable bang-bang mode for heater  and set PWM limit
M143 H3 S280                                            ; set temperature limit for heater 1 to 280C

M308 S4 P"e3temp" Y"thermistor" T100000 B4138           ; configure sensor 1 as thermistor on pin e0temp
M950 H4 C"fan1" T4                                    ; create nozzle heater output on e0heat and map it to sensor 1
M307 H4 B0 S1.00                                        ; disable bang-bang mode for heater  and set PWM limit
M143 H4 S280                                            ; set temperature limit for heater 1 to 280C

M308 S5 P"chambertemp" Y"thermistor" T100000 B4138           ; configure sensor 1 as thermistor on pin e0temp
M950 H5 C"fan2" T5                                    ; create nozzle heater output on e0heat and map it to sensor 1
M307 H5 B0 S1.00                                        ; disable bang-bang mode for heater  and set PWM limit
M143 H5 S280                                            ; set temperature limit for heater 1 to 280C

; Fans
M950 F0 C"fan0" Q500                                    ; create fan 0 on pin fan0 and set its frequency
M106 P0 S0 H-1                                          ; set fan 0 value. Thermostatic control is turned off
;M950 F1 C"fan1" Q500                                    ; create fan 0 on pin fan0 and set its frequency
;M106 P1 S0 H-1                                          ; set fan 0 value. Thermostatic control is turned off
;M950 F2 C"fan2" Q500                                    ; create fan 0 on pin fan0 and set its frequency
;M106 P2 S0 H-1                                          ; set fan 0 value. Thermostatic control is turned off


; Tools
M563 P0 D0 H1 F0                                        ; define tool 0
G10 P0 X185 Y0 Z0                                      ; set tool 0 axis offsets
G10 P0 R0 S0                                            ; set initial tool 0 active and standby temperatures to 0C
M564 S0 H0 ; Custom settings are not defined

;M563 P2 D0:1 H1:2 X0:3 F1:1 ; tool 2 uses both extruders and hot end heaters, maps X to both X and U, and uses both print cooling fans
;G10 P2 X50 Y0 U-50 S0 R0    ; set tool offsets and temperatures for tool 2

;M567 P2 E1:1 ; set mix ratio 100% on both extruders
;M568 P2 S1 ; turn on mixing for tool 2

M575 P1 S1 B57600;
M501;
