FYSETC/FYSETC-SPIDER/firmware/RRF/RRFBuild/CoreN2G/src/Core.h

/**
 * @file Core.h
 * @brief Header file declaring types, functions etc. usable from both C and C++
 *
 * This file contains basic CPU and I/O pin support for the SAME5x (also works with SAMD5x) and SAMC21
 * Use it where we can't include the full CoreIO.h file, for example in C source files
 */

/*  Created on: 19 Jun 2020
 *      Author: David
 */

#ifndef SRC_CORE_H_
#define SRC_CORE_H_

// Basic CPU and I/O pin support

#include "ecv.h"
#undef array
#undef assert
#undef result
#undef value

#if defined(__SAME54P20A__) || defined(__SAME51P20A__)
# define __ARM_ARCH_7EM__	1
# include <same54.h>
# define SAMC21				0
# define SAM3XA				0
# define SAM4E				0
# define SAM4S				0
# define SAME5x				1
# define SAME70				0
#elif defined(__SAME51N19A__)
# define __ARM_ARCH_7EM__	1
# include <same51.h>
# define SAMC21				0
# define SAM3XA				0
# define SAM4E				0
# define SAM4S				0
# define SAME5x				1
# define SAME70				0
#elif defined(__SAMC21G18A__)
# define __ARM_ARCH_6M__	1
# include <samc21.h>
# define SAMC21				1
# define SAM3XA				0
# define SAM4E				0
# define SAM4S				0
# define SAME5x				0
# define SAME70				0
# define SUPPORT_SDHC		0			// SAMC21 doesn't support SDHC
#elif defined(__SAM4E8E__)
# include <parts.h>
# include <sam4e8e.h>
# define SAME5x				0
# define SUPPORT_CAN		0			// SAM4E doesn't support CAN-FD
#elif defined(__SAM4S8C__)
# include <parts.h>
# include <sam4s8c.h>
# define SAME5x				0
# define SUPPORT_CAN		0			// SAM4E doesn't support CAN-FD
#elif defined(__SAME70Q20B__)
# include <parts.h>
# include <same70q20b.h>
# define SAME5x				0
#elif defined(__STM32F4__)
# include <stm32f4.h>
# include <dwt.h>
# define STM32F4			1
# define LPC17xx			0
# define SAMC21				0
# define SAM3XA				0
# define SAM4E				0
# define SAM4S				0
# define SAME5x				0
# define SAME70				0
#elif defined(__LPC17xx__)
# include <lpc17xx.h>
# define LPC17xx			1
# define STM32F4			0
# define SAMC21				0
# define SAM3XA				0
# define SAM4E				0
# define SAM4S				0
# define SAME5x				0
# define SAME70				0
#else
# error unsupported processor
#endif

#include <inttypes.h>				// for PRIu32 etc.
#include <ctype.h>

// Types

typedef uint8_t DmaChannel;			///< A type that represents a DMA channel number
typedef uint8_t DmaPriority;		///< A type that represents a DMA priority
#if STM32F4
typedef PinName Pin;
#elif LPC17xx
typedef gpioPins_et Pin;
#else
typedef uint8_t Pin;				///< A type that represents an I/O pin on the microcontroller
#endif
typedef uint16_t PwmFrequency;		///< A type that represents a PWM frequency. 0 sometimes means "default".
typedef uint32_t NvicPriority;		///< A type that represents an interrupt priority
typedef uint8_t ExintNumber;		///< A type that represents an EXINT number
typedef uint8_t EventNumber;		///< A type that represents an event number

#if STM32F4
static const Pin NoPin = NC;		///< A number that represents no I/O pin
#elif LPC17xx
static const Pin NoPin = P_NC; 		//which =0xff
#else
static const Pin NoPin = 0xFF;		///< A number that represents no I/O pin
static const Pin Nx = 0xFF;			///< A number that represents no I/O EXINT number
#endif

// Standard GCLK numbers and frequencies
#if SAME5x

static const uint32_t SystemCoreClockFreq = 120000000;	///< The processor clock frequency after initialisation

static const unsigned int GclkNum120MHz = 0;
static const unsigned int GclkNum31KHz = 1;				// frequency is 31250Hz
static const unsigned int GclkNum60MHz = 3;
static const unsigned int GclkNum48MHz = 4;
// Other GCLKs may be defined by the client application

#elif SAMC21

static const uint32_t SystemCoreClockFreq = 48000000;	///< The processor clock frequency after initialisation

static const unsigned int GclkNum48MHz = 0;
static const unsigned int GclkNum31KHz = 1;				// frequency is 31250Hz
// Other GCLKs may be defined by the client application

#elif SAM4E

static const uint32_t SystemCoreClockFreq = 120000000;	///< The processor clock frequency after initialisation

#elif SAM4S

static const uint32_t SystemCoreClockFreq = 120000000;	///< The processor clock frequency after initialisation

#elif SAME70

static const uint32_t SystemCoreClockFreq = 300000000;	///< The processor clock frequency after initialisation

#elif STM32F4 || LPC17xx

#define SystemCoreClockFreq SystemCoreClock
#endif

/// Pin mode enumeration
enum PinMode
{
	PIN_MODE_NOT_CONFIGURED = -1,	///< pin has not been configured
	INPUT = 0,						///< pin is a digital input
	INPUT_PULLUP,					///< pin is a digital input with pullup enabled
	INPUT_PULLDOWN,					///< pin is a digital input with pulldown enabled
	OUTPUT_LOW,						///< pin is an output with initial state LOW
	OUTPUT_HIGH,					///< pin is an output with initial state HIGH
	AIN,							///< pin is an analog input, digital input buffer is disabled if possible
	OUTPUT_PWM_LOW,					///< PWM output mode, initially low
	OUTPUT_PWM_HIGH,				///< PWM output mode, initially high
#if SAM4E
	OUTPUT_LOW_OPEN_DRAIN,			///< pin is used in SX1509B expansion driver to put the pin in open drain output mode
	OUTPUT_HIGH_OPEN_DRAIN,			///< pin is  used in SX1509B expansion driver to put the pin in open drain output mode
	OUTPUT_PWM_OPEN_DRAIN,			///< pin is  used in SX1509B expansion driver to put the pin in PWM output mode
#endif
#if LPC17xx
     OUTPUT_SERVO_LOW,
     OUTPUT_SERVO_HIGH
#endif
};

#ifndef __cplusplus
# include <stdbool.h>
#endif

#if SAMC21 || SAME5x
# define UNUSED(_x)	(void)_x		/// Macro to indicate that a function parameter is unused
#endif

/// Assert macro, normally defined to do nothing
#define Assert(expr) ((void) 0)

#ifndef ARRAY_SIZE
/// Macro to give us the number of elements in an array
# define ARRAY_SIZE(_x)	(sizeof(_x)/sizeof((_x)[0]))
#endif

#ifdef __cplusplus
extern "C" {
#endif

/**
 * @brief Get the time since startup
 * @return Number of milliseconds since startup modulo 2^32
 */
uint32_t millis() noexcept;

/**
 * @brief Get the time since startup
 * @return Number of milliseconds since startup modulo 2^64
 */
uint64_t millis64() noexcept;

/**
 * @brief Delay for a number of 1ms clock ticks.
 * @param millis Number of 1ms system ticks to delay for. The actual delay may be up to 1 millisecond less than this, or arbitrarily greater.
 */
void delay(uint32_t ms) noexcept;

/**
 * @brief Set the required mode fore an I/O pin for
 * @param pin The pin number to set the mode for. If the pin number is not valid (e.g. NoPin), the call will be ignored.
 * @param mode The mode to set the pin to.
 */
void pinMode(Pin pin, enum PinMode mode) noexcept;

/**
 * @brief Read from an I/O pin
 * @param pin The pin to read from
 * @return true if the pin was valid and its state is high, false if it was not valid (e.g. NoPin) or it is valid and its state is low
 */
bool digitalRead(Pin pin) noexcept;

/**
 * @brief Write to an I/O pin
 * @param pin The pin to write to. If the pin number is not valid (e.g. NoPin), the call will be ignored.
 * @param high True to set the pin high, false to set it low
 */
void digitalWrite(Pin pin, bool high) noexcept;

/**
 * @brief Return a random or pseudo-random unsigned 32-bit integer
 * @return The random number
 */
uint32_t random32(void) noexcept;		// needed by lwip

#if STM32F4
// Delay in cycles
static inline uint32_t DelayCycles(const uint32_t start, const uint32_t cycles) noexcept __attribute__((always_inline, unused));
#ifdef __cplusplus
[[gnu::always_inline, gnu::optimize("03")]]
#endif
static inline uint32_t DelayCycles(const uint32_t start, const uint32_t cycles) noexcept
{
	while ((DWT->CYCCNT) - start < cycles) ; 
	return (DWT->CYCCNT); 
}

static inline uint32_t GetCurrentCycles() noexcept
{
	return (DWT->CYCCNT);
}
static inline uint32_t GetElapsedCyclesBetween(uint32_t startCycles, uint32_t endCycles) noexcept
{
	return endCycles - startCycles;
}

static inline uint32_t NanosecondsToCycles(uint32_t ns) noexcept
{
  return (ns * (uint64_t)SystemCoreClock)/1000000000u;
}

#elif LPC17xx
/**
 * Delay for a number of cpu cycles
 */

#ifdef __cplusplus
[[gnu::always_inline, gnu::optimize("03")]]
#endif
static inline void __delay_4cycles(uint32_t cy) noexcept { // +1 cycle
__asm__ __volatile__(
    "  .syntax unified\n\t" // is to prevent CM0,CM1 non-unified syntax
    "1:\n\t"
    "  subs %[cnt],#1\n\t" // 1
    "  mov r0, r0\n\t"            // 1
    "  bne 1b\n\t"         // 1 + (1? reload)
    : [cnt]"+r"(cy)   // output: +r means input+output
    :                 // input:
    : "cc"            // clobbers:
);
}

// Delay in cycles
#ifdef __cplusplus
[[gnu::always_inline, gnu::optimize("03")]]
#endif

static inline uint32_t DelayCycles(const uint32_t start, const uint32_t cycles) noexcept 
{
    if (cycles >> 2) __delay_4cycles(cycles >> 2);
    return 0;
}

/**
 * @brief Get the current cycle counter, for subsequent use as the start time in a call to DelayCycles
 *
 * @return The cycle counter
 */
static inline uint32_t GetCurrentCycles() noexcept
{
	return SysTick->VAL & 0x00FFFFFF;
}

/**
 * @brief Get the elapsed time in clock cycles between a start time and an end time, assuming it is below 1ms
 * @param startTime The start time, obtained by a call to GetCurrentCycles
 * @param endTime The end time, obtained by a call to GetCurrentCycles
 *
 * @return The elapsed time
 */
static inline uint32_t GetElapsedCyclesBetween(uint32_t startCycles, uint32_t endCycles) noexcept
{
	return ((endCycles < startCycles) ? startCycles : startCycles + (SysTick->LOAD & 0x00FFFFFF) + 1) - endCycles;
}

static inline uint32_t NanosecondsToCycles(uint32_t ns) noexcept
{
  return (ns * (uint64_t)SystemCoreClock)/1000000000u;
}

#else
/**
 * @brief Delay for a specified number of CPU clock cycles from the starting time
 *
 * @param start The time we want to start waiting from, which must be in the recent past
 * @param cycles The number of processor clock cycles to delay from the start time
 * @return The time at which we actually stopped waiting.
 */
uint32_t DelayCycles(uint32_t start, uint32_t cycles) noexcept;

/**
 * @brief Get the current cycle counter, for subsequent use as the start time in a call to DelayCycles
 *
 * @return The cycle counter
 */
static inline uint32_t GetCurrentCycles() noexcept
{
	return SysTick->VAL & 0x00FFFFFF;
}

/**
 * @brief Get the elapsed time in clock cycles between a start time and an end time, assuming it is below 1ms
 * @param startTime The start time, obtained by a call to GetCurrentCycles
 * @param endTime The end time, obtained by a call to GetCurrentCycles
 *
 * @return The elapsed time
 */
static inline uint32_t GetElapsedCyclesBetween(uint32_t startCycles, uint32_t endCycles) noexcept
{
	return ((endCycles < startCycles) ? startCycles : startCycles + (SysTick->LOAD & 0x00FFFFFF) + 1) - endCycles;
}
#endif

/**
 * @brief Get the elapsed time in clock cycles since a start time, assuming it is below 1ms
 * @param startTime The start time, obtained by a call to GetCurrentCycles
 *
 * @return The elapsed time
 */
static inline uint32_t GetElapsedCycles(uint32_t startCycles) noexcept
{
	return GetElapsedCyclesBetween(startCycles, GetCurrentCycles());
}

/**
 * @brief Delay or at least the specified number of microseconds
 *
 * @param How many microseconds to delay for
 */
static inline void delayMicroseconds(uint32_t) noexcept __attribute__((always_inline, unused));
static inline void delayMicroseconds(uint32_t usec) noexcept
{
	(void)DelayCycles(GetCurrentCycles(), usec * (SystemCoreClockFreq/1000000));
}

// Functions to enable/disable interrupts

/**
 * @brief Enable interrupts unconditionally
 *
 */
static __always_inline void IrqEnable() noexcept
{
	__enable_irq();
}

/**
 * @brief Disable interrupts unconditionally
 *
 */
static __always_inline void IrqDisable() noexcept
{
	__disable_irq();
}

typedef uint32_t irqflags_t;	///< Type used to indicate whether interrupts were enabled/should be enabled. It stores the original value of PRIMASK.

/**
 * @brief Test whether interrupts are enabled
 *
 * @return True iff interrupts are enabled
 */
static __always_inline bool IsIrqEnabled() noexcept
{
	return __get_PRIMASK() == 0;
}

/**
 * @brief Disable interrupts and return the initial enabled state. C++ clients should use class AtomicCriticalSectionLocker instead.
 *
 * @return The initial interrupts enabled state
 */
static __always_inline irqflags_t IrqSave() noexcept
{
	const irqflags_t flags = __get_PRIMASK();
	__disable_irq();
	return flags;
}

/**
 * @brief convert irqflags_t to Boolean
 *
 * @param flags Value to convert
 * @return Converted value
 */
static __always_inline bool IsIrqEnabledFlags(irqflags_t flags) noexcept
{
	return (flags & 0x01) == 0;
}

/**
 * @brief Re-enable interrupts if they were enabled originally
 *
 * @param flags The original interrupts enabled state returned by a call to IrqSave
 */
static __always_inline void IrqRestore(irqflags_t flags) noexcept
{
	__set_PRIMASK(flags);
}

/**
 * @brief Return true if a character is one of the digits 0 thru 9
 *
 * @param c the character to test
 * @return True iff the character is a digit
 */
static inline bool isDigit(char c) noexcept
{
	return isdigit(c) != 0;
}

/**
 * @brief Test whether we are in an interrupt service routine or exception handler
 *
 * @return true if we are in an interrupt service routine or exception handler
 */
static inline bool inInterrupt() noexcept
{
	return (__get_IPSR() & 0x01FF) != 0;
}

#if 0//defined(STM32F4) && !defined(STM32F446xx)
#define TASKMEM __attribute__((section(".ccmram")))
#else
#define TASKMEM
#endif

#ifdef __cplusplus
}		// end extern "C"
#endif

#endif /* SRC_CORE_H_ */
