FYSETC/FYSETC-SPIDER/firmware/RRF/RRFBuild/CoreN2G/src/STM32F4/variants/STM32F446/PeripheralPins.c

/*
 *******************************************************************************
 * Copyright (c) 2016, STMicroelectronics
 * All rights reserved.
 *
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
 * THIS SOFTWARE IS PROVIDED BY THE COPYRIGHT HOLDERS AND CONTRIBUTORS "AS IS"
 * AND ANY EXPRESS OR IMPLIED WARRANTIES, INCLUDING, BUT NOT LIMITED TO, THE
 * IMPLIED WARRANTIES OF MERCHANTABILITY AND FITNESS FOR A PARTICULAR PURPOSE ARE
 * DISCLAIMED. IN NO EVENT SHALL THE COPYRIGHT HOLDER OR CONTRIBUTORS BE LIABLE
 * FOR ANY DIRECT, INDIRECT, INCIDENTAL, SPECIAL, EXEMPLARY, OR CONSEQUENTIAL
 * DAMAGES (INCLUDING, BUT NOT LIMITED TO, PROCUREMENT OF SUBSTITUTE GOODS OR
 * SERVICES; LOSS OF USE, DATA, OR PROFITS; OR BUSINESS INTERRUPTION) HOWEVER
 * CAUSED AND ON ANY THEORY OF LIABILITY, WHETHER IN CONTRACT, STRICT LIABILITY,
 * OR TORT (INCLUDING NEGLIGENCE OR OTHERWISE) ARISING IN ANY WAY OUT OF THE USE
 * OF THIS SOFTWARE, EVEN IF ADVISED OF THE POSSIBILITY OF SUCH DAMAGE.
 *******************************************************************************
 */
#include <PeripheralPins.h>

// =====
// Note: Commented lines are alternative possibilities which are not used per default.
//       If you change them, you will have to know what you do
// =====


//*** ADC ***

#ifdef HAL_ADC_MODULE_ENABLED
const PinMap PinMap_ADC[] = {
  {PA_0,  ADC1,  STM_PIN_DATA_EXT(STM_MODE_ANALOG, GPIO_NOPULL, 0, 0, 0)}, // ADC1_IN0      E0_DIR
  {PA_1,  ADC1,  STM_PIN_DATA_EXT(STM_MODE_ANALOG, GPIO_NOPULL, 0, 1, 0)}, // ADC1_IN1      BLTOUCH_2
  {PA_2,  ADC1,  STM_PIN_DATA_EXT(STM_MODE_ANALOG, GPIO_NOPULL, 0, 2, 0)}, // ADC1_IN2      BLTOUCH_4
  {PA_3,  ADC1,  STM_PIN_DATA_EXT(STM_MODE_ANALOG, GPIO_NOPULL, 0, 3, 0)}, // ADC1_IN3      E1_EN
  {PA_4,  ADC1,  STM_PIN_DATA_EXT(STM_MODE_ANALOG, GPIO_NOPULL, 0, 4, 0)}, // ADC1_IN4      TF_SS
  {PA_5,  ADC1,  STM_PIN_DATA_EXT(STM_MODE_ANALOG, GPIO_NOPULL, 0, 5, 0)}, // ADC1_IN5      TF_SCLK
  {PA_6,  ADC1,  STM_PIN_DATA_EXT(STM_MODE_ANALOG, GPIO_NOPULL, 0, 6, 0)}, // ADC1_IN6      TF_MISO
  {PA_7,  ADC1,  STM_PIN_DATA_EXT(STM_MODE_ANALOG, GPIO_NOPULL, 0, 7, 0)}, // ADC1_IN7      LED
  {PB_0,  ADC1,  STM_PIN_DATA_EXT(STM_MODE_ANALOG, GPIO_NOPULL, 0, 8, 0)}, // ADC1_IN8      HEATER2
  {PB_1,  ADC1,  STM_PIN_DATA_EXT(STM_MODE_ANALOG, GPIO_NOPULL, 0, 9, 0)}, // ADC1_IN9      HEATER0
  {PC_0,  ADC1,  STM_PIN_DATA_EXT(STM_MODE_ANALOG, GPIO_NOPULL, 0, 10, 0)}, // ADC1_IN10    Z_EN      BED_T
  {PC_1,  ADC1,  STM_PIN_DATA_EXT(STM_MODE_ANALOG, GPIO_NOPULL, 0, 11, 0)}, // ADC1_IN11    EXP_14    T0
  {PC_2,  ADC1,  STM_PIN_DATA_EXT(STM_MODE_ANALOG, GPIO_NOPULL, 0, 12, 0)}, // ADC1_IN12    Z_DIR     T1  
  {PC_3,  ADC1,  STM_PIN_DATA_EXT(STM_MODE_ANALOG, GPIO_NOPULL, 0, 13, 0)}, // ADC1_IN13    E0_EN     T2
  {PC_4,  ADC1,  STM_PIN_DATA_EXT(STM_MODE_ANALOG, GPIO_NOPULL, 0, 14, 0)}, // ADC1_IN14    EXP_8
  {PC_5,  ADC1,  STM_PIN_DATA_EXT(STM_MODE_ANALOG, GPIO_NOPULL, 0, 15, 0)}, // ADC1_IN15    EXP_7
  {NC,    NP,    0}
};
#endif

//*** DAC ***

#ifdef HAL_DAC_MODULE_ENABLED
const PinMap PinMap_DAC[] = {
  {PA_4,  DAC1, STM_PIN_DATA_EXT(STM_MODE_ANALOG, GPIO_NOPULL, 0, 1, 0)}, // DAC_OUT1
  {PA_5,  DAC1, STM_PIN_DATA_EXT(STM_MODE_ANALOG, GPIO_NOPULL, 0, 2, 0)}, // DAC_OUT2
  {NC,    NP,    0}
};
#endif

//*** I2C ***

#ifdef HAL_I2C_MODULE_ENABLED
const PinMap PinMap_I2C_SDA[] = {
   {PB_7,  I2C1, STM_PIN_DATA(STM_MODE_AF_OD, GPIO_NOPULL, GPIO_AF4_I2C1)},
   {PC_9,  I2C3, STM_PIN_DATA(STM_MODE_AF_OD, GPIO_NOPULL, GPIO_AF4_I2C3)},
   {PC_12, I2C2, STM_PIN_DATA(STM_MODE_AF_OD, GPIO_NOPULL, GPIO_AF4_I2C2)},
  {NC,    NP,    0}
};
#endif

#ifdef HAL_I2C_MODULE_ENABLED
const PinMap PinMap_I2C_SCL[] = {
   {PA_8,  I2C3, STM_PIN_DATA(STM_MODE_AF_OD, GPIO_NOPULL, GPIO_AF4_I2C3)},
   {PB_6,  I2C1, STM_PIN_DATA(STM_MODE_AF_OD, GPIO_NOPULL, GPIO_AF4_I2C1)},
   {PB_10, I2C2, STM_PIN_DATA(STM_MODE_AF_OD, GPIO_NOPULL, GPIO_AF4_I2C2)},
  {NC,    NP,    0}
};
#endif

//*** PWM ***

#ifdef HAL_TIM_MODULE_ENABLED
const PinMap PinMap_PWM[] = {
  {PA_0,  TIM2,   STM_PIN_DATA_EXT(STM_MODE_AF_PP, GPIO_PULLUP, GPIO_AF1_TIM2, 1, 0)},  // TIM2_CH1
   {PA_1,  TIM2,   STM_PIN_DATA_EXT(STM_MODE_AF_PP, GPIO_PULLUP, GPIO_AF1_TIM2, 2, 0)},  // TIM2_CH2
   {PA_2,  TIM2,   STM_PIN_DATA_EXT(STM_MODE_AF_PP, GPIO_PULLUP, GPIO_AF1_TIM2, 3, 0)},  // TIM2_CH3 - STLink Tx
   {PA_3,  TIM2,   STM_PIN_DATA_EXT(STM_MODE_AF_PP, GPIO_PULLUP, GPIO_AF1_TIM2, 4, 0)},  // TIM2_CH4 - STLink Rx
   {PA_5,  TIM8,   STM_PIN_DATA_EXT(STM_MODE_AF_PP, GPIO_PULLUP, GPIO_AF3_TIM8, 1, 1)},  // TIM8_CH1N
  {PA_6,  TIM13,  STM_PIN_DATA_EXT(STM_MODE_AF_PP, GPIO_PULLUP, GPIO_AF9_TIM13, 1, 0)},  // TIM13_CH1
  {PA_7,  TIM14,  STM_PIN_DATA_EXT(STM_MODE_AF_PP, GPIO_PULLUP, GPIO_AF9_TIM14, 1, 0)},  // TIM14_CH1
  {PA_9,  TIM1,   STM_PIN_DATA_EXT(STM_MODE_AF_PP, GPIO_PULLUP, GPIO_AF1_TIM1, 2, 0)},  // TIM1_CH2
  {PA_10, TIM1,   STM_PIN_DATA_EXT(STM_MODE_AF_PP, GPIO_PULLUP, GPIO_AF1_TIM1, 3, 0)},  // TIM1_CH3
  {PA_15, TIM2,   STM_PIN_DATA_EXT(STM_MODE_AF_PP, GPIO_PULLUP, GPIO_AF1_TIM2, 1, 0)},  // TIM2_CH1
   {PB_0,  TIM3,   STM_PIN_DATA_EXT(STM_MODE_AF_PP, GPIO_PULLUP, GPIO_AF2_TIM3, 3, 0)},  // TIM3_CH3
   {PB_1,  TIM3,   STM_PIN_DATA_EXT(STM_MODE_AF_PP, GPIO_PULLUP, GPIO_AF2_TIM3, 4, 0)},  // TIM3_CH4
  {PB_3,  TIM2,   STM_PIN_DATA_EXT(STM_MODE_AF_PP, GPIO_PULLUP, GPIO_AF1_TIM2, 2, 0)},  // E0 Heater, TIM2_CH2
  {PB_4,  TIM3,   STM_PIN_DATA_EXT(STM_MODE_AF_PP, GPIO_PULLUP, GPIO_AF2_TIM3, 1, 0)},  // E1 Heater, TIM3_CH1
  {PB_5,  TIM3,   STM_PIN_DATA_EXT(STM_MODE_AF_PP, GPIO_PULLUP, GPIO_AF2_TIM3, 2, 0)},  // LED G, TIM3_CH2
  {PB_6,  TIM4,   STM_PIN_DATA_EXT(STM_MODE_AF_PP, GPIO_PULLUP, GPIO_AF2_TIM4, 1, 0)},  // LED R, TIM4_CH1
  {PB_7,  TIM4,   STM_PIN_DATA_EXT(STM_MODE_AF_PP, GPIO_PULLUP, GPIO_AF2_TIM4, 2, 0)},  // LED B, TIM4_CH2
   {PB_8,  TIM10,  STM_PIN_DATA_EXT(STM_MODE_AF_PP, GPIO_PULLUP, GPIO_AF3_TIM10, 1, 0)},  // TIM10_CH1
  {PB_8,  TIM4,   STM_PIN_DATA_EXT(STM_MODE_AF_PP, GPIO_PULLUP, GPIO_AF2_TIM4, 3, 0)},  // TIM4_CH3
  {PB_9,  TIM11,  STM_PIN_DATA_EXT(STM_MODE_AF_PP, GPIO_PULLUP, GPIO_AF3_TIM11, 1, 0)},  // TIM11_CH1
  {PB_10, TIM2,   STM_PIN_DATA_EXT(STM_MODE_AF_PP, GPIO_PULLUP, GPIO_AF1_TIM2, 3, 0)},  // TIM2_CH3
  {PB_13, TIM1,   STM_PIN_DATA_EXT(STM_MODE_AF_PP, GPIO_PULLUP, GPIO_AF1_TIM1, 1, 1)},  // TIM1_CH1N
  {PB_14, TIM12,  STM_PIN_DATA_EXT(STM_MODE_AF_PP, GPIO_PULLUP, GPIO_AF9_TIM12, 1, 0)},  // TIM12_CH1
   {PB_15, TIM8,   STM_PIN_DATA_EXT(STM_MODE_AF_PP, GPIO_PULLUP, GPIO_AF3_TIM8, 3, 1)},  // TIM8_CH3N
   {PC_6,  TIM8,   STM_PIN_DATA_EXT(STM_MODE_AF_PP, GPIO_PULLUP, GPIO_AF3_TIM8, 1, 0)},  // TIM8_CH1
   {PC_7,  TIM3,   STM_PIN_DATA_EXT(STM_MODE_AF_PP, GPIO_PULLUP, GPIO_AF2_TIM3, 2, 0)},  // TIM3_CH2
   {PC_8,  TIM8,   STM_PIN_DATA_EXT(STM_MODE_AF_PP, GPIO_PULLUP, GPIO_AF3_TIM8, 3, 0)},  // TIM8_CH3
  {PC_9,  TIM8,   STM_PIN_DATA_EXT(STM_MODE_AF_PP, GPIO_PULLUP, GPIO_AF3_TIM8, 4, 0)},  // TIM8_CH4
  {NC,    NP,    0}
};
#endif

//*** SERIAL ***

#ifdef HAL_UART_MODULE_ENABLED
const PinMap PinMap_UART_TX[] = {
  {PA_9,  USART1,  STM_PIN_DATA(STM_MODE_AF_PP, GPIO_PULLUP, GPIO_AF7_USART1)},
  {PD_8,  USART3,  STM_PIN_DATA(STM_MODE_AF_PP, GPIO_PULLUP, GPIO_AF7_USART3)},
  {PC_6,  USART6,  STM_PIN_DATA(STM_MODE_AF_PP, GPIO_PULLUP, GPIO_AF8_USART6)},
  {PB_6,  USART1,  STM_PIN_DATA(STM_MODE_AF_PP, GPIO_PULLUP, GPIO_AF7_USART1)},
  {PA_2,  USART2,  STM_PIN_DATA(STM_MODE_AF_PP, GPIO_PULLUP, GPIO_AF7_USART2)},
  {PD_5,  USART2,  STM_PIN_DATA(STM_MODE_AF_PP, GPIO_PULLUP, GPIO_AF7_USART2)},
  {PB_10, USART3,  STM_PIN_DATA(STM_MODE_AF_PP, GPIO_PULLUP, GPIO_AF7_USART3)},
  {PC_10, USART3,  STM_PIN_DATA(STM_MODE_AF_PP, GPIO_PULLUP, GPIO_AF7_USART3)},
  {PA_0,  UART4,   STM_PIN_DATA(STM_MODE_AF_PP, GPIO_PULLUP, GPIO_AF8_UART4)},
  {PC_12, UART5,   STM_PIN_DATA(STM_MODE_AF_PP, GPIO_PULLUP, GPIO_AF8_UART5)},
  {NC,    NP,    0}
};

const PinMap PinMap_UART_RX[] = {
  {PA_10, USART1,  STM_PIN_DATA(STM_MODE_AF_PP, GPIO_PULLUP, GPIO_AF7_USART1)},
  {PD_9,  USART3,  STM_PIN_DATA(STM_MODE_AF_PP, GPIO_PULLUP, GPIO_AF7_USART3)},
  {PC_7,  USART6,  STM_PIN_DATA(STM_MODE_AF_PP, GPIO_PULLUP, GPIO_AF8_USART6)},
  {PA_1,  UART4,   STM_PIN_DATA(STM_MODE_AF_PP, GPIO_PULLUP, GPIO_AF8_UART4)},
  {PA_3,  USART2,  STM_PIN_DATA(STM_MODE_AF_PP, GPIO_PULLUP, GPIO_AF7_USART2)},
  {PB_7,  USART1,  STM_PIN_DATA(STM_MODE_AF_PP, GPIO_PULLUP, GPIO_AF7_USART1)},
  {PC_11, USART3,  STM_PIN_DATA(STM_MODE_AF_PP, GPIO_PULLUP, GPIO_AF7_USART3)},
  {PD_2,  UART5,   STM_PIN_DATA(STM_MODE_AF_PP, GPIO_PULLUP, GPIO_AF8_UART5)},
  {PD_6,  USART2,  STM_PIN_DATA(STM_MODE_AF_PP, GPIO_PULLUP, GPIO_AF7_USART2)},
  {NC,    NP,    0}
};

const PinMap PinMap_UART_RTS[] = {
  {NC,    NP,    0}
};

const PinMap PinMap_UART_CTS[] = {
  {NC,    NP,    0}
};
#endif

//*** SPI ***

#ifdef HAL_SPI_MODULE_ENABLED
const PinMap PinMap_SPI_MOSI[] = {
  {PA_7,  SPI1, STM_PIN_DATA(STM_MODE_AF_PP, GPIO_PULLUP, GPIO_AF5_SPI1)},
  {PB_15, SPI2, STM_PIN_DATA(STM_MODE_AF_PP, GPIO_PULLUP, GPIO_AF5_SPI2)},
  {PC_12, SPI3, STM_PIN_DATA(STM_MODE_AF_PP, GPIO_PULLUP, GPIO_AF6_SPI3)},
  {NC,    NP,    0}
};
#endif

#ifdef HAL_SPI_MODULE_ENABLED
const PinMap PinMap_SPI_MISO[] = {
  {PA_6,  SPI1, STM_PIN_DATA(STM_MODE_AF_PP, GPIO_PULLUP, GPIO_AF5_SPI1)},
  {PB_14, SPI2, STM_PIN_DATA(STM_MODE_AF_PP, GPIO_PULLUP, GPIO_AF5_SPI2)},
  {PC_11, SPI3, STM_PIN_DATA(STM_MODE_AF_PP, GPIO_PULLUP, GPIO_AF6_SPI3)},
  {NC,    NP,    0}
};
#endif

#ifdef HAL_SPI_MODULE_ENABLED
const PinMap PinMap_SPI_SCLK[] = {
  {PA_5,  SPI1, STM_PIN_DATA(STM_MODE_AF_PP, GPIO_PULLUP, GPIO_AF5_SPI1)},
  {PB_13, SPI2, STM_PIN_DATA(STM_MODE_AF_PP, GPIO_PULLUP, GPIO_AF5_SPI2)},
  {PC_10, SPI3, STM_PIN_DATA(STM_MODE_AF_PP, GPIO_PULLUP, GPIO_AF6_SPI3)},
  {NC,    NP,    0}
};
#endif

#ifdef HAL_SPI_MODULE_ENABLED
const PinMap PinMap_SPI_SSEL[] = {
  {PA_4,  SPI1, STM_PIN_DATA(STM_MODE_AF_PP, GPIO_PULLUP, GPIO_AF5_SPI1)},
  {PB_12, SPI2, STM_PIN_DATA(STM_MODE_AF_PP, GPIO_PULLUP, GPIO_AF5_SPI2)},
  {NC,    NP,    0}
};
#endif

//*** CAN ***

#ifdef HAL_CAN_MODULE_ENABLED
const PinMap PinMap_CAN_RD[] = {
  {NC,    NP,    0}
};
#endif

#ifdef HAL_CAN_MODULE_ENABLED
const PinMap PinMap_CAN_TD[] = {
  {NC,    NP,    0}
};
#endif

//*** USB ***

#ifdef HAL_PCD_MODULE_ENABLED
const PinMap PinMap_USB_OTG_FS[] = {
  {PA_11, USB_OTG_FS, STM_PIN_DATA(STM_MODE_AF_PP, GPIO_PULLUP, GPIO_AF10_OTG_FS)}, // USB_OTG_FS_DM
  {PA_12, USB_OTG_FS, STM_PIN_DATA(STM_MODE_AF_PP, GPIO_PULLUP, GPIO_AF10_OTG_FS)}, // USB_OTG_FS_DP
  {NC,    NP,    0}
};
#endif

#ifdef HAL_PCD_MODULE_ENABLED
const PinMap PinMap_USB_OTG_HS[] = {
  {NC,    NP,    0}
};
#endif


#ifdef HAL_SD_MODULE_ENABLED
WEAK const PinMap PinMap_SD[] = {
  {PC_8,  SDIO, STM_PIN_DATA(STM_MODE_AF_PP, GPIO_PULLUP, GPIO_AF12_SDIO)}, // SDIO_D0
  {PC_9,  SDIO, STM_PIN_DATA(STM_MODE_AF_PP, GPIO_PULLUP, GPIO_AF12_SDIO)}, // SDIO_D1
  {PC_10, SDIO, STM_PIN_DATA(STM_MODE_AF_PP, GPIO_PULLUP, GPIO_AF12_SDIO)}, // SDIO_D2
  {PC_11, SDIO, STM_PIN_DATA(STM_MODE_AF_PP, GPIO_PULLUP, GPIO_AF12_SDIO)}, // SDIO_D3
  {PC_12, SDIO, STM_PIN_DATA(STM_MODE_AF_PP, GPIO_NOPULL, GPIO_AF12_SDIO)}, // SDIO_CK
  {PD_2,  SDIO, STM_PIN_DATA(STM_MODE_AF_PP, GPIO_NOPULL, GPIO_AF12_SDIO)}, // SDIO_CMD
  {NC,    NP,    0}
};
#endif
