FYSETC/FYSETC-SPIDER/firmware/RRF/RRFBuild/CoreN2G/src/STM32F4/variants/STM32F446/variant.h

/*
  Copyright (c) 2011 Arduino.  All right reserved.

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
  You should have received a copy of the GNU Lesser General Public
  License along with this library; if not, write to the Free Software
  Foundation, Inc., 51 Franklin St, Fifth Floor, Boston, MA  02110-1301  USA
*/

#pragma once


#ifdef __cplusplus
extern "C" {
#endif // __cplusplus

/*----------------------------------------------------------------------------
 *        Pins
 *----------------------------------------------------------------------------*/

#define PA0   0  //D0
#define PA1   1  //D1
#define PA2   2  //D2
#define PA3   3  //D3
#define PA4   4  //D4
#define PA5   5  //D5
#define PA6   6  //D6
#define PA7   7  //D7
#define PA8   8  //D8
#define PA9   9  //D9
#define PA10  10 //D10
#define PA11  11 //D11
#define PA12  12 //D12
#define PA13  13 //D13
#define PA14  14 //D14
#define PA15  15 //D15
#define PB0   16 //D16
#define PB1   17 //D17
#define PB2   18 //D18
#define PB3   19 //D19
#define PB4   20 //D20
#define PB5   21 //D21
#define PB6   22 //D22
#define PB7   23 //D23
#define PB8   24 //D24
#define PB9   25 //D25
#define PB10  26 //D26
#define PB12  28 //D28
#define PB13  29 //D29
#define PB14  30 //D30
#define PB15  31 //D31
#define PC0   32 //D32
#define PC1   33 //D33
#define PC2   34 //D34
#define PC3   35 //D35
#define PC4   36 //D36
#define PC5   37 //D37
#define PC6   38 //D38
#define PC7   39 //D39
#define PC8   40 //D40
#define PC9   41 //D41
#define PC10  42 //D42
#define PC11  43 //D43
#define PC12  44 //D44
#define PC13  45 //D45
#define PC14  46 //D46
#define PC15  47 //D47
#define PD0   48 //D48
#define PD1   49 //D49
#define PD2   50 //D50
#define PD3   51 //D51
#define PD4   52 //D52
#define PD5   53 //D53
#define PD6   54 //D54
#define PD7   55 //D55
#define PD8   56 //D56
#define PD9   57 //D57
#define PD10  58 //D58
#define PD11  59 //D59
#define PD12  60 //D60
#define PD13  61 //D61
#define PD14  62 //D62
#define PD15  63 //D63
#define PE0   64 //D64
#define PE1   65 //D65
#define PE2   66 //D66
#define PE3   67 //D67
#define PE4   68 //D68
#define PE5   69 //D69
#define PE6   70 //D70
#define PE7   71 //D71
#define PE8   72 //D72
#define PE9   73 //D73
#define PE10  74 //D74
#define PE11  75 //D75
#define PE12  76 //D76
#define PE13  77 //D77
#define PE14  78 //D78
#define PE15  79 //D79

// This must be a literal with the same value as PEND
#define NUM_DIGITAL_PINS        82
// This must be a literal with a value less than or equal to to MAX_ANALOG_INPUTS
#define NUM_ANALOG_INPUTS       16


// On-board LED pin number
#define LED_BUILTIN             PA7
#define LED_GREEN               LED_BUILTIN


/* HAL configuration */
#define HSE_VALUE               12000000U

#ifdef __cplusplus
} // extern "C"
#endif

/*----------------------------------------------------------------------------
 *        Arduino objects - C++ only
 *----------------------------------------------------------------------------*/

#ifdef __cplusplus

#endif
