FYSETC/FYSETC-SPIDER/firmware/RRF/RRFBuild/CoreN2G/src/STM32F4/variants/STM32F446/PinNamesVar.h

/* USB */
#ifdef USBCON
#define USB_OTG_FS_SOF       PA_8
#define USB_OTG_FS_VBUS      PA_9
#define USB_OTG_FS_ID        PA_10
#define USB_OTG_FS_DM        PA_11
#define USB_OTG_FS_DP        PA_12
#define USB_OTG_HS_ULPI_D0   PA_3
#define USB_OTG_HS_SOF       PA_4
#define USB_OTG_HS_ULPI_CK   PA_5
#define USB_OTG_HS_ULPI_D1   PB_0
#define USB_OTG_HS_ULPI_D2   PB_1
#define USB_OTG_HS_ULPI_D7   PB_5
#define USB_OTG_HS_ULPI_D3   PB_10
#define USB_OTG_HS_ULPI_D4   PB_2
#define USB_OTG_HS_ID        PB_12
#define USB_OTG_HS_ULPI_D5   PB_12
#define USB_OTG_HS_ULPI_D6   PB_13
#define USB_OTG_HS_VBUS      PB_13
#define USB_OTG_HS_DM        PB_14
#define USB_OTG_HS_DP        PB_15
#define USB_OTG_HS_ULPI_STP  PC_0
#define USB_OTG_HS_ULPI_DIR  PC_2
#define USB_OTG_HS_ULPI_NXT  PC_3
#endif
