FYSETC/FYSETC-SPIDER/(commit log)

2021-03-26 Upload Klipper firmware related files
    [printer.cfg]
2021-03-27 Upload Marlin firmware
    [Configuration.h, Configuration_adv.h]
2021-04-08 Update Klipper example config for VORON2.4
    [printer.cfg]
2021-04-09 Add Klipper example config bltouch section for VORON2.4
    [printer.cfg]
2021-04-10 Update Spider board pins
2021-04-10 Update Klipper example printer.cfg
    [printer.cfg]
2021-04-16 Update klipper firmware stuffs
    [printer.cfg]
2021-04-21 Add Spider wiring svg
2021-04-22 Update Klipper readme
2021-05-09 Update README.md
    Correct the pin definition of E3 and E4 motor
2021-05-12 Update Marlin firmware
    [Configuration.h, Configuration_adv.h]
2021-05-12 Update klipper printer.cfg
    [printer.cfg]
2021-05-13 Added pull up resistor to z endstop in printer.cfg
    In my testing, not having the pull up resistor enabled for the z endstop causes delays in homing which will crash your gantry into the nozzle probe. Adding the pull up resistor like the other endstops have fixes this.
    [printer.cfg]
2021-05-13 Upload pre-build marlin firmware
2021-05-31 Update README for TMC2209 wiring
2021-06-01 Upload TMC2209 wiring jpg
2021-06-06 Update printer.cfg
    Removed QUAD_GANTRY_LEVEL call from PRINT_START as it's already triggered by G32
    [printer.cfg]
2021-06-09 Add restart_method example
    For those using RPi UART0, this ensures klipper reboots the MCU correctly.
    [printer.cfg]
2021-06-16 Upload pinout and wiring jpg images and update README
2021-06-21 typo fix in display software spi
    [printer.cfg]
2021-06-23 Upload Spider RRF firmware
    [Configuration.h, Memory usage.ods, bed.g, config-override.g, config.g, duet3_openocd.cfg, homeall.g, homeu.g]
2021-06-24 Update config.g to avoid Error: Invalid kinematics matrix
    [config.g]
2021-06-25 Bootloader hex file don't need to set address in stm32cubeprogrammer
2021-06-26 update fan max_power
    Let people have a full range of speeds on their part fans
    [printer.cfg]
2021-07-05 Update Spider pinout.xlsx
    [Spider pinout.xlsx]
2021-07-05 Update Spider README
    [printer.cfg]
2021-07-06 Change bltouch sensor_pin according to the Spider wiring
    [printer.cfg]
2021-07-07 Update Spider wiring
    [Spider pinout.xlsx, Spider_v1.x pinout.xlsx]
2021-07-14 Upload Spider 3.3v issue statement
2021-07-28 Update printer.cfg Probe comment
    [printer.cfg]
2021-08-03 Change RRF wifi module pin define
2021-08-06 chain_count should be 3 in printer.cfg
    [printer.cfg]
2021-08-17 Add thermistor position information
    [printer.cfg]
2021-08-28 Change SSR wiring
2021-09-03 Upload latest bugfix-2.0.x Marlin
    [Configuration.h, Configuration_adv.h]
2021-09-04 updated printer.cfg print_end
    Changed the retract in `print_end` from -10mm to -1mm. Most all Voron printers are direct drive now and 10mm retract is ok for bowden setups, but way too much for direct drive. 10mm retracts on print_end are causing jamming issues on many users brand new machines.
    [printer.cfg]
2021-10-20 Update printer.cfg according to common complaints
    - Reduce stepper current slightly
    - Reduce hold current to reduce heat (should be plenty)
    - Change temp sensor in bed to the appropriate one
    [printer.cfg]
2021-10-25 Add 'switch raspberryPI uart' method 2
2021-11-27 Update Spider 2.2 doc
    [printer.cfg]
2021-11-27 Update Spider 2.2
    [Spider V2.2 WithLOGO.dwg]
2021-11-30 Update Spider v2.2 wiring jpg
2021-12-20 Upload Voron machine wirnigs
2021-12-21 Add 5160 config to example printer.cfg
    [printer.cfg]
2021-12-23 Upload Spider 2.2 wiring svg
2022-01-04 Upload Spider 2.2 RRF
    [bed.g, config-override.g, config.g, homeall.g, homeu.g, homex.g, homey.g, homez.g]
2022-01-04 Change RRF config path
    [bed.g, config-override.g, config.g, homeall.g, homeu.g, homex.g, homey.g, homez.g]
2022-01-19 Update Spider 2.2 wiring
2022-03-09 Update wiring images
2022-06-23 Update cfg
    [printer.cfg]
2022-08-12 Upload Spider v2.3 wiring and pinout
2022-08-12 Update RPI wiring pic
2022-08-12 Upload Afterburner Toolhead wiring jpg
2022-08-13 Add Nevermore fan config
    [printer.cfg]
2022-08-26 Update Spider2.3 VORON2.4 wiring
2022-08-27 Update Spider v2.3 wiring
2022-08-30 Add config folder
    [bed.g, config-override.g, config.g, homeall.g, homeu.g, homex.g, homey.g, homez.g]
2022-12-03 Add CAN bus network
2022-12-03 Update Chinese CANBUS doc
2022-12-03 Update CANBUS wiring
2024-08-08 Create SPIDER_H7_SCH.pdf
    Add schematic files upload
